theWickedWebDev/8-bit-computer/Modules/display-module/README.md

# Display Module

MORE DETAILS TO COME

Uses a JK flip flop, a 555 timer and EEPROM to multiplex four 7-segment displays to output the current value of the bus in decimal.

<br/>

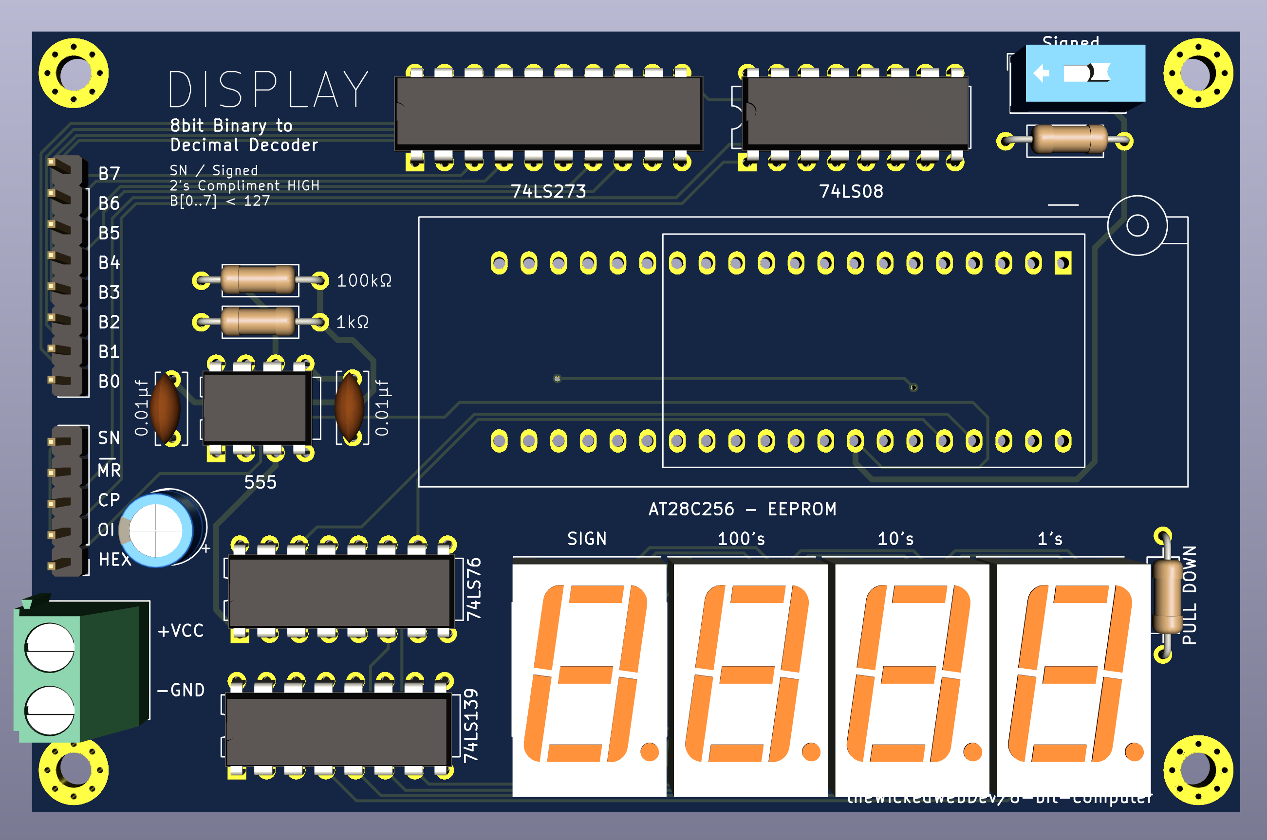
[picture p1: Modules/display-module/display-3d.png]
DISPLAY


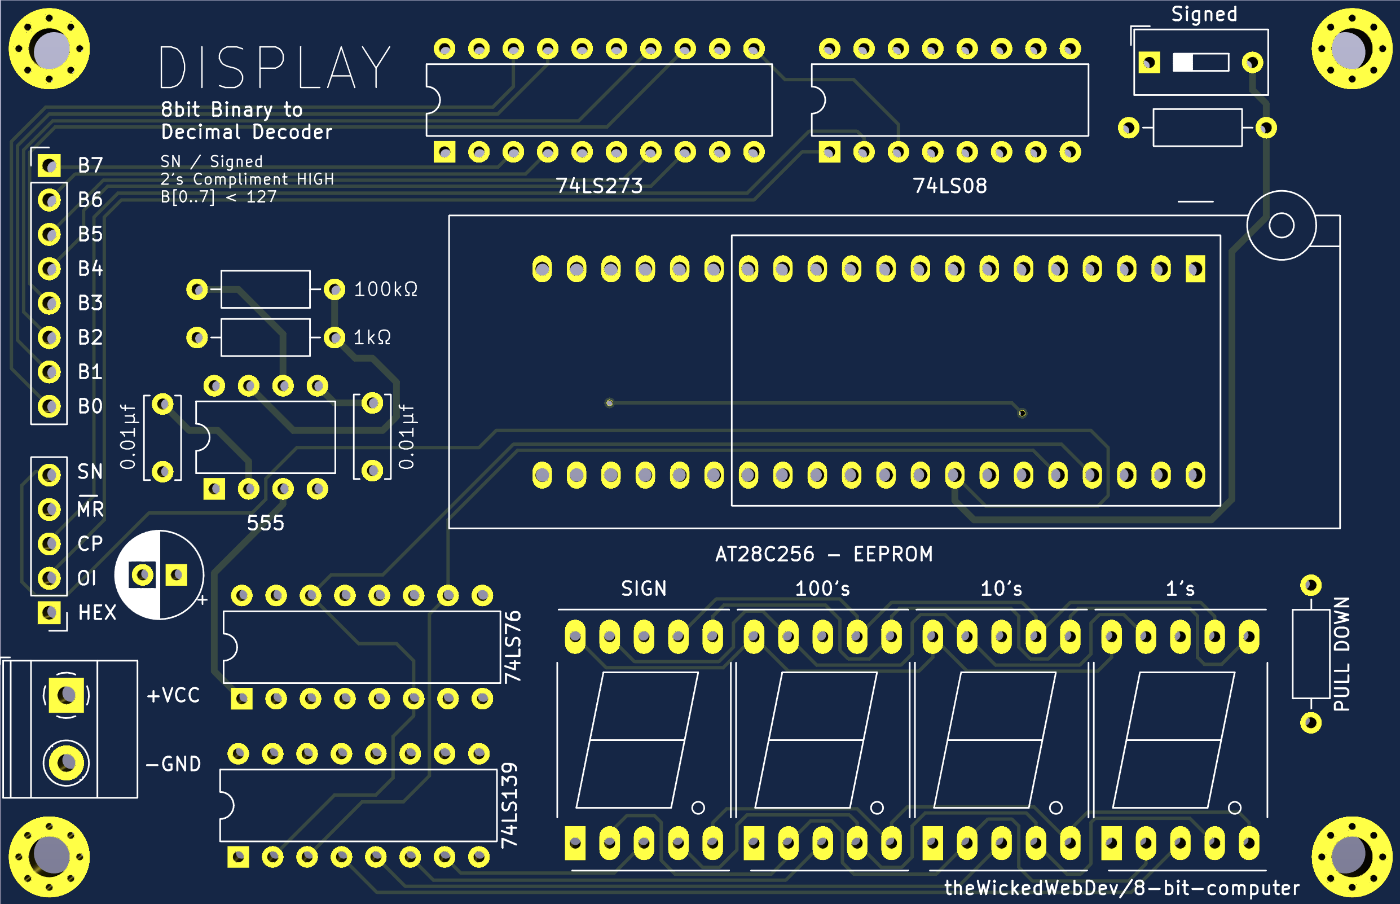
[picture p2: Modules/display-module/display-board.png]


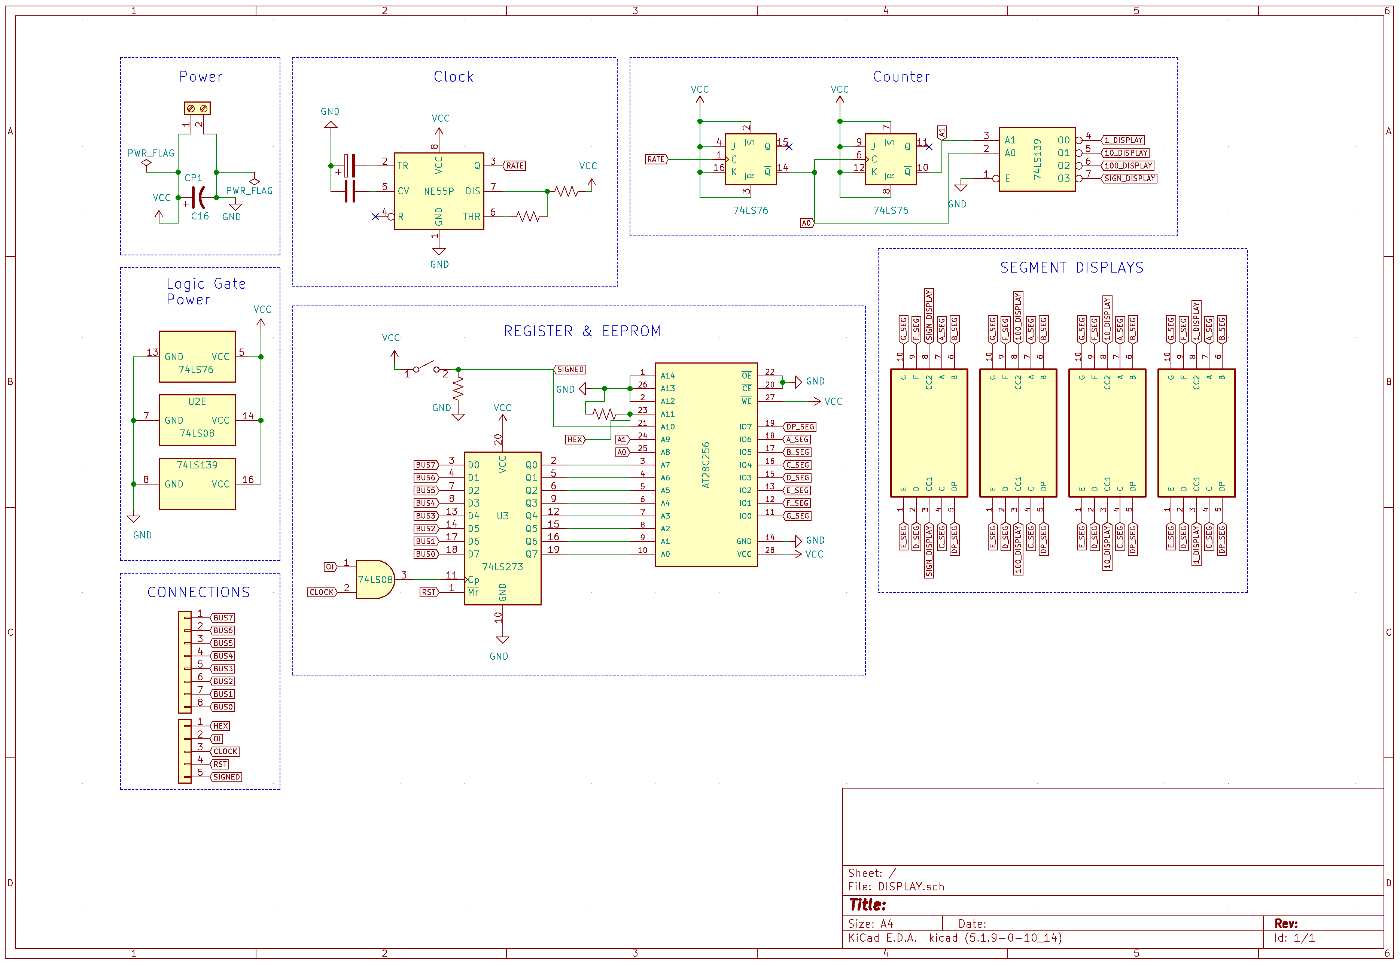
[picture p3: Modules/display-module/display-sch.png]


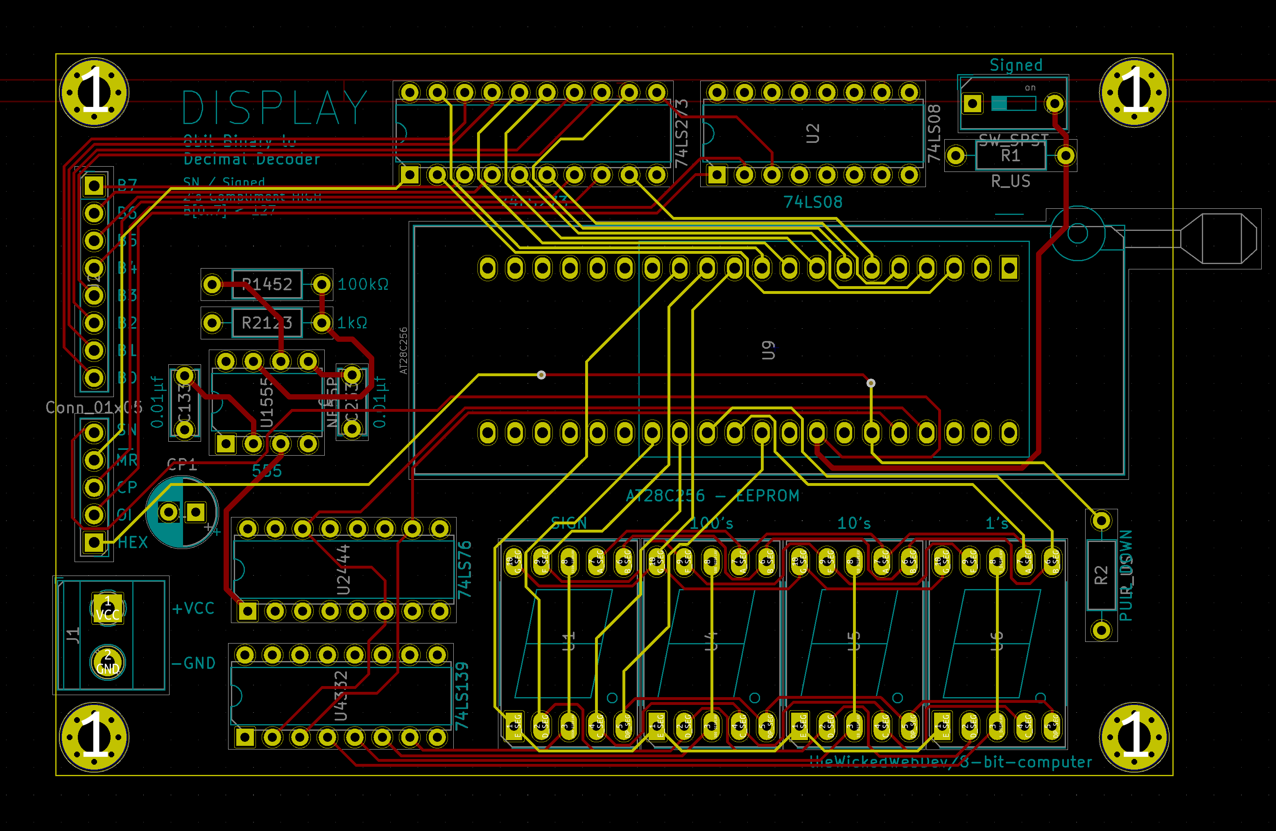
[picture p4: Modules/display-module/display-traces.png]


<br/><br/>
