theWickedWebDev/8-bit-computer/Modules/alu/README.md

# ALU with 74LS181

<br/>

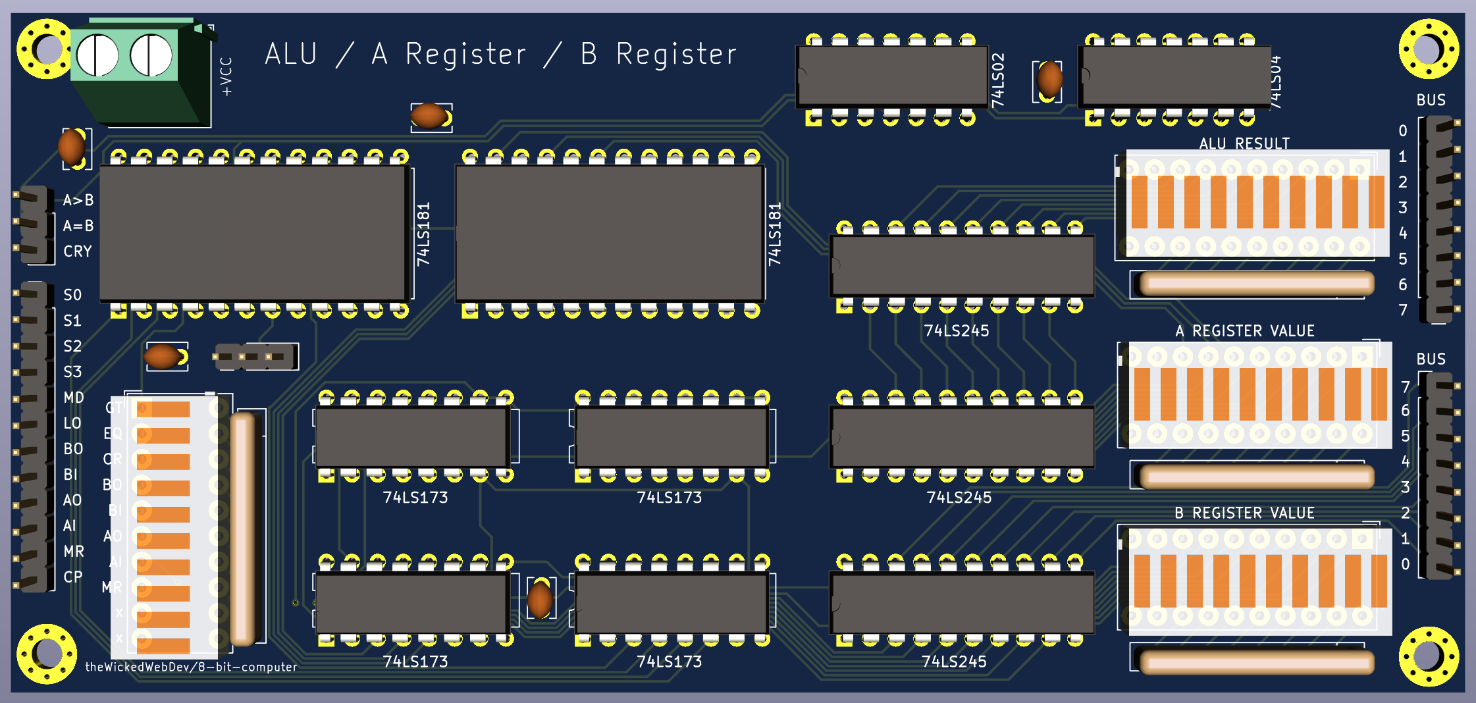
[picture p5: Modules/alu-module/ram-register-3d.png]


<br/>

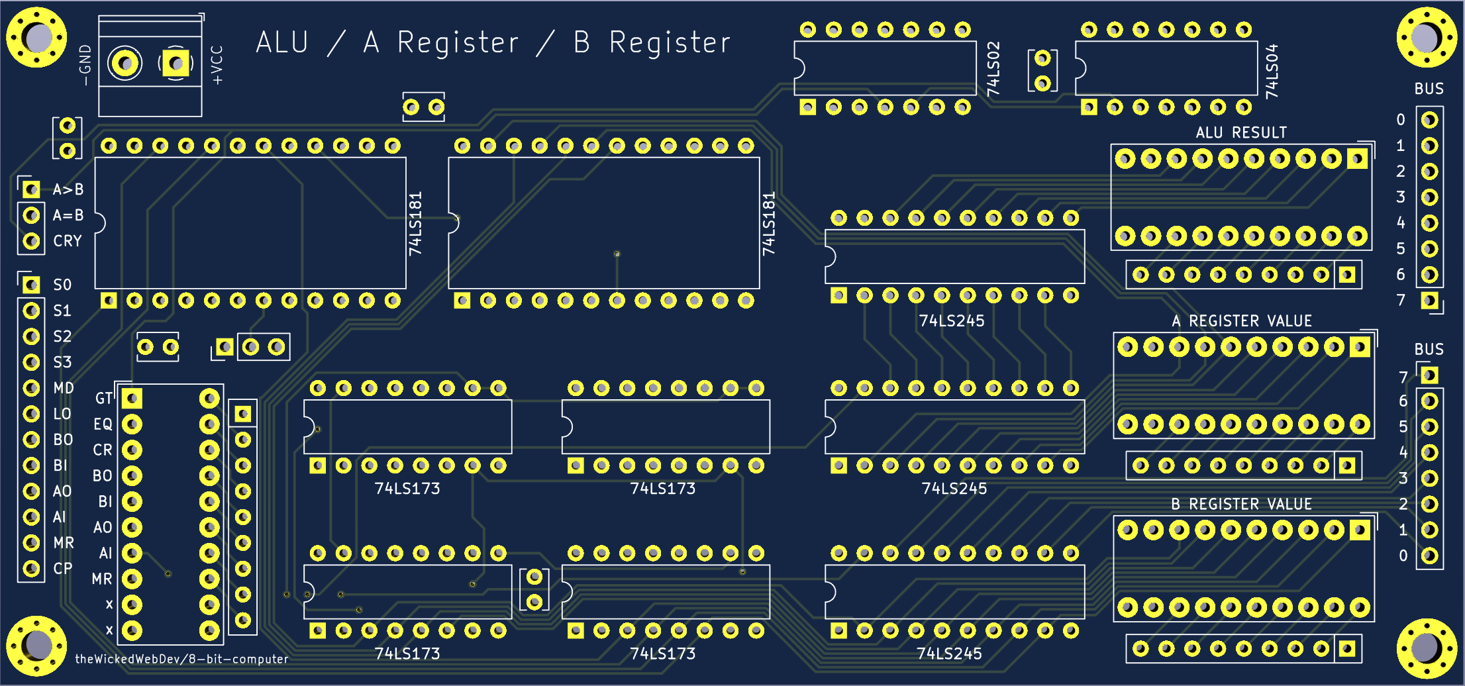
[picture p6: Modules/alu-module/ram-register-board.png]


<br/>

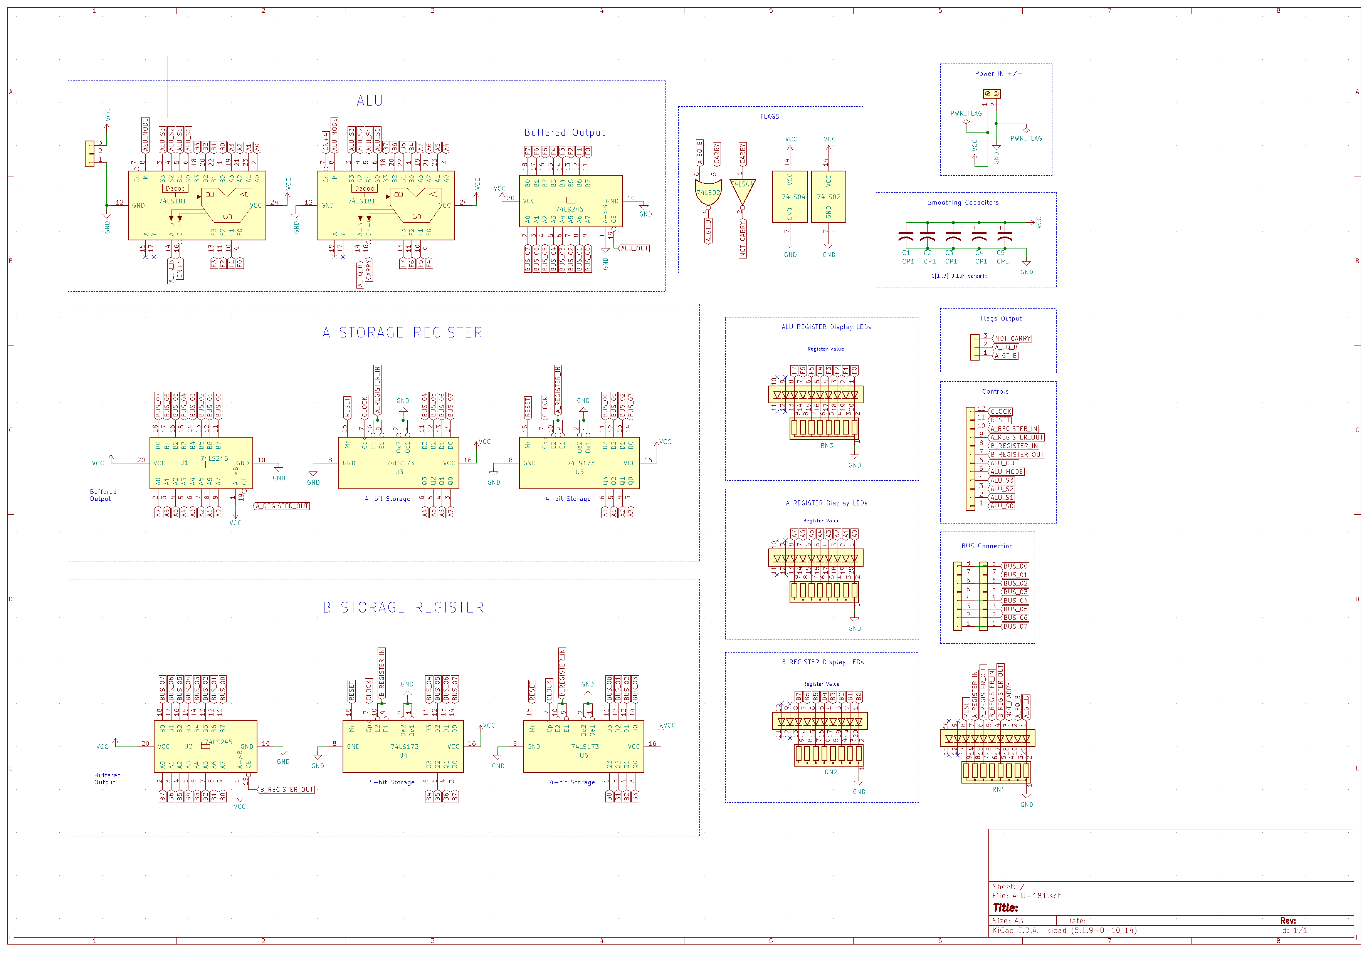
[picture p7: Modules/alu-module/ram-register-sch.png]


<br/>

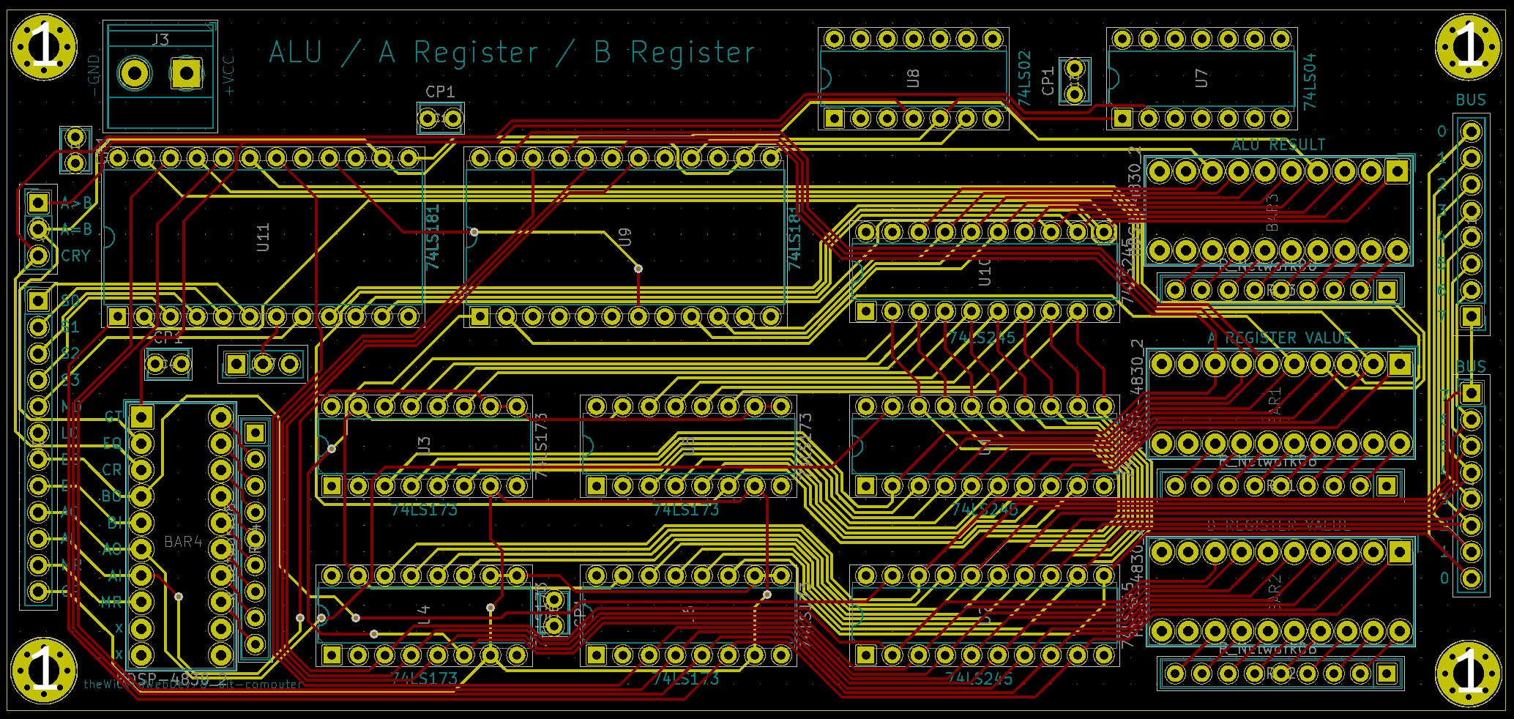
[picture p8: Modules/alu-module/ram-register-traces.png]


<br/>
