theWickedWebDev/8-bit-computer/Modules/ram-module/README.md

# RAM Modules

<br/>

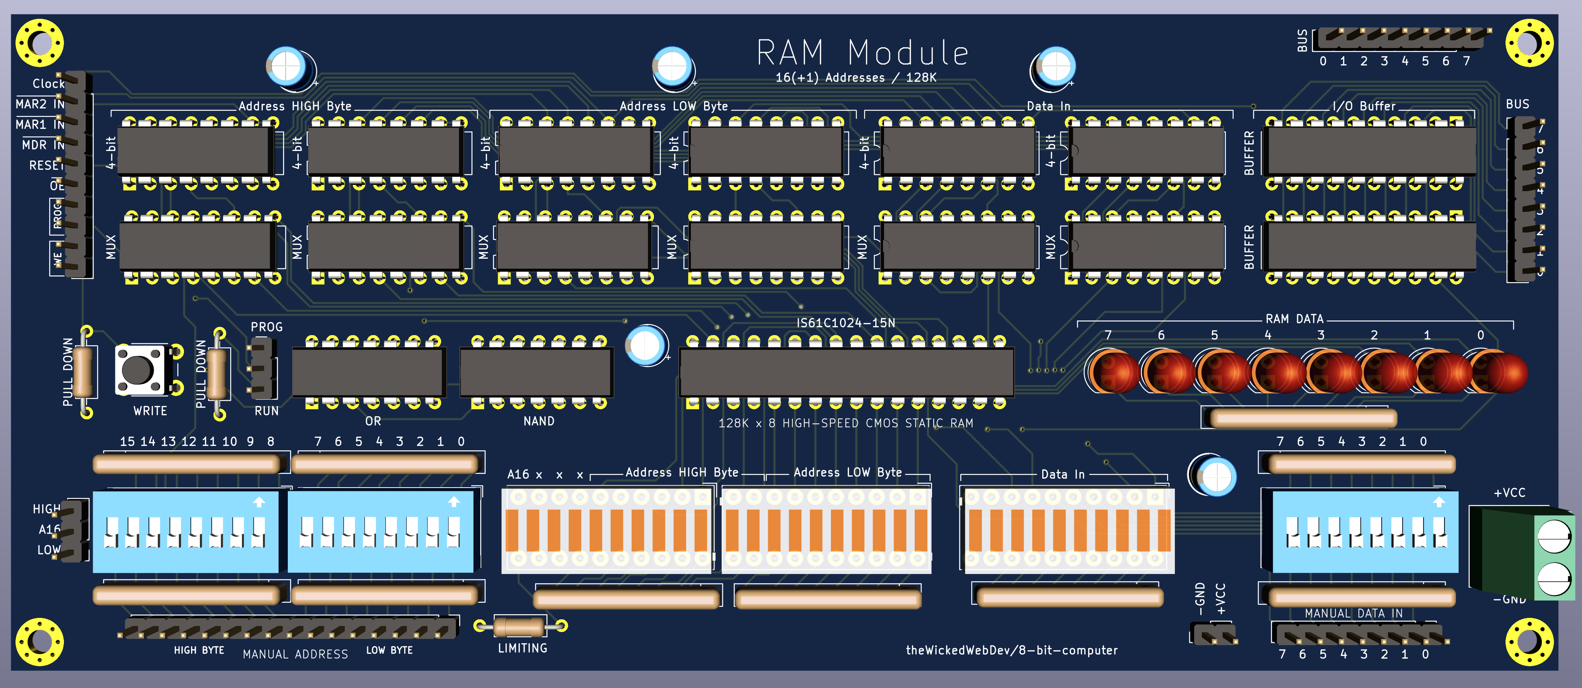
[picture p9: Modules/ram-module/ram-3d.png]


<br/>

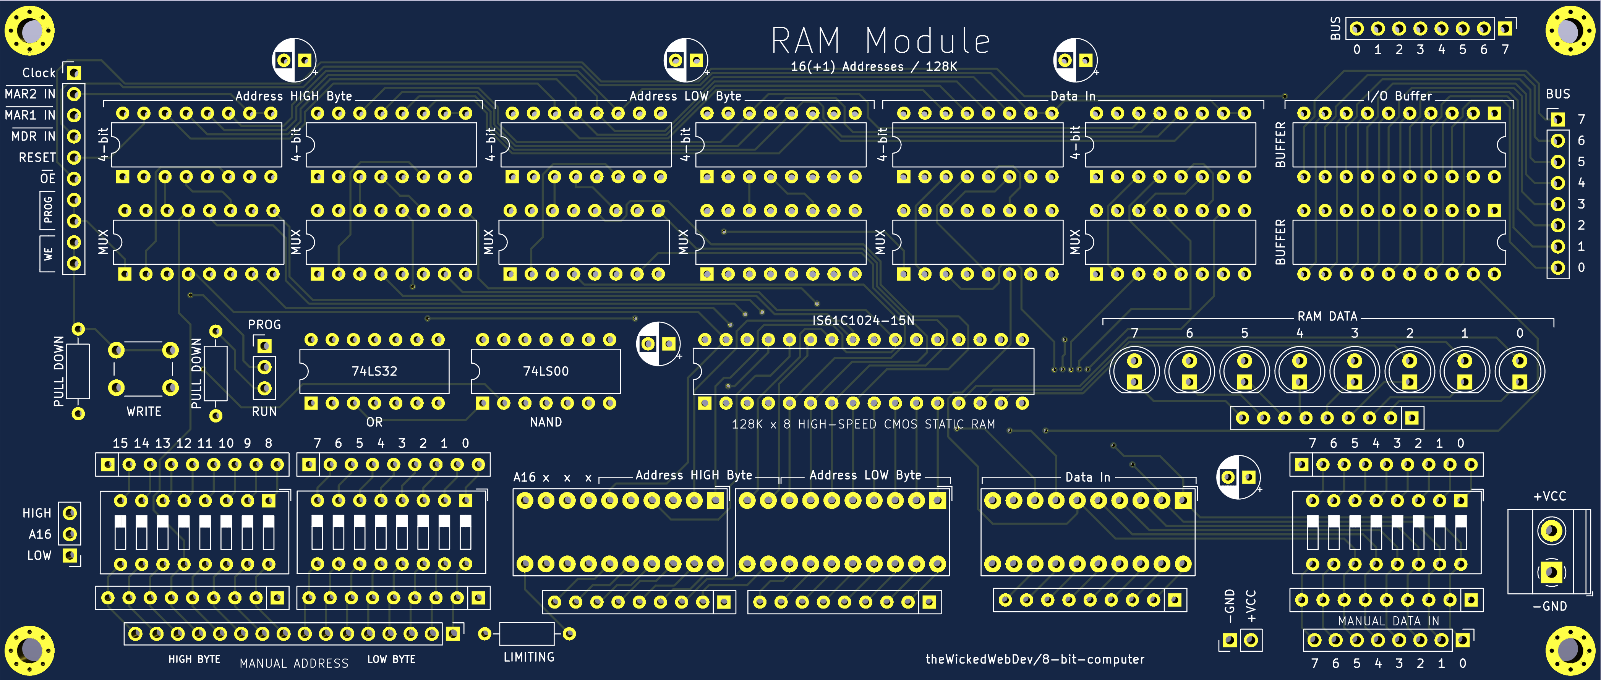
[picture p10: Modules/ram-module/ram-board.png]


<br/>

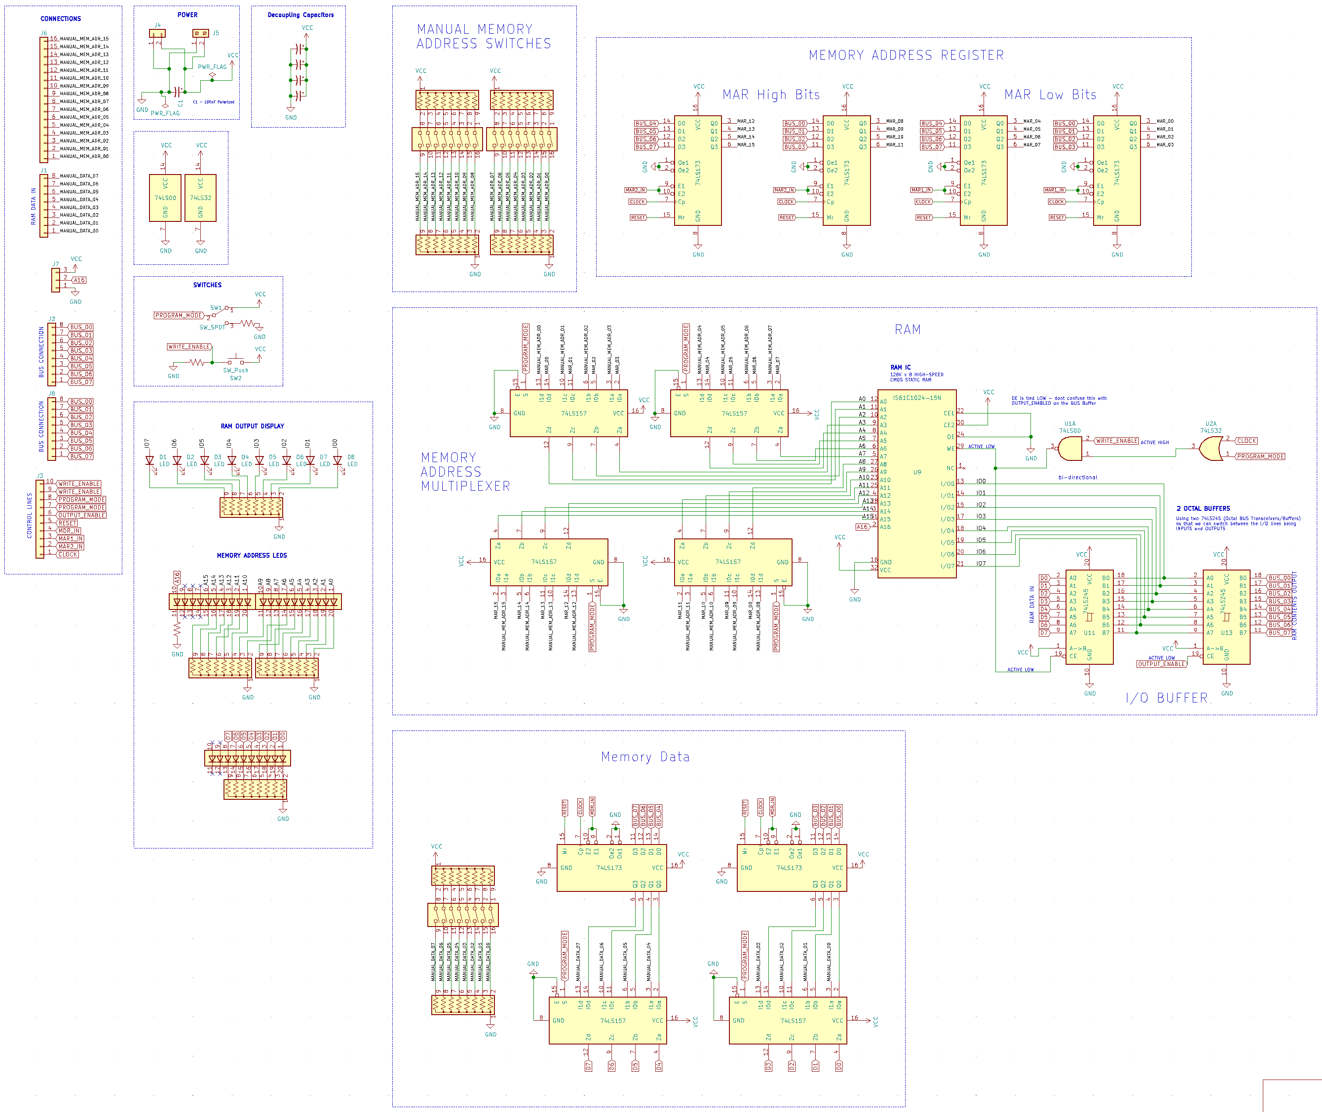
[picture p11: Modules/ram-module/ram-sch.png]


<br/>

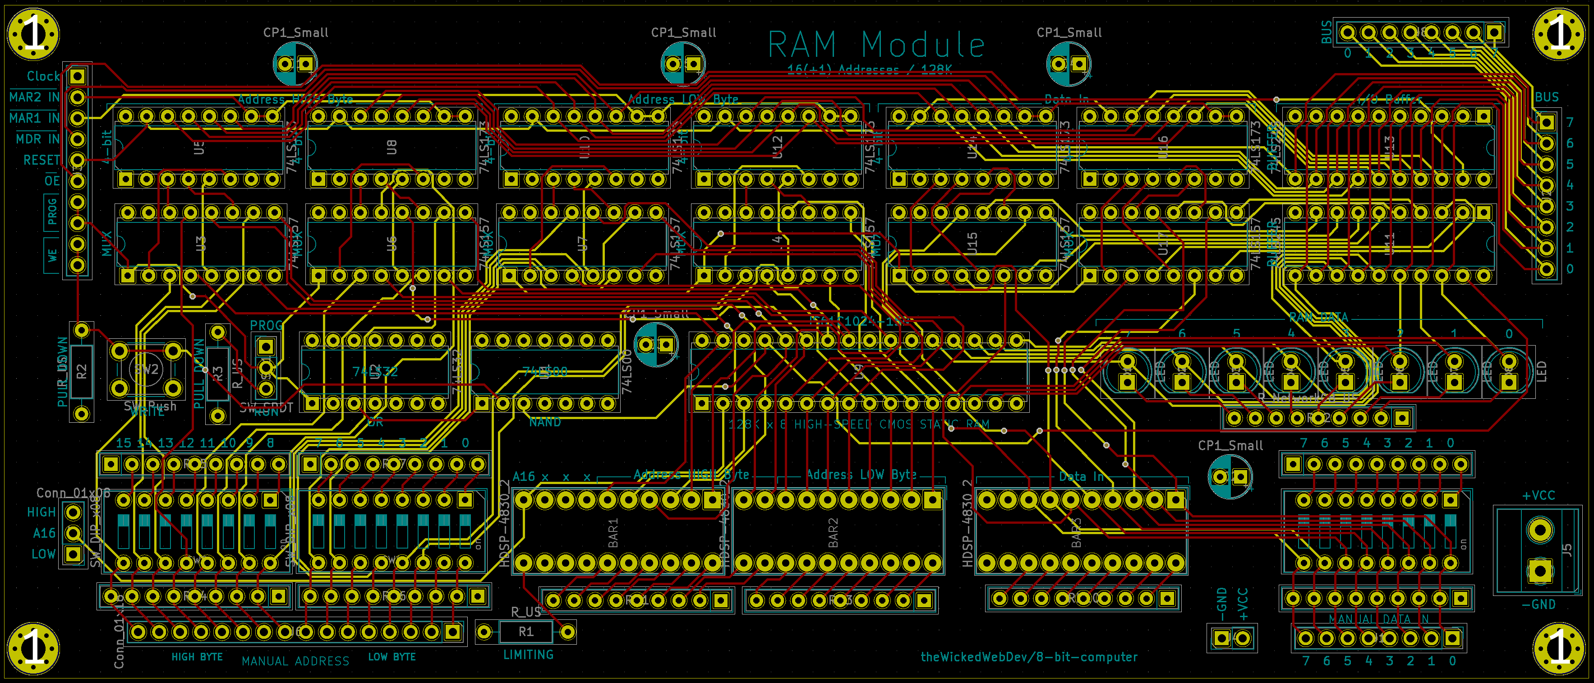
[picture p12: Modules/ram-module/ram-traces.png]


<br/>
