theWickedWebDev/8-bit-computer/Modules/storage-register/README.md

# 8-bit Register

    

DEMO

<br/>

This module stores one byte of data. It has a tri-state output which can be used to tie into a central bus system.
<br/>
<br/>

## Truth Table

| In  | Out | Rst | Cp  | Func
|---- |---- |---- |---- |----
| x	  | x | High | x | Resets Register
| High | High | Low | x | Noop/Keep stored
| Low | High | Low | /High | Latch data at BUS on rising edge
| High | Low | Low | x | Assert data to bus
| Low | Low | Low | /High | Invalid state

<br/>

## Schematic

Made with Kicad

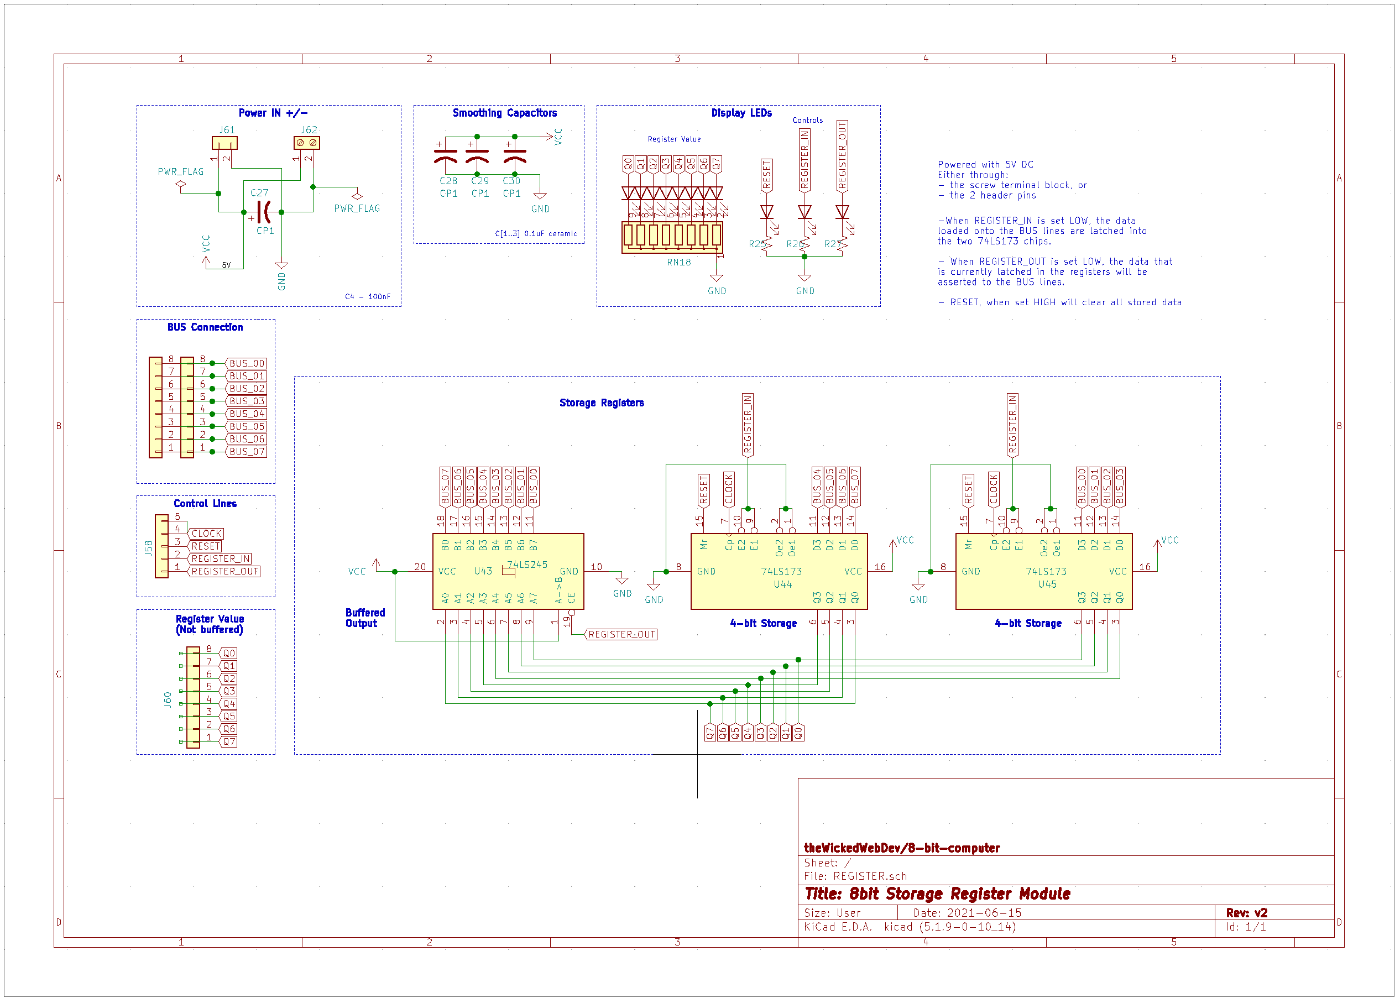
[picture p13: Modules/storage-register/registersch.png]
SCHEMATIC


<br/>

## PCB
Made with Kicad and fabricated with [JLCPCB](https://jlcpcb.com/)

Actual cost for me to fabricate this board.

| Fab 	 | S&H 	 | Total |
|----	 |----	 |---- |
|  $9.50	|  $12.80 	|  $22.30 |

<br/>

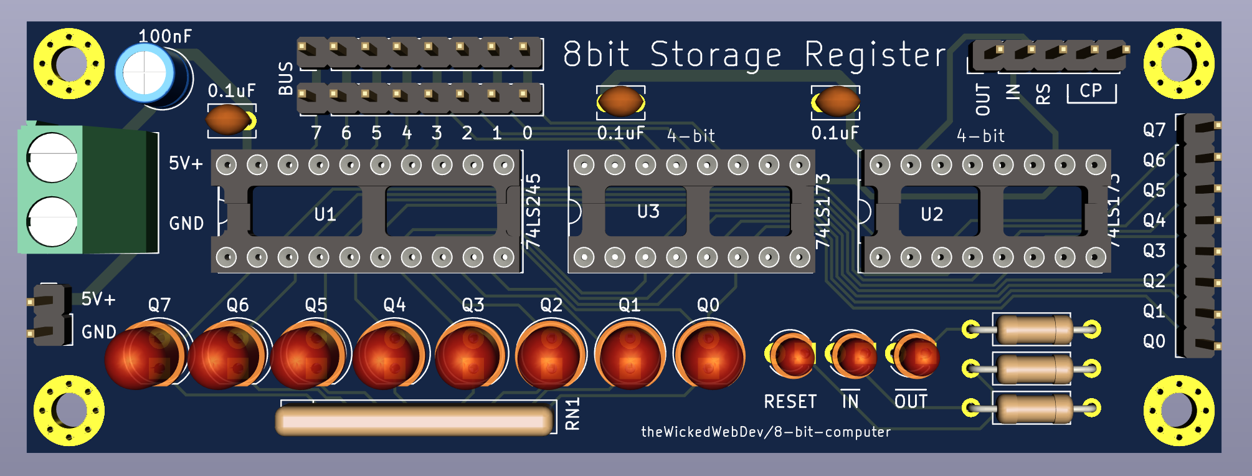
[picture p14: Modules/storage-register/register3d.png]
REGISTER


<br/>

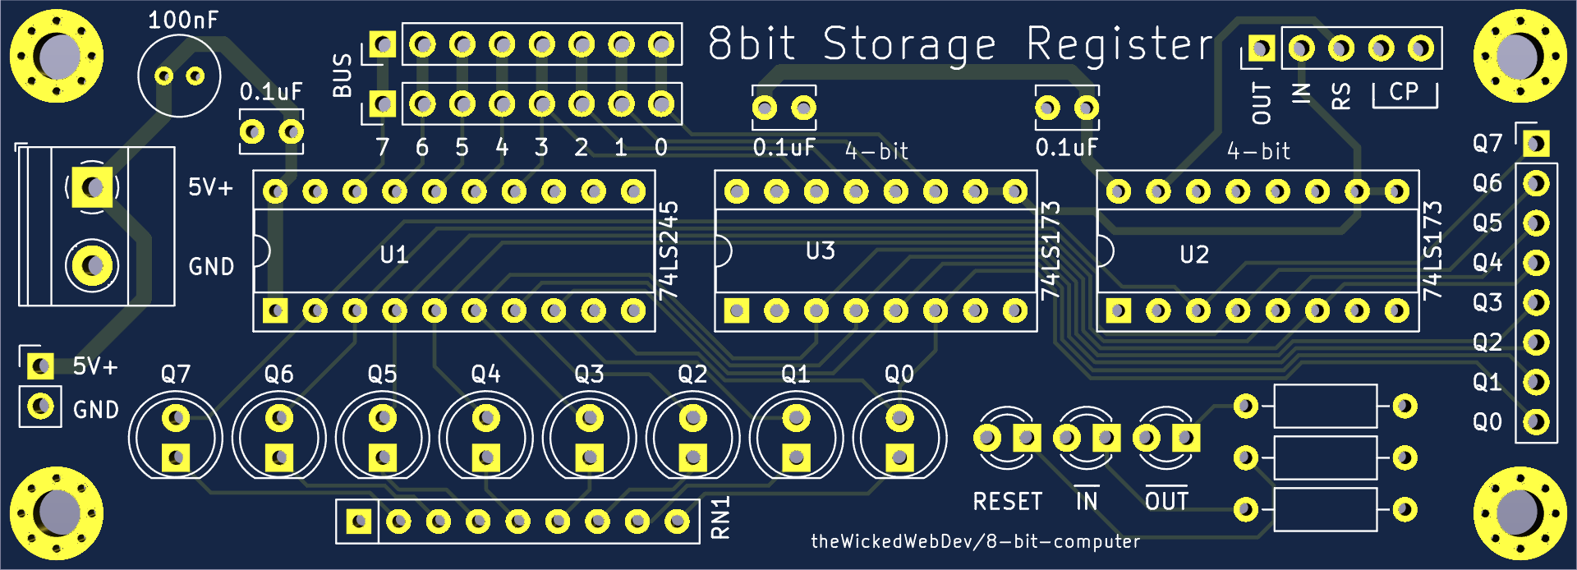
[picture p15: Modules/storage-register/registerboard.png]
REGISTER


<br/>

## Fritzing

For demo purposes only, this file/drawing hasnt been verified.

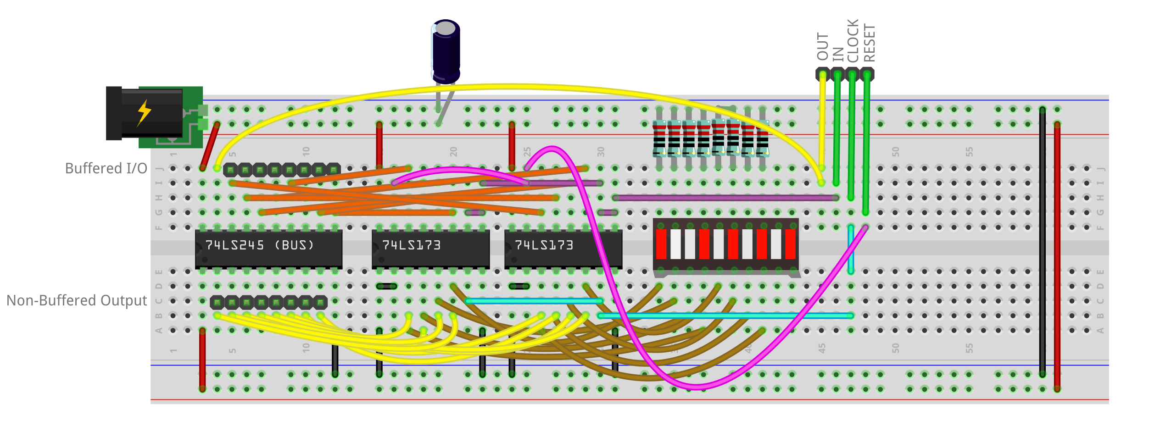
[picture p16: Modules/storage-register/register-breadboard.png]
REGISTER


<br/>

## Parts List

... more details to come TODO

### IC's

- `74L245` (1) - Tri-state Buffer [Datasheet/Product](https://www.jameco.com/z/74LS245-Major-Brands-IC-74LS245-Tri-State-Octal-Bus-Transceiver_47212.html)

- `74L173` (2) - 4bit Register [Datasheet](https://www.jameco.com/z/74LS173-Major-Brands-IC-74LS173-4-BIT-D-TYPE-REGISTER-3-STATE-OUTPUT_46922.html)
