theWickedWebDev/8-bit-computer/other-modules/MULTIPLEXER/README.md

# Multiplexer Module

TODO: Description coming soon...
    
### MUX w/ Tri-State Buffer




<br/>

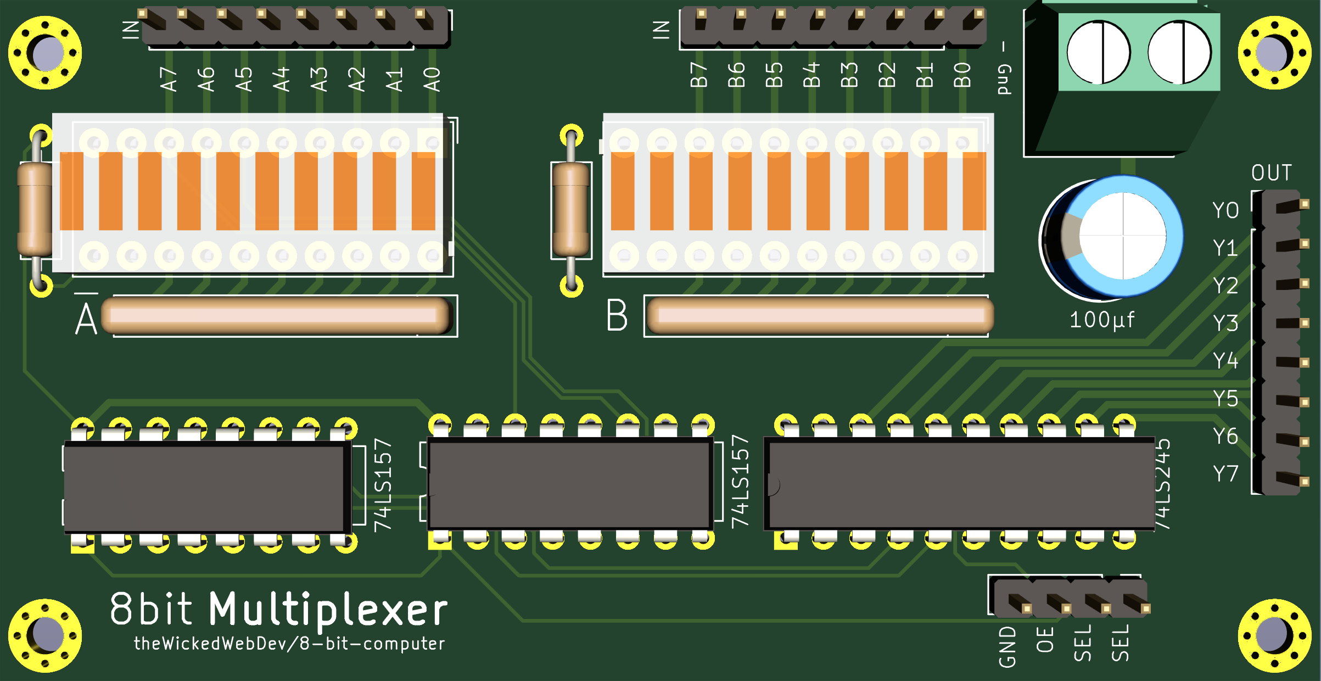
[picture p24: MULTIPLEXER/mux-3d.png]


<br/>

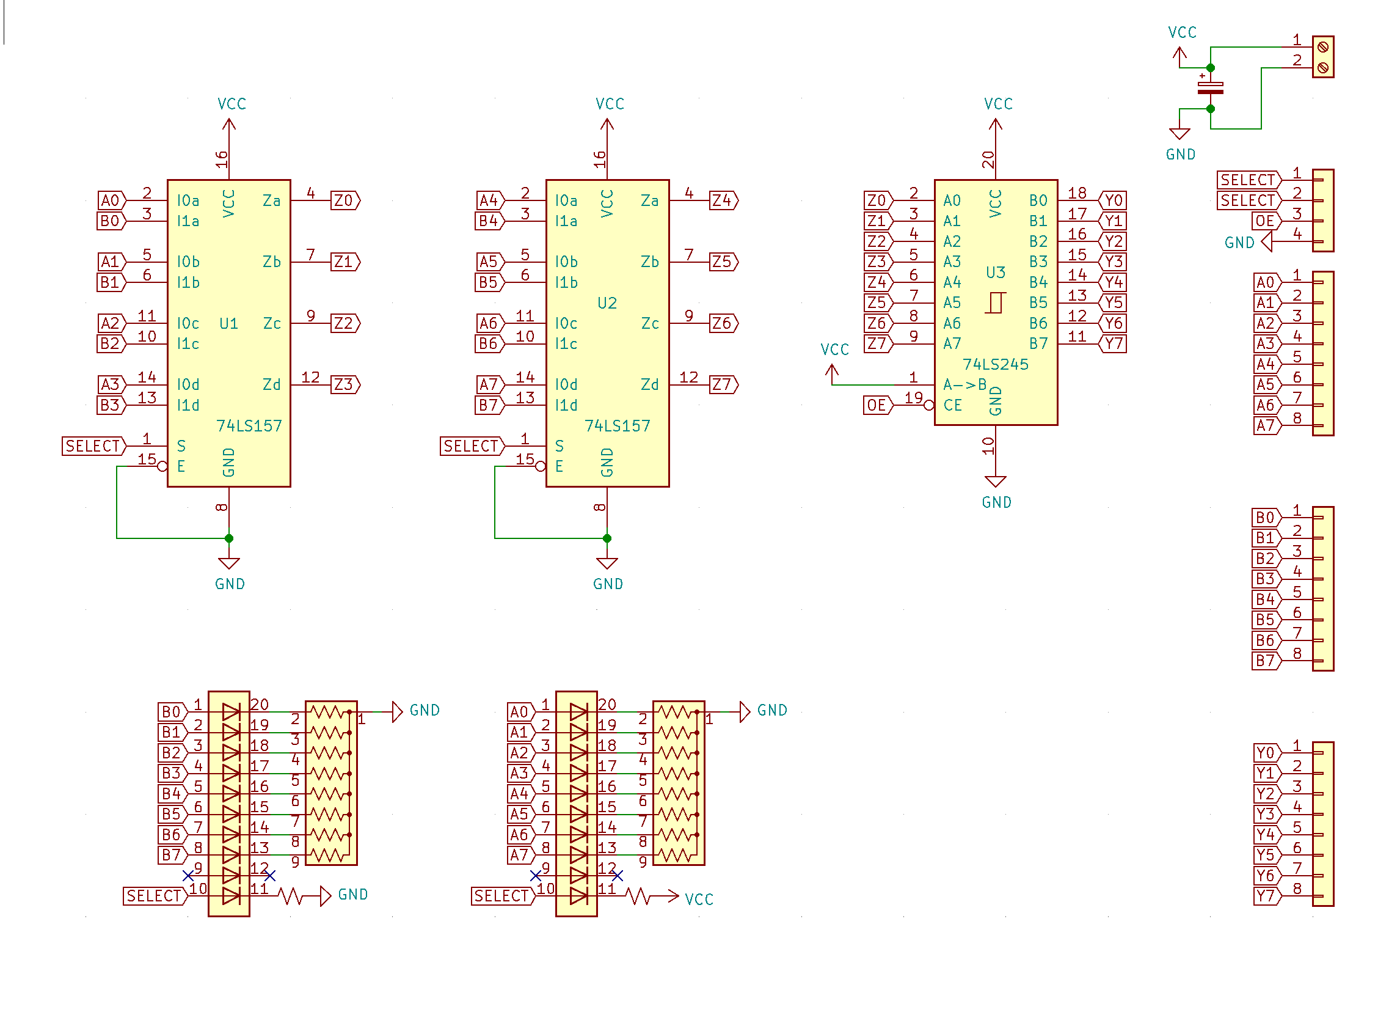
[picture p25: MULTIPLEXER/mux-sch.png]


<br/>

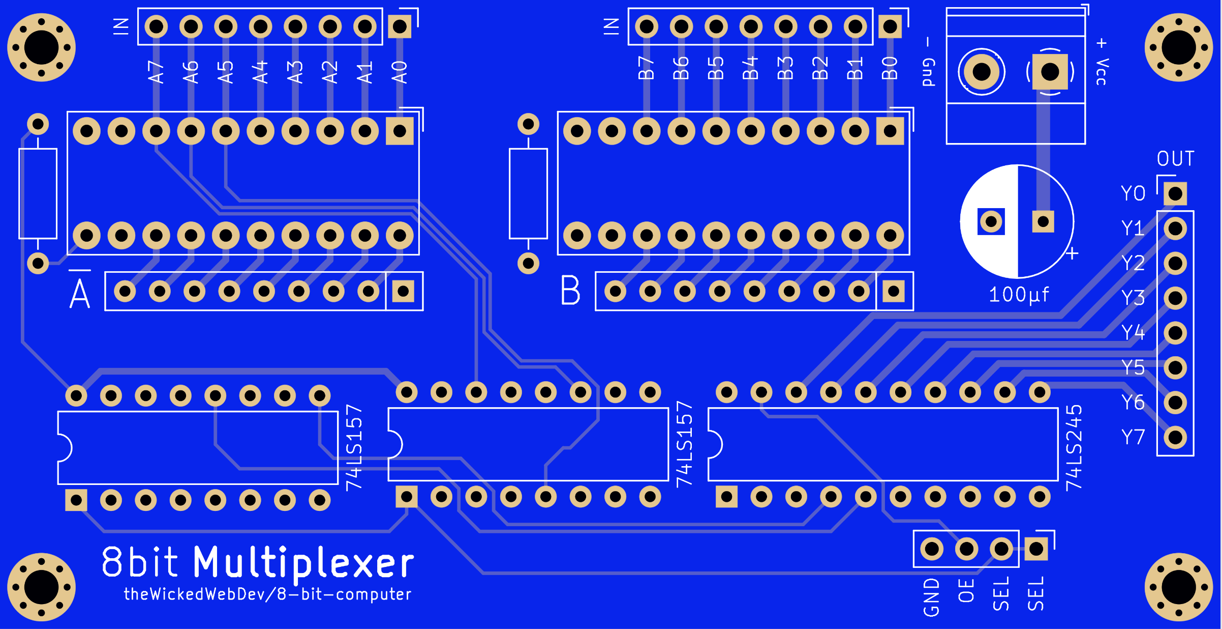
[picture p26: MULTIPLEXER/mux-board.png]
