theWickedWebDev/8-bit-computer/Modules/sound-module/README.md

# Sound / Audio Module

TODO: Description coming soon...

- FIXES
    - Adjust/rotate the pins for the audio-jack out - pin 1 is the large pin

### Sound 1 Module




<br/>

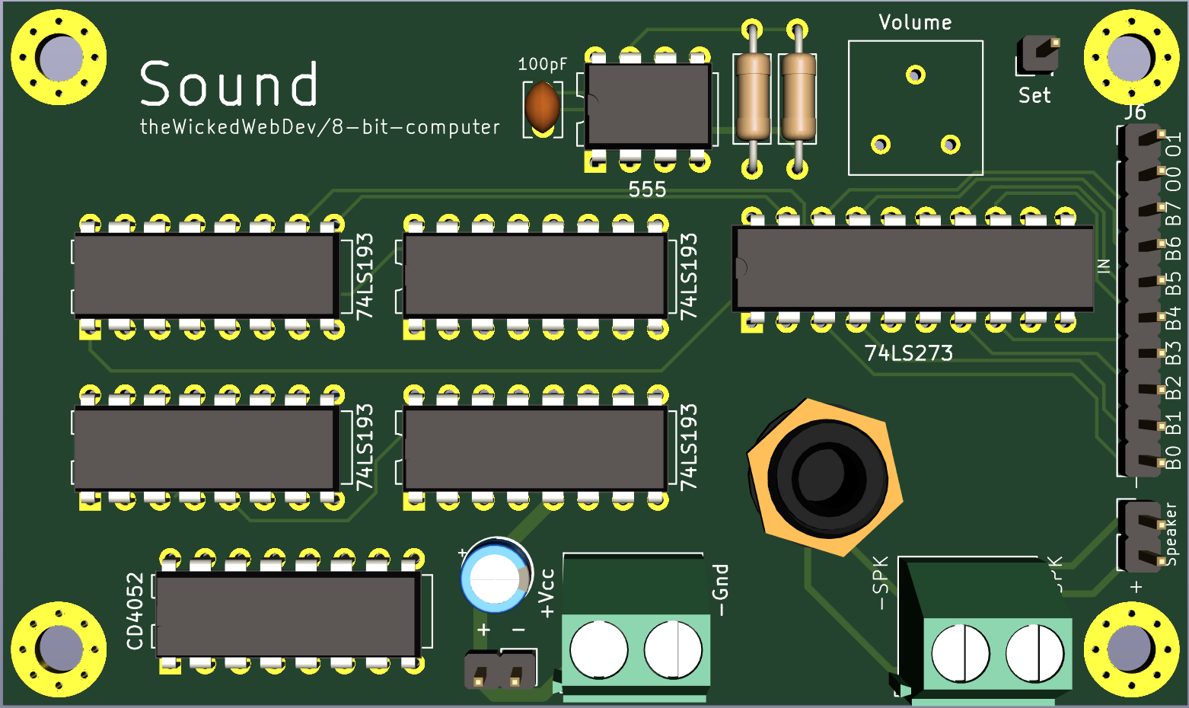
[picture p27: SOUND/sound-3d.png]


<br/>

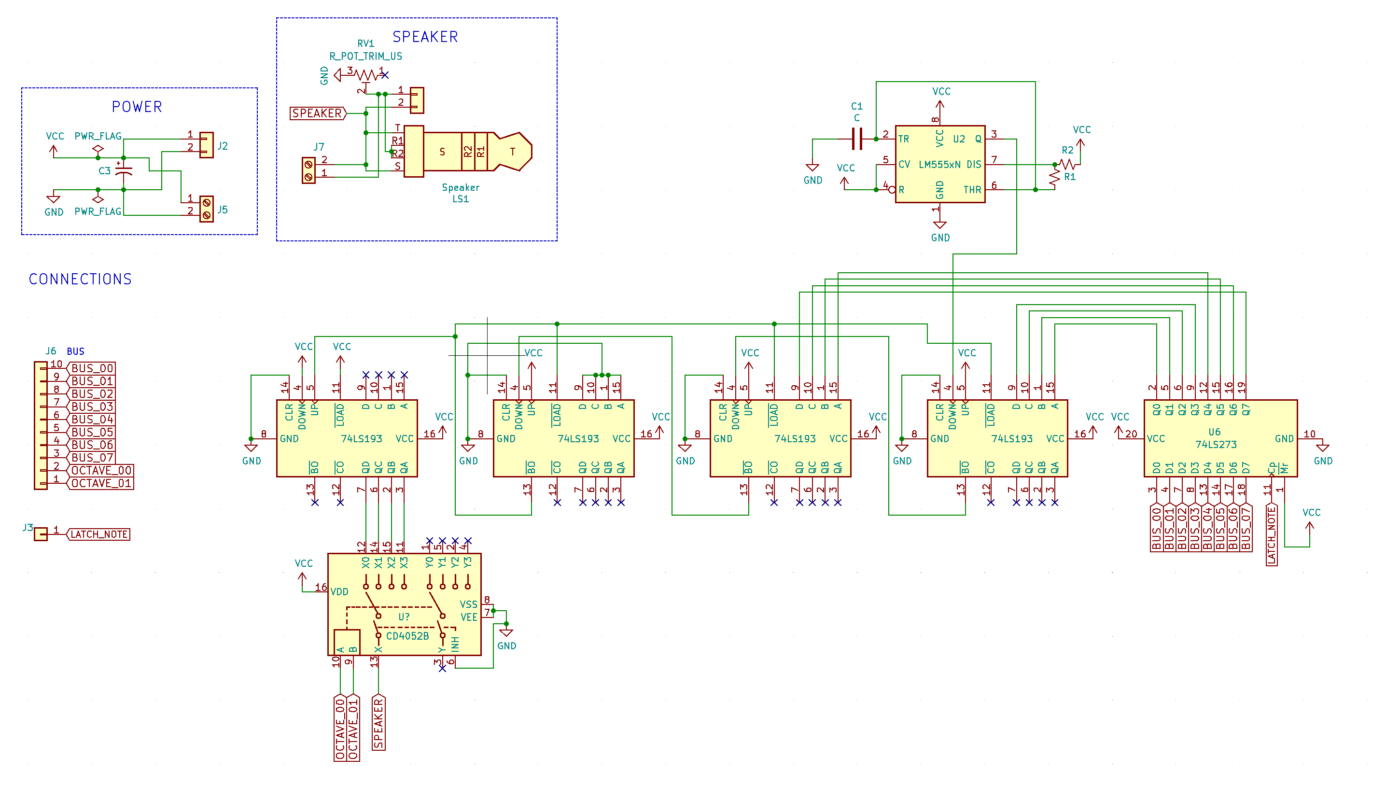
[picture p28: SOUND/sound-sch.png]


<br/>

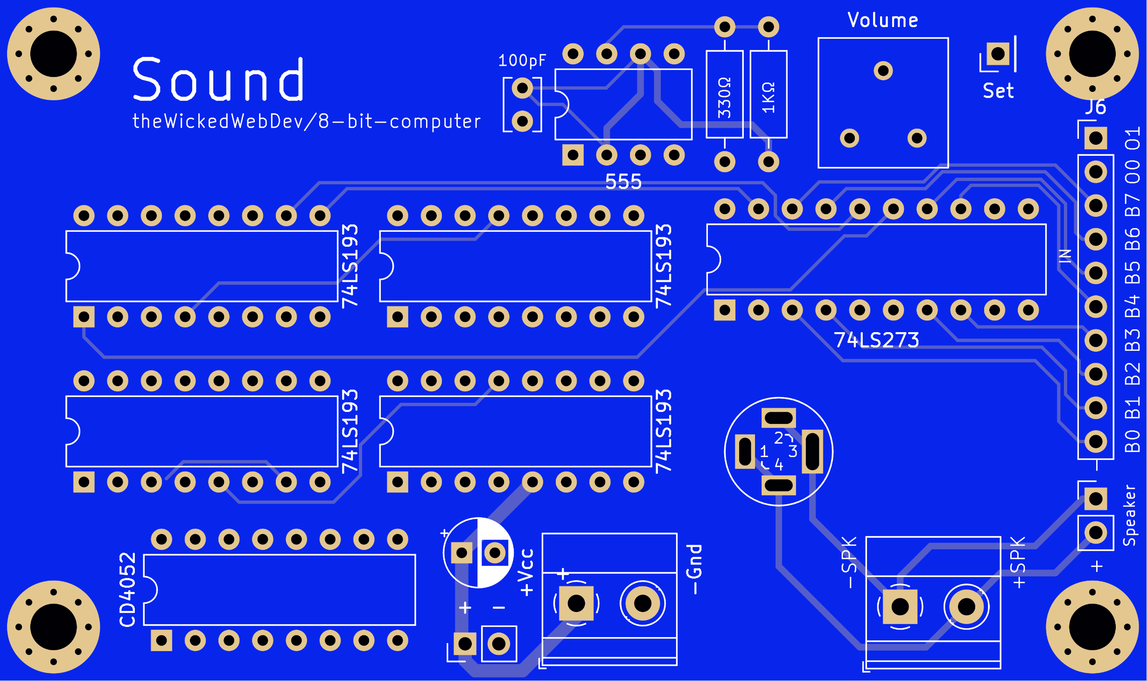
[picture p29: SOUND/sound-board.png]
