theWickedWebDev/8-bit-computer/other-modules/POWER/README.md

# 5V Voltage Regulator

Includes reverse polarity protection.

*More technical details to come*

| Vin 	| Vout 	|
|----	|----	|
|  8V 	|  not tested |
|  12V 	|  4.98V |
|  16V 	|  not tested |
|  24V 	|  not tested |

<br/>

## QA




✅ Tested this module and verified it works as expected

<br/>

### Changes if I re-fabricate this again

- [DONE] Label the Vin capacitor as 330µf
- Make a little more space for the heatseat (still fits as is)
- Make a little more space for the Vin 330µf cap (still fits as is)
- Perhaps add a "disable LED" switch in case you are looking to save on a little current usage

<br/>

## PCB

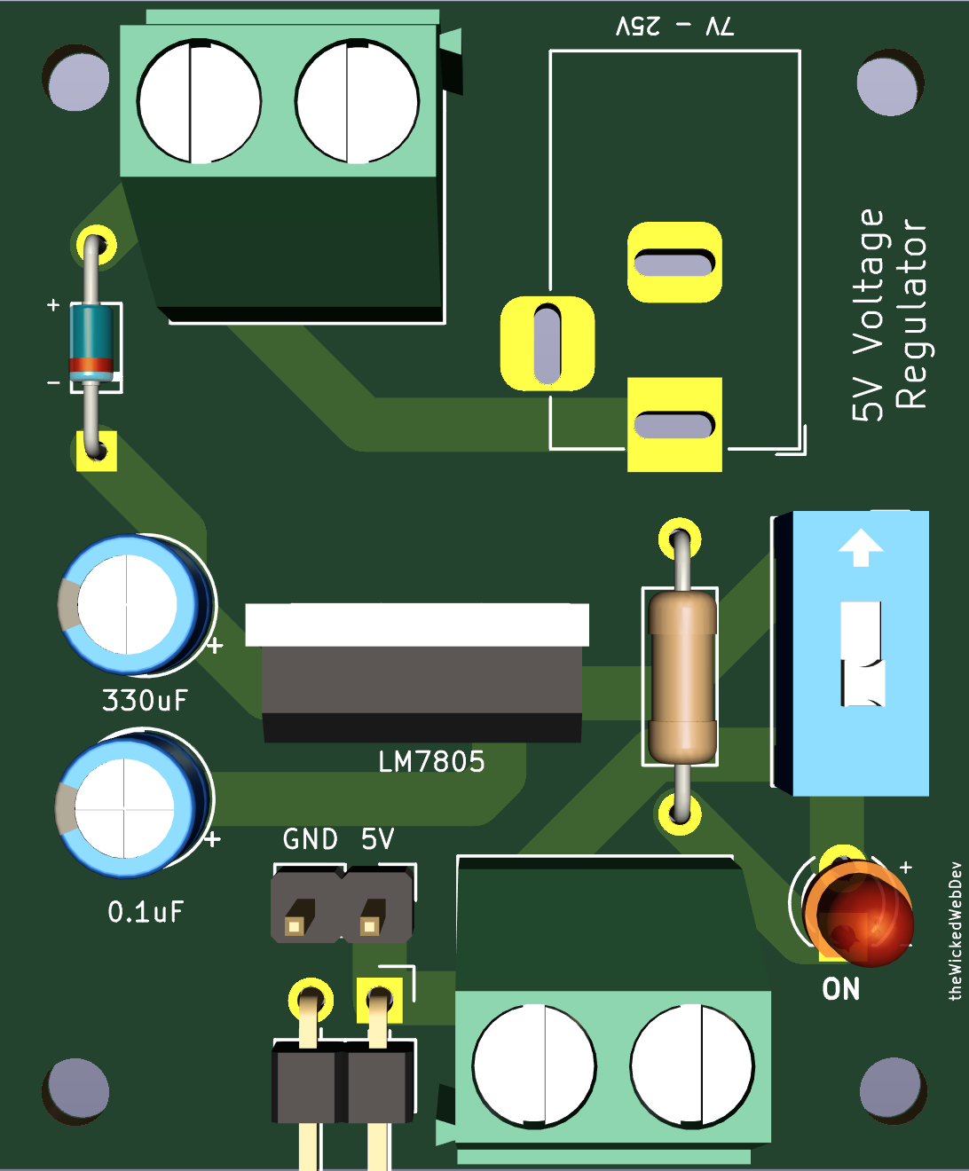
[picture p32: POWER/power-3d.png]
POWER


<br/>

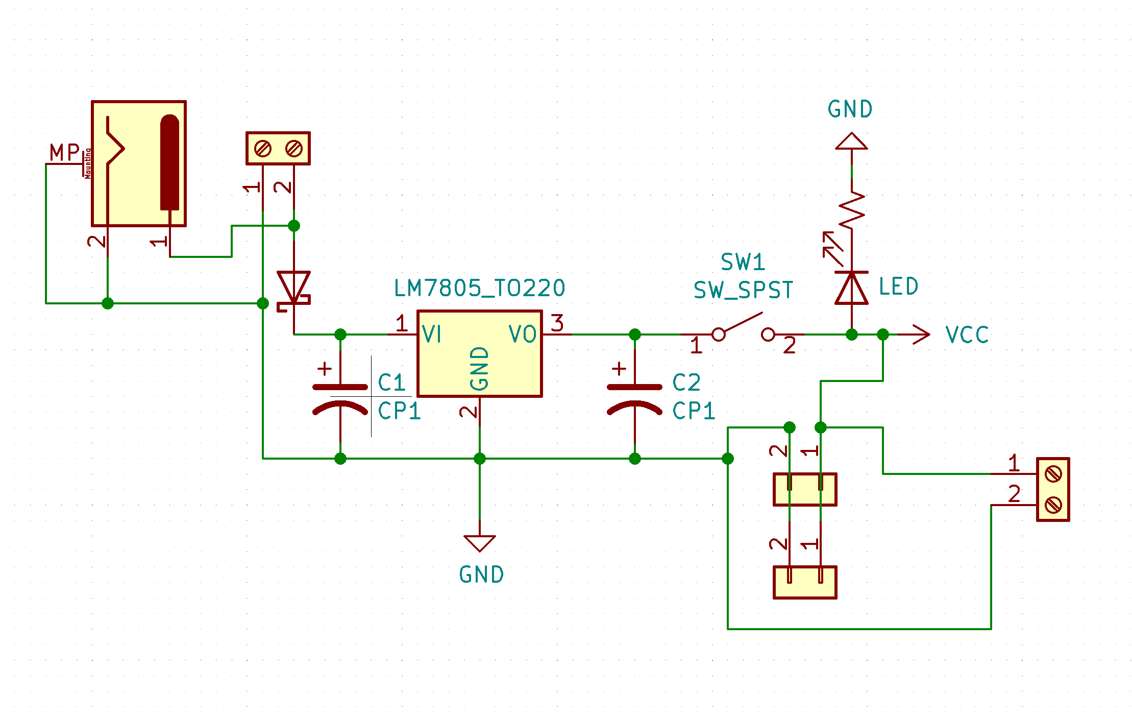
[picture p33: POWER/power-sch.png]
POWER


<br/>

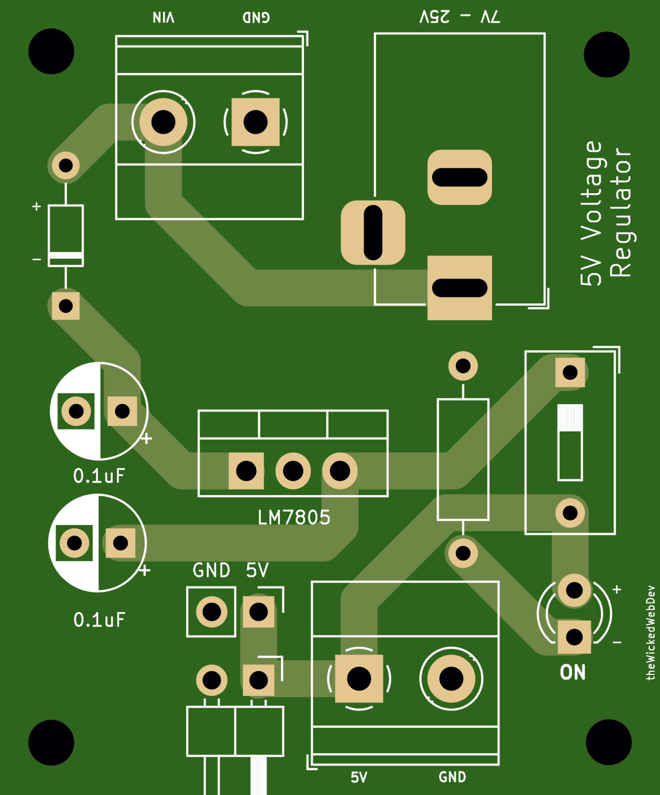
[picture p34: POWER/power-board.png]
POWER
