theWickedWebDev/8-bit-computer/Modules/ram-module/SPLIT/MEMORY-ADDRESS-REGISTER/README.md

# Memory Address Register

TODO: Description coming soon...

<br/>

## QA




<br/>

## PCB

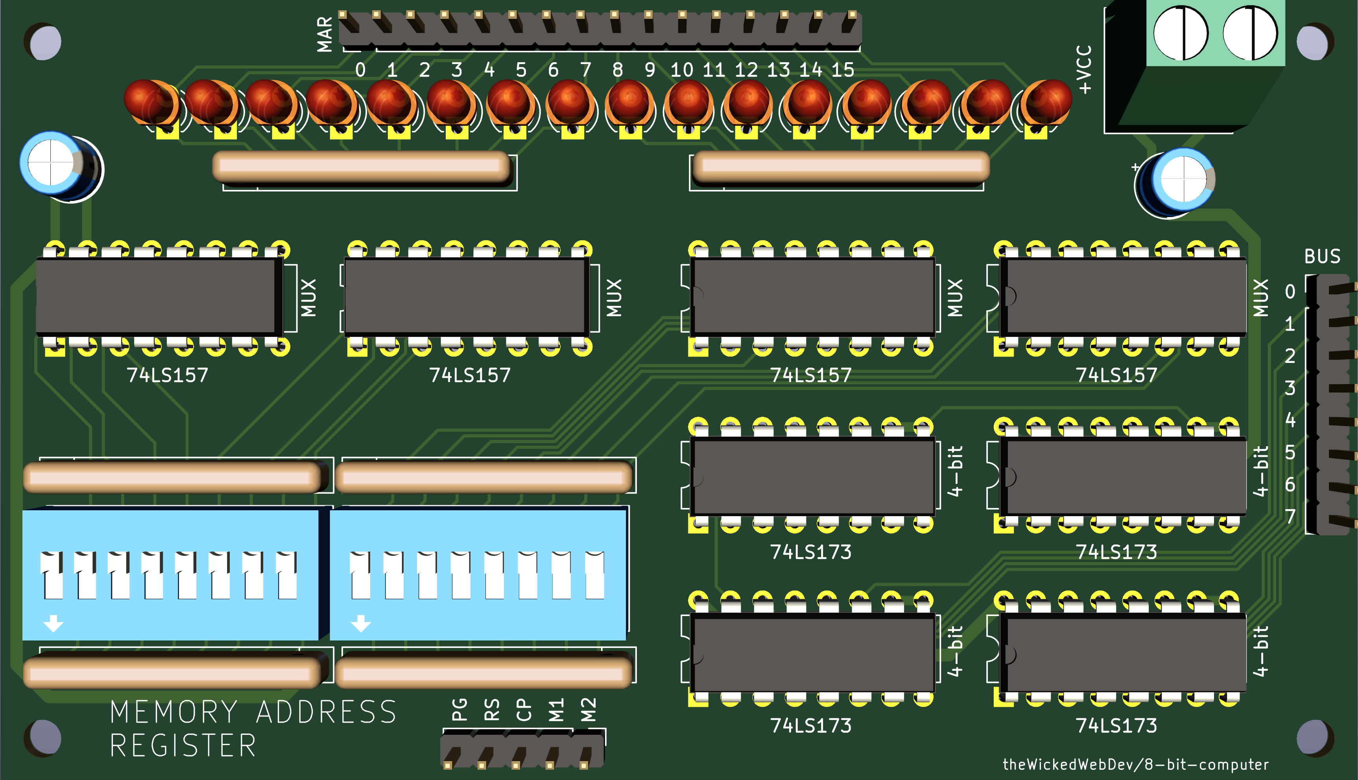
[picture p35: RAM/MEMORY-ADDRESS-REGISTER/mar-3d.png]


<br/>

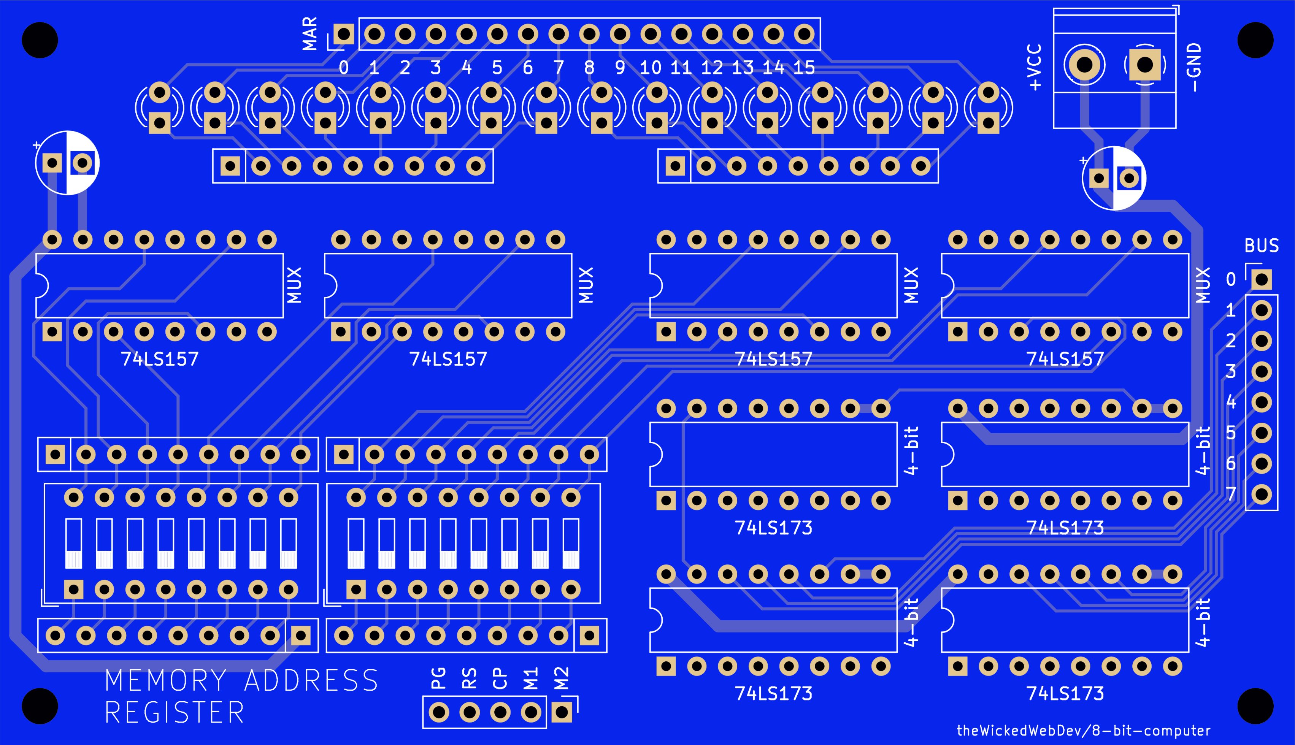
[picture p36: RAM/MEMORY-ADDRESS-REGISTER/mar-board.png]


<br/>

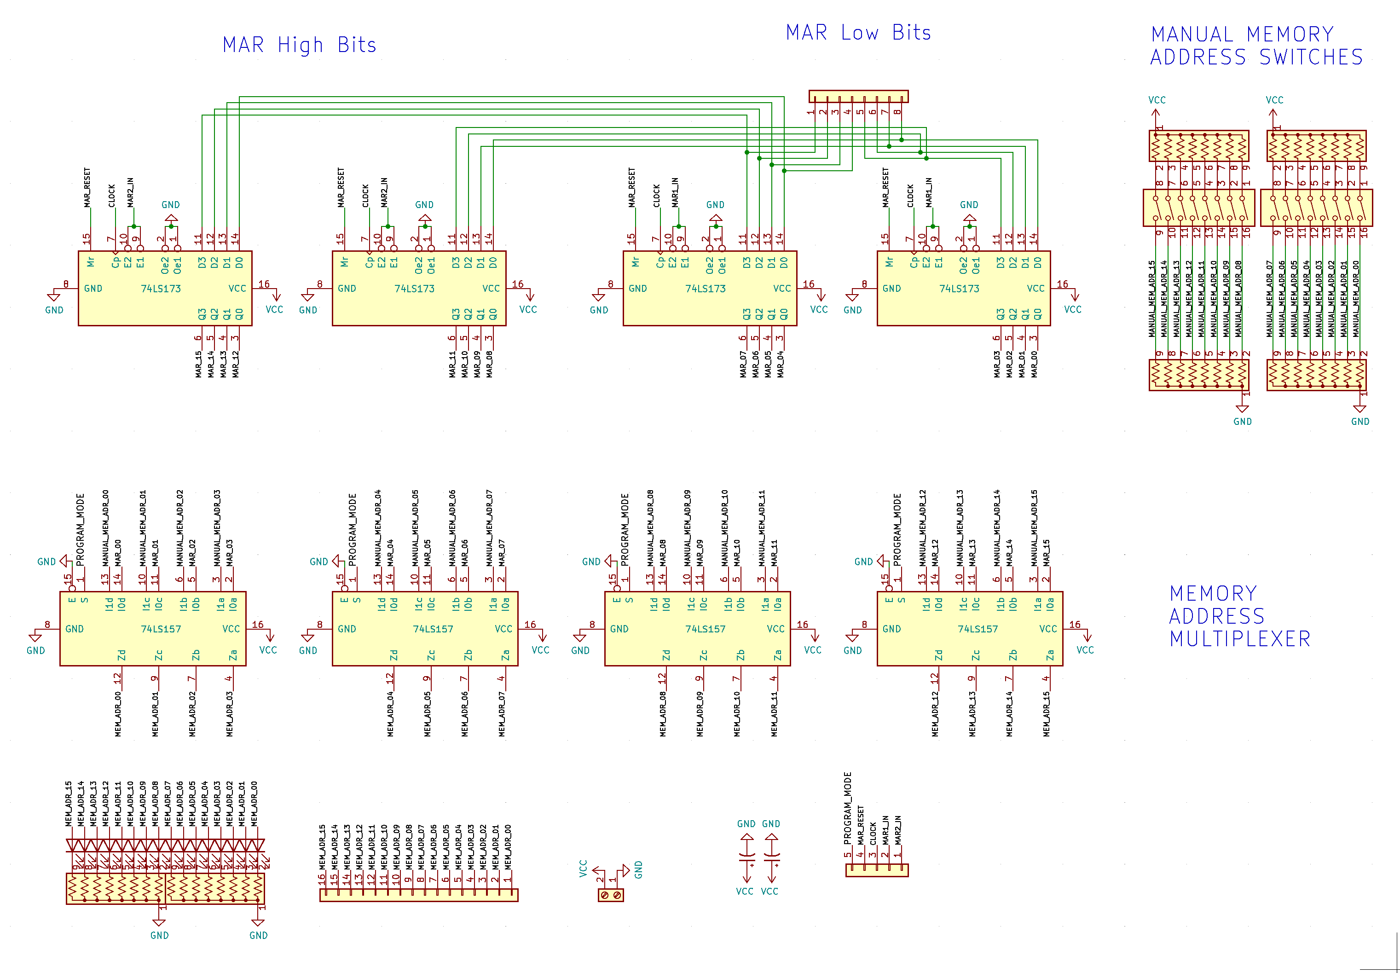
[picture p37: RAM/MEMORY-ADDRESS-REGISTER/mar-sch.png]
