theWickedWebDev/8-bit-computer/Modules/ram-module/SPLIT/RAM/README.md

# RAM Modules

TODO: Description coming soon...

<br/>

## QA




<br/>

## PCB

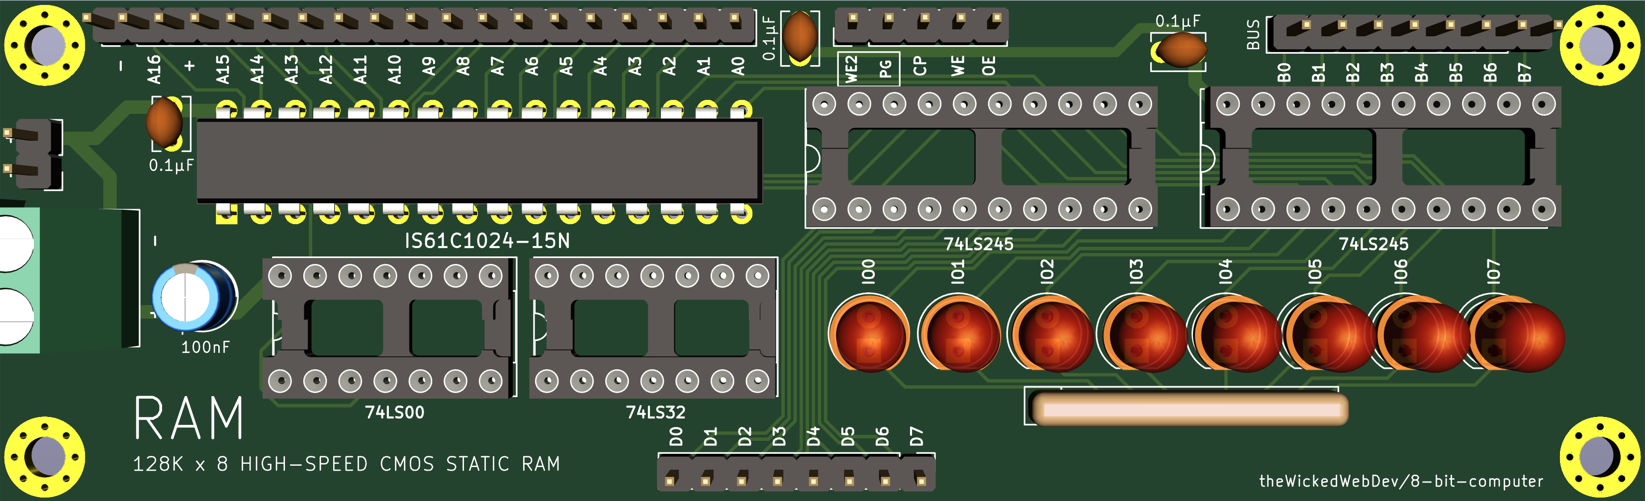
[picture p38: RAM/RAM/ram-3d.png]


<br/>

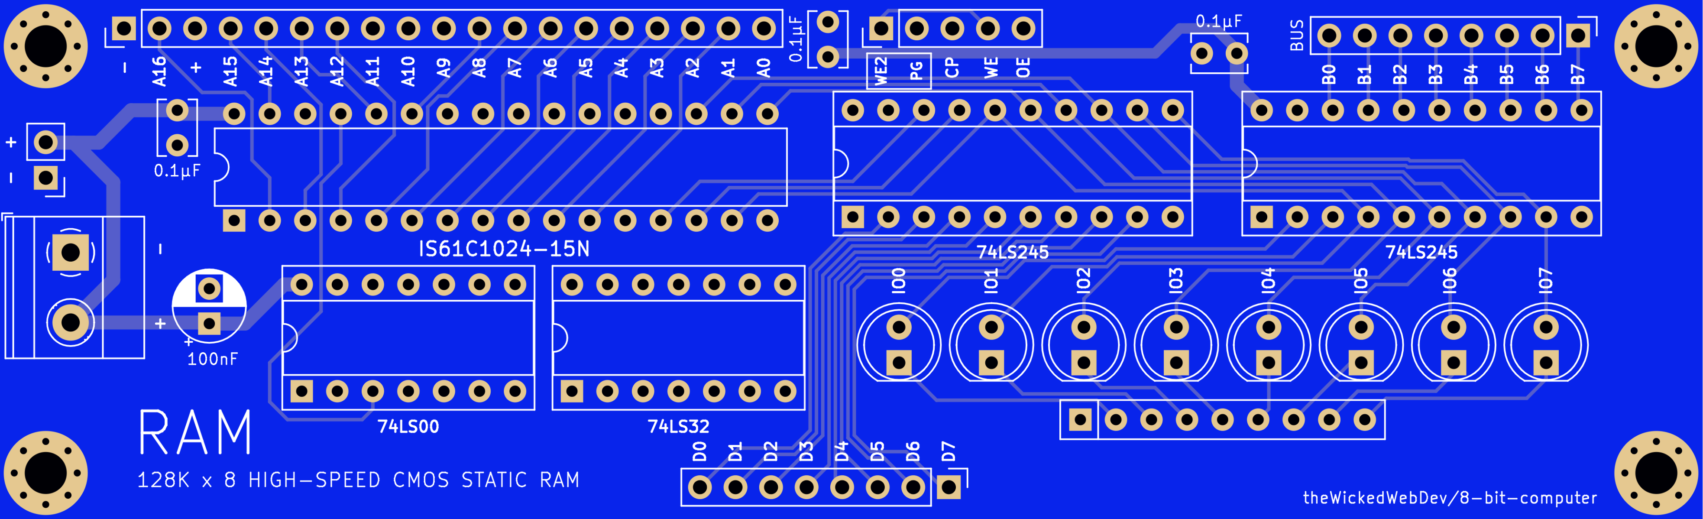
[picture p39: RAM/RAM/ram-board.png]


<br/>

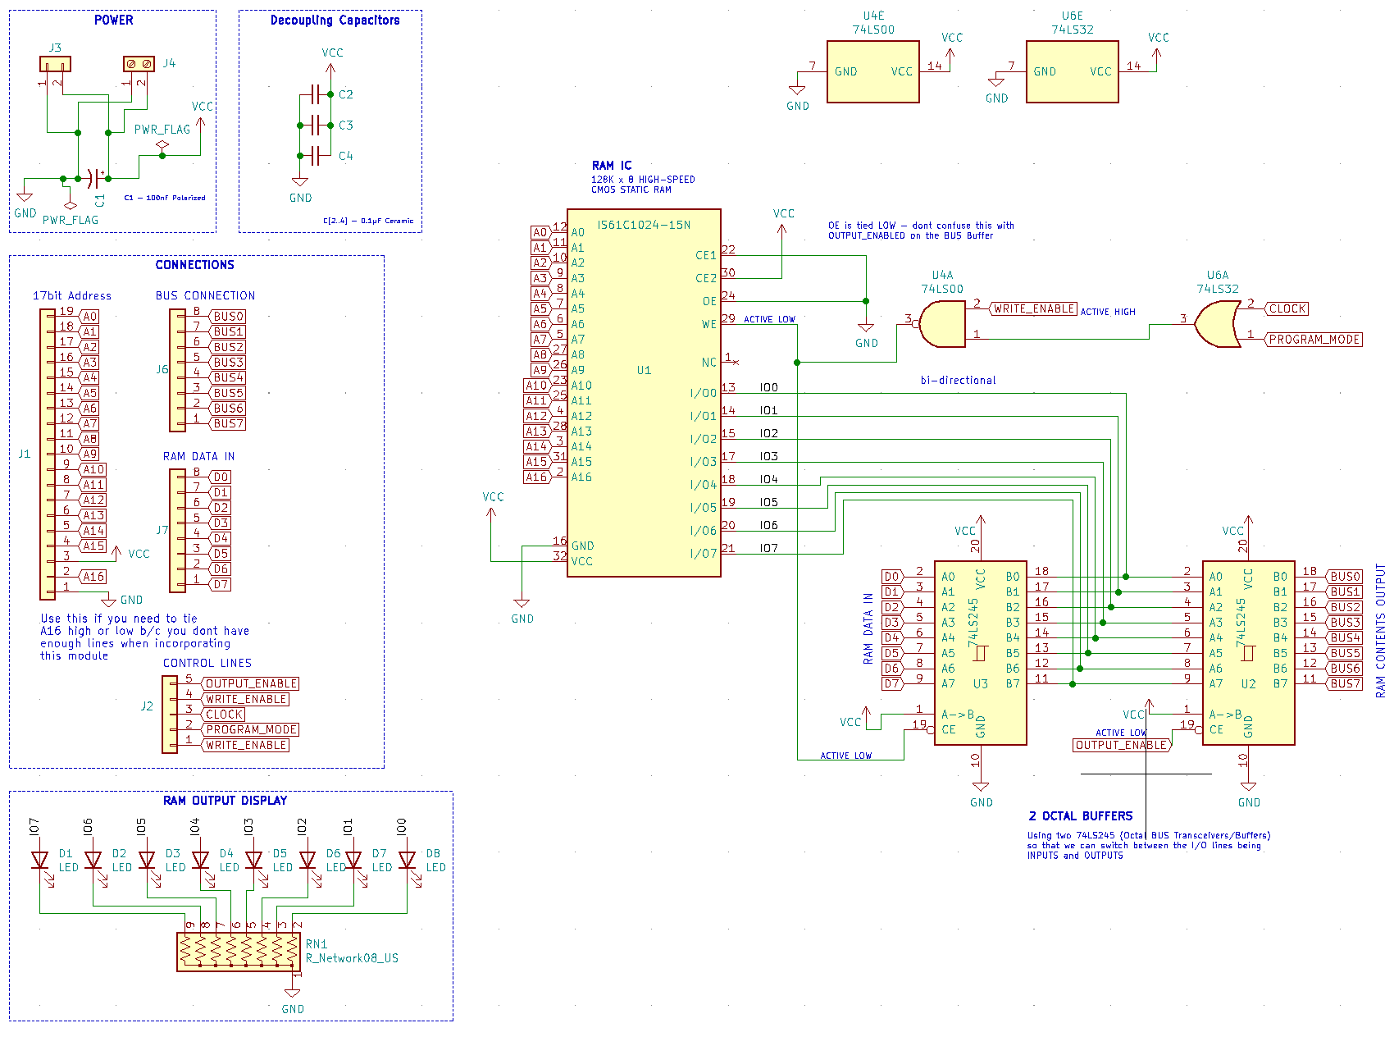
[picture p40: RAM/RAM/ram-sch.png]
