theWickedWebDev/8-bit-computer/Modules/control-module/README.md

# Display Module

todo fixes
- labelling is off for outputs
- invert labelling/logic is wrong

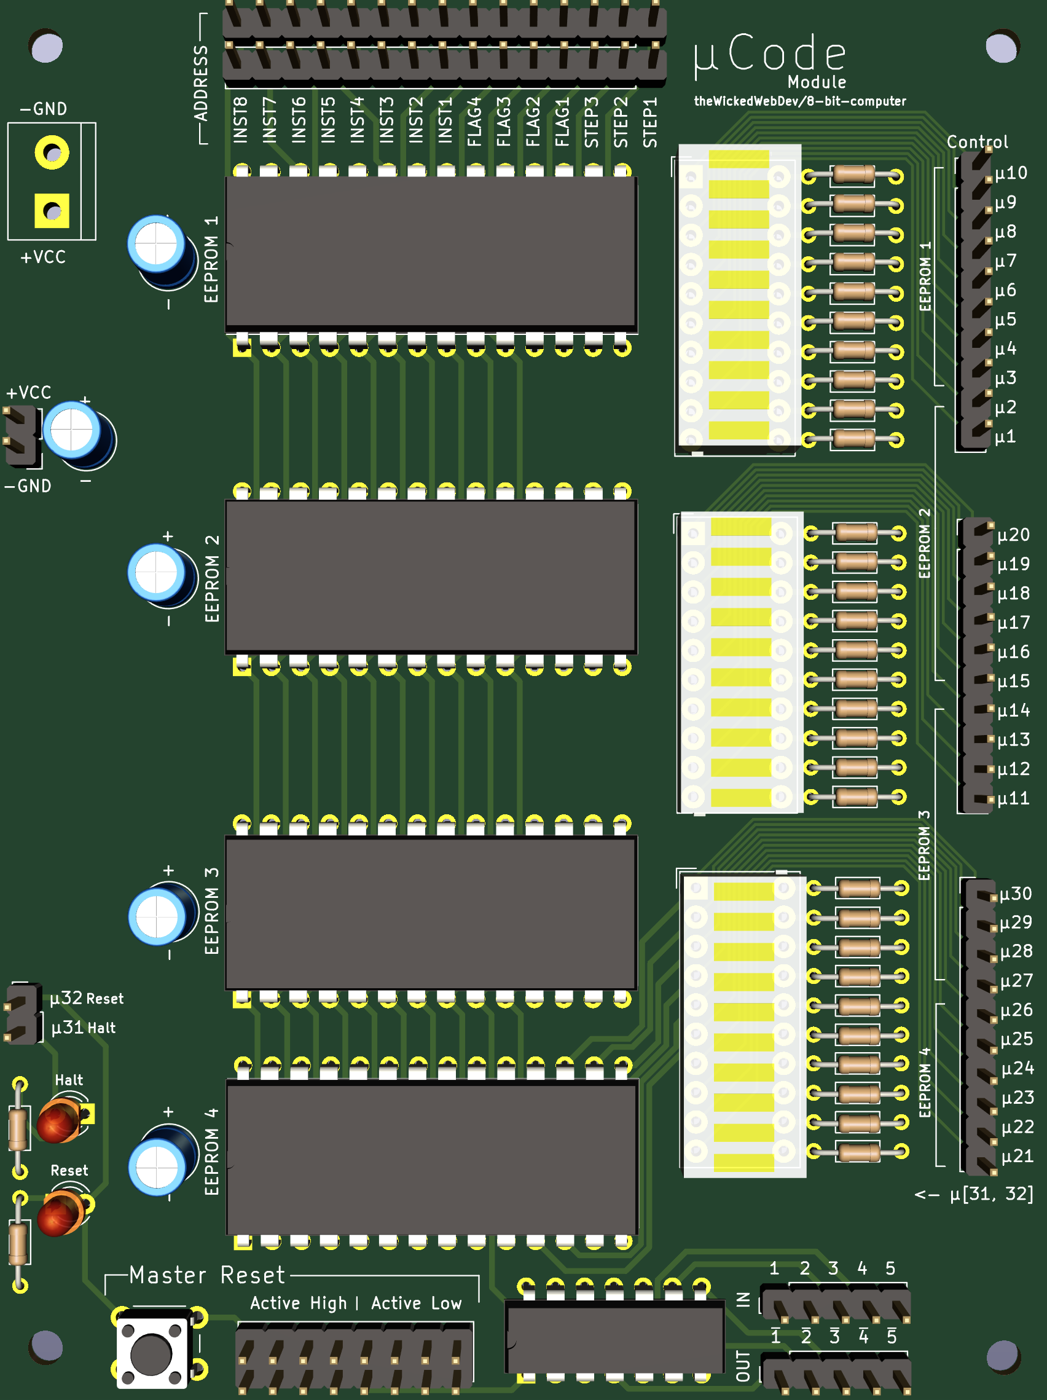
[picture p41: CONTROL_LOGIC/control-3d.png]
MICROCODE
