theWickedWebDev/8-bit-computer/other-modules/ALU-DISCRETE-LOGIC/README.md

# ALU w/ Discrete Logic Chips

More details to come

<br/>

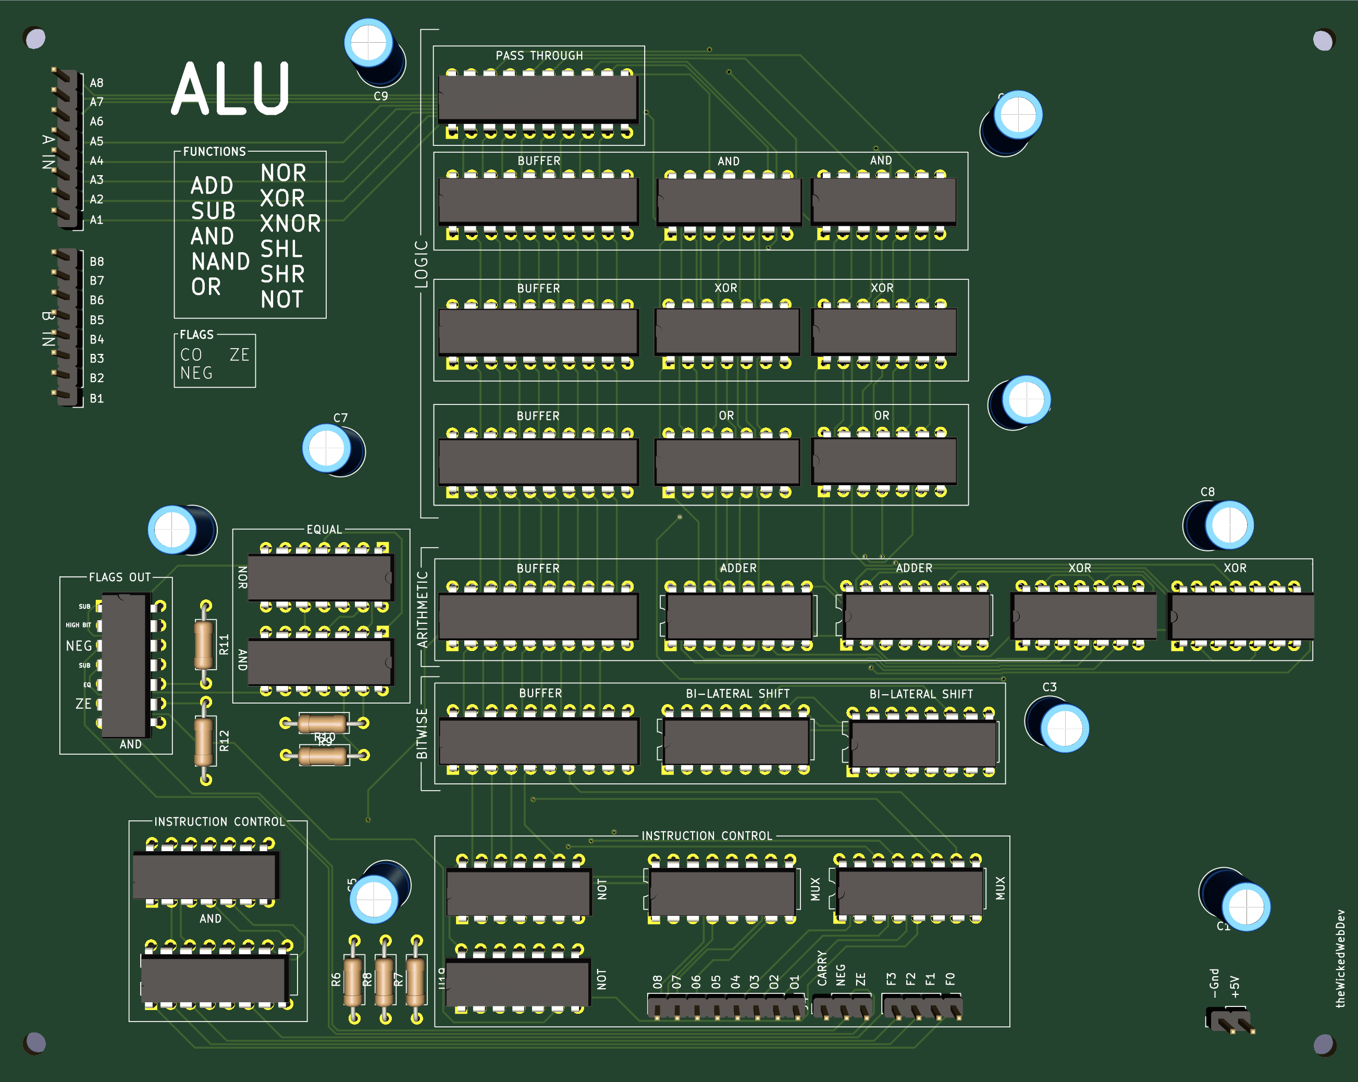
[picture p42: ALU-DISCRETE-LOGIC/alu.png]


<br/>

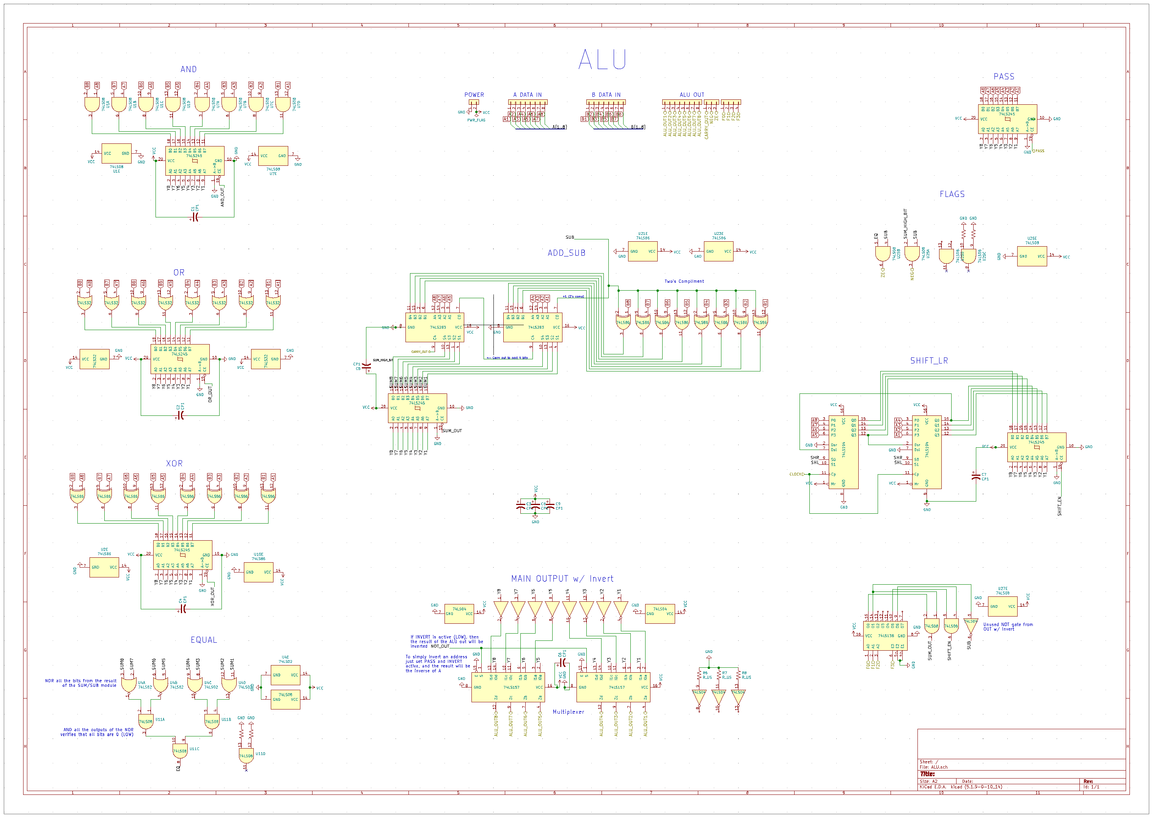
[picture p43: ALU-DISCRETE-LOGIC/alu-sch.png]
