theWickedWebDev/8-bit-computer/DOCUMENTATION/Block Diagrams/GeneralPurposeRegisters.drawio.pdf

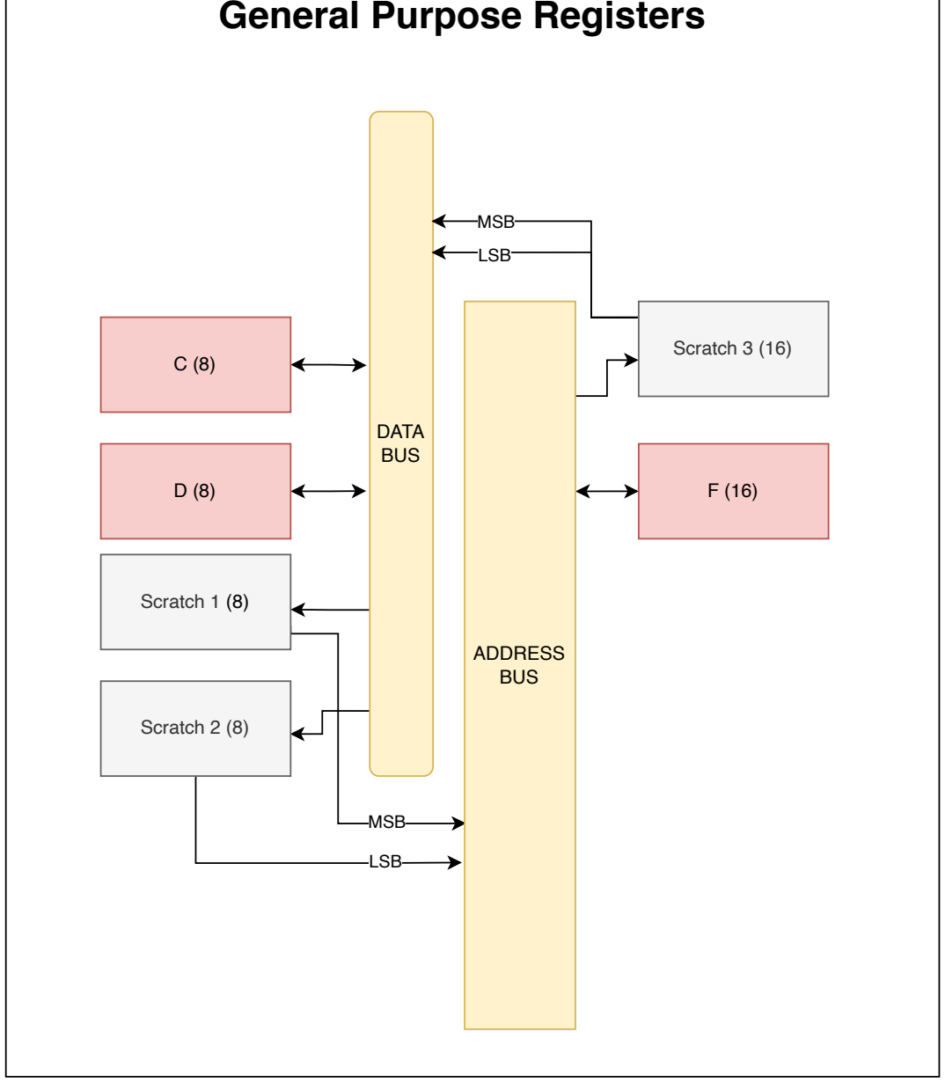
[picture p44: figure]
MSB; Scratch 1 (8); DATA BUS; ADDRESS BUS; LSB; Scratch 3 (16); Scratch 2 (8); General Purpose Registers
