theWickedWebDev/8-bit-computer/DOCUMENTATION/3d-Renderings/GPR.png

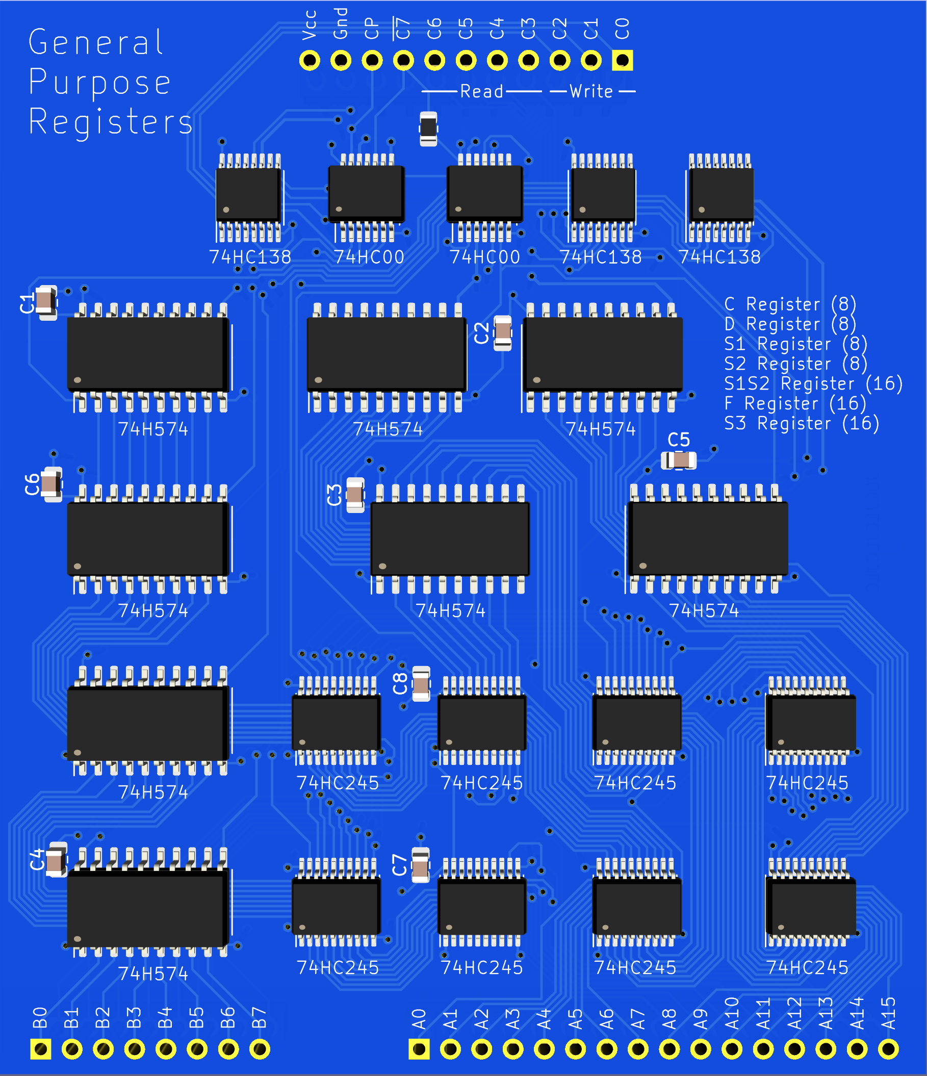
DOCUMENTATION/3d-Renderings/GPR.png
