theWickedWebDev/8-bit-computer/DOCUMENTATION/Block Diagrams/GeneralPurposeRegisters.jpg

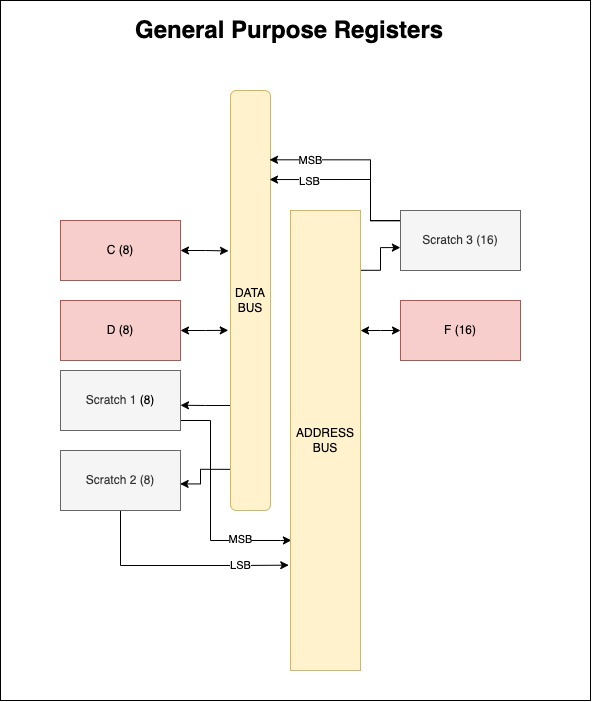
DOCUMENTATION/Block Diagrams/GeneralPurposeRegisters.jpg
