theWickedWebDev/8-bit-computer/Modules/control-module/control-board.png

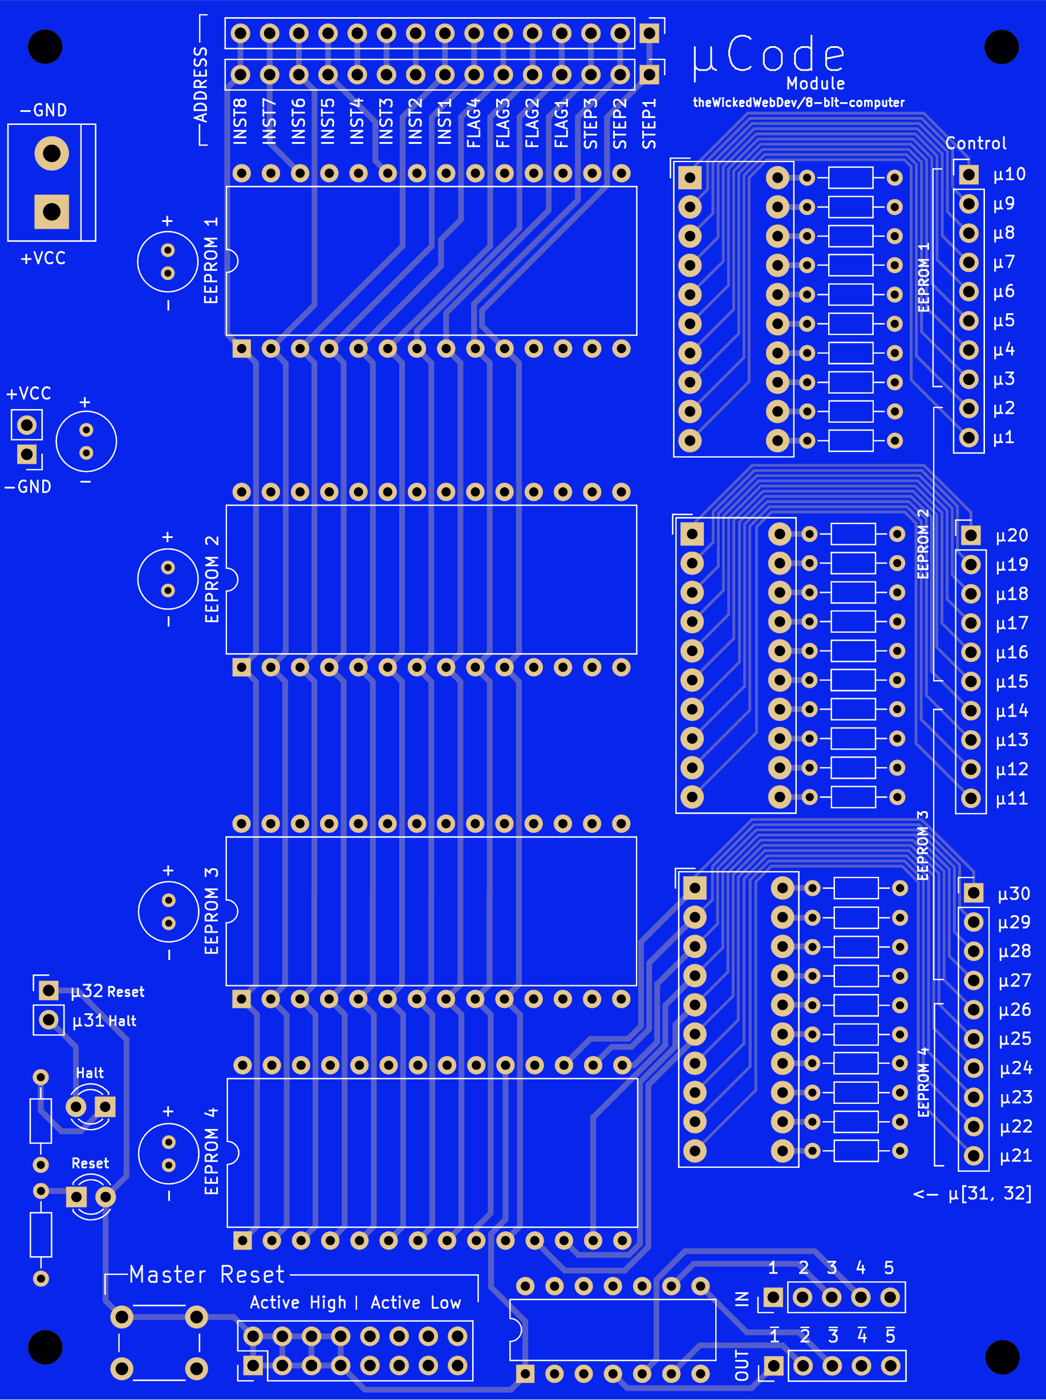
Modules/control-module/control-board.png
