theWickedWebDev/8-bit-computer/Modules/control-module/control-sch.png

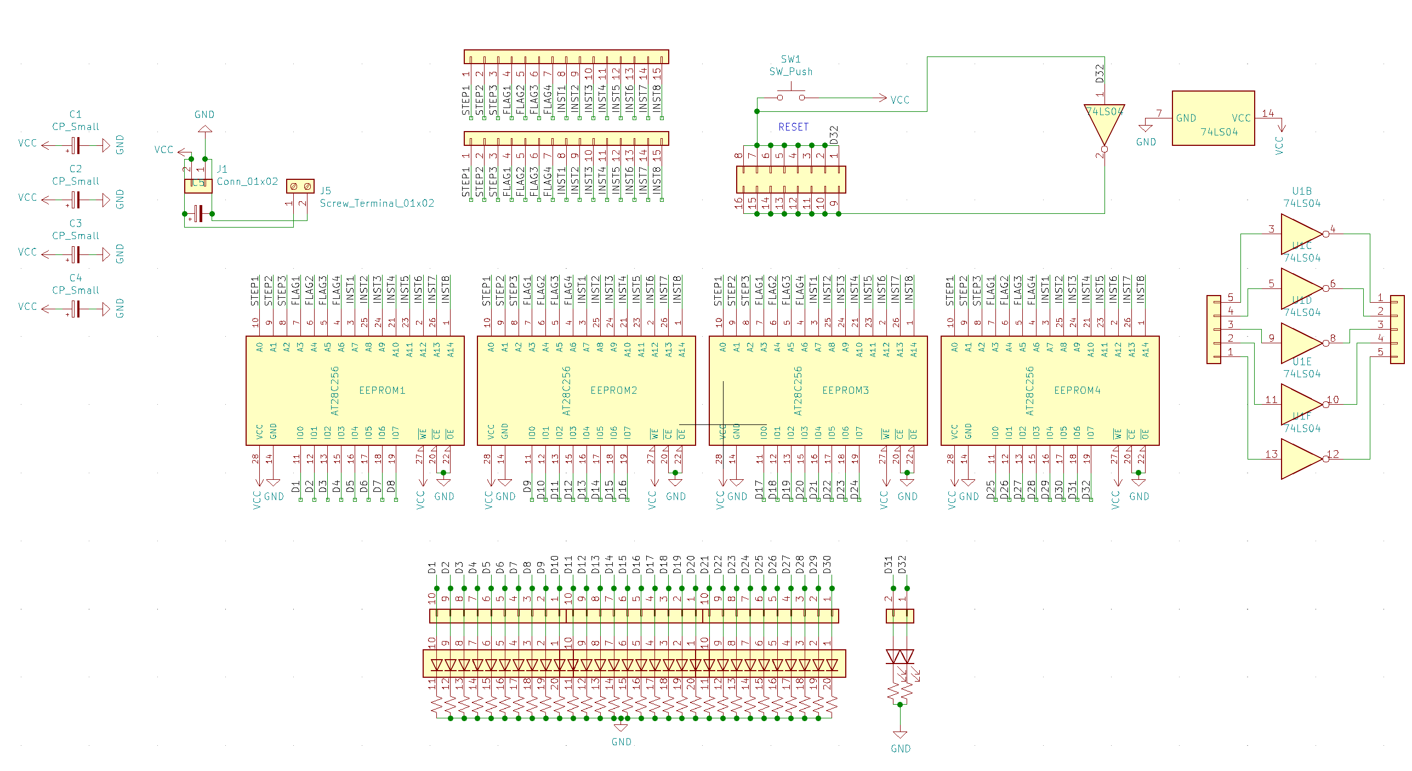
Modules/control-module/control-sch.png
