theWickedWebDev/8-bit-computer/other-modules/ALU-DISCRETE-LOGIC/ALU-ADD-SUB/alu-add-sub-3d.png

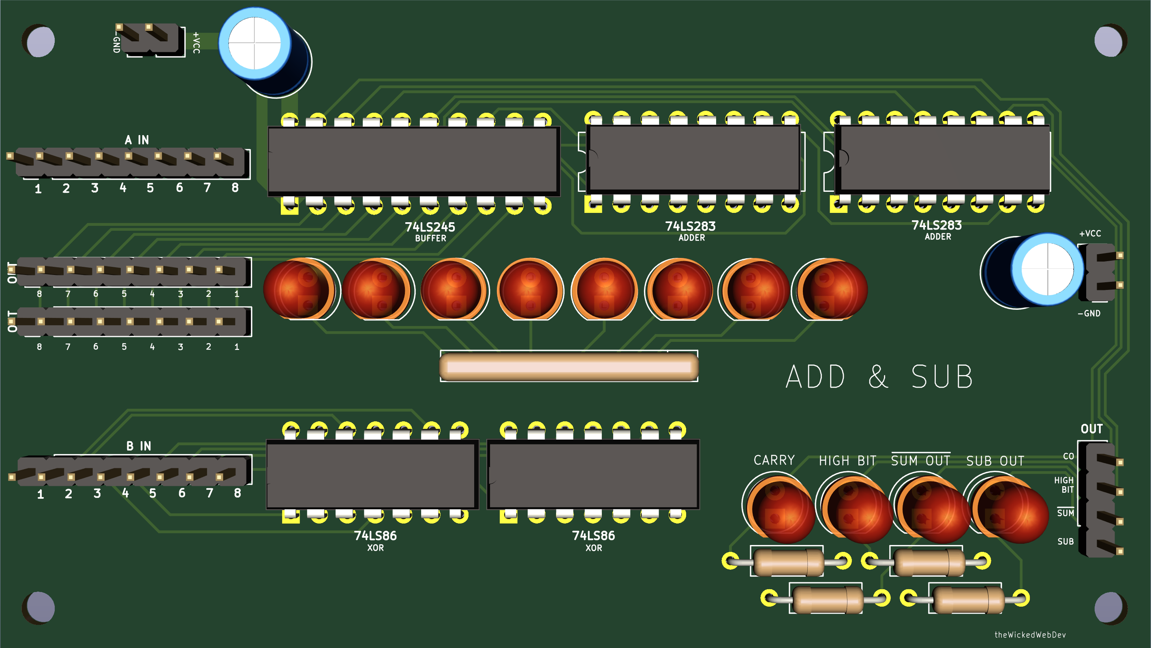
other-modules/ALU-DISCRETE-LOGIC/ALU-ADD-SUB/alu-add-sub-3d.png
