theWickedWebDev/8-bit-computer/other-modules/ALU-DISCRETE-LOGIC/ALU-ADD-SUB/alu-add-sub-sch.png

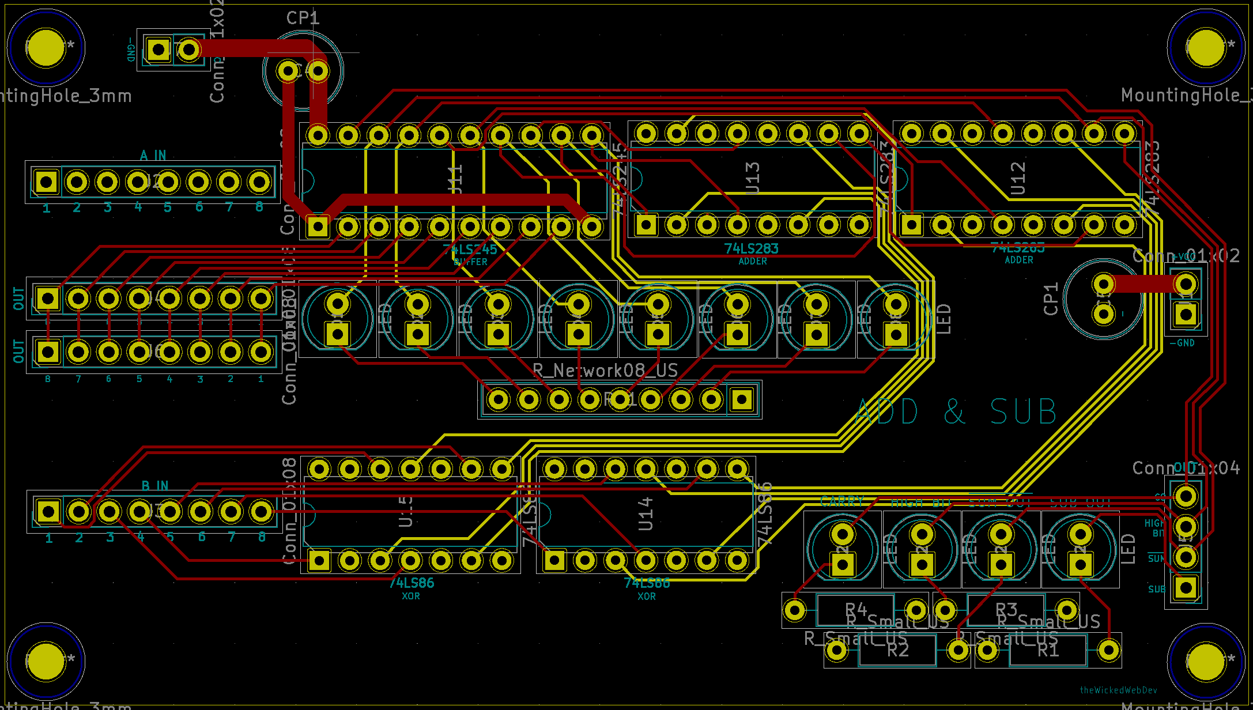
other-modules/ALU-DISCRETE-LOGIC/ALU-ADD-SUB/alu-add-sub-sch.png
