theWickedWebDev/8-bit-computer/other-modules/ALU-DISCRETE-LOGIC/ALU-SHIFT/shift-3d.png

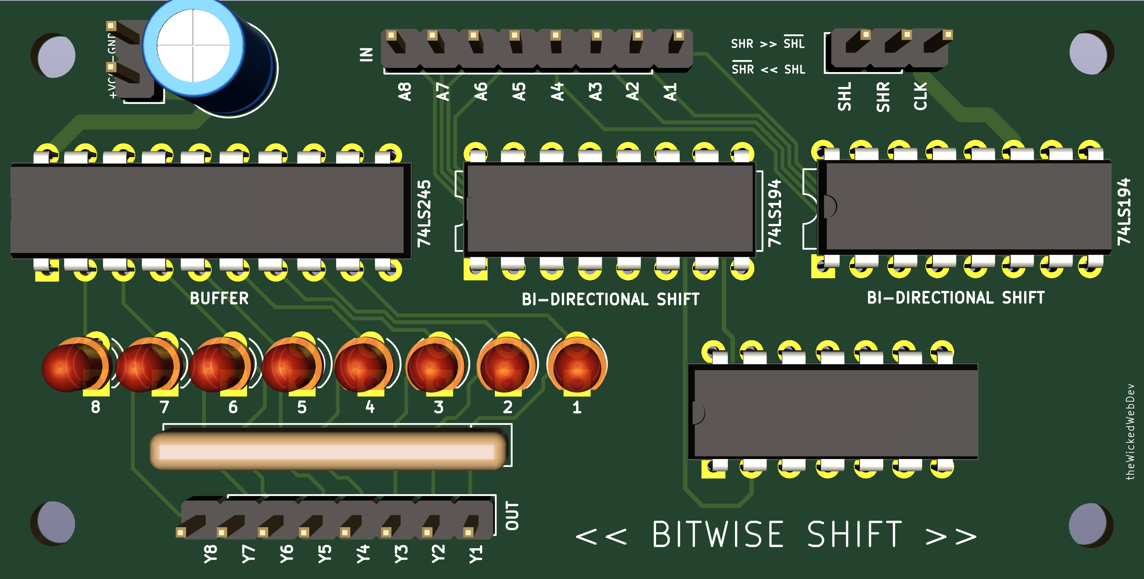
other-modules/ALU-DISCRETE-LOGIC/ALU-SHIFT/shift-3d.png
