theWickedWebDev/8-bit-computer/other-modules/ALU-DISCRETE-LOGIC/ALU-SHIFT/shift-sch.png

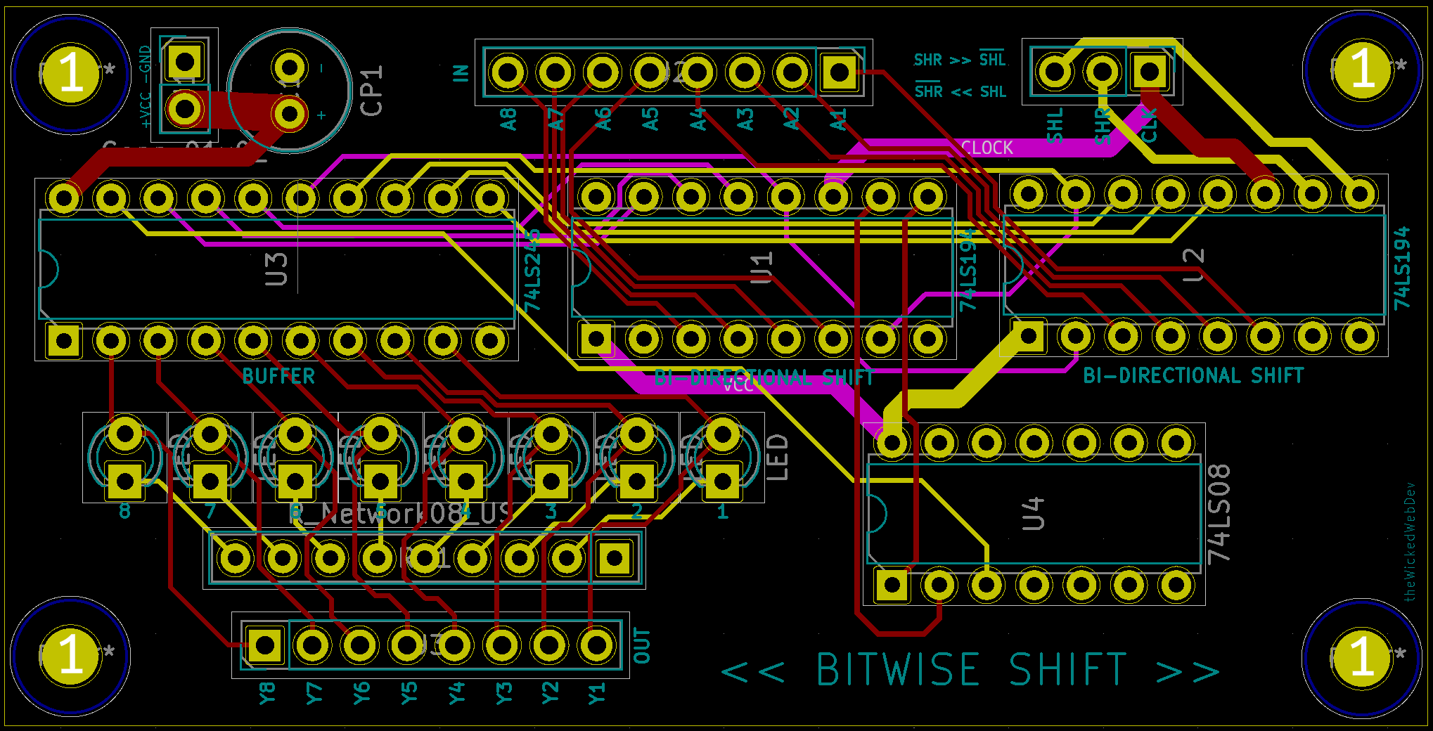
other-modules/ALU-DISCRETE-LOGIC/ALU-SHIFT/shift-sch.png
