theWickedWebDev/8-bit-computer/other-modules/ALU-DISCRETE-LOGIC/ALU_LOGIC/logic-3d.png

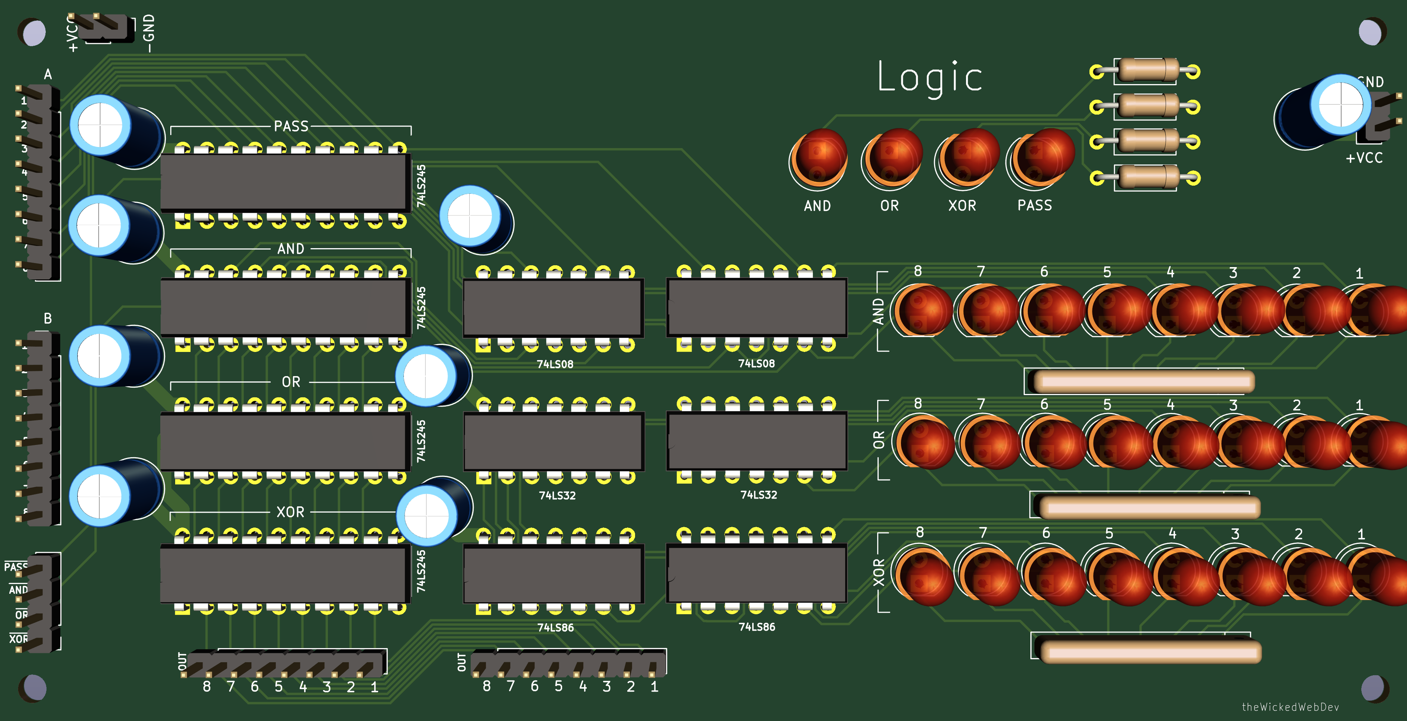
other-modules/ALU-DISCRETE-LOGIC/ALU_LOGIC/logic-3d.png
