theWickedWebDev/8-bit-computer/other-modules/ALU-DISCRETE-LOGIC/ALU_LOGIC/logic-board.png

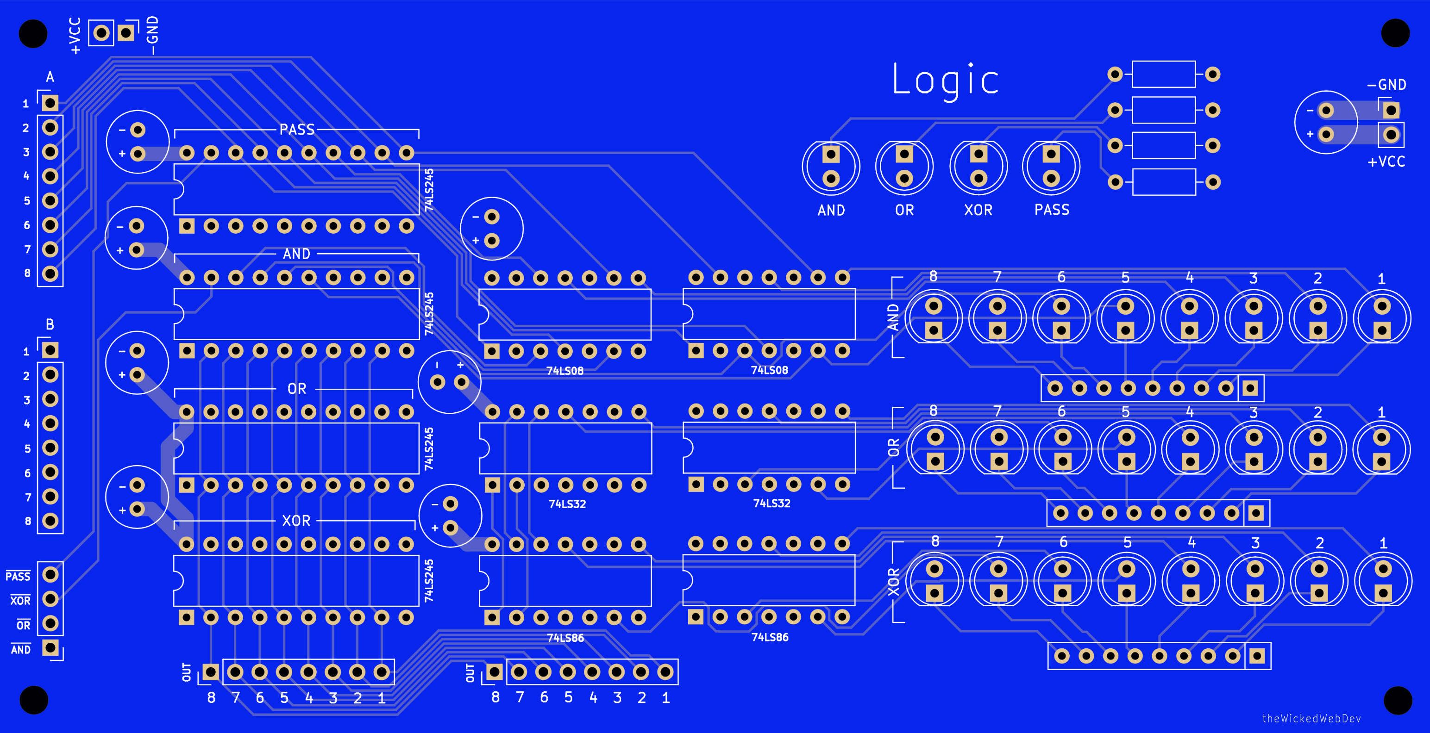
other-modules/ALU-DISCRETE-LOGIC/ALU_LOGIC/logic-board.png
