theWickedWebDev/8-bit-computer/other-modules/BUS_BOARD/bus-board-board.png

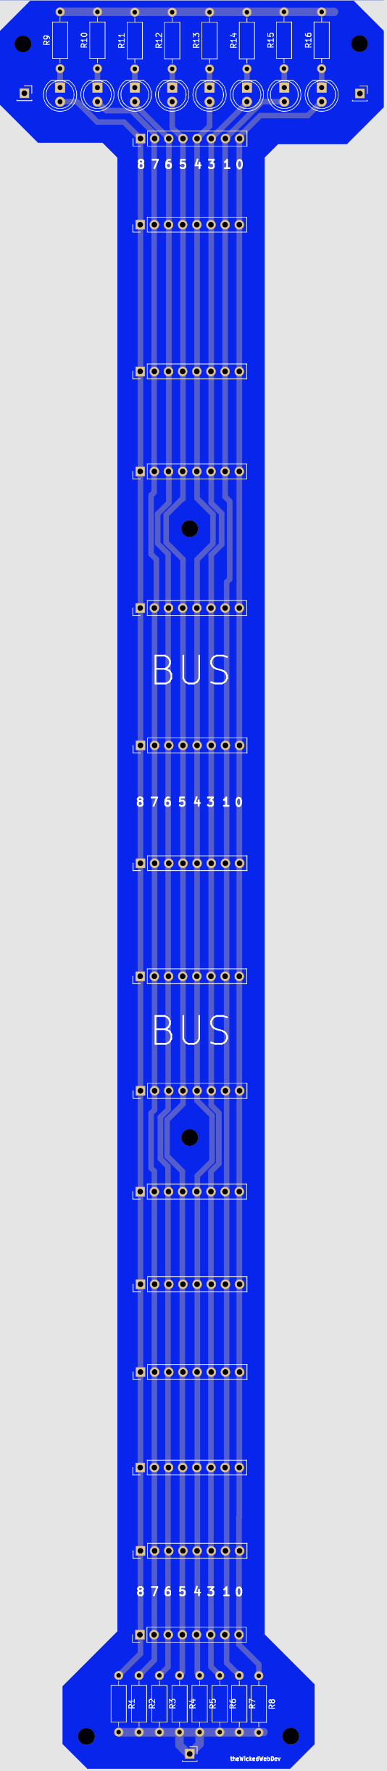
other-modules/BUS_BOARD/bus-board-board.png
