theWickedWebDev/8-bit-computer/PCB-Modules/99_IN PROGRESS/memory/RAM-MODULE.jpg

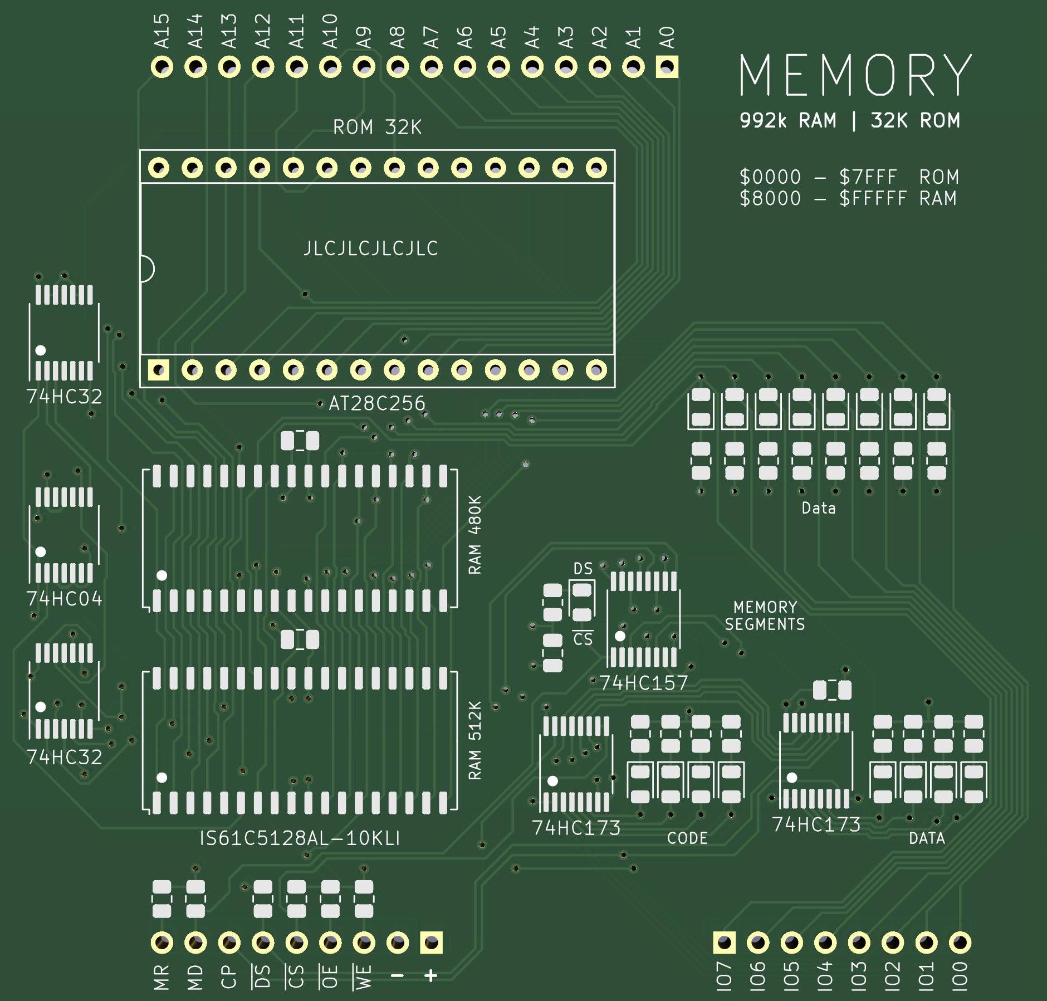
PCB-Modules/99_IN PROGRESS/memory/RAM-MODULE.jpg
