theWickedWebDev/8-bit-computer/PCBs/03_MODULES/CPU-ALU/ALU-Arithmetic/ALU-Arithmetic-schematic.jpg

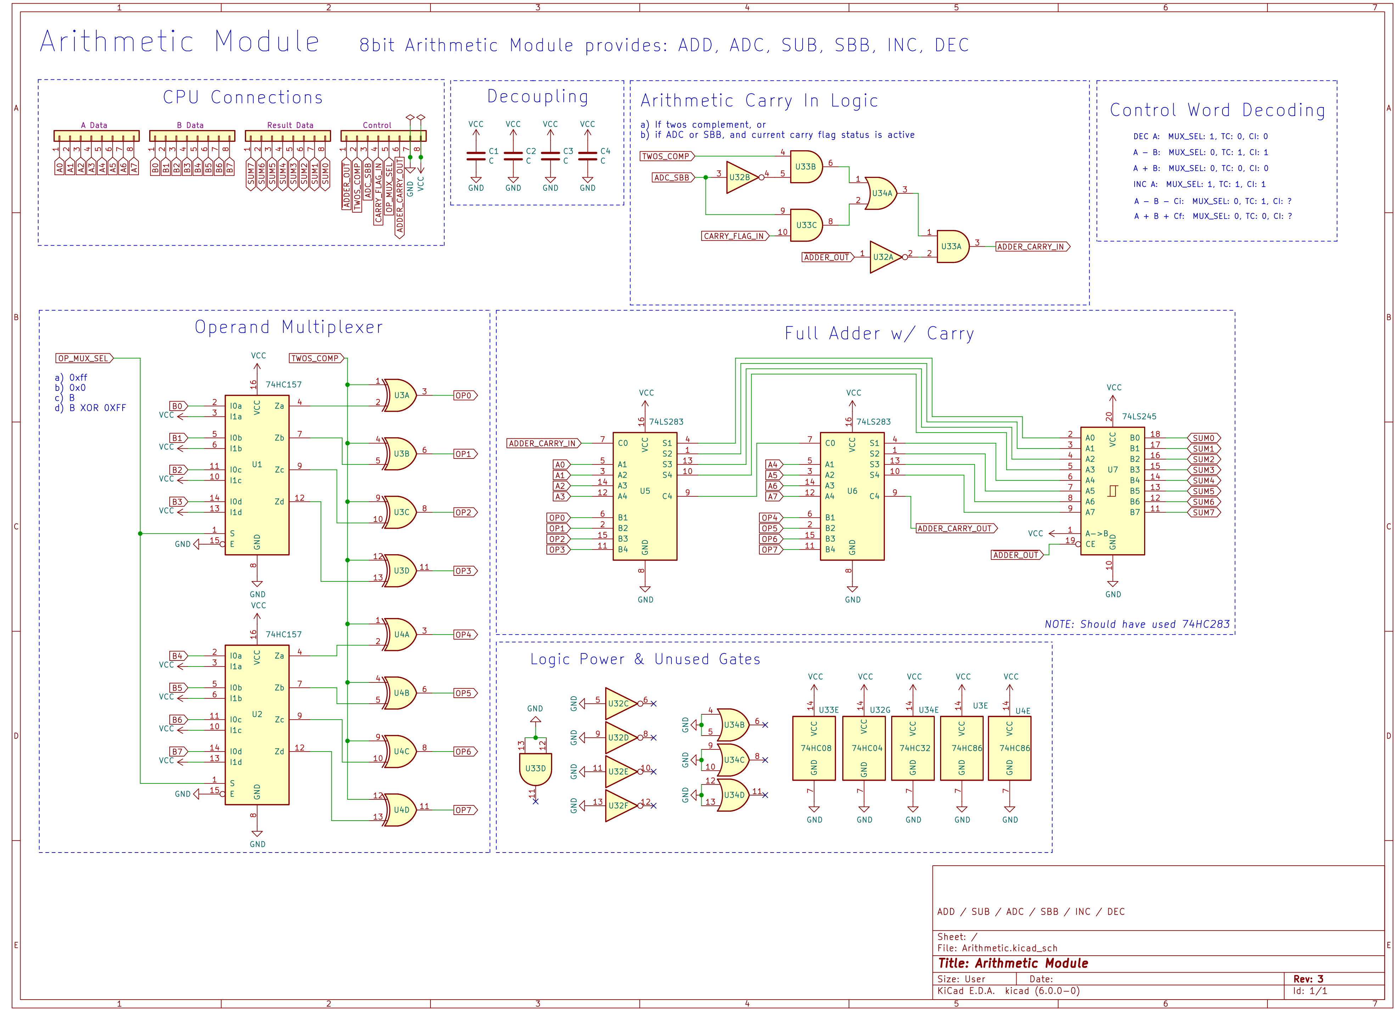
PCBs/03_MODULES/CPU-ALU/ALU-Arithmetic/ALU-Arithmetic-schematic.jpg
