theWickedWebDev/8-bit-computer/PCBs/03_MODULES/CPU-ALU/ALU-Board.jpeg

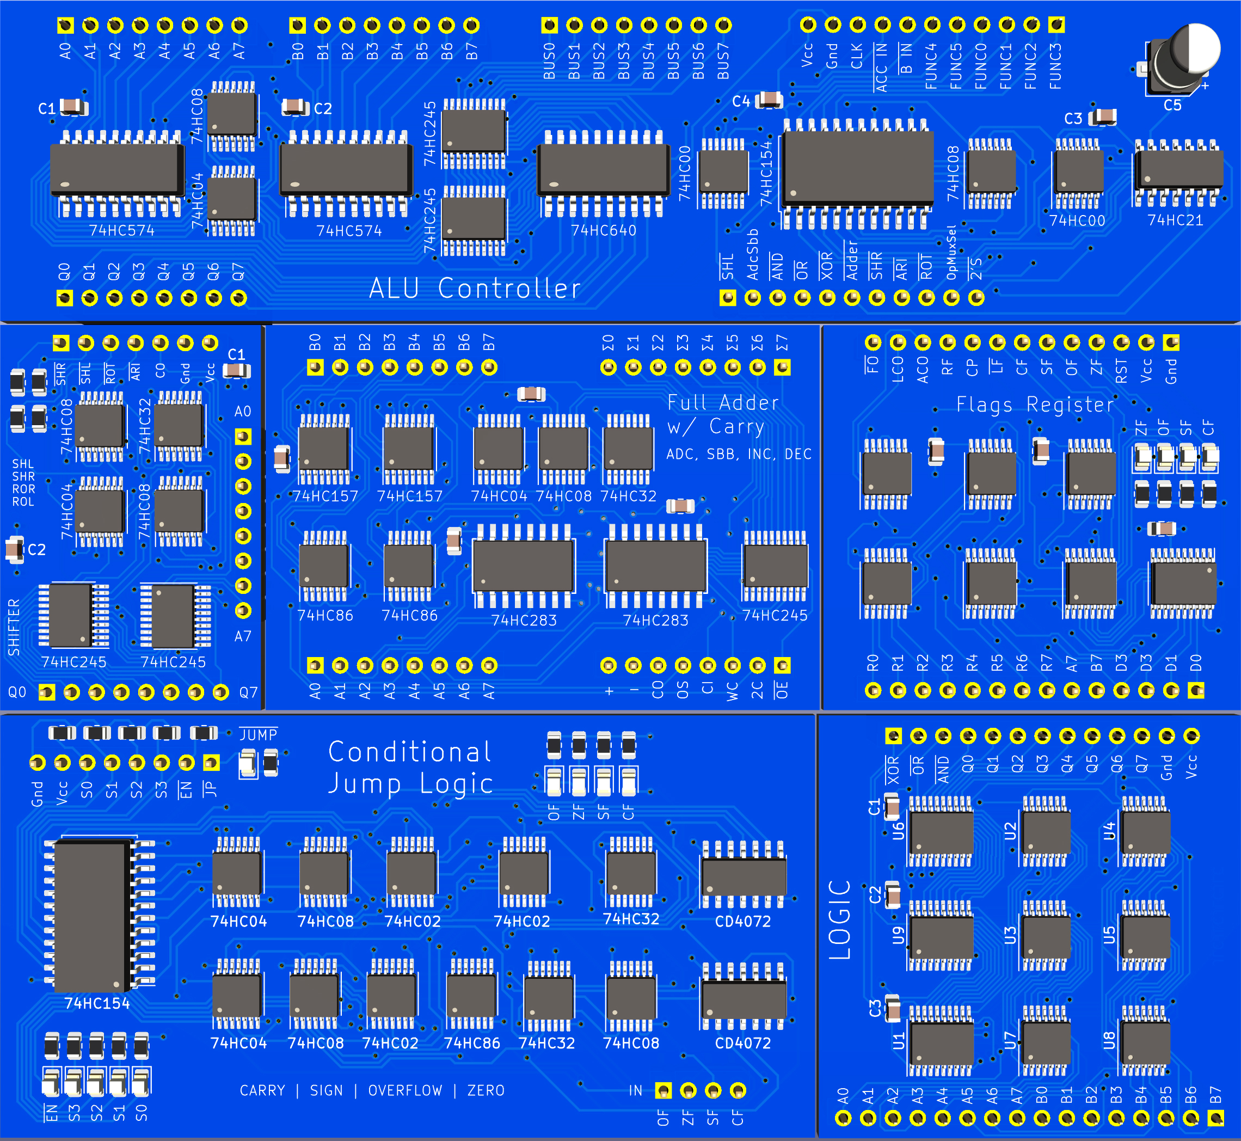
PCBs/03_MODULES/CPU-ALU/ALU-Board.jpeg
