theWickedWebDev/8-bit-computer/PCBs/99_IN PROGRESS/IO-Midi/breadboard1.jpg

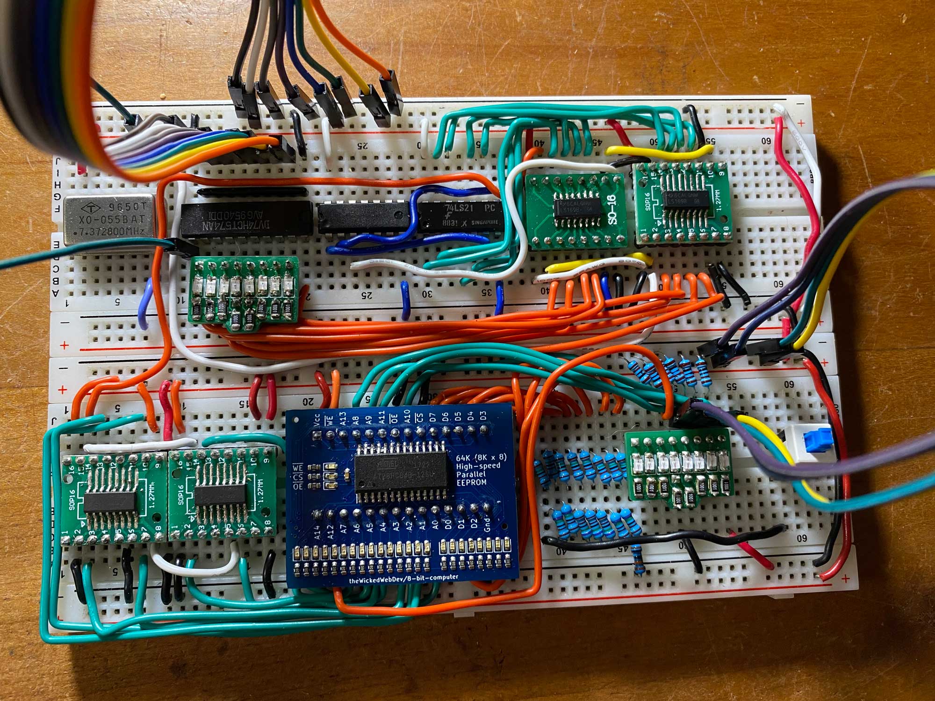
PCBs/99_IN PROGRESS/IO-Midi/breadboard1.jpg
