theWickedWebDev/8-bit-computer/PCBs/99_IN PROGRESS/IO-Midi/breadboard2.jpg

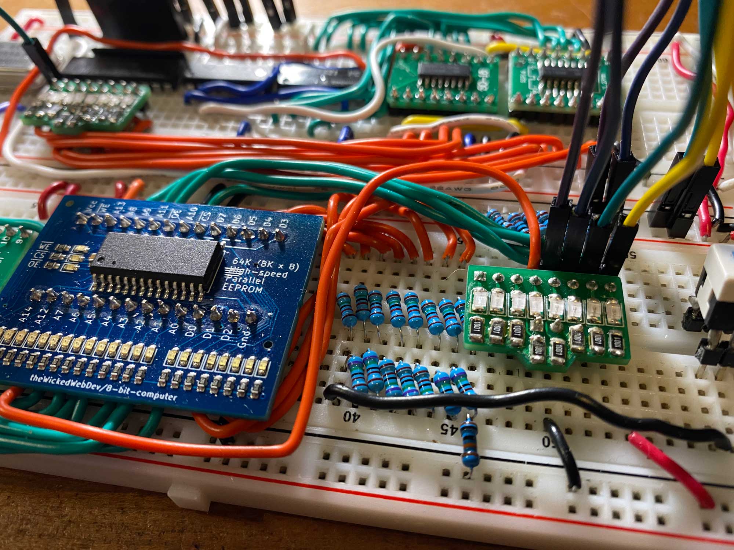
PCBs/99_IN PROGRESS/IO-Midi/breadboard2.jpg
