theWickedWebDev/8-bit-computer/PCBs/99_IN PROGRESS/IO-Midi/schematic.jpg

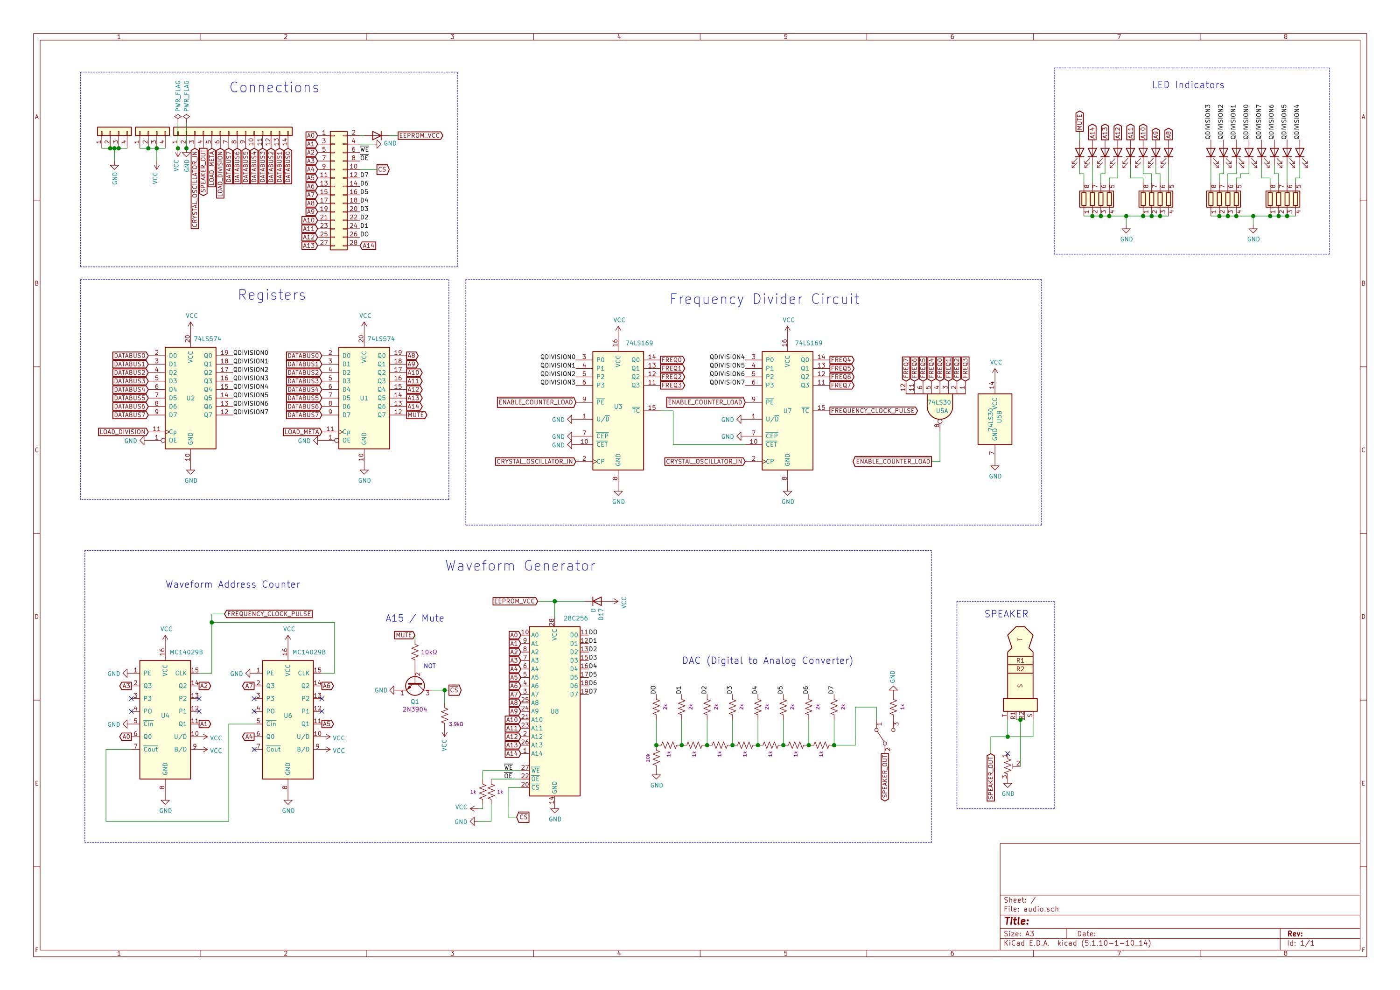
PCBs/99_IN PROGRESS/IO-Midi/schematic.jpg
