theWickedWebDev/8-bit-computer/PCBs/999-QUEUED-TO-PRINT/CLOCK/schematic/CLOCK.jpg

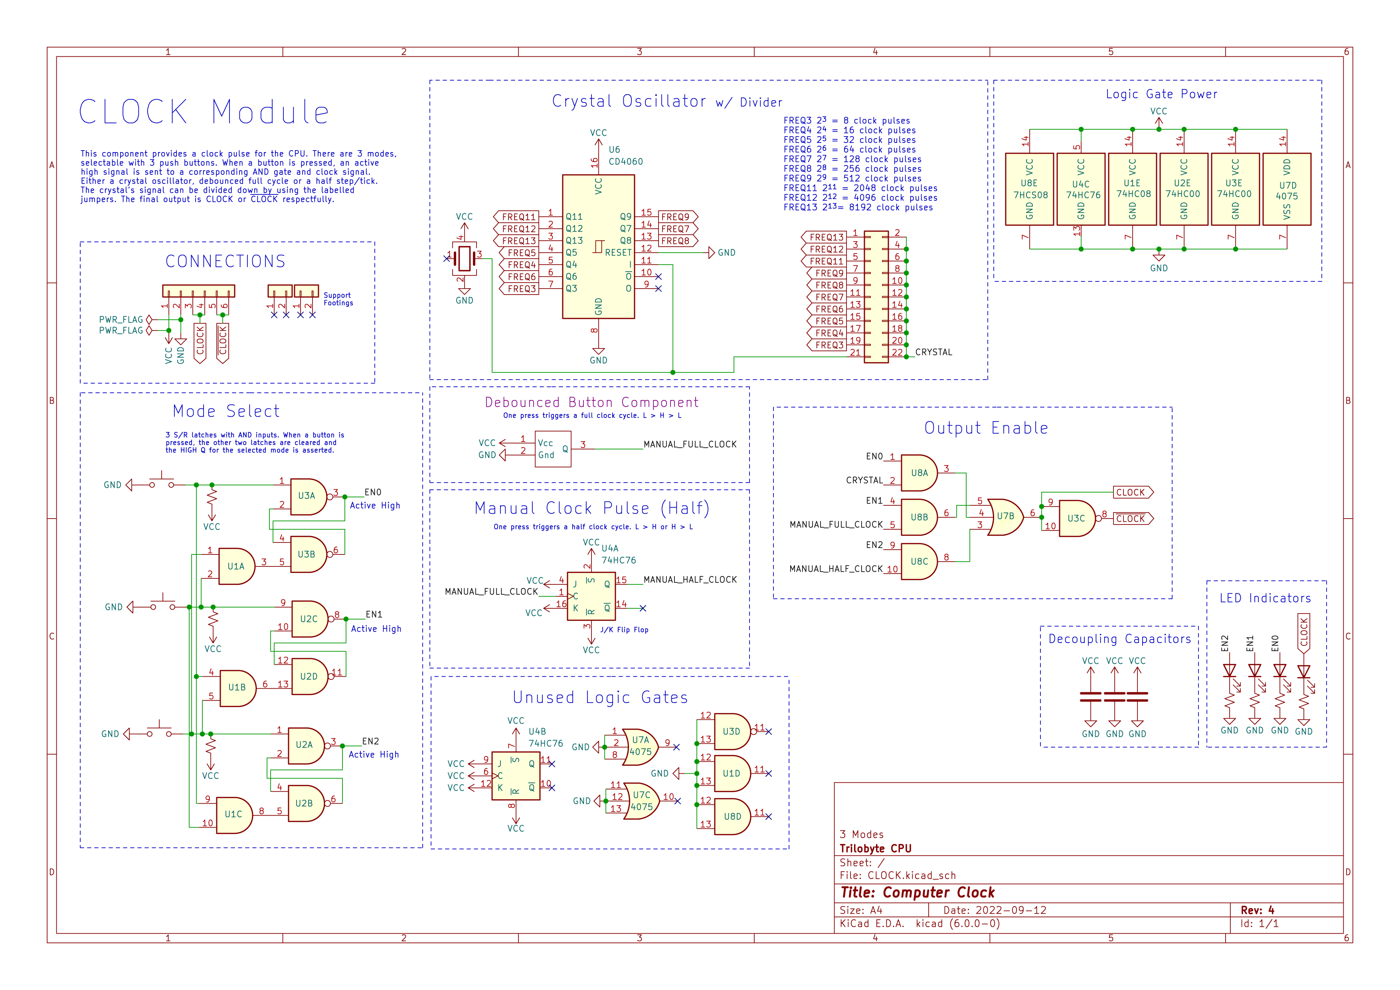
PCBs/999-QUEUED-TO-PRINT/CLOCK/schematic/CLOCK.jpg
