theWickedWebDev/8-bit-computer/PCBs/999-QUEUED-TO-PRINT/CLOCK/schematic/GERBER.jpg

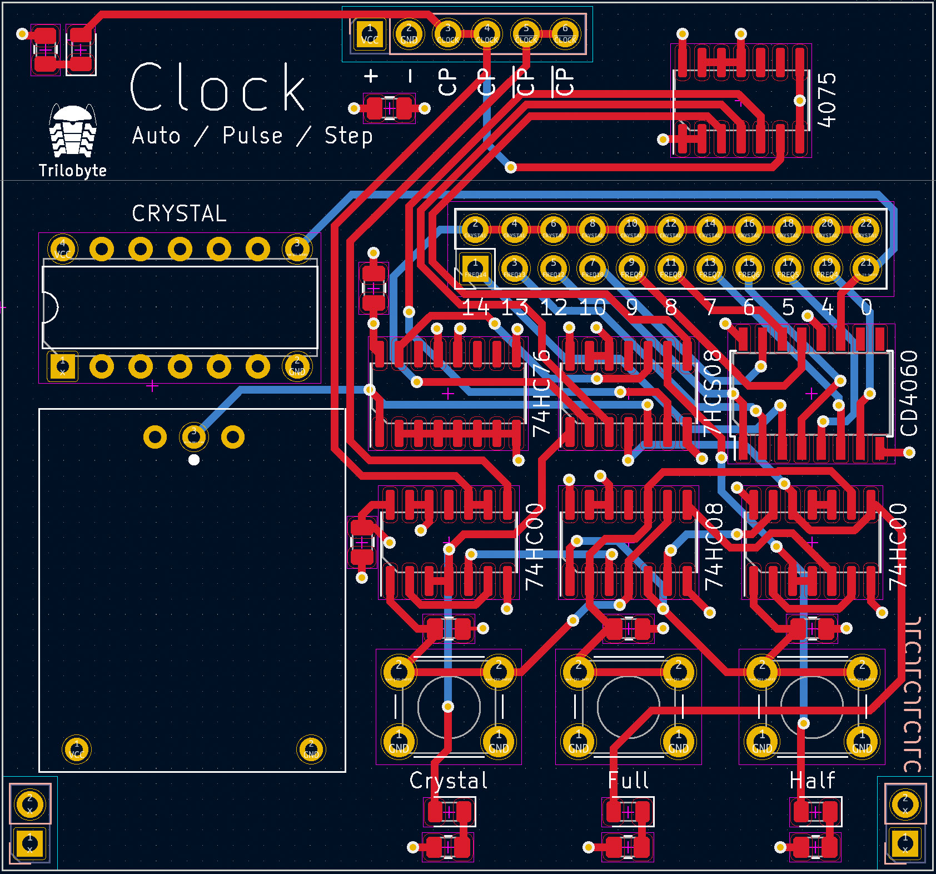
PCBs/999-QUEUED-TO-PRINT/CLOCK/schematic/GERBER.jpg
