theWickedWebDev/8-bit-computer/trilobyte-web/src/images/ALU-Arithmetic-Board.png

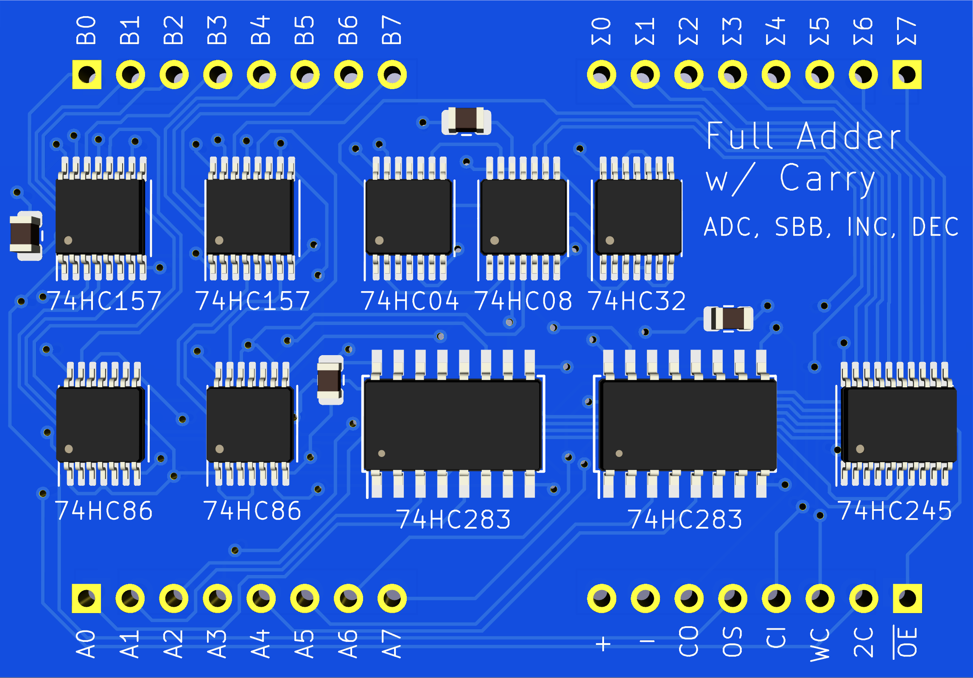
trilobyte-web/src/images/ALU-Arithmetic-Board.png
