theWickedWebDev/8-bit-computer/trilobyte-web/src/images/ALU-Arithmetic-Diagram.jpg

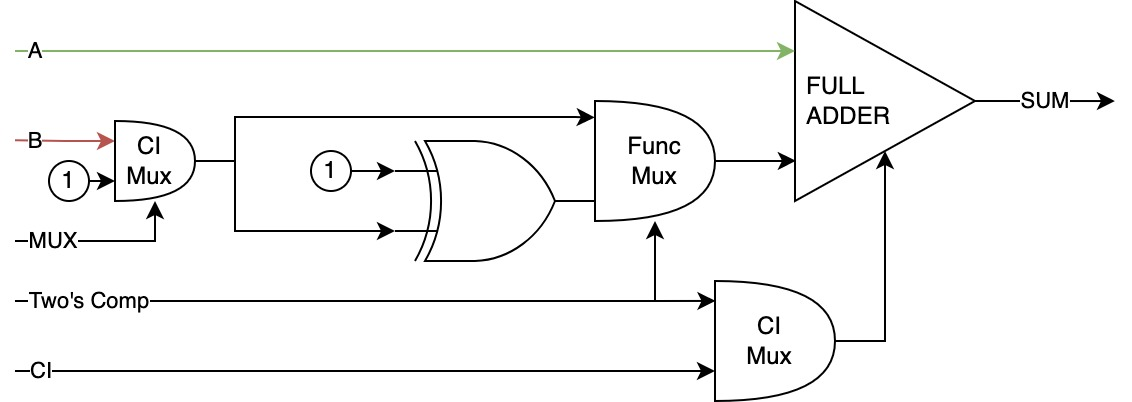
trilobyte-web/src/images/ALU-Arithmetic-Diagram.jpg
