theWickedWebDev/8-bit-computer/trilobyte-web/src/images/ALU-Arithmetic-Gerber.png

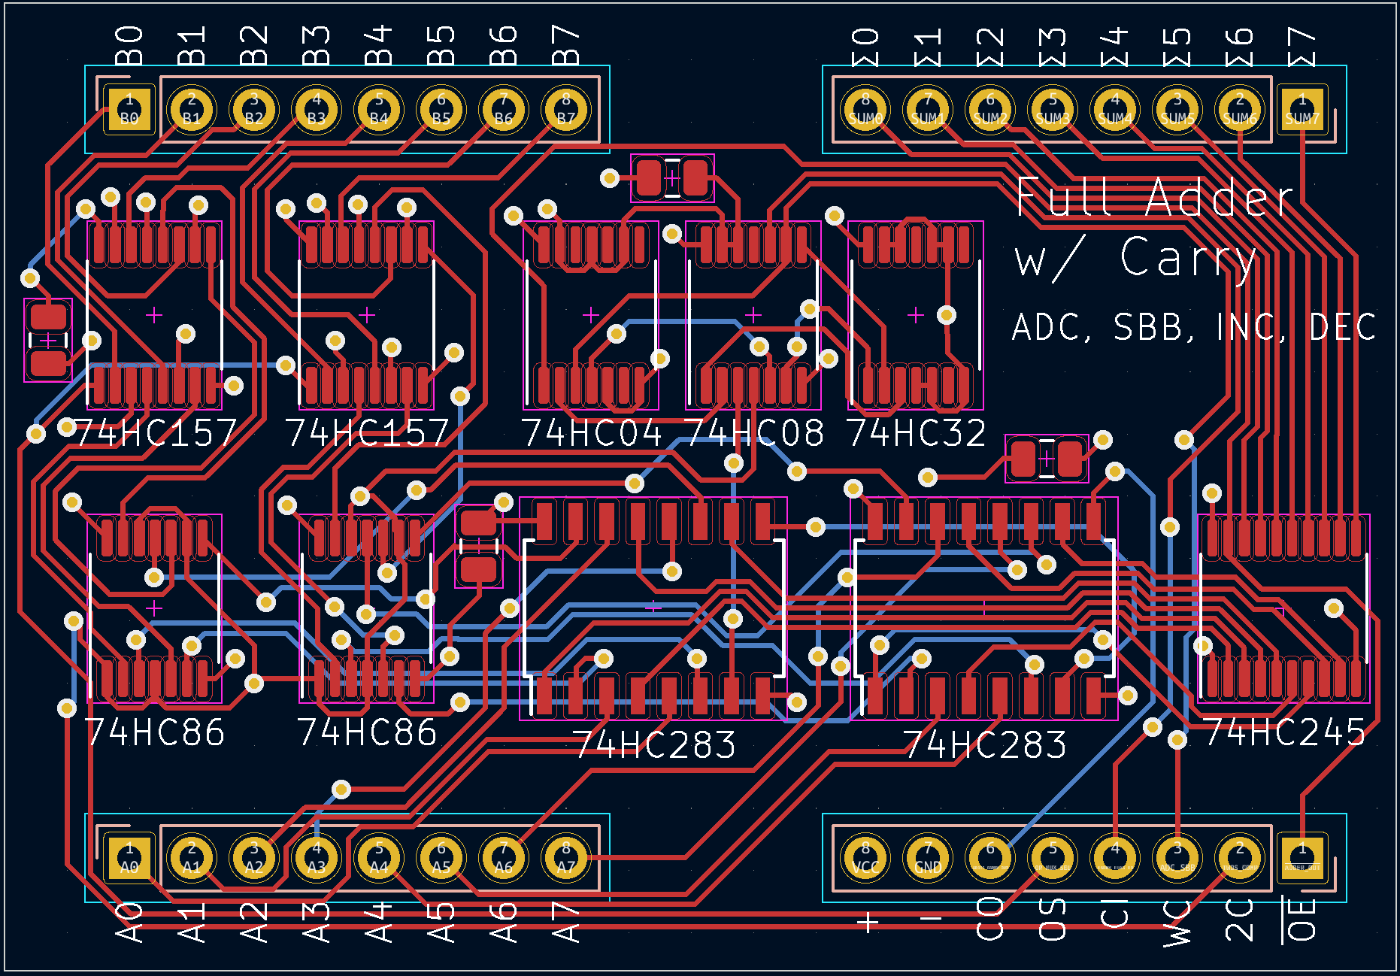
trilobyte-web/src/images/ALU-Arithmetic-Gerber.png
