theWickedWebDev/8-bit-computer/trilobyte-web/src/images/ALU-Arithmetic-Schematic.jpg

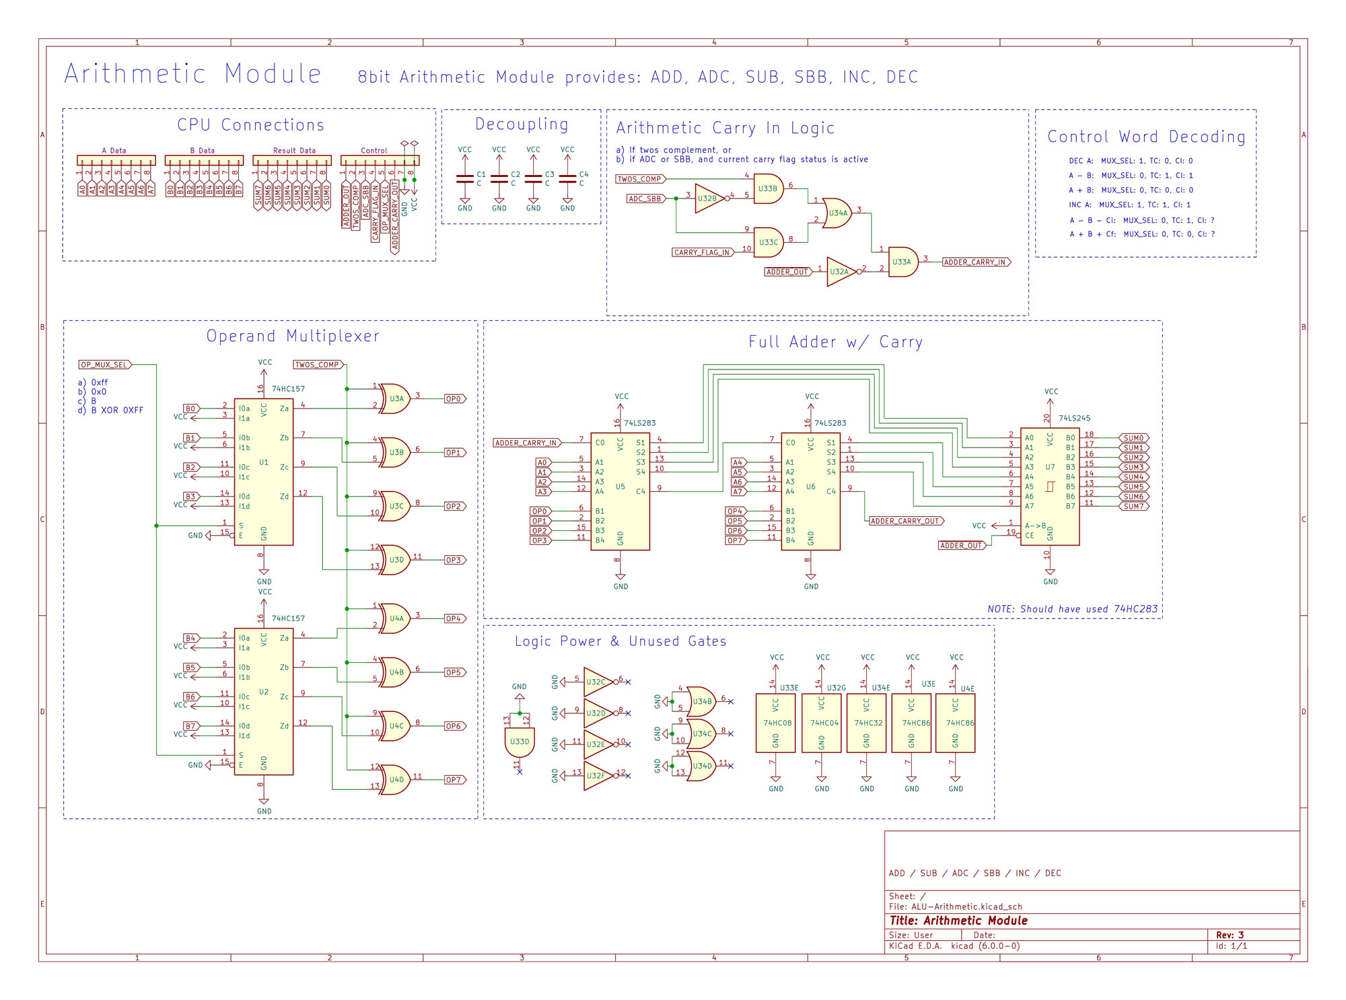
trilobyte-web/src/images/ALU-Arithmetic-Schematic.jpg
