theWickedWebDev/8-bit-computer/trilobyte-web/src/images/ALU-Block-Diagram.jpg

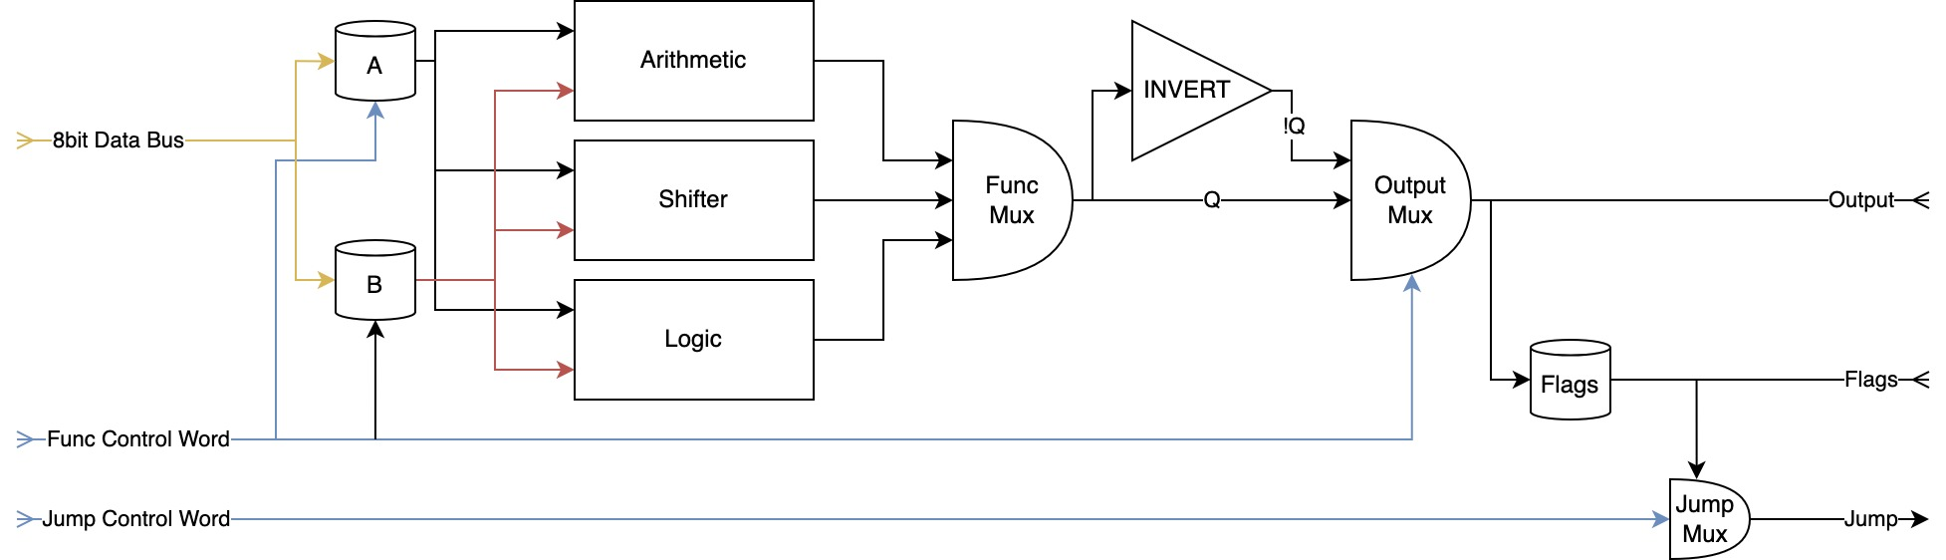
trilobyte-web/src/images/ALU-Block-Diagram.jpg
