theWickedWebDev/8-bit-computer/trilobyte-web/src/images/ALU-Logic-Diagram.jpg

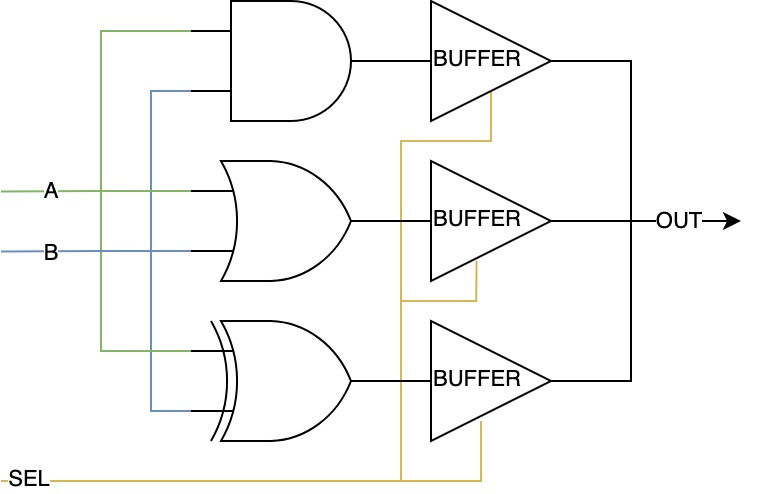
trilobyte-web/src/images/ALU-Logic-Diagram.jpg
