theWickedWebDev/8-bit-computer/trilobyte-web/src/images/alu-logic.png

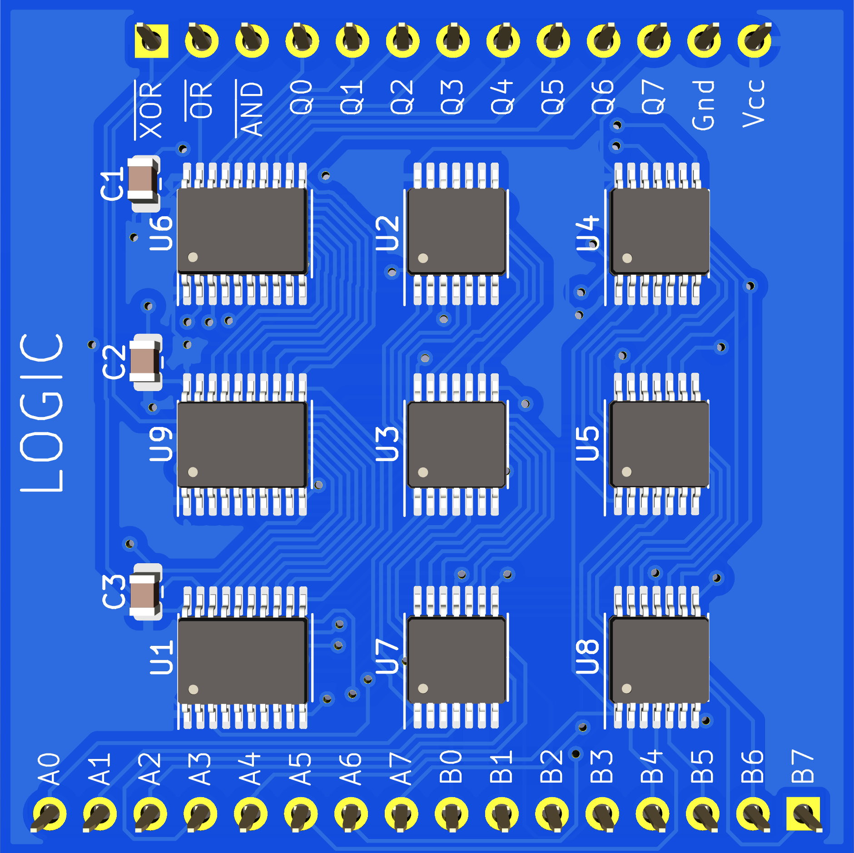
trilobyte-web/src/images/alu-logic.png
