theWickedWebDev/8-bit-computer/trilobyte-web/src/images/alu-shifter.png

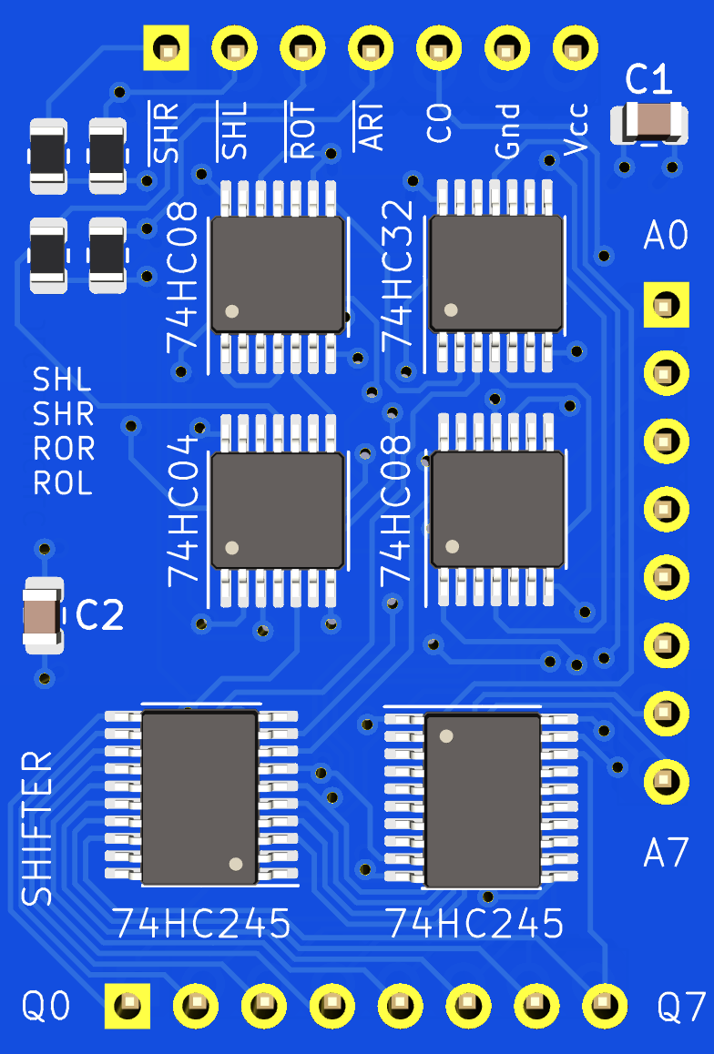
trilobyte-web/src/images/alu-shifter.png
