theWickedWebDev/8-bit-computer/KiCad_Libraries/3D-Modals/Crystal-FullCan-Dip14.step

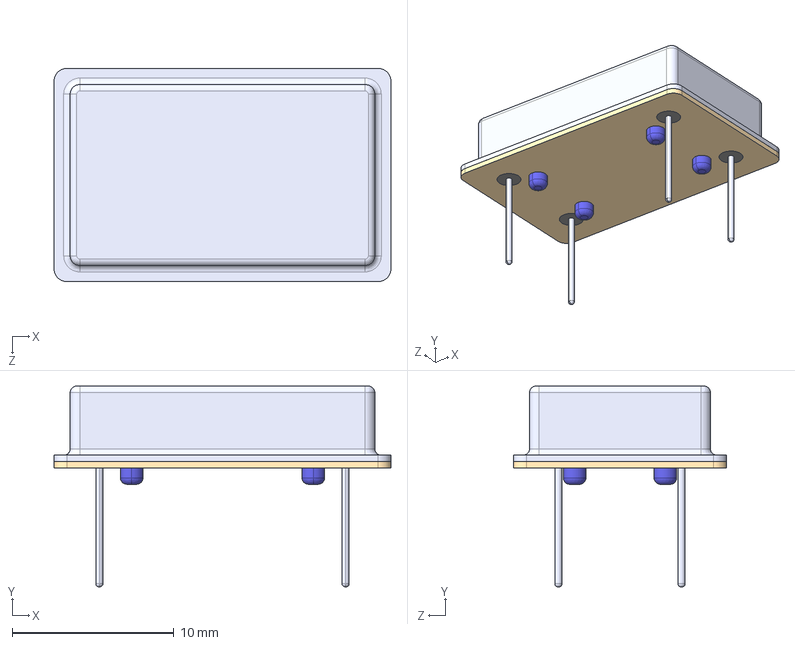
[picture p72: CAD file, 2022-11-09]
KiCad_Libraries/3D-Modals/Crystal-FullCan-Dip14.step
20.9 x 12.4 x 13.2 mm
