theWickedWebDev/8-bit-computer/KiCad_Libraries/3D-Modals/LED_0805_2012Metric.step

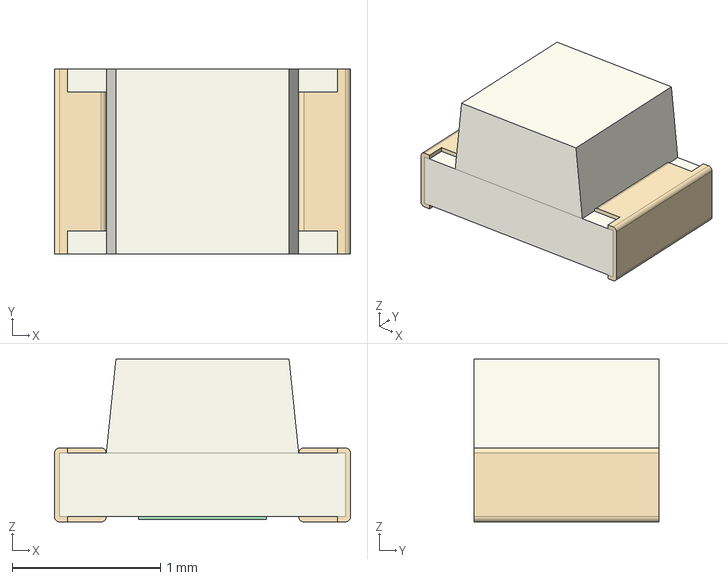
[picture p73: CAD file, 2022-11-09]
KiCad_Libraries/3D-Modals/LED_0805_2012Metric.step
2.00 x 1.25 x 1.10 mm
