theWickedWebDev/8-bit-computer/KiCad_Libraries/3D-Modals/trimpot-potentiometers-3d/Trimpot 3296W.step

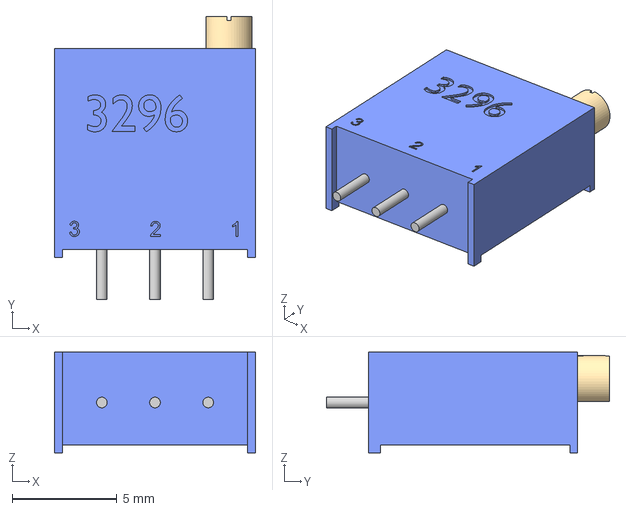
[picture p74: CAD file, 2022-04-04]
KiCad_Libraries/3D-Modals/trimpot-potentiometers-3d/Trimpot 3296W.step
9.60 x 13.5 x 4.82 mm
