theWickedWebDev/8-bit-computer/KiCad_Libraries/Footprints/PCIE-036-02-F-D-RA.stp

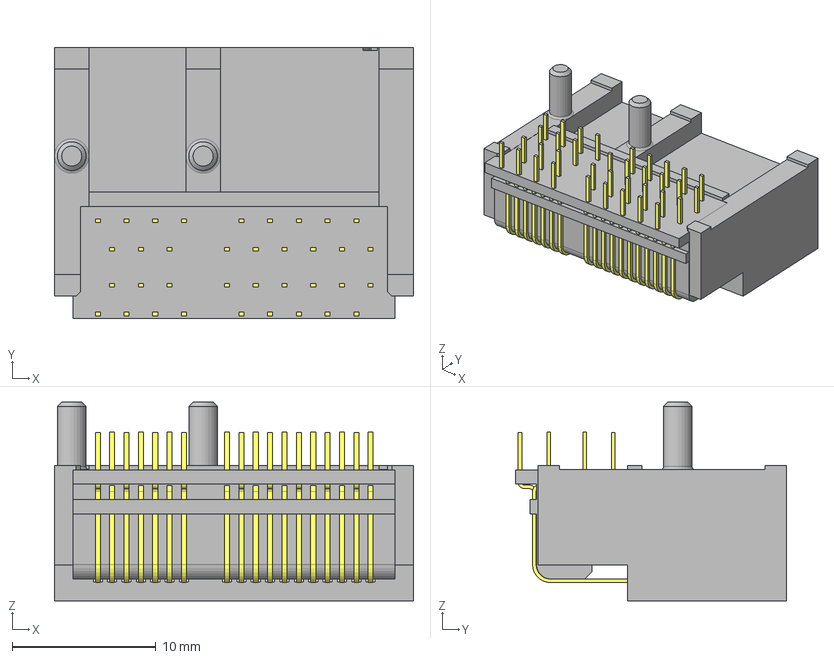
[picture p75: CAD file, 2022-06-18]
KiCad_Libraries/Footprints/PCIE-036-02-F-D-RA.stp
25.0 x 18.9 x 13.9 mm
_PCIE-036-02-F-D-RA_body
_PCIE-036-02-F-D-RA_pins1
_PCIE-036-02-F-D-RA_pins2
