theWickedWebDev/8-bit-computer/Modules/display-module/SMD/AT28C64B-15PU.step

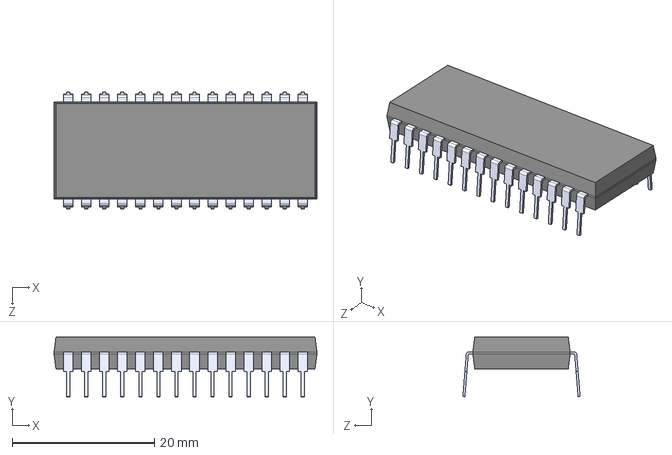
[picture p76: CAD file, 2021-04-21]
Modules/display-module/SMD/AT28C64B-15PU.step
37.0 x 8.38 x 16.5 mm
