theWickedWebDev/8-bit-computer/PCBs/999-QUEUED-TO-PRINT/Backplane-IO-Controller/cpu-input-output-control.step

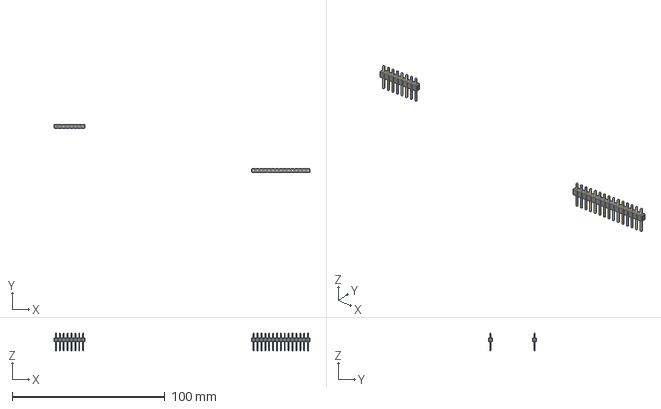
[picture p77: CAD file, 2022-04-04]
PCBs/999-QUEUED-TO-PRINT/Backplane-IO-Controller/cpu-input-output-control.step
167.4 x 31.5 x 11.5 mm
J5_PinHeader_1x15_P254mm_Vertical_3a906b7ae1da
J11_PinHeader_1x08_P254mm_Vertical_08b7b219e5ed
