theWickedWebDev/8-bit-computer/KiCad_Libraries/3D-Modals/Single_Pot.IGS

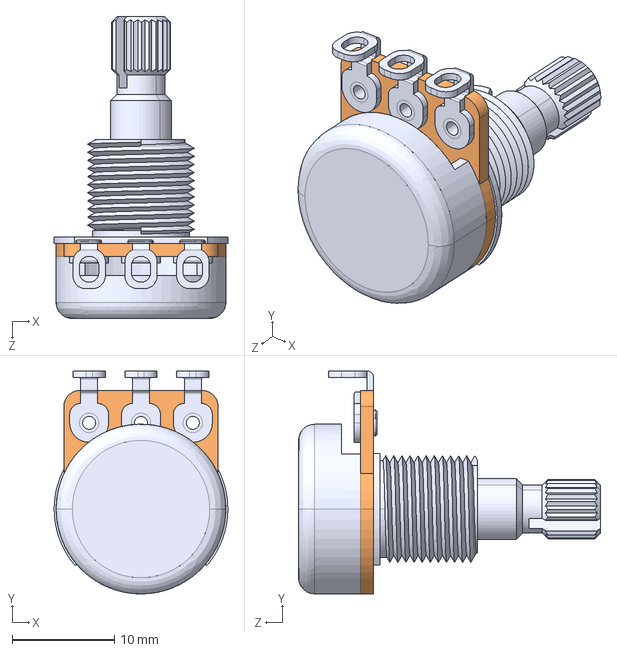
[picture p78: CAD file, 2022-11-09]
KiCad_Libraries/3D-Modals/Single_Pot.IGS
17.0 x 21.8 x 29.6 mm
