theWickedWebDev/8-bit-computer/KiCad_Libraries/3D-Modals/trimpot-potentiometers-3d/Trimpot Horiz 5mm.step

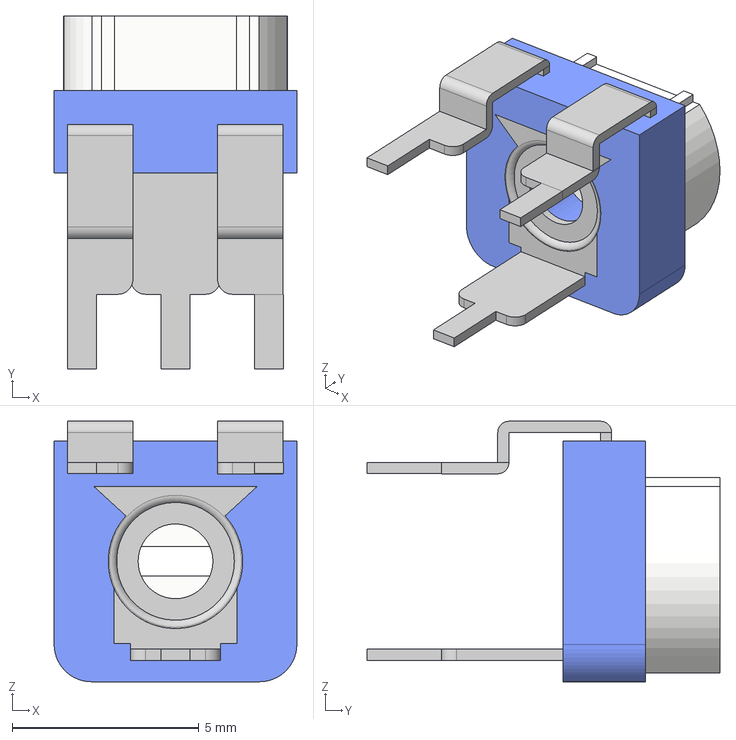
[picture p79: CAD file, 2022-04-04]
KiCad_Libraries/3D-Modals/trimpot-potentiometers-3d/Trimpot Horiz 5mm.step
6.50 x 9.45 x 6.97 mm
