theWickedWebDev/8-bit-computer/KiCad_Libraries/Footprints/PCIE-036-02-X-D-TH.step

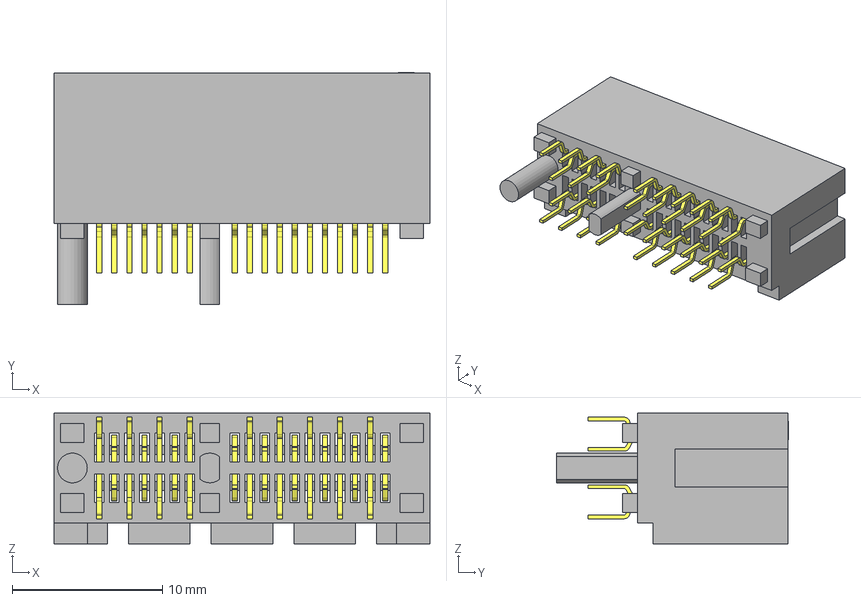
[picture p80: CAD file, 2022-06-18]
KiCad_Libraries/Footprints/PCIE-036-02-X-D-TH.step
25.0 x 15.4 x 8.70 mm
_PCIE-036-02-F-D-TH_body
_PCIE-036-02-F-D-TH_pins1
_PCIE-036-02-F-D-TH_pins2
