theWickedWebDev/8-bit-computer/Modules/display-module/SMD/LM555CM_NOPB.step

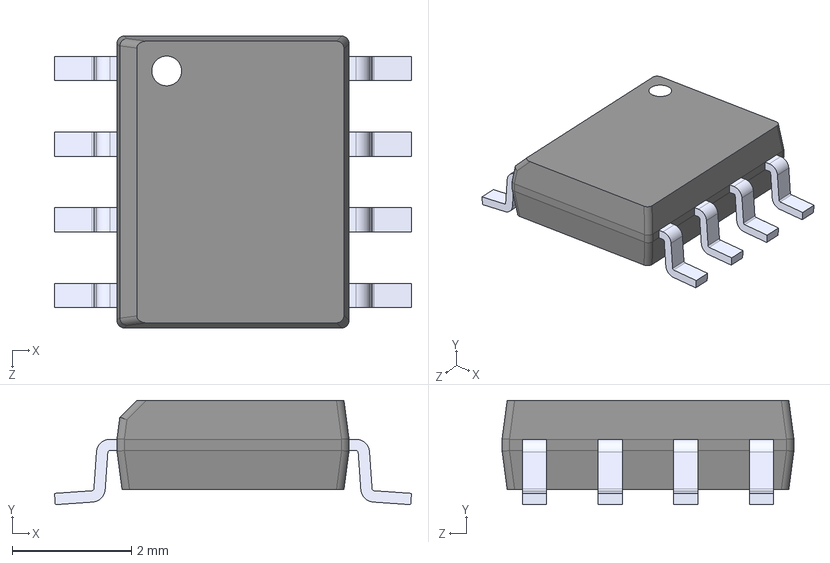
[picture p81: CAD file, 2021-04-21]
Modules/display-module/SMD/LM555CM_NOPB.step
5.99 x 1.75 x 4.90 mm
