theWickedWebDev/8-bit-computer/KiCad_Libraries/3D-Modals/trimpot-potentiometers-3d/Trimpot 3362P.step

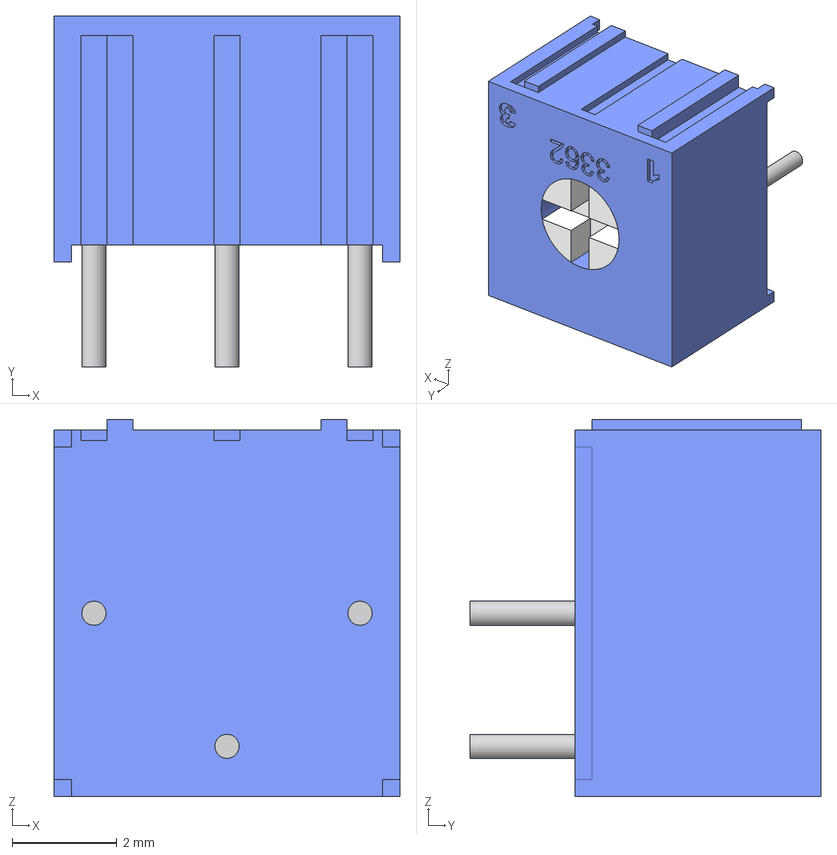
[picture p83: CAD file, 2022-04-04]
KiCad_Libraries/3D-Modals/trimpot-potentiometers-3d/Trimpot 3362P.step
6.60 x 6.70 x 7.20 mm
