theWickedWebDev/8-bit-computer/KiCad_Libraries/3D-Modals/breadboard-clock.STEP

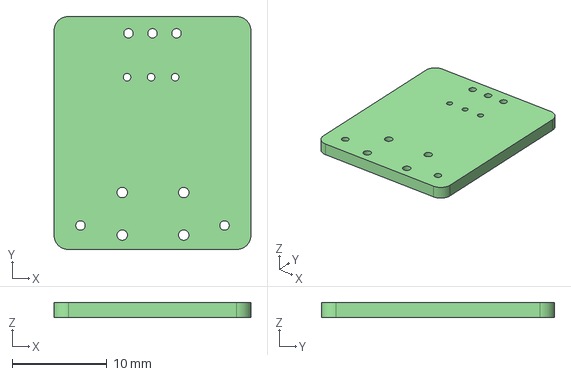
[picture p84: CAD file, 2022-11-09]
KiCad_Libraries/3D-Modals/breadboard-clock.STEP
20.8 x 24.6 x 1.60 mm
