theWickedWebDev/8-bit-computer/KiCad_Libraries/3D-Modals/trimpot-potentiometers-3d/Trimpot 3386H.step

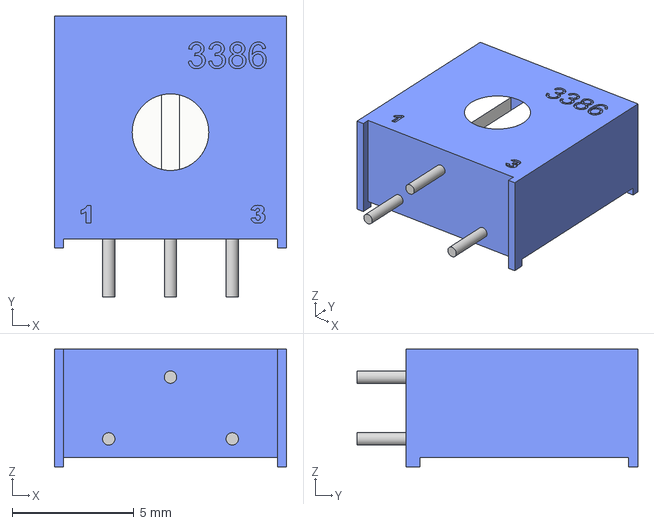
[picture p85: CAD file, 2022-04-04]
KiCad_Libraries/3D-Modals/trimpot-potentiometers-3d/Trimpot 3386H.step
9.54 x 11.5 x 4.84 mm
