theWickedWebDev/8-bit-computer/KiCad_Libraries/3D-Modals/trimpot-potentiometers-3d/Trimpot 3296X.step

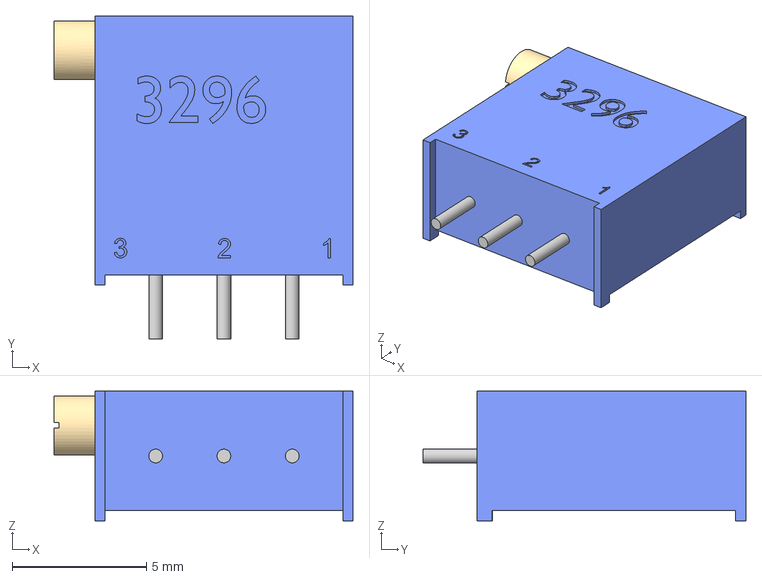
[picture p86: CAD file, 2022-04-04]
KiCad_Libraries/3D-Modals/trimpot-potentiometers-3d/Trimpot 3296X.step
11.1 x 12.0 x 4.82 mm
