theWickedWebDev/8-bit-computer/KiCad_Libraries/3D-Modals/trimpot-potentiometers-3d/Trimpot Vertical 5mm.step

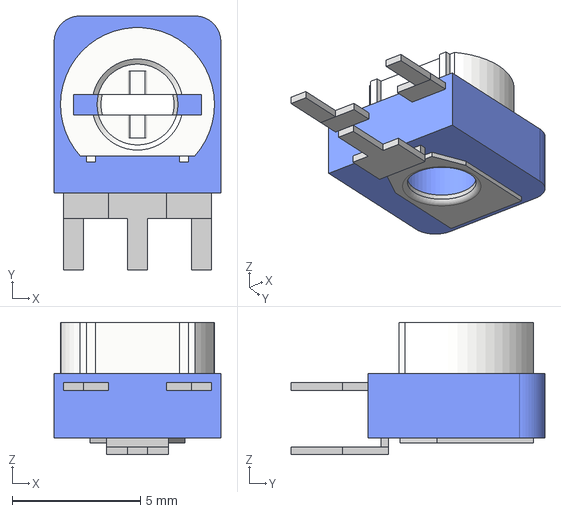
[picture p87: CAD file, 2022-04-04]
KiCad_Libraries/3D-Modals/trimpot-potentiometers-3d/Trimpot Vertical 5mm.step
6.50 x 9.90 x 5.15 mm
