theWickedWebDev/8-bit-computer/KiCad_Libraries/3D-Modals/push-button-spst-vertical-12mm.step

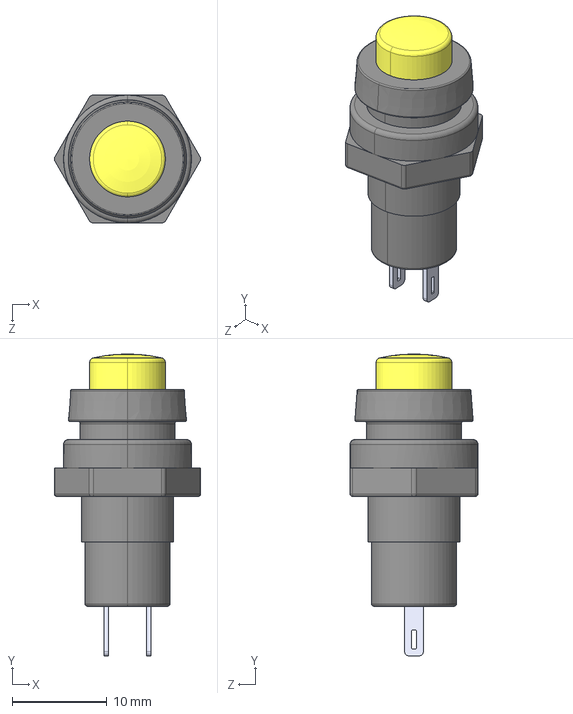
[picture p88: CAD file, 2022-11-09]
KiCad_Libraries/3D-Modals/push-button-spst-vertical-12mm.step
15.4 x 31.9 x 13.5 mm
