theWickedWebDev/8-bit-computer/KiCad_Libraries/3D-Modals/ACJM-MV35-2-audio-jack.step

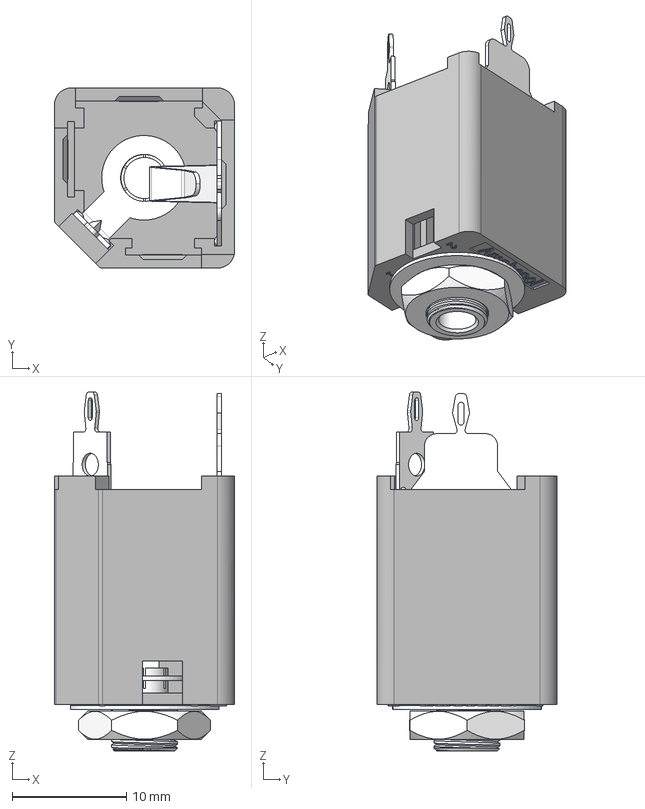
[picture p90: CAD file, 2022-11-09]
KiCad_Libraries/3D-Modals/ACJM-MV35-2-audio-jack.step
15.8 x 15.8 x 31.4 mm
