theWickedWebDev/8-bit-computer/KiCad_Libraries/3D-Modals/SOT23-IC-3-2222.step

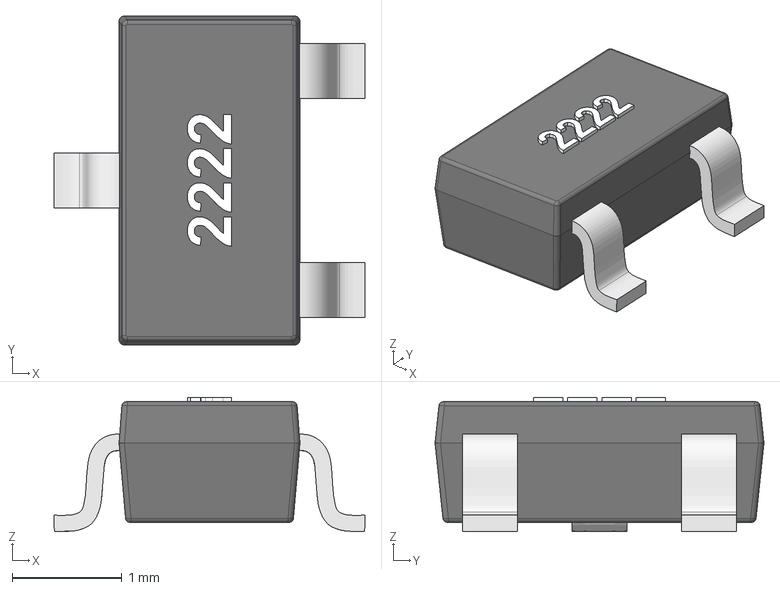
[picture p92: CAD file, 2022-11-09]
KiCad_Libraries/3D-Modals/SOT23-IC-3-2222.step
2.84 x 3.00 x 1.22 mm
