theWickedWebDev/8-bit-computer/KiCad_Libraries/3D-Modals/R_0805_2012Metric-4700.step

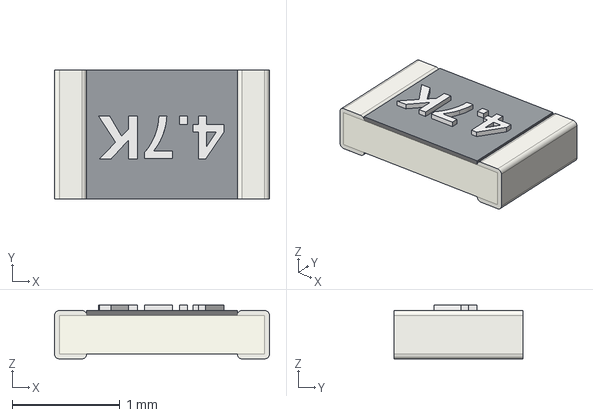
[picture p93: CAD file, 2022-11-09]
KiCad_Libraries/3D-Modals/R_0805_2012Metric-4700.step
2.00 x 1.20 x 0.5 mm
