theWickedWebDev/8-bit-computer/KiCad_Libraries/3D-Modals/200MSPxT2B1M2xE.step

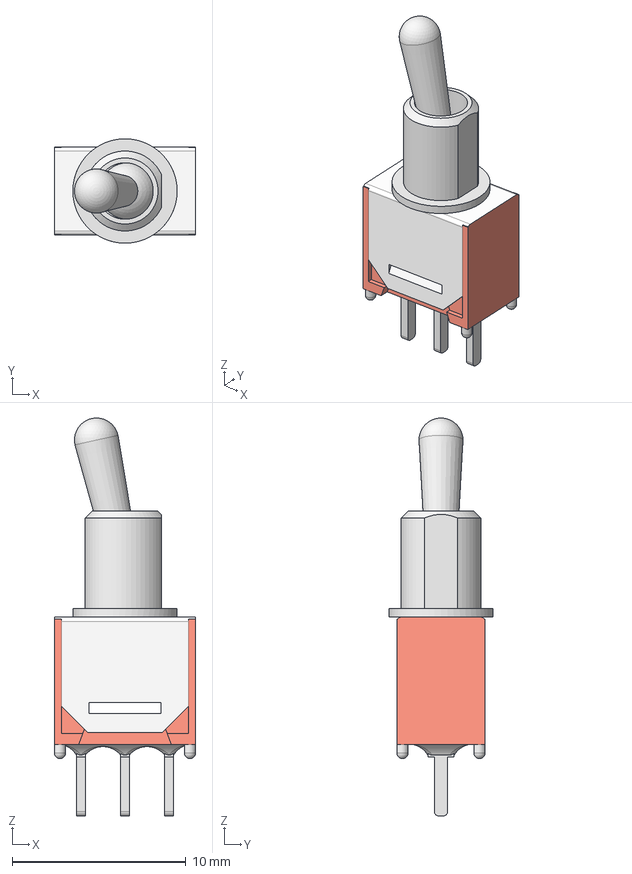
[picture p94: CAD file, 2022-11-09]
KiCad_Libraries/3D-Modals/200MSPxT2B1M2xE.step
8.13 x 6.00 x 22.9 mm
