theWickedWebDev/8-bit-computer/KiCad_Libraries/3D-Modals/80mm brushless fan (SUNON KD1208PTB1).step

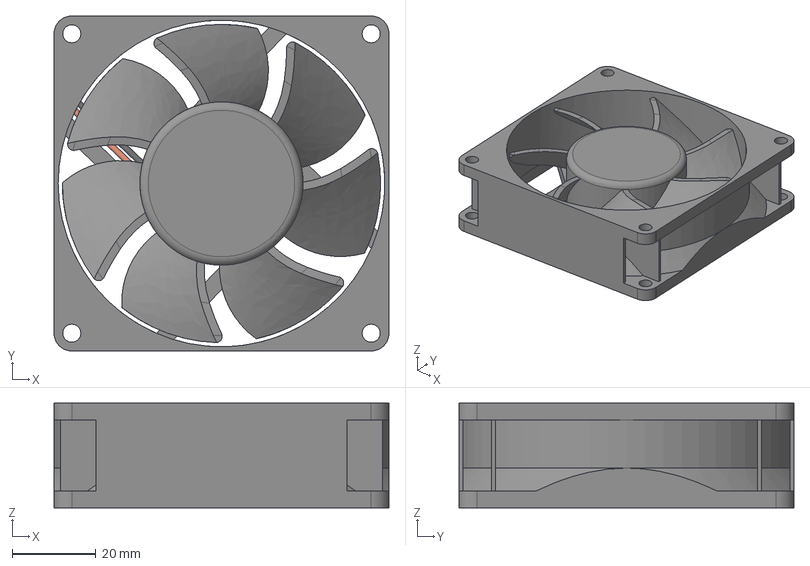
[picture p96: CAD file, 2022-11-09]
KiCad_Libraries/3D-Modals/80mm brushless fan (SUNON KD1208PTB1).step
80.0 x 80.0 x 25.0 mm
