theWickedWebDev/8-bit-computer/KiCad_Libraries/3D-Modals/40x40x10 DC Fan.STEP

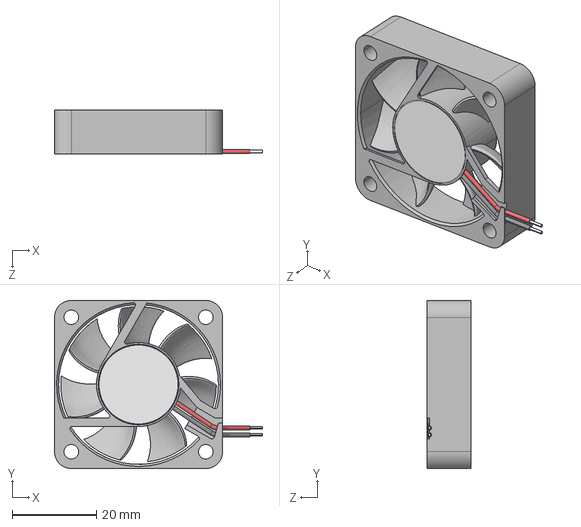
[picture p97: CAD file, 2022-11-09]
KiCad_Libraries/3D-Modals/40x40x10 DC Fan.STEP
49.5 x 40.0 x 10.5 mm
