theWickedWebDev/8-bit-computer/KiCad_Libraries/3D-Modals/DPDT.step

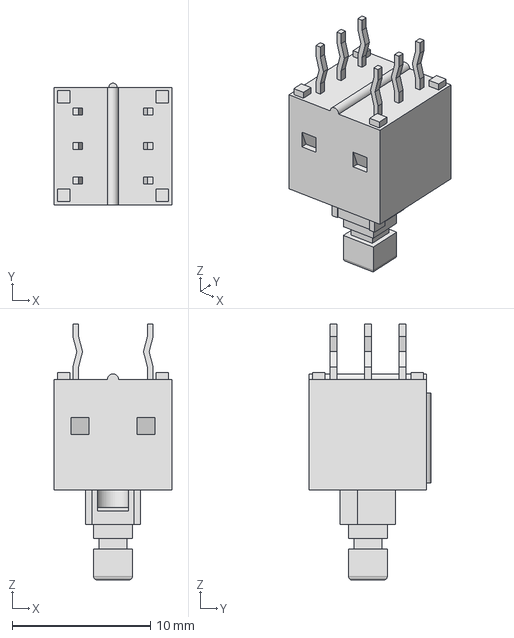
[picture p98: CAD file, 2022-08-27]
KiCad_Libraries/3D-Modals/DPDT.step
8.50 x 8.80 x 18.5 mm
