theWickedWebDev/8-bit-computer/KiCad_Libraries/3D-Modals/CAY16-102J4LF.step

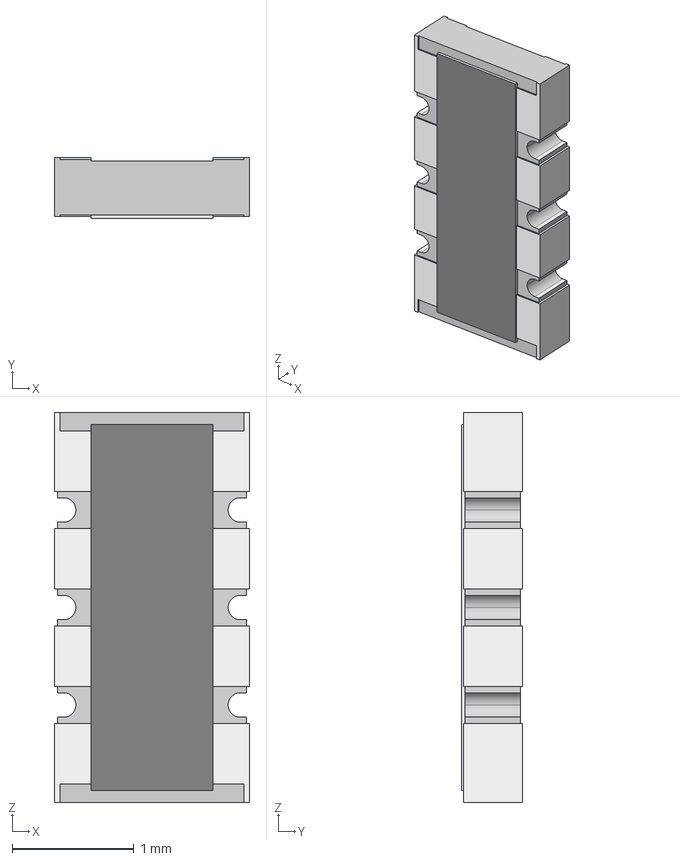
[picture p99: CAD file, 2022-08-27]
KiCad_Libraries/3D-Modals/CAY16-102J4LF.step
1.60 x 0.5 x 3.20 mm
