theWickedWebDev/8-bit-computer/KiCad_Libraries/3D-Modals/Potentiometer.step

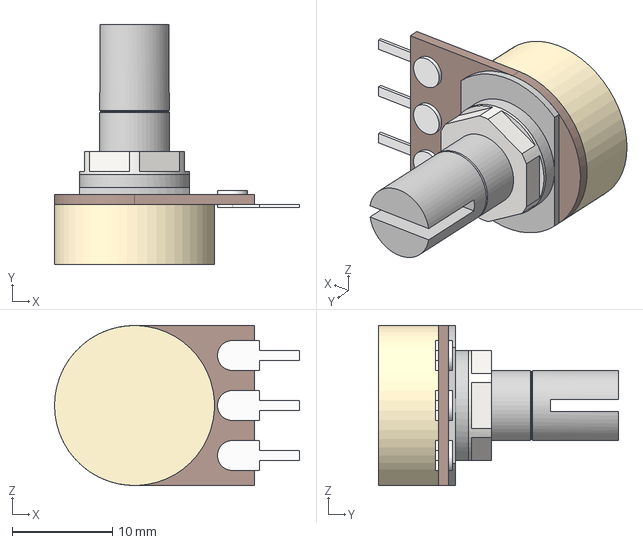
[picture p100: CAD file, 2022-08-27]
KiCad_Libraries/3D-Modals/Potentiometer.step
24.5 x 24.0 x 16.0 mm
Rotary top
Nut and washer
