theWickedWebDev/8-bit-computer/KiCad_Libraries/3D-Modals/Crystal-OSC_DIP-8.STEP

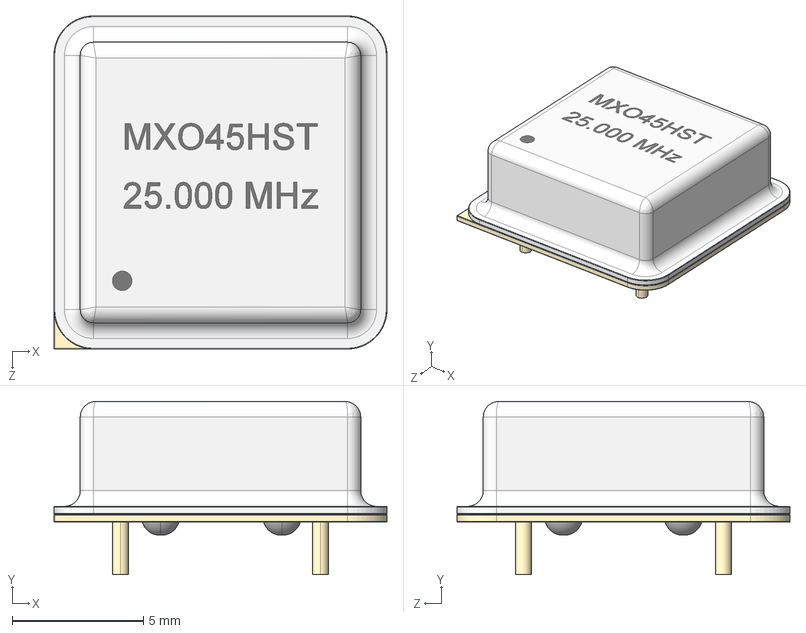
[picture p101: CAD file, 2022-08-27]
KiCad_Libraries/3D-Modals/Crystal-OSC_DIP-8.STEP
12.7 x 6.60 x 12.7 mm
