theWickedWebDev/8-bit-computer/KiCad_Libraries/3D-Modals/SOT23-IC-6.stp

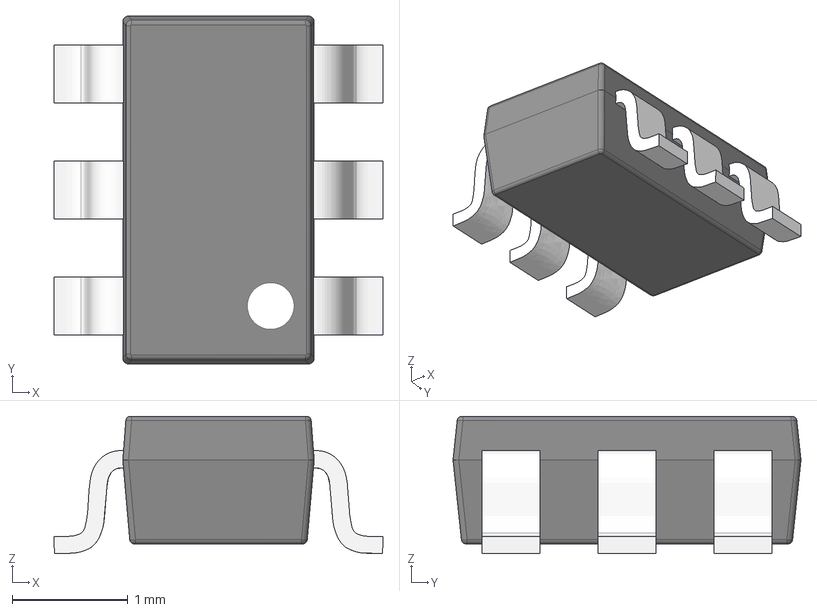
[picture p102: CAD file, 2022-04-04]
KiCad_Libraries/3D-Modals/SOT23-IC-6.stp
2.84 x 3.00 x 1.18 mm
