theWickedWebDev/8-bit-computer/KiCad_Libraries/3D-Modals/SOT23-IC-4.stp

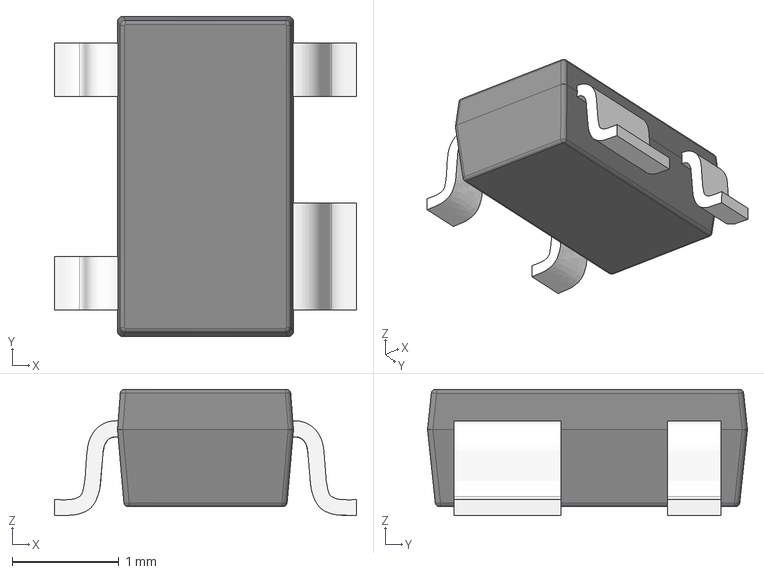
[picture p103: CAD file, 2022-04-04]
KiCad_Libraries/3D-Modals/SOT23-IC-4.stp
2.84 x 3.00 x 1.18 mm
