theWickedWebDev/8-bit-computer/KiCad_Libraries/3D-Modals/Micro_USB_connector.stp

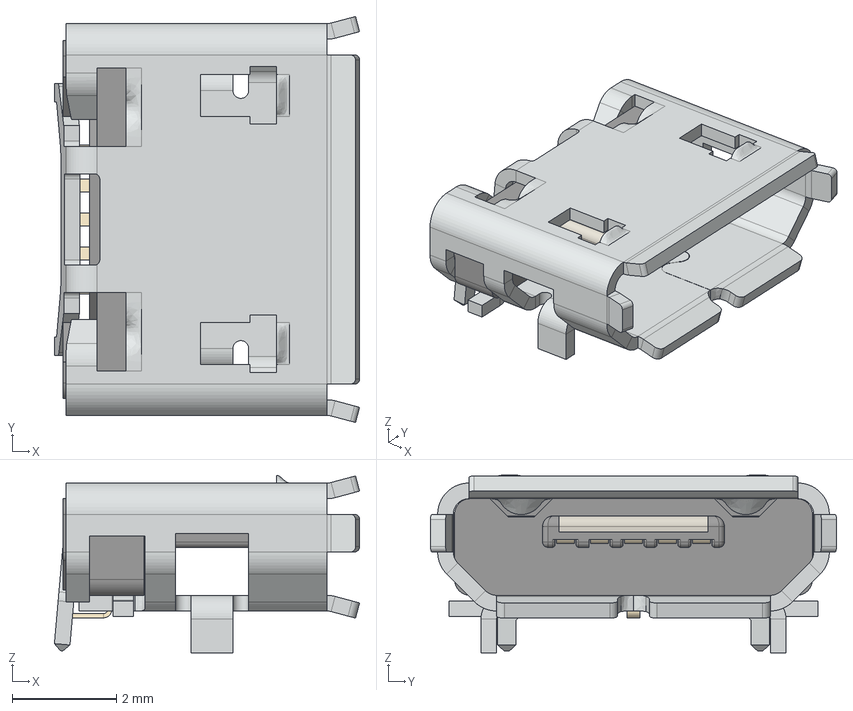
[picture p104: CAD file, 2022-04-04]
KiCad_Libraries/3D-Modals/Micro_USB_connector.stp
5.84 x 7.77 x 3.40 mm
shield
socket_housing
socket_plate
terminal x 5
