theWickedWebDev/8-bit-computer/KiCad_Libraries/3D-Modals/BananaConnector-2mm-blue.step

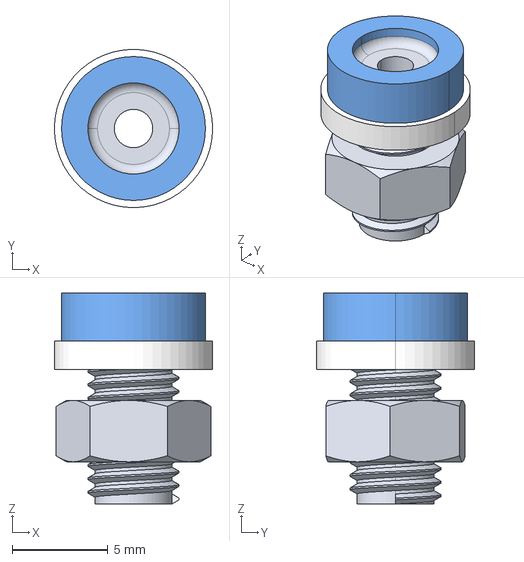
[picture p105: CAD file, 2022-04-04]
KiCad_Libraries/3D-Modals/BananaConnector-2mm-blue.step
8.25 x 8.25 x 11.0 mm
hex_nut_style_1_am_B18.2.4.1M_-_Hex_nut,_Style_1,__M4_x_0.7_--D-S
