theWickedWebDev/8-bit-computer/KiCad_Libraries/3D-Modals/SO10 IC Narrow 3.9mm.step

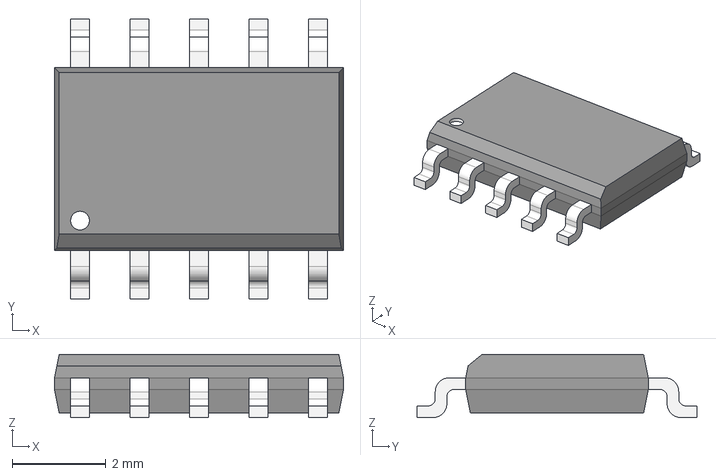
[picture p106: CAD file, 2022-02-28]
KiCad_Libraries/3D-Modals/SO10 IC Narrow 3.9mm.step
6.17 x 5.98 x 1.35 mm
