theWickedWebDev/8-bit-computer/KiCad_Libraries/3D-Modals/SO16 IC Narrow 3.9mm.step

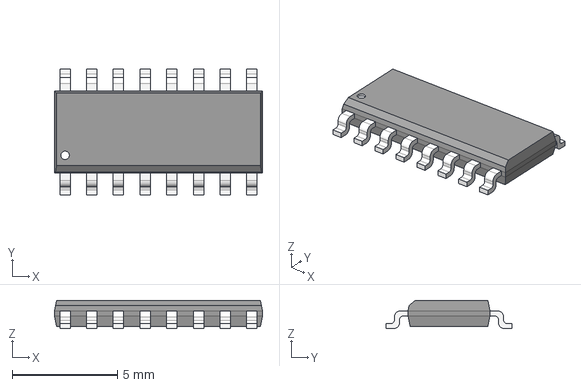
[picture p107: CAD file, 2022-02-28]
KiCad_Libraries/3D-Modals/SO16 IC Narrow 3.9mm.step
9.90 x 5.98 x 1.35 mm
