theWickedWebDev/8-bit-computer/KiCad_Libraries/3D-Modals/Audio-Jack-closed.step

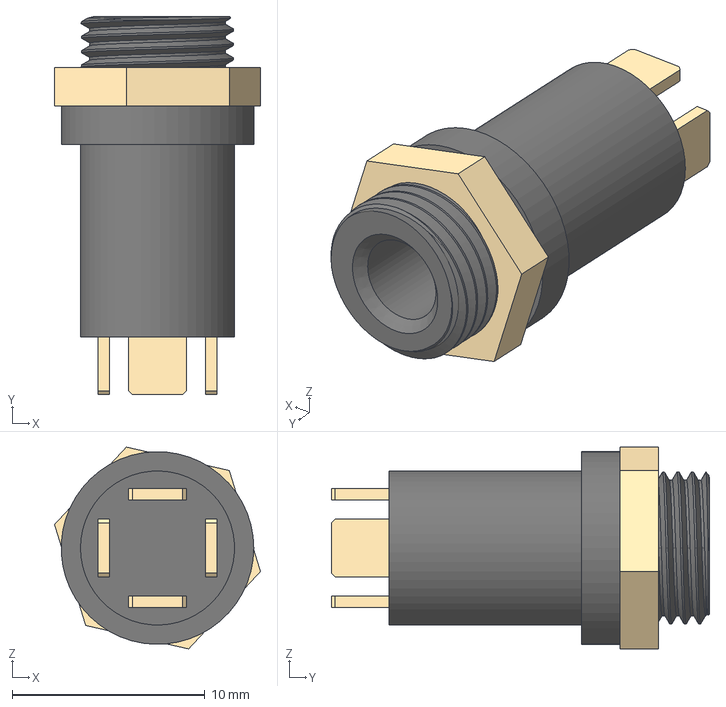
[picture p111: CAD file, 2022-02-28]
KiCad_Libraries/3D-Modals/Audio-Jack-closed.step
10.7 x 19.6 x 10.5 mm
