theWickedWebDev/8-bit-computer/KiCad_Libraries/3D-Modals/7-Segment-Display.step

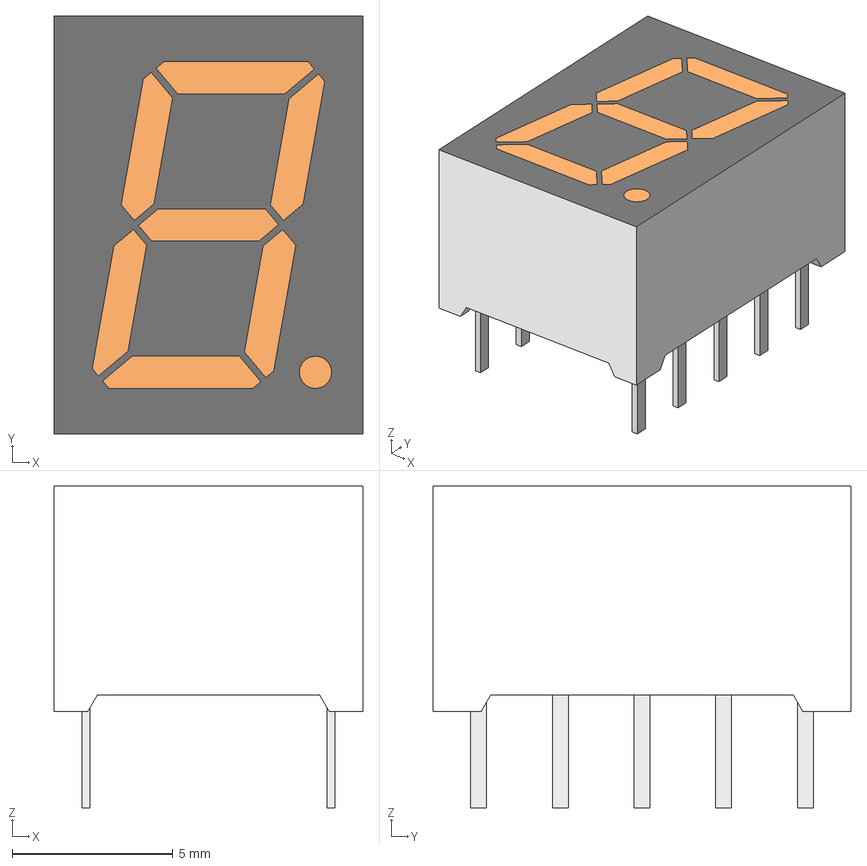
[picture p112: CAD file, 2022-02-28]
KiCad_Libraries/3D-Modals/7-Segment-Display.step
9.60 x 13.0 x 10.0 mm
