theWickedWebDev/8-bit-computer/KiCad_Libraries/3D-Modals/SPDT-SlideSwitch-THT.step

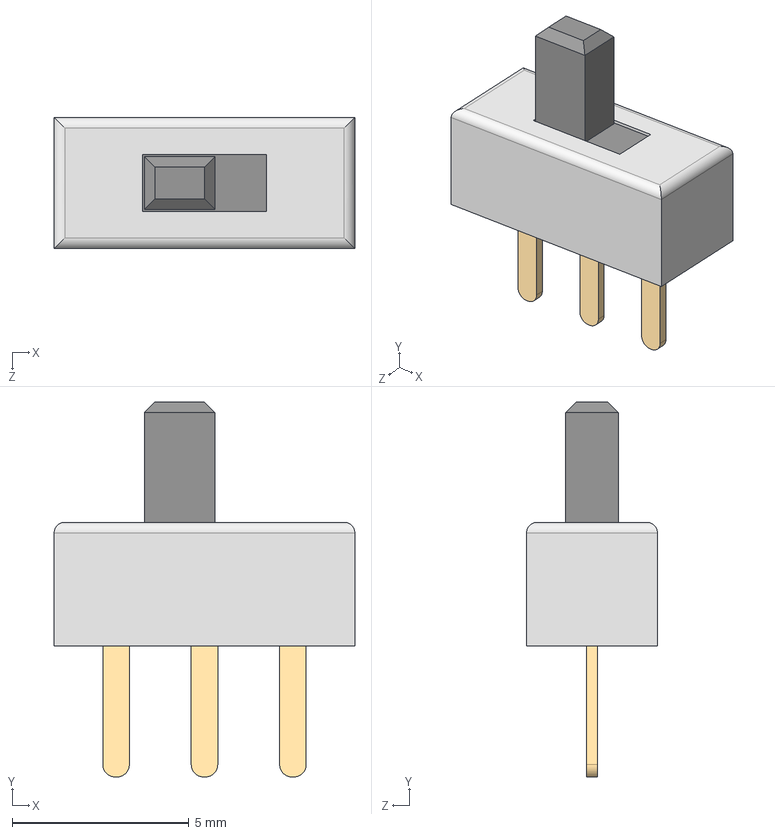
[picture p113: CAD file, 2022-02-28]
KiCad_Libraries/3D-Modals/SPDT-SlideSwitch-THT.step
8.50 x 10.6 x 3.70 mm
