theWickedWebDev/8-bit-computer/KiCad_Libraries/3D-Modals/Arduino-Nano.step

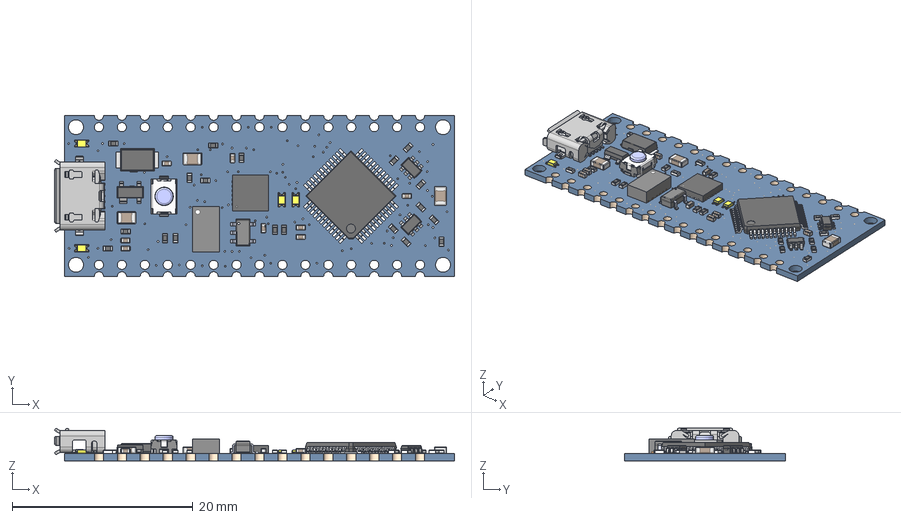
[picture p117: CAD file, 2022-02-28]
KiCad_Libraries/3D-Modals/Arduino-Nano.step
44.3 x 17.8 x 3.62 mm
Board
DNP x 19
22u x 3
PTS820
YELLOW x 4
MPM3610
AP2112K-3.3
ATSAMD11D14A
ATMEGA4809
ZX62-AB-5PA (1)
SOD128 Lead x 2
SOD128 Lower body x 2
SOD128 Upper body x 2
SOT143B lower body
SOT143B small Lead x 3
SOT143B Large lead
SOT143B Upper body
SOT353 Lower body x 2
SOT353 Lead x 12
SOT353 Upper body x 2
CAPC-0402-T0.55-BN v1 x 8
