theWickedWebDev/8-bit-computer/KiCad_Libraries/3D-Modals/PLCC32-SMD-IC.step

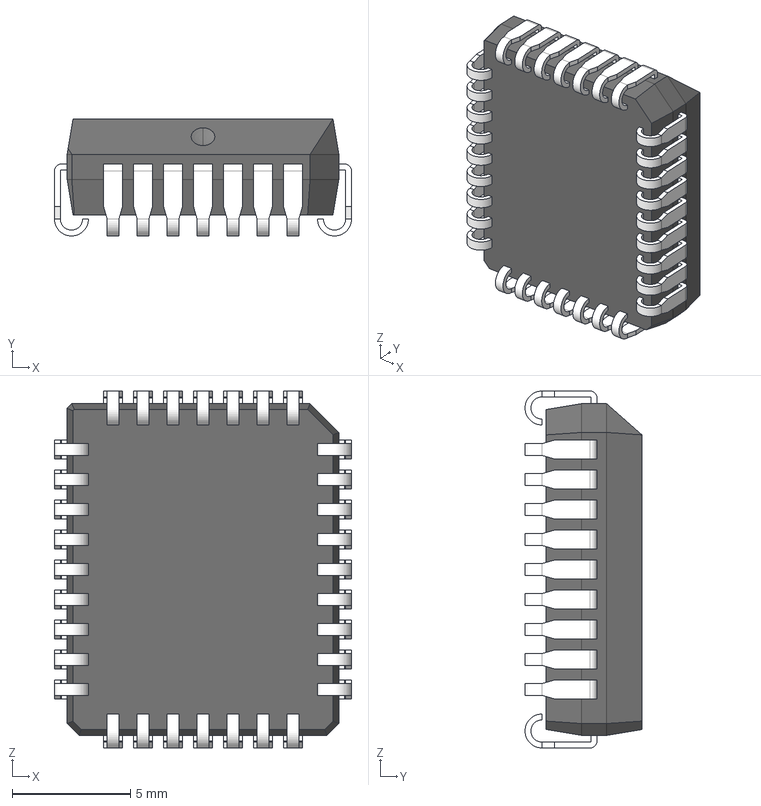
[picture p118: CAD file, 2022-02-28]
KiCad_Libraries/3D-Modals/PLCC32-SMD-IC.step
12.6 x 4.96 x 15.1 mm
