theWickedWebDev/8-bit-computer/KiCad_Libraries/3D-Modals/TrimPot_THT_Potentiometer_10kohm.step

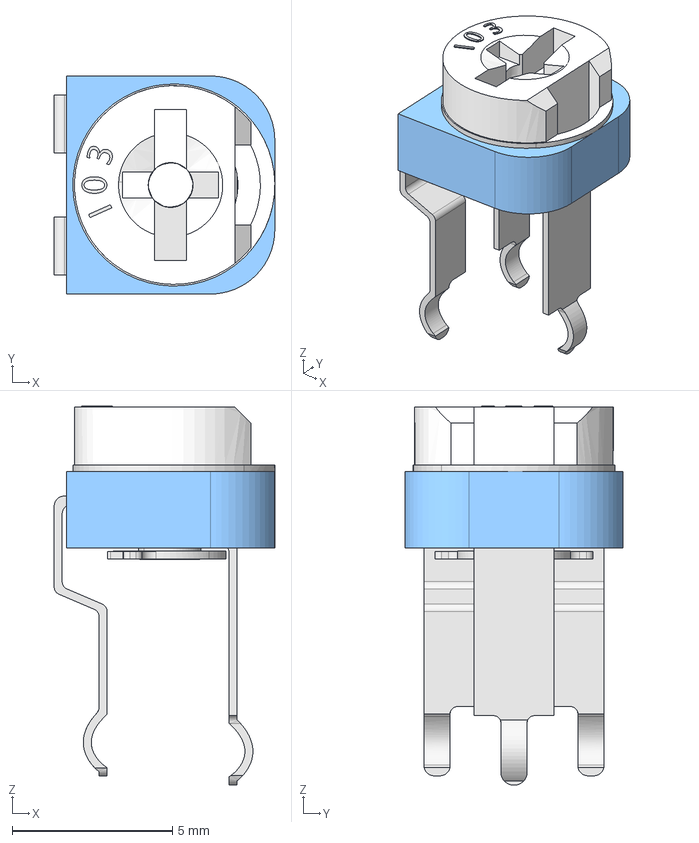
[picture p119: CAD file, 2022-02-28]
KiCad_Libraries/3D-Modals/TrimPot_THT_Potentiometer_10kohm.step
6.88 x 6.80 x 11.8 mm
