theWickedWebDev/8-bit-computer/KiCad_Libraries/3D-Modals/SO20 IC Wide 7.50mm.step

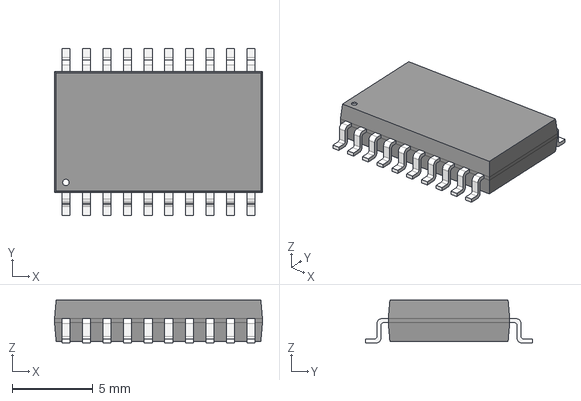
[picture p122: CAD file, 2022-02-28]
KiCad_Libraries/3D-Modals/SO20 IC Wide 7.50mm.step
12.8 x 10.3 x 2.65 mm
