theWickedWebDev/8-bit-computer/KiCad_Libraries/3D-Modals/PLCC32-SMD-Socket.step

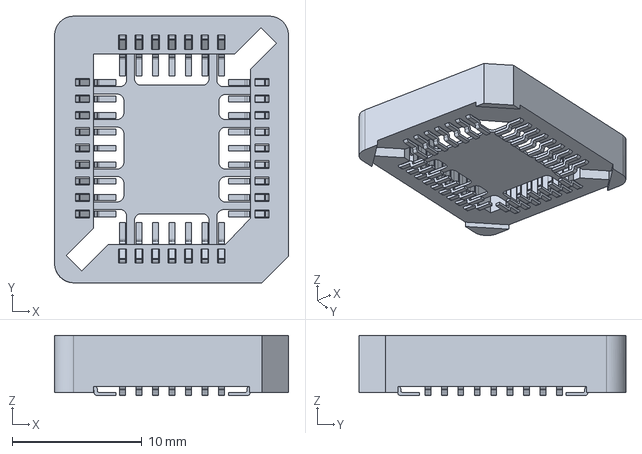
[picture p125: CAD file, 2022-02-28]
KiCad_Libraries/3D-Modals/PLCC32-SMD-Socket.step
18.0 x 20.5 x 4.65 mm
