theWickedWebDev/8-bit-computer/KiCad_Libraries/3D-Modals/Crystal_Resonator_SMD_3.2x2.5mm.step

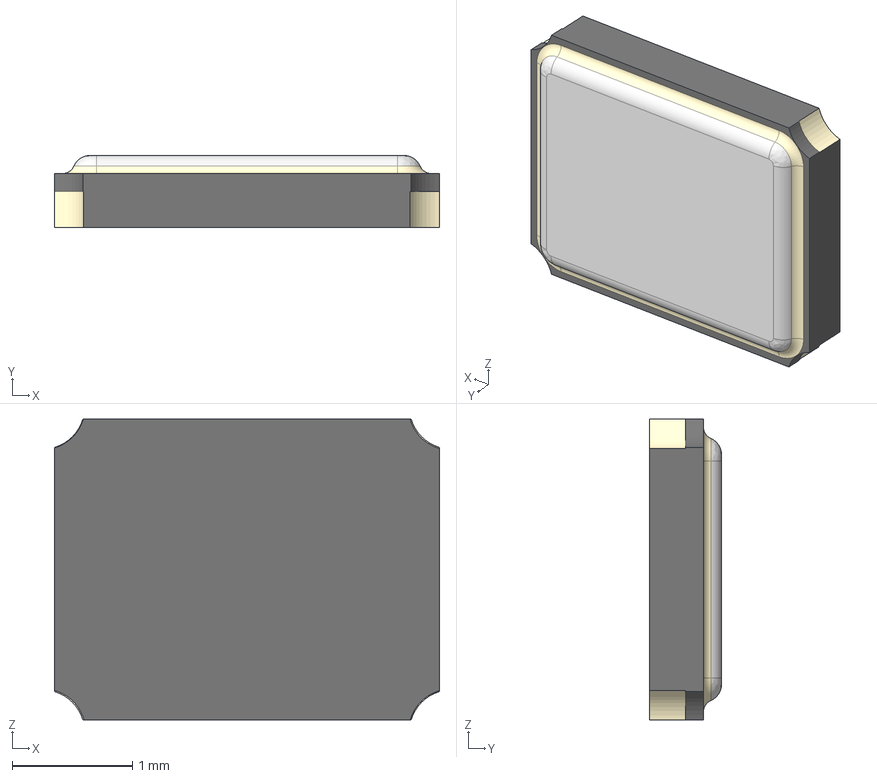
[picture p127: CAD file, 2022-02-28]
KiCad_Libraries/3D-Modals/Crystal_Resonator_SMD_3.2x2.5mm.step
3.20 x 0.6 x 2.50 mm
