theWickedWebDev/8-bit-computer/KiCad_Libraries/3D-Modals/DPDT-LatchingSwitch-THT.step

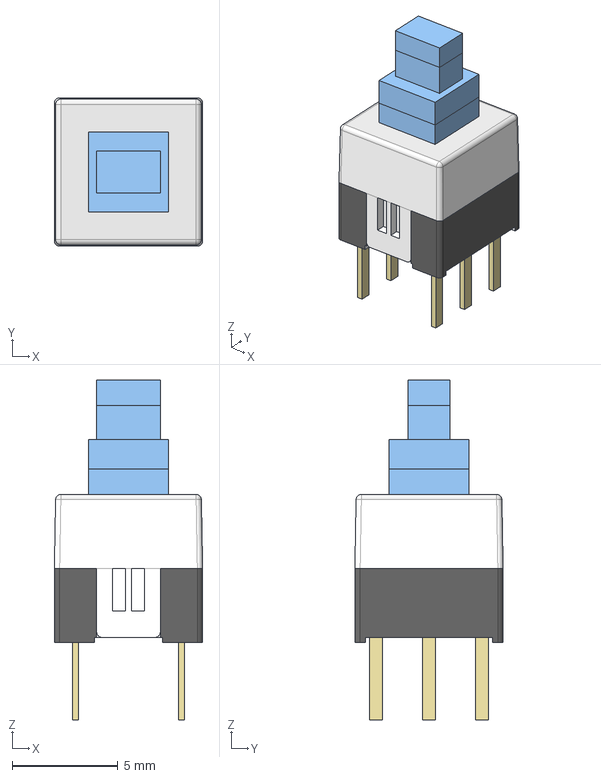
[picture p131: CAD file, 2022-02-28]
KiCad_Libraries/3D-Modals/DPDT-LatchingSwitch-THT.step
7.00 x 7.00 x 16.1 mm
