theWickedWebDev/8-bit-computer/KiCad_Libraries/3D-Modals/SO18 IC Medium 5.28mm.step

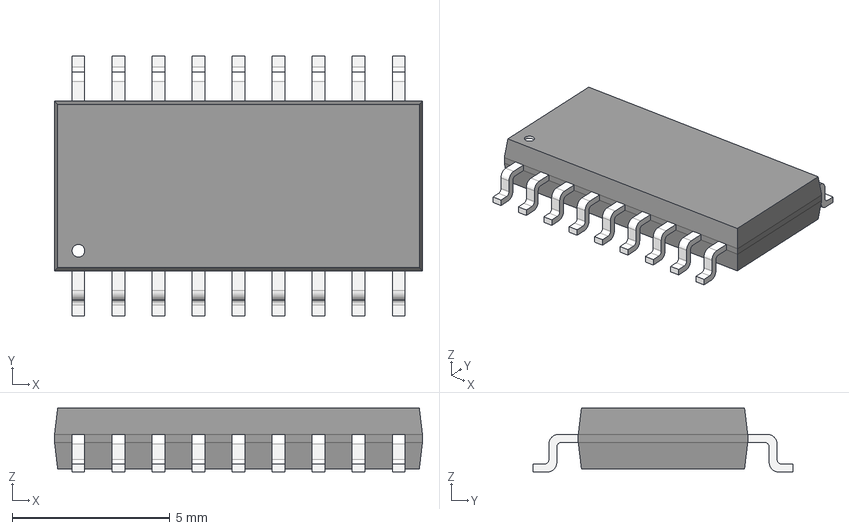
[picture p133: CAD file, 2022-02-28]
KiCad_Libraries/3D-Modals/SO18 IC Medium 5.28mm.step
11.7 x 8.26 x 2.03 mm
