theWickedWebDev/8-bit-computer/KiCad_Libraries/3D-Modals/SO14 IC Medium 5.28mm.step

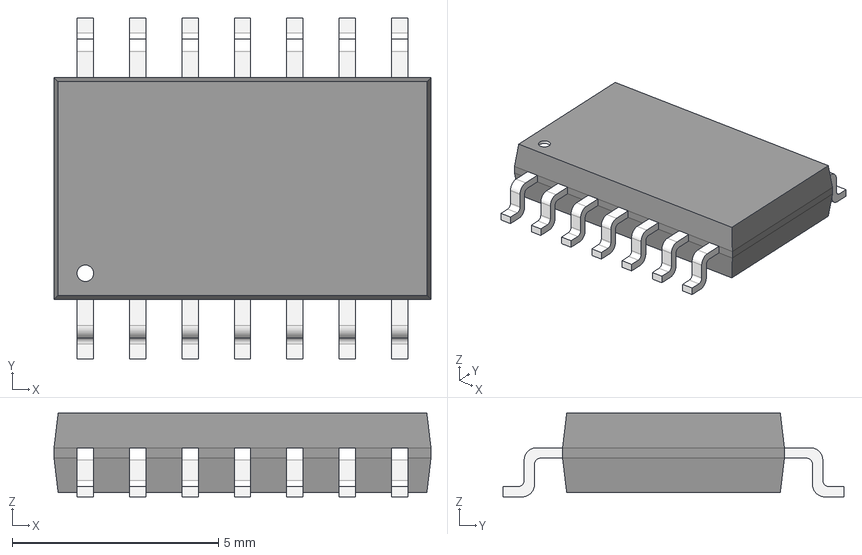
[picture p138: CAD file, 2022-02-28]
KiCad_Libraries/3D-Modals/SO14 IC Medium 5.28mm.step
9.14 x 8.26 x 2.03 mm
