theWickedWebDev/8-bit-computer/KiCad_Libraries/3D-Modals/SPDT-SideMount-Switch.step

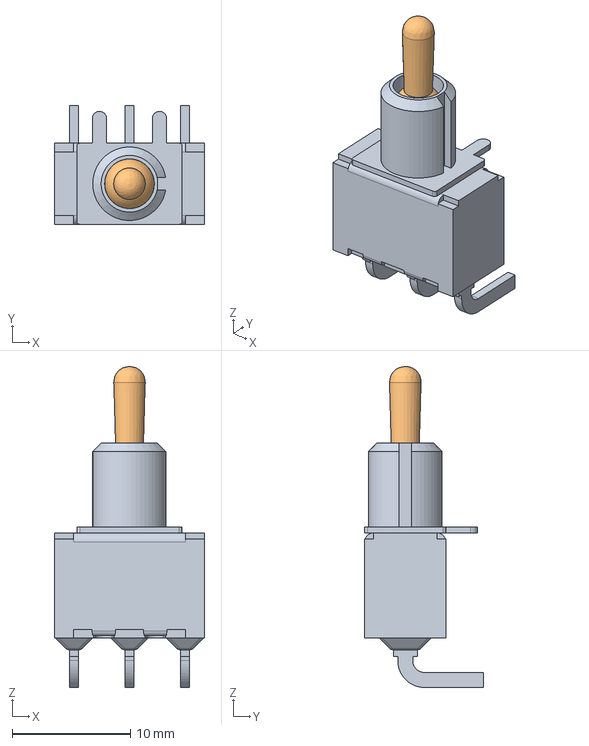
[picture p140: CAD file, 2022-02-28]
KiCad_Libraries/3D-Modals/SPDT-SideMount-Switch.step
12.7 x 10.0 x 27.2 mm
