theWickedWebDev/8-bit-computer/KiCad_Libraries/3D-Modals/SO14 IC Wide 7.50mm.step

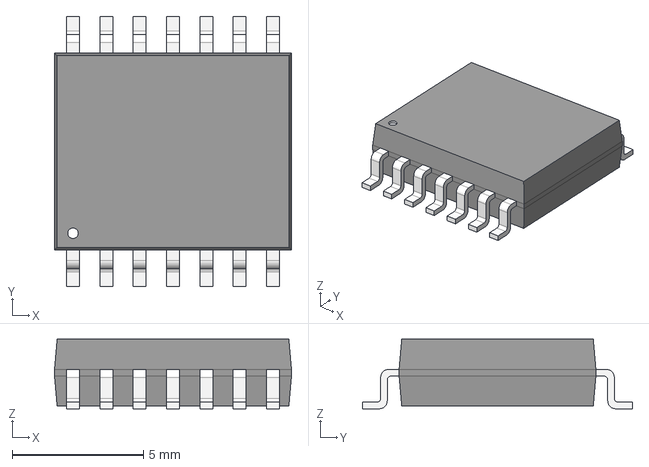
[picture p143: CAD file, 2022-02-28]
KiCad_Libraries/3D-Modals/SO14 IC Wide 7.50mm.step
9.03 x 10.3 x 2.65 mm
