theWickedWebDev/8-bit-computer/KiCad_Libraries/3D-Modals/SO14 IC Narrow  3.9mm.step

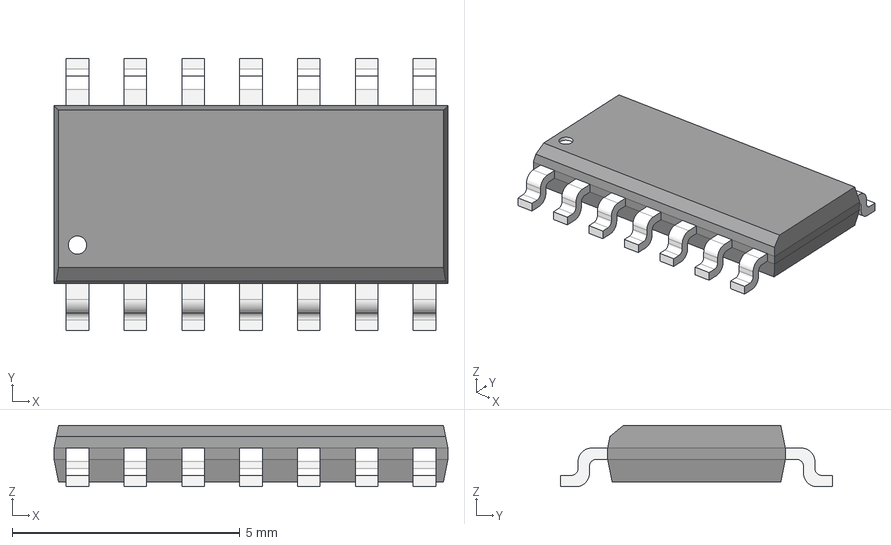
[picture p145: CAD file, 2022-02-28]
KiCad_Libraries/3D-Modals/SO14 IC Narrow 3.9mm.step
8.65 x 5.98 x 1.35 mm
