theWickedWebDev/8-bit-computer/(list of files, cad)

Other CAD files:
KiCad_Libraries/3D-Modals/LED_0805_2012Metric-Red.step
KiCad_Libraries/3D-Modals/R_0805_2012Metric-blue.step
KiCad_Libraries/3D-Modals/LED_0805_2012Metric-Blue.step
KiCad_Libraries/3D-Modals/PCIE-036-02-X-D-RA.step
KiCad_Libraries/3D-Modals/SOT23-IC-5.stp
KiCad_Libraries/3D-Modals/BananaConnector-2mm-black.step
KiCad_Libraries/3D-Modals/SOT23-IC-3.stp
KiCad_Libraries/3D-Modals/BananaConnector-2mm-yellow.step
KiCad_Libraries/3D-Modals/BananaConnector-2mm-green.step
KiCad_Libraries/3D-Modals/LED_0805-Blue.step
KiCad_Libraries/3D-Modals/LED_0805-Yellow.step
KiCad_Libraries/3D-Modals/LED_0805-Red.step
KiCad_Libraries/3D-Modals/PCIE-036-CardSocket.step
KiCad_Libraries/3D-Modals/ScrewTerminal-2.54-2x1.STEP
KiCad_Libraries/3D-Modals/ScrewTerminal-2.54-3x1.STEP
KiCad_Libraries/3D-Modals/ScrewTerminal-2.54-4x1.STEP
KiCad_Libraries/3D-Modals/ScrewTerminal-2.54-5x1.STEP
KiCad_Libraries/3D-Modals/ScrewTerminal-2.54-6x1.STEP
KiCad_Libraries/3D-Modals/ScrewTerminal-2.54-7x1.STEP
KiCad_Libraries/3D-Modals/ScrewTerminal-2.54-8x1.STEP
