theWickedWebDev/8-bit-computer/User Manual/CPU - Instruction Cycle & Decode.pdf

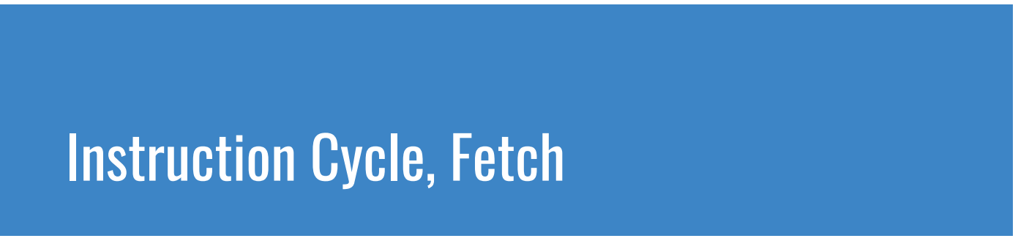
[picture p146: figure]
Instruction Cycle, Fetch

This module consists of a few parts: an 8-bit register, a 5-bit binary counter, and logic gates for multiplexing the input source. Together, their values combine to form the microcode address.

Inputs to this module include the 8-bit memory bus, the interrupt request flag, and a reset line.

A momentary push-button is built into the board as another source for a CPU reset. Connected to this button is also a resistor-capacitor circuit that will fire off a reset signal once on power up.

- Instruction Register
- Step Counter
- Opcode Multiplexer
- Hardwired Reset Vector
- Hardwired IRQ Addresses

Power: 5V Vc

## Block Diagram

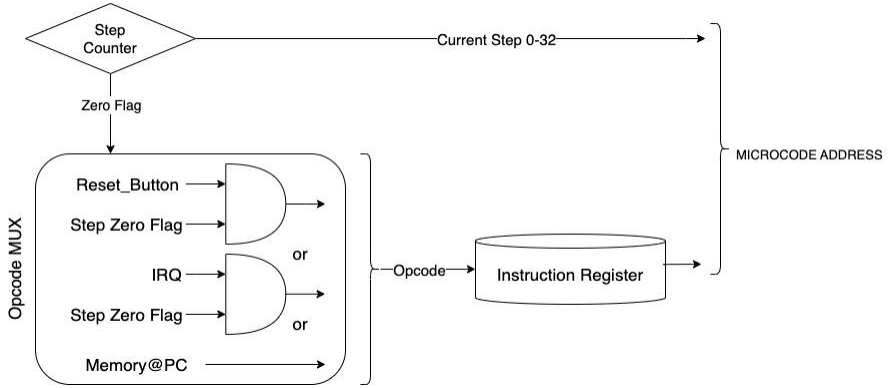
[picture p147: figure]

## Instruction Register

## Current Instruction Register

This is an 8-bit register that stores the current instruction from the data bus (typically from memory).

The input of the instruction register has three potential values: a hardwired reset vector, an interrupt request vector, or an instruction opcode.

The reset or interrupt request addresses will only be latched when there is an active interrupt or the reset line was pulled low, as well as the step zero flag (SZF) is active. Otherwise, the instruction register will load its value from the data bus (memory).

## Step Counter

The step counter makes up the lower 5-bits of the microcode address. This gives every instruction the ability to use up to 32 steps to complete its cycle. Most instructions though however have much fewer steps needed. To avoid wasted clocks or NOPs, each instruction’s microcode should include setting the reset step counter control line.

## Schematics

## Parts & Components List

Part # | Description | Qty | Datasheet | Link
74HC173 | 8-Bit, Edge-Triggered, flip-flops | 2 | DATA (https://www.ti.com/lit/ds/symlink/sn74hc574.pdf?ts=1601064653348) | Mouser (https://www.mouser.com/ProductDetail/Texas-Instruments/CD74HC173PWR?qs=JD1fk4stihbsXf8KpXAZKQ%3D%3D)
74HC245 | 8-bit, Tri-State Transceiver | 2 | DATA (https://www.mouser.com/datasheet/2/916/74HC_HCT245-2937284.pdf) | Mouser (https://www.mouser.com/ProductDetail/Nexperia/74HC245PW118?qs=P62ublwmbi81WTOw8gvz3Q%3D%3D)
74HC161 | 4-bit, Binary Counter | 2 | DATA (https://www.mouser.com/datasheet/2/916/74HC_HCT245-2937284.pdf) | Mouser (https://www.mouser.com/ProductDetail/onsemi/MC74HC161ADR2G?qs=qg33o%252B8vzFrcIrwTS4%252BcKg%3D%3D)
74HC08 | Quad, 2-input AND gates | 11 | DATA (https://www.mouser.com/datasheet/2/916/74HC_HCT08-1319727.pdf) | Mouser (https://www.mouser.com/ProductDetail/Nexperia/74HC08PW112?qs=P62ublwmbi%2FaHQgW0FNuHA%3D%3D)
74HC32 | Quad, 2-input OR gates | 7 | DATA (https://www.mouser.com/datasheet/2/308/1/MM74HC32_D-2316008.pdf) | Mouser (https://www.mouser.com/ProductDetail/onsemi-Fairchild/MM74HC32MTCX?qs=DgZPx0AY41loLcyz75OErQ%3D%3D)
74HC04 | 6, 1-input, NOT (invert) gates | 5 | DATA (http://www.ti.com/general/docs/suppproductinfo.tsp?distId=26) | Mouser (https://www.mouser.com/ProductDetail/Texas-Instruments/SN74HC04APWR?qs=BmtUOLWBNQoO8JpLxW%2FqrQ%3D%3D)
CD4072 | Dual, 4-input OR gates | 2 | DATA (https://www.ti.com/general/docs/suppproductinfo.tsp?distId=26&gotoUrl=https://www.ti.com/lit/gpn/cd4072b) | Mouser (https://www.mouser.com/ProductDetail/Texas-Instruments/CD4072BM96G4?qs=R%252BdApFK7ZT19TPADnM3Mjw%3D%3D)
- | Momentary Push Button | 1 | - | -
- | Pull Up Resistor | 1 | - | -
- | Capacitor (for switch) | 1 | - | -
- | Decoupling Capacitors | 4 | - | -
- | LEDs / Resistors | 13 | - | -
