theWickedWebDev/8-bit-computer/DOCUMENTATION/Block Diagrams/Instruction-Decoder-Microcode.drawio.pdf

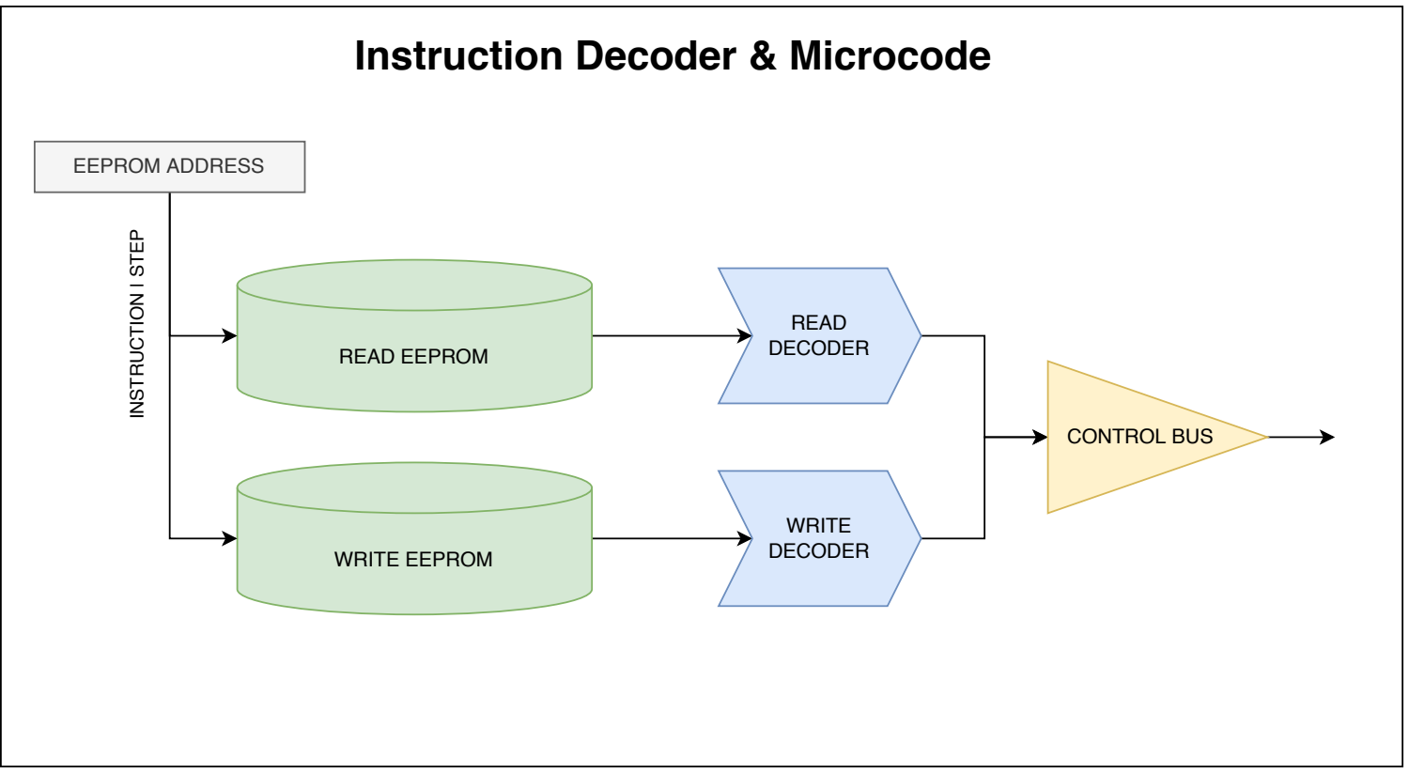
[picture p162: figure]
READ EEPROM; WRITE EEPROM; EEPROM ADDRESS INSTRUCTION | STEP; READ DECODER; WRITE DECODER; CONTROL BUS; Instruction Decoder & Microcode
