theWickedWebDev/8-bit-computer/User Manual/GPR - General Purpose Registers.pdf

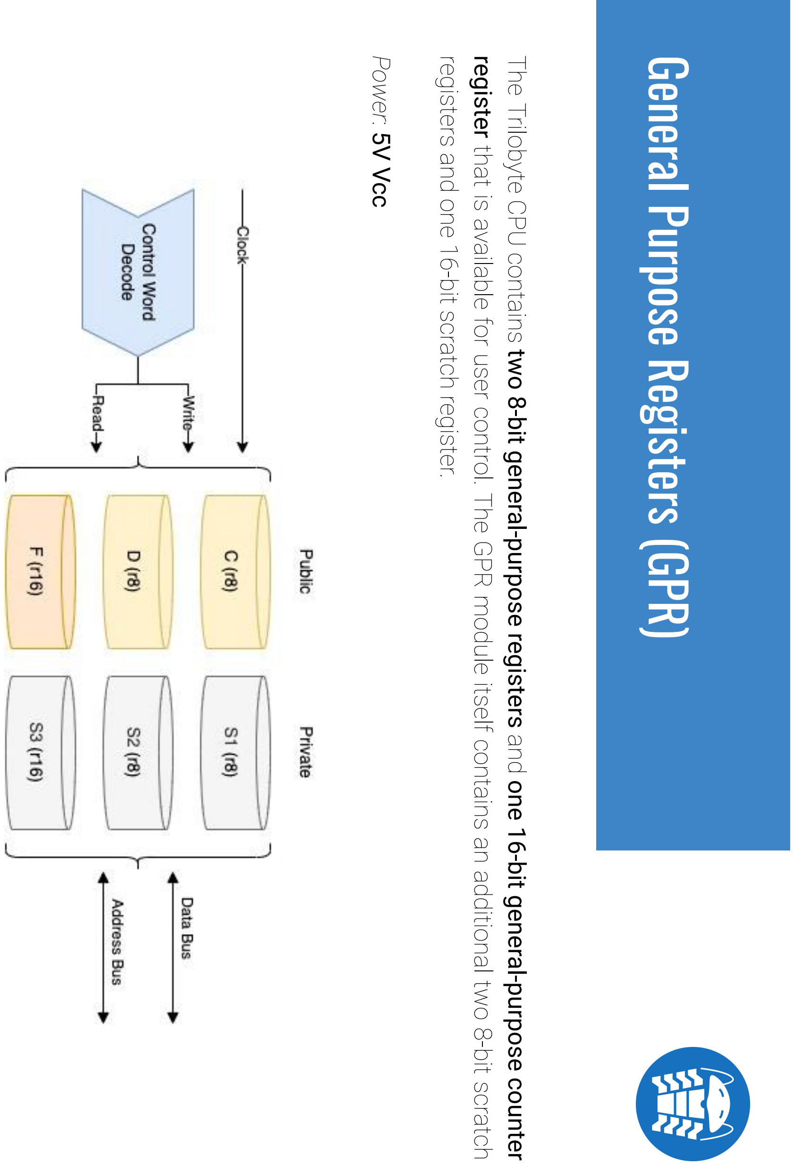
[picture p164: page 1]

# General Purpose Registers (GPR)

The Trilobyte CPU contains two 8-bit general-purpose registers and one 16-bit general-purpose counter

register that is available for user control. The GPR module itself contains an additional two 8-bit scratch

registers and one 16-bit scratch register.

# Power: 5V Vcc

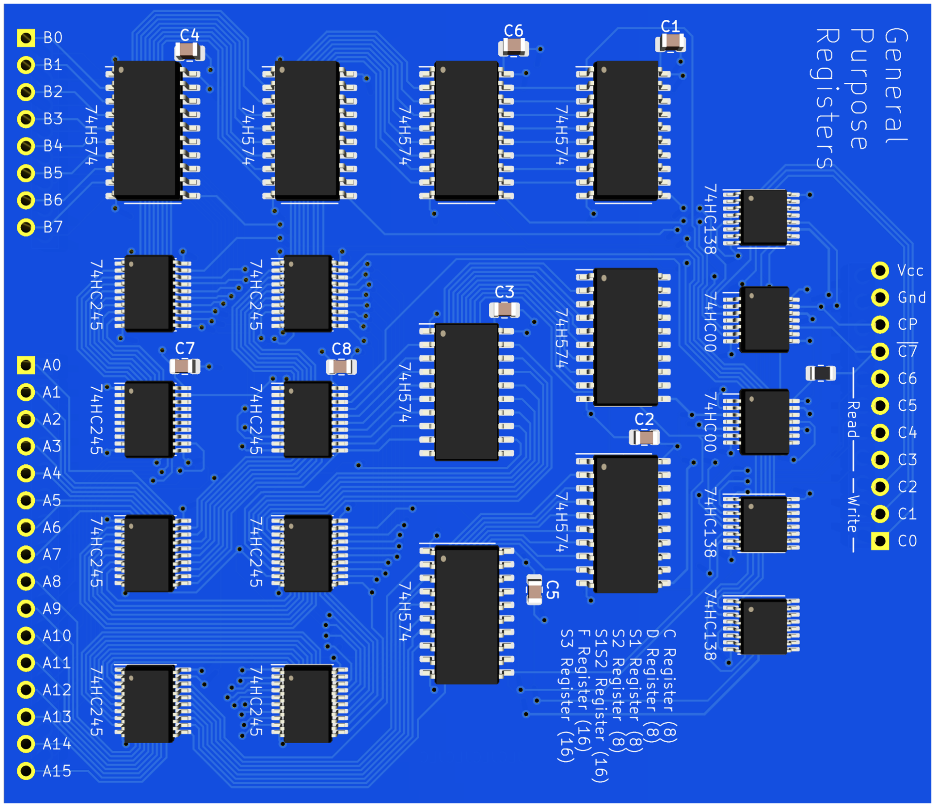
[picture p165: figure]

# Register

# Name Size Visibility Mnemonic

# C 8-bit PUBLIC r, r8

# D 8-bit PUBLIC r, r8 F 16-bit PUBLIC r, r16

# S1 8-bit PRIVATE r, r8

# S2 8-bit PRIVATE r, r8

# S3 16-bit PRIVATE r, r16

# Bus Connections

# - C, D: Loads and asserts data from/to the 8-bit data bus

# - F: Loads and asserts data from/to the 16-bit data bus

- S1: Loads and asserts data from/to the 8-bit data bus, as well as, asserts its data to the LSB of the 16-bit address bus.
- S2: Loads and asserts data from/to the 8-bit data bus, as well as, asserts its data to the MSB of the 16-bit address bus.
- S3: Loads and asserts data from/to the 16-bit data bus, as well as, asserts its MSB, or LSB to the 8-bit data bus.

# - S1S2: Asserts register-pair to the 16-bit data bus

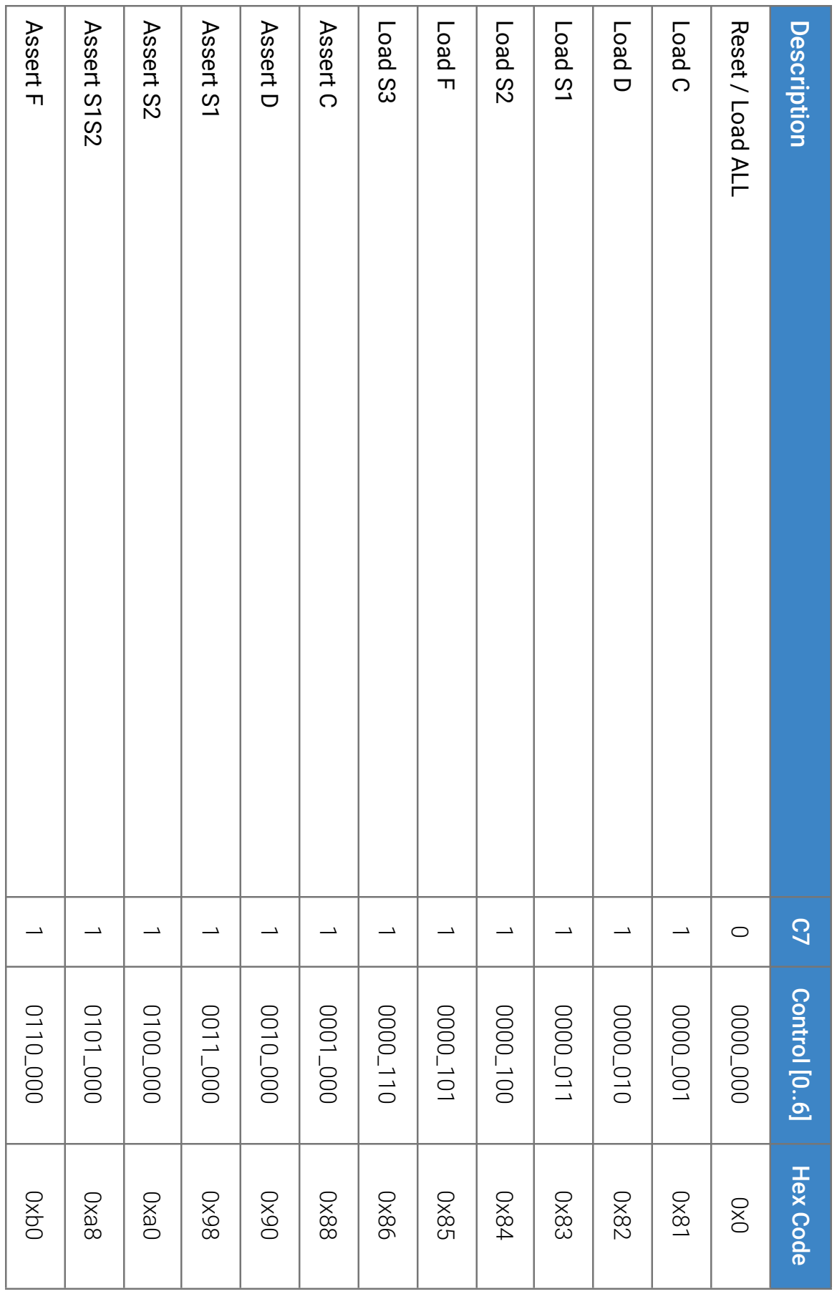
[picture p166: figure]
Description C7 Control [0..6] Hex Code; Reset / Load ALL 0 0000_000 0x0; Load C 1 0000_001 0x81; Load D 1 0000_010 0x82; Load S1 1 0000_011 0x83; Load S2 1 0000_100 0x84; Load F 1 0000_101 0x85; Load S3 1 0000_110 0x86; Assert C 1 0001_000 0x88; Assert D 1 0010_000 0x90; Assert S1 1 0011_000 0x98; Assert S2 1 0100_000 0xa0; Assert S1S2 1 0101_000 0xa8; Assert F 1 0110_000 0xb0

# Control & Instructions

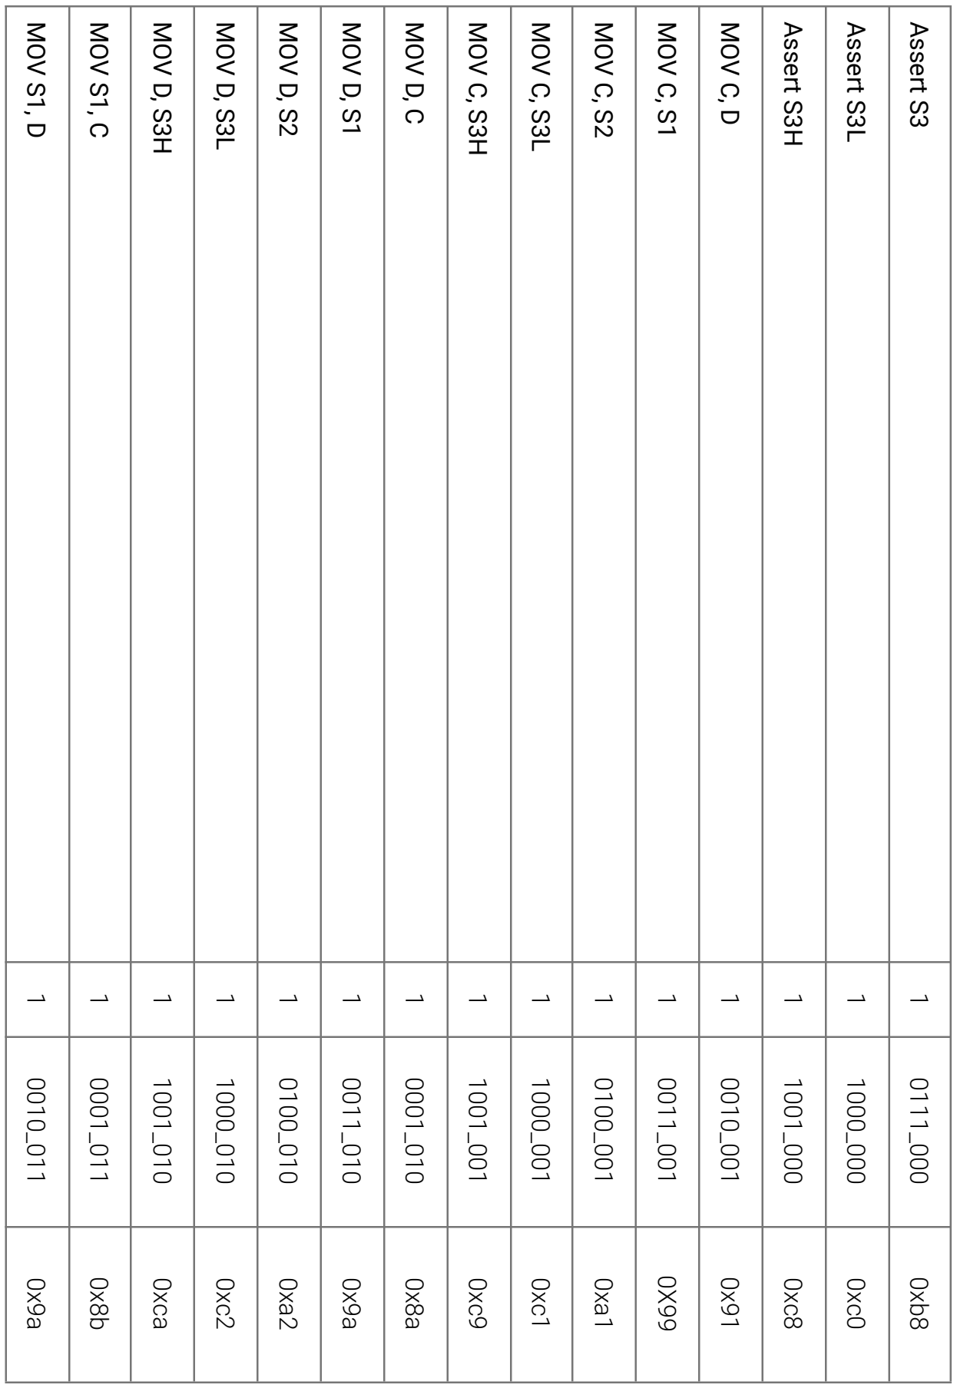
[picture p167: figure]
A s s ert S

# MOV S1, S2 1 0100_011 0x93

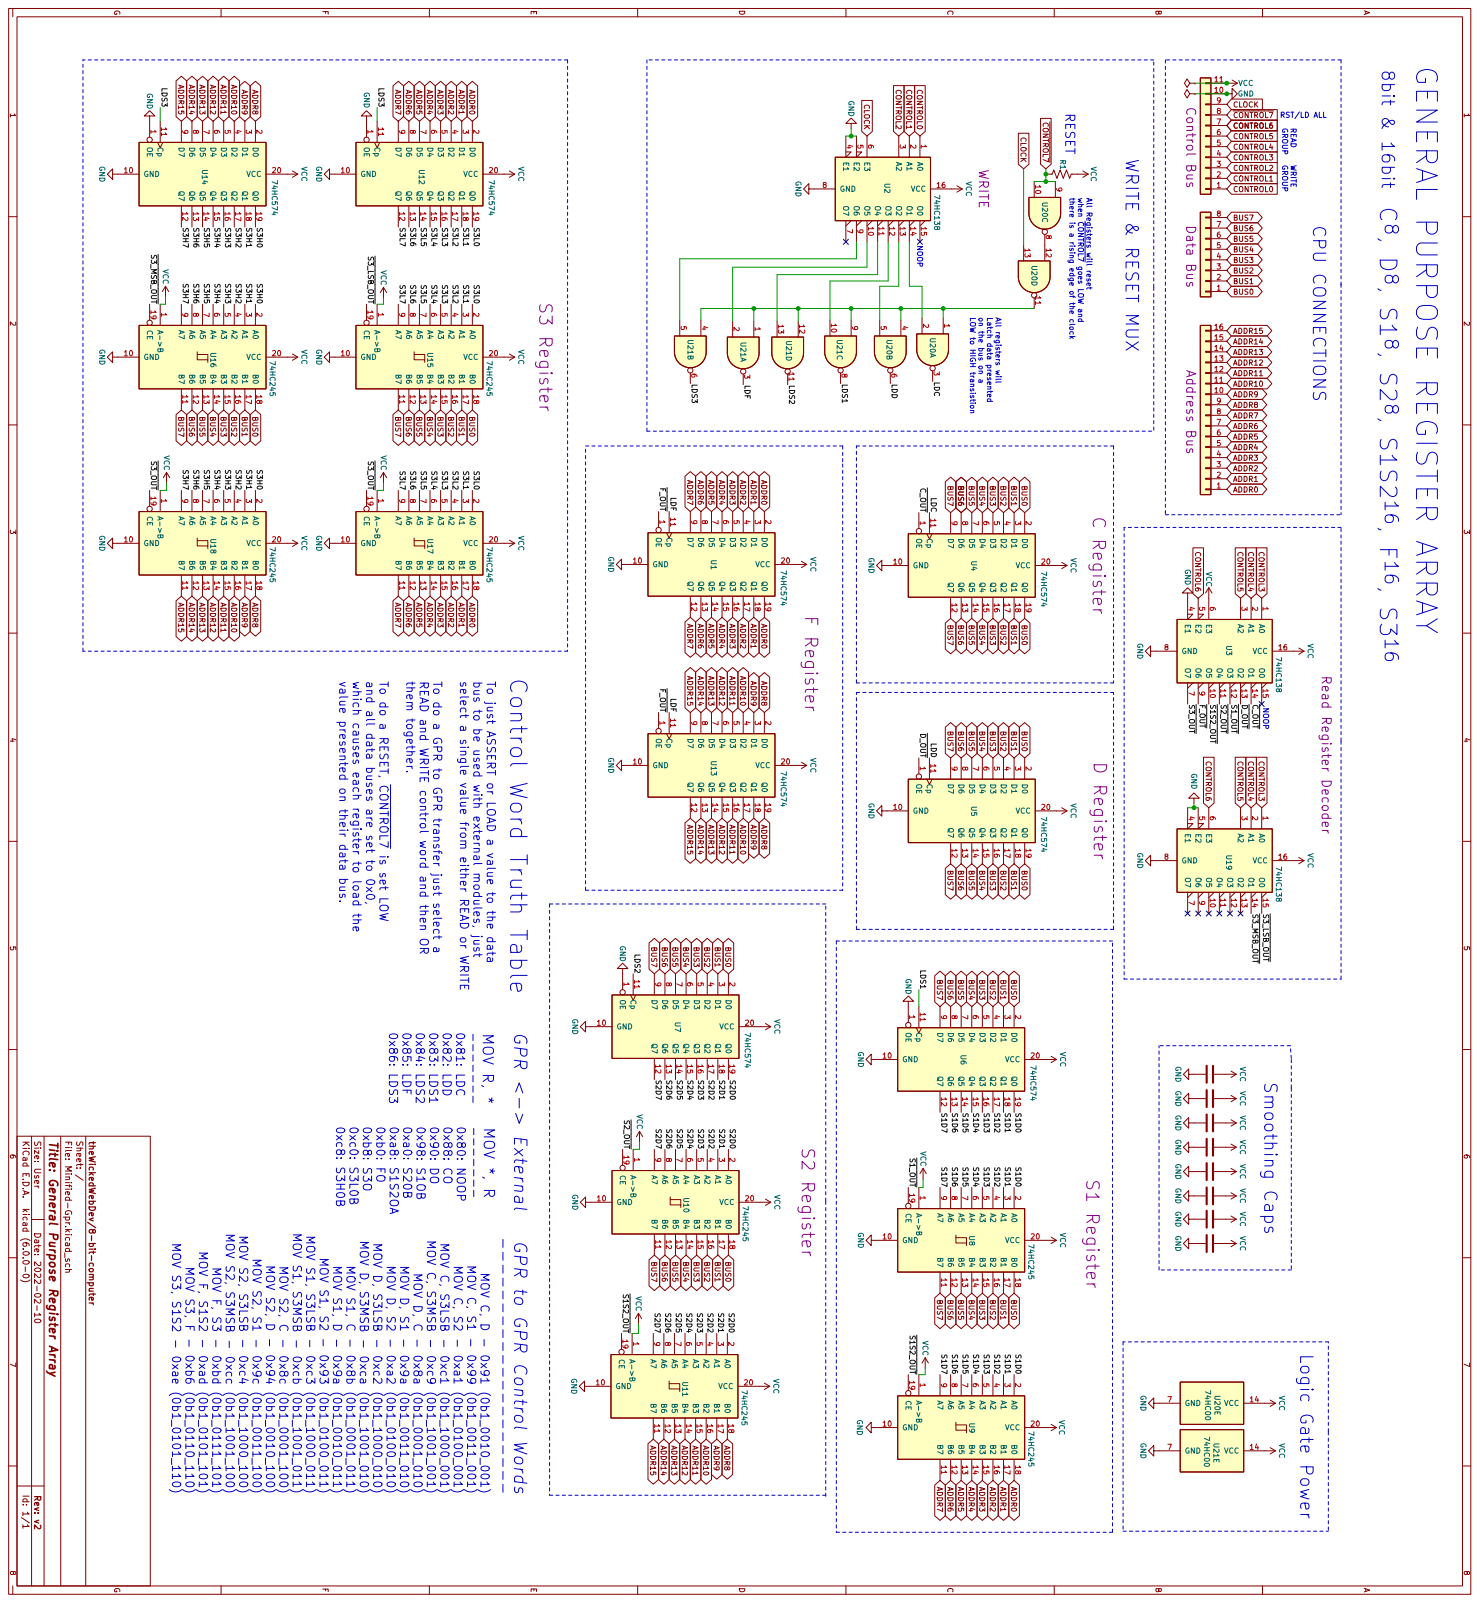
[picture p168: page 7]

GENERAL PURPOSE REGISTER ARRAY

RST/LD ALL GROUP WRITE

there is a rising edge of the clock

when ~{CONTROL7} goes LOW and

All Registers will reset

LOW to HIGH transistion

on the bus on a

Control Word Truth Table

value presented on their data bus.

which causes each register to load the

and all data buses are set to 0x0,

To do a RESET, ~{CONTROL7} is set LOW

READ and WRITE control word and then OR

To do a GPR to GPR transfer just select a

select a single value from either READ or WRITE

bus to be used with external modules, just

To just ASSERT or LOAD a value to the data

Title: General Purpose Register Array

GPR to GPR Control Words

# Parts & Components List

# Digital Logic, IC’s

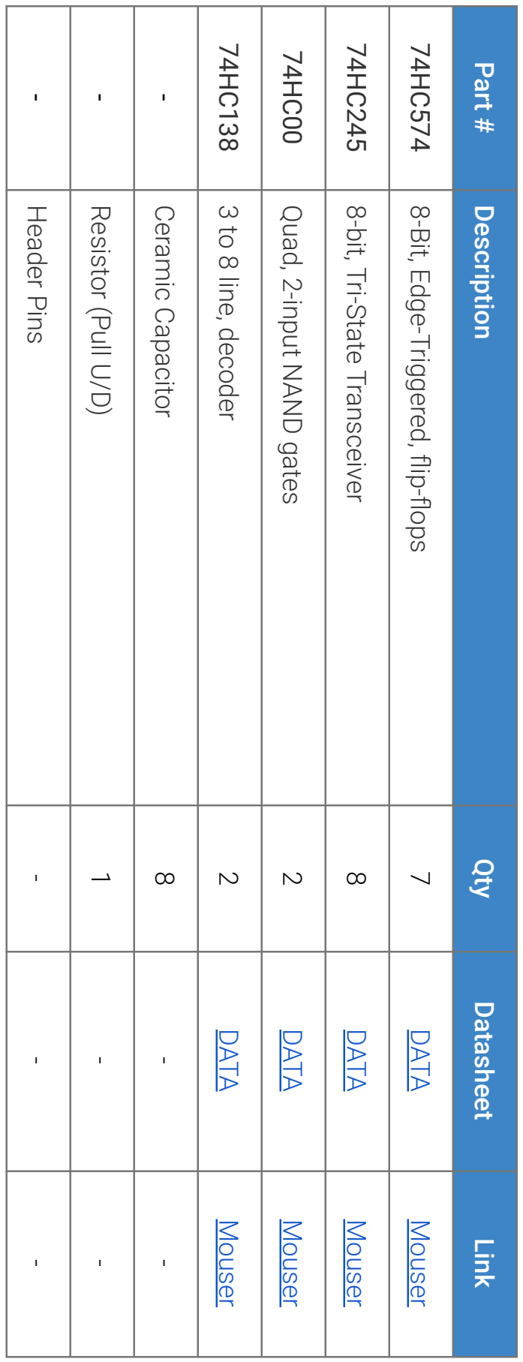
[picture p169: figure]
Part # Description Qty Datasheet Link; - Ceramic Capacitor 8 - -; - Resistor (Pull U/D) 1 - -; - Header Pins - - -

# 74HC574 8-Bit, Edge-Triggered, flip-flops 7 DATA Mouser

# 74HC245 8-bit, Tri-State Transceiver 8 DATA Mouser 74HC00 Quad, 2-input NAND gates 2 DATA Mouser

# 74HC138 3 to 8 line, decoder 2 DATA Mouser
