theWickedWebDev/8-bit-computer/PCBs/999-QUEUED-TO-PRINT/CLOCK/3d-Board.jpg

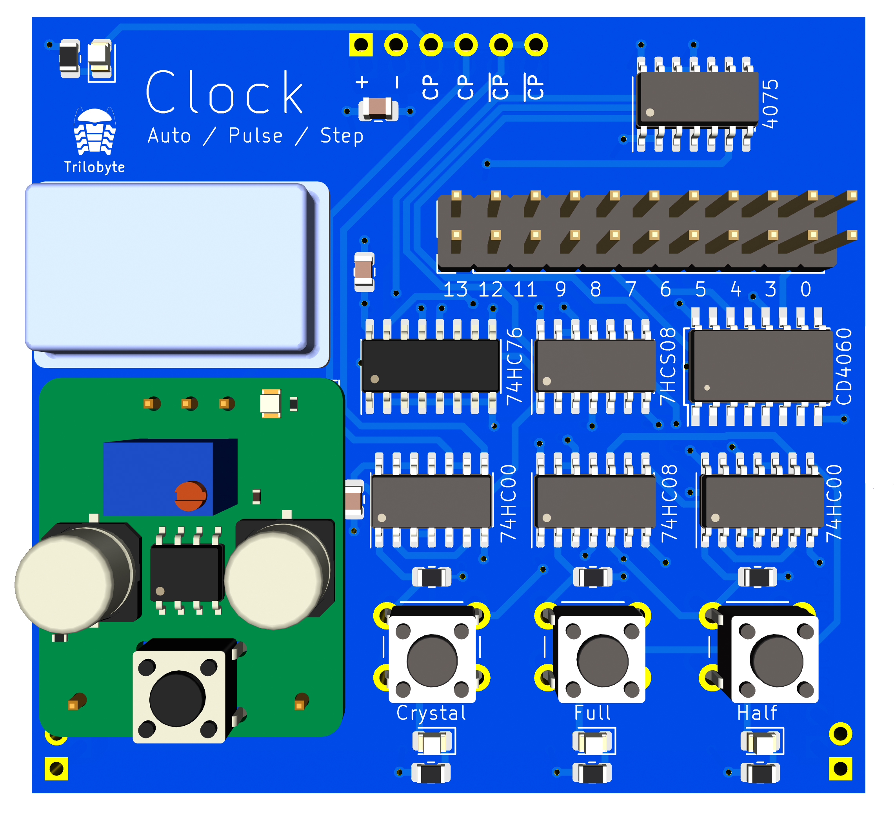
PCBs/999-QUEUED-TO-PRINT/CLOCK/3d-Board.jpg
