theWickedWebDev/8-bit-computer/PCBs/999-QUEUED-TO-PRINT/Interrupt-Handler/3D-Board.jpg

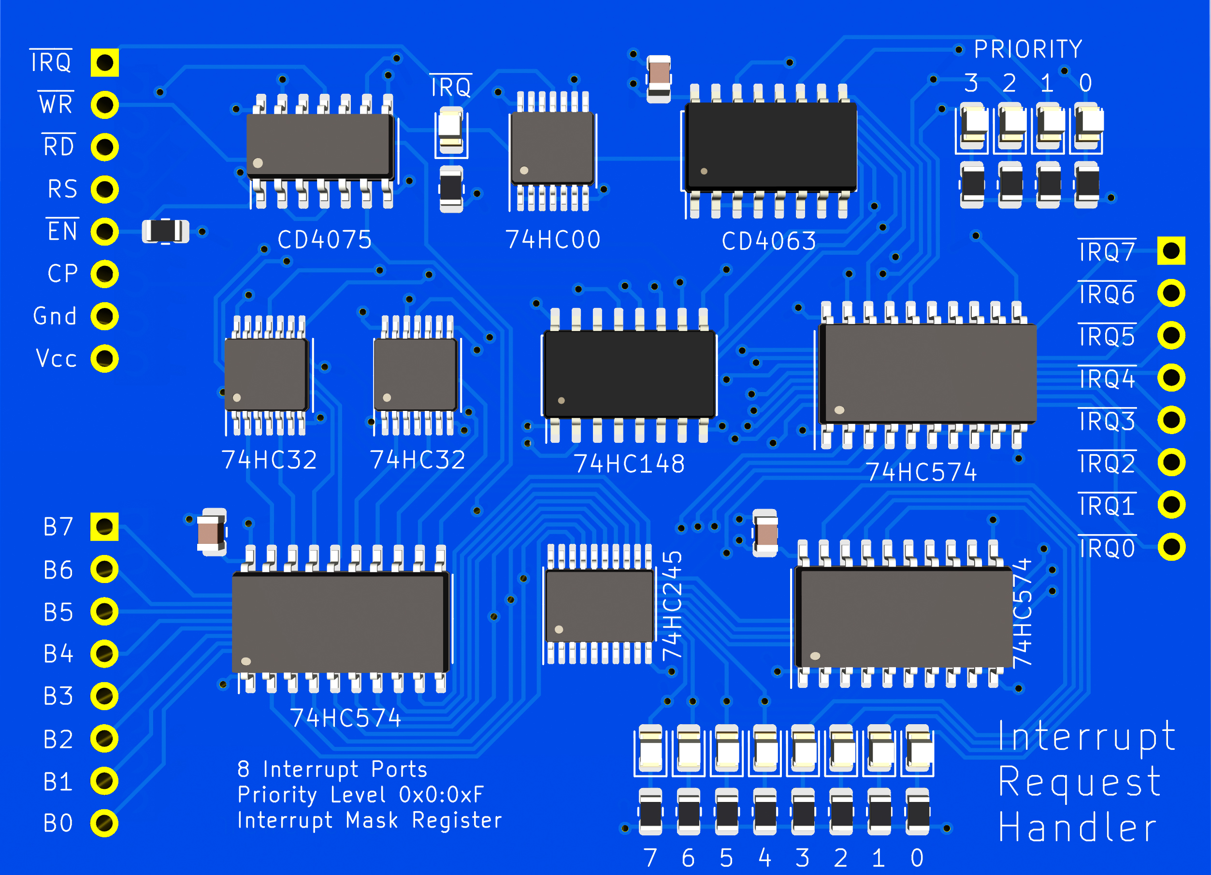
PCBs/999-QUEUED-TO-PRINT/Interrupt-Handler/3D-Board.jpg
