theWickedWebDev/8-bit-computer/PCBs/999-QUEUED-TO-PRINT/Interrupt-Handler/Gerber-Render.jpg

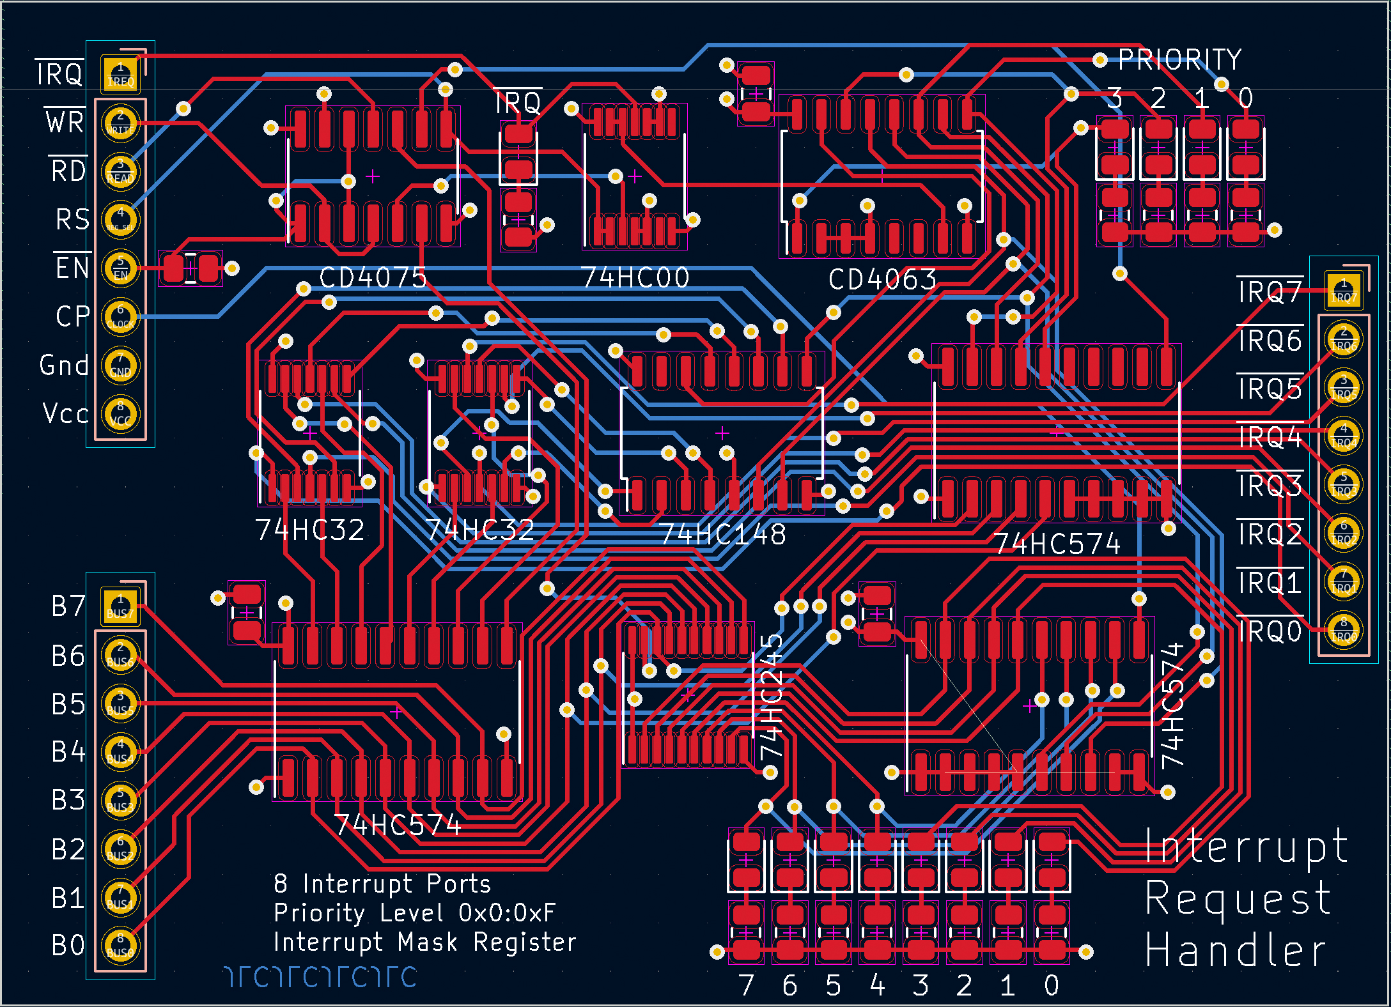
PCBs/999-QUEUED-TO-PRINT/Interrupt-Handler/Gerber-Render.jpg
