theWickedWebDev/8-bit-computer/trilobyte-web/src/images/cpu-instruction.png

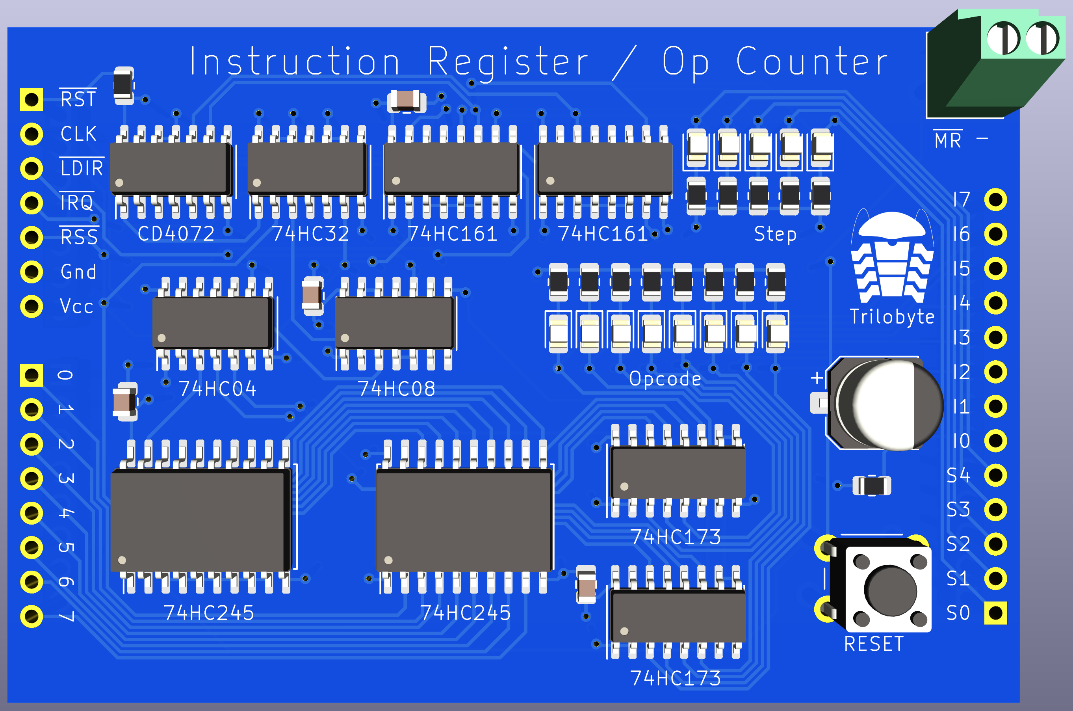
trilobyte-web/src/images/cpu-instruction.png
