theWickedWebDev/8-bit-computer/Modules/sound-module/8038-test.png

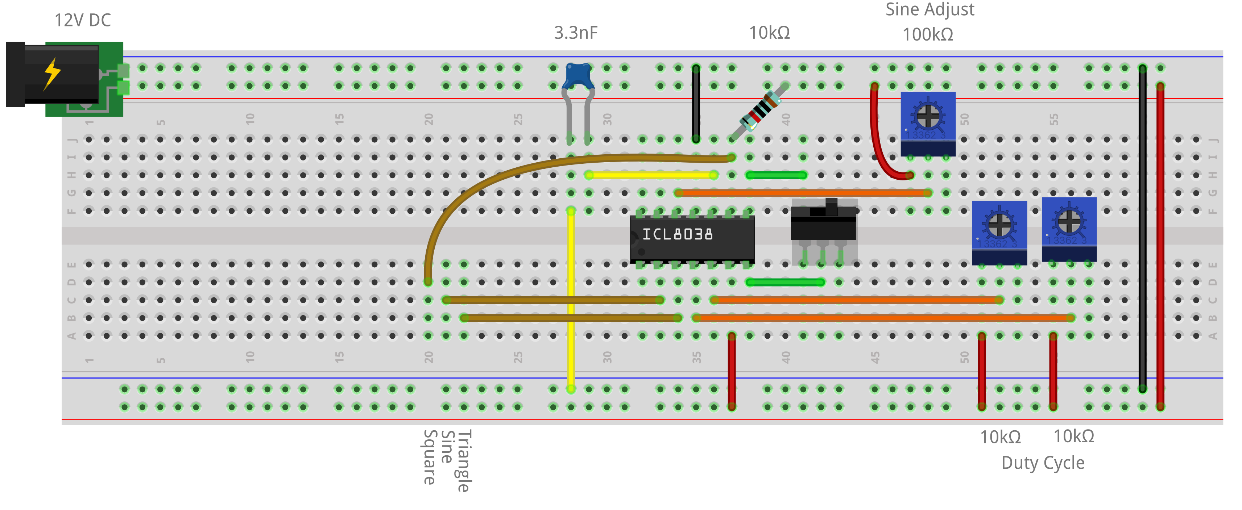
Modules/sound-module/8038-test.png
