theWickedWebDev/8-bit-computer/DOCUMENTATION/Block Diagrams/instruction-register.pdf

# Instruction Register & Step Counter

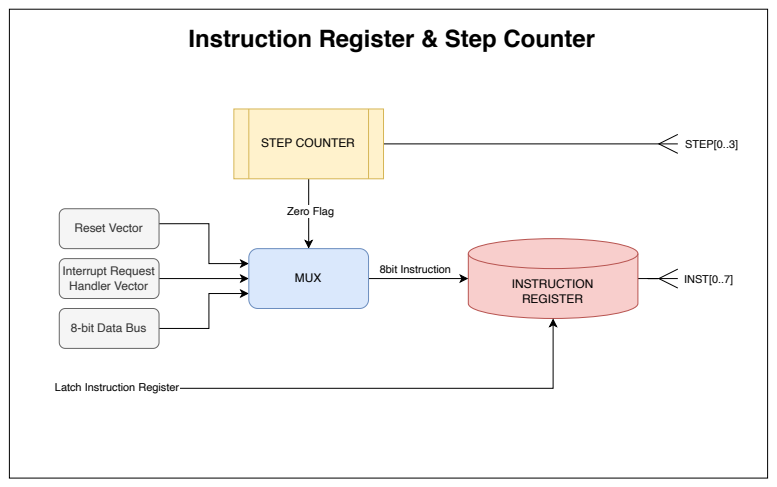
[picture p177: page 1]
STEP[0..3]; Zero Flag; STEP COUNTER; INST[0..7] INSTRUCTION; REGISTER; Interrupt Request Handler Vector; 8bit Instruction; MUX; Reset Vector

8-bit Data Bus

Latch Instruction Register
