theWickedWebDev/8-bit-computer/PCBs/999-QUEUED-TO-PRINT/Interrupt-Handler/new-interrupt-handler.pdf

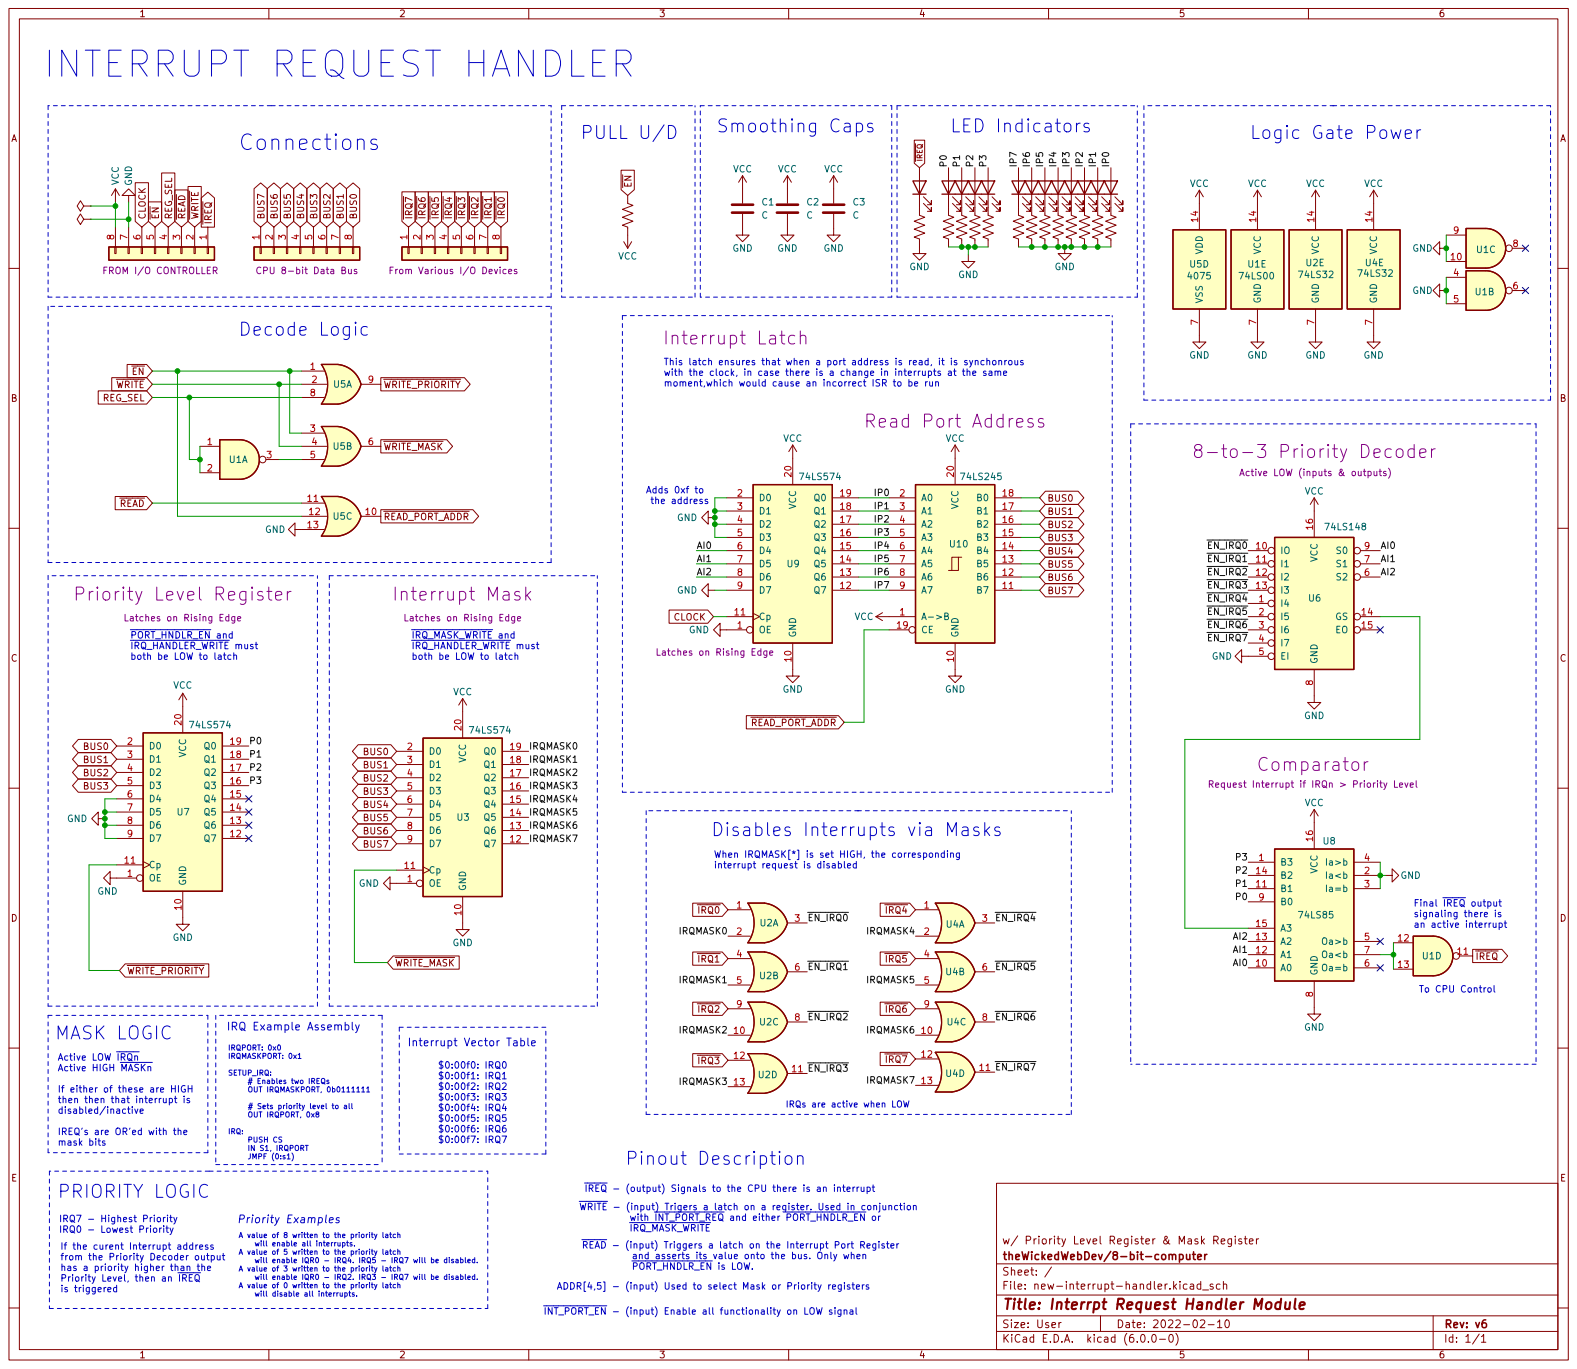
[picture p178: page 1]

with the clock, in case there is a change in interrupts at the same moment,which would cause an incorrect ISR to be run Smoothing Caps

8 CPU 8-bit Data Bus GND

This latch ensures that when a port address is read, it is synchonrous

the address PRIORITY LOGIC

Latches on Rising Edge

~{IRQ_MASK_WRITE} and
~{IRQ_HANDLER_WRITE} must both be LOW to latch

Disables Interrupts via Masks

When IRQMASK[*] is set HIGH, the corresponding
interrupt request is disabled

IREQ's are OR'ed with the mask bits MASK LOGIC

will disable all interrupts. Active LOW ~{IRQn}
Active HIGH ~{MASKn}

If either of these are HIGH
then then that interrupt is disabled/inactive

# Sets priority level to all OUT IRQPORT, 0x8

IRQs are active when LOW

~{IREQ} - (output) Signals to the CPU there is an interrupt
~{WRITE} - (input) Trigers a latch on a register. Used in conjunction
with ~{INT_PORT_REQ} and either ~{PORT_HNDLR_EN} or
~{IRQ_MASK_WRITE}
~{READ} - (input) Triggers a latch on the Interrupt Port Register
and asserts its value onto the bus. Only when
~{PORT_HNDLR_EN} is LOW.

A value of 8 written to the priority latch
will enable all interrupts. A value of 5 written to the priority latch

w/ Priority Level Register & Mask Register
File: new-interrupt-handler.kicad_sch Sheet: / theWickedWebDev/8-bit-computer

If the curent Interrupt address
from the Priority Decoder output
has a priority higher than the
Priority Level, then an ~{IREQ}
is triggered

will enable IQR0 - IRQ4. IRQ5 - IRQ7 will be disabled. A value of 3 written to the priority latch

will enable IQR0 - IRQ2. IRQ3 - IRQ7 will be disabled. A value of 0 written to the priority latch

ADDR[4,5] - (input) Used to select Mask or Priority registers

Id: 1/1 Title: Interrpt Request Handler Module

~{INT_PORT_EN} - (input) Enable all functionality on LOW signal
