theWickedWebDev/8-bit-computer/Modules/ram-module/schematic/ram-combined.pdf

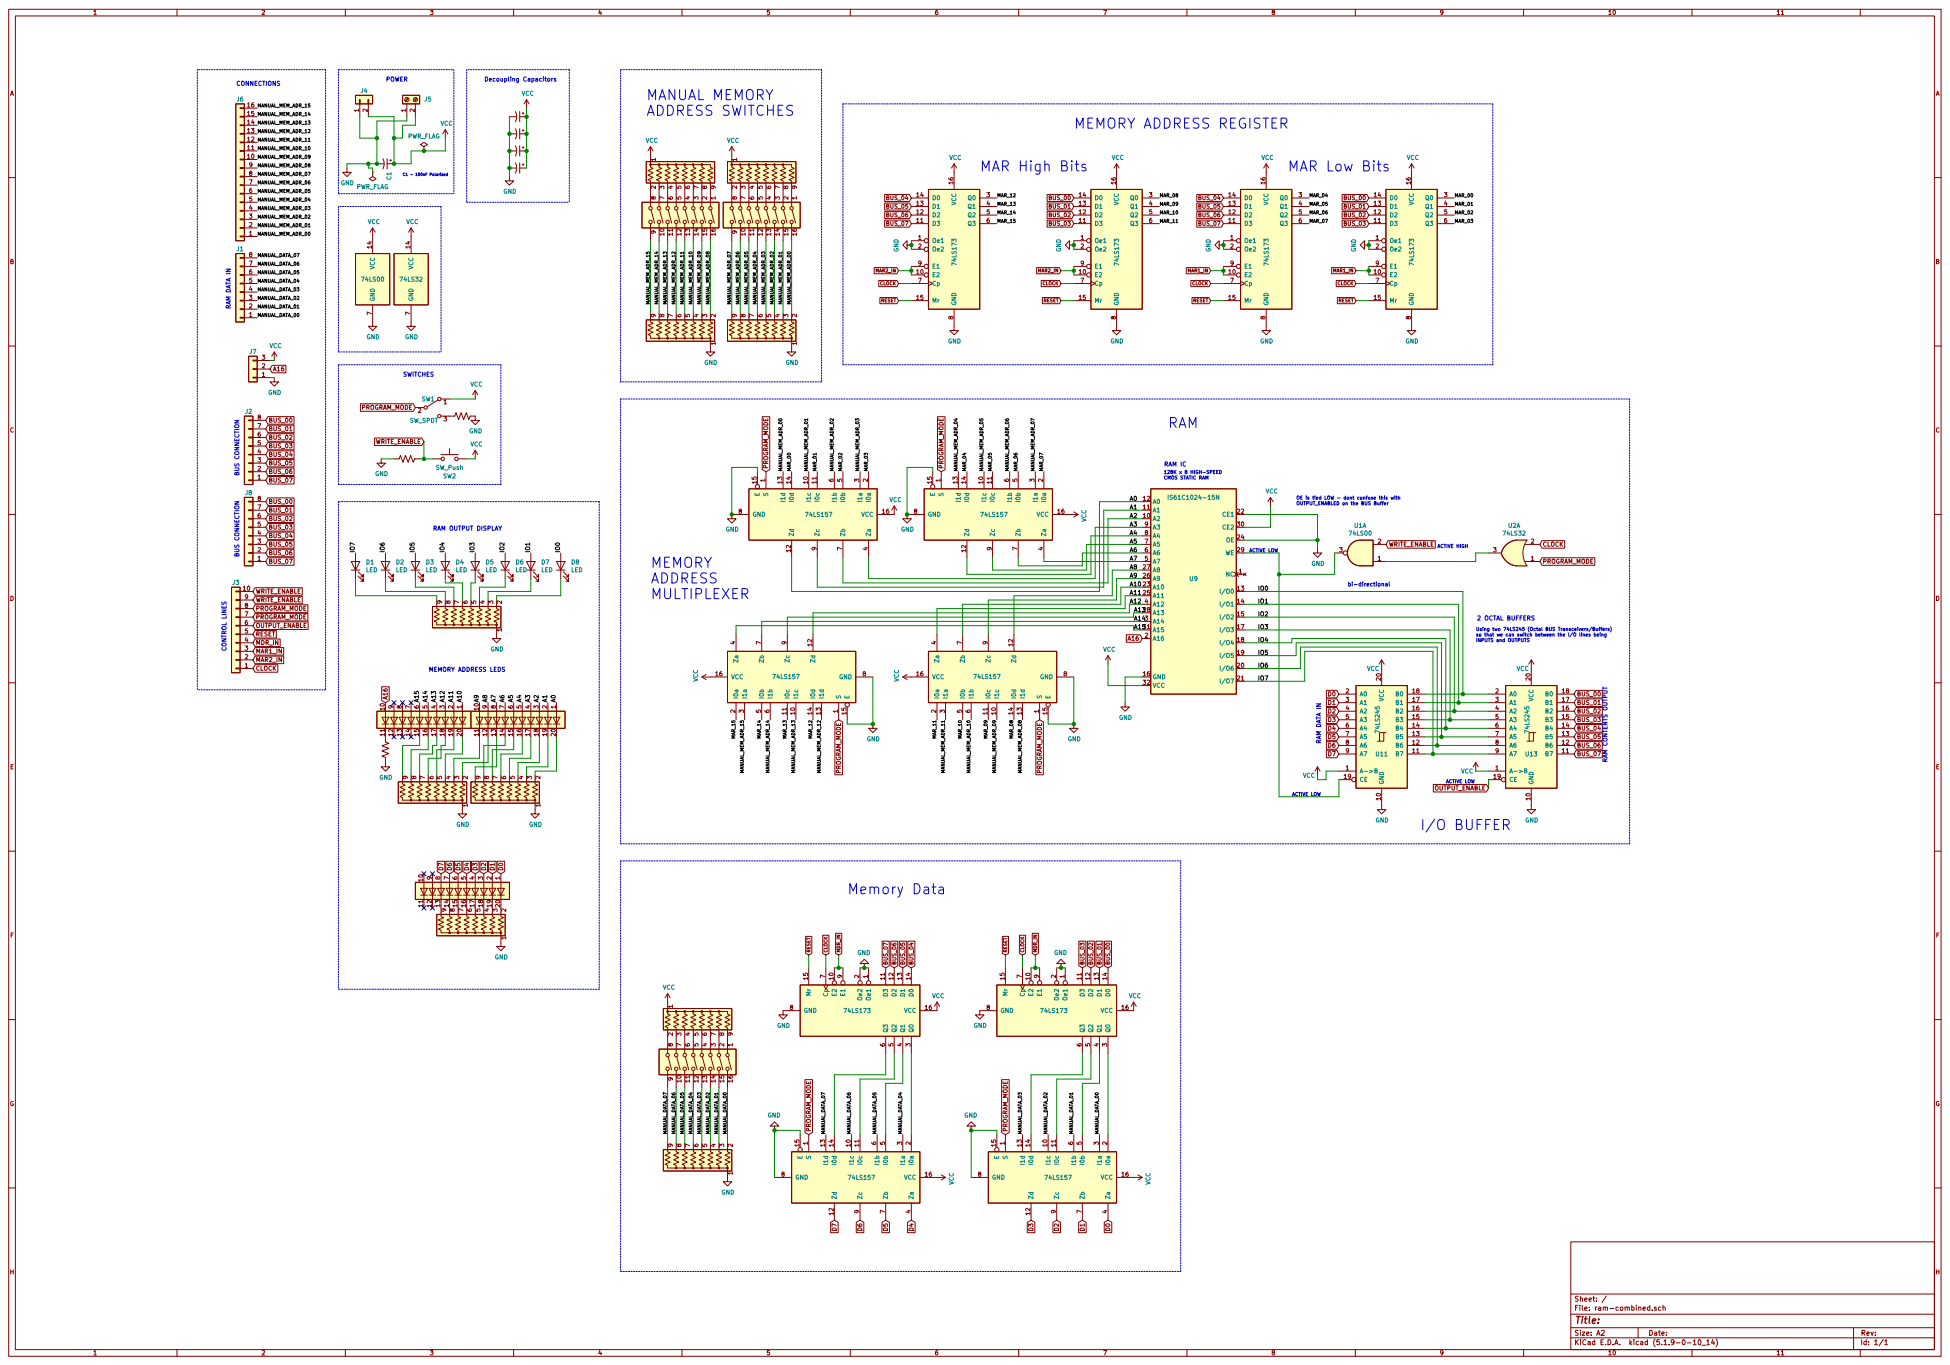
[picture p179: page 1]

CMOS STATIC RAM MANUAL MEMORY
ADDRESS SWITCHES

bi-directional MEMORY ADDRESS REGISTER

8 E1 9 74LS173 VCC GND Oe1 1 E2 10 D3 11 D2 12 D1 13 D0 14 Mr 15 VCC 16 Oe2 2 Q0 3 Q1 4 Q2 5 Q3 6 Cp 7 GND

INPUTS and OUTPUTS SWITCHES

ACTIVE LOW BUS CONNECTION

OE is tied LOW - dont confuse this with OUTPUT_ENABLED on the BUS Buffer MEMORY

RAM OUTPUT DISPLAY CONTROL LINES

Using two 74LS245 (Octal BUS Transceivers/Buffers) so that we can switch between the I/O lines being

9 GND GND GND Oe1 VCC

Id: 1/1 Title: File: ram-combined.sch Sheet: /
