theWickedWebDev/8-bit-computer/PCBs/03_MODULES/CPU-ALU/ALU-Arithmetic/ALU-Arithmetic-schematic.pdf

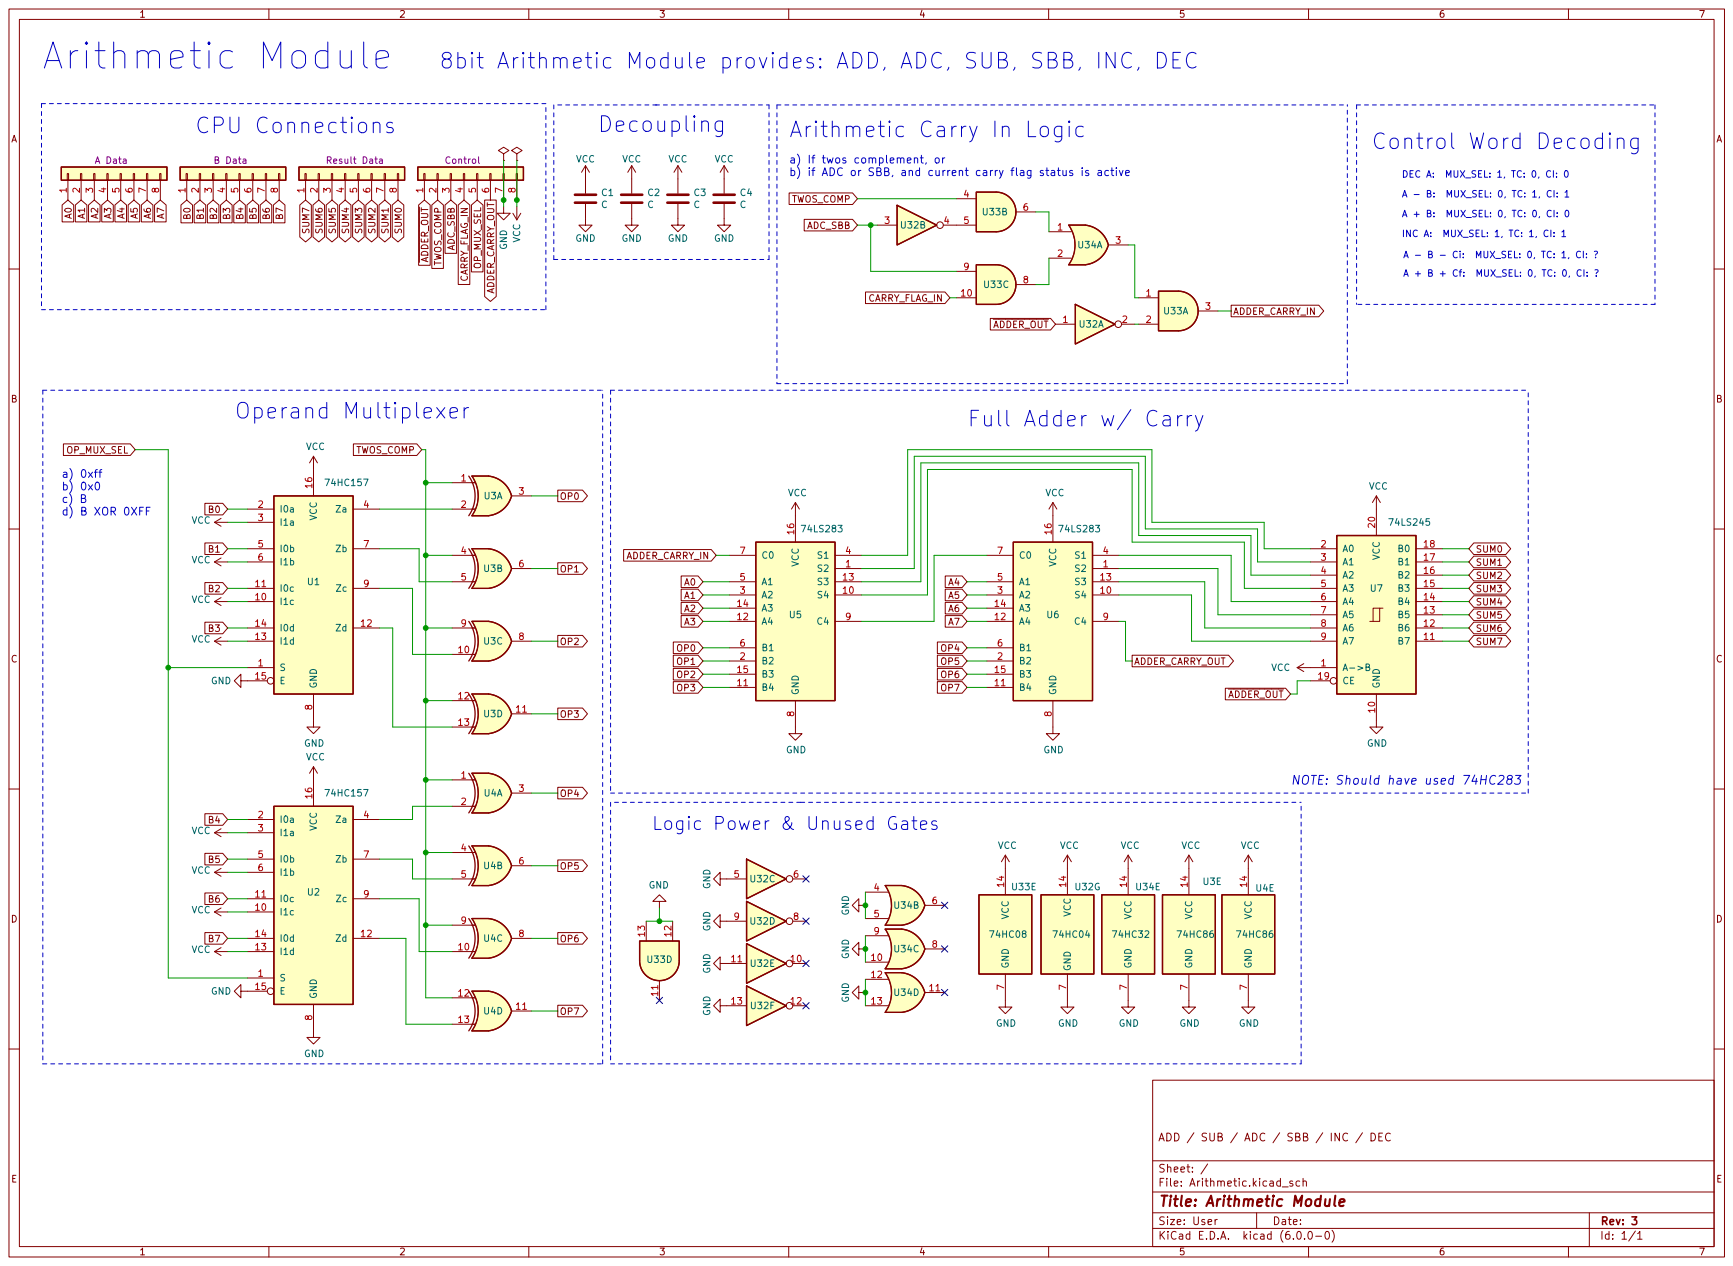
[picture p180: page 1]

8bit Arithmetic Module provides: ADD, ADC, SUB, SBB, INC, DEC

A + B + Cf: MUX_SEL: 0, TC: 0, CI: ? Arithmetic Carry In Logic

8 Result Data VCC VCC GND GND GND

a) If twos complement, or

INC A: MUX_SEL: 1, TC: 1, CI: 1 DEC A: MUX_SEL: 1, TC: 0, CI: 0 a) 0xff

A - B - Ci: MUX_SEL: 0, TC: 1, CI: ? Logic Power & Unused Gates

NOTE: Should have used 74HC283

File: Arithmetic.kicad_sch Sheet: / ADD / SUB / ADC / SBB / INC / DEC

Id: 1/1 Title: Arithmetic Module
