theWickedWebDev/8-bit-computer/PCBs/03_MODULES/CPU-ALU/ALU-Conditional-Jumps/ALU-Conditional-Jumps-Schematic.pdf

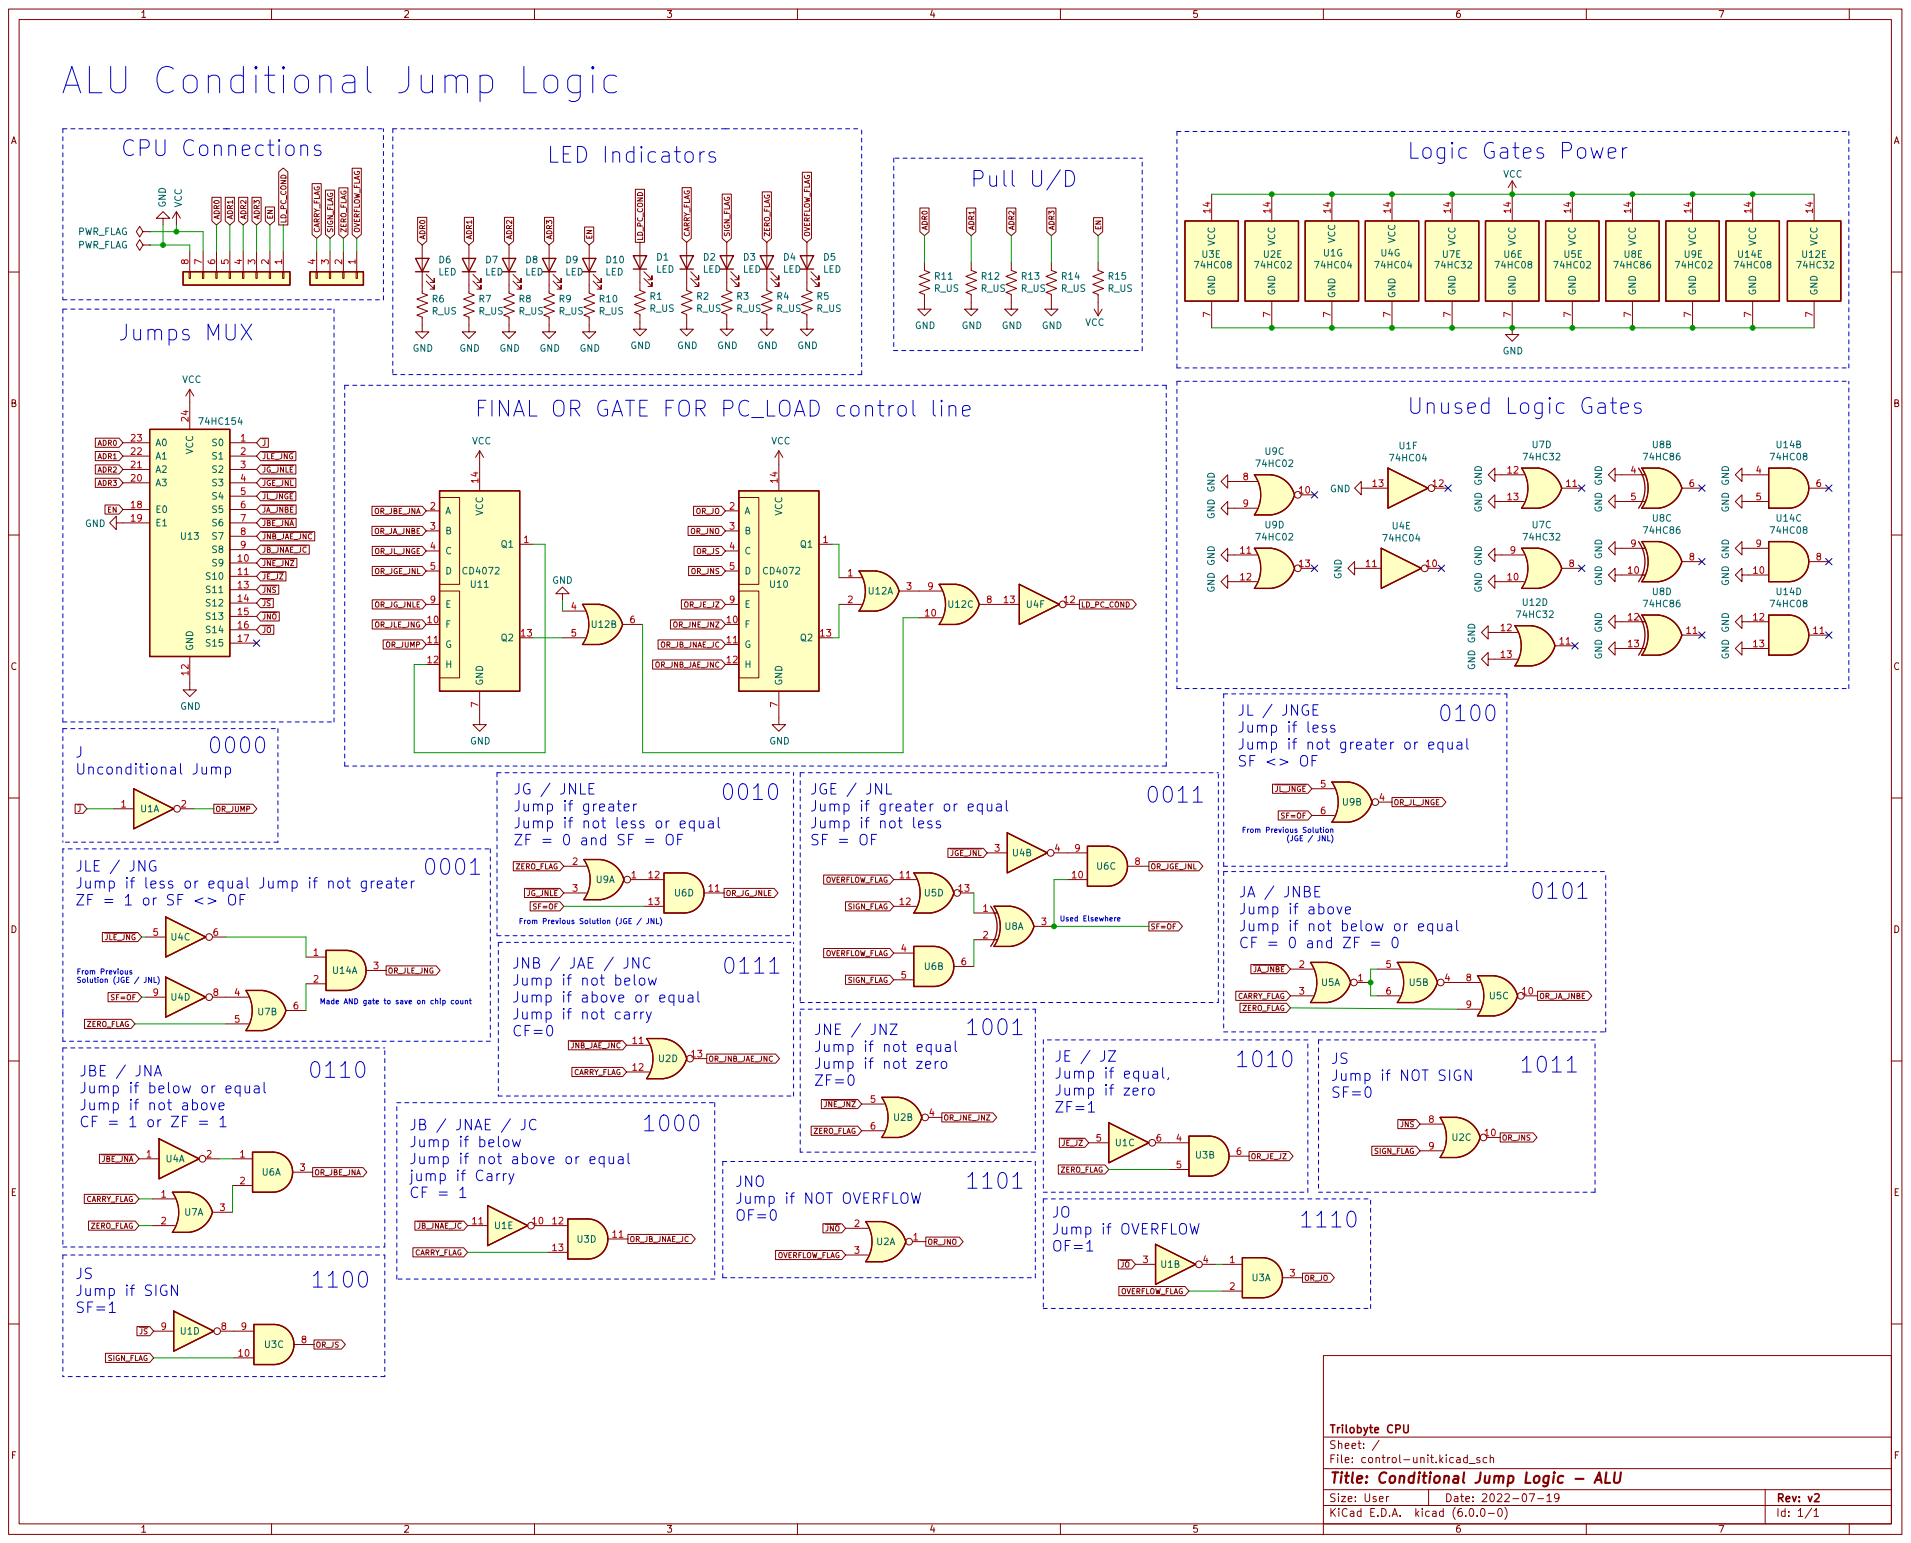
[picture p181: page 1]

1 GND VCC GND GND

FINAL OR GATE FOR PC_LOAD control line

74HC32 GND GND GND GND

Jump if less
Jump if not greater or equal

JG / JNLE
Jump if greater
Jump if not less or equal
ZF = 0 and SF = OF

JGE / JNL
Jump if greater or equal
Jump if not less

JLE / JNG
Jump if less or equal Jump if not greater

Made AND gate to save on chip count 0001

Jump if above
Jump if not below or equal
CF = 0 and ZF = 0

Jump if not below Jump if not carry CF=0 CARRY_FLAG | 11 13 U2D

Jump if above or equal

JNE / JNZ
Jump if not equal
Jump if not zero

JBE / JNA | | 12

Jump if NOT SIGN

Jump if below or equal
Jump if not above

Jump if below
Jump if not above or equal
jump if Carry

~{JNO} JNO
Jump if NOT OVERFLOW

Id: 1/1 Title: Conditional Jump Logic - ALU
