theWickedWebDev/8-bit-computer/PCB-Modules/99_IN PROGRESS/READY-TO-PRINT/CONTROL-UNIT/control-unit.pdf

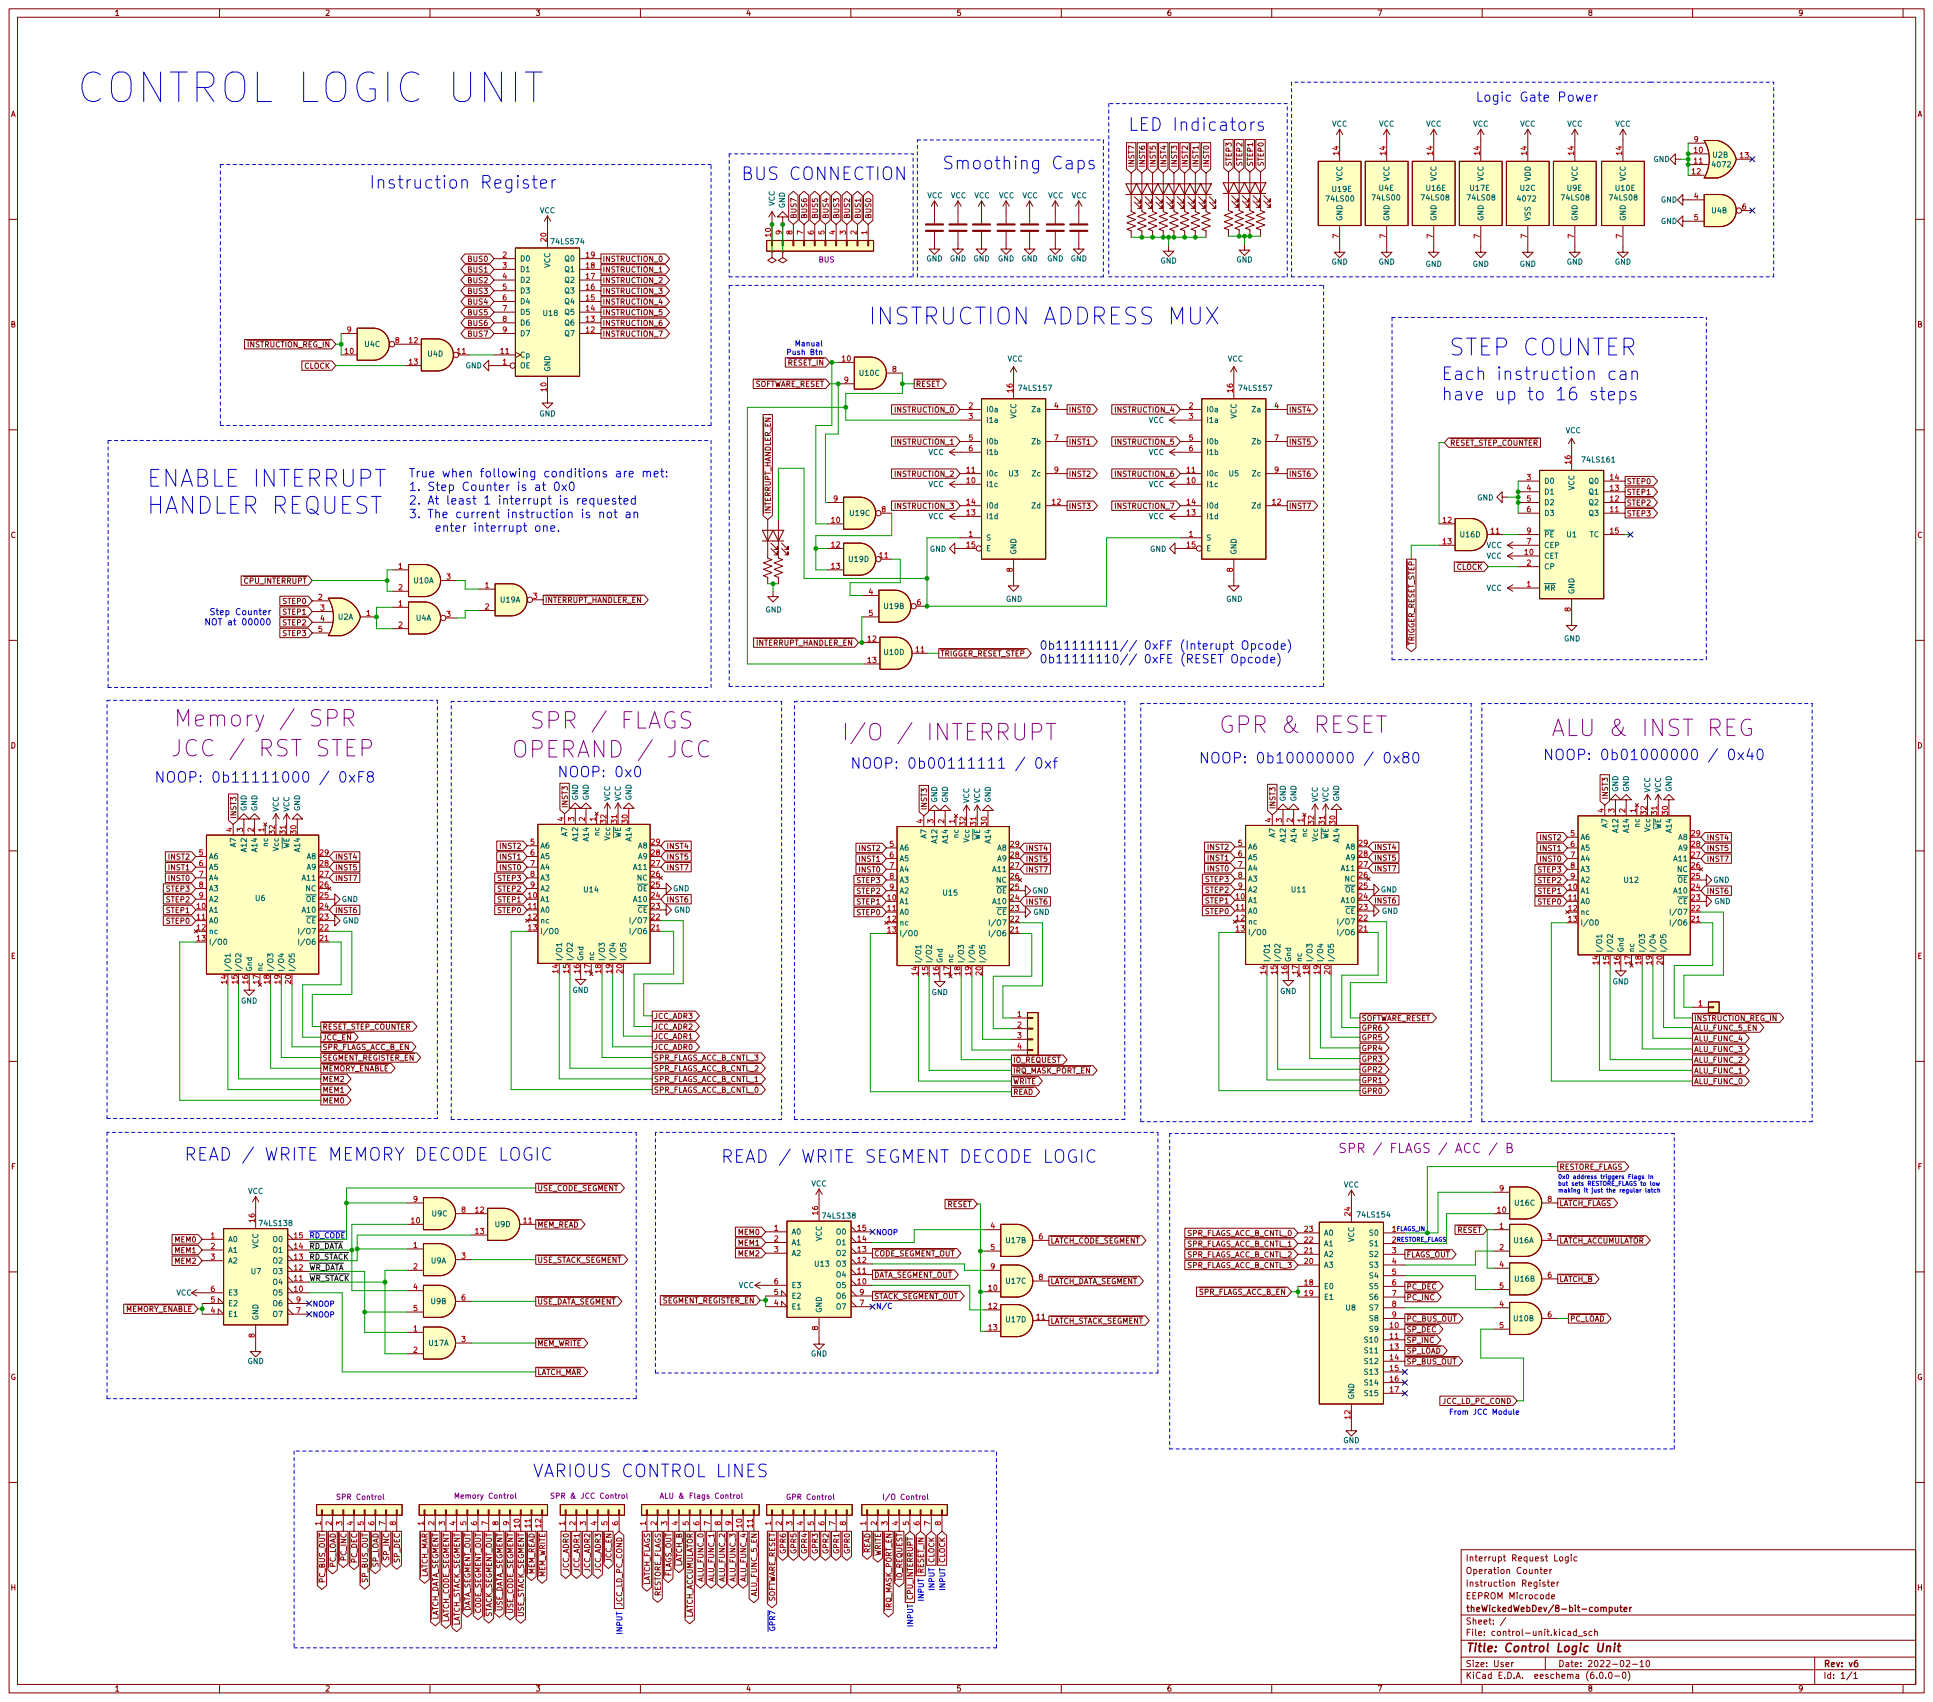
[picture p182: page 1]

VCC VCC VCC GND GND GND GND GND

4 A6 5 A5 6 A4 7 A3 8 A2 9 U15 I/O / INTERRUPT GND GND VCC GND
INSTRUCTION ADDRESS MUX

STEP COUNTER
Each instruction can
have up to 16 steps

True when following conditions are met:
1. Step Counter is at 0x0
2. At least 1 interrupt is requested
3. The current instruction is not an
enter interrupt one.

Step Counter NOT at 00000 NOOP: 0b11111000 / 0xF8

Memory / SPR VCC GND

READ / WRITE MEMORY DECODE LOGIC

READ / WRITE SEGMENT DECODE LOGIC
74LS138 GND

Interrupt Request Logic
Operation Counter
Instruction Register
File: control-unit.kicad_sch Sheet: / theWickedWebDev/8-bit-computer EEPROM Microcode

Id: 1/1 Title: Control Logic Unit
