theWickedWebDev/8-bit-computer/PCB-Modules/99_IN PROGRESS/READY-TO-PRINT/memory/RAM-MODULE.pdf

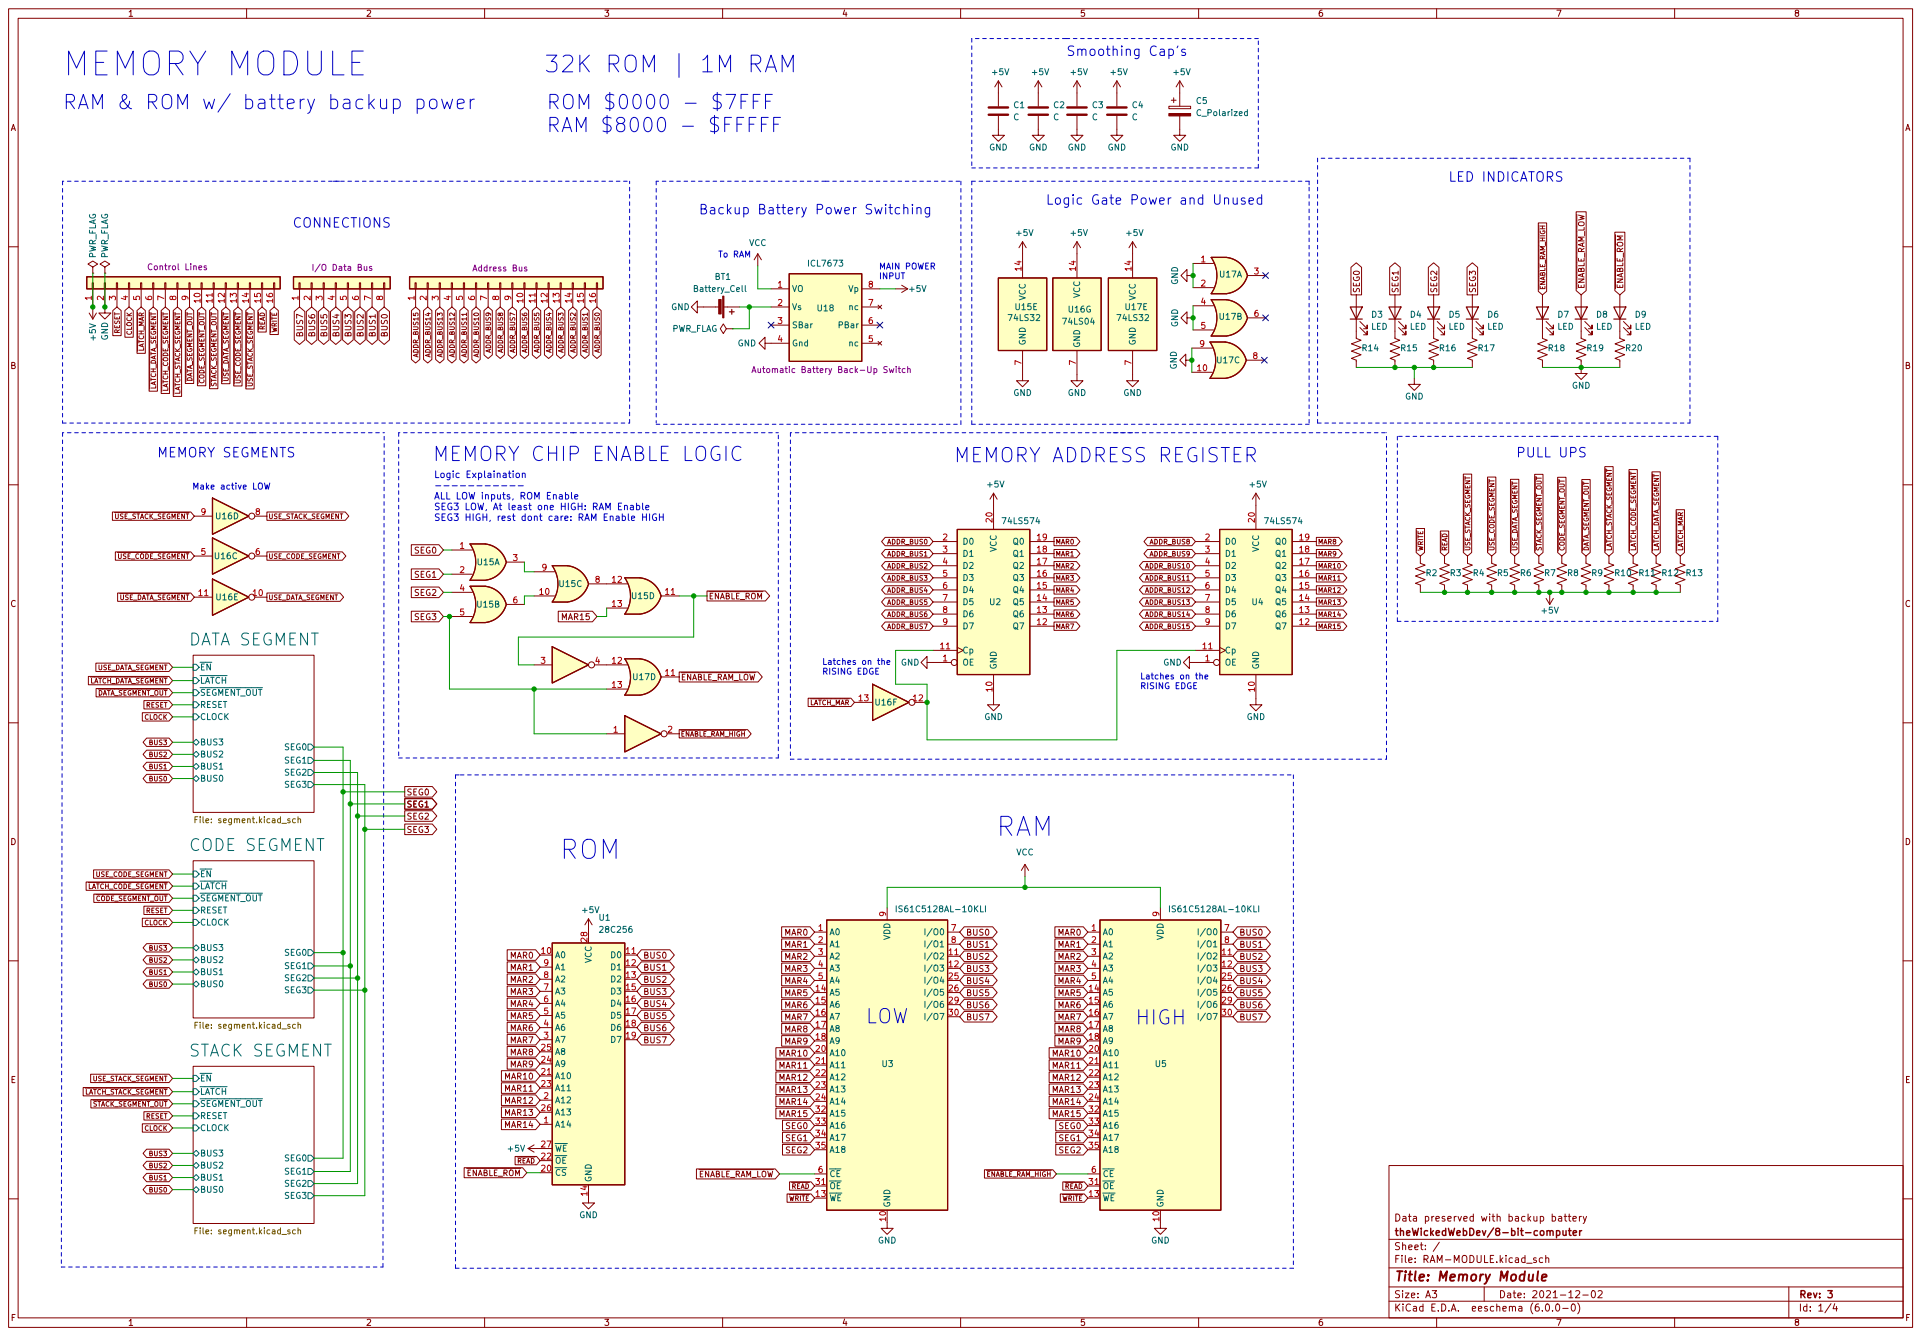
[picture p183: page 1]

Latches on the RISING EDGE Make active LOW MEMORY MODULE

Smoothing Cap's
IS61C5128AL-10KLI GND GND VCC 14 GND

RAM & ROM w/ battery backup power

Logic Gate Power and Unused

Backup Battery Power Switching

Logic Explaination
----------- ALL LOW inputs, ROM Enable

SEG3 LOW, At least one HIGH: RAM Enable
SEG3 HIGH, rest dont care: RAM Enable HIGH

Latches on the RISING EDGE

Data preserved with backup battery
File: RAM-MODULE.kicad_sch Sheet: / theWickedWebDev/8-bit-computer

Id: 1/4 Title: Memory Module
