theWickedWebDev/8-bit-computer/PCBs/03_MODULES/CPU-ALU/ALU-Control_and_Output/alu-control-unit-schematic.pdf

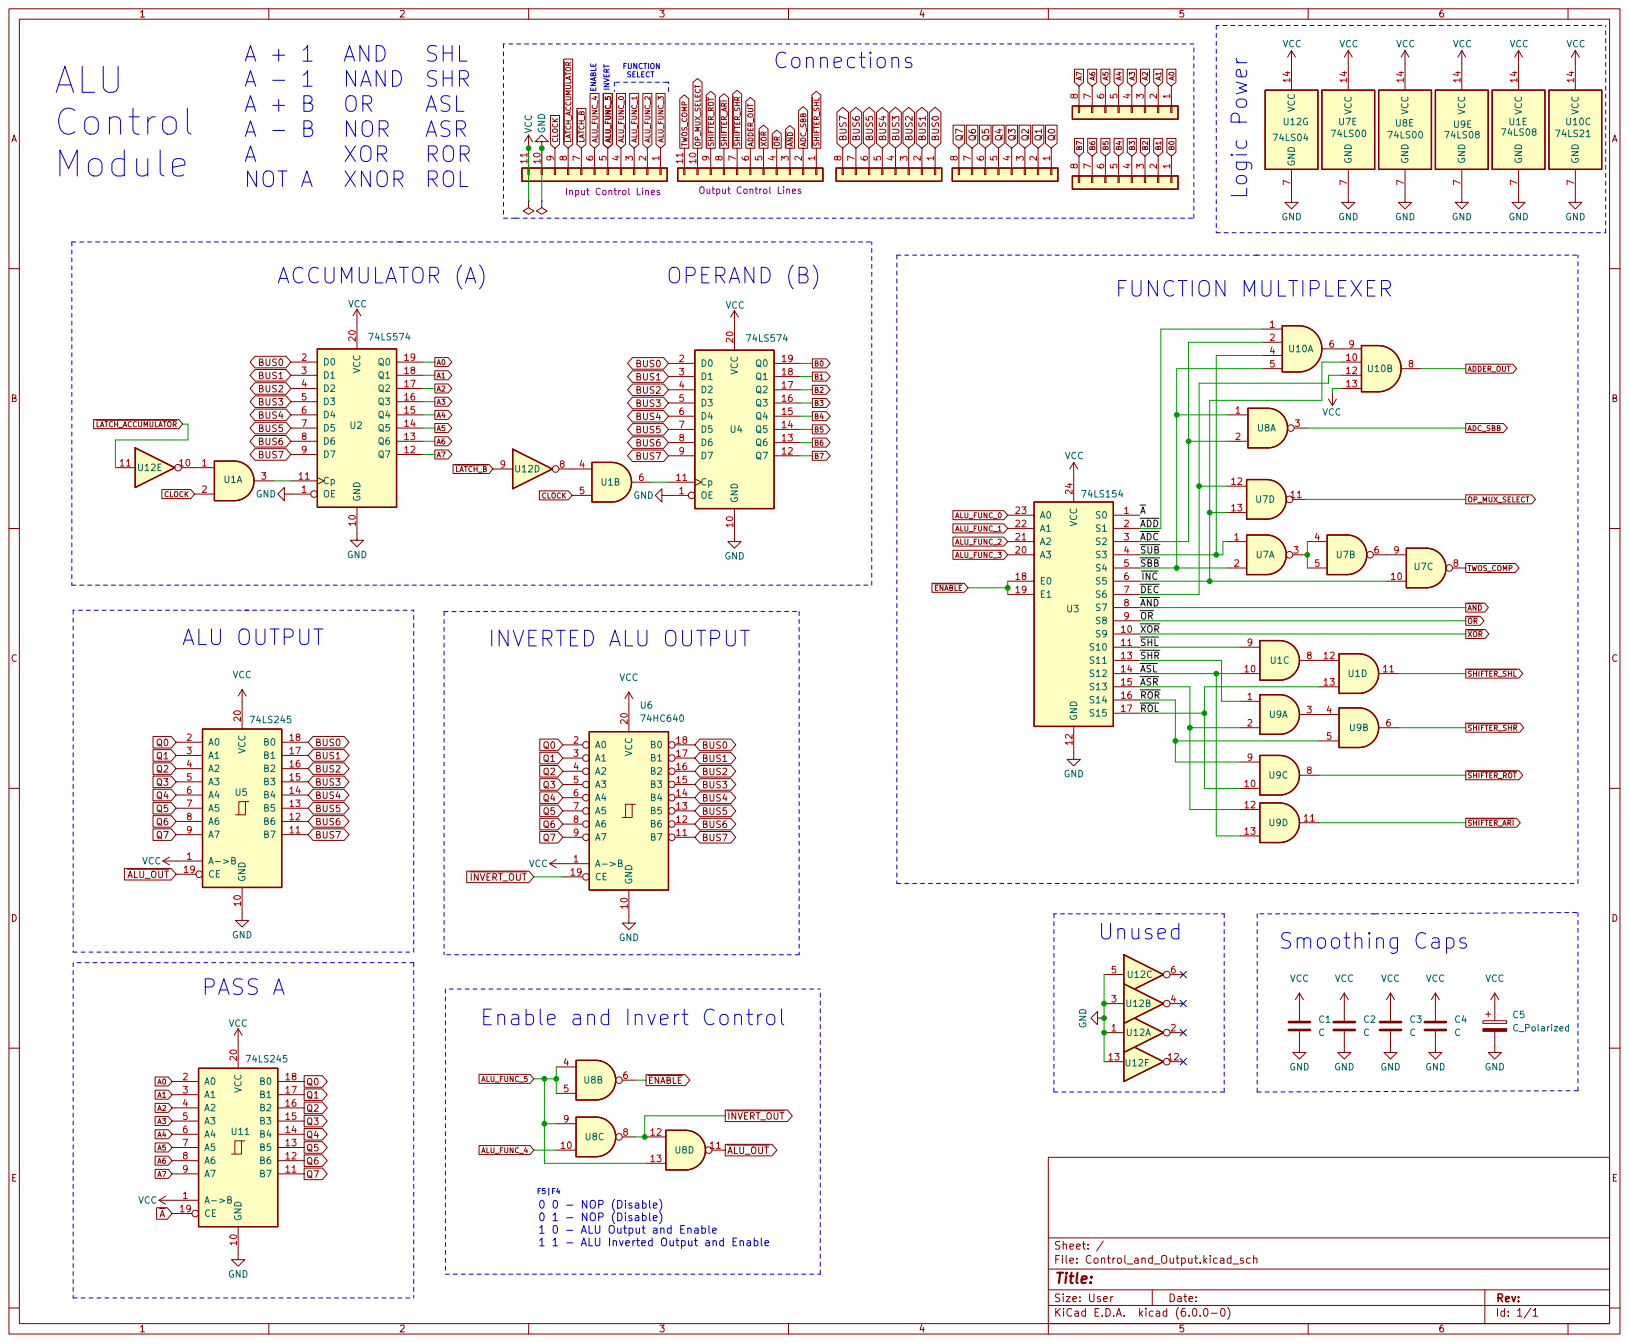
[picture p184: page 1]

Connections
Input Control Lines VCC GND

FUNCTION MULTIPLEXER Logic Power

Enable and Invert Control

F5|F4 0 0 - NOP (Disable)
0 1 - NOP (Disable)
1 0 - ALU Output and Enable
1 1 - ALU Inverted Output and Enable
