theWickedWebDev/8-bit-computer/PCBs/03_MODULES/CPU-ALU/ALU-Flags-Register/alu-flags-register-schematic.pdf

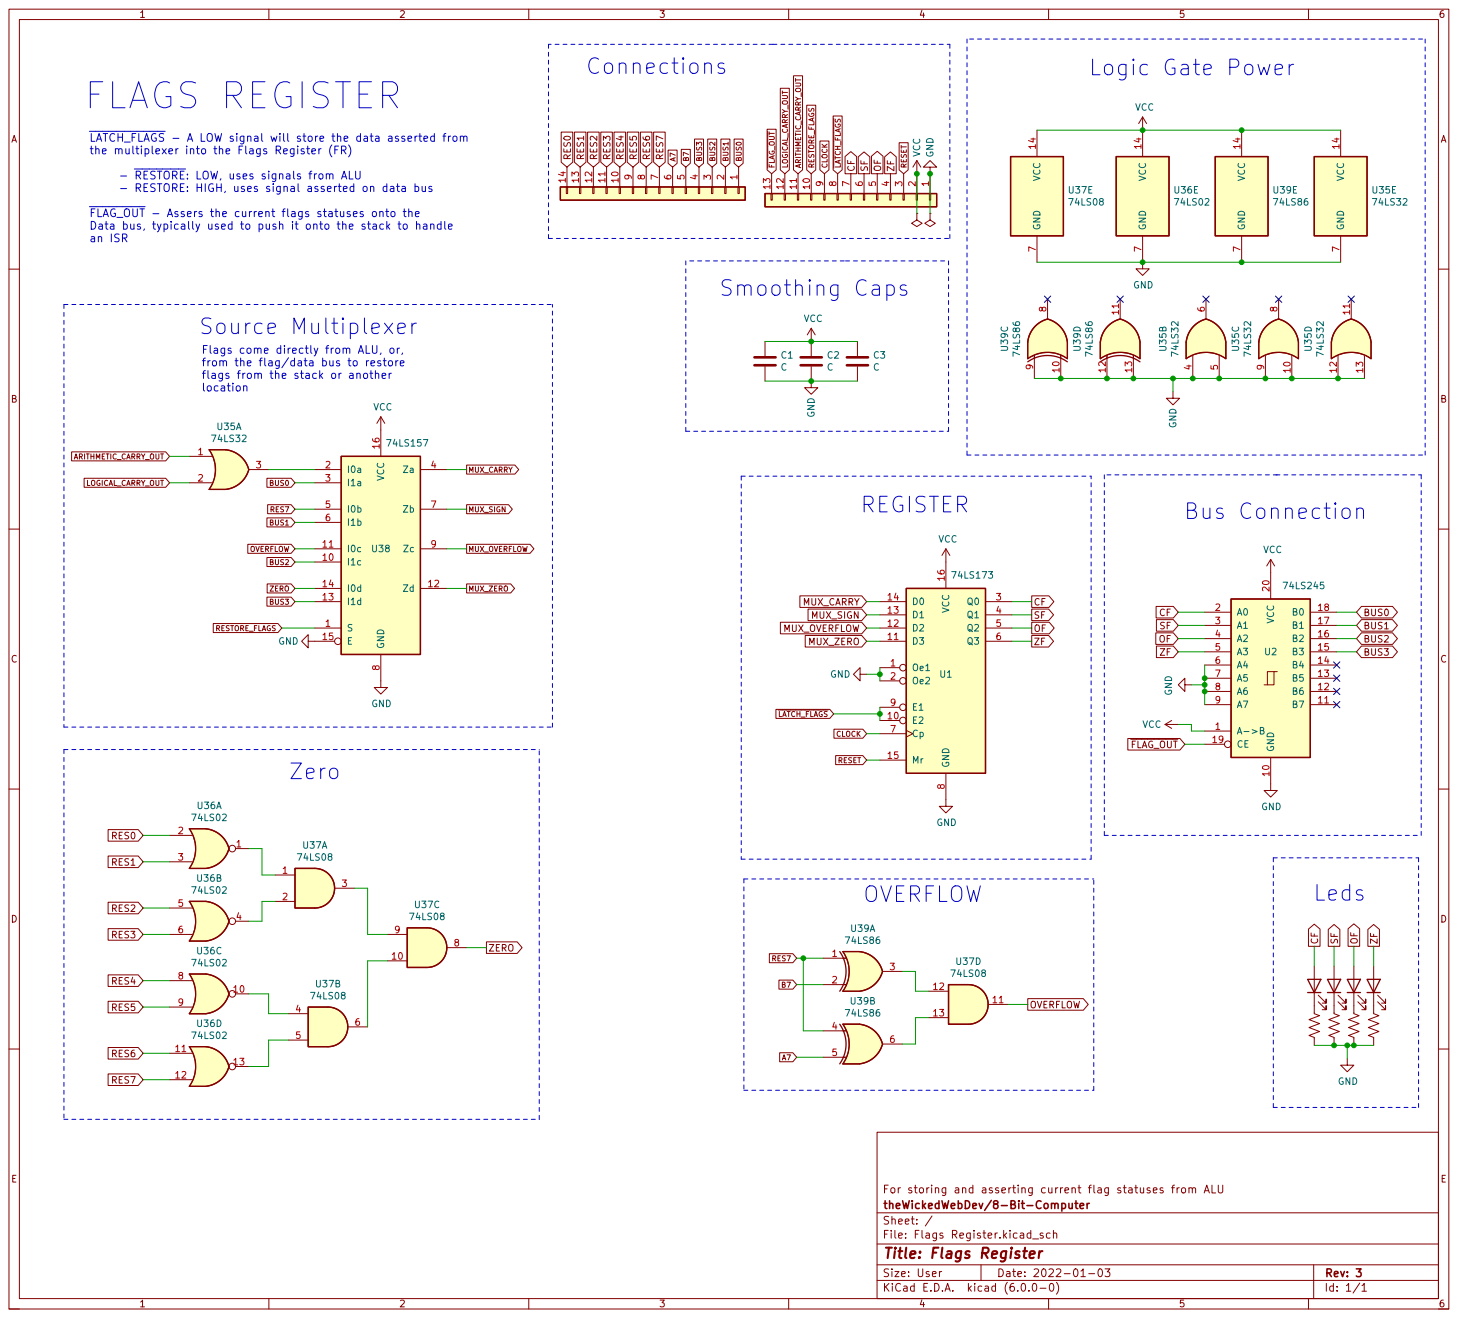
[picture p185: page 1]
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

- ~{RESTORE}: LOW, uses signals from ALU
- RESTORE: HIGH, uses signal asserted on data bus

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

For storing and asserting current flag statuses from ALU
File: Flags Register.kicad_sch Sheet: / theWickedWebDev/8-Bit-Computer

Id: 1/1 Title: Flags Register
