theWickedWebDev/8-bit-computer/PCBs/03_MODULES/CPU-ALU/ALU-Logic/alu-logic-gates-schematic.pdf

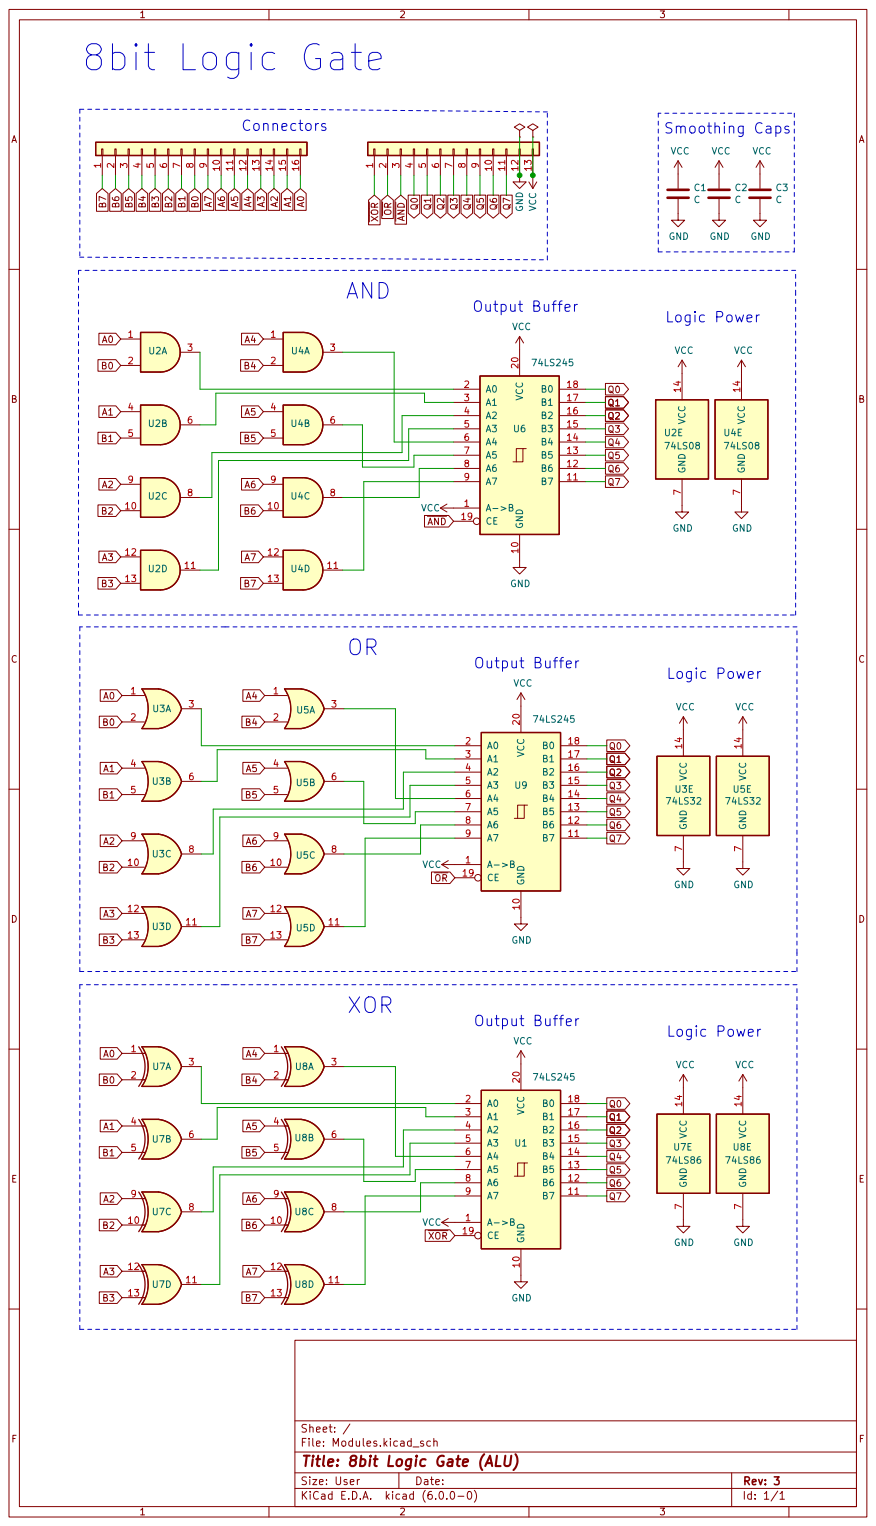
[picture p186: page 1]

File: Modules.kicad_sch Sheet: /
Id: 1/1 Title: 8bit Logic Gate (ALU)
