theWickedWebDev/8-bit-computer/PCBs/03_MODULES/CPU-ALU/ALU-Shifter/alu-shifter-schematic.pdf

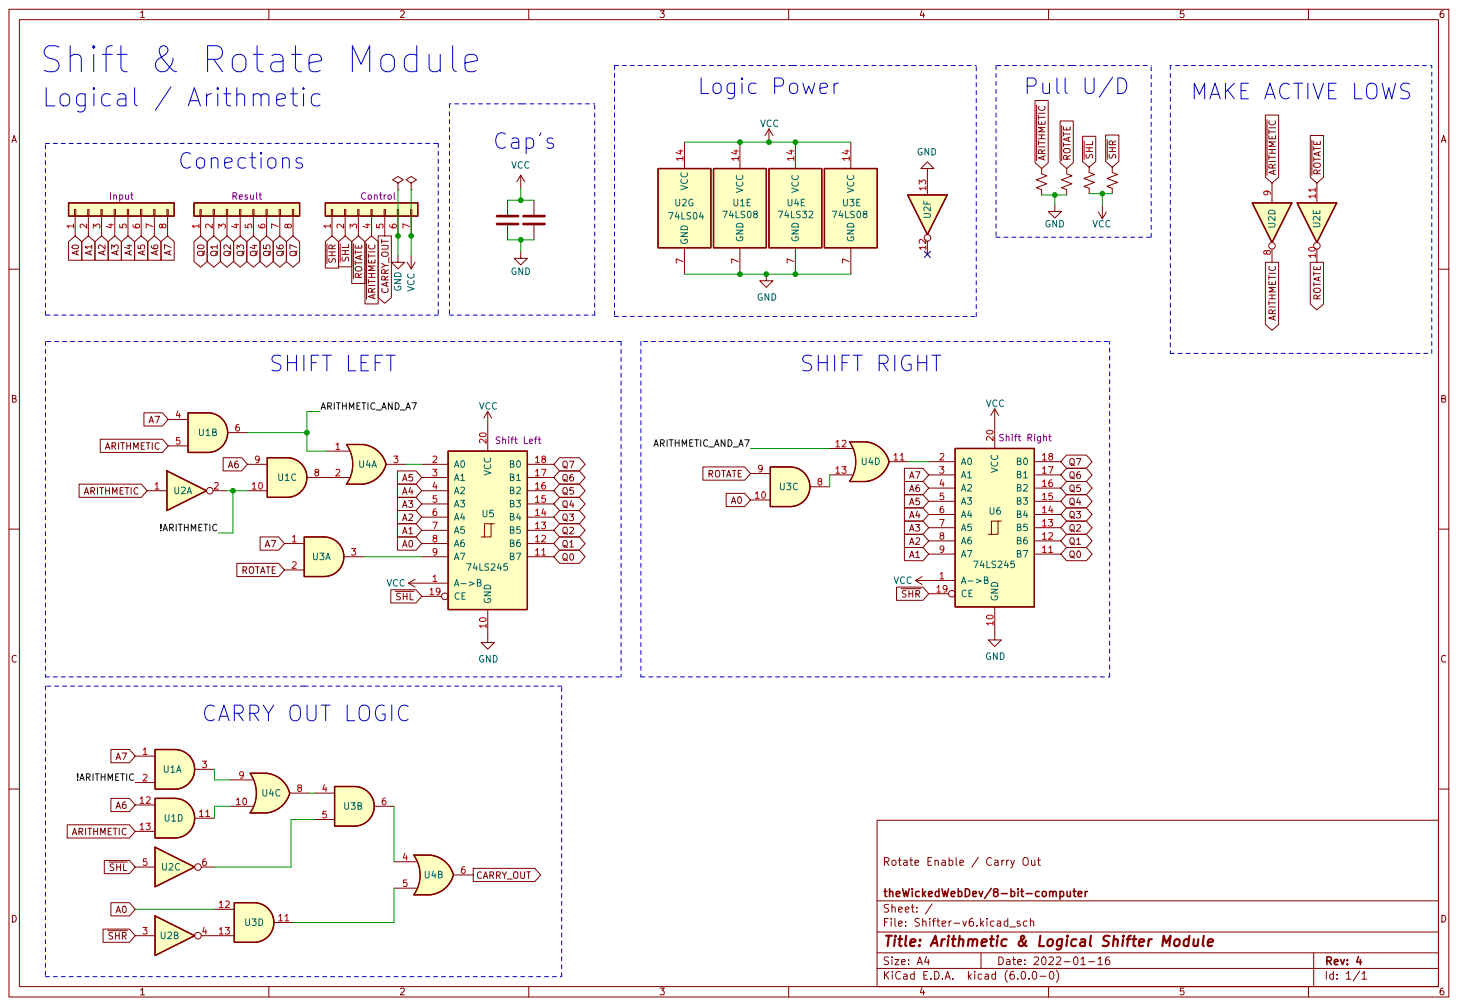
[picture p187: page 1]

8 Result 8 9 U2D 10 11 GND VCC U2E GND12 13 U2F VCC 14 GND
Conections

Rotate Enable / Carry Out

File: Shifter-v6.kicad_sch Sheet: / theWickedWebDev/8-bit-computer

Id: 1/1 Title: Arithmetic & Logical Shifter Module
