theWickedWebDev/8-bit-computer/DOCUMENTATION/00-MAIN-DOCUMENTATION.pdf

# theWickedWebDev/8-bit-computer

# Archimedes8 CPU

# USER MANUAL

V0.1

# ©2022 Archimedes8 Computer // Stephen Young stephenyoung7267@gmail.com

# General Purpose Registers & Transfer Register

# GPR Backplane

# 8bit General Purpose Registers

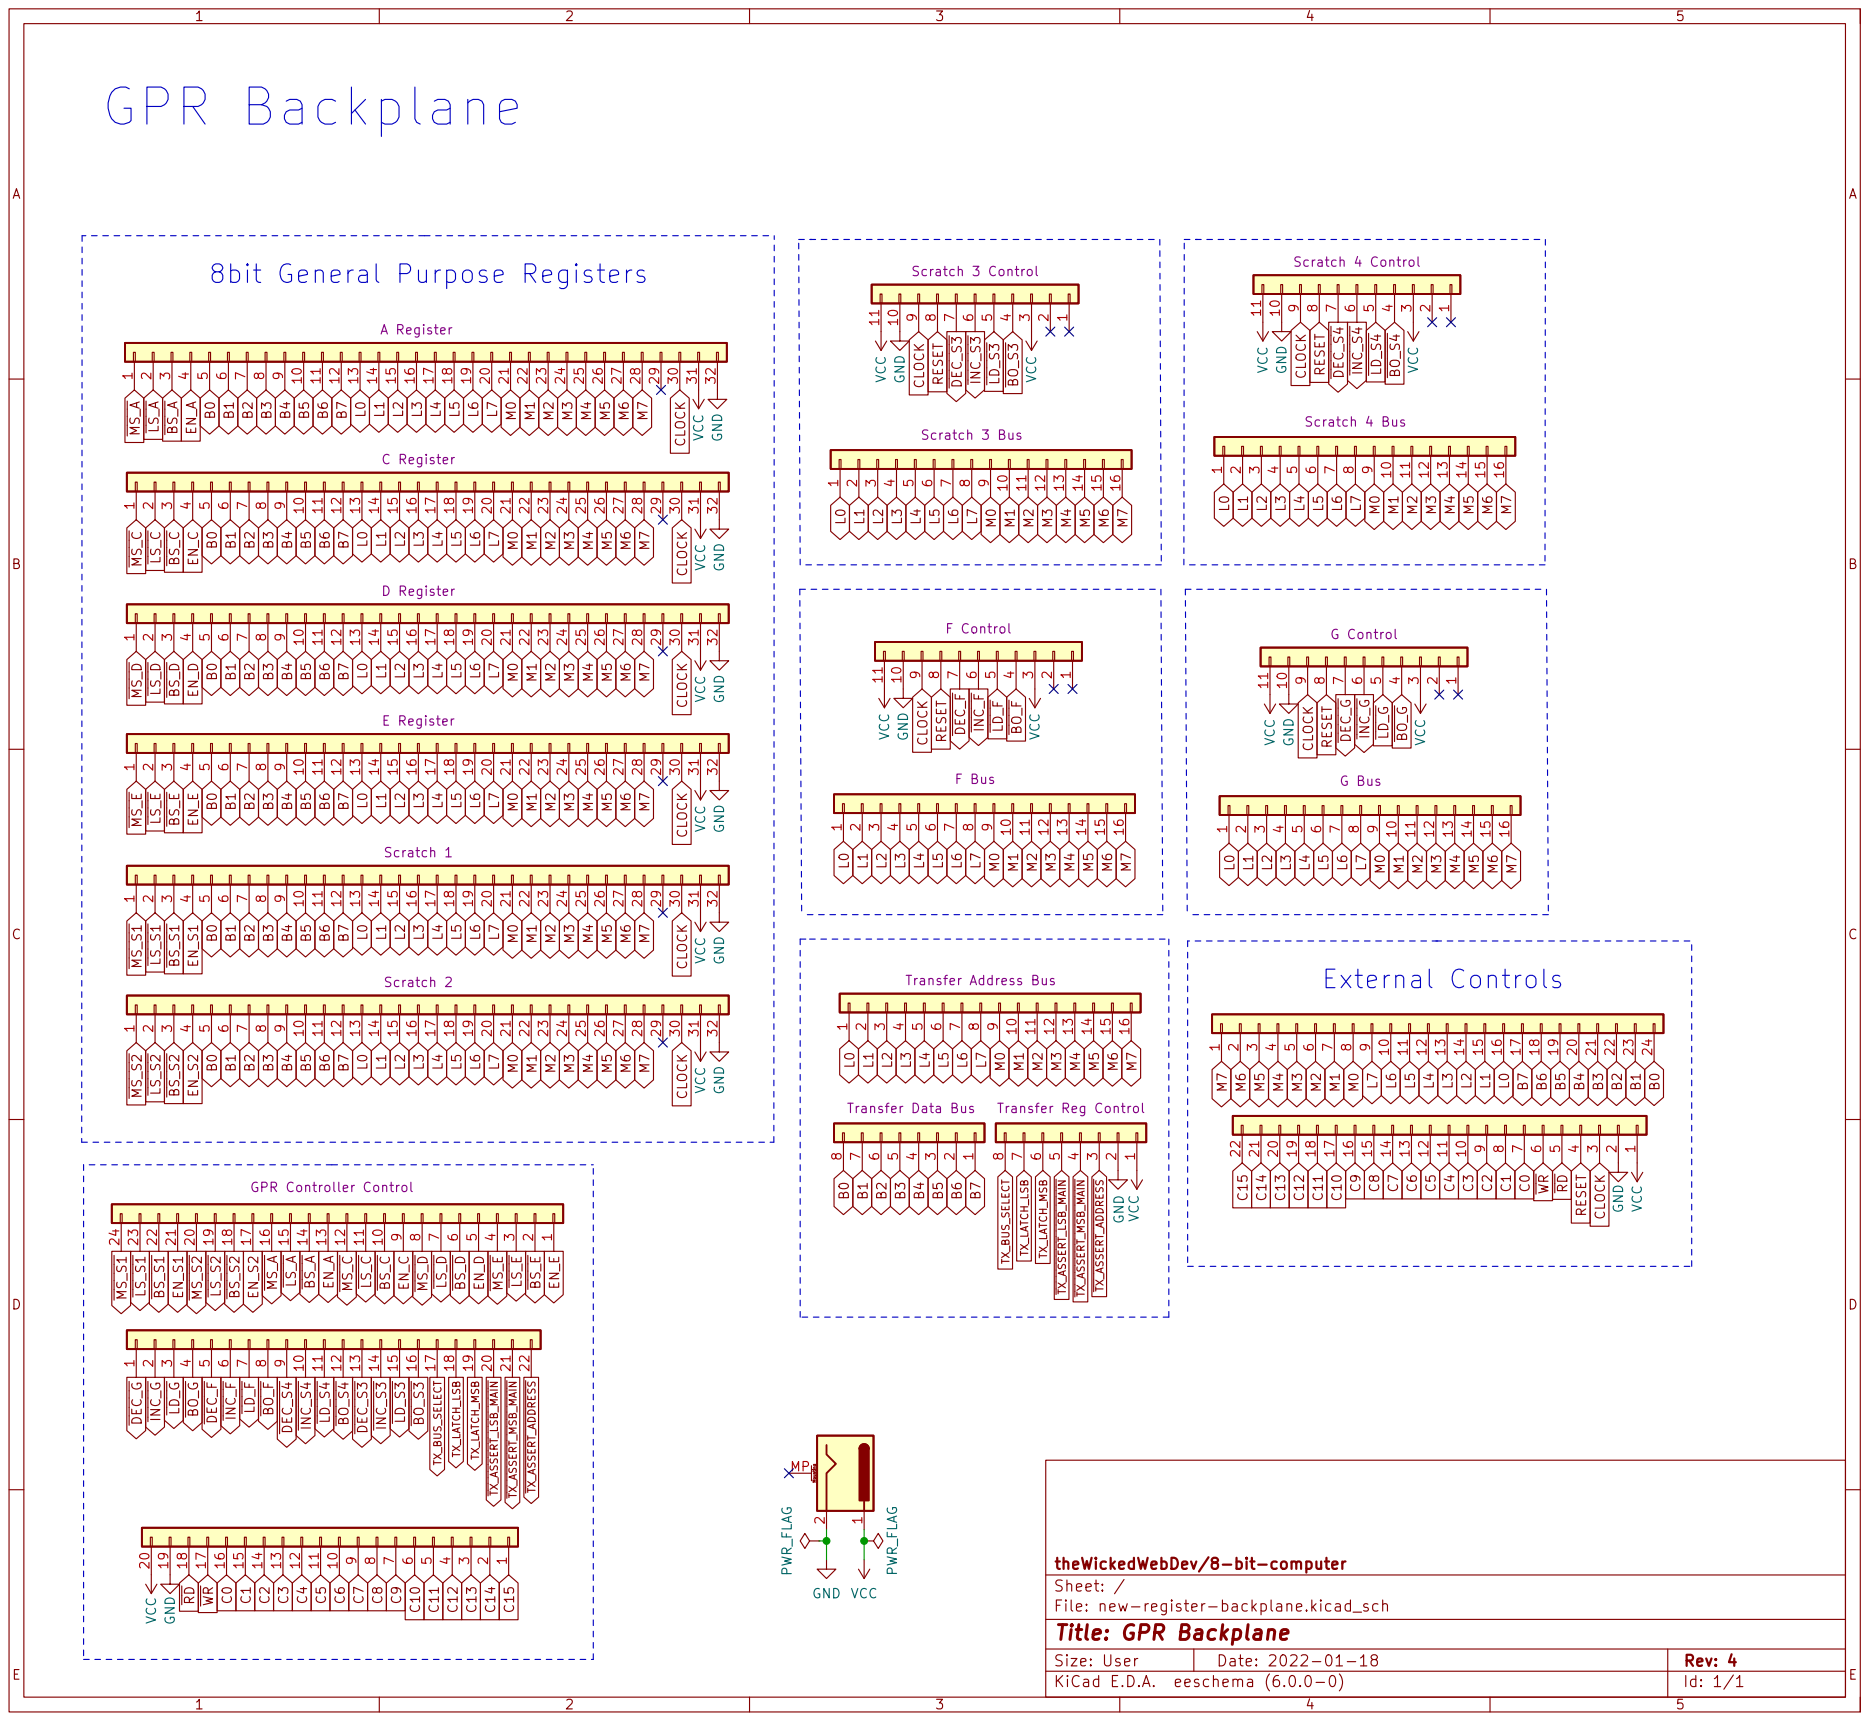
[picture p188: page 3]

theWickedWebDev/8-bit-computer
Sheet: /
File: new-register-backplane.kicad_sch
Title: GPR Backplane

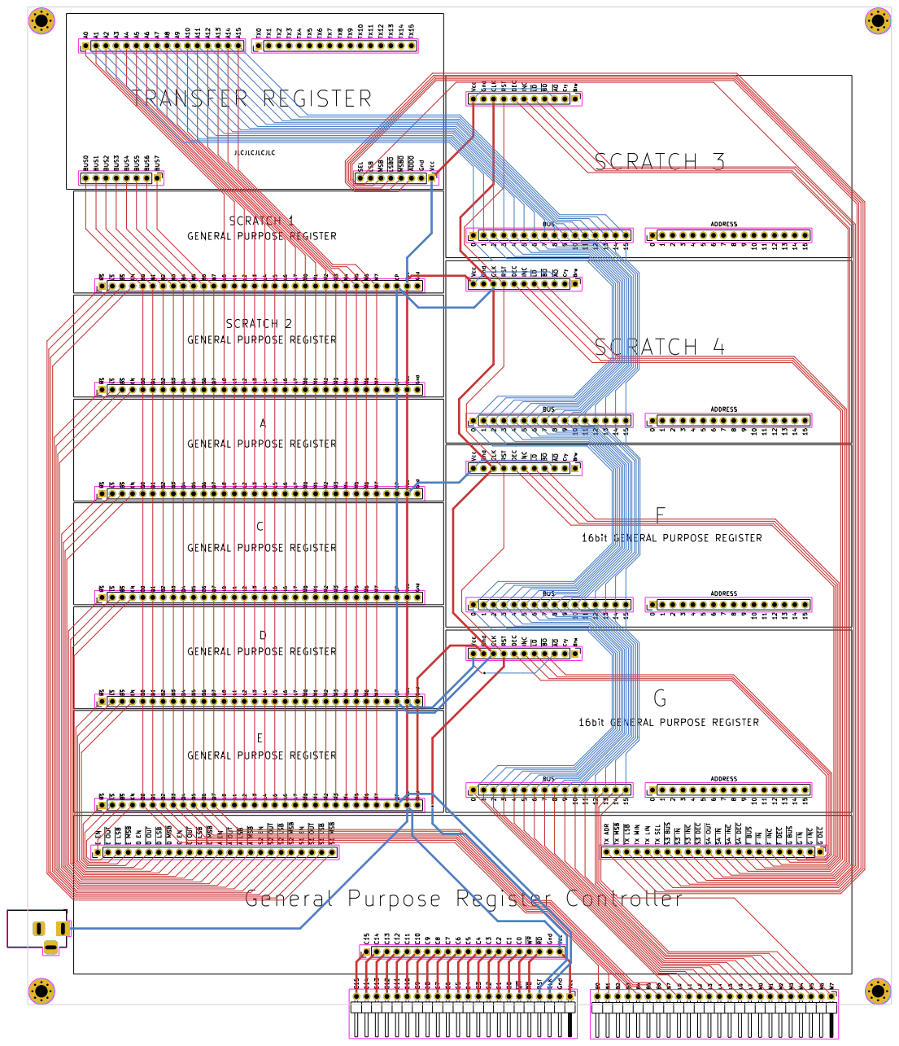
[picture p189: page 4]

# CONTROL4 ~{BO_G}

# ~{A_OUT_BUS} ~{S¹_OUT_MSB}

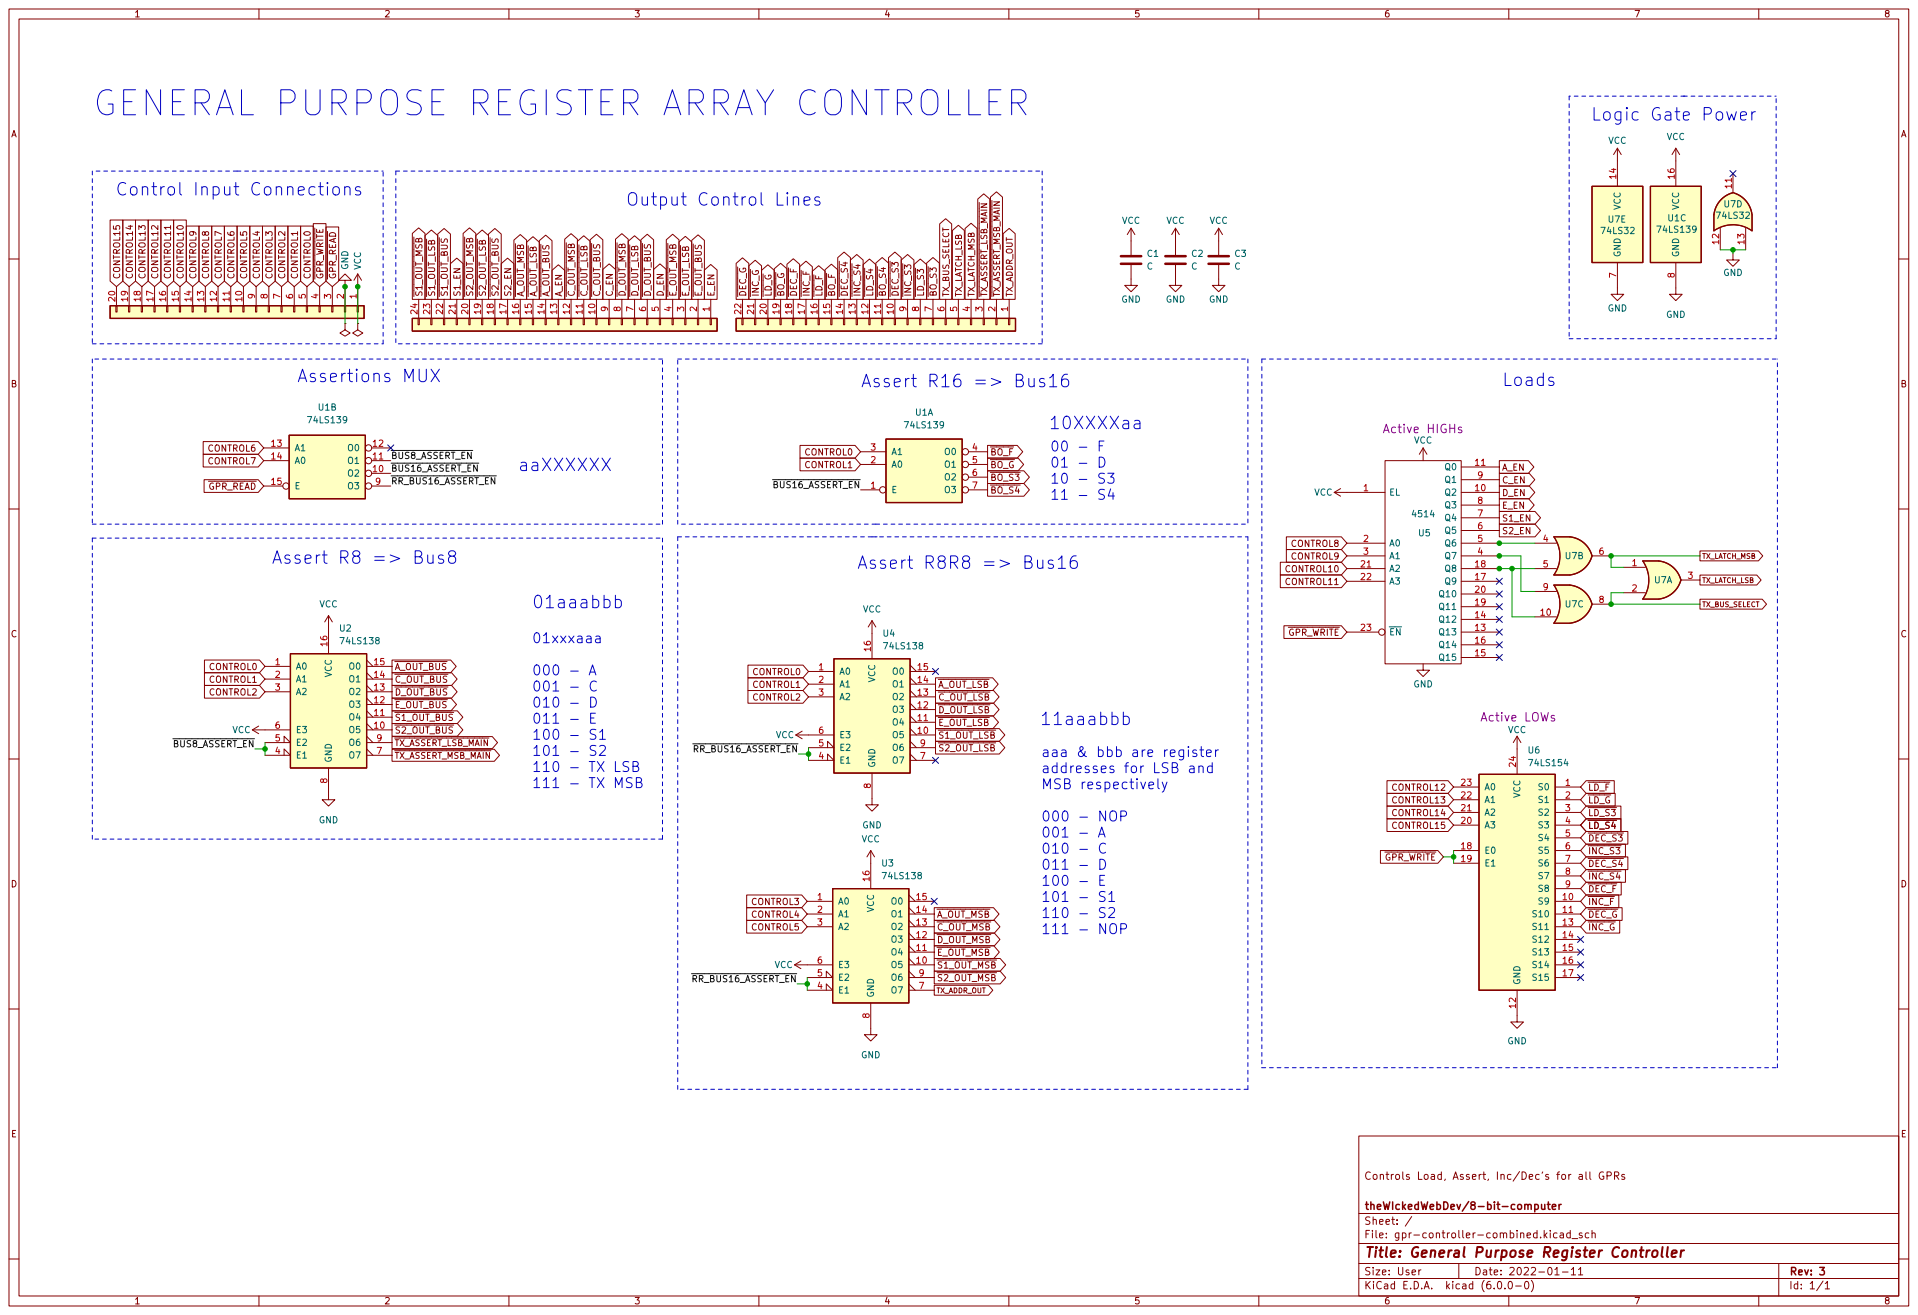
[picture p190: page 5]

GENERAL PURPOSE REGISTER ARRAY CONTROLLER

aaa & bbb are register
addresses for LSB and
MSB respectively

Controls Load, Assert, Inc/Dec's for all GPRs

theWIckedWebDev/8-bit-computer
Sheet: /
File: gpr-controller-combined.kicad_sch
Title: General Purpose Register Controller

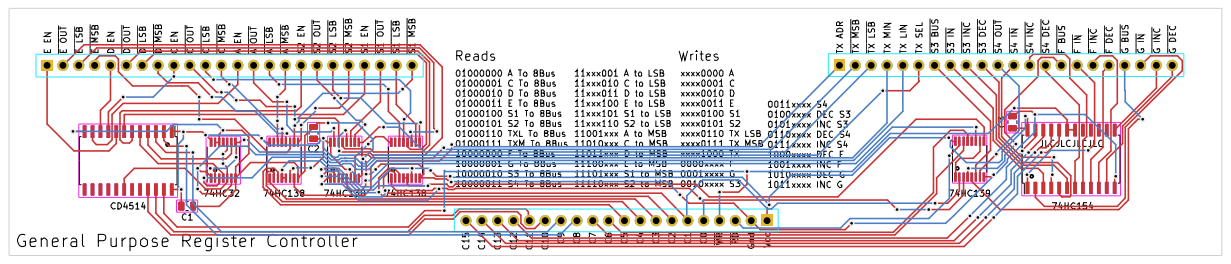
[picture p191: page 6]

B7 | 11 B6 | 12 B5 | 13 B4 | 14 B3 | 15 B2 | 16 B1 | 17 B0 | 18

# Back Plane Connection

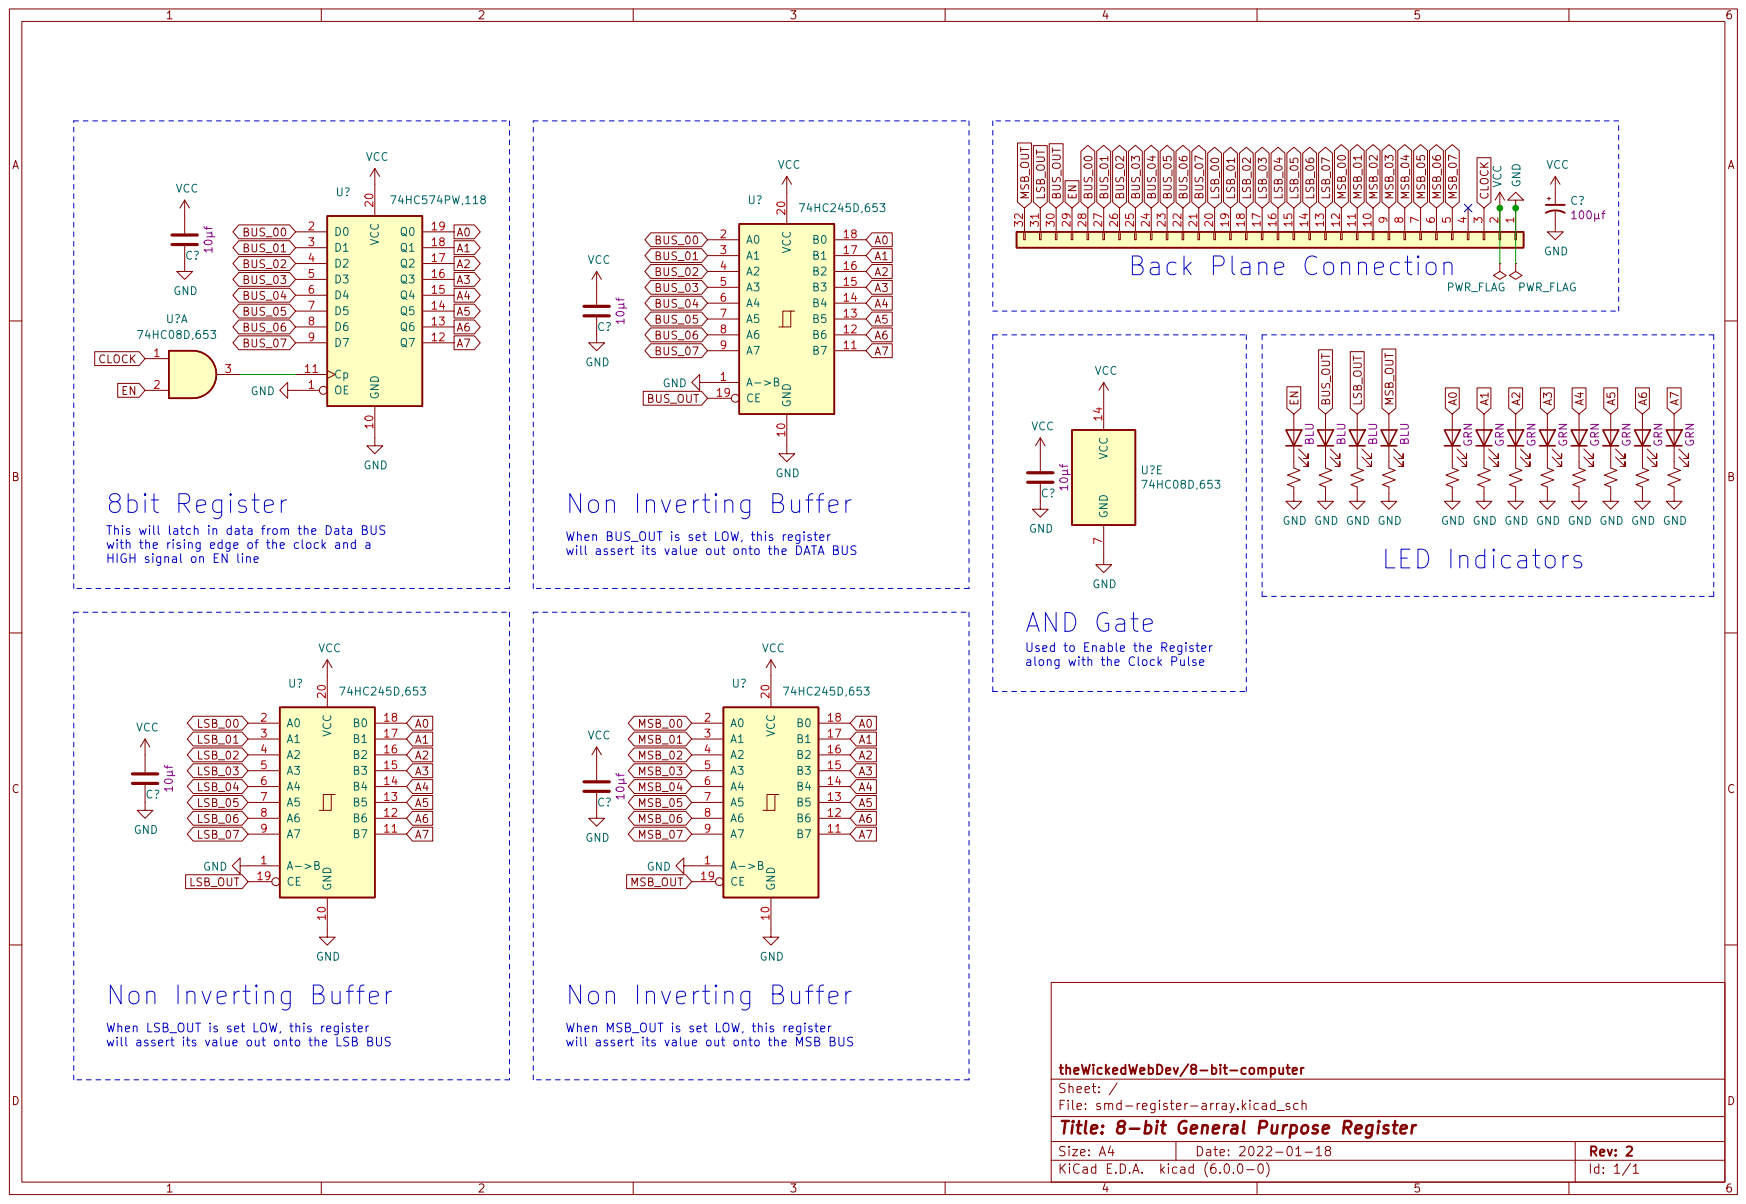
[picture p192: page 7]

This will latch in data from the Data BUS
with the rising edge of the clock and a
HIGH signal on EN line

When BUS_OUT is set LOW, this register
will assert its value out onto the DATA BUS

Used to Enable the Register
along with the Clock Pulse

When LSB_OUT is set LOW, this register
will assert its value out onto the LSB BUS

When MSB_OUT is set LOW, this register
will assert its value out onto the MSB BUS

theWickedWebDev/8-bit-computer
Sheet: /
File: smd-register-array.kicad_sch
Title: 8-bit General Purpose Register

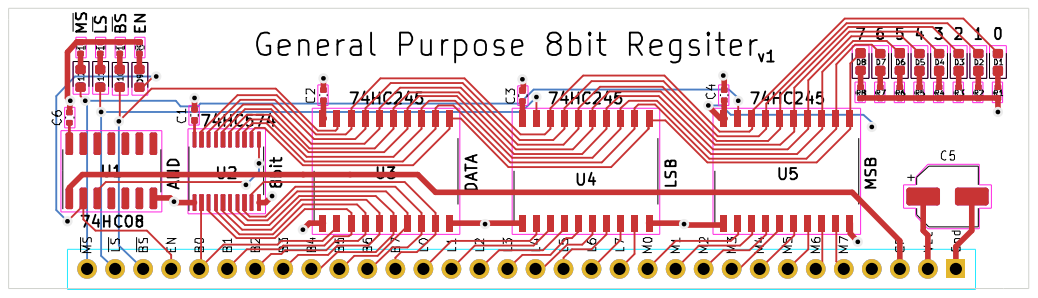
[picture p193: page 8]

# Output Buffers

## Address Bus

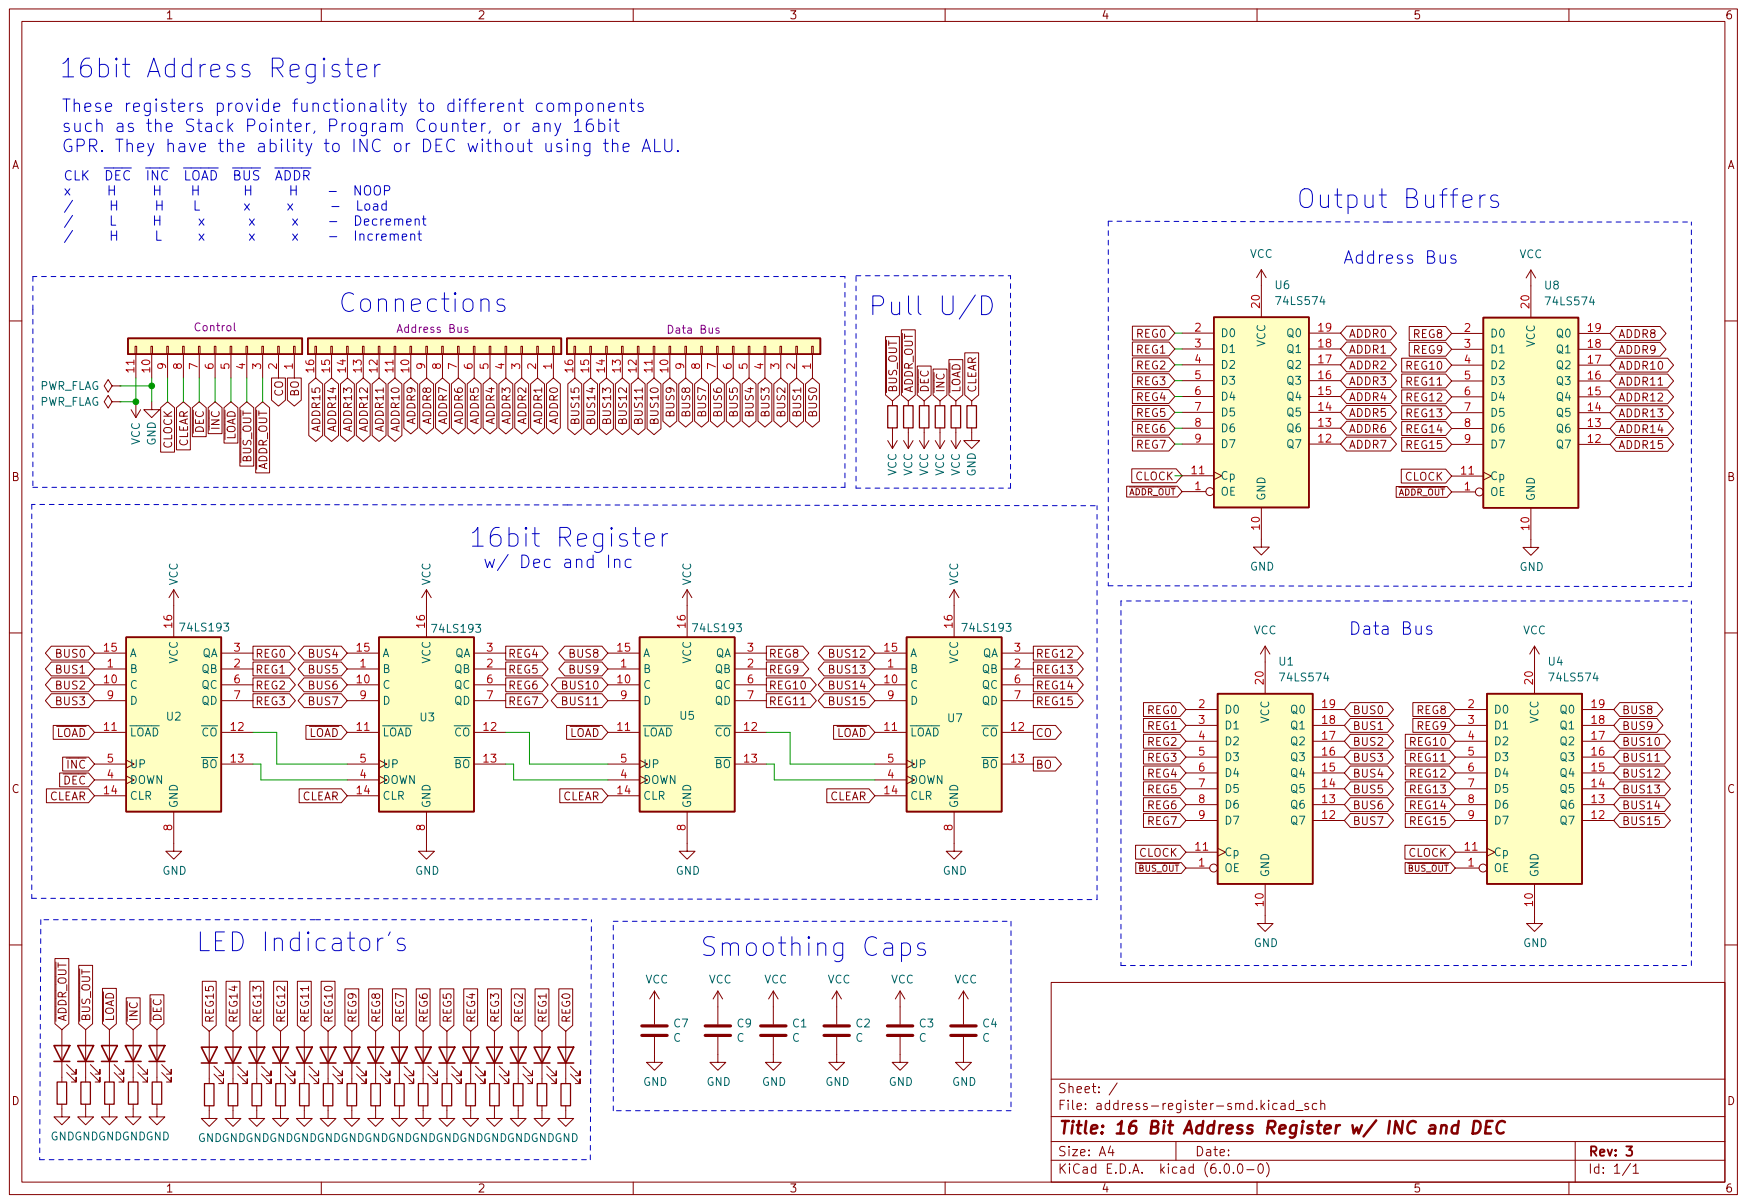
[picture p194: page 9]

These registers provide functionality to different components
such as the Stack Pointer, Program Counter, or any 16bit
GPR. They have the ability to INC or DEC without using the ALU.

Sheet: /
File: address-register-smd.kicad_sch
Title: 16 Bit Address Register w/ INC and DEC

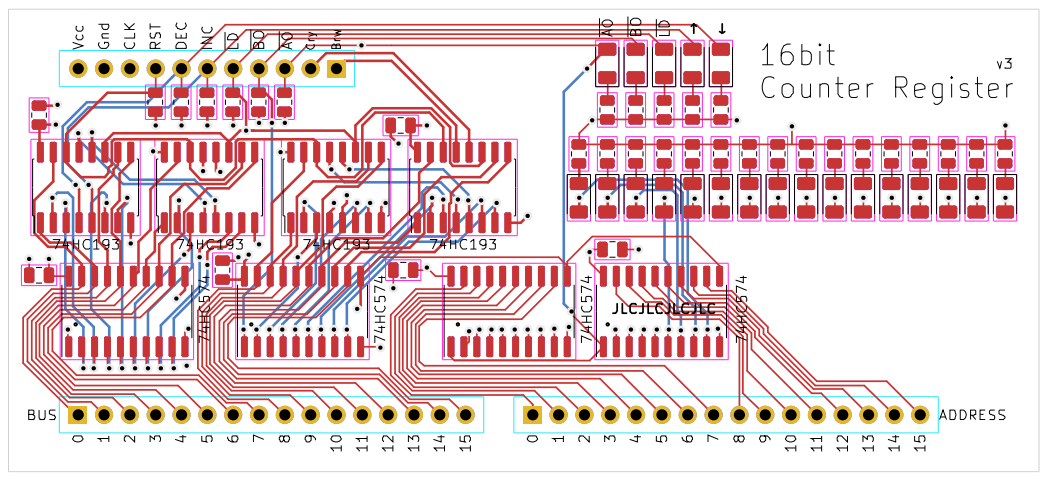
[picture p195: page 10]

# Arithmetic Logic Unit (ALU)

# & Flags Register

# Control Bus

Accumulator (A) | Operand (B)

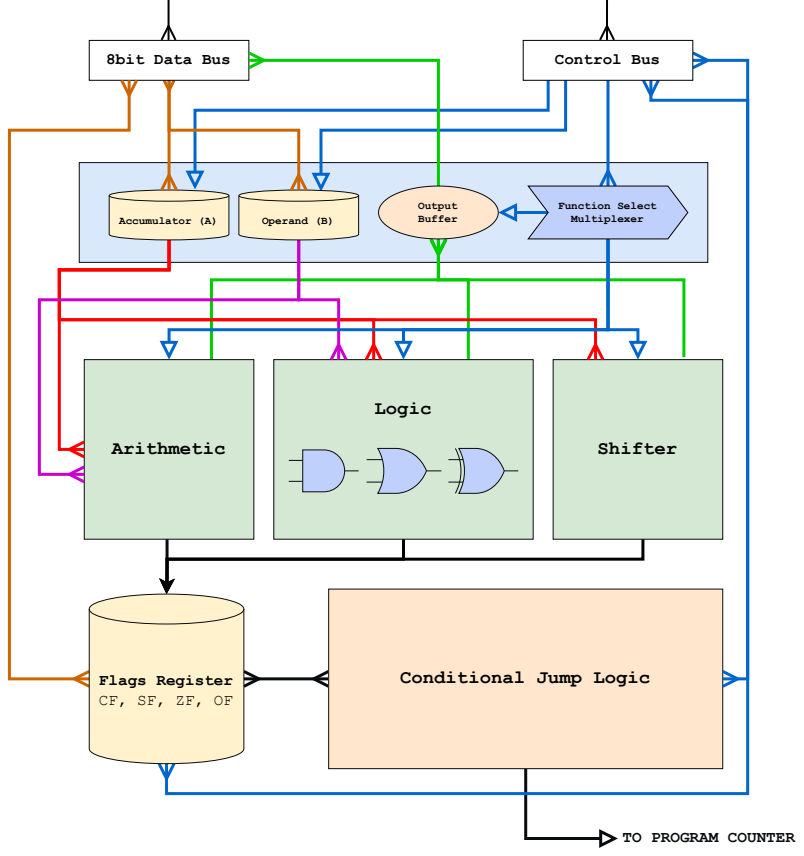
[picture p196: page 12]
Arithmetic; Shifter; Logic; Function Select Multiplexer; 8bit Data Bus; Output Buffer

Conditional Jump Logic

Flags Register

TO PROGRAM COUNTER

# Arithmetic Logic Unit and Conditional Jump

# TRUTH TABLE

A* | ADD | ADC | SUB | SBB | INC | DEC | AND | OR | XOR | SHL | SHR | ASL | ASR | ROR | ROL | CMP | TEST | NAND | NOR | XNOR | NOT A
AI | L | _/ | _/ | _/ | _/ | _/ | _/ | _/ | _/ | _/ | _/ | _/ | _/ | _/ | _/ | _/ | _/ | _/ | _/ | _/ | _/ | _/ | _/
BI | L | _/ | _/ | _/ | _/ | _/ | _/ | _/ | _/ | _/ | _/ | _/ | _/ | _/ | _/ | _/ | _/ | _/ | _/ | _/ | _/ | _/ | _/
FLAG_IN | L | 0 | 0 | 0 | 0 | 0 | 0 | 0 | 0 | 0 | 0 | 0 | 0 | 0 | 0 | 0 | 0 | 1 | 1 | 0 | 0 | 0 | 0
ALU F0 | | 0 | 1 | 0 | 1 | 0 | 1 | 0 | 1 | 0 | 1 | 0 | 1 | 0 | 1 | 0 | 1 | 1 | 1 | 1 | 0 | 1 | 0
ALU F1 | | 0 | 0 | 1 | 1 | 0 | 0 | 1 | 1 | 0 | 0 | 1 | 1 | 0 | 0 | 1 | 1 | 1 | 1 | 1 | 0 | 0 | 0
ALU F2 | | 0 | 0 | 0 | 0 | 1 | 1 | 1 | 1 | 0 | 0 | 0 | 0 | 1 | 1 | 1 | 1 | 0 | 1 | 1 | 0 | 0 | 0
ALU F3 | | 0 | 0 | 0 | 0 | 0 | 0 | 0 | 0 | 1 | 1 | 1 | 1 | 1 | 1 | 1 | 1 | 0 | 0 | 0 | 1 | 1 | 0
(Invert Output) F4 | | 0 | 0 | 0 | 0 | 0 | 0 | 0 | 0 | 0 | 0 | 0 | 0 | 0 | 0 | 0 | 0 | 0 | 0 | 1 | 1 | 1 | 0
(Enable ALU) F5 | | 1 | 1 | 1 | 1 | 1 | 1 | 1 | 1 | 1 | 1 | 1 | 1 | 1 | 1 | 1 | 1 | 1 | 1 | 1 | 1 | 1 | 1
NOP | JP | JLE | JG | JGE | JL | JA | JBE | JNB | JB | JNE | JE | JNS | JS | JNO | JO
| | JNG | JNLE | JNL | JNGE | JNBE | JNA | JAE | JNAE | JNZ | JZ
| | | | | | | | JNC | JC
JCC_EN | L | 1 | 0 | 0 | 0 | 0 | 0 | 0 | 0 | 0 | 0 | 0 | 0 | 0 | 0 | 0 | 0
JCC_ADD3 | | x | 0 | 1 | 0 | 1 | 0 | 1 | 0 | 1 | 0 | 1 | 0 | 1 | 0 | 1 | 0
JCC_ADD2 | | x | 0 | 0 | 1 | 1 | 0 | 0 | 1 | 1 | 0 | 0 | 1 | 1 | 0 | 0 | 1
JCC_ADD1 | | x | 0 | 0 | 0 | 0 | 1 | 1 | 1 | 1 | 0 | 0 | 0 | 0 | 1 | 1 | 1
JCC_ADD0 | | x | 0 | 0 | 0 | 0 | 0 | 0 | 0 | 0 | 1 | 1 | 1 | 1 | 1 | 1 | 1
PUSH FLG* | PUSH FLG*
FLAG_OUT | L | L | L
RESTORE_FLAGS | H | L | H

# ALU Backplane

# External Connections

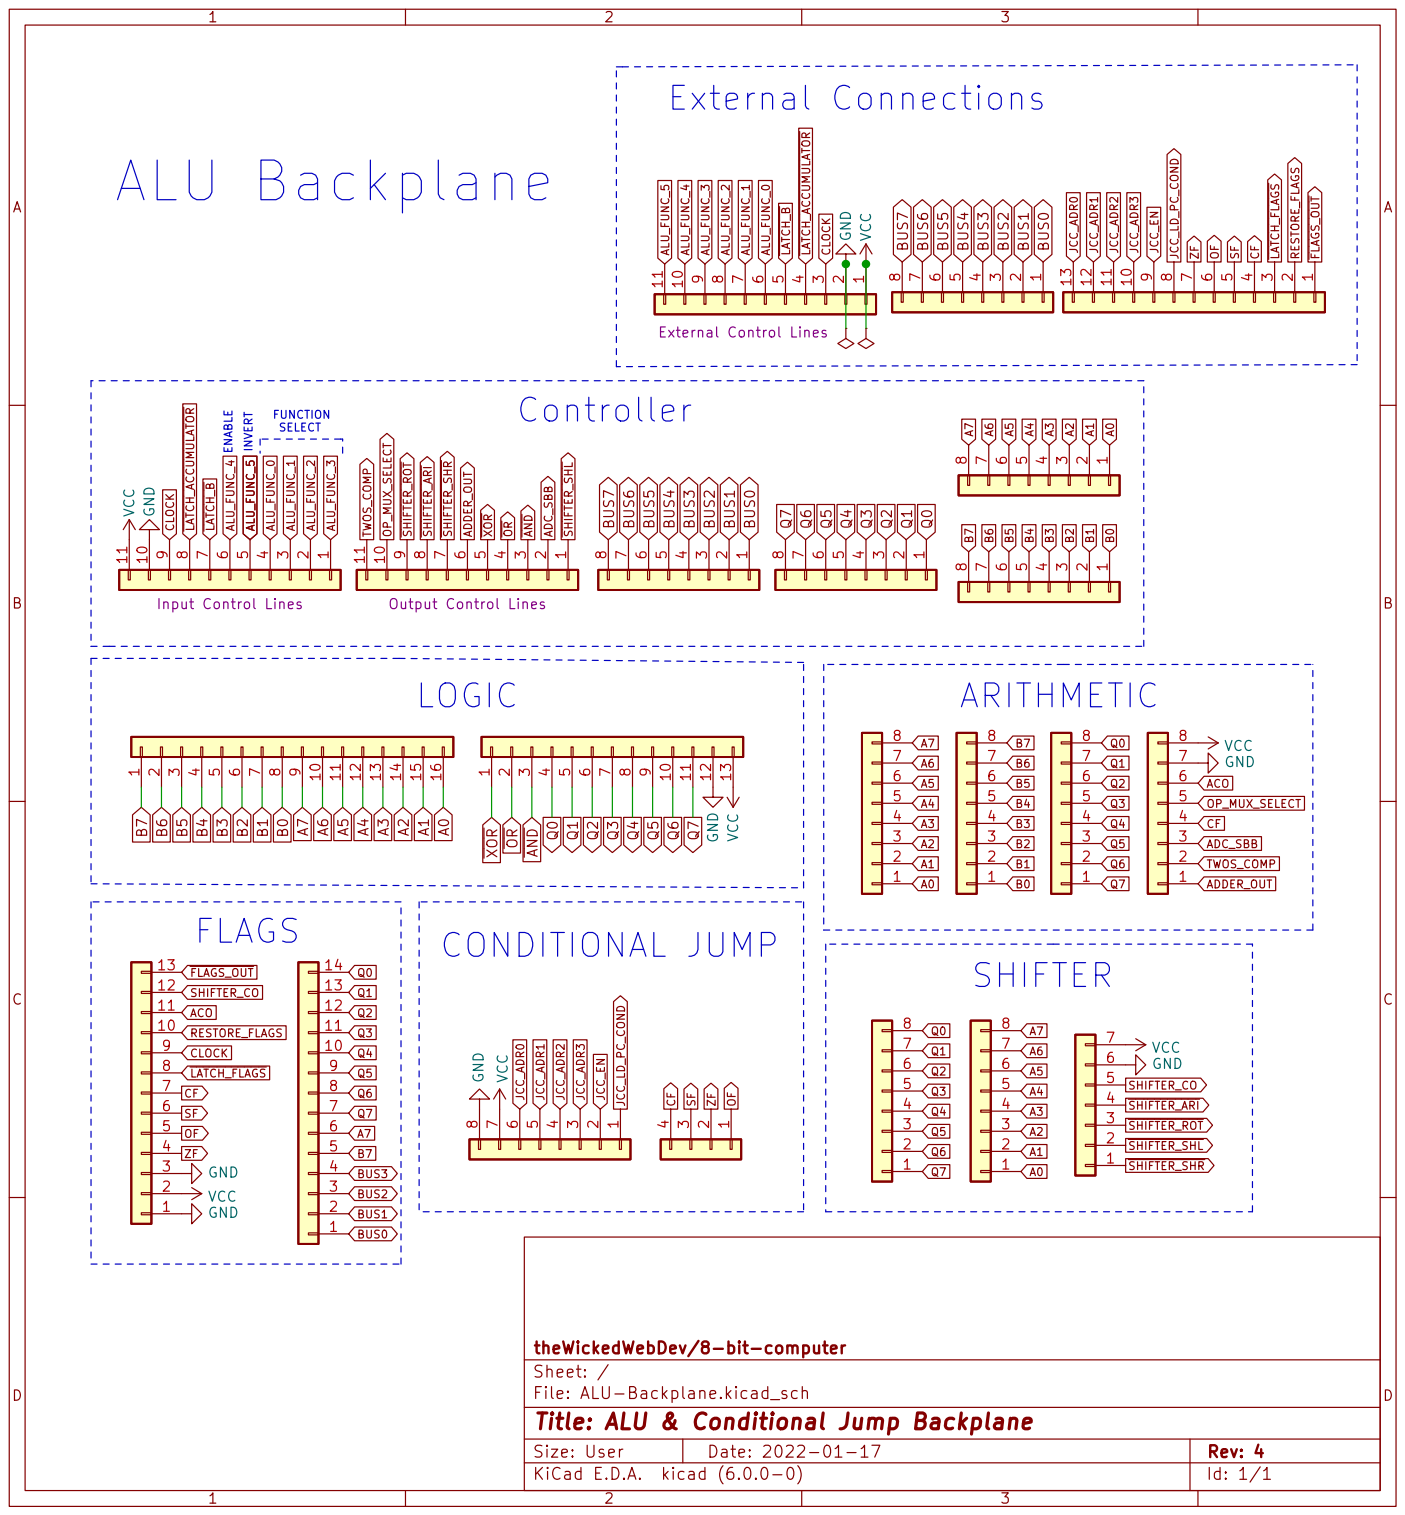
[picture p197: page 14]

theWickedWebDev/8-bit-computer
Sheet: /
File: ALU-Backplane.kicad_sch
Title: ALU & Conditional Jump Backplane

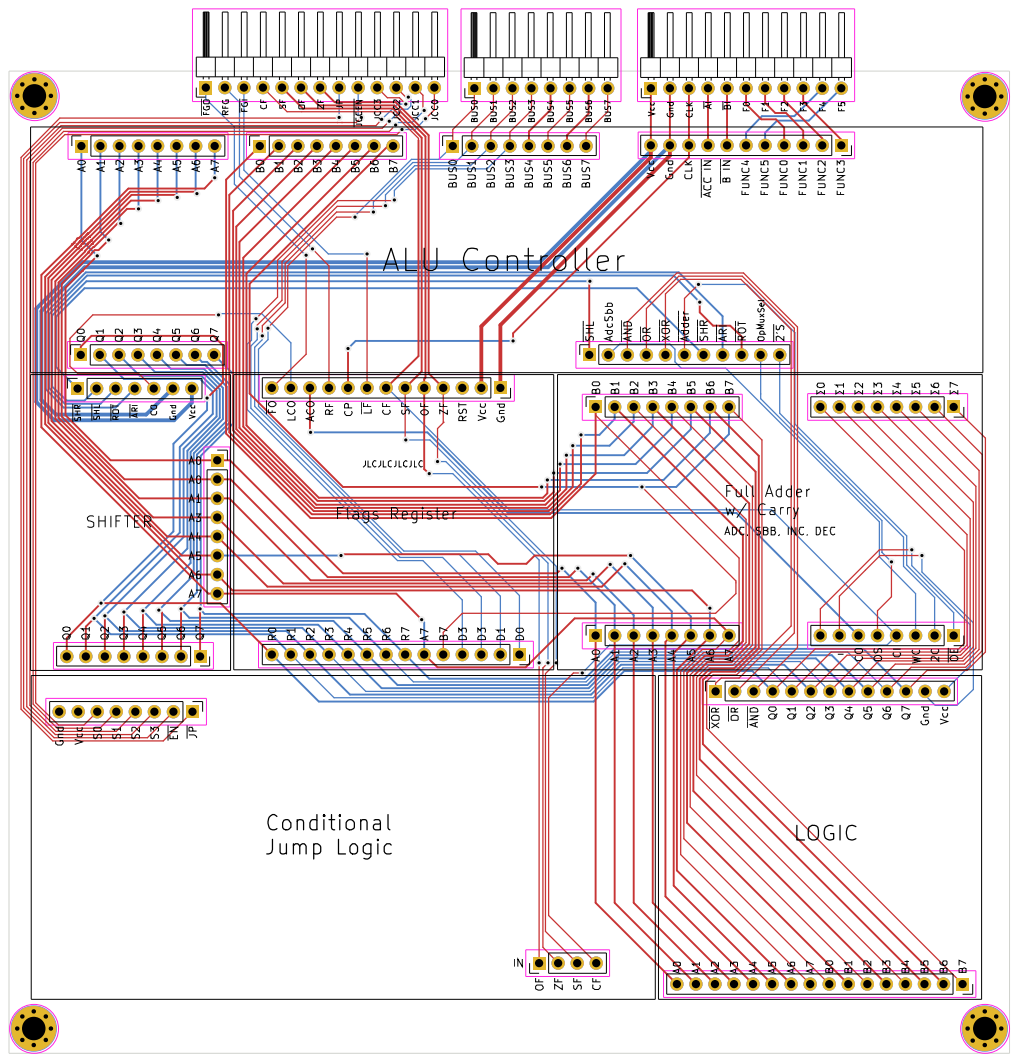
[picture p198: page 15]

# Connections

# OPERAND (B)

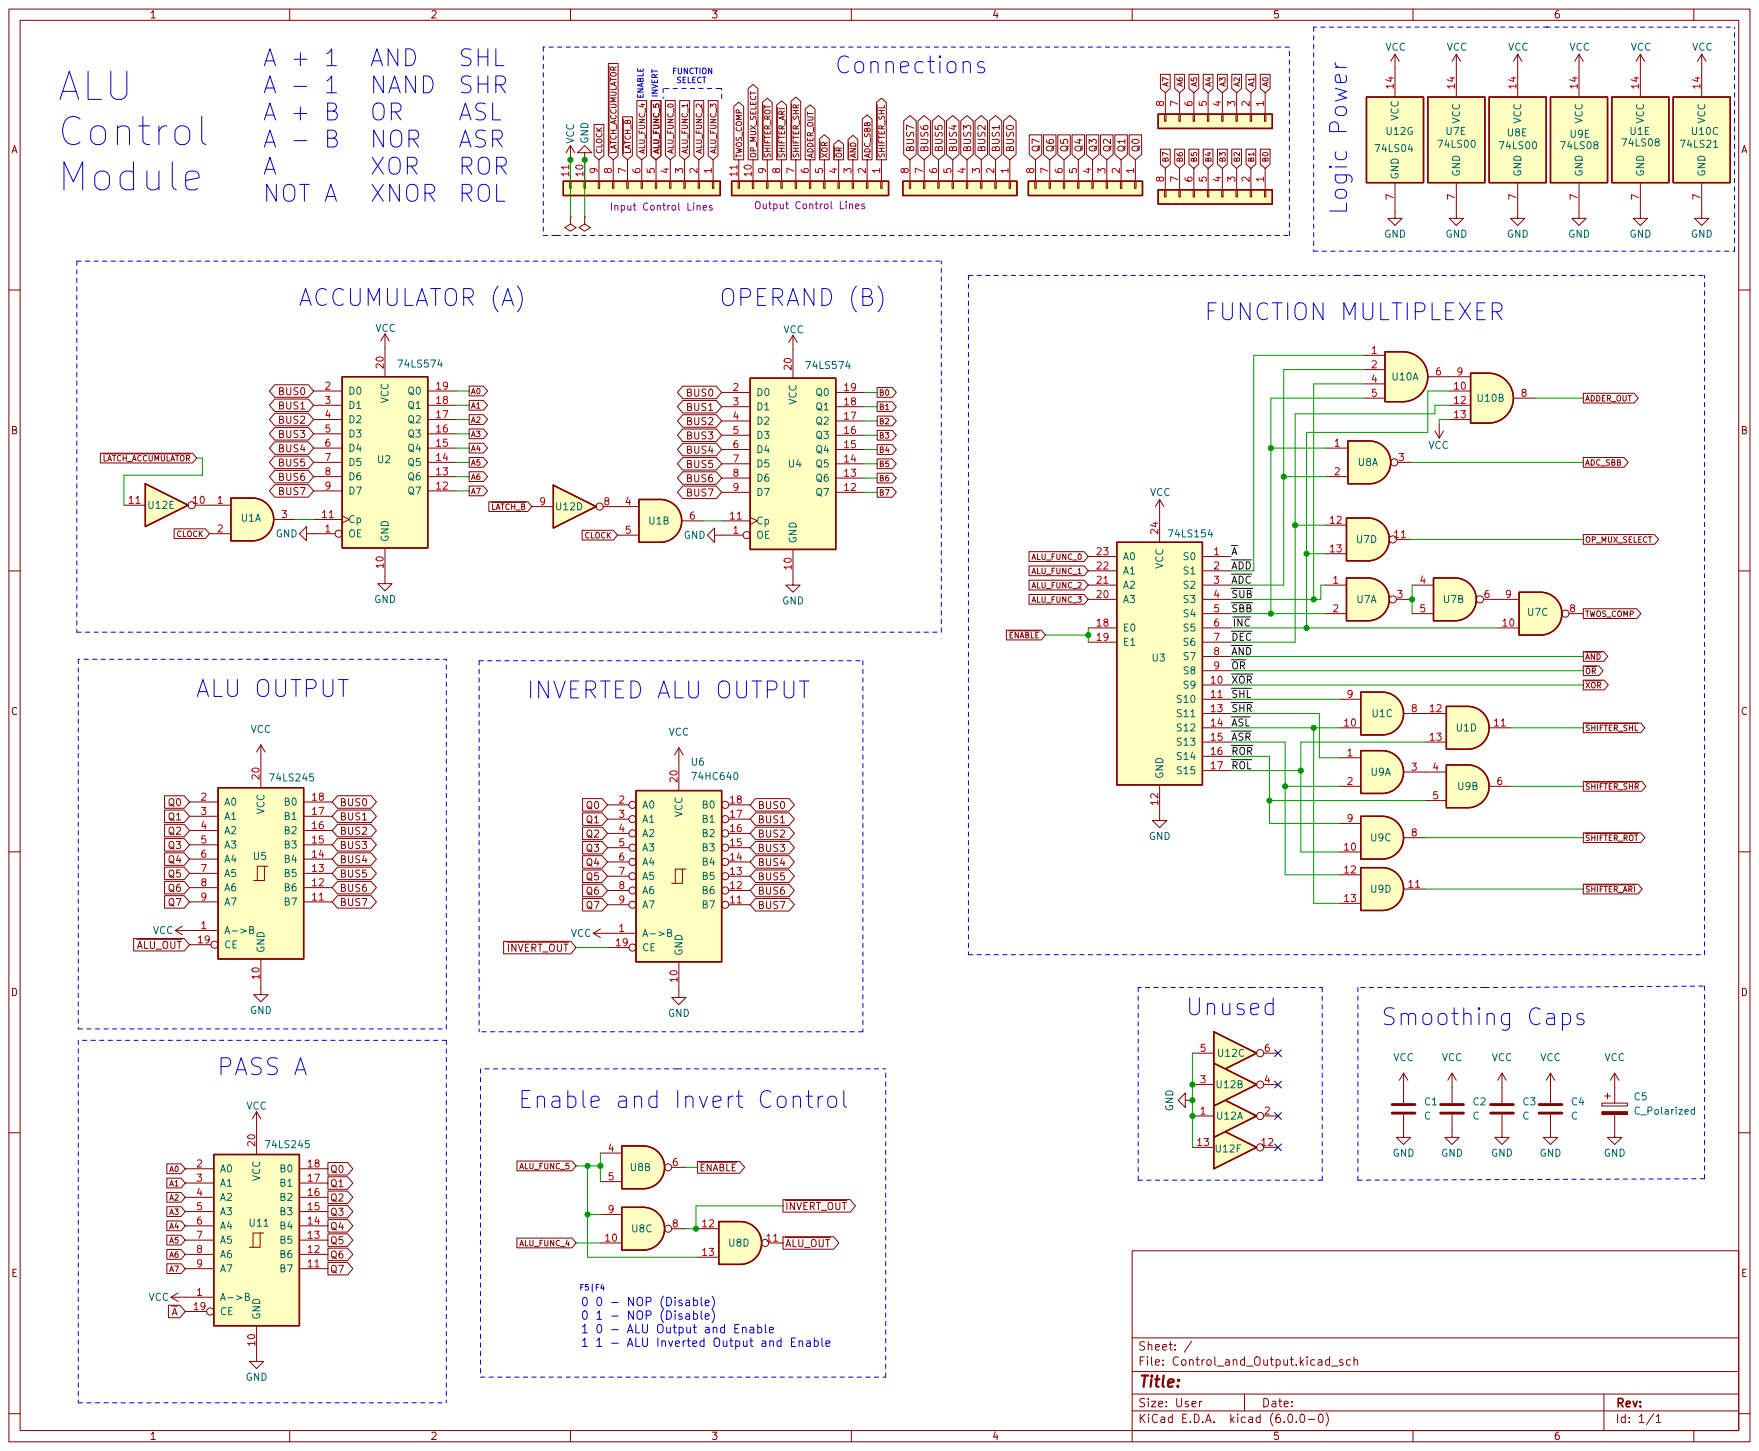
[picture p199: page 16]

Enable and Invert Control

0 0 - NOP (Disable)
0 1 - NOP (Disable)
1 0 - ALU Output and Enable
1 1 - ALU Inverted Output and Enable

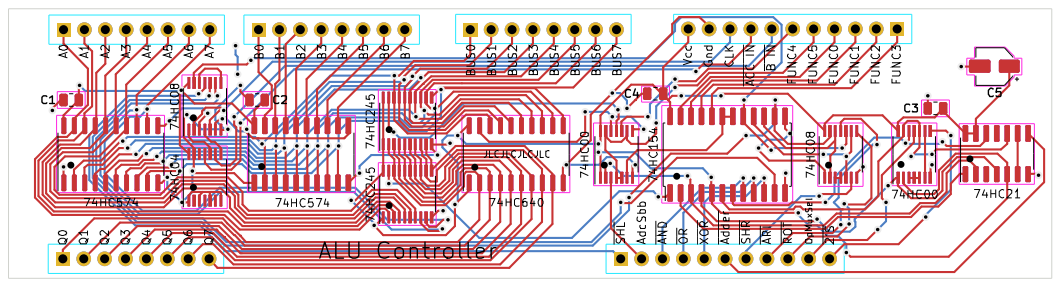
[picture p200: page 17]

## Smoothing Caps

Connectors | Arithmetic Carry In Logic

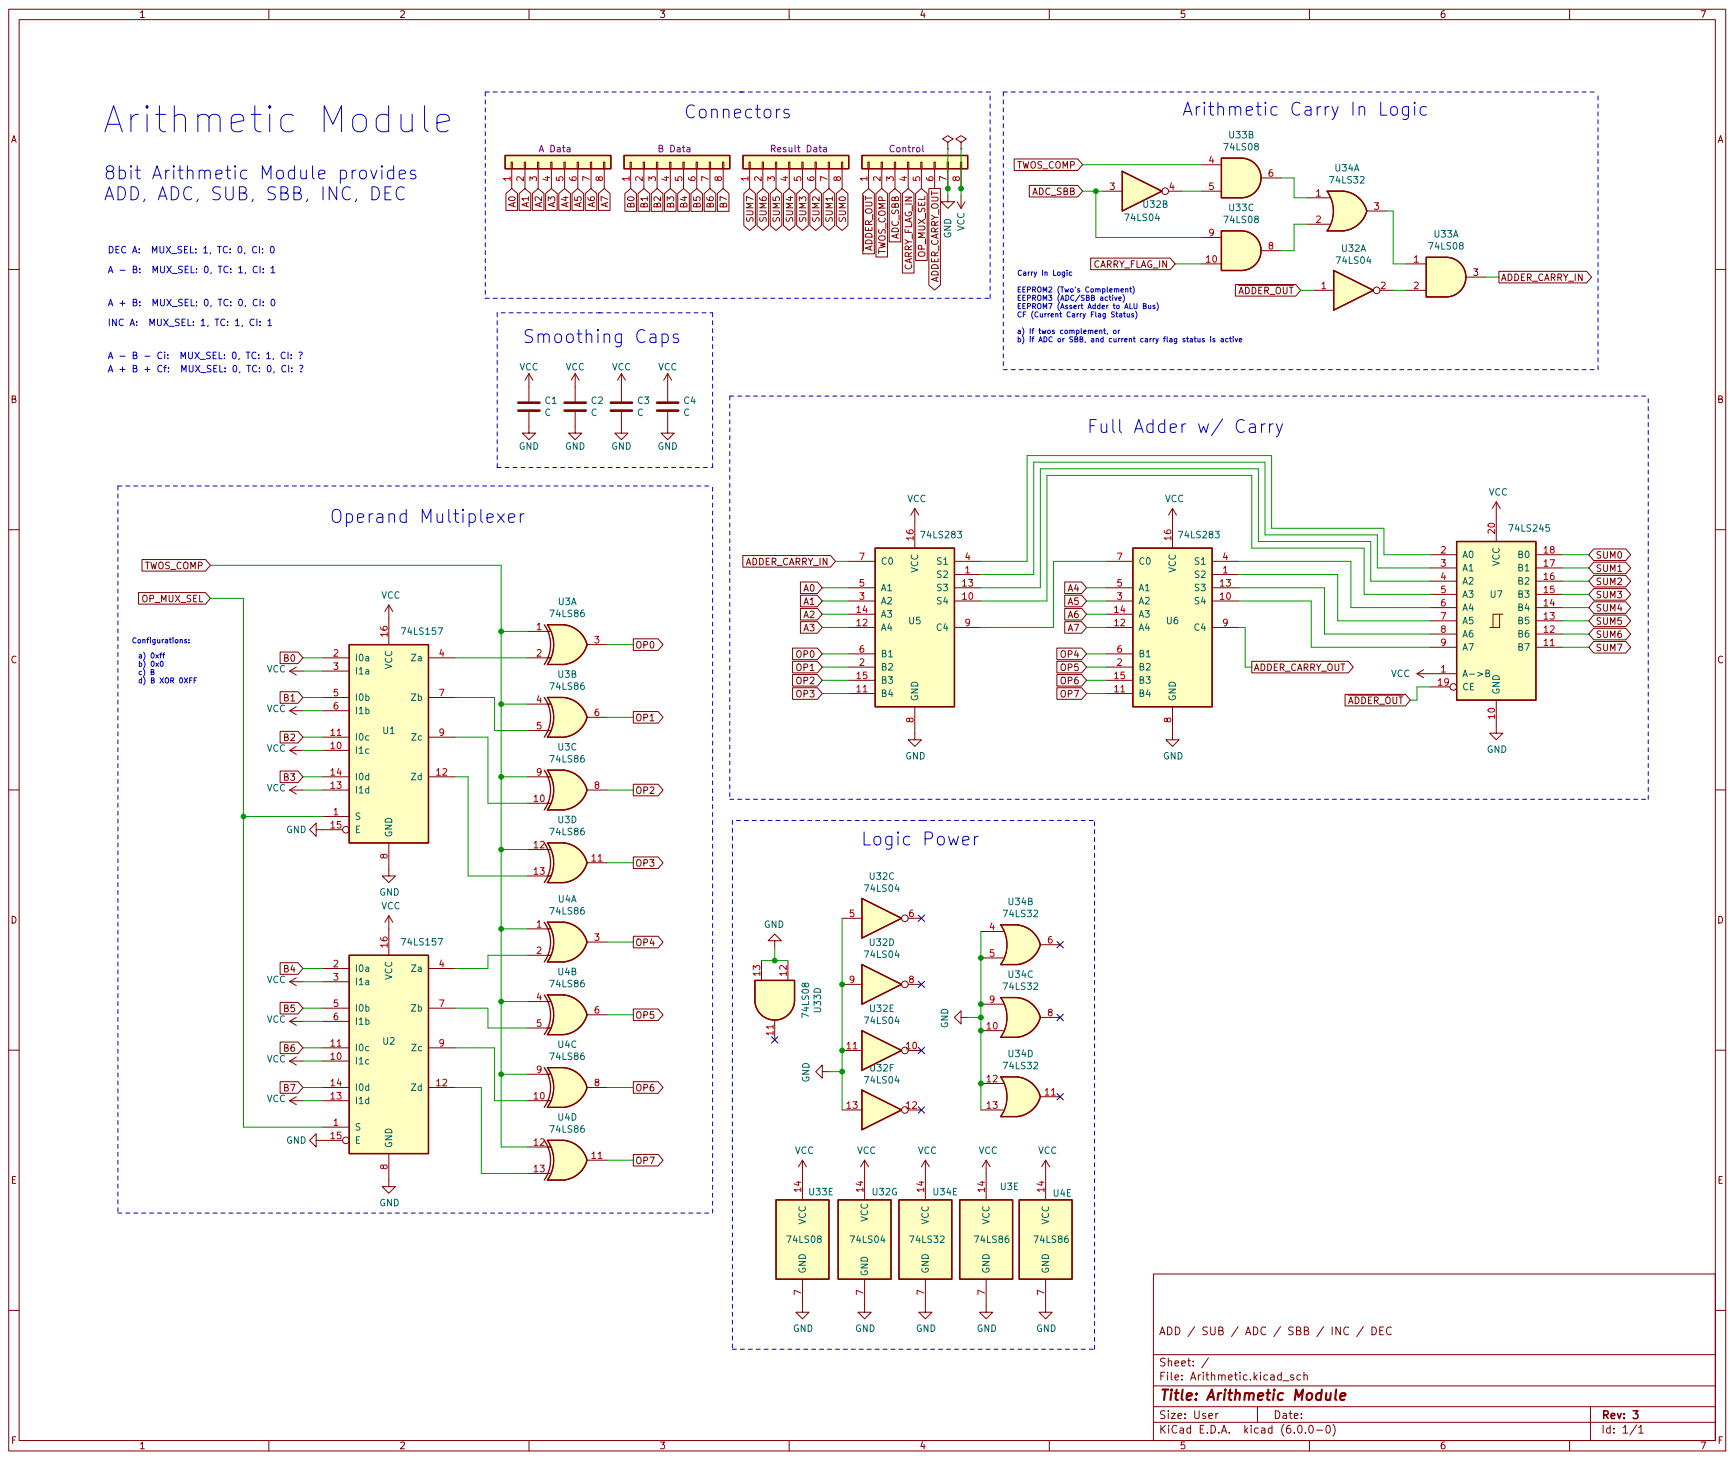
[picture p201: page 18]

8bit Arithmetic Module provides
ADD, ADC, SUB, SBB, INC, DEC

EEPROM3 (ADC/SBB active)
EEPROM7 (Assert Adder to ALU Bus)
CF (Current Carry Flag Status)

a) If twos complement, or
b) if ADC or SBB, and current carry flag status is active

ADD / SUB / ADC / SBB / INC / DEC

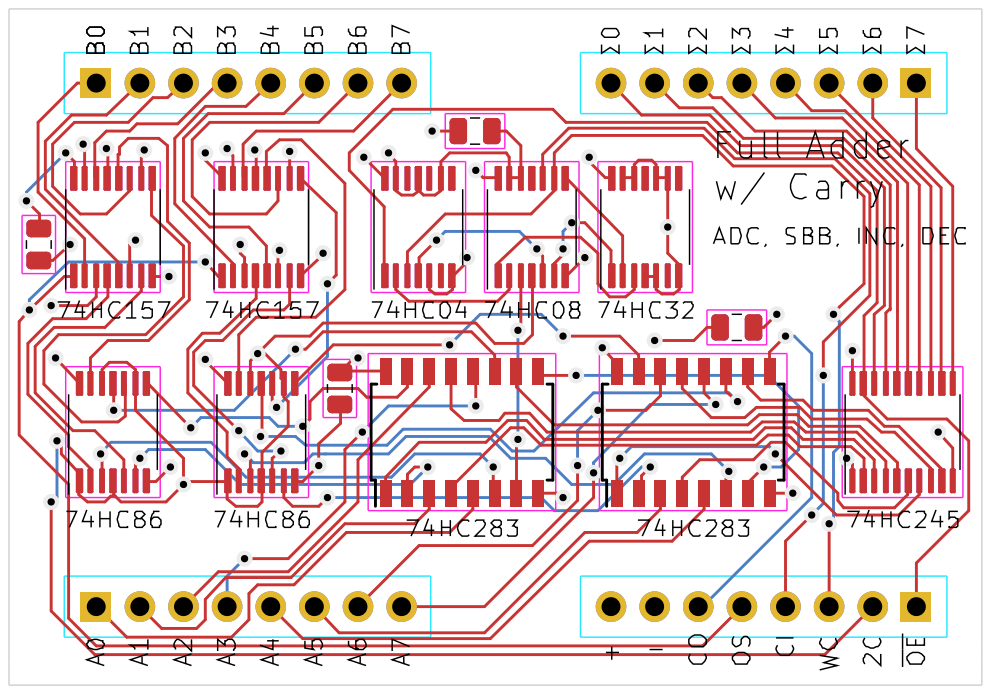
[picture p202: page 19]

Logic Power | MAKE ACTIVE LOWS

# Cap's

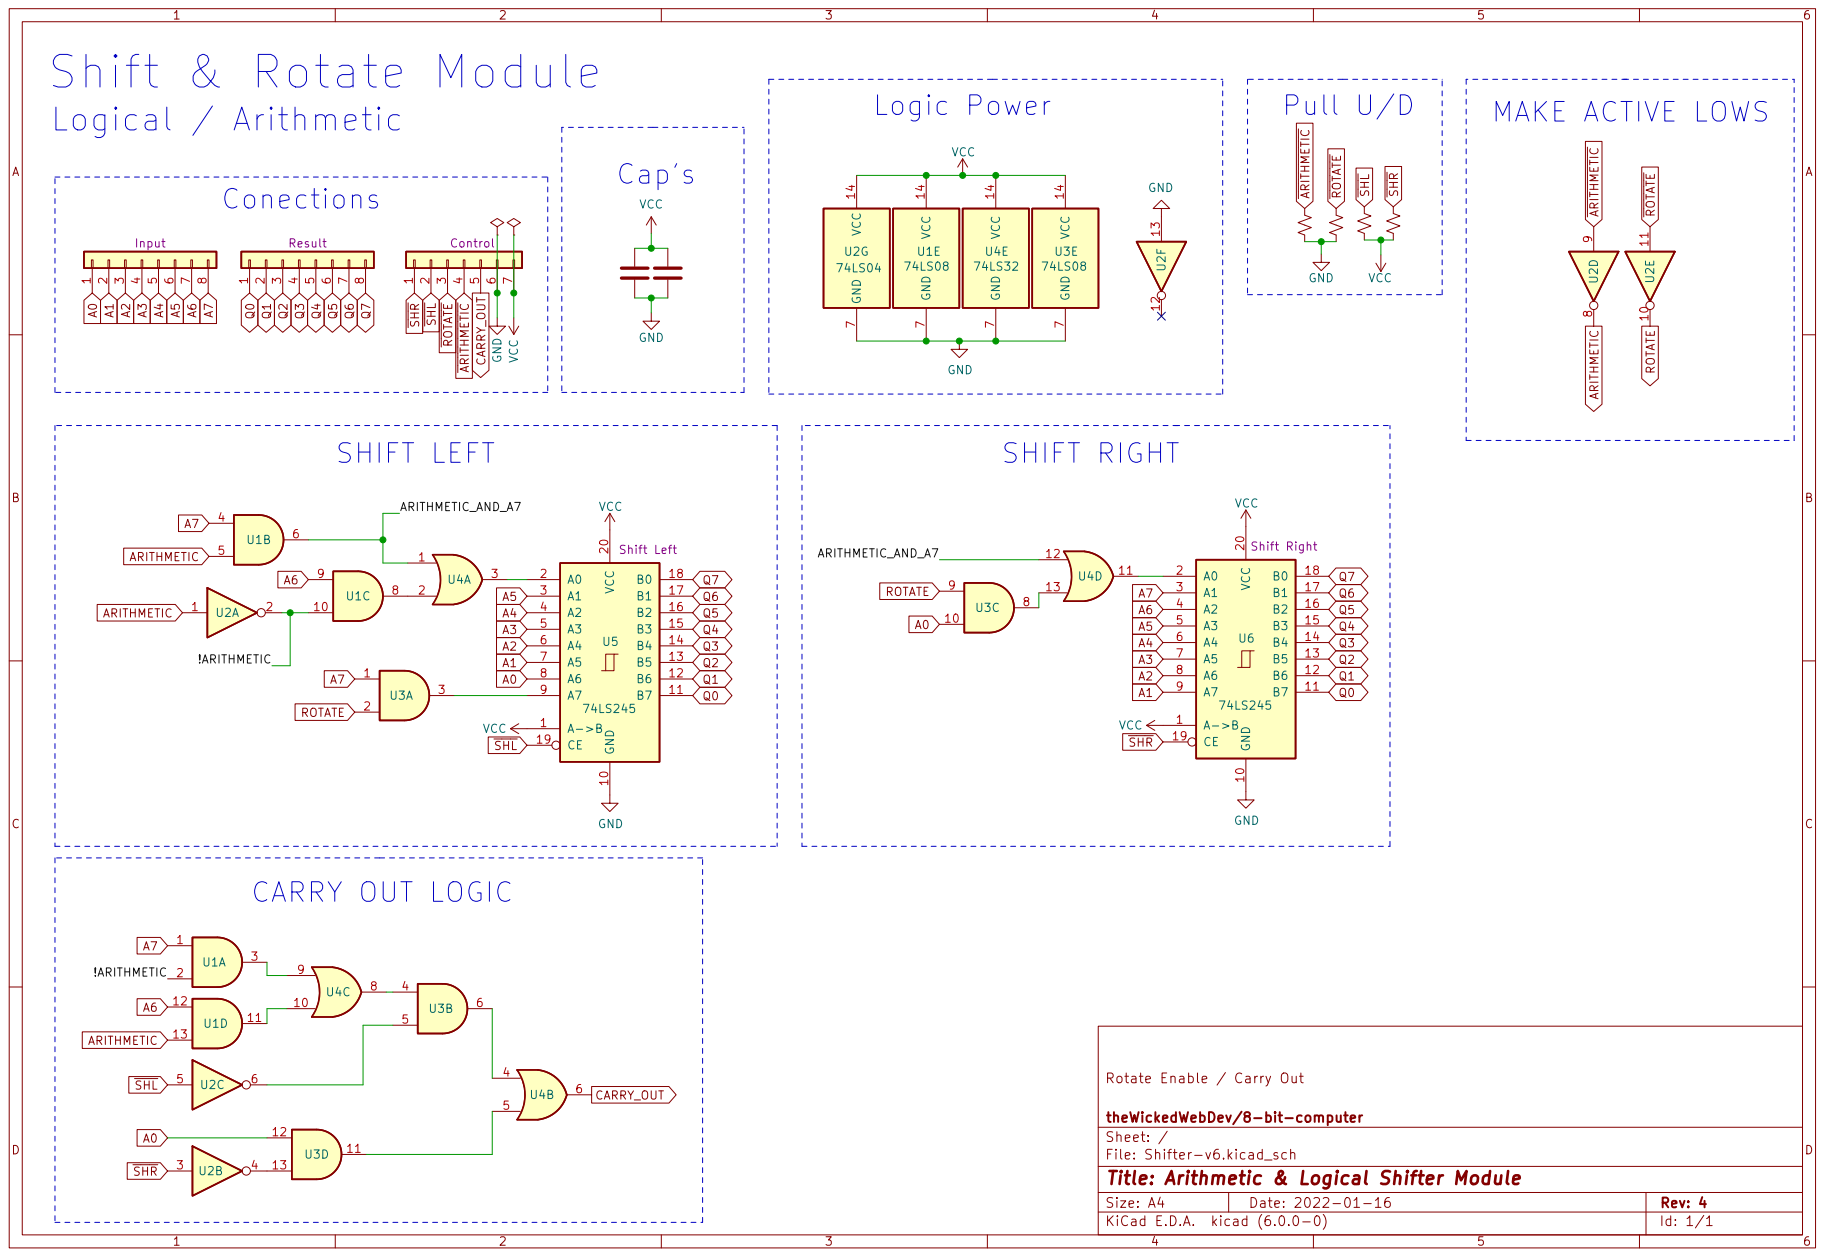
[picture p203: page 20]

Rotate Enable / Carry Out

theWickedWebDev/8-bit-computer
Sheet: /
File: Shifter-v6.kicad_sch
Title: Arithmetic & Logical Shifter Module

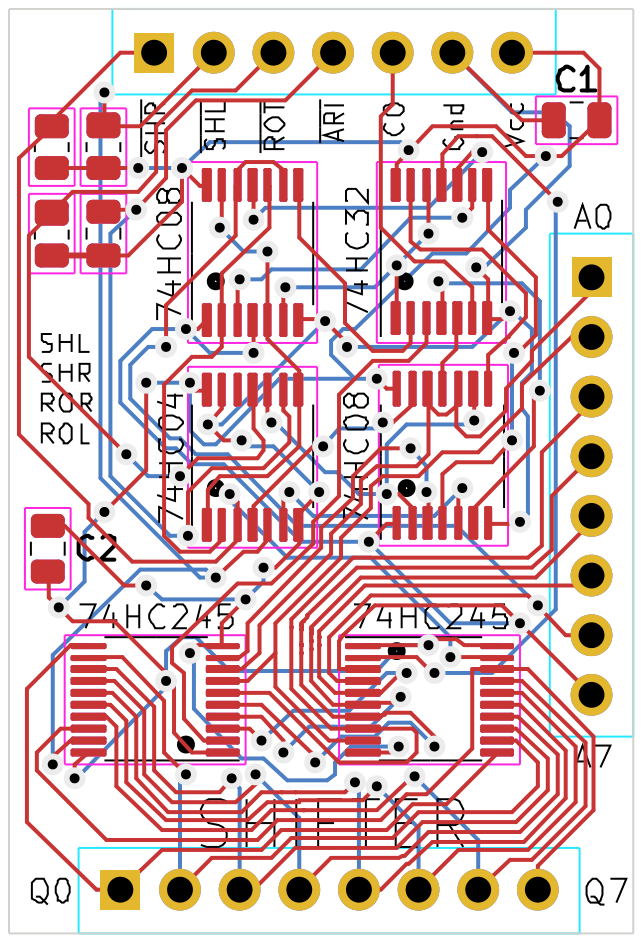
[picture p204: page 21]

# B0B⁷B⁶

## Logic Power

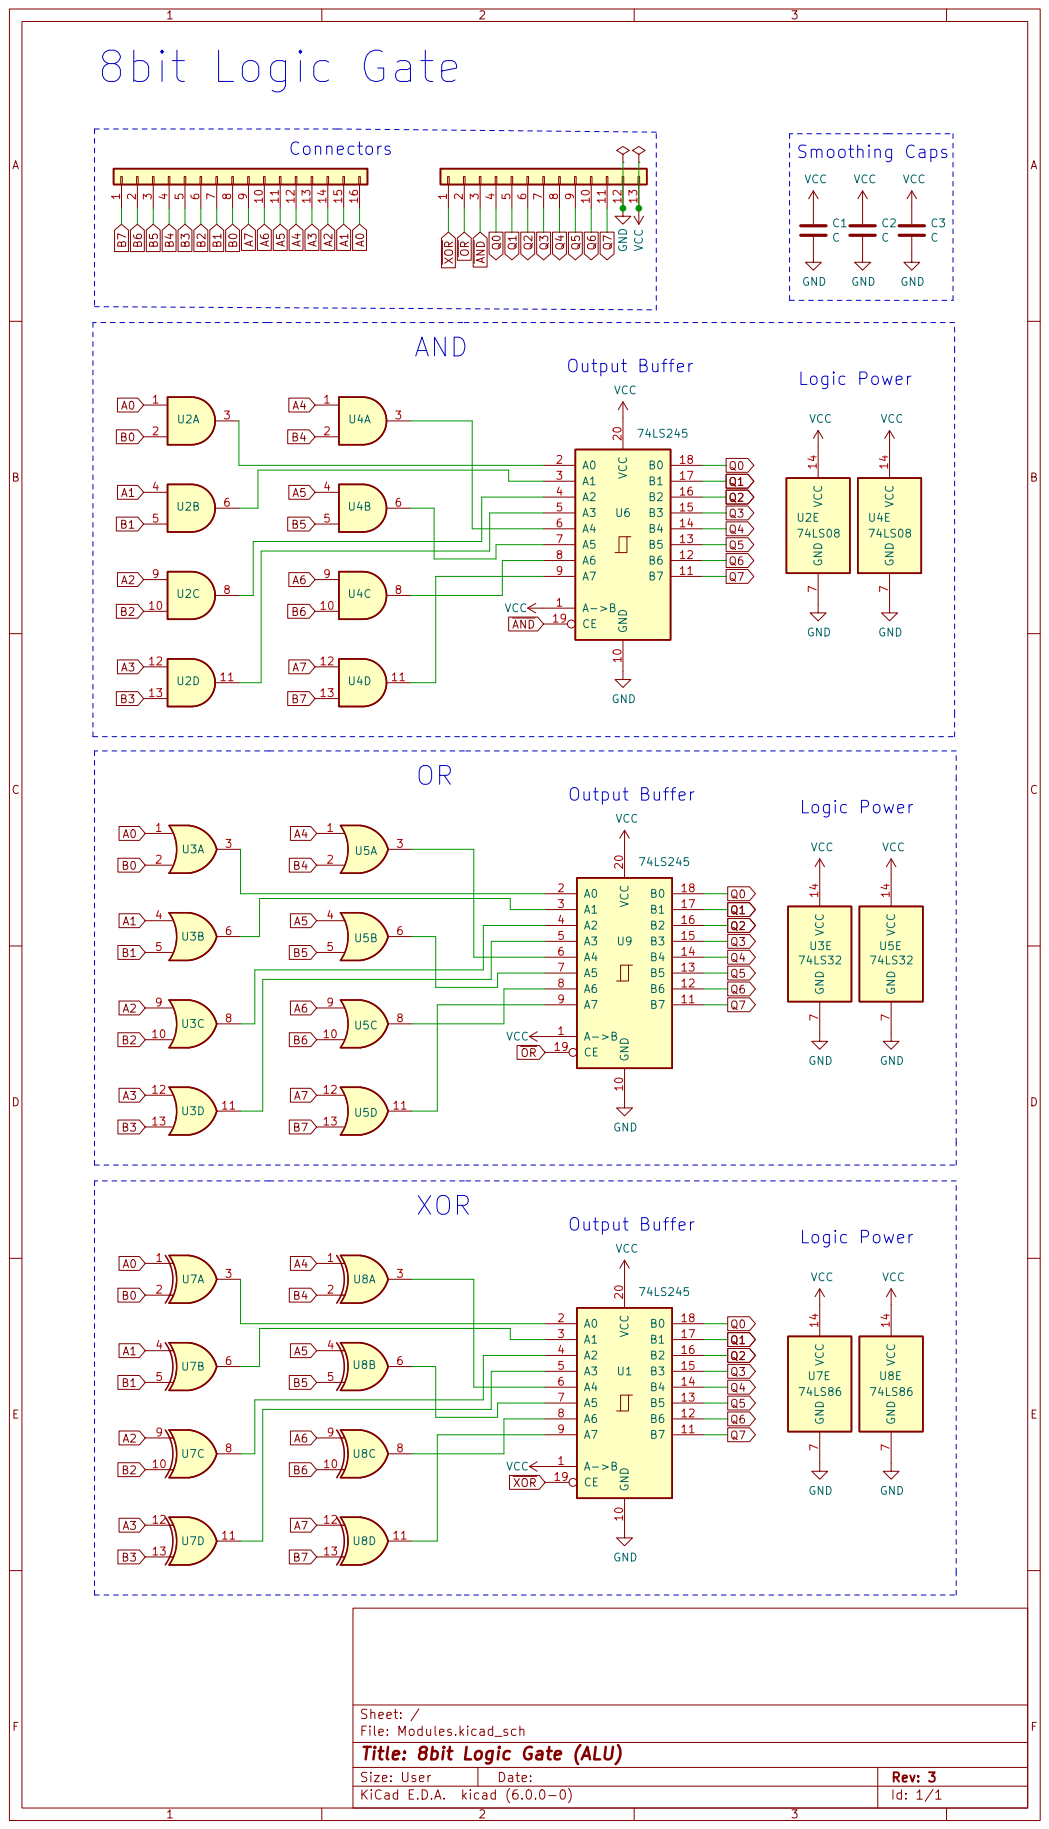
[picture p205: page 22]

Sheet: /
File: Modules.kicad_sch
Title: 8bit Logic Gate (ALU)
KiCad E.D.A. kicad (6.0.0-0)

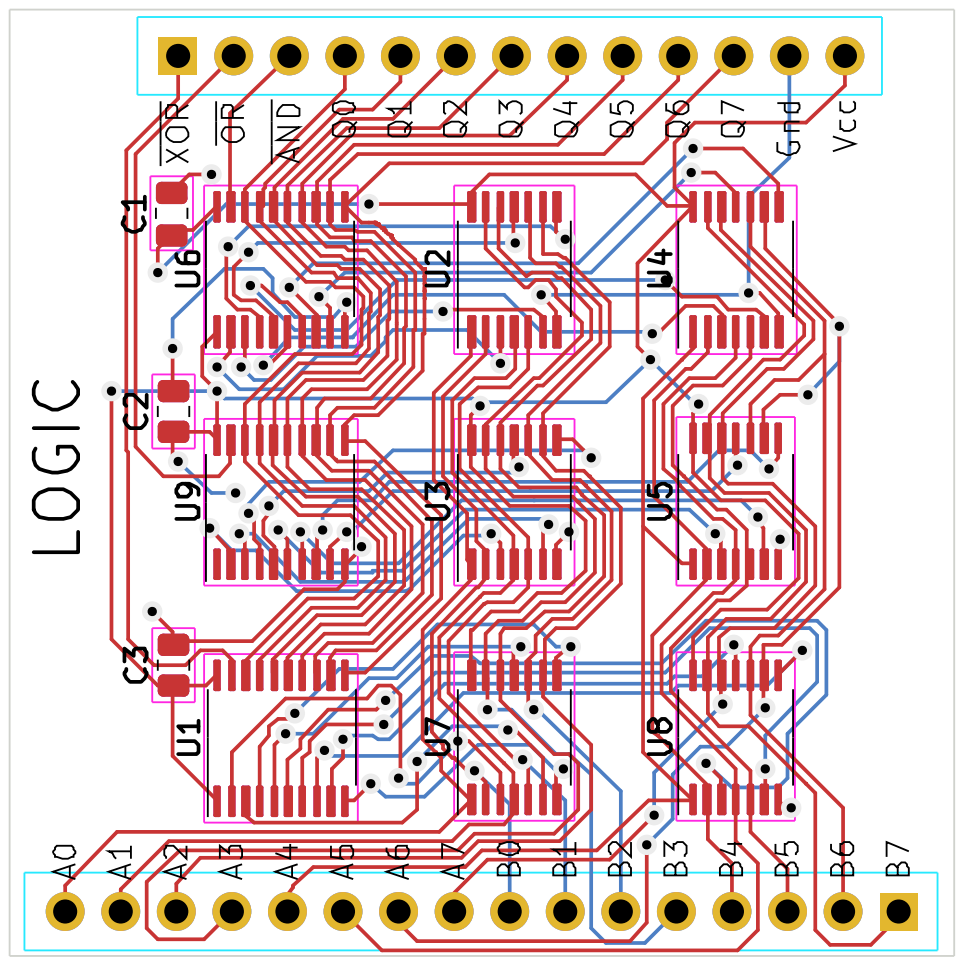
[picture p206: page 23]

# Connections

# Smoothing Caps

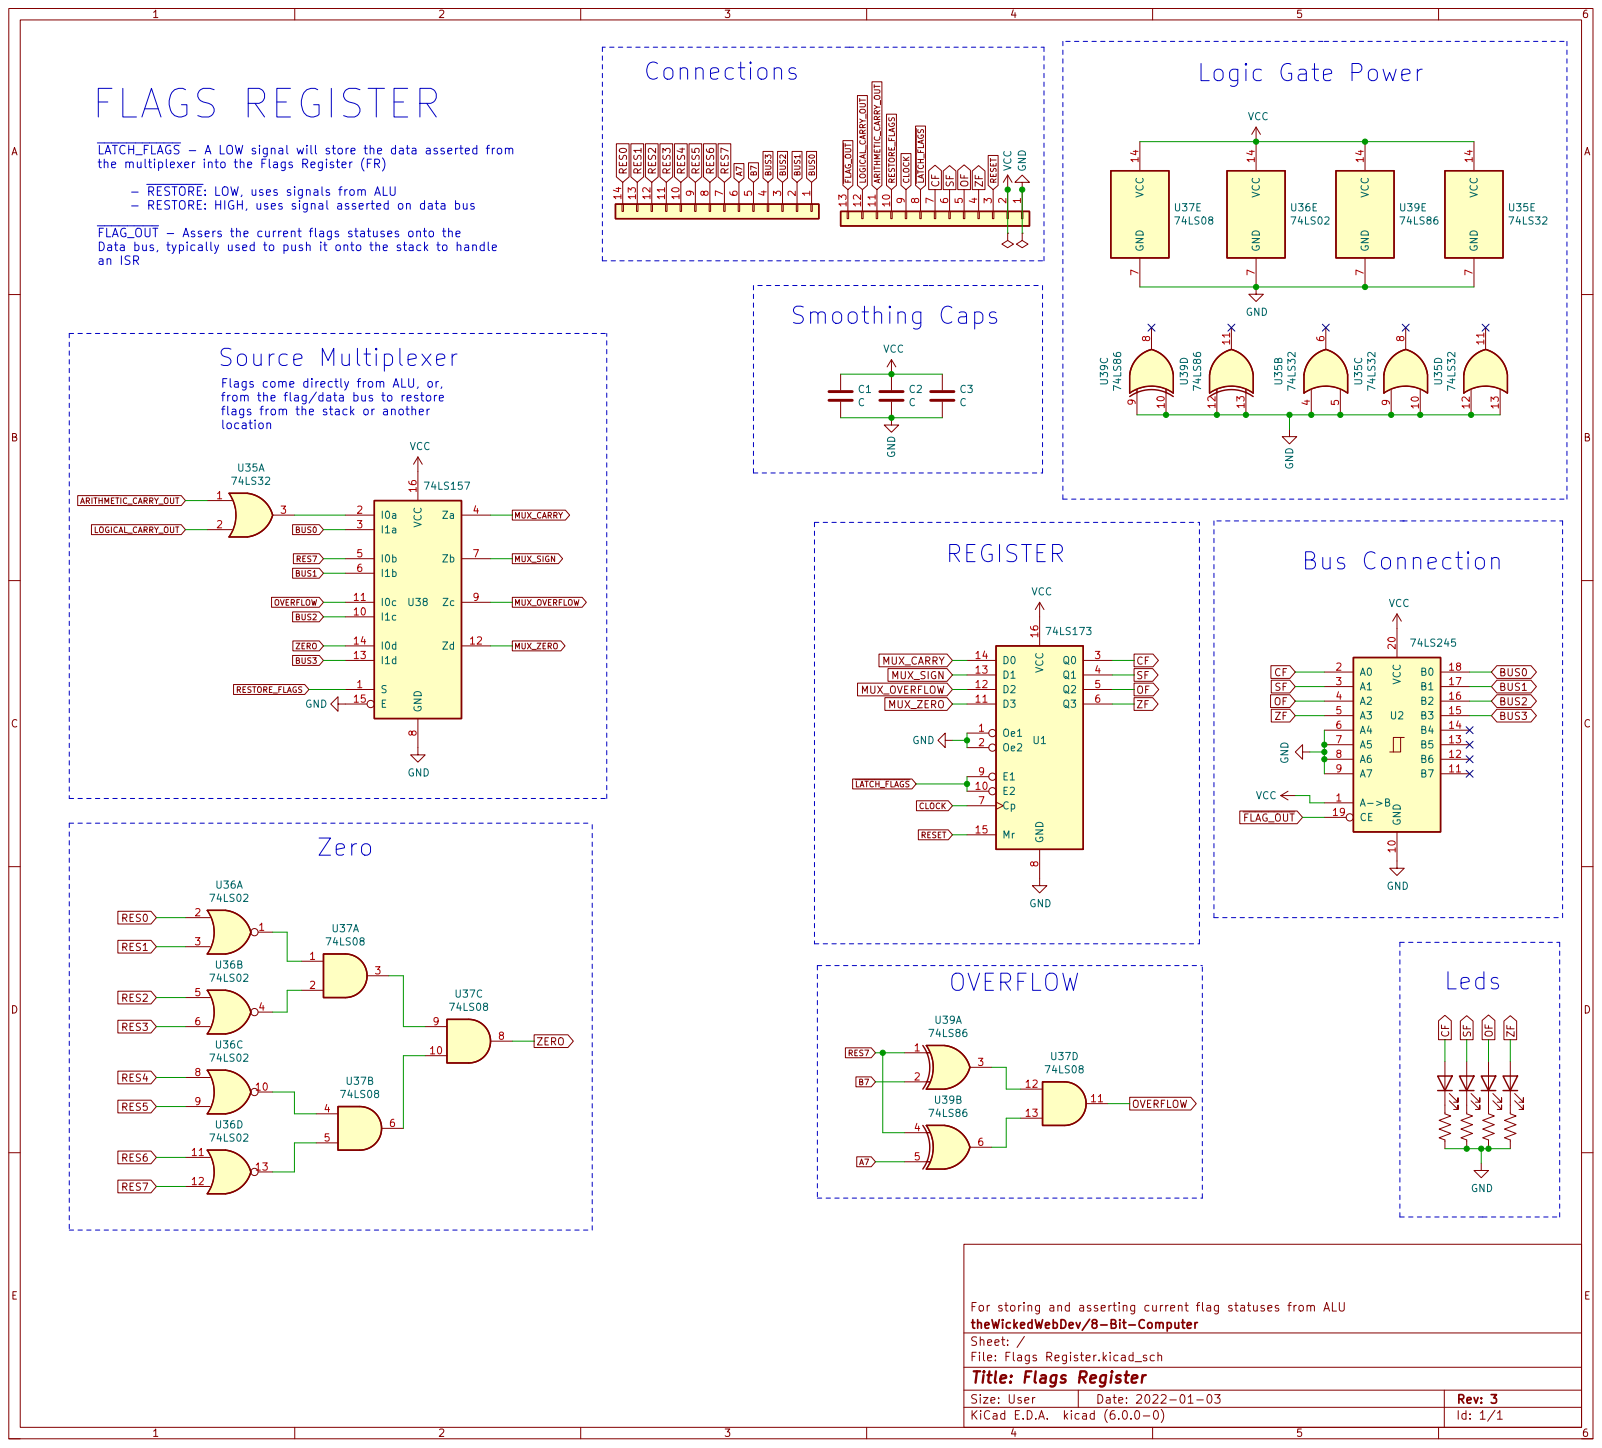
[picture p207: page 24]

~{LATCH_FLAGS} - A LOW signal will store the data asserted from
the multiplexer into the Flags Register (FR)

- ~{RESTORE}: LOW, uses signals from ALU
- RESTORE: HIGH, uses signal asserted on data bus

~{FLAG_OUT} - Assers the current flags statuses onto the
Data bus, typically used to push it onto the stack to handle
an ISR

Flags come directly from ALU, or,
from the flag/data bus to restore
flags from the stack or another
location

For storing and asserting current flag statuses from ALU
theWickedWebDev/8-Bit-Computer
Sheet: /
File: Flags Register.kicad_sch
Title: Flags Register

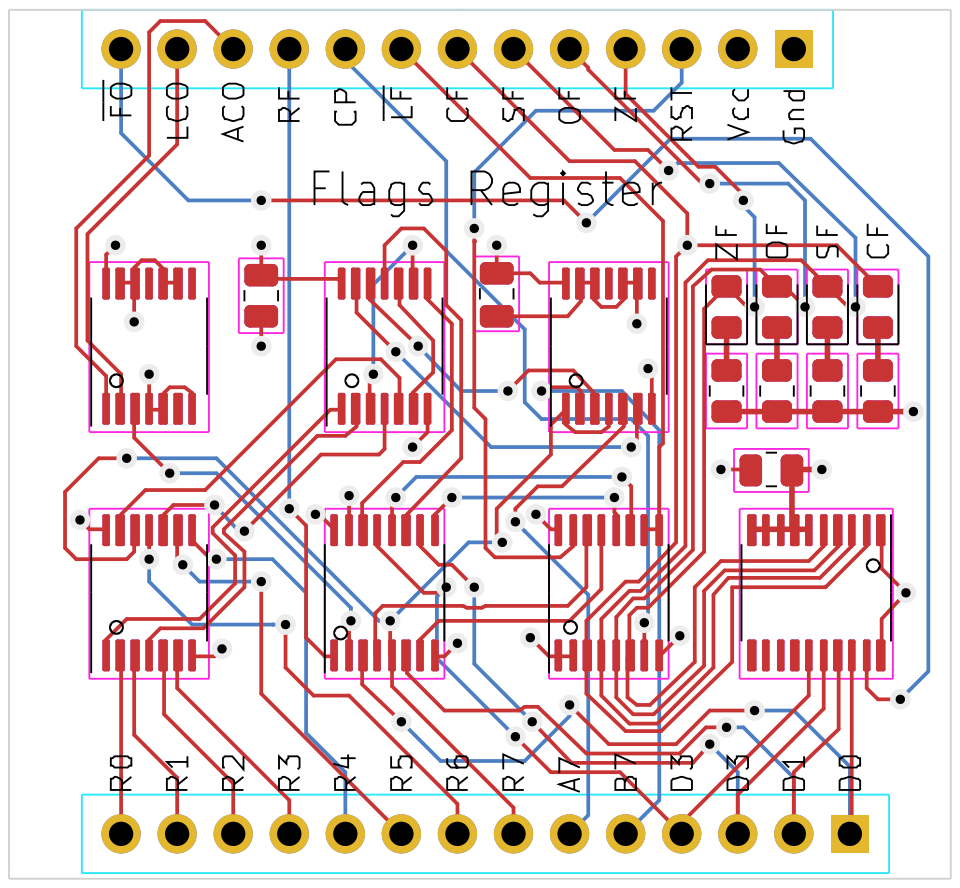
[picture p208: page 25]

# Memory

# ROM & RAM

# Input & Output (I/O)

# CPU Control
