theWickedWebDev/8-bit-computer/PCBs/99_IN PROGRESS/IO-UART/UART.pdf

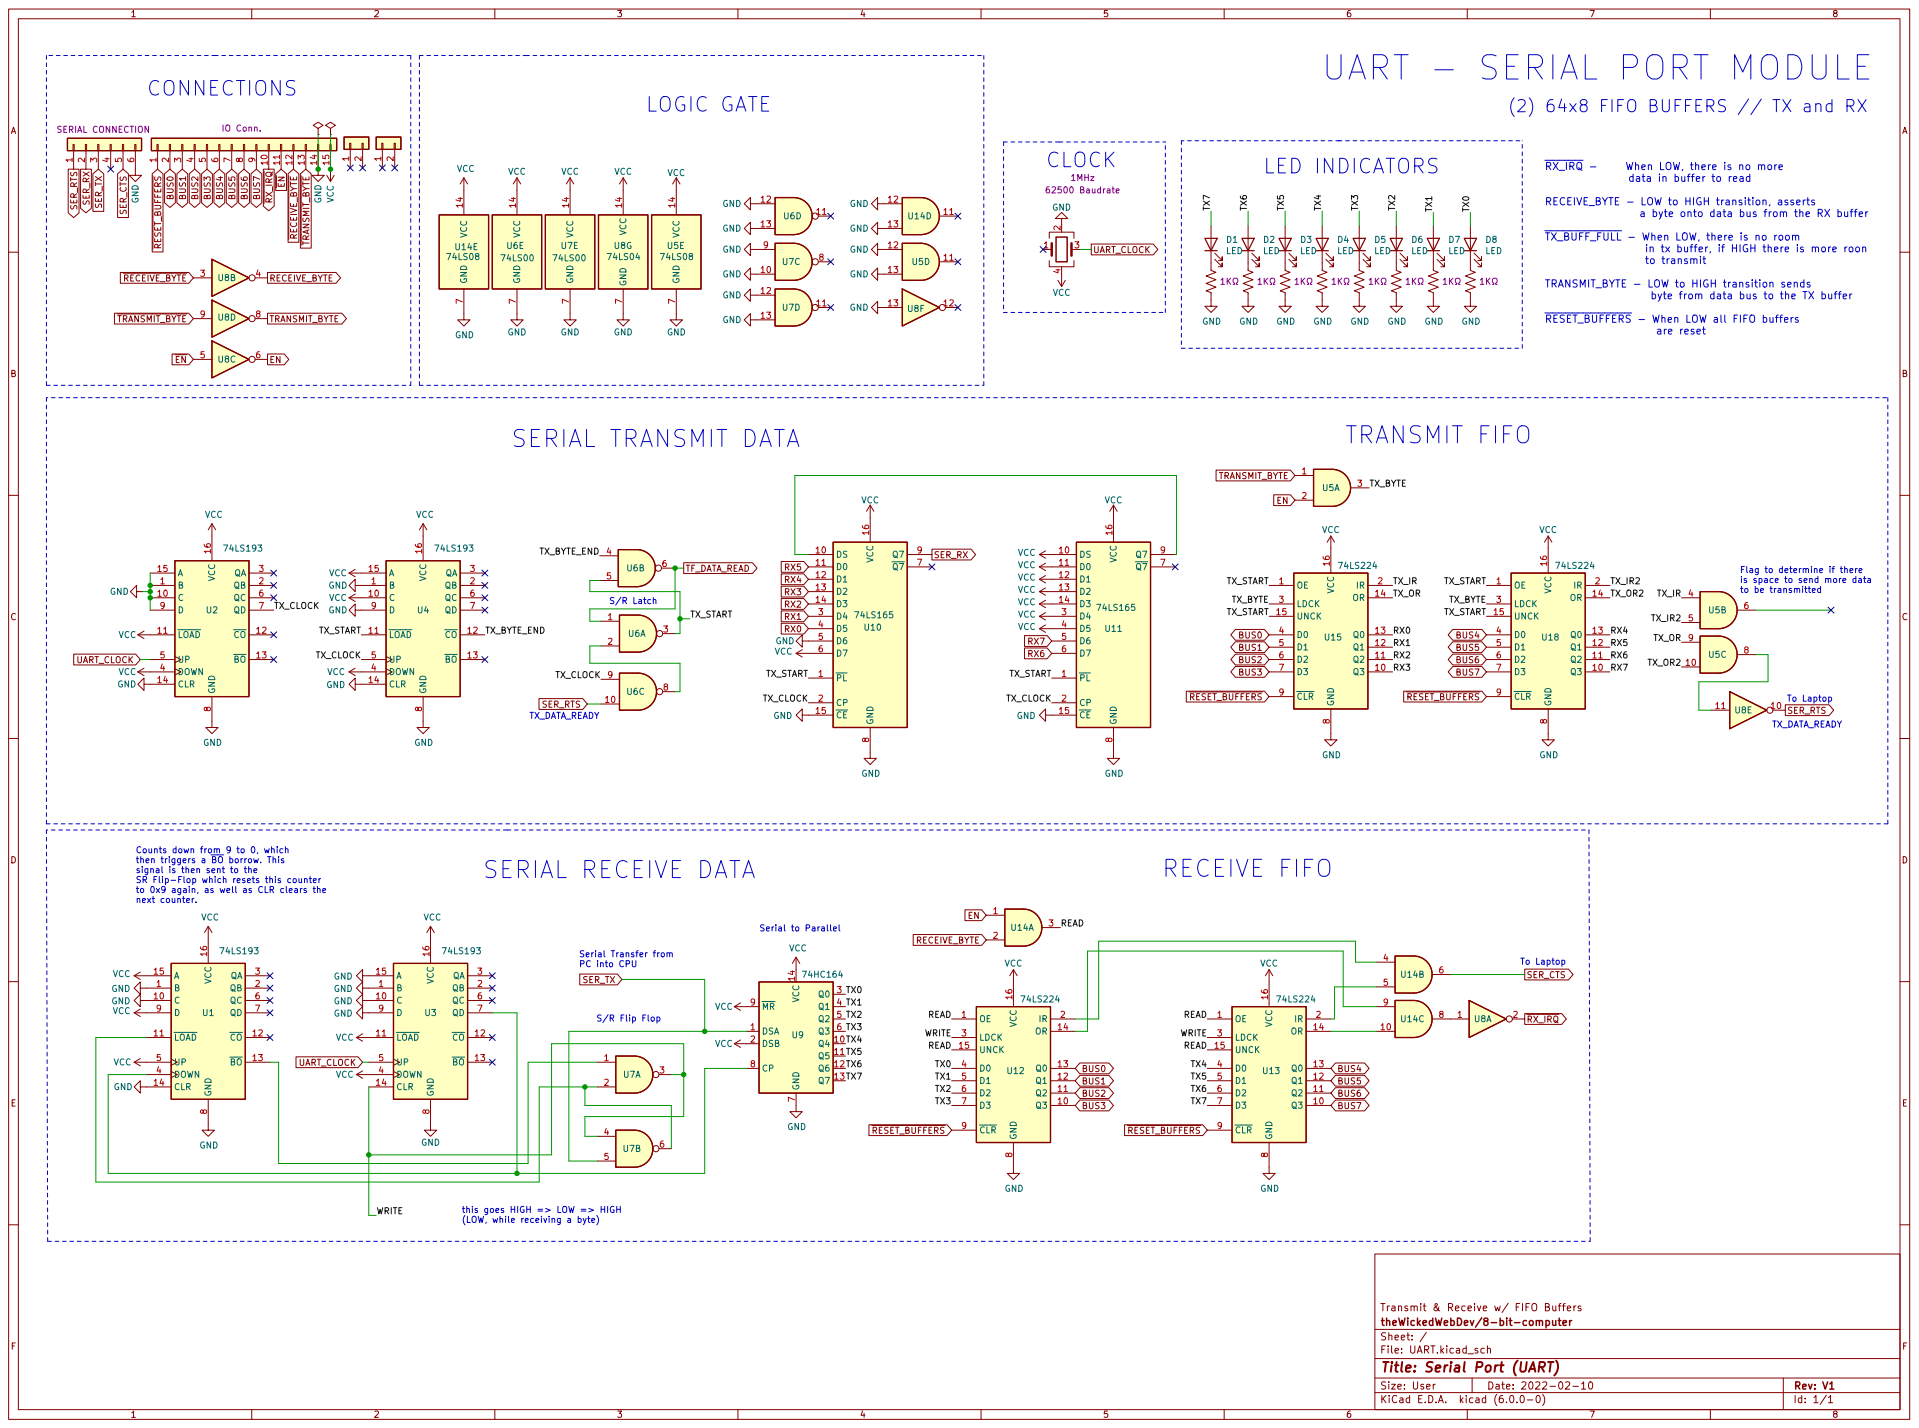
[picture p209: page 1]

UART - SERIAL PORT MODULE

(2) 64x8 FIFO BUFFERS // TX and RX

are reset LED INDICATORS

~{RX_IRQ} - When LOW, there is no more
data in buffer to read RECEIVE_BYTE - LOW to HIGH transition, asserts

a byte onto data bus from the RX buffer

VCC GND GND GND

~{TX_BUFF_FULL} - When LOW, there is no room

to transmit TRANSMIT_BYTE - LOW to HIGH transition sends

in tx buffer, if HIGH there is more roon

byte from data bus to the TX buffer

~{RESET_BUFFERS} - When LOW all FIFO buffers

Serial to Parallel SERIAL TRANSMIT DATA

TX_BYTE_END
to be transmitted SERIAL RECEIVE DATA

is space to send more data

(LOW, while receiving a byte) Counts down from 9 to 0, which
then triggers a ~{BO} borrow. This
signal is then sent to the
SR Flip-Flop which resets this counter
to 0x9 again, as well as CLR clears the
74LS193 GND

To Laptop Serial Transfer from

File: UART.kicad_sch Sheet: / theWickedWebDev/8-bit-computer Transmit & Receive w/ FIFO Buffers GND

this goes HIGH => LOW => HIGH

Id: 1/1 Title: Serial Port (UART)
