theWickedWebDev/8-bit-computer/PCB-Modules/01_BACKPLANES/gpr-new-register-backplane/new-register-backplane.pdf

9 VCC GND VCC L3L4L6L7 CLOCK ~{DEC_F} RESET ~{INC_F} L2L5 ~{LD_F} CLOCKM5 ~{BO_F} L0L1L2 M6 ~{LS_D} ~{BS_D} ~{INC_S4} ~{BO_S4} ~{DEC_S4} C6 C12 C13 C8 C9 C10 C11 C5 C7 TX_BUS_SELECT ~{TX_ASSERT_LSB_MAIN} TX_LATCH_LSB TX_LATCH_MSB ~{TX_ASSERT_MSB_MAIN} ~{BS_E} ~{TX_ASSERT_ADDRESS} C15 ~{BO_S3} ~{DEC_S3} ~{LD_S4} ~{LD_S3} ~{INC_S3} ~{WR} C0 C1 C2 ~{RD} EN_D ~{DEC_G} ~{INC_F} ~{LD_F} ~{BO_G} ~{BO_F} ~{DEC_F} M7 ~{INC_G} ~{LD_G} ~{LS_E} C3 C4 C14 M2 M3 M5 B2B3B4B5B6 ~{TX_ASSERT_ADDRESS} ~{TX_ASSERT_LSB_MAIN} ~{TX_ASSERT_MSB_MAIN} M0 M1 B0B1 L6 B7 M4 M7 L4L5 M6M3 M7 L3L6L7 L1L4L5L6L7 M0 M1 M6 M5 M7 M3 M7 CLOCKM4 CLOCKL3L5L7 M4 M5 L0L1L2L3L4 M3 M4 M5 M6 M7 L4 ~{BS_S2} ~{LD_S4} B2B4 ~{MS_E} ~{MS_A} B3 ~{LS_S2} ~{INC_S4} RESET ~{DEC_S4} ~{BO_S4} CLOCK ~{LS_A} ~{LS_S1} L5 M2 EN_S1 M2 M3 M4 M6 CLOCK ~{INC_S3} ~{DEC_S3} RESET ~{LD_S3} ~{MS_S1} ~{MS_S2} L0L2L3 M7 ~{BS_S1} EN_S1 ~{BS_C} M5 ~{BS_S1} EN_C B0 ~{MS_S1} B0B1 ~{BO_S3} CLOCK L0L1 EN_A ~{BS_A} ~{LS_E} L6L7 M0 M1 ~{LS_C} EN_E L2 L2 EN_S2 M4 M6 ~{MS_C} ~{MS_D} M5 RESET ~{DEC_G} ~{INC_G} ~{LD_G} ~{BO_G} EN_E M1 M2 M3 M7 L0 ~{MS_E} L5 L2L3L4 M4 L5L7 M0 M7 M6 M5 M4 M2 M1L7L5L4L3L2L1L0B7 C8 C7 C6 C5 C4 B7L1 L6 C15 C14 C13 C12 C11 C3 C2 C1 C0 ~{WR} B6B5B4B3B2B1B0 L4 C9 C10 M3 M0L6 RESET ~{RD} CLOCK B6 TX_LATCH_MSB B2B3B4 ~{BS_E} B1B5 M0 TX_BUS_SELECT TX_LATCH_LSB M3 M2L0L1 M0 M7 EN_D ~{MS_D} ~{BS_D} B0 ~{LS_D} B1 ~{BS_C} B3 EN_CB0B1 ~{MS_C} ~{LS_C} M1 CLOCK CLOCK L7 CLOCK M2 M4 B2B3B4B6B7L0 L5 M0 M4 M0 L7 M2 M3 M5 M6 M7 L2L3L4L5L6L7 M1 M2 M3 M4 M5 M6 M7 L3L6 M1 L6 L2L4 L6 M0 M1 M2 M3 B6L2L3M1 M6 L3 M6 M5 EN_S2 ~{LS_S2} B1B2B3B4B5B7L0L1 ~{LS_S1} ~{BS_S2} B0 ~{MS_S2} B2B4B7L0L1 M5 ~{MS_A} EN_AB0 ~{LS_A} ~{BS_A} B2B4B5B6B7L0L1 B1B3B5B6 B5B6B7L0L1 L5L7 M0 M1 L4L5L6L7 M0 M1 M2 B5L1L2L3L4 M2 M3 M4 M6

2 G Control VCC GND VCC VCC

9 Scratch 3 Bus GND VCC

9 Scratch 4 Bus VCC GND

9 Scratch 2 VCC GND VCC GND

1 Transfer Data Bus VCC GND VCC

9 Transfer Address Bus VCC GND

File: new-register-backplane.kicad_sch Sheet: / theWickedWebDev/8-bit-computer VCC GND

1 Transfer Reg Control GND VCC

Id: 1/1 Title: GPR Backplane
