theWickedWebDev/8-bit-computer/PCBs/99_IN PROGRESS/Latest-Full-Backplane/Latest-Full-Backplane.pdf

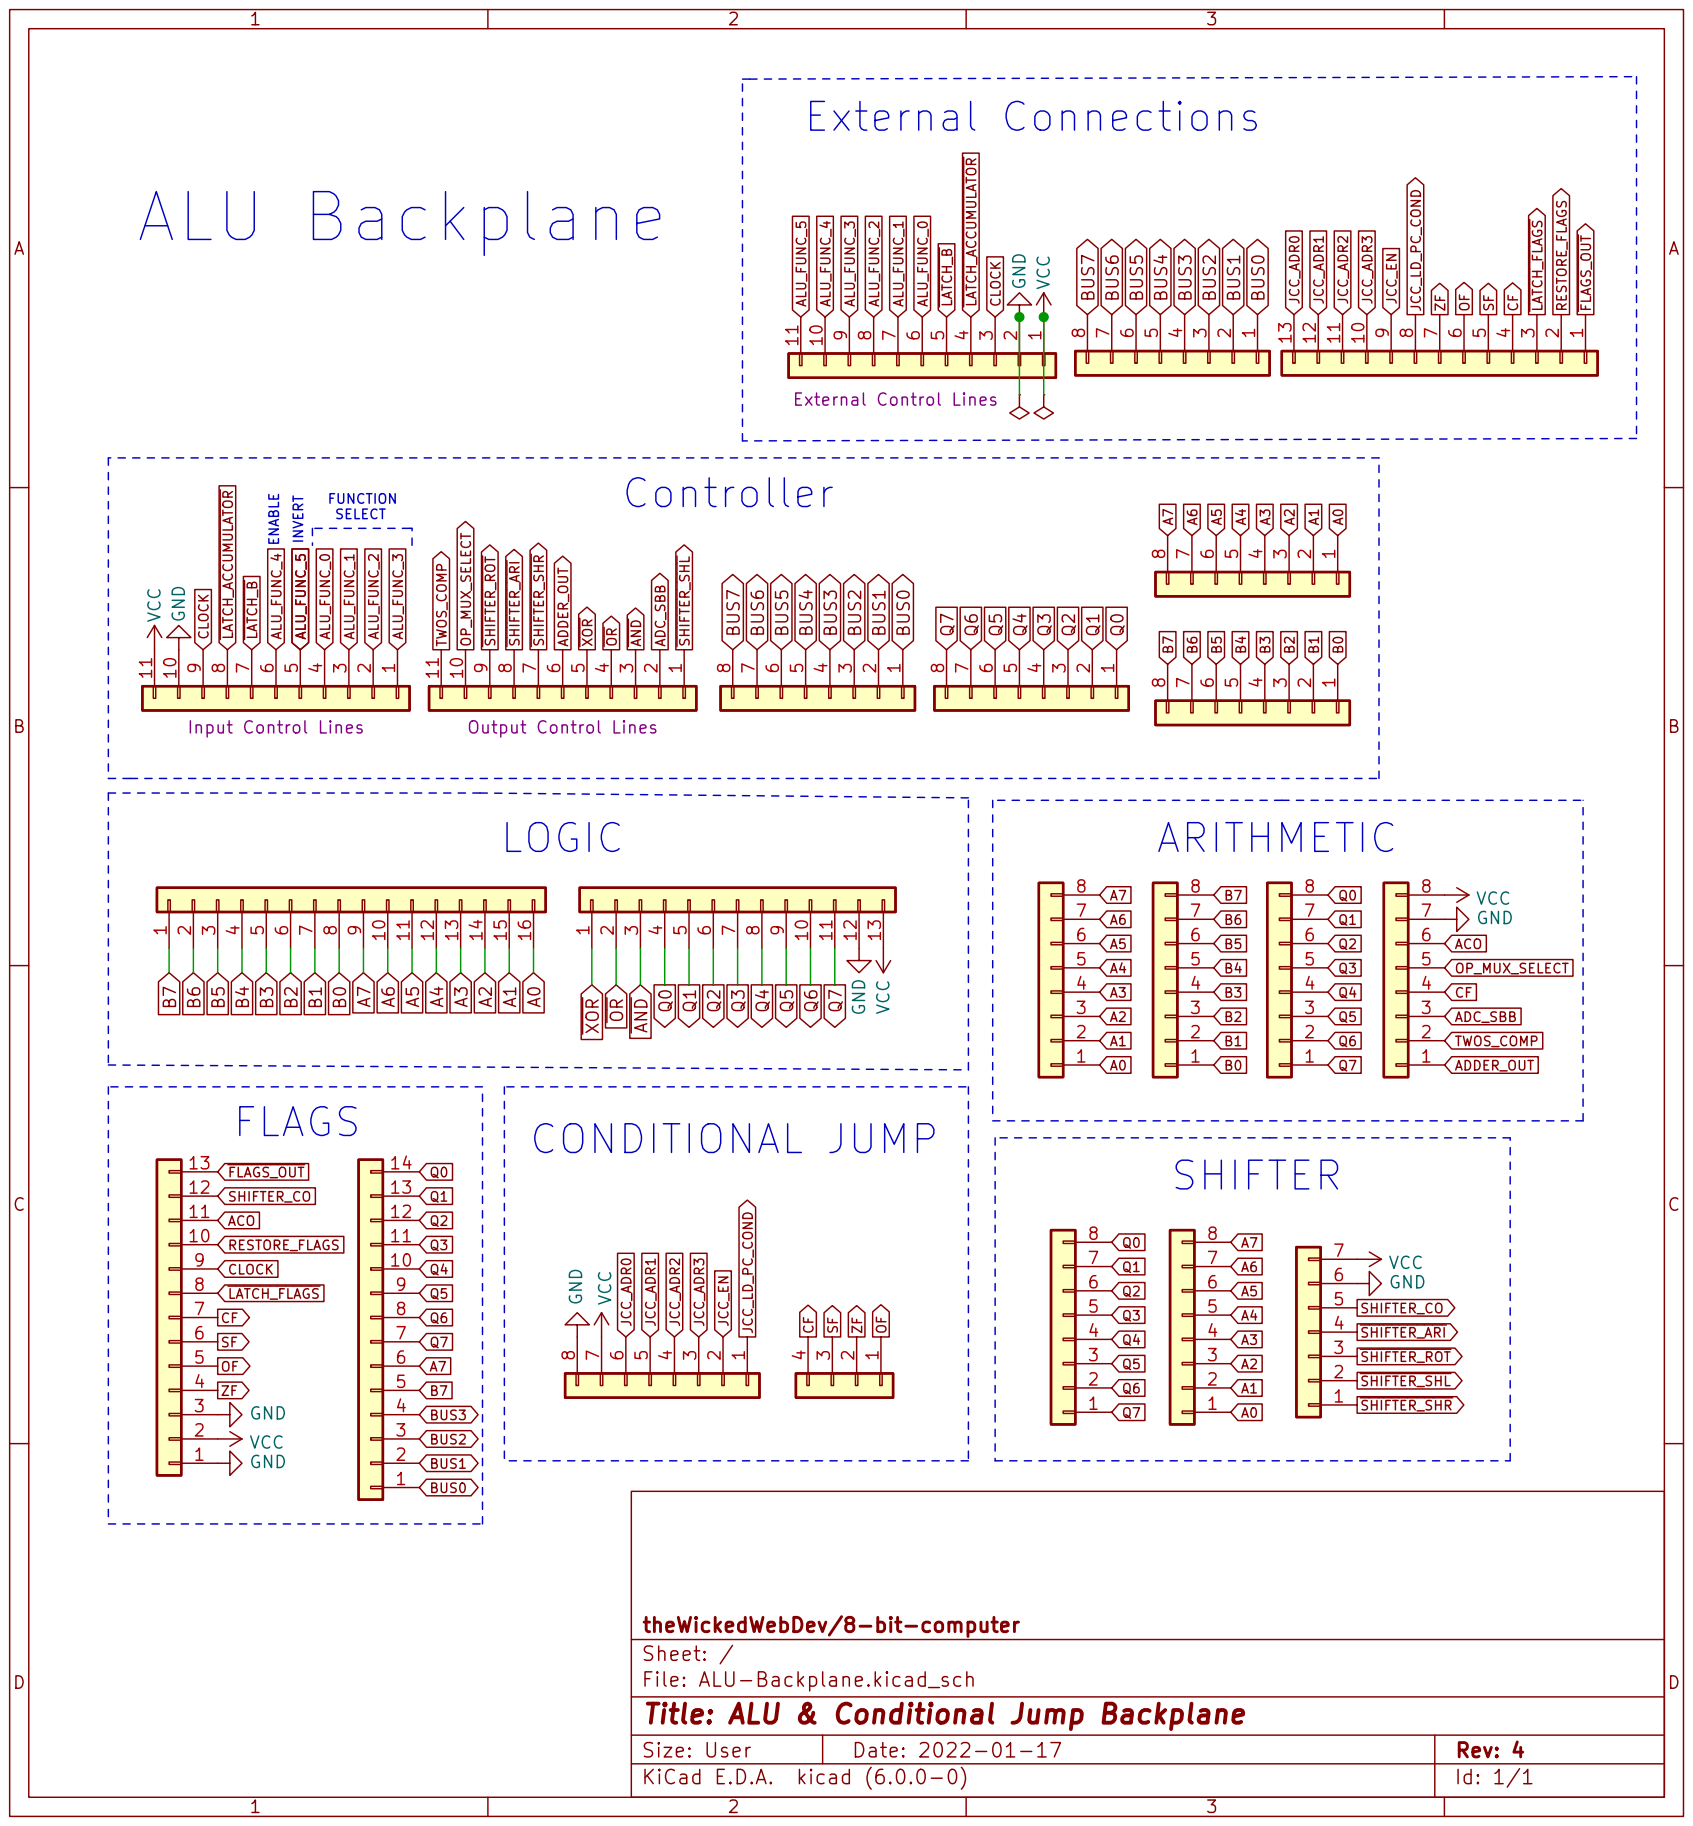
[picture p210: page 1]

Input Control Lines VCC GND

Id: 1/1 Title: ALU & Conditional Jump Backplane
