theWickedWebDev/8-bit-computer/PCBs/99_IN PROGRESS/IO-Timer-2022/interrupts.pdf

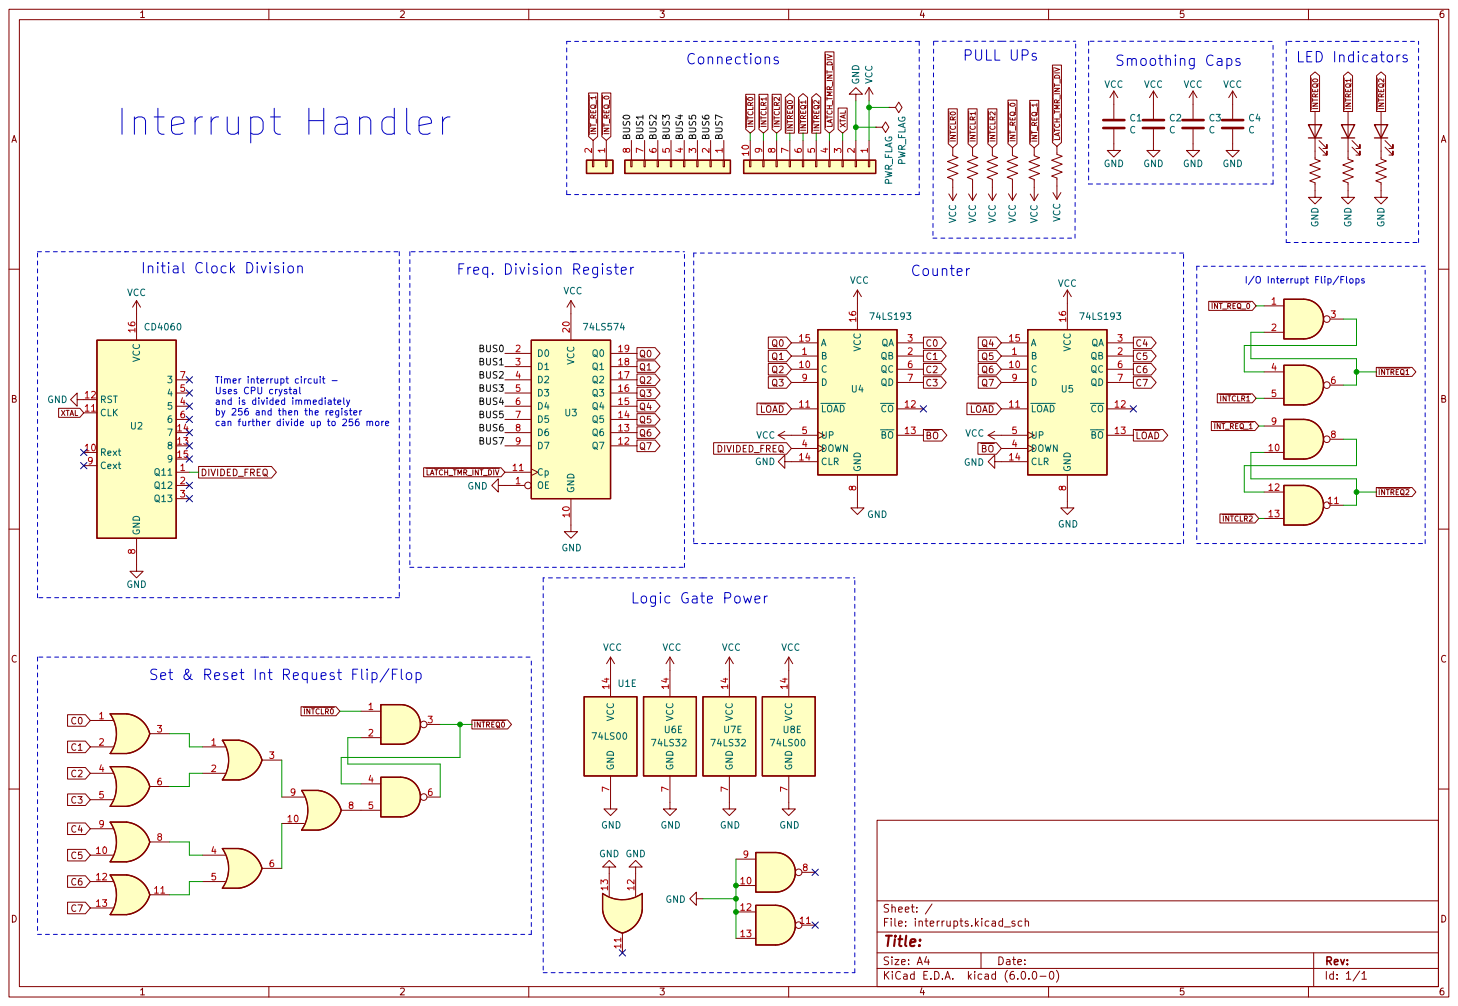
[picture p211: page 1]

Timer interrupt circuit -
Uses CPU crystal
and is divided immediately

Set & Reset Int Request Flip/Flop
