theWickedWebDev/8-bit-computer/PCBs/99_IN PROGRESS/IO-Midi/audio.pdf

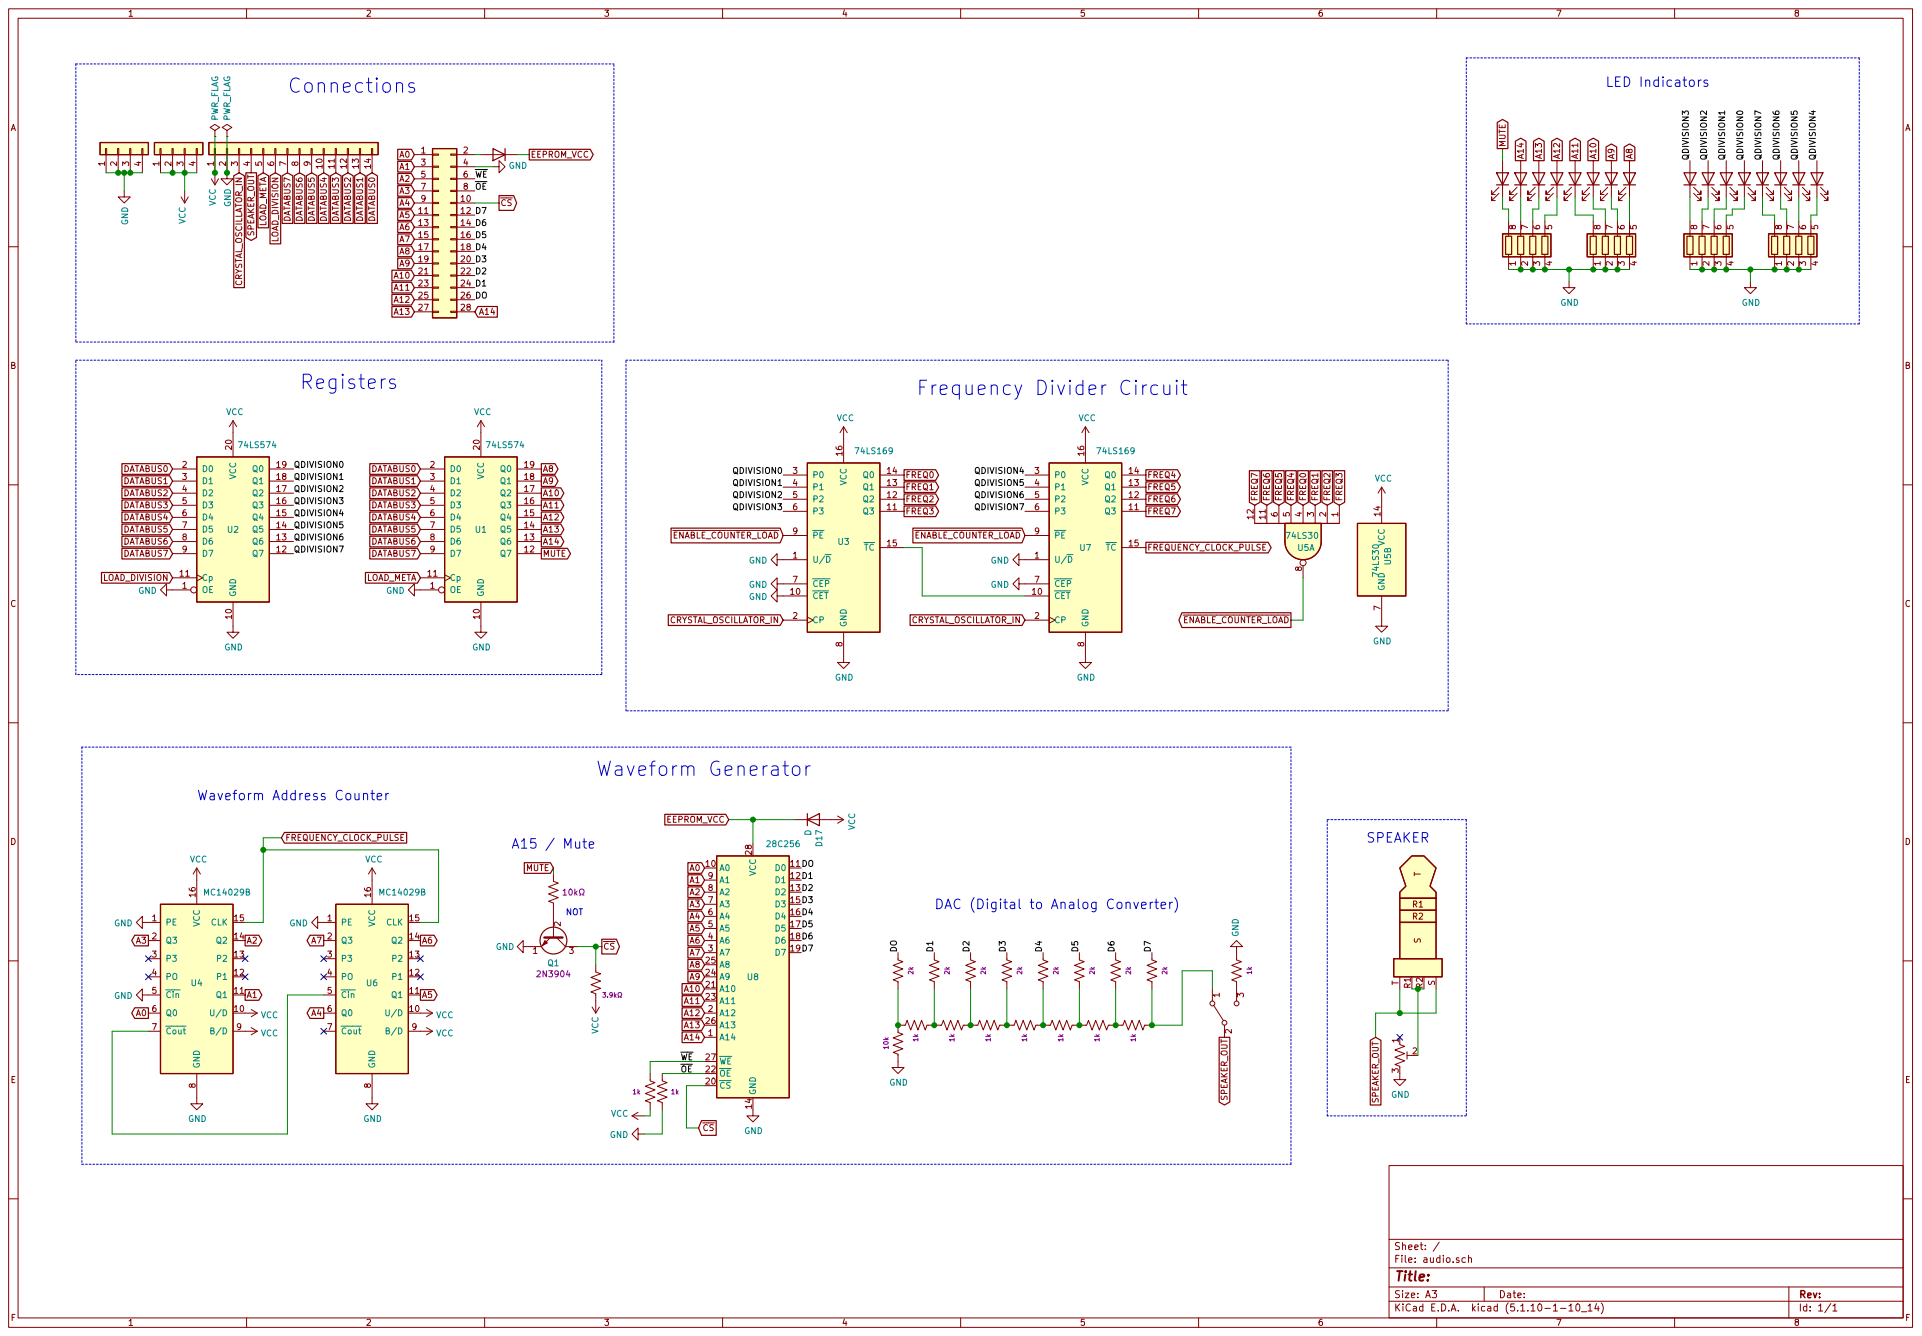
[picture p212: page 1]

5 GND GND GND GND GND GND

DAC (Digital to Analog Converter)

Id: 1/1 Title: File: audio.sch Sheet: /
