theWickedWebDev/8-bit-computer/PCBs/03_MODULES/CPU-ALU/ALU-Arithmetic/ALU-Arithmetic.pdf

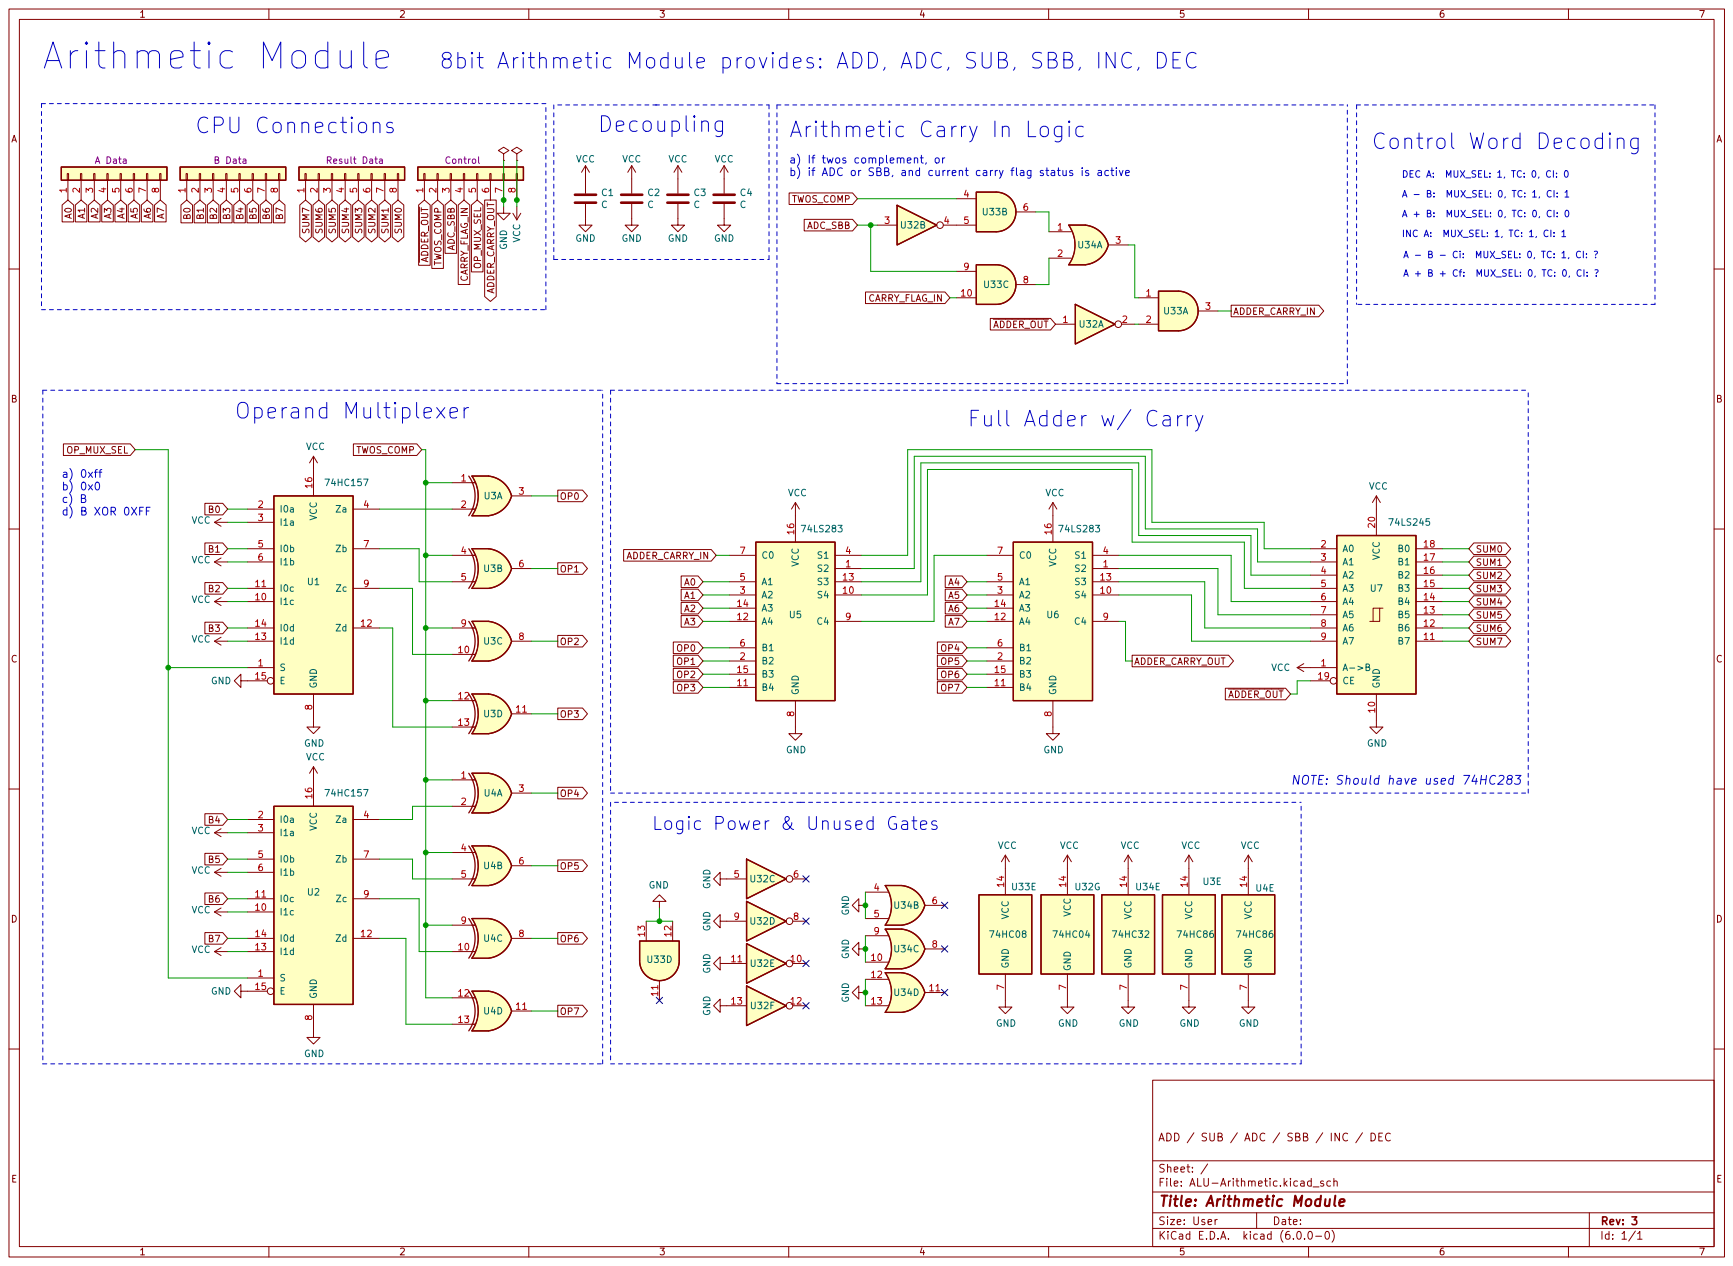
[picture p213: page 1]

A - B - Ci: MUX_SEL: 0, TC: 1, CI: ? A + B + Cf: MUX_SEL: 0, TC: 0, CI: ? DEC A: MUX_SEL: 1, TC: 0, CI: 0 A - B: MUX_SEL: 0, TC: 1, CI: 1 Control Word Decoding

8 Result Data VCC 14 GND

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

INC A: MUX_SEL: 1, TC: 1, CI: 1 A + B: MUX_SEL: 0, TC: 0, CI: 0

A5A6 Logic Power & Unused Gates

NOTE: Should have used 74HC283

File: ALU-Arithmetic.kicad_sch Sheet: / ADD / SUB / ADC / SBB / INC / DEC

Id: 1/1 Title: Arithmetic Module
