theWickedWebDev/8-bit-computer/PCBs/03_MODULES/CPU-ALU/ALU-Shifter/Shifter-v6.pdf

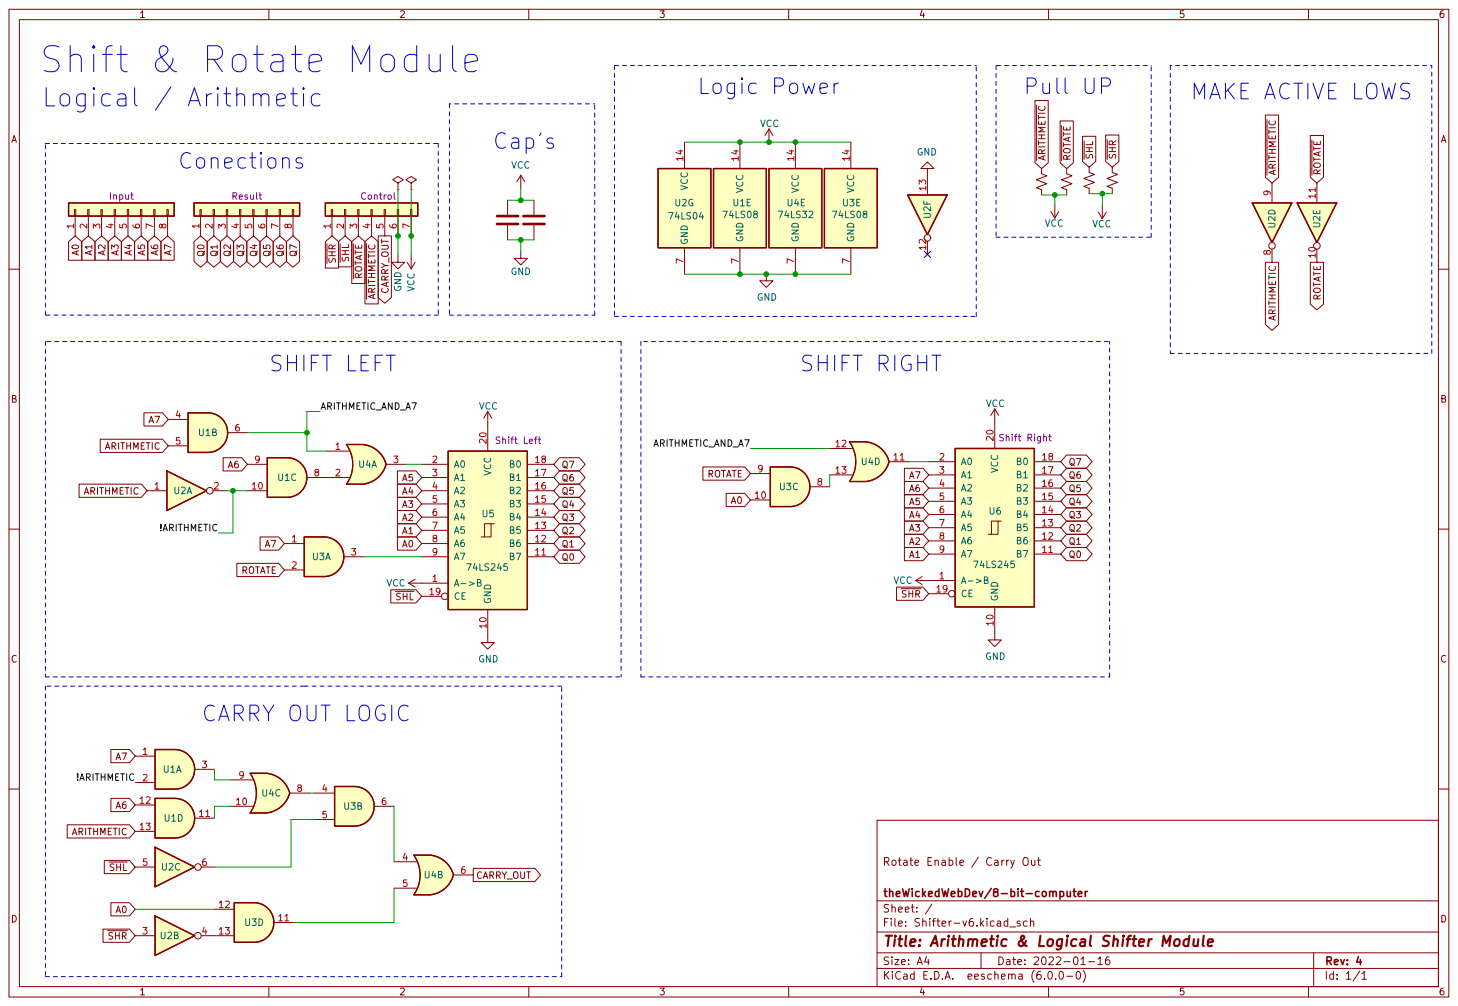
[picture p214: page 1]

7 Control 12 13 U2F GND VCC 14 GND

Rotate Enable / Carry Out

File: Shifter-v6.kicad_sch Sheet: / theWickedWebDev/8-bit-computer

Id: 1/1 Title: Arithmetic & Logical Shifter Module
