theWickedWebDev/8-bit-computer/User Manual/CPU - Instruction Cycle & Decode-Schematic.pdf

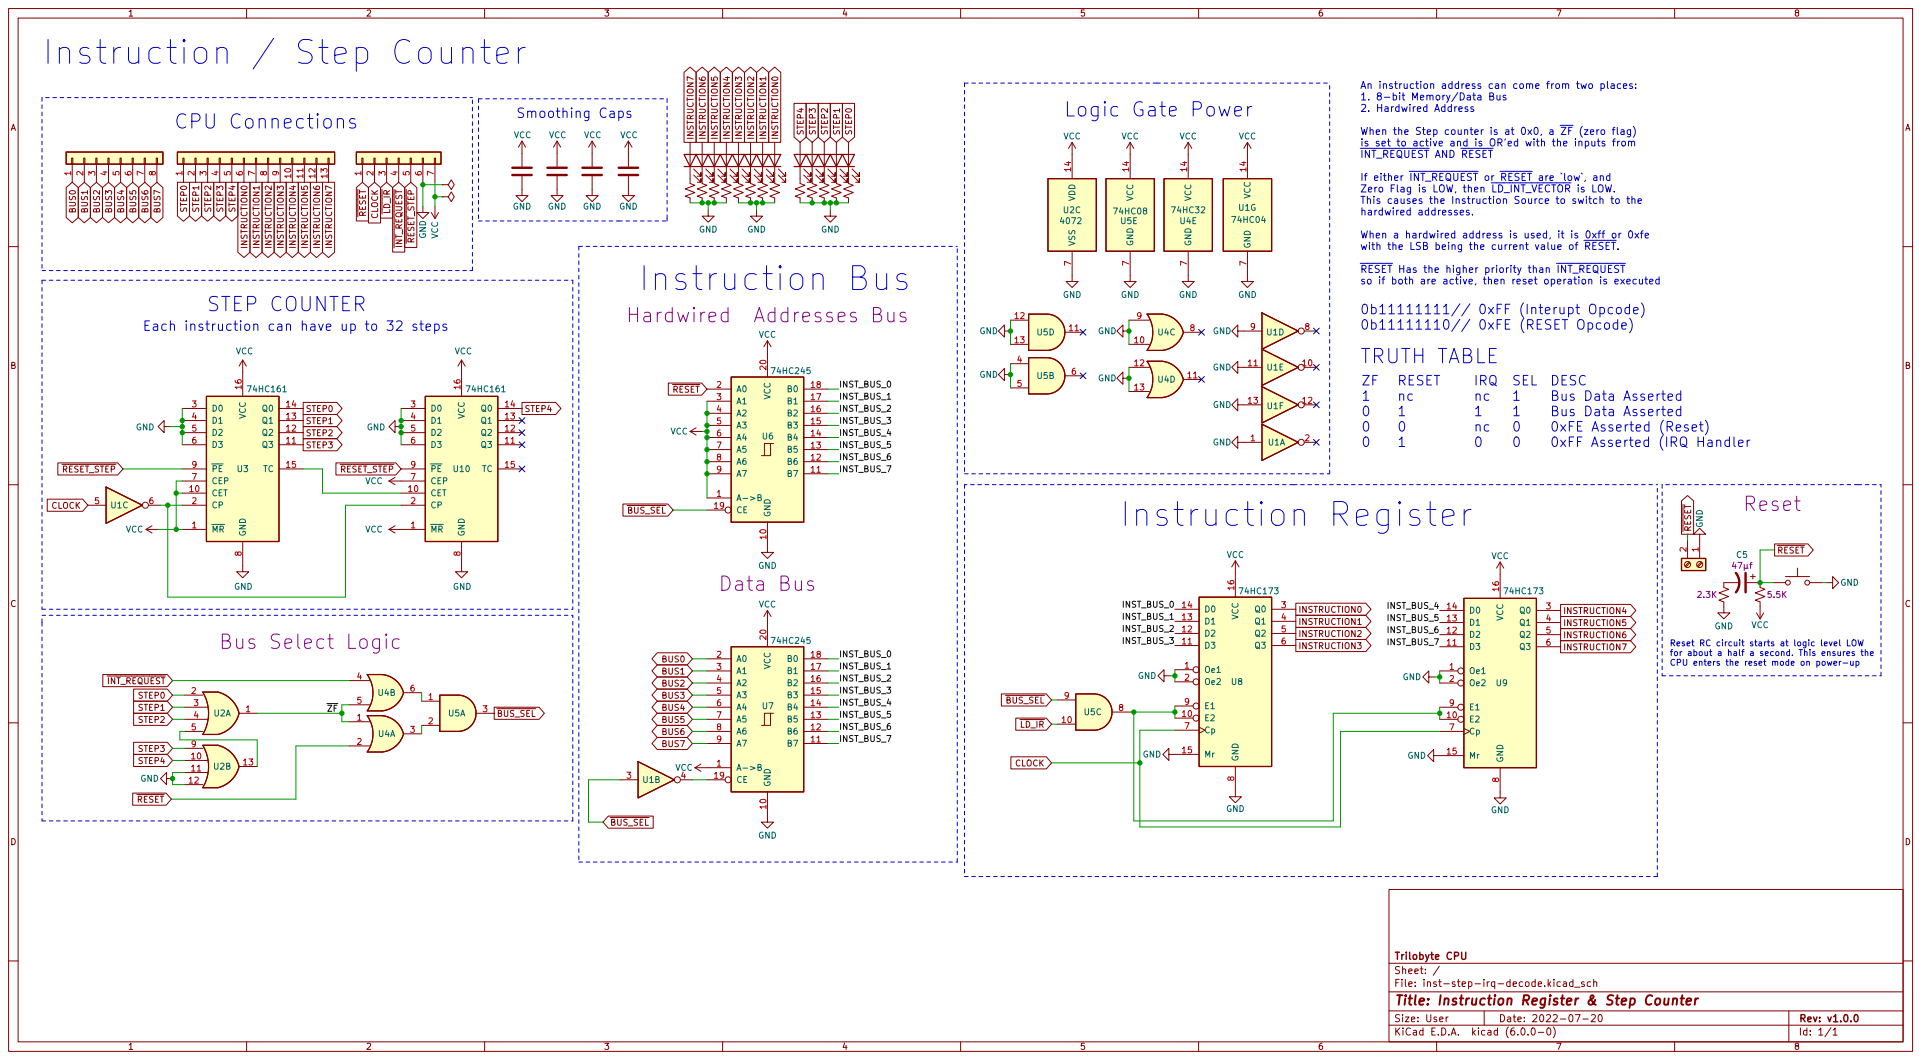
[picture p215: page 1]

An instruction address can come from two places:
1. 8-bit Memory/Data Bus 2. Hardwired Address When the Step counter is at 0x0, a ~{ZF} (zero flag)

is set to active and is OR'ed with the inputs from
~{INT_REQUEST} AND ~{RESET}

If either ~{INT_REQUEST} or ~{RESET} are `low`, and
Zero Flag is LOW, then ~{LD_INT_VECTOR} is LOW. This causes the Instruction Source to switch to the

hardwired addresses. When a hardwired address is used, it is 0xff or 0xfe

with the LSB being the current value of ~{RESET}.

~{RESET} Has the higher priority than ~{INT_REQUEST}
so if both are active, then reset operation is executed
0b11111111// 0xFF (Interupt Opcode)
0b11111110// 0xFE (RESET Opcode)
TRUTH TABLE
ZF RESET IRQ SEL DESC
1 nc nc 1 Bus Data Asserted
0 1 1 1 Bus Data Asserted
0 0 nc 0 0xFE Asserted (Reset)
0 1 0 0 0xFF Asserted (IRQ Handler

Each instruction can have up to 32 steps

~{INT_REQUEST} | 4 | 3 U4A Bus Select Logic 6 U4B

for about a half a second. This ensures the CPU enters the reset mode on power-up

File: inst-step-irq-decode.kicad_sch Sheet: / Trilobyte CPU

Id: 1/1 Title: Instruction Register & Step Counter
