theWickedWebDev/8-bit-computer/User Manual/MEM-Memory-Schematic.pdf

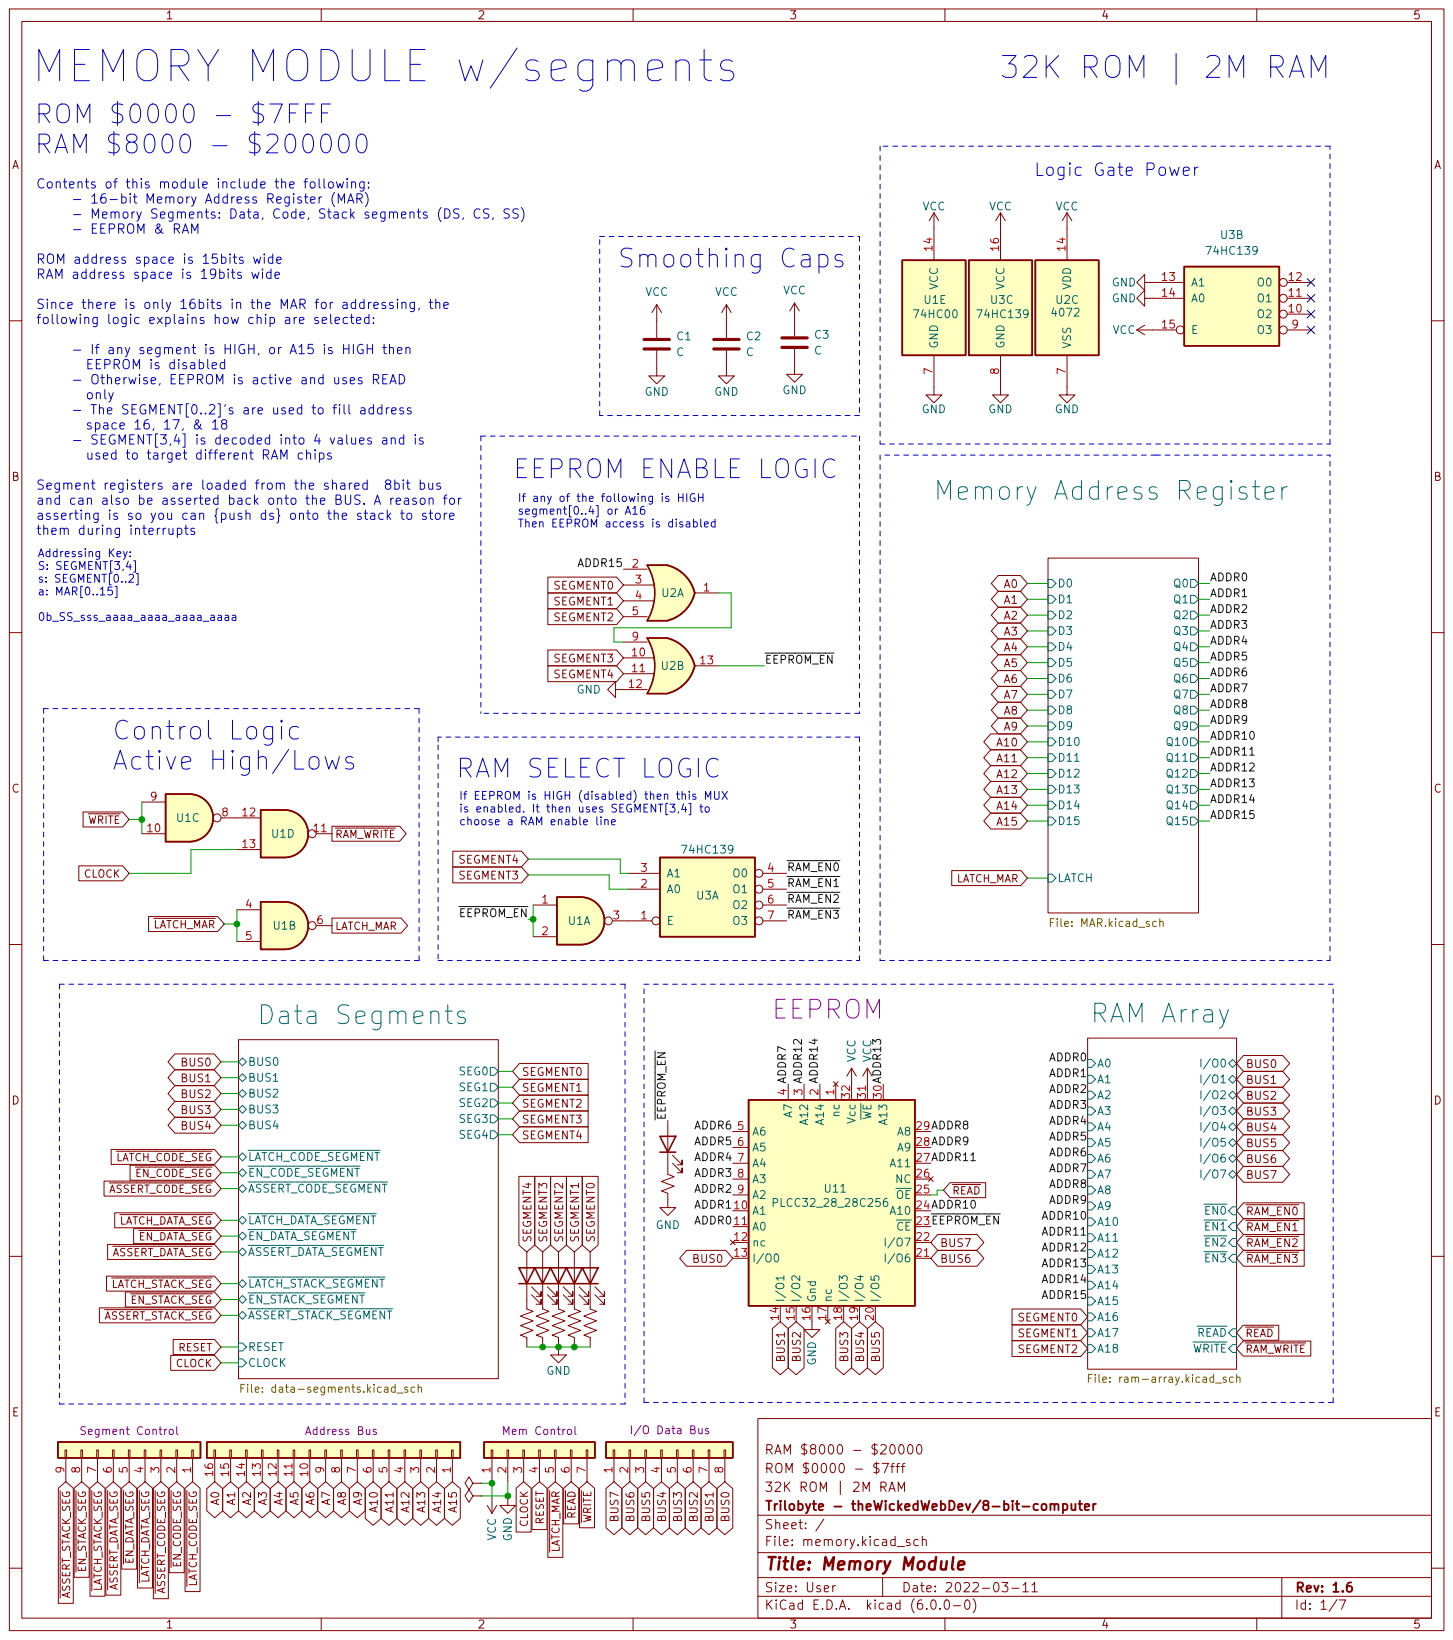
[picture p216: page 1]

Contents of this module include the following:
- 16-bit Memory Address Register (MAR)
- Memory Segments: Data, Code, Stack segments (DS, CS, SS)
- EEPROM & RAM

ROM address space is 15bits wide
RAM address space is 19bits wide

Since there is only 16bits in the MAR for addressing, the
following logic explains how chip are selected:

- If any segment is HIGH, or A15 is HIGH then
EEPROM is disabled
- Otherwise, EEPROM is active and uses READ
only
- The SEGMENT[0..2]'s are used to fill address
space 16, 17, & 18
- SEGMENT[3,4] is decoded into 4 values and is
used to target different RAM chips

and can also be asserted back onto the BUS. A reason for
asserting is so you can {push ds} onto the stack to store
them during interrupts

If any of the following is HIGH
segment[0..4] or A16
Then EEPROM access is disabled

If EEPROM is HIGH (disabled) then this MUX
is enabled. It then uses SEGMENT[3,4] to
choose a RAM enable line
EEPROM GND

Trilobyte - theWickedWebDev/8-bit-computer
Sheet: /
File: memory.kicad_sch
Title: Memory Module

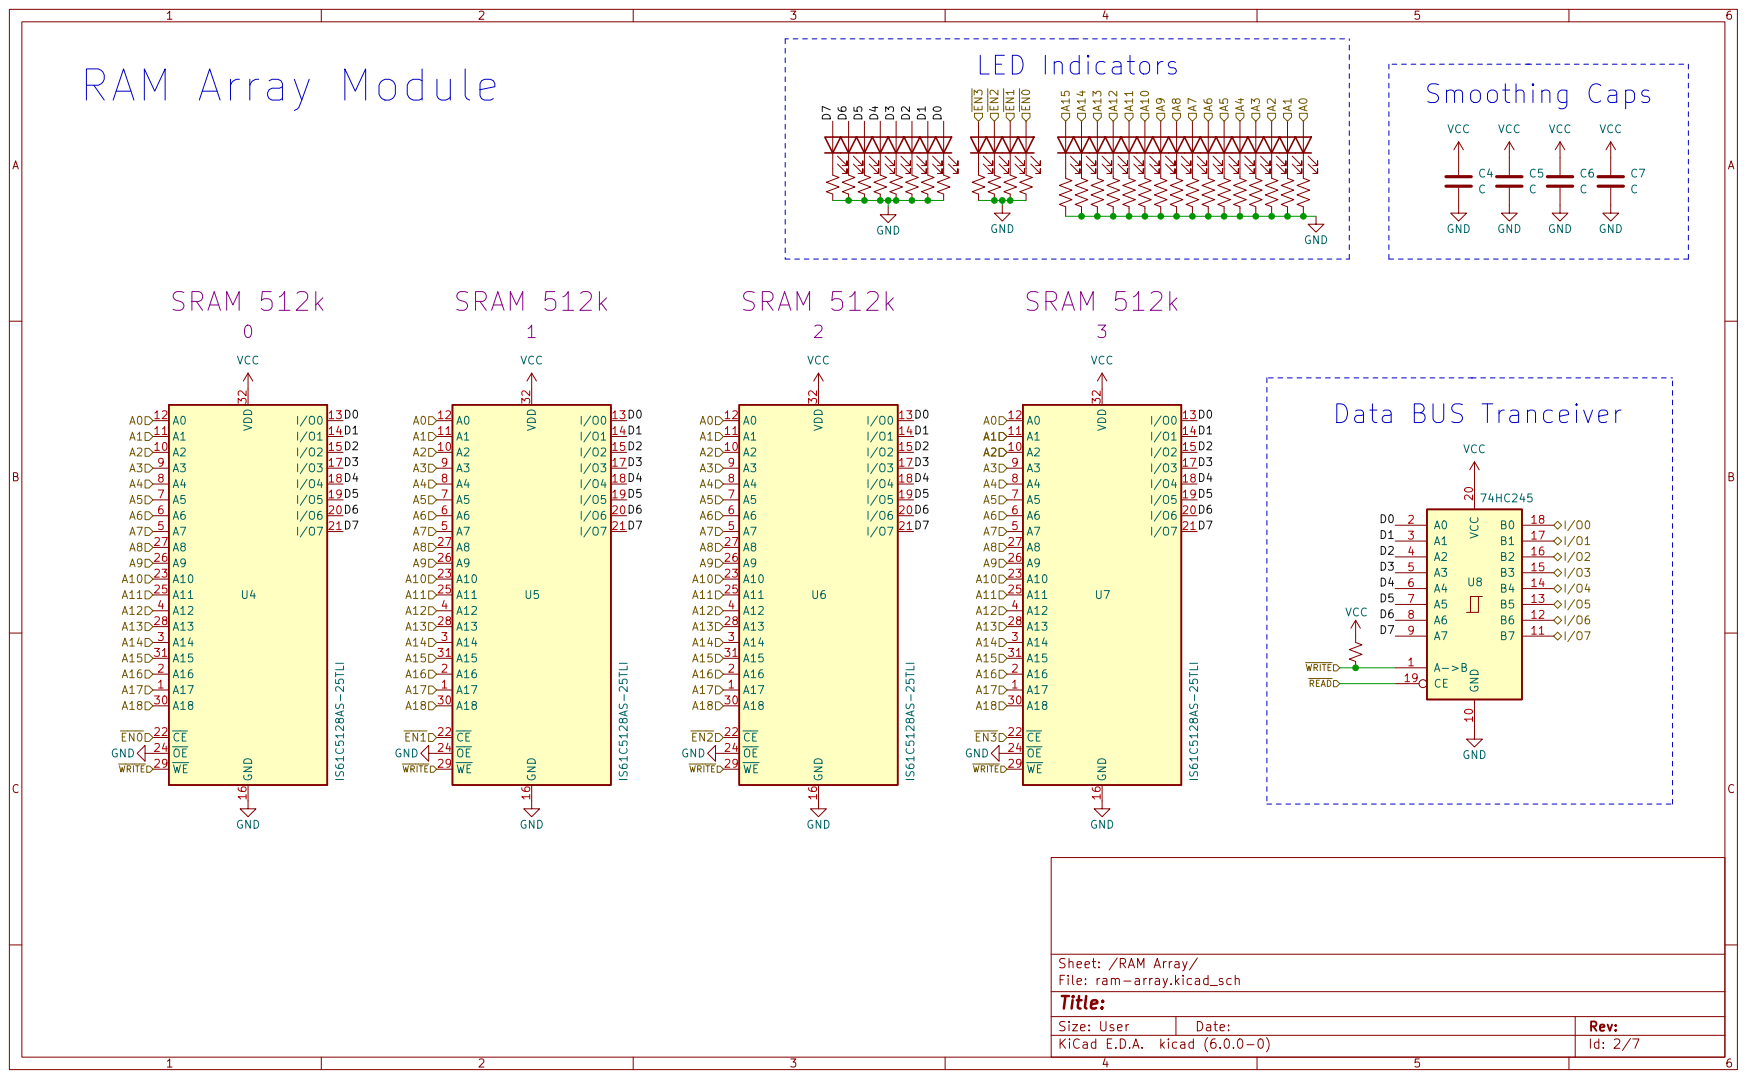
[picture p217: page 2]

LED Indicators RAM Array Module

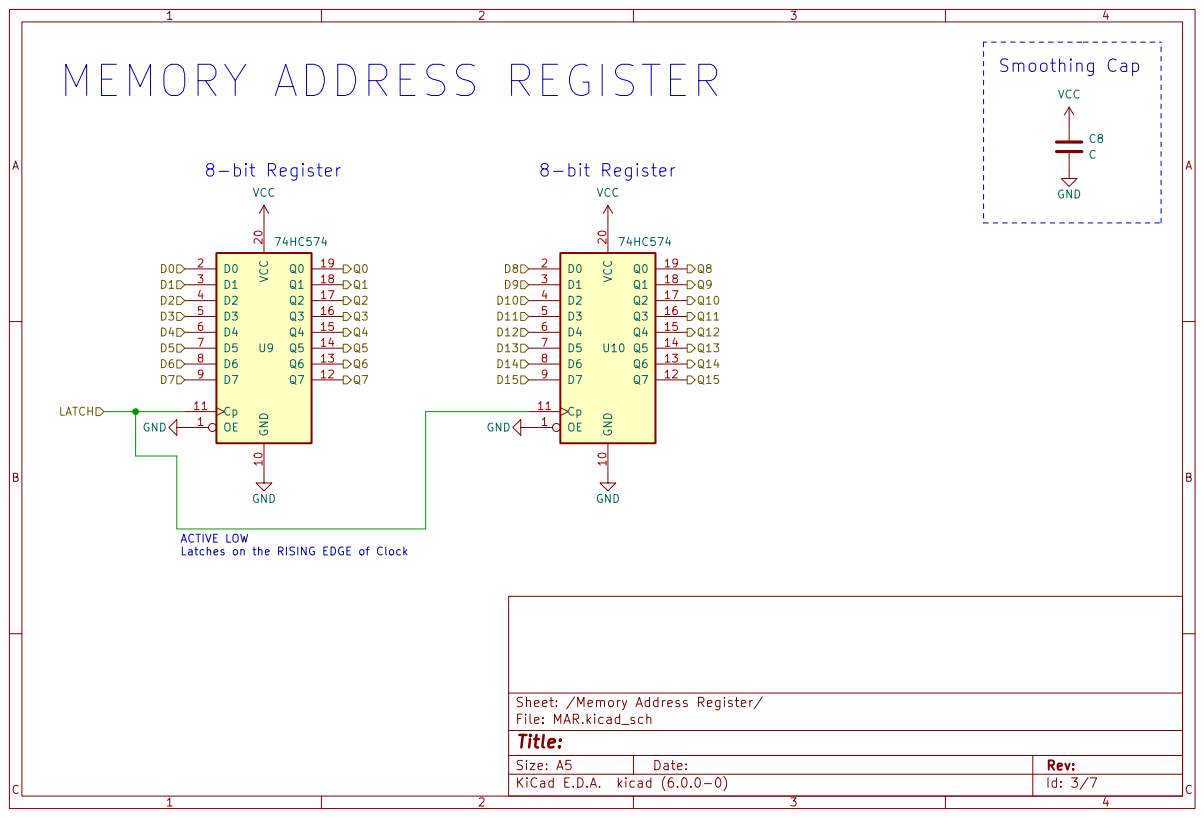
[picture p218: page 3]

ACTIVE LOW
Latches on the RISING EDGE of Clock

Sheet: /Memory Address Register/
File: MAR.kicad_sch
Title:

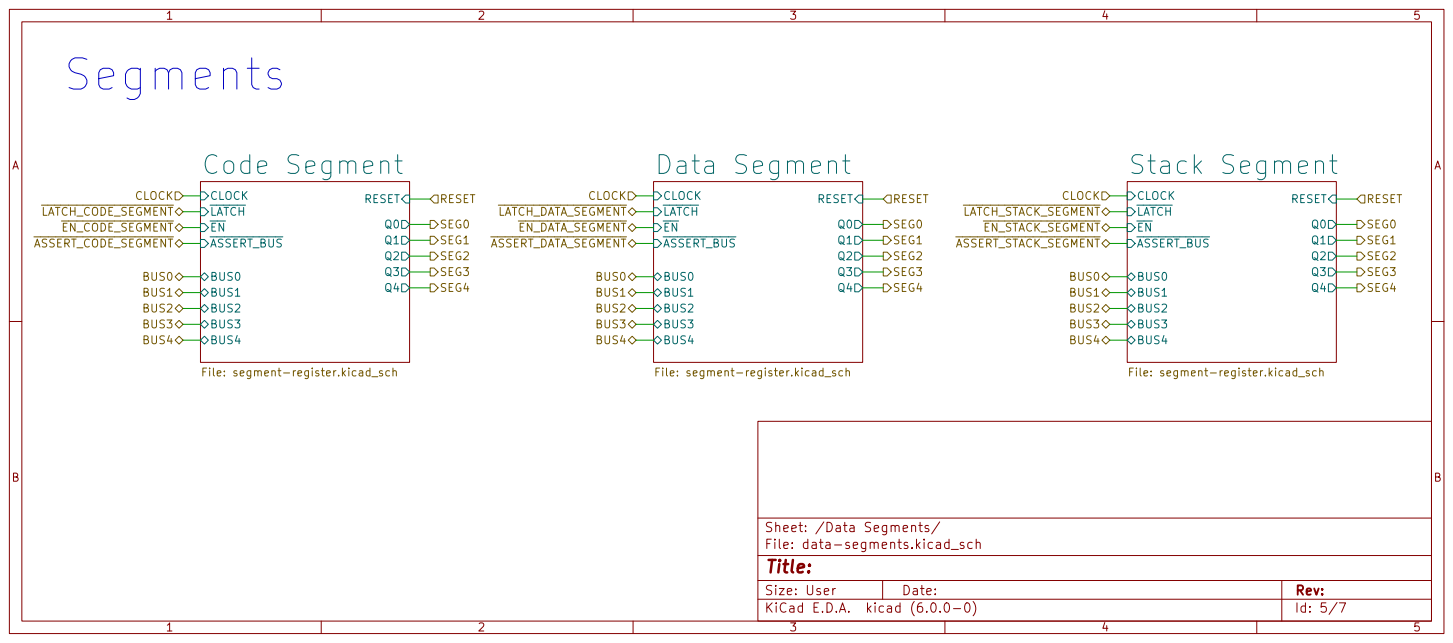
[picture p219: page 4]

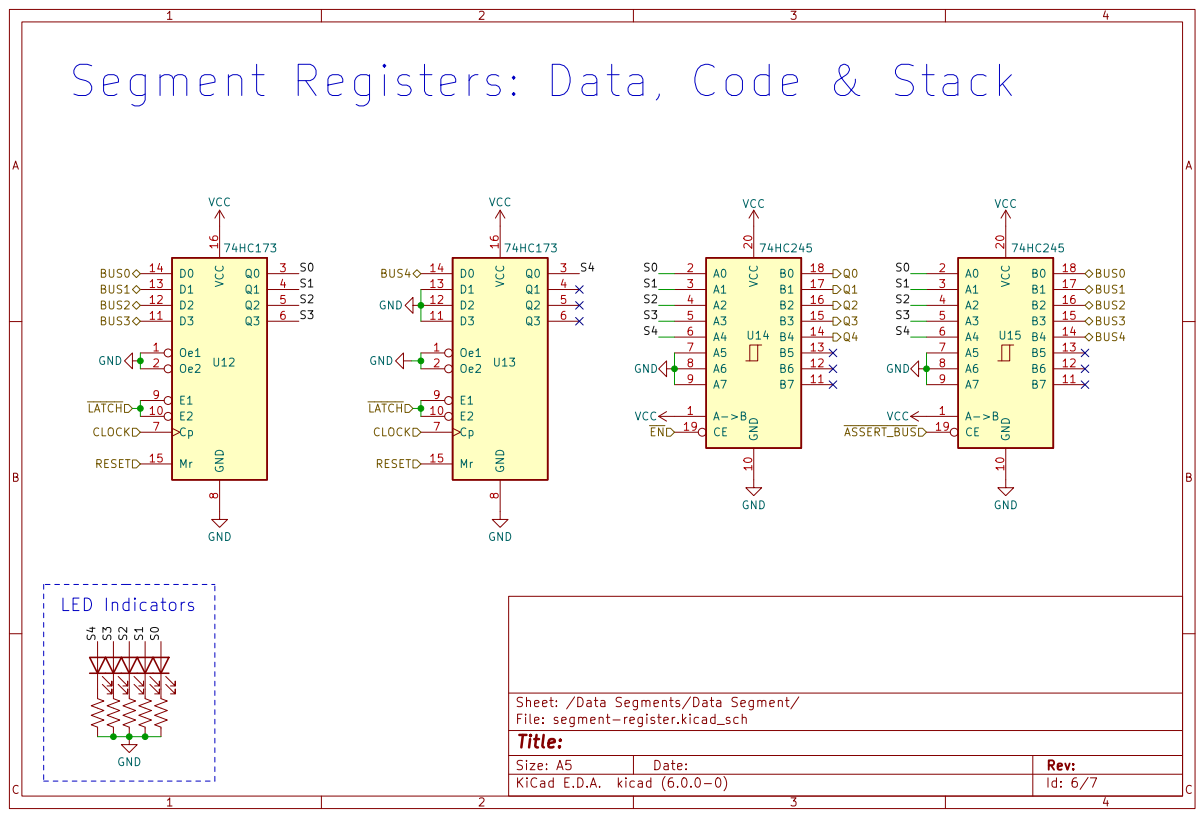
[picture p220: page 5]

Segment Registers: Data, Code & Stack

Sheet: /Data Segments/Data Segment/
File: segment-register.kicad_sch
Title:
