theWickedWebDev/8-bit-computer/DOCUMENTATION/PDFs/GPR-Schematic.pdf

GENERAL PURPOSE REGISTER ARRAY
on the bus on a LOW to HIGH transistion CONNECTIONS

MOV S3, S1S2 - 0xae (0b1_0101_110) RST/LD ALL

1 Control Bus VCC GND

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

Control Word Truth Table

GPR to GPR Control Words
-------------------- MOV C, D - 0x91 (0b1_0010_001)

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

File: Minified-Gpr.kicad_sch Sheet: / theWickedWebDev/8-bit-computer

Id: 1/1 Title: General Purpose Register Array
