theWickedWebDev/8-bit-computer/PCB-Modules/99_IN PROGRESS/READY-TO-PRINT/memory/RAM-MODULE-DATA SEGMENT.pdf

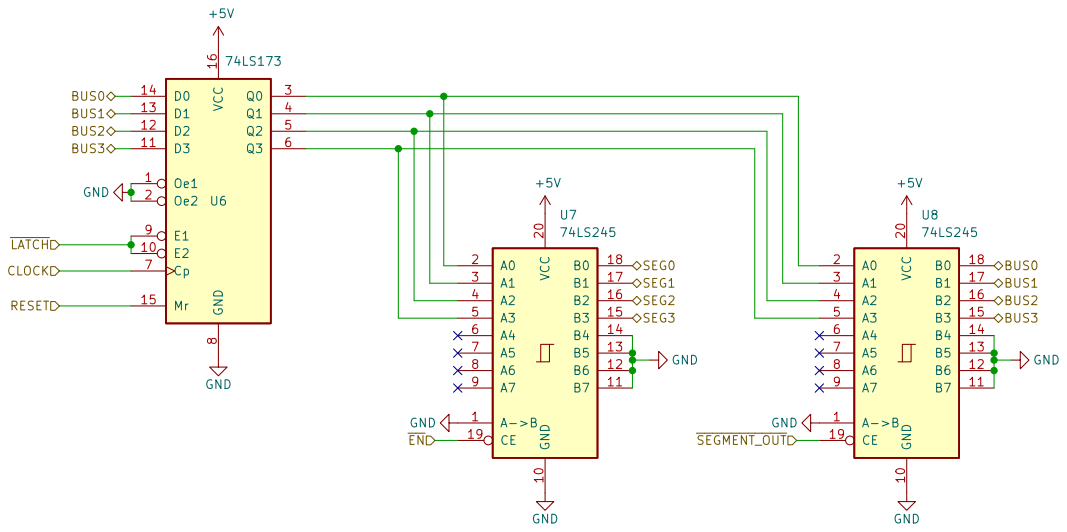
[picture p221: page 1]
