theWickedWebDev/8-bit-computer/PCBs/99_IN PROGRESS/IO-VGA-counter/VGA.pdf

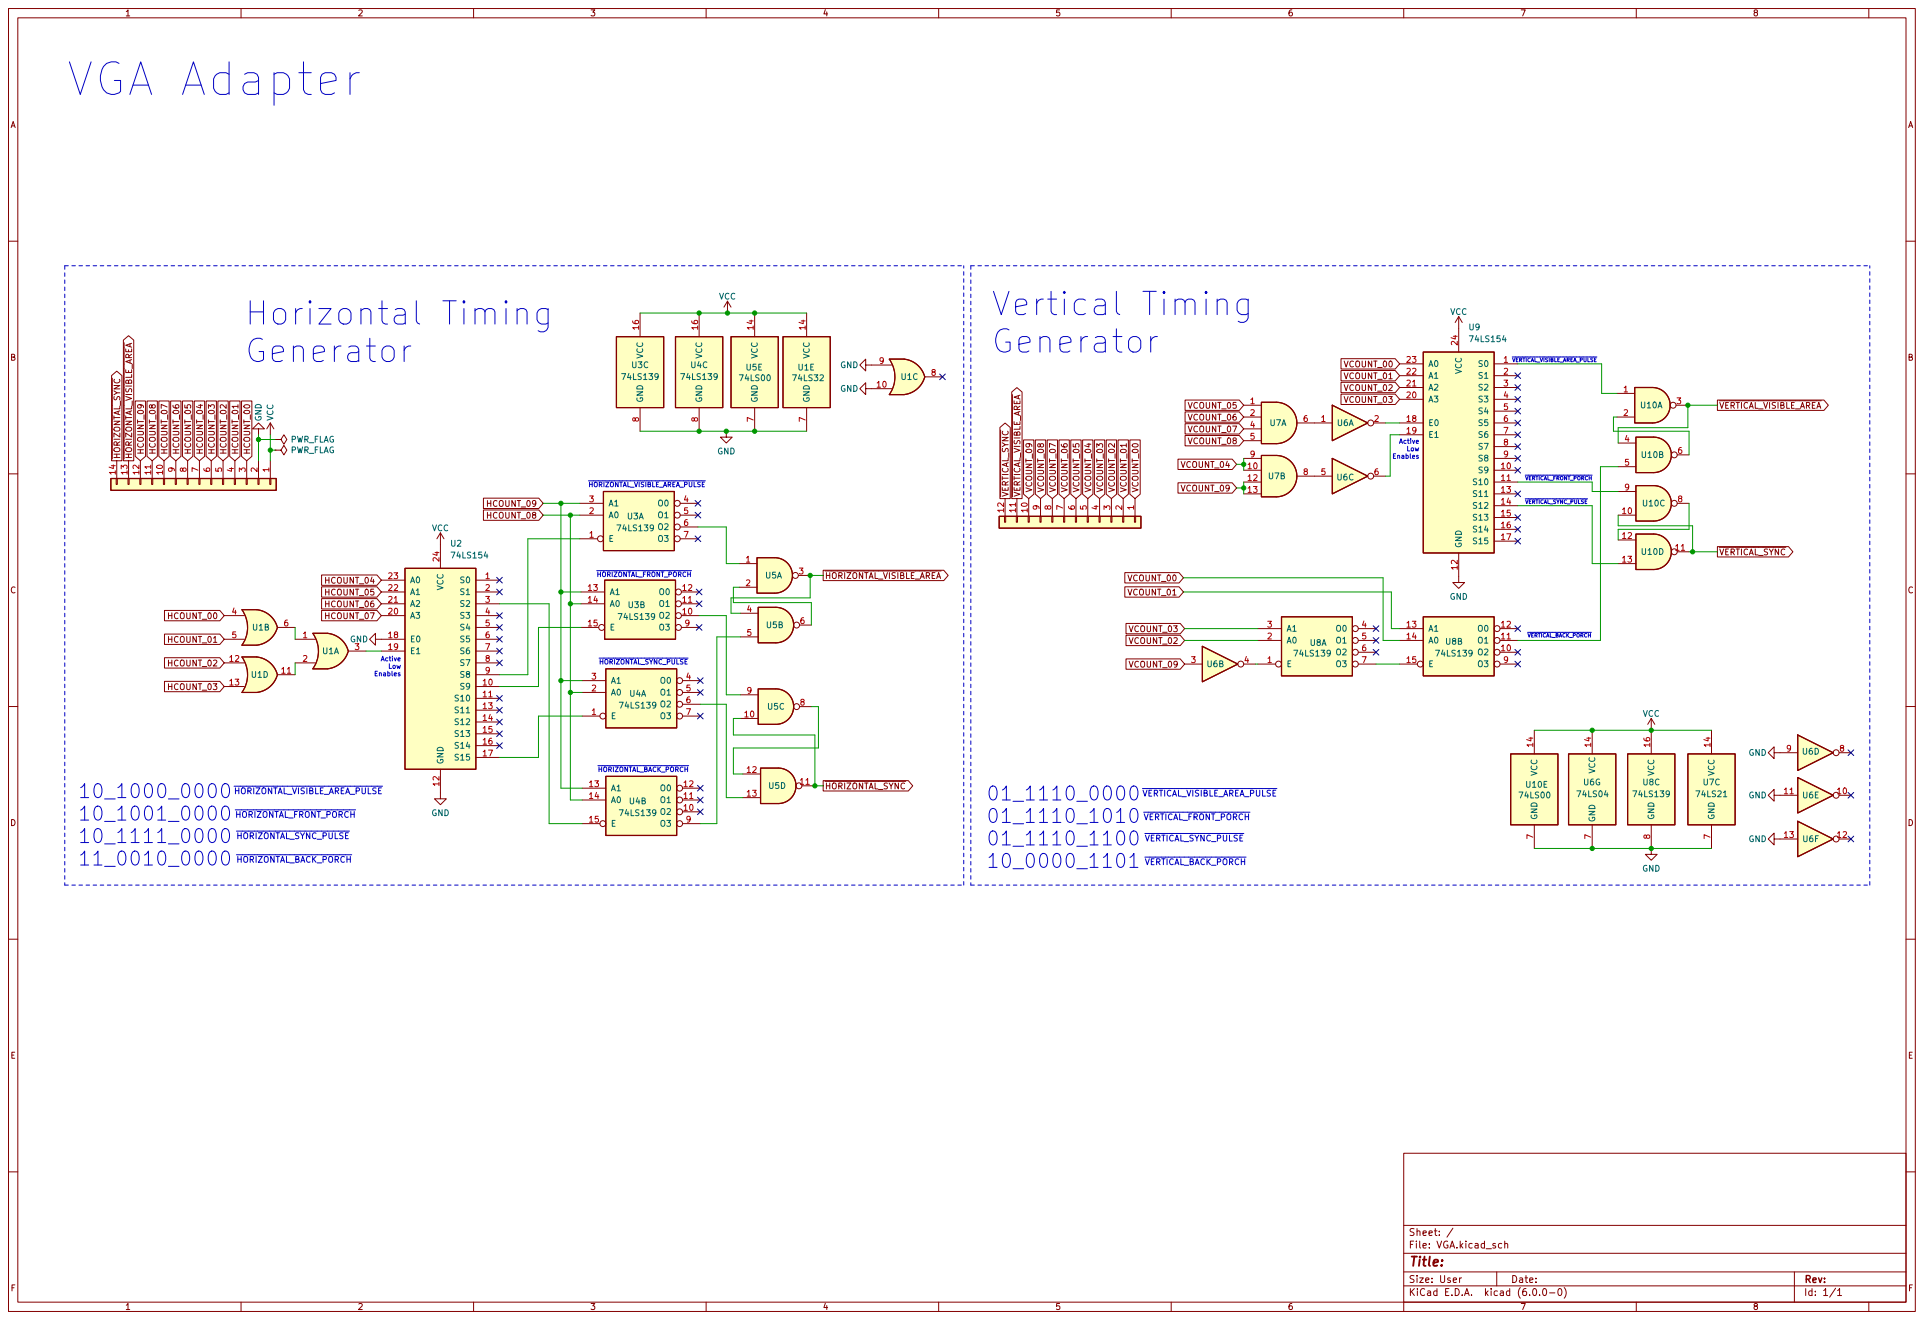
[picture p222: page 1]
