theWickedWebDev/8-bit-computer/PCBs/99_IN PROGRESS/Latest-Full-Backplane/Latest-Full-Backplane-board.pdf

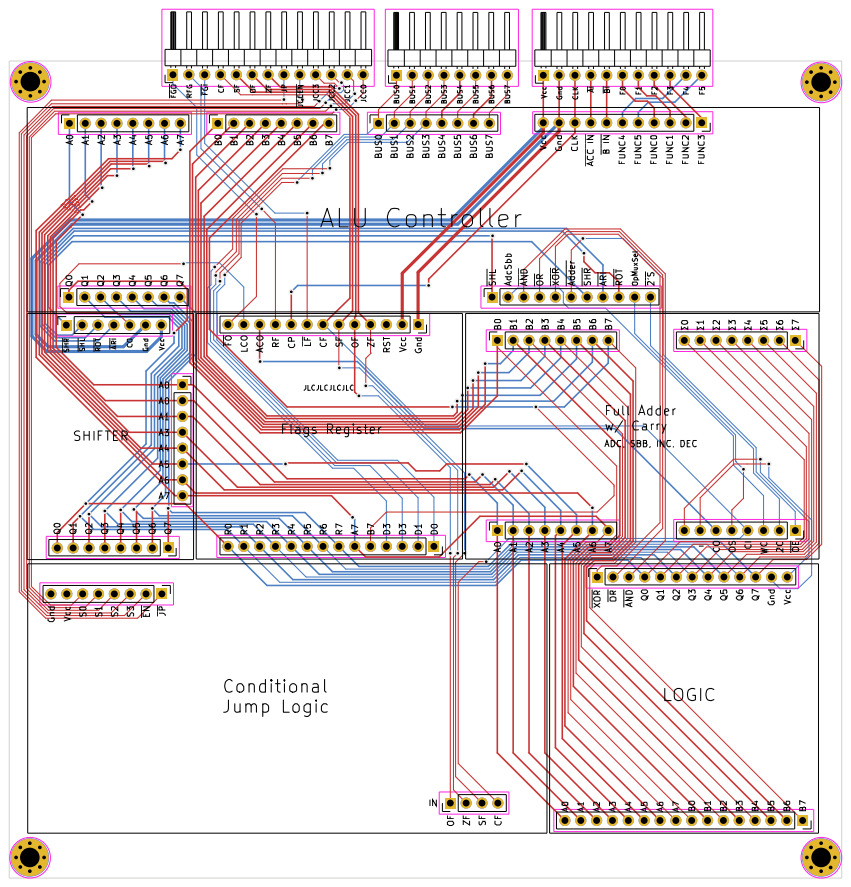
[picture p223: page 1]
