theWickedWebDev/8-bit-computer/PCBs/03_MODULES/CPU-ALU/ALU-Control_and_Output/alu-control-unit-board.pdf

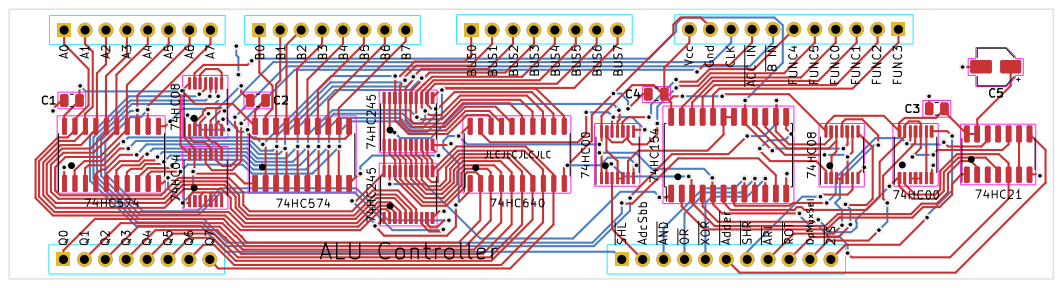
[picture p224: page 1]
