theWickedWebDev/8-bit-computer/PCBs/03_MODULES/CPU-ALU/ALU-Flags-Register/alu-flags-register-board.pdf

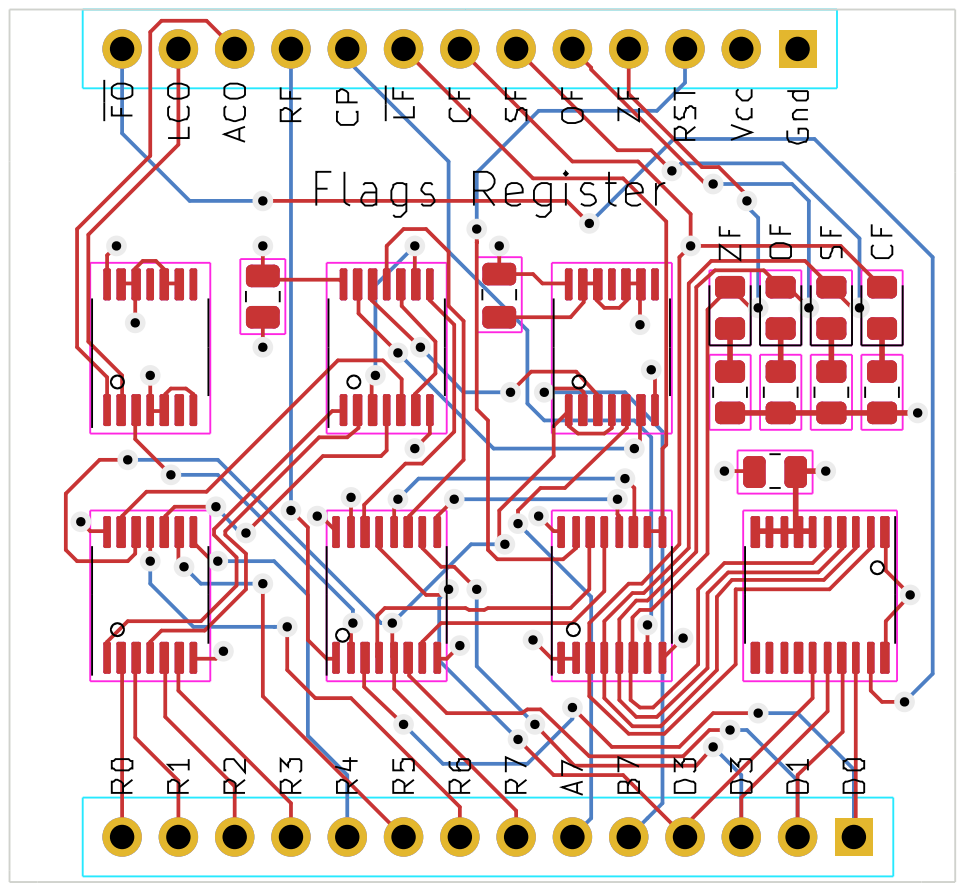
[picture p225: page 1]
