theWickedWebDev/8-bit-computer/PCBs/03_MODULES/CPU-ALU/ALU-Logic/alu-logic-gates-board.pdf

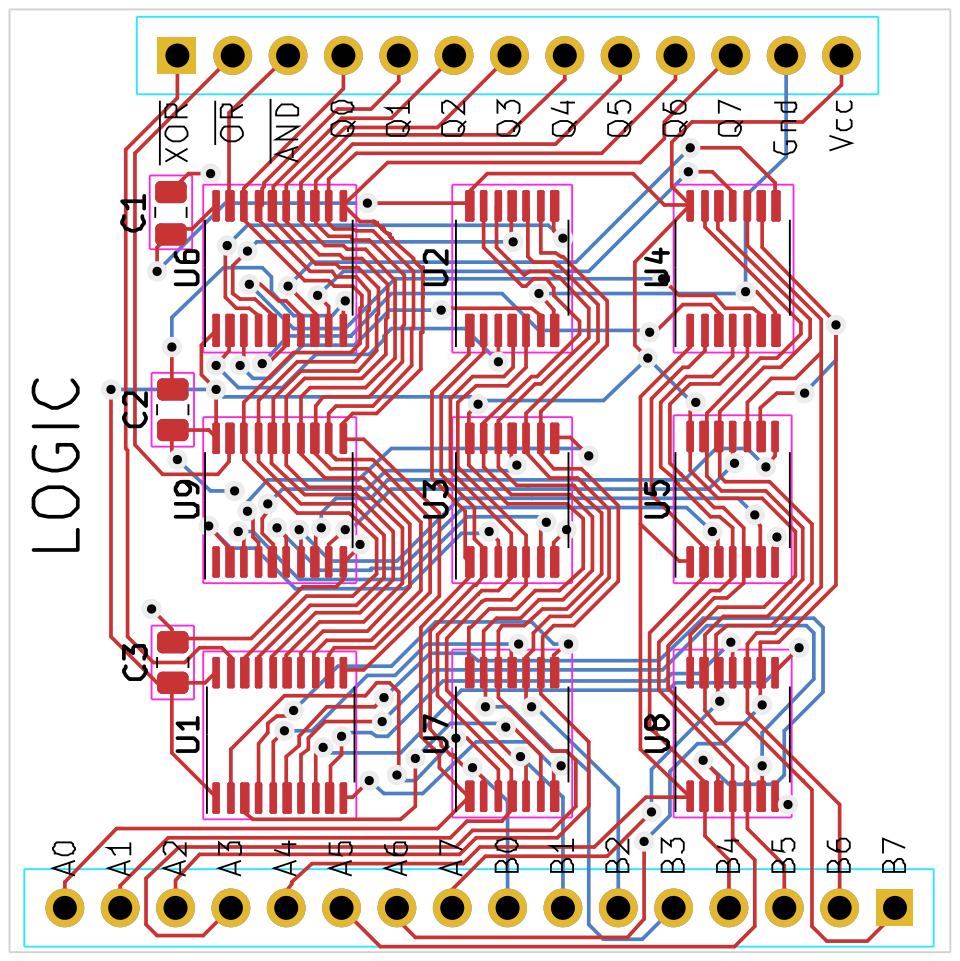
[picture p226: page 1]
