theWickedWebDev/8-bit-computer/PCBs/03_MODULES/CPU-ALU/ALU-Shifter/alu-shifter-board.pdf

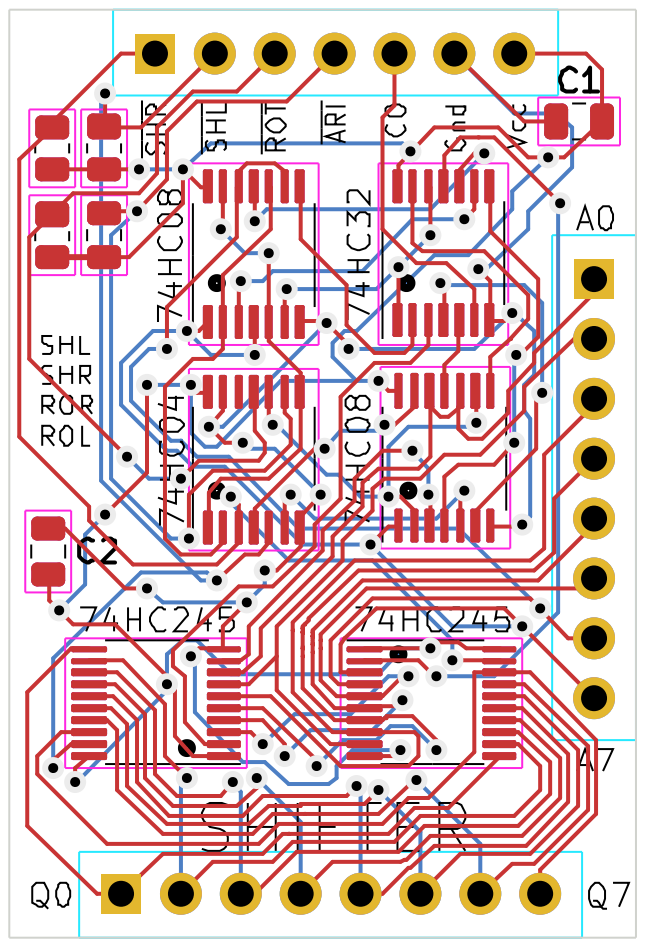
[picture p227: page 1]
