theWickedWebDev/8-bit-computer/(list of files, drawings)

Other design files:
Fritzing/VGA.fzz
Logism/8-BIT-COMPUTER/8-bit-computer.circ
Logism/ADSR.circ
Logism/eeprom_to_ram.circ
Logism/FIFO.circ
Logism/Intercom.circ
Logism/Midi.circ
Logism/TTL_Ram_Circuit.circ
Logism/UART.circ
Logism/Up_Down_Counter.circ
Logism/VGA2.circ
Logism/VGA.circ
Logism/VGA_counter_dips.circ
Logism/Work/ALU.circ
Modules/clock-module/Fritzing/CLOCK-breadboard.fzz
Modules/sound-module/fritzing/RAISED-BED-IRRIGATION.fzz
Modules/sound-module/fritzing/sound-controller 2.fzz
Modules/sound-module/fritzing/sound-controller 3.fzz
Modules/sound-module/fritzing/sound-controller.fzz
Modules/sound-module/fritzing/Waveform Function Generator.fzz
Modules/storage-register/Fritzing/register.fzz
