theWickedWebDev/8-bit-computer/PCBs/03_MODULES/CPU-ALU/ALU-Control_and_Output/Control_and_Output.kicad_pcb

## KiCad design PCBs/03_MODULES/CPU-ALU/ALU-Control_and_Output/Control_and_Output.kicad_pcb (2022-02-28)

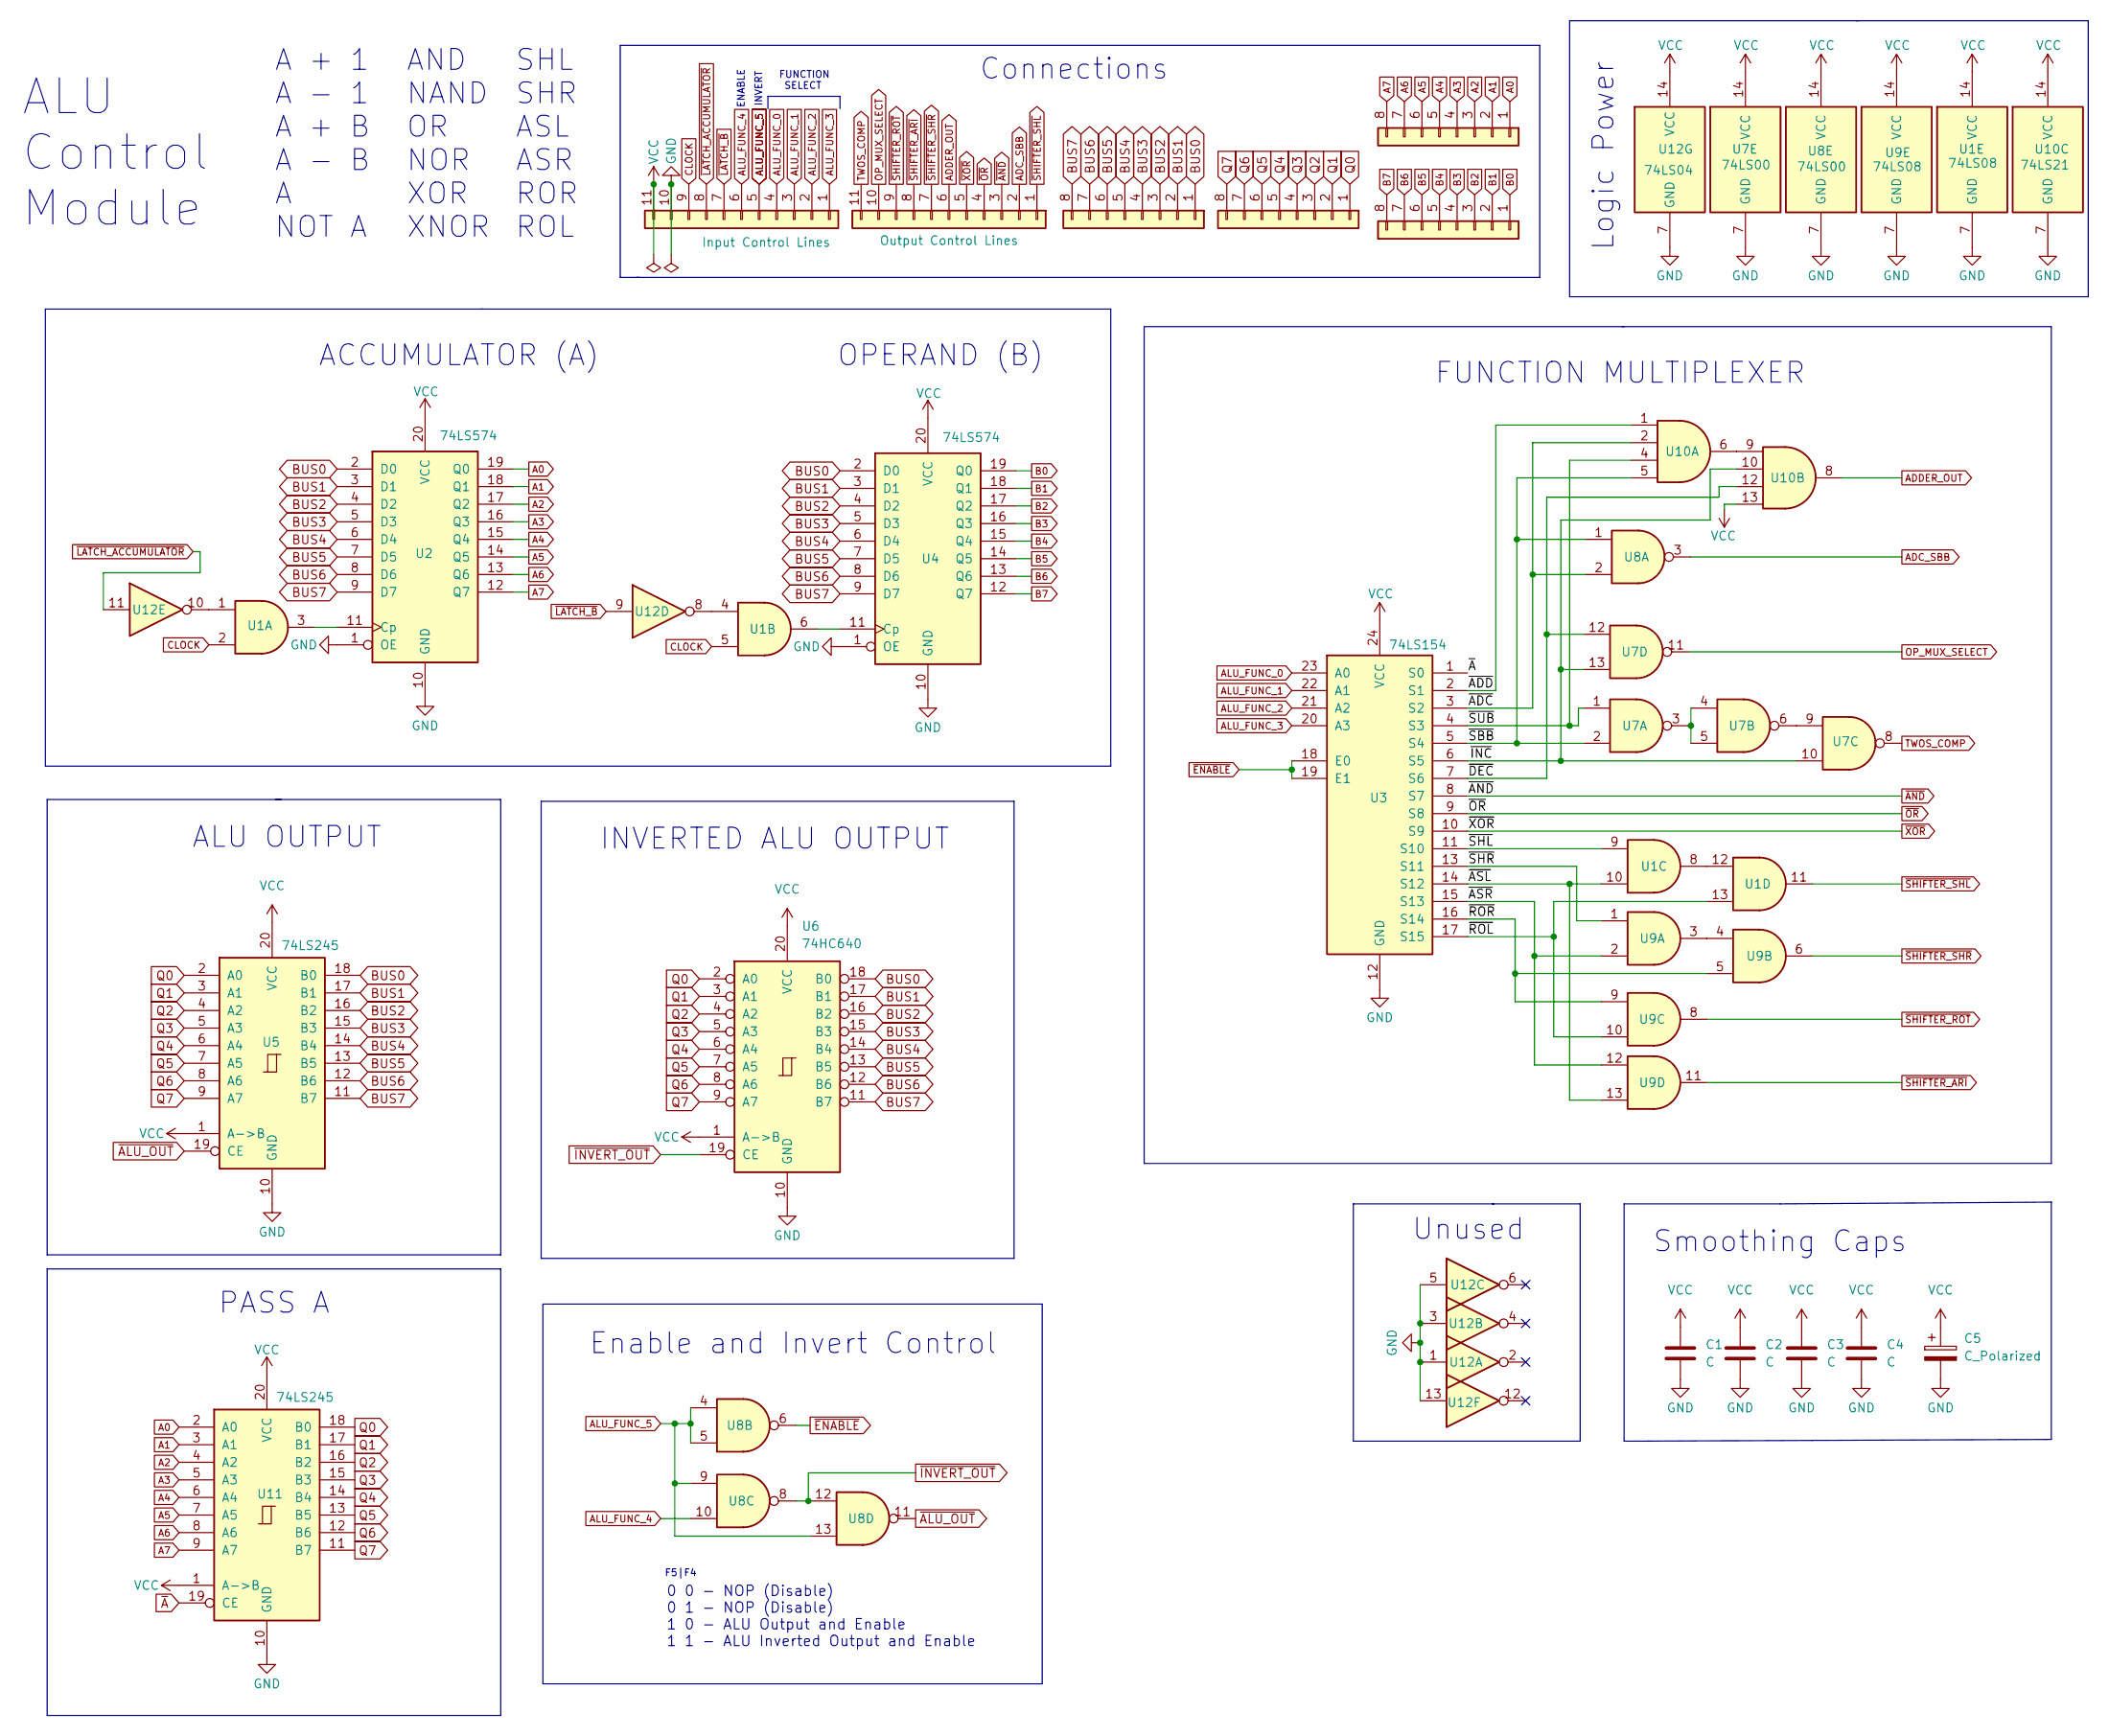
[picture p228: schematic Control_and_Output.kicad_sch]

Parts:
C1, C2, C3, C4: C; C_0805_2012Metric
C5: C_Polarized; CP_Elec_5x5.9
J1, J2, J4, J6: Conn_01x08; PinSocket_1x08_P2.54mm_Vertical
J3: Conn_01x11; PinHeader_1x11_P2.54mm_Vertical
J5: Conn_01x12; PinSocket_1x11_P2.54mm_Vertical
U1: 74LS08
U2, U4: 74LS574; SO-20_5.3x12.6mm_P1.27mm
U3: 74LS154; SOIC-24W_7.5x15.4mm_P1.27mm
U5, U11: 74LS245; TSSOP-20_4.4x6.5mm_P0.65mm
U6: 74HC640; SO-20_5.3x12.6mm_P1.27mm
U7: 74LS00; TSSOP-14_4.4x5mm_P0.65mm
U8: 74LS00
U9: 74LS08; TSSOP-14_4.4x5mm_P0.65mm
U10: 74LS21; SOIC-14_3.9x8.7mm_P1.27mm
U12: 74LS04

Connections:
/~ADC: U3.3 (S2), U8.2, U10.2
/~ADD: U3.2 (S1), U10.1
/~ASL: U1.10, U3.14 (S12), U9.13
/~ASR: U3.15 (S13), U9.2, U9.12
/~DEC: U3.7 (S6), U7.12, U10.12
/~INC: U3.6 (S5), U7.10, U7.13, U10.10
/~ROL: U1.13, U3.17 (S15), U9.10
/~ROR: U3.16 (S14), U9.5, U9.9
/~SBB: U3.5 (S4), U7.2, U8.1, U10.5
/~SHL: U1.9, U3.11 (S10)
/~SHR: U3.13 (S11), U9.1
/~SUB: U3.4 (S3), U7.1, U10.4
A0: J1.1, U2.19 (Q0), U11.2 (A0)
A1: J1.2, U2.18 (Q1), U11.3 (A1)
A2: J1.3, U2.17 (Q2), U11.4 (A2)
A3: J1.4, U2.16 (Q3), U11.5 (A3)
A4: J1.5, U2.15 (Q4), U11.6 (A4)
A5: J1.6, U2.14 (Q5), U11.7 (A5)
A6: J1.7, U2.13 (Q6), U11.8 (A6)
A7: J1.8, U2.12 (Q7), U11.9 (A7)
ADC_SBB: J3.2, U8.3
ADDER_OUT: J3.6, U10.8
ALU_FUNC_0: J5.4, U3.23 (A0)
ALU_FUNC_1: J5.3, U3.22 (A1)
ALU_FUNC_2: J5.2, U3.21 (A2)
ALU_FUNC_3: J5.1, U3.20 (A3)
ALU_FUNC_4: J5.6, U8.10
ALU_FUNC_5: J5.5, U8.4, U8.5, U8.9, U8.13
B0: J2.1, U4.19 (Q0)
B1: J2.2, U4.18 (Q1)
B2: J2.3, U4.17 (Q2)
B3: J2.4, U4.16 (Q3)
B4: J2.5, U4.15 (Q4)
B5: J2.6, U4.14 (Q5)
B6: J2.7, U4.13 (Q6)
B7: J2.8, U4.12 (Q7)
BUS0: J4.1, U2.2 (D0), U4.2 (D0), U5.18 (B0), U6.18 (B0)
BUS1: J4.2, U2.3 (D1), U4.3 (D1), U5.17 (B1), U6.17 (B1)
BUS2: J4.3, U2.4 (D2), U4.4 (D2), U5.16 (B2), U6.16 (B2)
BUS3: J4.4, U2.5 (D3), U4.5 (D3), U5.15 (B3), U6.15 (B3)
BUS4: J4.5, U2.6 (D4), U4.6 (D4), U5.14 (B4), U6.14 (B4)
BUS5: J4.6, U2.7 (D5), U4.7 (D5), U5.13 (B5), U6.13 (B5)
BUS6: J4.7, U2.8 (D6), U4.8 (D6), U5.12 (B6), U6.12 (B6)
BUS7: J4.8, U2.9 (D7), U4.9 (D7), U5.11 (B7), U6.11 (B7)
CLOCK: J5.9, U1.2, U1.5
GND: C1.2, C2.2, C3.2, C4.2, C5.2, J5.10, U1.7 (GND), U2.1 (OE), U2.10 (GND), U3.12 (GND), U4.1 (OE), U4.10 (GND), U5.10 (GND), U6.10 (GND), U7.7 (GND), U8.7 (GND), U9.7 (GND), U10.7 (GND), U11.10 (GND), U12.1, U12.3, U12.5, U12.7 (GND), U12.13
unnamed: U1.1, U12.10
unnamed: U1.3, U2.11 (Cp)
unnamed: U1.4, U12.8
unnamed: U1.6, U4.11 (Cp)
unnamed: U1.8, U1.12
unnamed: U7.3, U7.4, U7.5
unnamed: U7.6, U7.9
unnamed: U9.3, U9.4
unnamed: U10.6, U10.9
OP_MUX_SELECT: J3.10, U7.11
Q0: J6.1, U5.2 (A0), U6.2 (A0), U11.18 (B0)
Q1: J6.2, U5.3 (A1), U6.3 (A1), U11.17 (B1)
Q2: J6.3, U5.4 (A2), U6.4 (A2), U11.16 (B2)
Q3: J6.4, U5.5 (A3), U6.5 (A3), U11.15 (B3)
Q4: J6.5, U5.6 (A4), U6.6 (A4), U11.14 (B4)
Q5: J6.6, U5.7 (A5), U6.7 (A5), U11.13 (B5)
Q6: J6.7, U5.8 (A6), U6.8 (A6), U11.12 (B6)
Q7: J6.8, U5.9 (A7), U6.9 (A7), U11.11 (B7)
TWOS_COMP: J3.11, U7.8
VCC: C1.1, C2.1, C3.1, C4.1, C5.1, J5.11, U1.14 (VCC), U2.20 (VCC), U3.24 (VCC), U4.20 (VCC), U5.1 (A->B), U5.20 (VCC), U6.1 (A->B), U6.20 (VCC), U7.14 (VCC), U8.14 (VCC), U9.14 (VCC), U10.13, U10.14 (VCC), U11.1 (A->B), U11.20 (VCC), U12.14 (VCC)
~ALU_OUT: U5.19 (CE), U8.11
~AND: J3.3, U3.8 (S7)
~A: U3.1 (S0), U11.19 (CE)
~ENABLE: U3.18 (E0), U3.19 (E1), U8.6
~INVERT_OUT: U6.19 (CE), U8.8, U8.12
~LATCH_ACCUMULATOR: J5.8, U12.11
~LATCH_B: J5.7, U12.9
~OR: J3.4, U3.9 (S8)
~SHIFTER_ARI: J3.8, U9.11
~SHIFTER_ROT: J3.9, U9.8
~SHIFTER_SHL: J3.1, U1.11
~SHIFTER_SHR: J3.7, U9.6
~XOR: J3.5, U3.10 (S9)

Notes on the sheet:
Connections
INVERTED ALU OUTPUT
AND NAND OR NOR XOR XNOR
ALU Control Module
Unused
ALU OUTPUT
OPERAND (B)
PASS A
Logic Power
0 0 - NOP (Disable) 0 1 - NOP (Disable) 1 0 - ALU Output and Enable 1 1 - ALU Inverted Output and Enable
ENABLE
Enable and Invert Control
FUNCTION SELECT
F5|F4
INVERT
SHL SHR ASL ASR ROR ROL
FUNCTION MULTIPLEXER
A + 1 A - 1 A + B A - B A NOT A
ACCUMULATOR (A)
Smoothing Caps

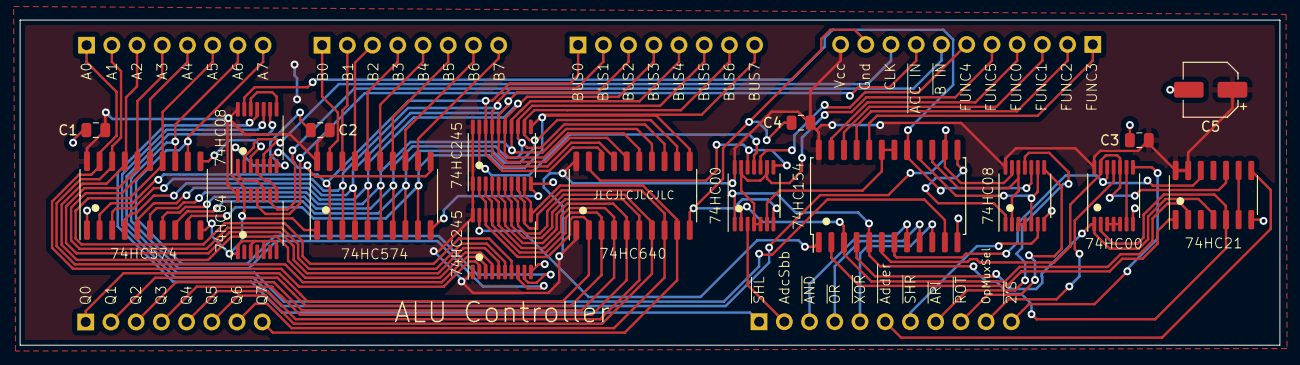
[picture p229: board Control_and_Output.kicad_pcb from above]

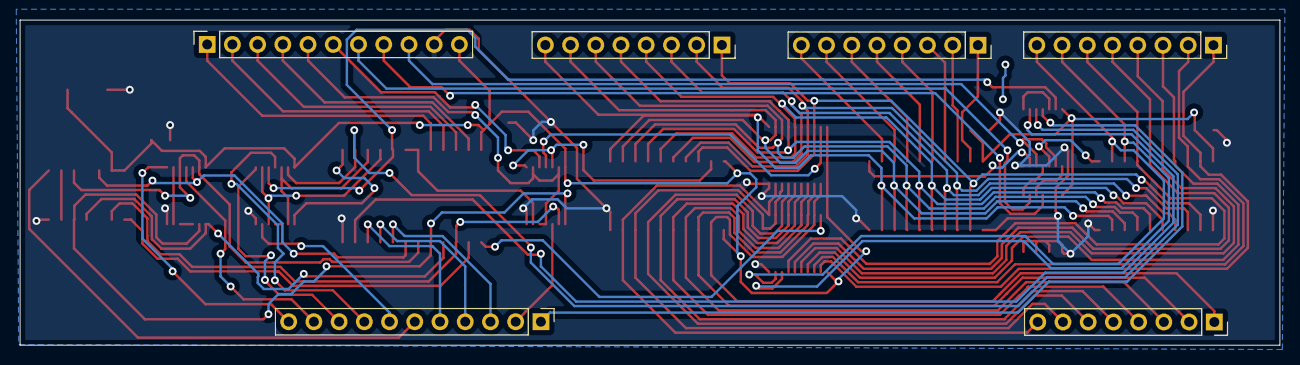
[picture p230: board Control_and_Output.kicad_pcb from below]

Board: 2 copper layers, 126.9 x 32.7 mm, 23 parts (6 on the bottom side), 79 nets.
