theWickedWebDev/8-bit-computer/PCBs/999-QUEUED-TO-PRINT/Interrupt-Handler/new-interrupt-handler.kicad_pcb

## KiCad design PCBs/999-QUEUED-TO-PRINT/Interrupt-Handler/new-interrupt-handler.kicad_pcb (2022-11-09)

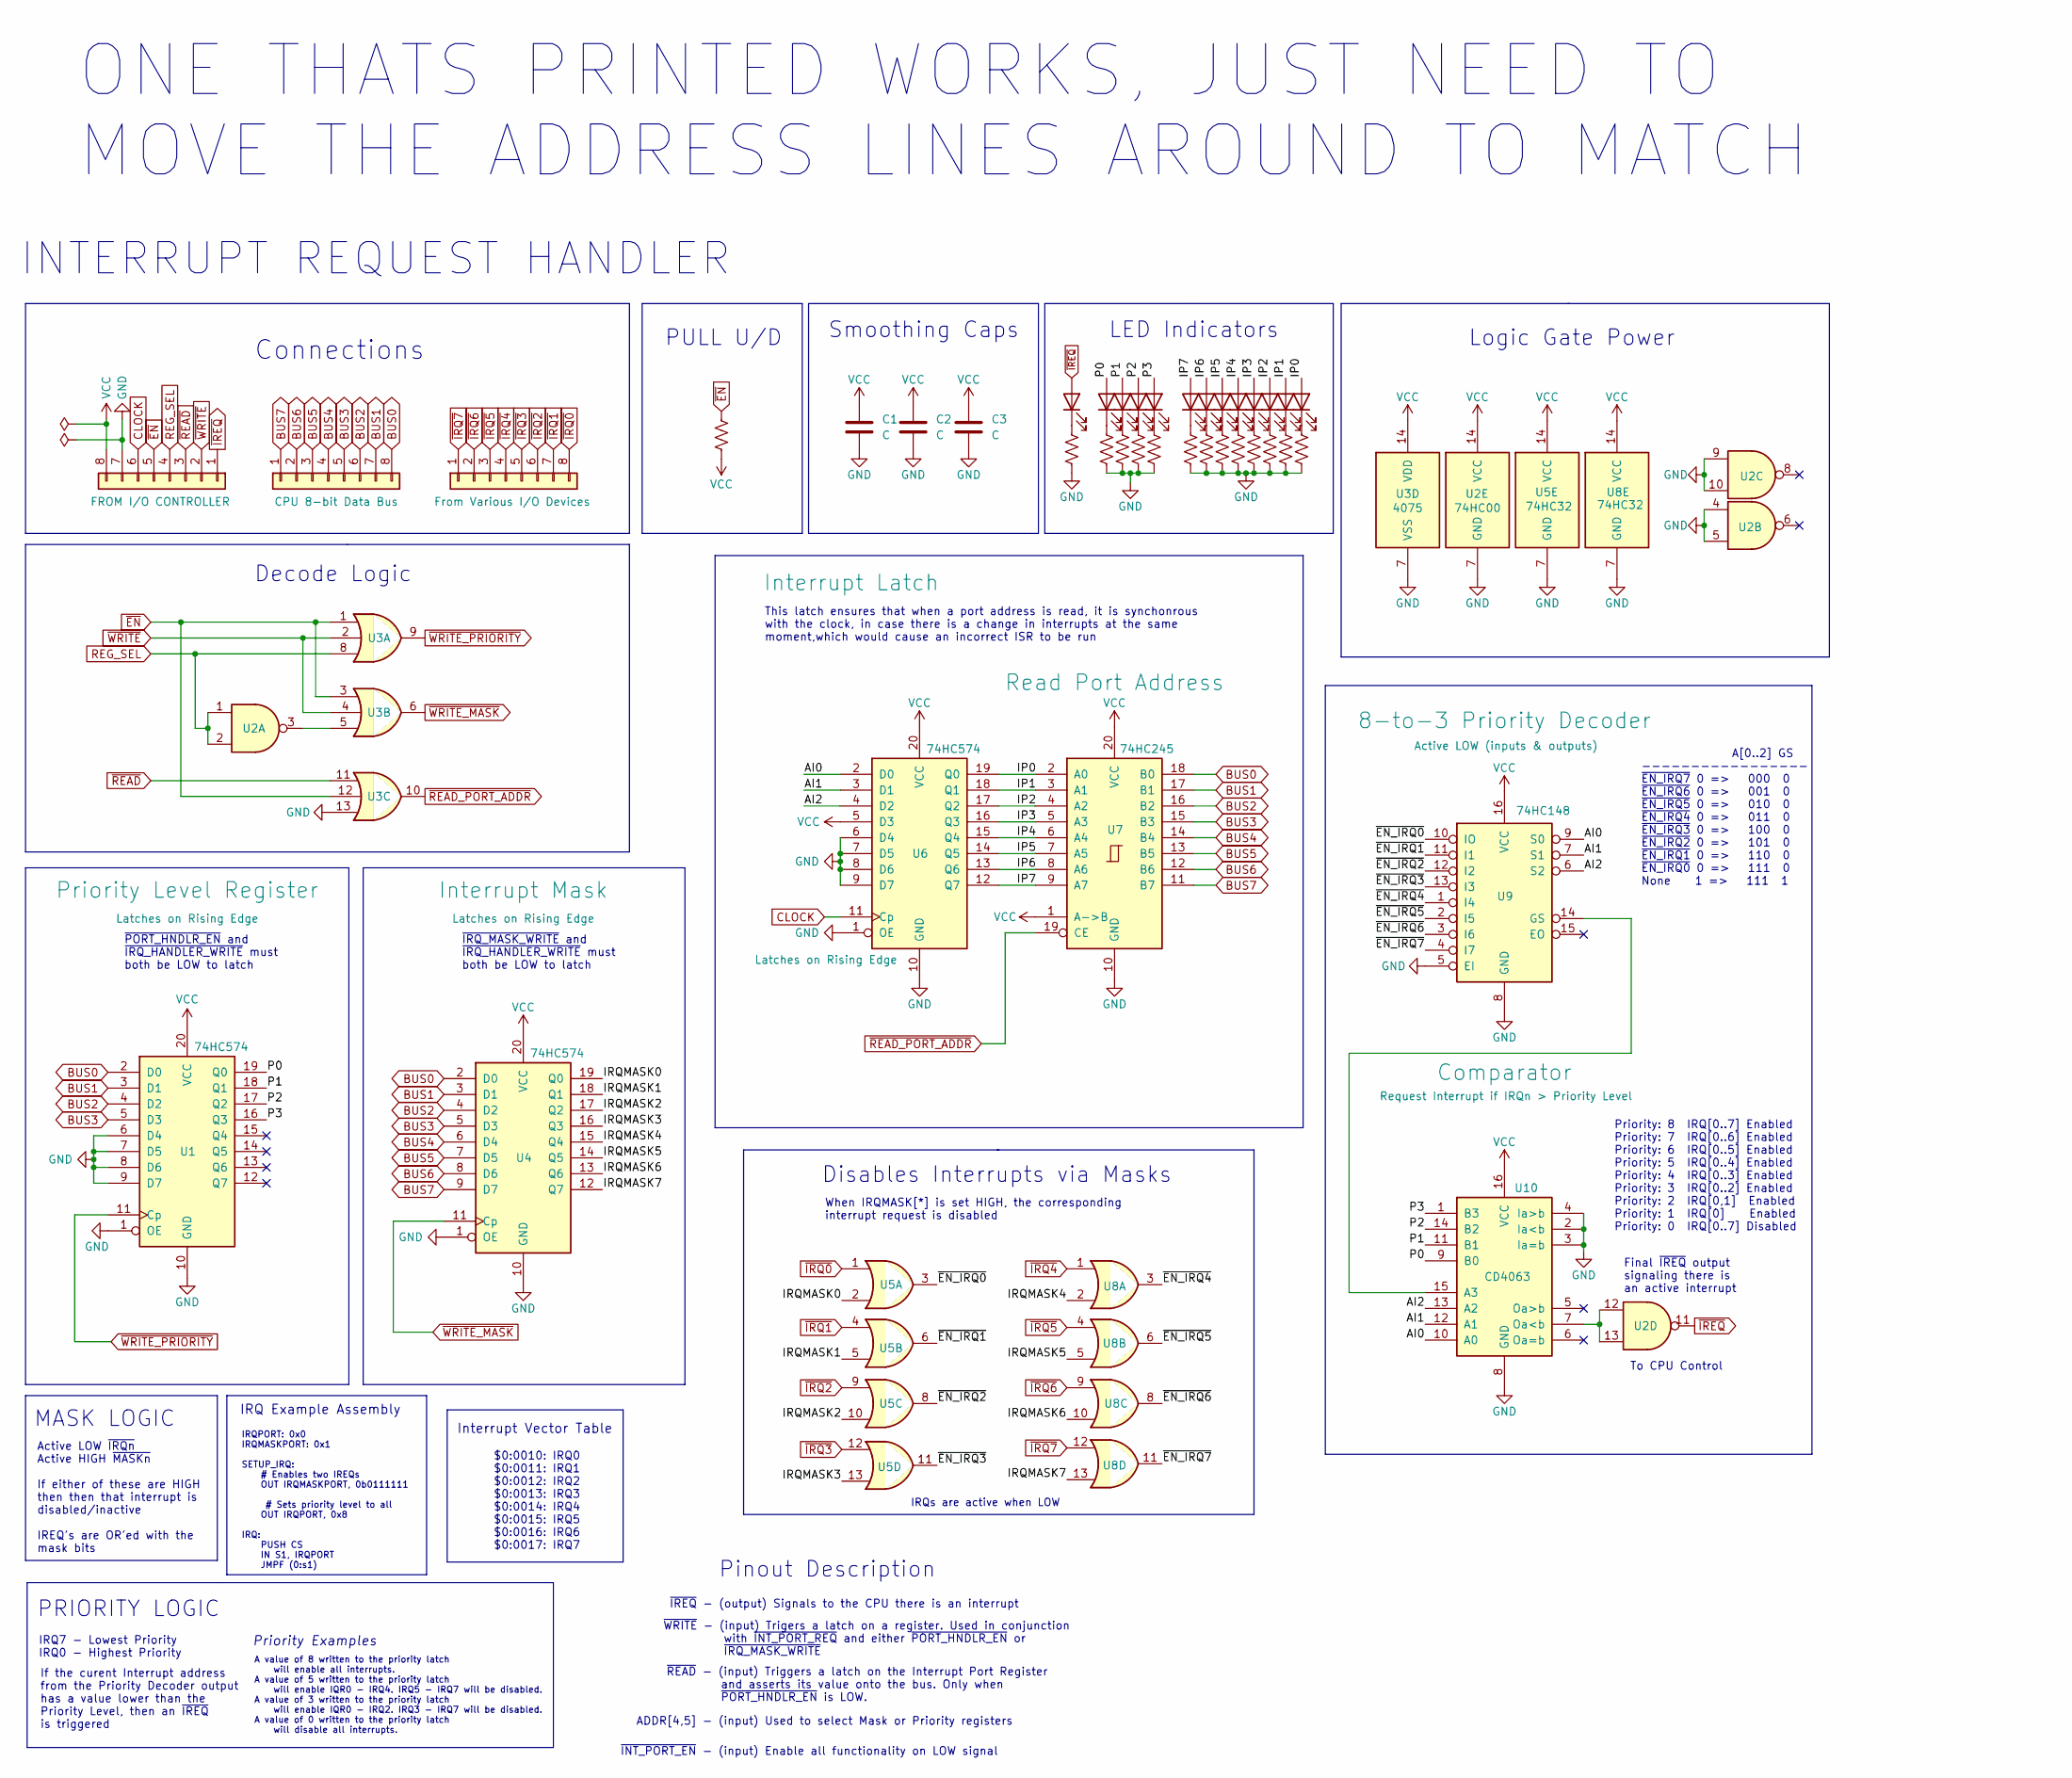
[picture p231: schematic new-interrupt-handler.kicad_sch, Interrpt Request Handler Module]

Parts:
C1, C2, C3: C; C_0805_2012Metric
D1, D2, D3, D4, D5, D6, D7, D8, D9, D10, D11, D12, D13: LED; LED_0805_2012Metric
J1, J2, J3: Conn_01x08; PinHeader_1x08_P2.54mm_Vertical
R1, R2, R3, R4, R5, R6, R7, R8, R9, R10, R11, R12, R13, R14: R_US; R_0805_2012Metric
U1, U4, U6: 74HC574; SO-20_5.3x12.6mm_P1.27mm
U2: 74HC00; TSSOP-14_4.4x5mm_P0.65mm
U3: 4075
U5, U8: 74HC32; TSSOP-14_4.4x5mm_P0.65mm
U7: 74HC245; TSSOP-20_4.4x6.5mm_P0.65mm
U9: 74HC148; SOIC-16_4.55x10.3mm_P1.27mm
U10: CD4063; SO-16_5.3x10.2mm_P1.27mm

Connections:
/AI0: U6.2 (D0), U9.9 (S0), U10.10 (A0)
/AI1: U6.3 (D1), U9.7 (S1), U10.12 (A1)
/AI2: U6.4 (D2), U9.6 (S2), U10.13 (A2)
/IP0: D13.2 (A), U6.19 (Q0), U7.2 (A0)
/IP1: D12.2 (A), U6.18 (Q1), U7.3 (A1)
/IP2: D11.2 (A), U6.17 (Q2), U7.4 (A2)
/IP3: D10.2 (A), U6.16 (Q3), U7.5 (A3)
/IP4: D9.2 (A), U6.15 (Q4), U7.6 (A4)
/IP5: D8.2 (A), U6.14 (Q5), U7.7 (A5)
/IP6: D7.2 (A), U6.13 (Q6), U7.8 (A6)
/IP7: D6.2 (A), U6.12 (Q7), U7.9 (A7)
/IRQMASK0: U4.19 (Q0), U5.2
/IRQMASK1: U4.18 (Q1), U5.5
/IRQMASK2: U4.17 (Q2), U5.10
/IRQMASK3: U4.16 (Q3), U5.13
/IRQMASK4: U4.15 (Q4), U8.2
/IRQMASK5: U4.14 (Q5), U8.5
/IRQMASK6: U4.13 (Q6), U8.10
/IRQMASK7: U4.12 (Q7), U8.13
/P0: D2.2 (A), U1.19 (Q0), U10.9 (B0)
/P1: D3.2 (A), U1.18 (Q1), U10.11 (B1)
/P2: D4.2 (A), U1.17 (Q2), U10.14 (B2)
/P3: D5.2 (A), U1.16 (Q3), U10.1 (B3)
/~EN_IRQ0: U5.3, U9.10 (IO)
/~EN_IRQ1: U5.6, U9.11 (I1)
/~EN_IRQ2: U5.8, U9.12 (I2)
/~EN_IRQ3: U5.11, U9.13 (I3)
/~EN_IRQ4: U8.3, U9.1 (I4)
/~EN_IRQ5: U8.6, U9.2 (I5)
/~EN_IRQ6: U8.8, U9.3 (I6)
/~EN_IRQ7: U8.11, U9.4 (I7)
BUS0: J2.8, U1.2 (D0), U4.2 (D0), U7.18 (B0)
BUS1: J2.7, U1.3 (D1), U4.3 (D1), U7.17 (B1)
BUS2: J2.6, U1.4 (D2), U4.4 (D2), U7.16 (B2)
BUS3: J2.5, U1.5 (D3), U4.5 (D3), U7.15 (B3)
BUS4: J2.4, U4.6 (D4), U7.14 (B4)
BUS5: J2.3, U4.7 (D5), U7.13 (B5)
BUS6: J2.2, U4.8 (D6), U7.12 (B6)
BUS7: J2.1, U4.9 (D7), U7.11 (B7)
CLOCK: J1.6, U6.11 (Cp)
GND: C1.2, C2.2, C3.2, J1.7, R2.2, R3.2, R4.2, R5.2, R6.2, R7.2, R8.2, R9.2, R10.2, R11.2, R12.2, R13.2, R14.2, U1.1 (OE), U1.6 (D4), U1.7 (D5), U1.8 (D6), U1.9 (D7), U1.10 (GND), U2.4, U2.5, U2.7 (GND), U2.9, U2.10, U3.7 (VSS), U3.13, U4.1 (OE), U4.10 (GND), U5.7 (GND), U6.1 (OE), U6.6 (D4), U6.7 (D5), U6.8 (D6), U6.9 (D7), U6.10 (GND), U7.10 (GND), U8.7 (GND), U9.5 (EI), U9.8 (GND), U10.2 (Ia<b), U10.3 (Ia=b), U10.4 (Ia>b), U10.8 (GND)
unnamed: D1.1 (K), R2.1
unnamed: D2.1 (K), R3.1
unnamed: D3.1 (K), R4.1
unnamed: D4.1 (K), R5.1
unnamed: D5.1 (K), R6.1
unnamed: D6.1 (K), R7.1
unnamed: D7.1 (K), R8.1
unnamed: D8.1 (K), R9.1
unnamed: D9.1 (K), R10.1
unnamed: D10.1 (K), R11.1
unnamed: D11.1 (K), R12.1
unnamed: D12.1 (K), R13.1
unnamed: D13.1 (K), R14.1
unnamed: U2.3, U3.5
unnamed: U2.12, U2.13, U10.7 (Oa<b)
unnamed: U9.14 (GS), U10.15 (A3)
REG_SEL: J1.4, U2.1, U2.2, U3.8
VCC: C1.1, C2.1, C3.1, J1.8, R1.2, U1.20 (VCC), U2.14 (VCC), U3.14 (VDD), U4.20 (VCC), U5.14 (VCC), U6.5 (D3), U6.20 (VCC), U7.1 (A->B), U7.20 (VCC), U8.14 (VCC), U9.16 (VCC), U10.16 (VCC)
~EN: J1.5, R1.1, U3.1, U3.3, U3.12
~IREQ: D1.2 (A), J1.1, U2.11
~IRQ0: J3.8, U5.1
~IRQ1: J3.7, U5.4
~IRQ2: J3.6, U5.9
~IRQ3: J3.5, U5.12
~IRQ4: J3.4, U8.1
~IRQ5: J3.3, U8.4
~IRQ6: J3.2, U8.9
~IRQ7: J3.1, U8.12
~READ_PORT_ADDR: U3.10, U7.19 (CE)
~READ: J1.3, U3.11
~WRITE_MASK: U3.6, U4.11 (Cp)
~WRITE_PRIORITY: U1.11 (Cp), U3.9
~WRITE: J1.2, U3.2, U3.4

Notes on the sheet:
When IRQMASK[*] is set HIGH, the corresponding interrupt request is disabled
Disables Interrupts via Masks
IRQPORT: 0x0 IRQMASKPORT: 0x1 SETUP_IRQ: # Enables two IREQs OUT IRQMASKPORT, 0b0111111 # Sets priority level to all OUT IRQPORT, 0x8 IRQ: PUSH CS IN S1, IRQPORT JMPF (0:s1)
ONE THATS PRINTED WORKS, JUST NEED TO MOVE THE ADDRESS LINES AROUND TO MATCH
~{IRQ_MASK_WRITE} and ~{IRQ_HANDLER_WRITE} must both be LOW to latch
A[0..2] GS ----------------- ~{EN_IRQ7} 0 => 000 0 ~{EN_IRQ6} 0 => 001 0 ~{EN_IRQ5} 0 => 010 0 ~{EN_IRQ4} 0 => 011 0 ~{EN_IRQ3} 0 => 100 0 ~{EN_IRQ2} 0 => 101 0 ~{EN_IRQ1} 0 => 110 0 ~{EN_IRQ0} 0 => 111 0 None 1 => 111 1
Priority: 8 IRQ[0..7] Enabled Priority: 7 IRQ[0..6] Enabled Priority: 6 IRQ[0..5] Enabled Priority: 5 IRQ[0..4] Enabled Priority: 4 IRQ[0..3] Enabled Priority: 3 IRQ[0..2] Enabled Priority: 2 IRQ[0,1] Enabled Priority: 1 IRQ[0] Enabled Priority: 0 IRQ[0..7] Disabled
INTERRUPT REQUEST HANDLER
~{INT_PORT_EN} - (input) Enable all functionality on LOW signal
Pinout Description
LED Indicators
To CPU Control
IRQs are active when LOW
PULL U/D
$0:0010: IRQ0 $0:0011: IRQ1 $0:0012: IRQ2 $0:0013: IRQ3 $0:0014: IRQ4 $0:0015: IRQ5 $0:0016: IRQ6 $0:0017: IRQ7
~{WRITE} - (input) Trigers a latch on a register. Used in conjunction with ~{INT_PORT_REQ} and either ~{PORT_HNDLR_EN} or ~{IRQ_MASK_WRITE}
Logic Gate Power
~{IREQ} - (output) Signals to the CPU there is an interrupt
IRQ7 - Lowest Priority IRQ0 - Highest Priority
If the curent Interrupt address from the Priority Decoder output has a value lower than the Priority Level, then an ~{IREQ} is triggered
A value of 8 written to the priority latch will enable all interrupts. A value of 5 written to the priority latch will enable IQR0 - IRQ4. IRQ5 - IRQ7 will be disabled. A value of 3 written to the priority latch will enable IQR0 - IRQ2. IRQ3 - IRQ7 will be disabled. A value of 0 written to the prio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
Active LOW ~{IRQn} Active HIGH ~{MASKn} If either of these are HIGH then then that interrupt is disabled/inactive IREQ's are OR'ed with the mask bits
ADDR[4,5] - (input) Used to select Mask or Priority registers
MASK LOGIC
This latch ensures that when a port address is read, it is synchonrous with the clock, in case there is a change in interrupts at the same moment,which would cause an incorrect ISR to be run
Smoothing Caps
IRQ Example Assembly
Final ~{IREQ} output signaling there is an active interrupt
Priority Examples
~{PORT_HNDLR_EN} and ~{IRQ_HANDLER_WRITE} must both be LOW to latch
PRIORITY LOGIC
Decode Logic
~{READ} - (input) Triggers a latch on the Interrupt Port Register and asserts its value onto the bus. Only when ~{PORT_HNDLR_EN} is LOW.
Connections
Interrupt Vector Table

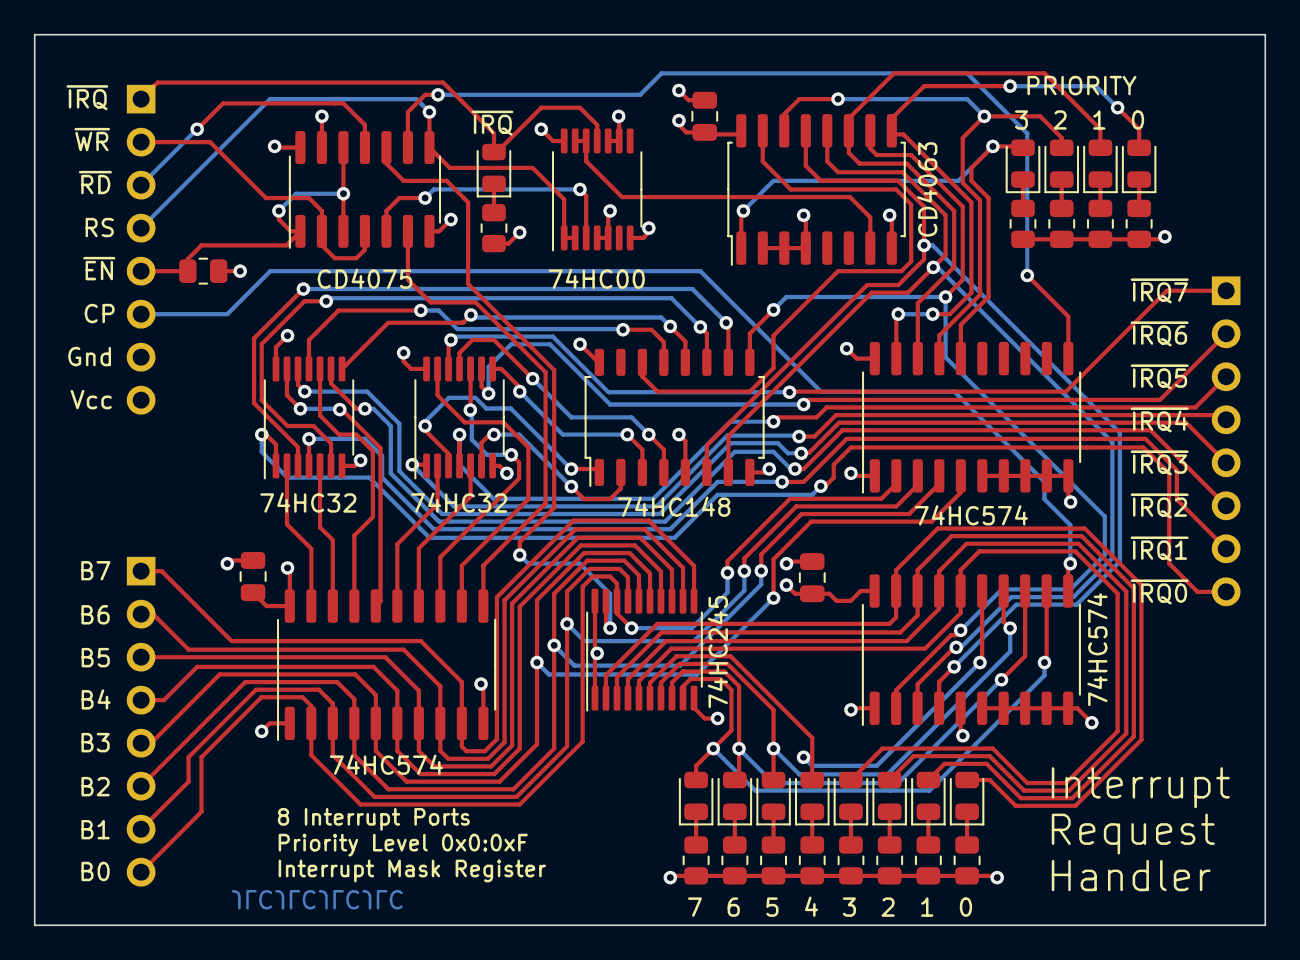
[picture p232: board new-interrupt-handler.kicad_pcb from above]

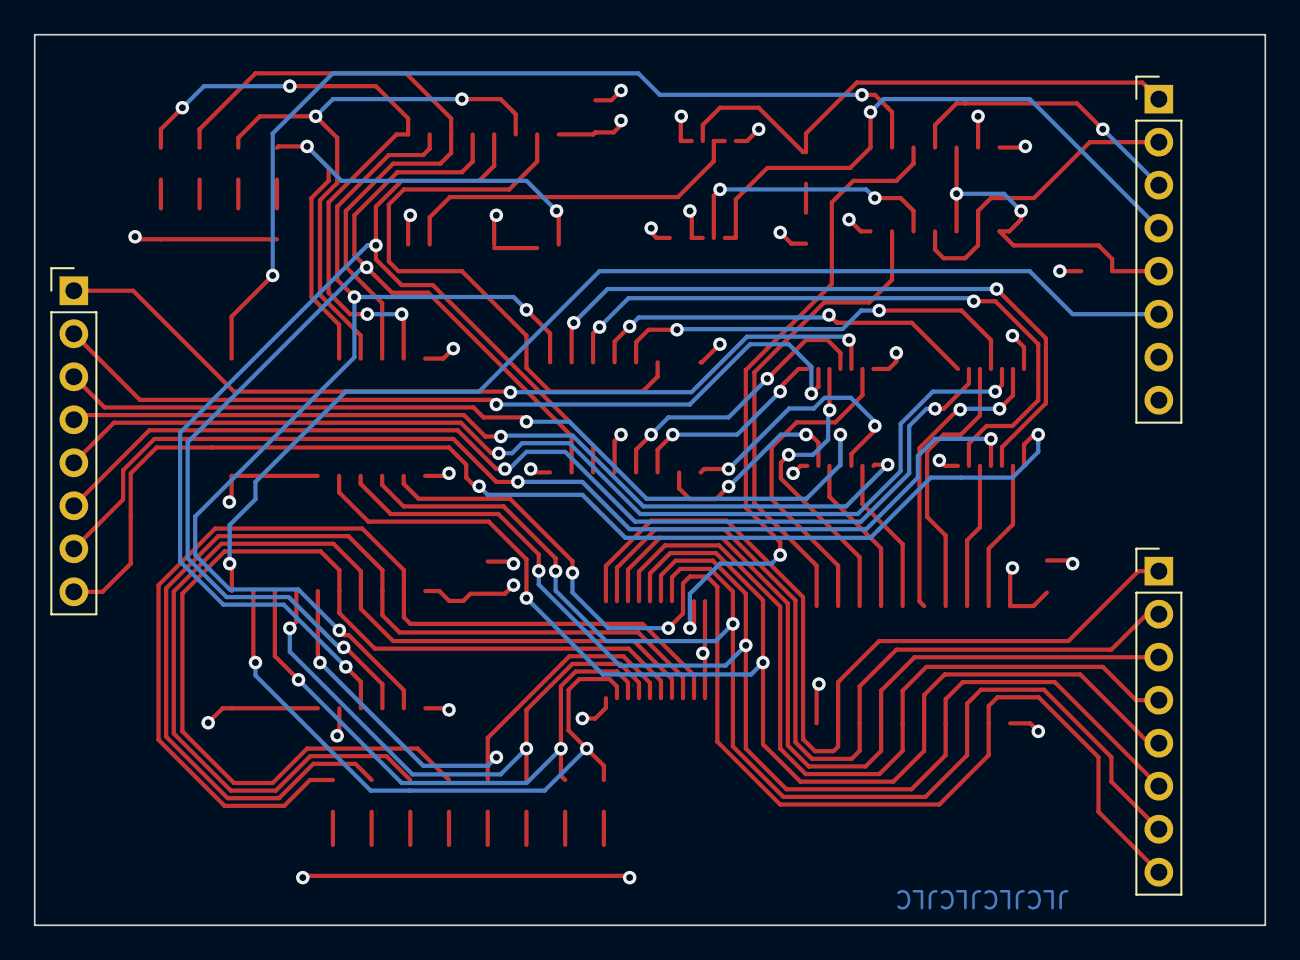
[picture p233: board new-interrupt-handler.kicad_pcb from below]

Board: 4 copper layers, 72.7 x 52.6 mm, 43 parts (3 on the bottom side), 74 nets.
