theWickedWebDev/8-bit-computer/PCBs/99_IN PROGRESS/IO-UART/UART.kicad_pcb

## KiCad design PCBs/99_IN PROGRESS/IO-UART/UART.kicad_pcb (2022-04-04)

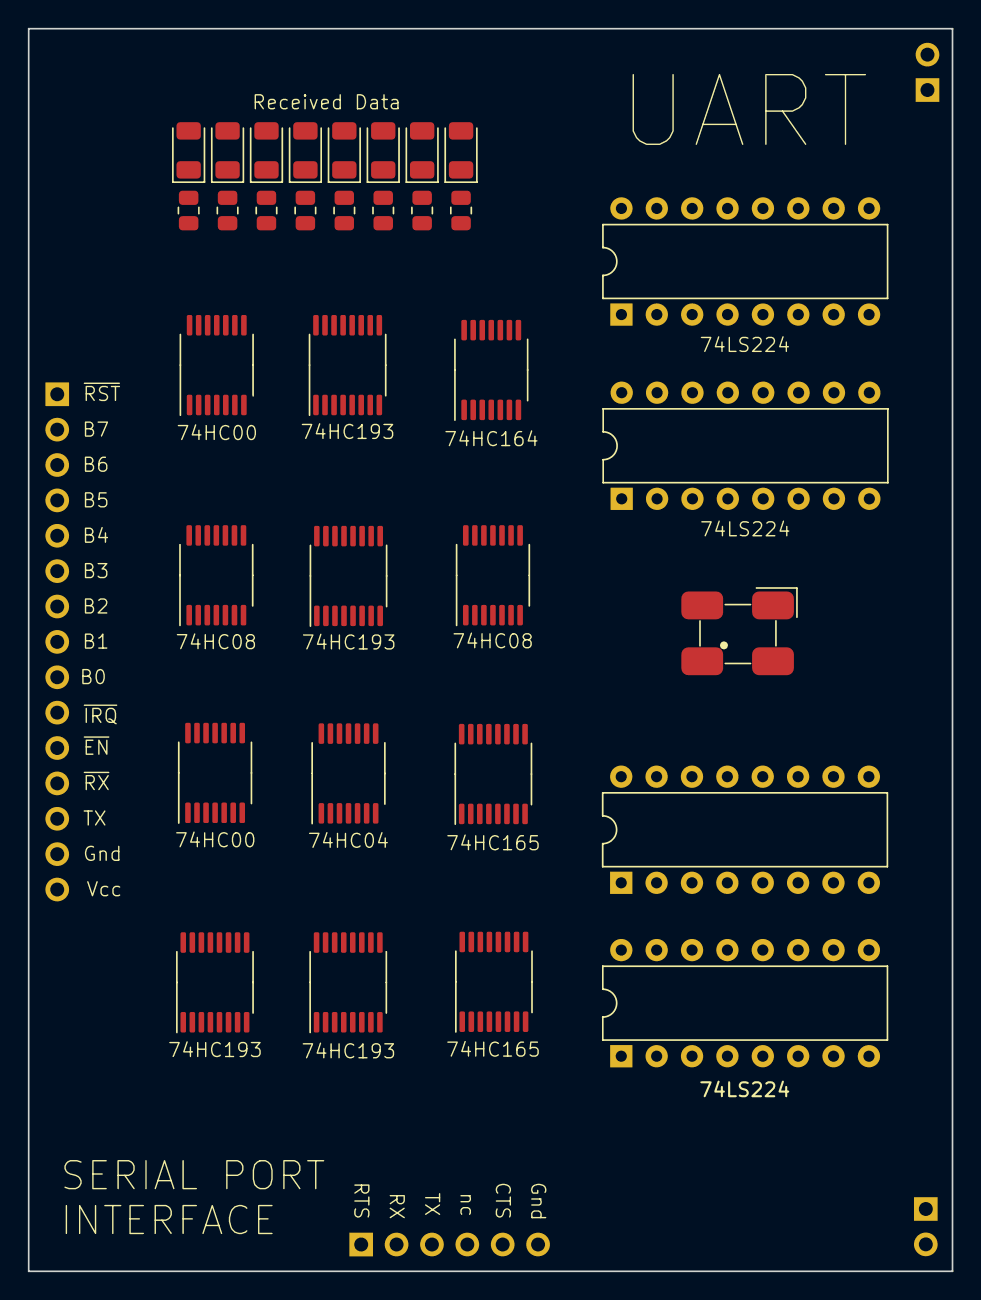
[picture p234: board UART.kicad_pcb from above]

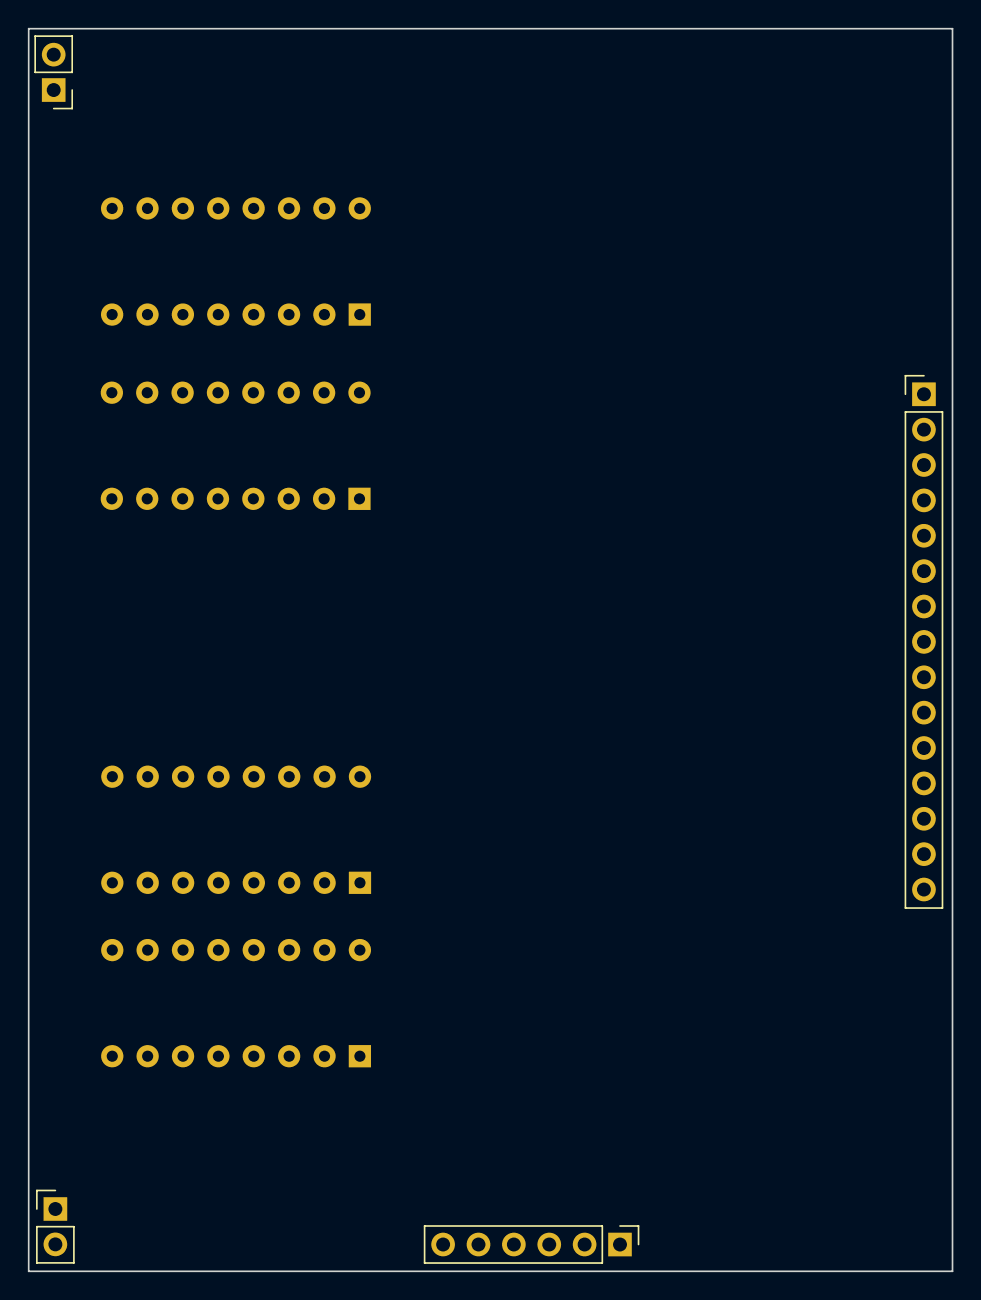
[picture p235: board UART.kicad_pcb from below]

Board: 4 copper layers, 66.3 x 89.2 mm, 37 parts (4 on the bottom side), 66 nets, no tracks yet.

Parts:
D1, D2, D3, D4, D5, D6, D7, D8: LED; LED_1206_3216Metric
J1: Conn_01x06; PinHeader_1x06_P2.54mm_Vertical
J2: Conn_01x15; PinHeader_1x15_P2.54mm_Vertical
J3, J4: Conn_01x02; PinHeader_1x02_P2.54mm_Vertical
R1, R2, R3, R4, R5, R6, R7, R8: 1kohm; R_0805_2012Metric
U1, U2, U3, U4: 74LS193; TSSOP-16_4.4x5mm_P0.65mm
U5, U14: 74LS08; TSSOP-14_4.4x5mm_P0.65mm
U6, U7: 74LS00; TSSOP-14_4.4x5mm_P0.65mm
U8: 74LS04; TSSOP-14_4.4x5mm_P0.65mm
U9: 74HC164; TSSOP-14_4.4x5mm_P0.65mm
U10, U11: 74LS165; TSSOP-16_4.4x5mm_P0.65mm
U12, U13, U15, U18: 74LS224; DIP-16_W7.62mm
Y1: Crystal_GND24; CFPS-72 SMD Clock

Connections:
/READ: U12.1 (OE), U12.15 (UNCK), U13.1 (OE), U13.15 (UNCK), U14.3
/TX0: D8.2 (A), U9.3 (Q0), U12.4 (D0)
/TX1: D7.2 (A), U9.4 (Q1), U12.5 (D1)
/TX2: D6.2 (A), U9.5 (Q2), U12.6 (D2)
/TX3: D5.2 (A), U9.6 (Q3), U12.7 (D3)
/TX4: D4.2 (A), U9.10 (Q4), U13.4 (D0)
/TX5: D3.2 (A), U9.11 (Q5), U13.5 (D1)
/TX6: D2.2 (A), U9.12 (Q6), U13.6 (D2)
/TX7: D1.2 (A), U9.13 (Q7), U13.7 (D3)
/TX_CLOCK: U2.7 (QD), U4.5 (UP), U6.10, U10.2 (CP), U11.2 (CP)
/TX_START: U4.11 (~LOAD), U6.3, U6.5, U10.1 (~PL), U11.1 (~PL), U15.1 (OE), U15.15 (UNCK), U18.1 (OE), U18.15 (UNCK)
/WRITE: U3.14 (CLR), U7.3, U7.4, U12.3 (LDCK), U13.3 (LDCK)
BUS0: J2.2, U12.13 (Q0), U15.4 (D0)
BUS1: J2.3, U12.12 (Q1), U15.5 (D1)
BUS2: J2.4, U12.11 (Q2), U15.6 (D2)
BUS3: J2.5, U12.10 (Q3), U15.7 (D3)
BUS4: J2.6, U13.13 (Q0), U18.4 (D0)
BUS5: J2.7, U13.12 (Q1), U18.5 (D1)
BUS6: J2.8, U13.11 (Q2), U18.6 (D2)
BUS7: J2.9, U13.10 (Q3), U18.7 (D3)
EN: U5.2, U8.6, U14.1
GND: J1.6, J2.14, R1.2, R2.2, R3.2, R4.2, R5.2, R6.2, R7.2, R8.2, U1.1 (B), U1.8 (GND), U1.10 (C), U1.14 (CLR), U2.1 (B), U2.8 (GND), U2.9 (D), U2.10 (C), U2.14 (CLR), U2.15 (A), U3.1 (B), U3.8 (GND), U3.9 (D), U3.10 (C), U3.15 (A), U4.1 (B), U4.8 (GND), U4.9 (D), U4.14 (CLR), U5.7 (GND), U5.12, U5.13, U6.7 (GND), U6.12, U6.13, U7.7 (GND), U7.9, U7.10, U7.12, U7.13, U8.7 (GND), U8.13, U9.7 (GND), U10.5 (D6), U10.8 (GND), U10.15 (~CE), U11.8 (GND), U11.15 (~CE), U12.8 (GND), U13.8 (GND), U14.7 (GND), U14.12, U14.13, U15.8 (GND), U18.8 (GND), Y1.2
unnamed: D1.1 (K), R1.1
unnamed: D2.1 (K), R2.1
unnamed: D3.1 (K), R3.1
unnamed: D4.1 (K), R4.1
unnamed: D5.1 (K), R5.1
unnamed: D6.1 (K), R6.1
unnamed: D7.1 (K), R7.1
unnamed: D8.1 (K), R8.1
unnamed: U1.4 (DOWN), U3.7 (QD), U9.8 (CP)
unnamed: U1.11 (~LOAD), U7.2, U7.6
unnamed: U1.13 (~BO), U7.1
unnamed: U4.12 (~CO), U6.4
unnamed: U5.5, U18.2 (IR)
unnamed: U5.8, U8.11
unnamed: U6.2, U6.8
unnamed: U8.1, U14.8
unnamed: U10.10 (DS), U11.9 (Q7)
unnamed: U12.2 (IR), U14.4
unnamed: U12.14 (OR), U14.9
unnamed: U13.2 (IR), U14.5
unnamed: U13.14 (OR), U14.10
unnamed: U5.4, U15.2 (IR)
unnamed: U5.9, U15.14 (OR)
unnamed: U5.10, U18.14 (OR)
RECEIVE_BYTE: J2.12, U8.4, U14.2
RX0: U10.4 (D5), U15.13 (Q0)
RX1: U10.3 (D4), U15.12 (Q1)
RX2: U10.14 (D3), U15.11 (Q2)
RX3: U10.13 (D2), U15.10 (Q3)
RX4: U10.12 (D1), U18.13 (Q0)
RX5: U10.11 (D0), U18.12 (Q1)
RX6: U11.6 (D7), U18.11 (Q2)
RX7: U11.5 (D6), U18.10 (Q3)
SER_CTS: J1.5, U14.6
SER_RTS: J1.1, U6.9, U8.10
SER_RX: J1.2, U10.9 (Q7)
SER_TX: J1.3, U7.5, U9.1 (DSA)
TF_DATA_READ: U6.1, U6.6
TRANSMIT_BYTE: J2.13, U5.1, U5.3, U8.8, U15.3 (LDCK), U18.3 (LDCK)
UART_CLOCK: U2.5 (UP), U3.5 (UP), Y1.3
VCC: J2.15, U1.5 (UP), U1.9 (D), U1.15 (A), U1.16 (VCC), U2.4 (DOWN), U2.11 (~LOAD), U2.16 (VCC), U3.4 (DOWN), U3.11 (~LOAD), U3.16 (VCC), U4.4 (DOWN), U4.10 (C), U4.15 (A), U4.16 (VCC), U5.14 (VCC), U6.14 (VCC), U7.14 (VCC), U8.14 (VCC), U9.2 (DSB), U9.9 (~MR), U9.14 (VCC), U10.6 (D7), U10.16 (VCC), U11.3 (D4), U11.4 (D5), U11.10 (DS), U11.11 (D0), U11.12 (D1), U11.13 (D2), U11.14 (D3), U11.16 (VCC), U12.16 (VCC), U13.16 (VCC), U14.14 (VCC), U15.16 (VCC), U18.16 (VCC), Y1.4
~EN: J2.11, U8.5
~RESET_BUFFERS: J2.1, U12.9 (~CLR), U13.9 (~CLR), U15.9 (~CLR), U18.9 (~CLR)
~RX_IRQ: J2.10, U8.2
