theWickedWebDev/8-bit-computer/PCBs/999-QUEUED-TO-PRINT/Backplane-IO-Controller/cpu-input-output-control.kicad_pcb

## KiCad design PCBs/999-QUEUED-TO-PRINT/Backplane-IO-Controller/cpu-input-output-control.kicad_pcb (2022-11-09)

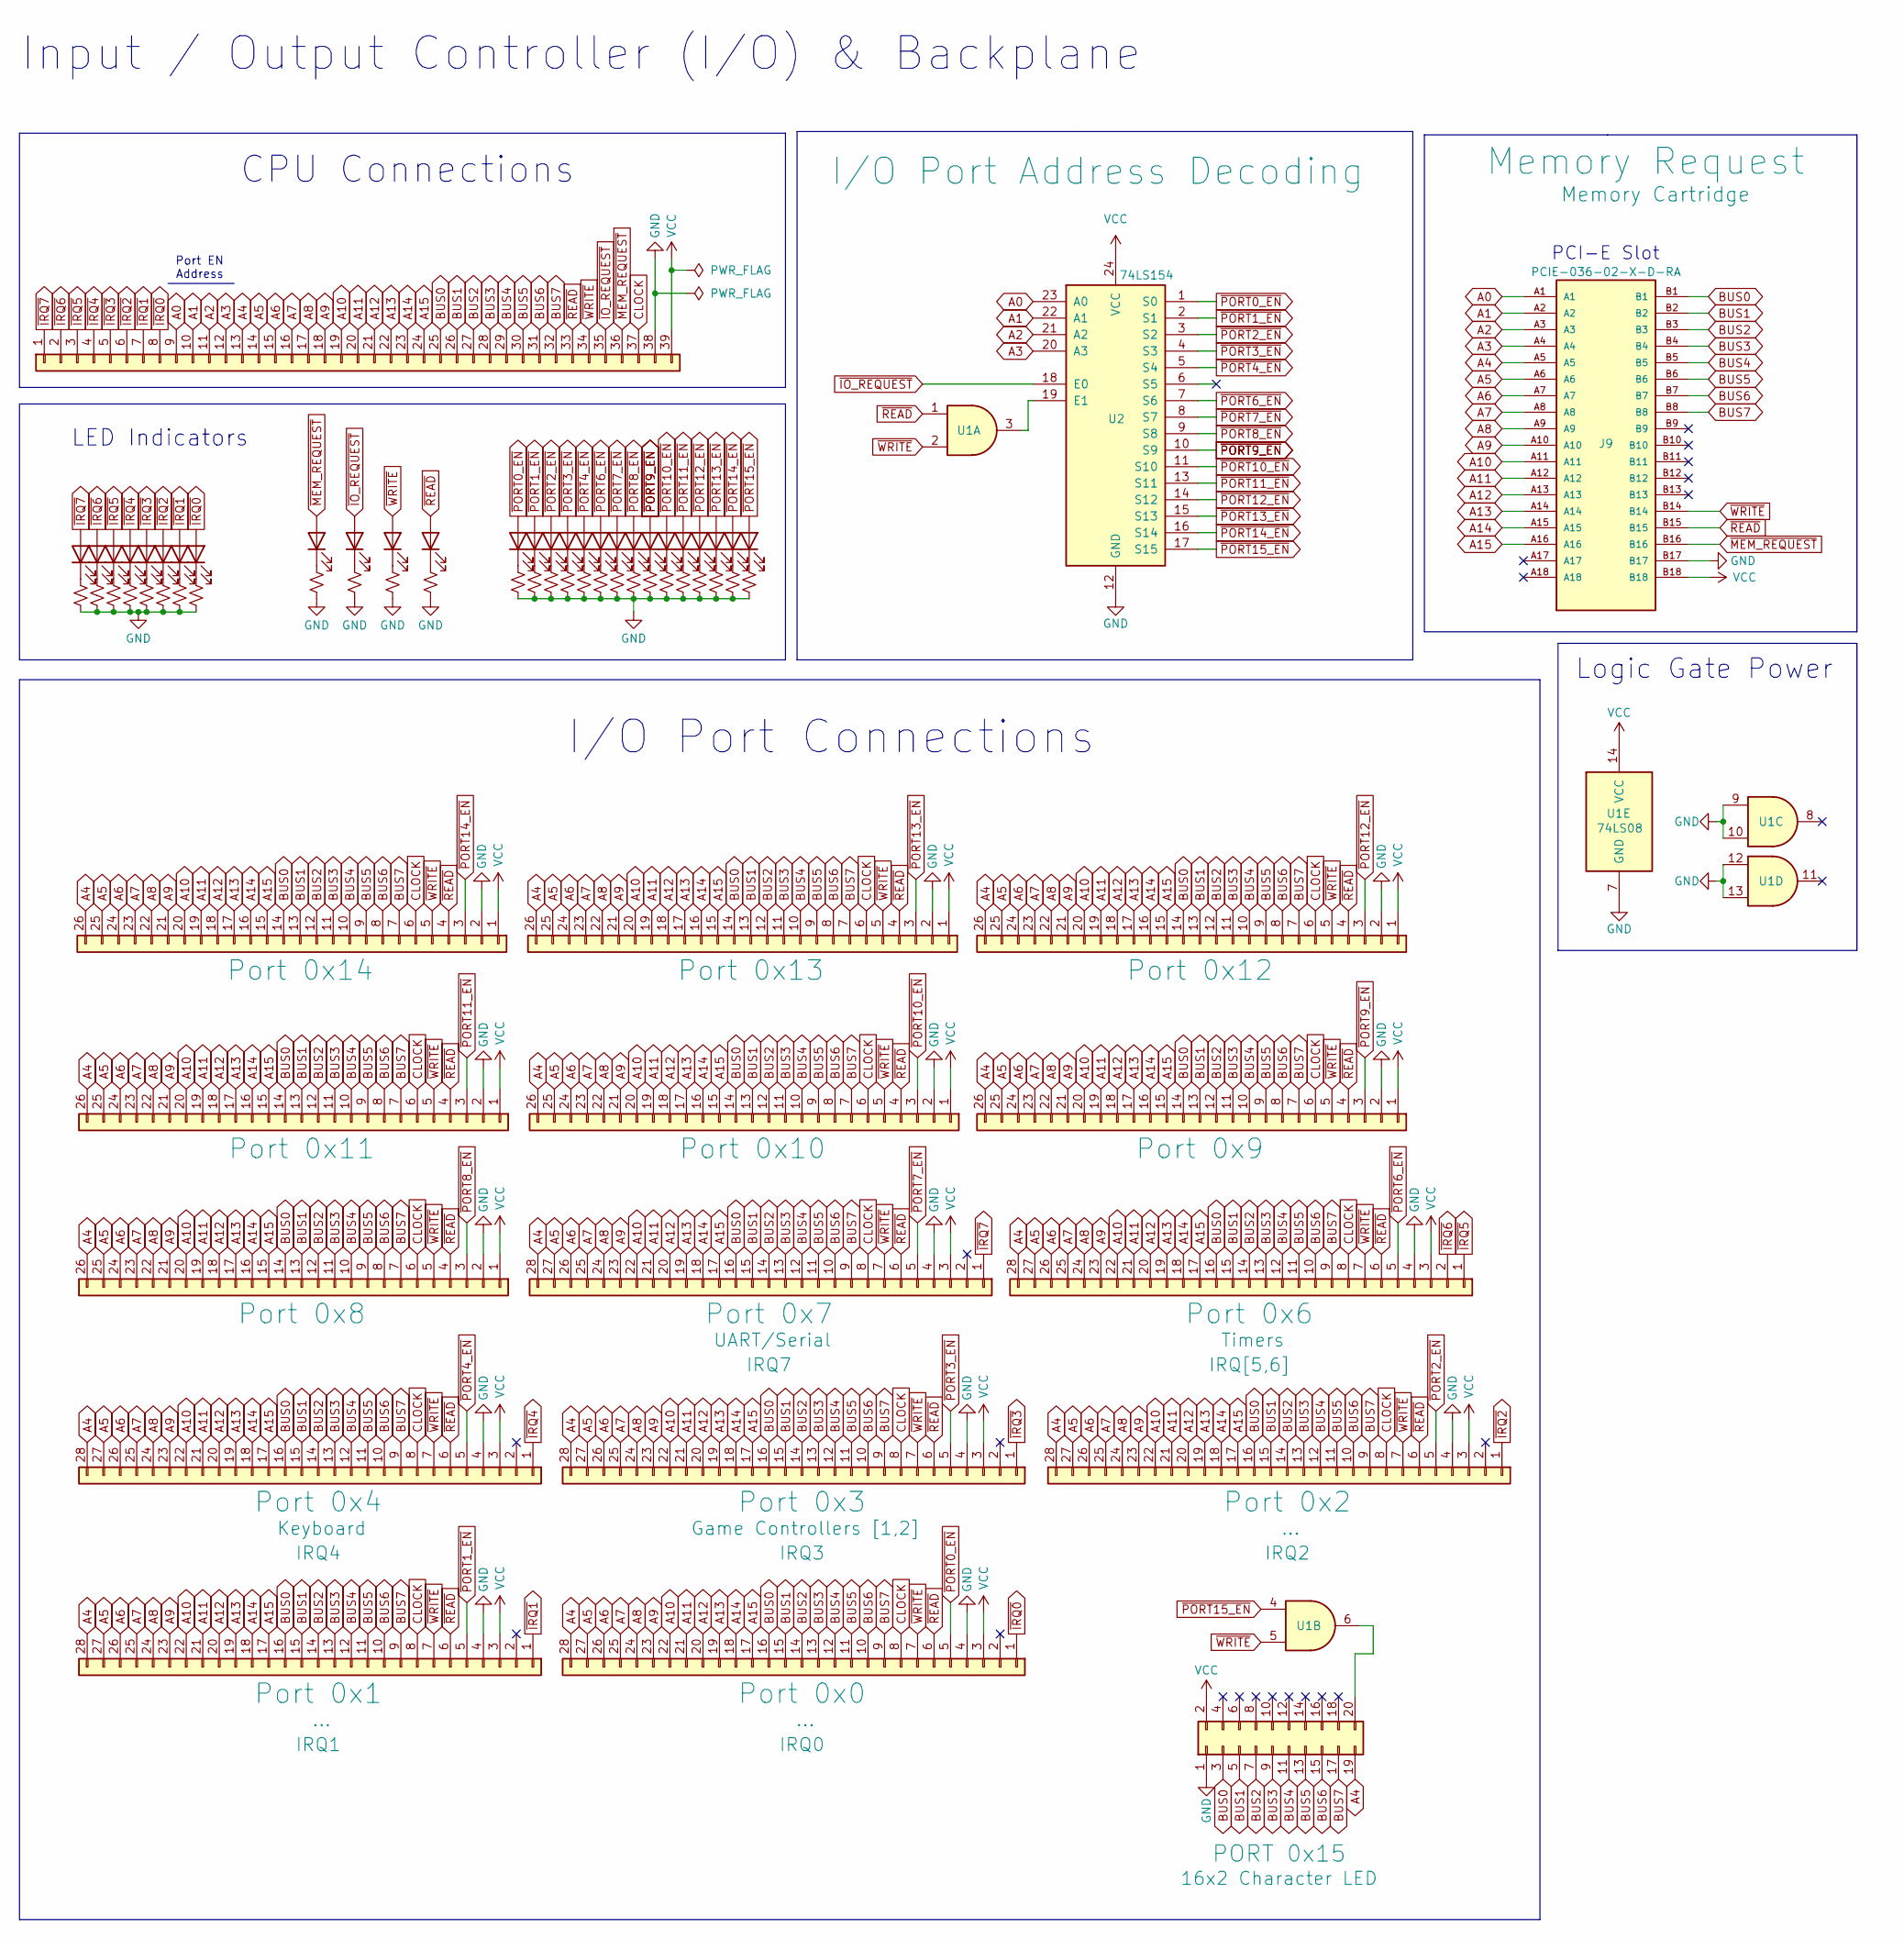
[picture p236: schematic cpu-input-output-control.kicad_sch, Input Output Controller (I/O)]

Parts:
D1, D2, D3, D4, D5, D6, D7, D8, D9, D10, D11, D12, D13, D14, D15, D16, D17, D18, D19, D20, D21, D22, D23, D24, D25, D26, D27: LED; LED_0805_2012Metric
J1, J4, J6, J8, J12, J14, J16: Conn_01x26; PinSocket_1x26_P2.54mm_Vertical
J2, J5, J7, J10, J13, J15, J17: Conn_01x28; PinSocket_1x28_P2.54mm_Vertical
J3: Conn_01x39; PinSocket_1x39_P2.54mm_Horizontal
J9: PCIE-036-02-X-D-RA; SAMTEC_PCIE-036-02-X-D-RA; PARTREV D
J11: Conn_02x20_Odd_Even; IDC-Header_2x10_P2.54mm_Vertical
R1, R2, R3, R4, R5, R6, R7, R8, R9, R10, R11, R12, R13, R14, R15, R16, R17, R18, R19, R20, R21, R22, R23, R24, R25, R26, R27: R_Small_US; R_0805_2012Metric
U1: 74LS08; SOIC-14_3.9x8.7mm_P1.27mm
U2: 74LS154; SO-24_5.3x15mm_P1.27mm

Connections:
A0: J3.9, J9.A1, U2.23 (A0)
A1: J3.10, J9.A2, U2.22 (A1)
A2: J3.11, J9.A3, U2.21 (A2)
A3: J3.12, J9.A4, U2.20 (A3)
A4: J1.26, J2.28, J3.13, J4.26, J5.28, J6.26, J7.28, J8.26, J9.A5, J10.28, J11.19, J12.26, J13.28, J14.26, J15.28, J16.26, J17.28
A5: J1.25, J2.27, J3.14, J4.25, J5.27, J6.25, J7.27, J8.25, J9.A6, J10.27, J12.25, J13.27, J14.25, J15.27, J16.25, J17.27
A6: J1.24, J2.26, J3.15, J4.24, J5.26, J6.24, J7.26, J8.24, J9.A7, J10.26, J12.24, J13.26, J14.24, J15.26, J16.24, J17.26
A7: J1.23, J2.25, J3.16, J4.23, J5.25, J6.23, J7.25, J8.23, J9.A8, J10.25, J12.23, J13.25, J14.23, J15.25, J16.23, J17.25
A8: J1.22, J2.24, J3.17, J4.22, J5.24, J6.22, J7.24, J8.22, J9.A9, J10.24, J12.22, J13.24, J14.22, J15.24, J16.22, J17.24
A9: J1.21, J2.23, J3.18, J4.21, J5.23, J6.21, J7.23, J8.21, J9.A10, J10.23, J12.21, J13.23, J14.21, J15.23, J16.21, J17.23
A10: J1.20, J2.22, J3.19, J4.20, J5.22, J6.20, J7.22, J8.20, J9.A11, J10.22, J12.20, J13.22, J14.20, J15.22, J16.20, J17.22
A11: J1.19, J2.21, J3.20, J4.19, J5.21, J6.19, J7.21, J8.19, J9.A12, J10.21, J12.19, J13.21, J14.19, J15.21, J16.19, J17.21
A12: J1.18, J2.20, J3.21, J4.18, J5.20, J6.18, J7.20, J8.18, J9.A13, J10.20, J12.18, J13.20, J14.18, J15.20, J16.18, J17.20
A13: J1.17, J2.19, J3.22, J4.17, J5.19, J6.17, J7.19, J8.17, J9.A14, J10.19, J12.17, J13.19, J14.17, J15.19, J16.17, J17.19
A14: J1.16, J2.18, J3.23, J4.16, J5.18, J6.16, J7.18, J8.16, J9.A15, J10.18, J12.16, J13.18, J14.16, J15.18, J16.16, J17.18
A15: J1.15, J2.17, J3.24, J4.15, J5.17, J6.15, J7.17, J8.15, J9.A16, J10.17, J12.15, J13.17, J14.15, J15.17, J16.15, J17.17
BUS0: J1.14, J2.16, J3.25, J4.14, J5.16, J6.14, J7.16, J8.14, J9.B1, J10.16, J11.3, J12.14, J13.16, J14.14, J15.16, J16.14, J17.16
BUS1: J1.13, J2.15, J3.26, J4.13, J5.15, J6.13, J7.15, J8.13, J9.B2, J10.15, J11.5, J12.13, J13.15, J14.13, J15.15, J16.13, J17.15
BUS2: J1.12, J2.14, J3.27, J4.12, J5.14, J6.12, J7.14, J8.12, J9.B3, J10.14, J11.7, J12.12, J13.14, J14.12, J15.14, J16.12, J17.14
BUS3: J1.11, J2.13, J3.28, J4.11, J5.13, J6.11, J7.13, J8.11, J9.B4, J10.13, J11.9, J12.11, J13.13, J14.11, J15.13, J16.11, J17.13
BUS4: J1.10, J2.12, J3.29, J4.10, J5.12, J6.10, J7.12, J8.10, J9.B5, J10.12, J11.11, J12.10, J13.12, J14.10, J15.12, J16.10, J17.12
BUS5: J1.9, J2.11, J3.30, J4.9, J5.11, J6.9, J7.11, J8.9, J9.B6, J10.11, J11.13, J12.9, J13.11, J14.9, J15.11, J16.9, J17.11
BUS6: J1.8, J2.10, J3.31, J4.8, J5.10, J6.8, J7.10, J8.8, J9.B7, J10.10, J11.15, J12.8, J13.10, J14.8, J15.10, J16.8, J17.10
BUS7: J1.7, J2.9, J3.32, J4.7, J5.9, J6.7, J7.9, J8.7, J9.B8, J10.9, J11.17, J12.7, J13.9, J14.7, J15.9, J16.7, J17.9
CLOCK: J1.6, J2.8, J3.37, J4.6, J5.8, J6.6, J7.8, J8.6, J10.8, J12.6, J13.8, J14.6, J15.8, J16.6, J17.8
GND: J1.2, J2.4, J3.38, J4.2, J5.4, J6.2, J7.4, J8.2, J9.B17, J10.4, J11.1, J12.2, J13.4, J14.2, J15.4, J16.2, J17.4, R1.2, R2.2, R3.2, R4.2, R5.2, R6.2, R7.2, R8.2, R9.2, R10.2, R11.2, R12.2, R13.2, R14.2, R15.2, R16.2, R17.2, R18.2, R19.2, R20.2, R21.2, R22.2, R23.2, R24.2, R25.2, R26.2, R27.2, U1.7 (GND), U1.9, U1.10, U1.12, U1.13, U2.12 (GND)
unnamed: D1.1 (K), R1.1
unnamed: D2.1 (K), R2.1
unnamed: D3.1 (K), R3.1
unnamed: D4.1 (K), R4.1
unnamed: D5.1 (K), R5.1
unnamed: D6.1 (K), R6.1
unnamed: D7.1 (K), R7.1
unnamed: D8.1 (K), R8.1
unnamed: D9.1 (K), R9.1
unnamed: D10.1 (K), R10.1
unnamed: D11.1 (K), R11.1
unnamed: D12.1 (K), R12.1
unnamed: D13.1 (K), R13.1
unnamed: D14.1 (K), R14.1
unnamed: D15.1 (K), R15.1
unnamed: D16.1 (K), R16.1
unnamed: D17.1 (K), R17.1
unnamed: D18.1 (K), R18.1
unnamed: D19.1 (K), R19.1
unnamed: D20.1 (K), R20.1
unnamed: D21.1 (K), R21.1
unnamed: D22.1 (K), R22.1
unnamed: D23.1 (K), R23.1
unnamed: D24.1 (K), R24.1
unnamed: D25.1 (K), R25.1
unnamed: D26.1 (K), R26.1
unnamed: D27.1 (K), R27.1
unnamed: J11.20, U1.6
unnamed: U1.3, U2.19 (E1)
VCC: J1.1, J2.3, J3.39, J4.1, J5.3, J6.1, J7.3, J8.1, J9.B18, J10.3, J11.2, J12.1, J13.3, J14.1, J15.3, J16.1, J17.3, U1.14 (VCC), U2.24 (VCC)
~IO_REQUEST: D10.2 (A), J3.35, U2.18 (E0)
~IRQ0: D8.2 (A), J3.8, J17.1
~IRQ1: D7.2 (A), J3.7, J15.1
~IRQ2: D6.2 (A), J3.6, J13.1
~IRQ3: D5.2 (A), J3.5, J10.1
~IRQ4: D4.2 (A), J3.4, J7.1
~IRQ5: D3.2 (A), J3.3, J5.1
~IRQ6: D2.2 (A), J3.2, J5.2
~IRQ7: D1.2 (A), J2.1, J3.1
~MEM_REQUEST: D9.2 (A), J3.36, J9.B16
~PORT0_EN: D13.2 (A), J17.5, U2.1 (S0)
~PORT1_EN: D14.2 (A), J15.5, U2.2 (S1)
~PORT2_EN: D15.2 (A), J13.5, U2.3 (S2)
~PORT3_EN: D16.2 (A), J10.5, U2.4 (S3)
~PORT4_EN: D17.2 (A), J7.5, U2.5 (S4)
~PORT6_EN: D18.2 (A), J5.5, U2.7 (S6)
~PORT7_EN: D19.2 (A), J2.5, U2.8 (S7)
~PORT8_EN: D20.2 (A), J16.3, U2.9 (S8)
~PORT9_EN: D21.2 (A), J14.3, U2.10 (S9)
~PORT10_EN: D22.2 (A), J12.3, U2.11 (S10)
~PORT11_EN: D23.2 (A), J8.3, U2.13 (S11)
~PORT12_EN: D24.2 (A), J6.3, U2.14 (S12)
~PORT13_EN: D25.2 (A), J4.3, U2.15 (S13)
~PORT14_EN: D26.2 (A), J1.3, U2.16 (S14)
~PORT15_EN: D27.2 (A), U1.4, U2.17 (S15)
~READ: D12.2 (A), J1.4, J2.6, J3.33, J4.4, J5.6, J6.4, J7.6, J8.4, J9.B15, J10.6, J12.4, J13.6, J14.4, J15.6, J16.4, J17.6, U1.1
~WRITE: D11.2 (A), J1.5, J2.7, J3.34, J4.5, J5.7, J6.5, J7.7, J8.5, J9.B14, J10.7, J12.5, J13.7, J14.5, J15.7, J16.5, J17.7, U1.2, U1.5

Notes on the sheet:
CPU Connections
Logic Gate Power
Input / Output Controller (I/O) & Backplane
PCI-E Slot
Port EN Address
LED Indicators
I/O Port Connections

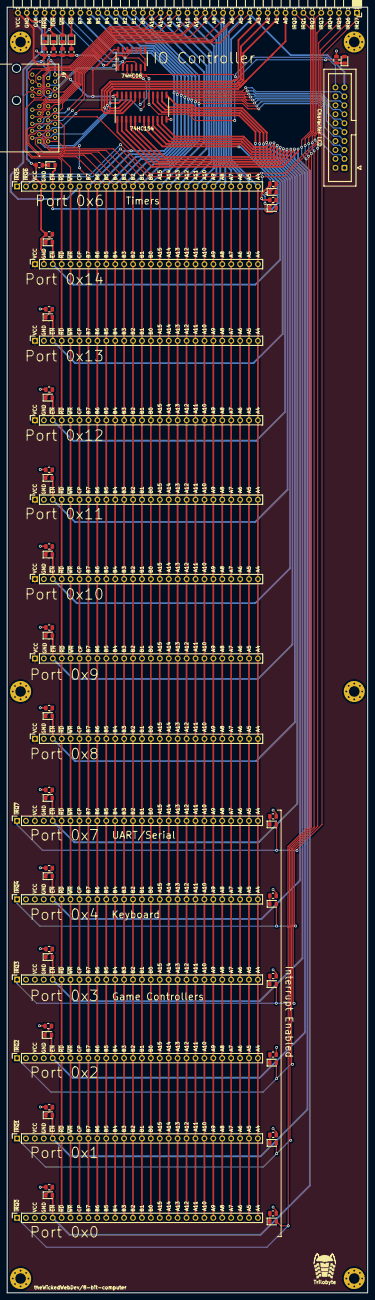
[picture p237: board cpu-input-output-control.kicad_pcb from above]

Board: 2 copper layers, 102.6 x 366.0 mm, 73 parts (0 on the bottom side), 83 nets.
