theWickedWebDev/8-bit-computer/PCBs/99_IN PROGRESS/Displacement/SPR-Displacement-ScalingFactor/ScalingFactor.kicad_pcb

## KiCad design PCBs/99_IN PROGRESS/Displacement/SPR-Displacement-ScalingFactor/ScalingFactor.kicad_pcb (2022-06-18)

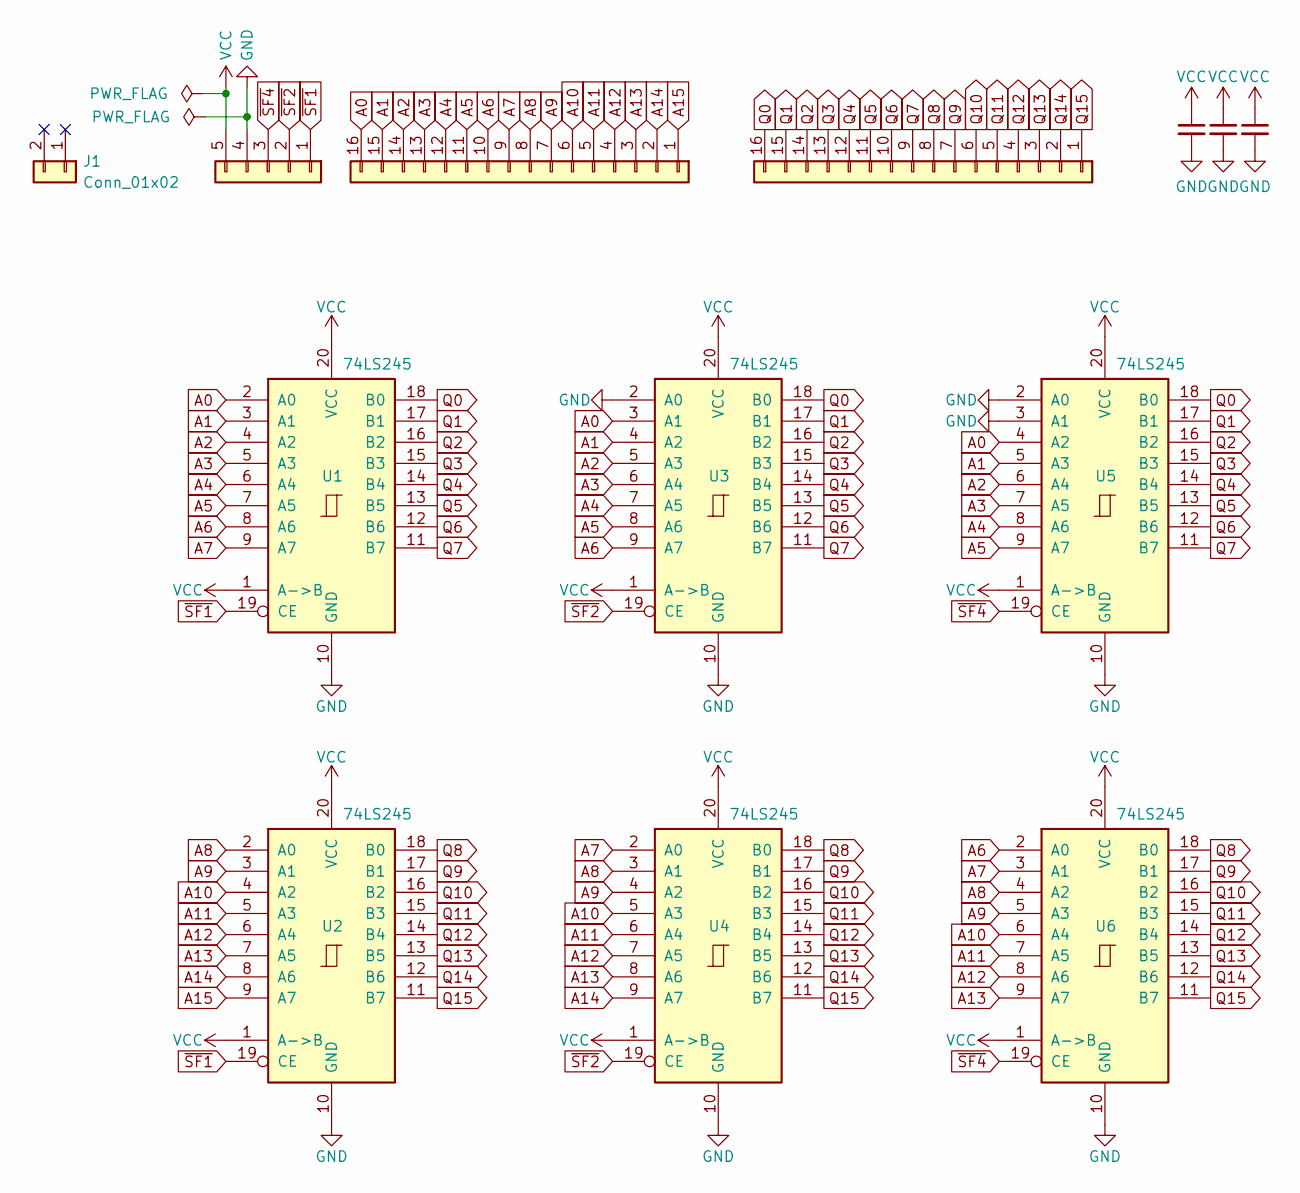
[picture p238: schematic ScalingFactor.kicad_sch]

Parts:
C1, C2, C3: C_Small; C_0805_2012Metric
J1: Conn_01x02; PinHeader_1x02_P2.54mm_Vertical
J2: Conn_01x05; PinHeader_1x05_P2.54mm_Vertical
J3, J4: Conn_01x16; PinHeader_1x16_P2.54mm_Vertical
U1, U2, U3, U4, U5, U6: 74LS245; SO-20_5.3x12.6mm_P1.27mm

Connections:
A0: J3.16, U1.2 (A0), U3.3 (A1), U5.4 (A2)
A1: J3.15, U1.3 (A1), U3.4 (A2), U5.5 (A3)
A2: J3.14, U1.4 (A2), U3.5 (A3), U5.6 (A4)
A3: J3.13, U1.5 (A3), U3.6 (A4), U5.7 (A5)
A4: J3.12, U1.6 (A4), U3.7 (A5), U5.8 (A6)
A5: J3.11, U1.7 (A5), U3.8 (A6), U5.9 (A7)
A6: J3.10, U1.8 (A6), U3.9 (A7), U6.2 (A0)
A7: J3.9, U1.9 (A7), U4.2 (A0), U6.3 (A1)
A8: J3.8, U2.2 (A0), U4.3 (A1), U6.4 (A2)
A9: J3.7, U2.3 (A1), U4.4 (A2), U6.5 (A3)
A10: J3.6, U2.4 (A2), U4.5 (A3), U6.6 (A4)
A11: J3.5, U2.5 (A3), U4.6 (A4), U6.7 (A5)
A12: J3.4, U2.6 (A4), U4.7 (A5), U6.8 (A6)
A13: J3.3, U2.7 (A5), U4.8 (A6), U6.9 (A7)
A14: J3.2, U2.8 (A6), U4.9 (A7)
A15: J3.1, U2.9 (A7)
GND: C1.2, C2.2, C3.2, J2.4, U1.10 (GND), U2.10 (GND), U3.2 (A0), U3.10 (GND), U4.10 (GND), U5.2 (A0), U5.3 (A1), U5.10 (GND), U6.10 (GND)
Q0: J4.16, U1.18 (B0), U3.18 (B0), U5.18 (B0)
Q1: J4.15, U1.17 (B1), U3.17 (B1), U5.17 (B1)
Q2: J4.14, U1.16 (B2), U3.16 (B2), U5.16 (B2)
Q3: J4.13, U1.15 (B3), U3.15 (B3), U5.15 (B3)
Q4: J4.12, U1.14 (B4), U3.14 (B4), U5.14 (B4)
Q5: J4.11, U1.13 (B5), U3.13 (B5), U5.13 (B5)
Q6: J4.10, U1.12 (B6), U3.12 (B6), U5.12 (B6)
Q7: J4.9, U1.11 (B7), U3.11 (B7), U5.11 (B7)
Q8: J4.8, U2.18 (B0), U4.18 (B0), U6.18 (B0)
Q9: J4.7, U2.17 (B1), U4.17 (B1), U6.17 (B1)
Q10: J4.6, U2.16 (B2), U4.16 (B2), U6.16 (B2)
Q11: J4.5, U2.15 (B3), U4.15 (B3), U6.15 (B3)
Q12: J4.4, U2.14 (B4), U4.14 (B4), U6.14 (B4)
Q13: J4.3, U2.13 (B5), U4.13 (B5), U6.13 (B5)
Q14: J4.2, U2.12 (B6), U4.12 (B6), U6.12 (B6)
Q15: J4.1, U2.11 (B7), U4.11 (B7), U6.11 (B7)
VCC: C1.1, C2.1, C3.1, J2.5, U1.1 (A->B), U1.20 (VCC), U2.1 (A->B), U2.20 (VCC), U3.1 (A->B), U3.20 (VCC), U4.1 (A->B), U4.20 (VCC), U5.1 (A->B), U5.20 (VCC), U6.1 (A->B), U6.20 (VCC)
~SF1: J2.1, U1.19 (CE), U2.19 (CE)
~SF2: J2.2, U3.19 (CE), U4.19 (CE)
~SF4: J2.3, U5.19 (CE), U6.19 (CE)

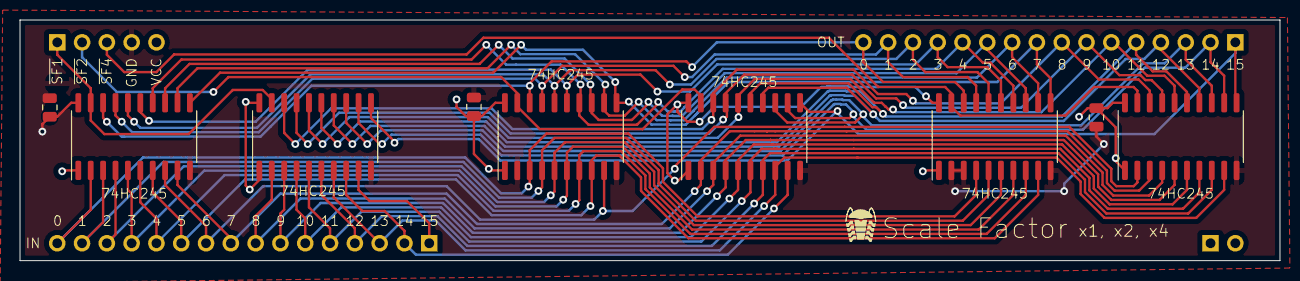
[picture p239: board ScalingFactor.kicad_pcb from above]

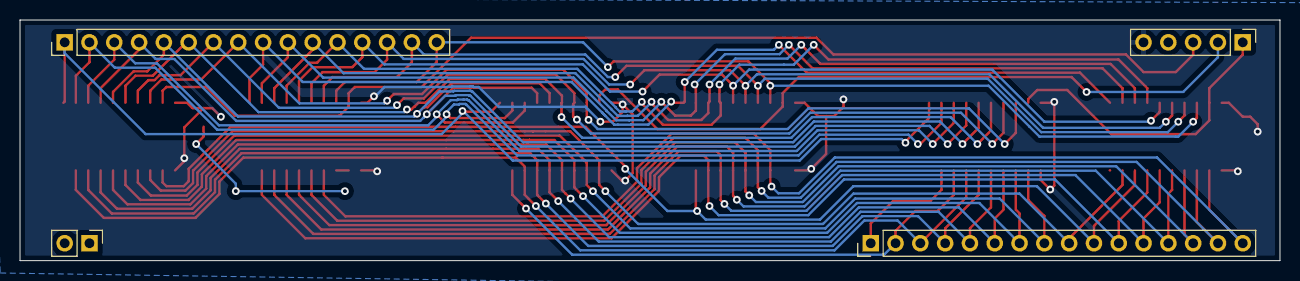
[picture p240: board ScalingFactor.kicad_pcb from below]

Board: 2 copper layers, 129.0 x 24.6 mm, 13 parts (4 on the bottom side), 37 nets.
