theWickedWebDev/8-bit-computer/PCBs/03_MODULES/CPU-ALU/ALU-Logic/Modules.kicad_pcb

## KiCad design PCBs/03_MODULES/CPU-ALU/ALU-Logic/Modules.kicad_pcb (2022-02-28)

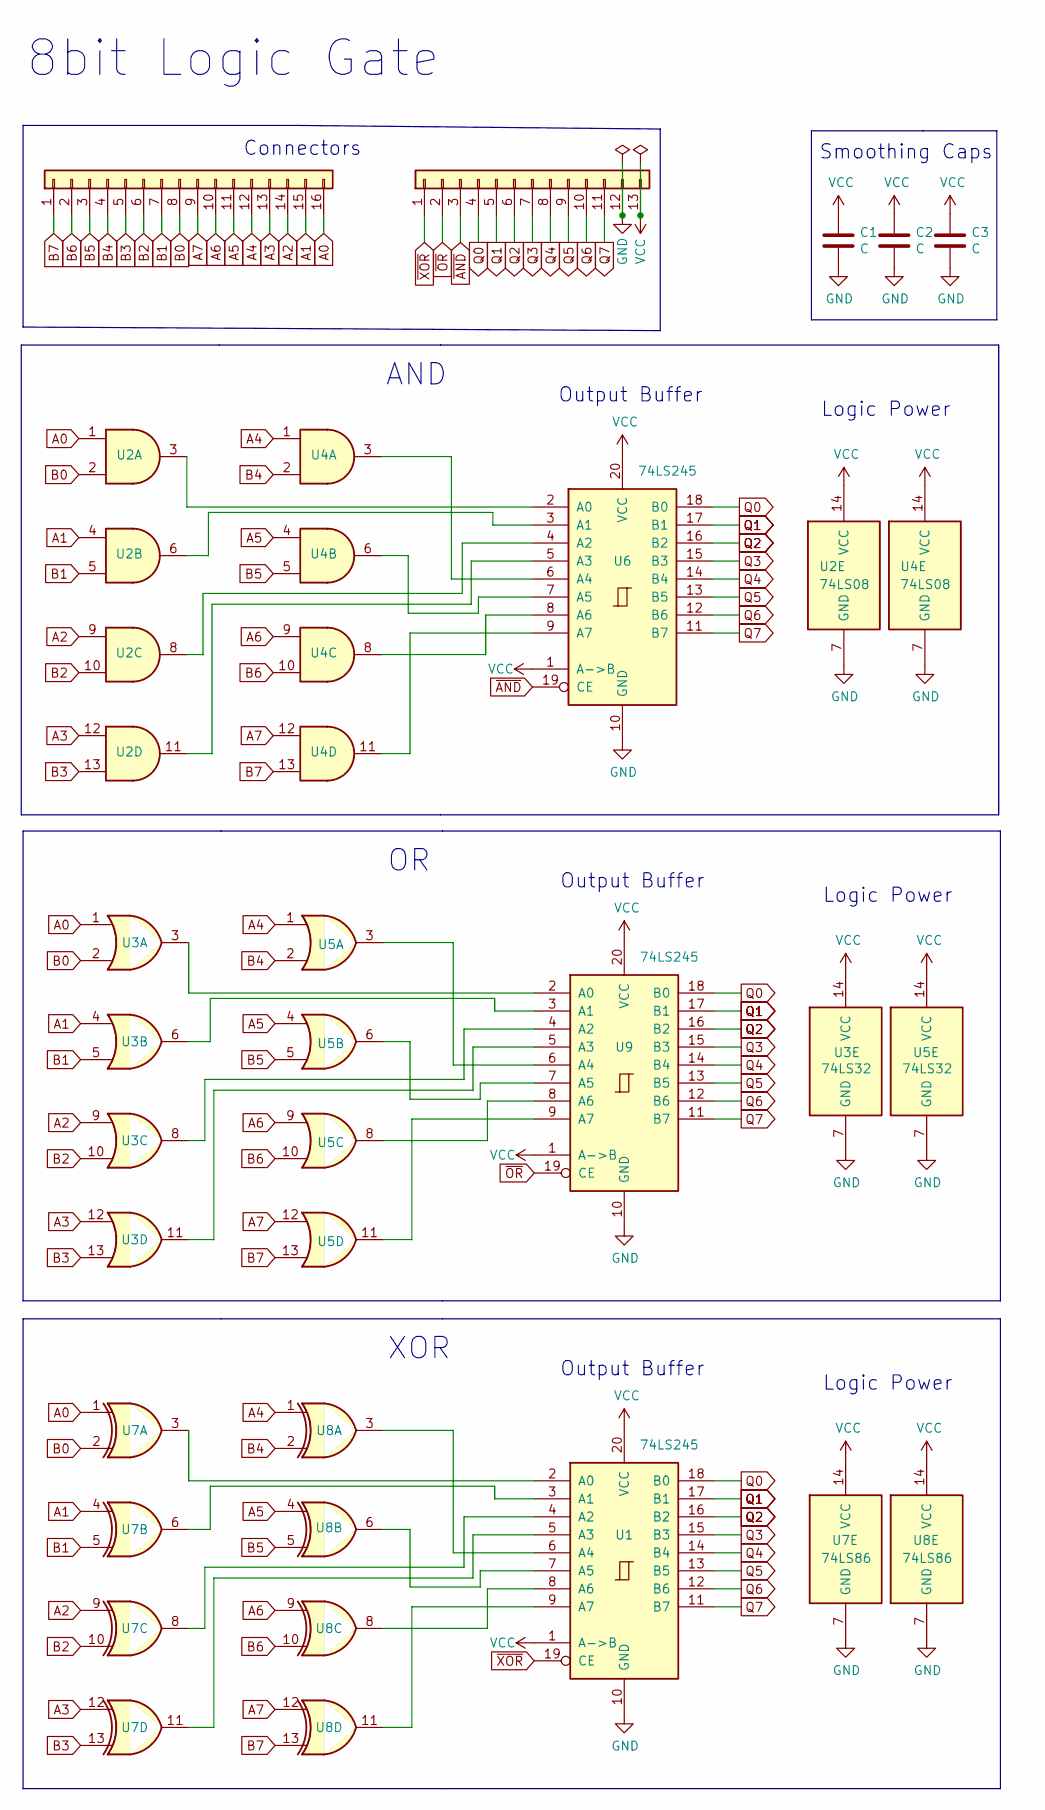
[picture p241: schematic Modules.kicad_sch, 8bit Logic Gate (ALU)]

Parts:
C1, C2, C3: C; C_0805_2012Metric
J1: Conn_01x16; PinSocket_1x16_P2.54mm_Vertical
J3: Conn_01x13; PinSocket_1x13_P2.54mm_Vertical
U1, U6, U9: 74LS245; TSSOP-20_4.4x6.5mm_P0.65mm
U2, U4: 74LS08; TSSOP-14_4.4x5mm_P0.65mm
U3, U5: 74LS32; TSSOP-14_4.4x5mm_P0.65mm
U7, U8: 74LS86; TSSOP-14_4.4x5mm_P0.65mm

Connections:
A0: J1.16, U2.1, U3.1, U7.1
A1: J1.15, U2.4, U3.4, U7.4
A2: J1.14, U2.9, U3.9, U7.9
A3: J1.13, U2.12, U3.12, U7.12
A4: J1.12, U4.1, U5.1, U8.1
A5: J1.11, U4.4, U5.4, U8.4
A6: J1.10, U4.9, U5.9, U8.9
A7: J1.9, U4.12, U5.12, U8.12
B0: J1.8, U2.2, U3.2, U7.2
B1: J1.7, U2.5, U3.5, U7.5
B2: J1.6, U2.10, U3.10, U7.10
B3: J1.5, U2.13, U3.13, U7.13
B4: J1.4, U4.2, U5.2, U8.2
B5: J1.3, U4.5, U5.5, U8.5
B6: J1.2, U4.10, U5.10, U8.10
B7: J1.1, U4.13, U5.13, U8.13
GND: C1.2, C2.2, C3.2, J3.12, U1.10 (GND), U2.7 (GND), U3.7 (GND), U4.7 (GND), U5.7 (GND), U6.10 (GND), U7.7 (GND), U8.7 (GND), U9.10 (GND); also elsewhere on the board
unnamed: U1.2 (A0), U7.3
unnamed: U3.3, U9.2 (A0)
unnamed: U3.6, U9.3 (A1)
unnamed: U3.8, U9.4 (A2)
unnamed: U3.11, U9.5 (A3)
unnamed: U5.3, U9.6 (A4)
unnamed: U5.6, U9.7 (A5)
unnamed: U5.8, U9.8 (A6)
unnamed: U5.11, U9.9 (A7)
unnamed: U2.3, U6.2 (A0)
unnamed: U2.6, U6.3 (A1)
unnamed: U2.8, U6.4 (A2)
unnamed: U2.11, U6.5 (A3)
unnamed: U4.3, U6.6 (A4)
unnamed: U4.6, U6.7 (A5)
unnamed: U4.8, U6.8 (A6)
unnamed: U4.11, U6.9 (A7)
unnamed: U1.3 (A1), U7.6
unnamed: U1.4 (A2), U7.8
unnamed: U1.5 (A3), U7.11
unnamed: U1.6 (A4), U8.3
unnamed: U1.7 (A5), U8.6
unnamed: U1.8 (A6), U8.8
unnamed: U1.9 (A7), U8.11
Q0: J3.4, U1.18 (B0), U6.18 (B0), U9.18 (B0); also elsewhere on the board
Q1: J3.5, U1.17 (B1), U6.17 (B1), U9.17 (B1); also elsewhere on the board
Q2: J3.6, U1.16 (B2), U6.16 (B2), U9.16 (B2); also elsewhere on the board
Q3: J3.7, U1.15 (B3), U6.15 (B3), U9.15 (B3); also elsewhere on the board
Q4: J3.8, U1.14 (B4), U6.14 (B4), U9.14 (B4); also elsewhere on the board
Q5: J3.9, U1.13 (B5), U6.13 (B5), U9.13 (B5); also elsewhere on the board
Q6: J3.10, U1.12 (B6), U6.12 (B6), U9.12 (B6); also elsewhere on the board
Q7: J3.11, U1.11 (B7), U6.11 (B7), U9.11 (B7); also elsewhere on the board
VCC: C1.1, C2.1, C3.1, J3.13, U1.1 (A->B), U1.20 (VCC), U2.14 (VCC), U3.14 (VCC), U4.14 (VCC), U5.14 (VCC), U6.1 (A->B), U6.20 (VCC), U7.14 (VCC), U8.14 (VCC), U9.1 (A->B), U9.20 (VCC); also elsewhere on the board
~AND: J3.3, U6.19 (CE); also elsewhere on the board
~OR: J3.2, U9.19 (CE); also elsewhere on the board
~XOR: J3.1, U1.19 (CE); also elsewhere on the board

Notes on the sheet:
8bit Logic Gate
Logic Power
Smoothing Caps
Output Buffer
Connectors
XOR
AND

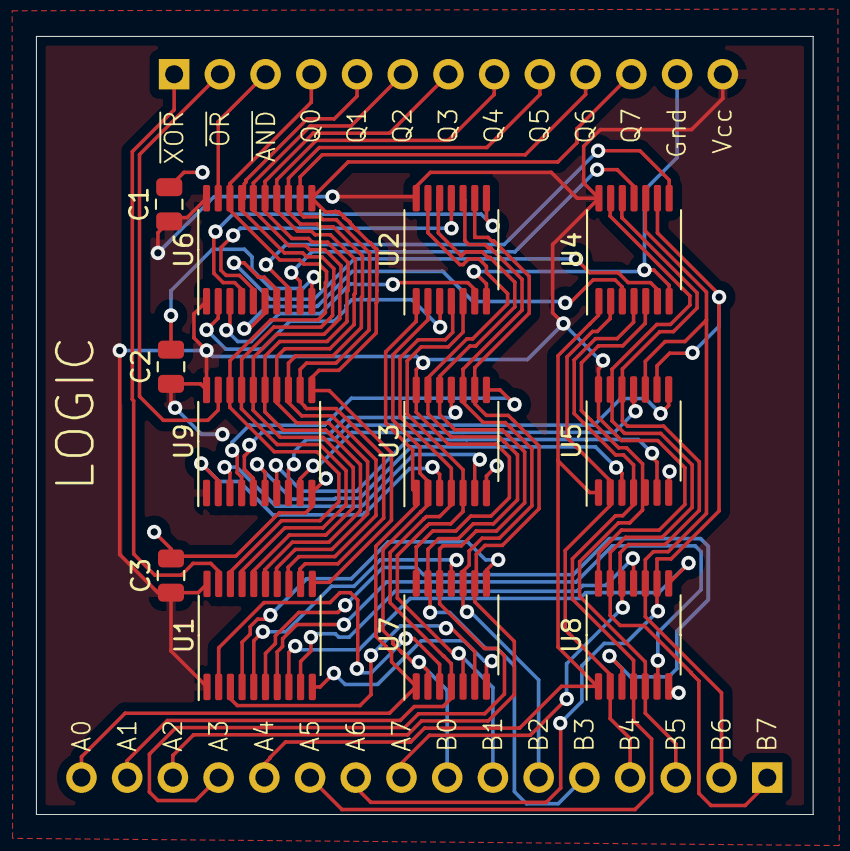
[picture p242: board PCBs/03_MODULES/CPU-ALU/ALU-Logic/Modules.kicad_pcb from above]

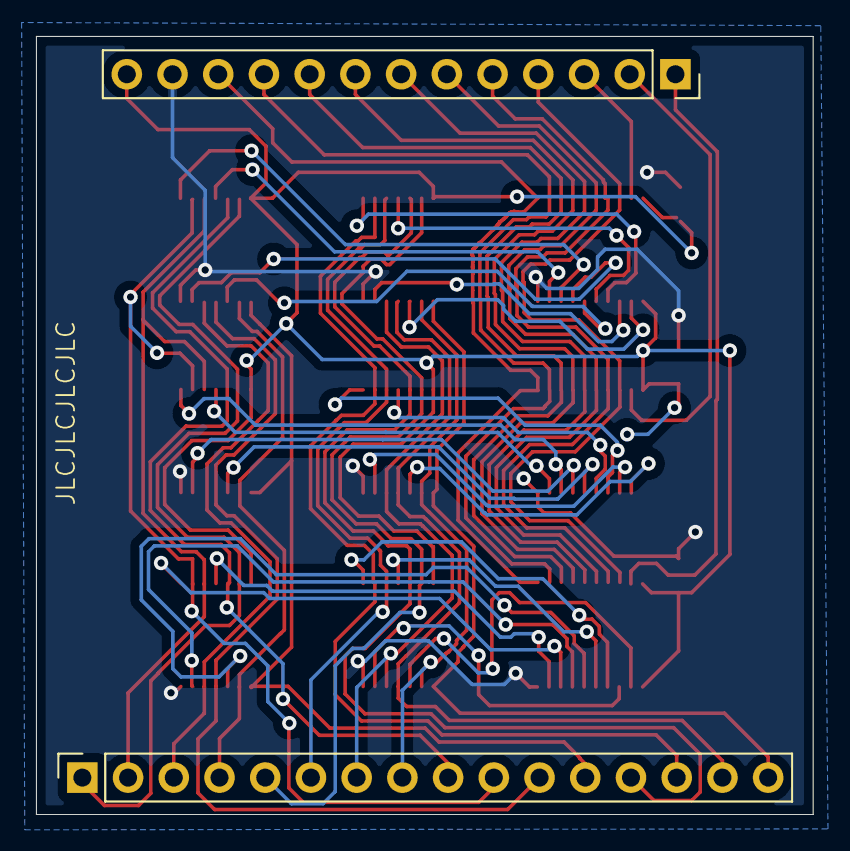
[picture p243: board PCBs/03_MODULES/CPU-ALU/ALU-Logic/Modules.kicad_pcb from below]

Board: 2 copper layers, 43.1 x 43.2 mm, 14 parts (2 on the bottom side), 53 nets.

Other parts of the board:
JC: Conn_01x13; PinSocket_1x13_P2.54mm_Vertical

Their connections:
GND: JC.12; also elsewhere on the board
Q0: JC.4; also elsewhere on the board
Q1: JC.5; also elsewhere on the board
Q2: JC.6; also elsewhere on the board
Q3: JC.7; also elsewhere on the board
Q4: JC.8; also elsewhere on the board
Q5: JC.9; also elsewhere on the board
Q6: JC.10; also elsewhere on the board
Q7: JC.11; also elsewhere on the board
VCC: JC.13; also elsewhere on the board
~AND: JC.3; also elsewhere on the board
~OR: JC.2; also elsewhere on the board
~XOR: JC.1; also elsewhere on the board
