theWickedWebDev/8-bit-computer/PCBs/99_IN PROGRESS/RAM-Breakout/RAM-Breakout.kicad_pcb

## KiCad design PCBs/99_IN PROGRESS/RAM-Breakout/RAM-Breakout.kicad_pcb (2022-08-27)

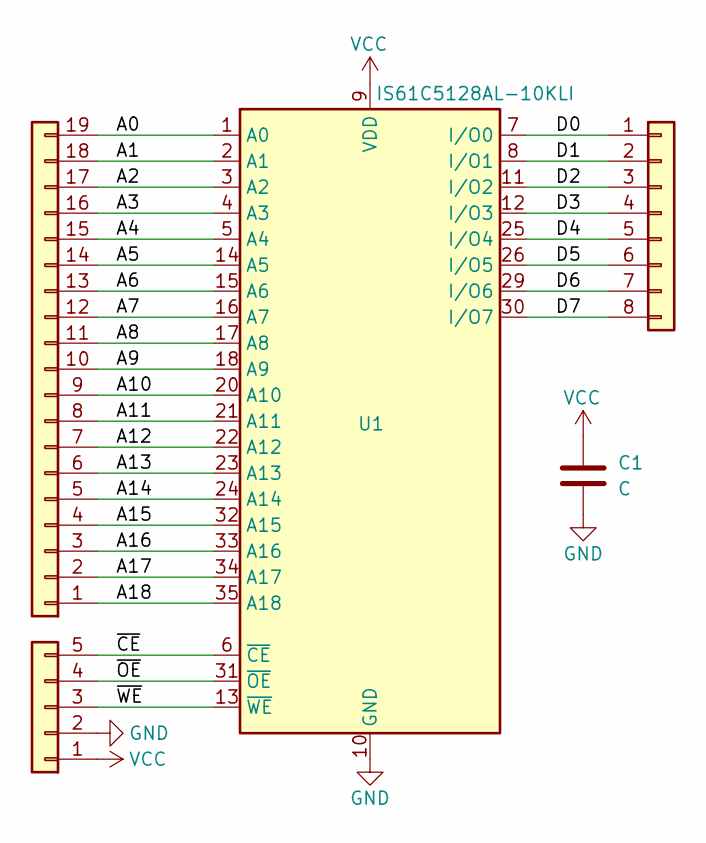
[picture p244: schematic RAM-Breakout.kicad_sch]

Parts:
C1: C; C_0805_2012Metric
J1: Conn_01x19; PinHeader_1x19_P2.54mm_Vertical
J2: Conn_01x05; PinHeader_1x05_P2.54mm_Vertical
J3: Conn_01x08; PinHeader_1x08_P2.54mm_Vertical
U1: IS61C5128AL-10KLI; SOJ-36_10.16x23.49mm_P1.27mm

Connections:
/A0: J1.19, U1.1 (A0)
/A1: J1.18, U1.2 (A1)
/A2: J1.17, U1.3 (A2)
/A3: J1.16, U1.4 (A3)
/A4: J1.15, U1.5 (A4)
/A5: J1.14, U1.14 (A5)
/A6: J1.13, U1.15 (A6)
/A7: J1.12, U1.16 (A7)
/A8: J1.11, U1.17 (A8)
/A9: J1.10, U1.18 (A9)
/A10: J1.9, U1.20 (A10)
/A11: J1.8, U1.21 (A11)
/A12: J1.7, U1.22 (A12)
/A13: J1.6, U1.23 (A13)
/A14: J1.5, U1.24 (A14)
/A15: J1.4, U1.32 (A15)
/A16: J1.3, U1.33 (A16)
/A17: J1.2, U1.34 (A17)
/A18: J1.1, U1.35 (A18)
/D0: J3.1, U1.7 (I/O0)
/D1: J3.2, U1.8 (I/O1)
/D2: J3.3, U1.11 (I/O2)
/D3: J3.4, U1.12 (I/O3)
/D4: J3.5, U1.25 (I/O4)
/D5: J3.6, U1.26 (I/O5)
/D6: J3.7, U1.29 (I/O6)
/D7: J3.8, U1.30 (I/O7)
/~CE: J2.5, U1.6 (~CE)
/~OE: J2.4, U1.31 (~OE)
/~WE: J2.3, U1.13 (~WE)
GND: C1.2, J2.2, U1.10 (GND), U1.28 (GND)
VCC: C1.1, J2.1, U1.9 (VDD), U1.27 (VDD)

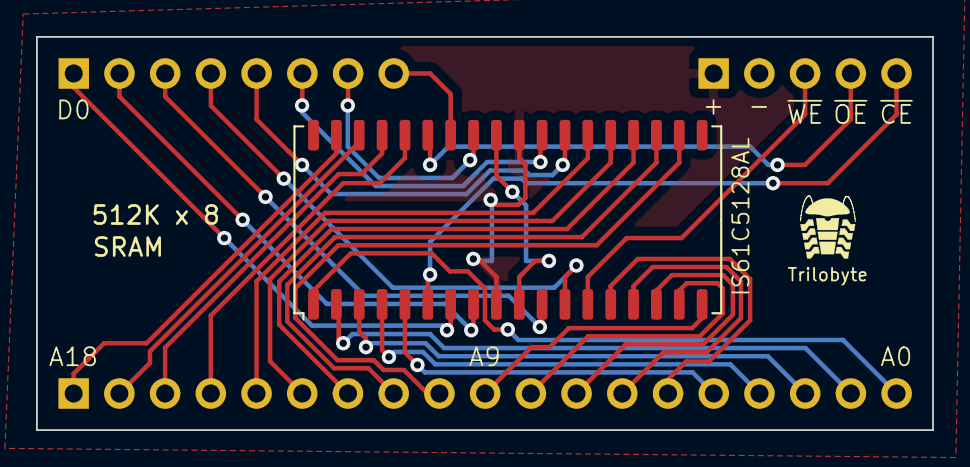
[picture p245: board RAM-Breakout.kicad_pcb from above]

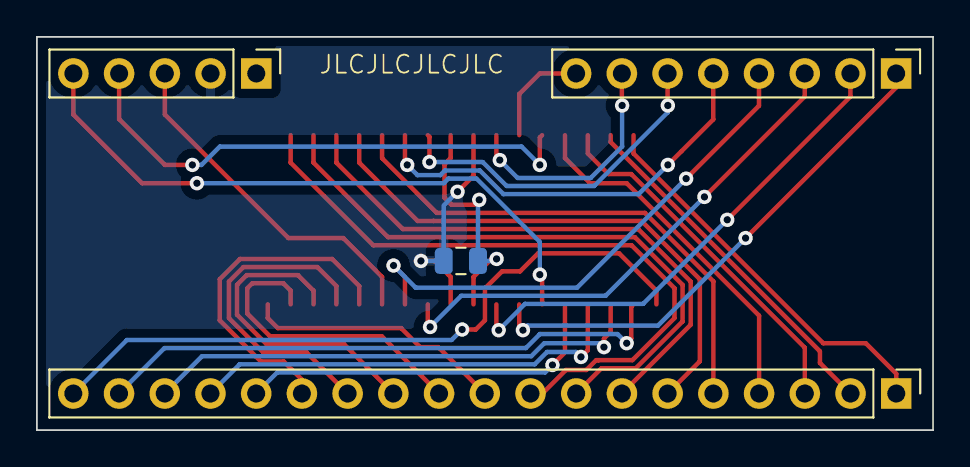
[picture p246: board RAM-Breakout.kicad_pcb from below]

Board: 2 copper layers, 49.8 x 21.8 mm, 5 parts (4 on the bottom side), 32 nets.
