theWickedWebDev/8-bit-computer/PCBs/999-QUEUED-TO-PRINT/CLOCK/CLOCK.kicad_pcb

## KiCad design PCBs/999-QUEUED-TO-PRINT/CLOCK/CLOCK.kicad_pcb (2022-11-09)

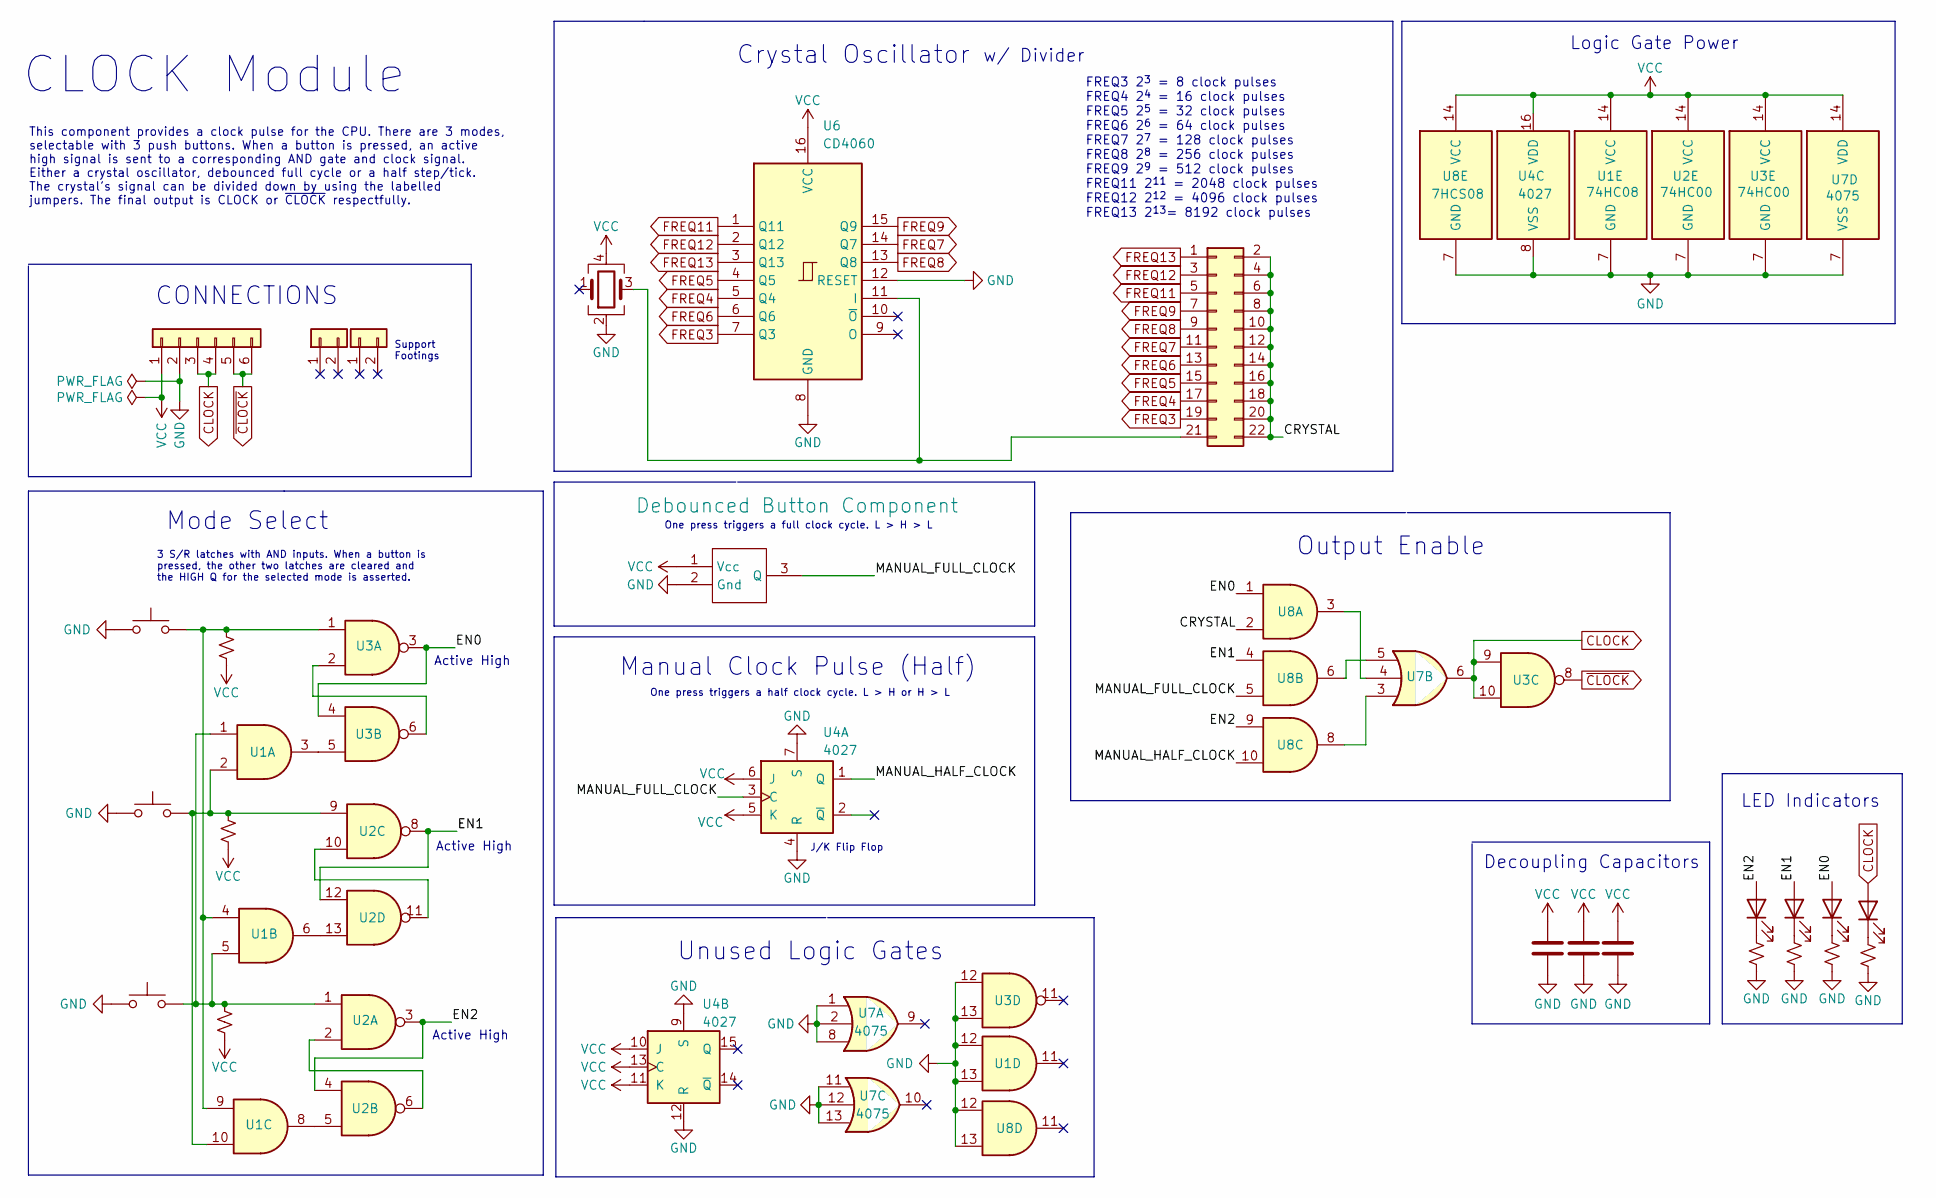
[picture p247: schematic CLOCK.kicad_sch, Computer Clock]

Parts:
C1, C2, C3: C; C_0805_2012Metric
D1, D2, D3, D4: LED; LED_0805_2012Metric
J1: Conn_01x06; PinHeader_1x06_P2.54mm_Vertical
J2, J3: Conn_01x02; PinHeader_1x02_P2.54mm_Vertical
J4: Conn_02x11_Odd_Even; PinHeader_2x11_P2.54mm_Vertical
R1, R2, R3, R4, R5, R6, R7: R_Small_US; R_0805_2012Metric
SW1, SW2, SW3: SW_Push; SW_PUSH_6mm
U1: 74HC08; SOIC-14_3.9x8.7mm_P1.27mm
U2, U3: 74HC00; SOIC-14_3.9x8.7mm_P1.27mm
U4: 4027
U5: DebouncedButton; breakout-debounce-btn
U6: CD4060; SOIC-16W_5.3x10.2mm_P1.27mm
U7: 4075; SOIC-14_3.9x8.7mm_P1.27mm
U8: 7HCS08; SOIC-14_3.9x8.7mm_P1.27mm
Y1: Crystal_GND24; Crystal_DIP_4_14

Connections:
/CRYSTAL: J4.2, J4.4, J4.6, J4.8, J4.10, J4.12, J4.14, J4.16, J4.18, J4.20, J4.22, U8.2
/EN0: D3.2 (A), U3.3, U3.4, U8.1
/EN1: D2.2 (A), U2.8, U2.12, U8.4
/EN2: D1.2 (A), U2.3, U2.4, U8.9
/MANUAL_FULL_CLOCK: U4.3 (C), U5.3 (Q), U8.5; also elsewhere on the board
/MANUAL_HALF_CLOCK: U4.1 (Q), U8.10
CLOCK: D4.2 (A), J1.3, J1.4, U3.9, U3.10, U7.6
FREQ3: J4.19, U6.7 (Q3)
FREQ4: J4.17, U6.5 (Q4)
FREQ5: J4.15, U6.4 (Q5)
FREQ6: J4.13, U6.6 (Q6)
FREQ7: J4.11, U6.14 (Q7)
FREQ8: J4.9, U6.13 (Q8)
FREQ9: J4.7, U6.15 (Q9)
FREQ11: J4.5, U6.1 (Q11)
FREQ12: J4.3, U6.2 (Q12)
FREQ13: J4.1, U6.3 (Q13)
GND: C1.2, C2.2, C3.2, J1.2, R4.1, R5.1, R6.1, R7.1, SW1.1, SW2.1, SW3.1, U1.7 (GND), U1.12, U1.13, U2.7 (GND), U3.7 (GND), U3.12, U3.13, U4.4 (R), U4.7 (S), U4.8 (VSS), U4.9 (S), U4.12 (R), U5.2 (Gnd), U6.8 (GND), U6.12 (RESET), U7.1, U7.2, U7.7 (VSS), U7.8, U7.11, U7.12, U7.13, U8.7 (GND), U8.12, U8.13, Y1.2; also elsewhere on the board
unnamed: D1.1 (K), R4.2
unnamed: D2.1 (K), R5.2
unnamed: D3.1 (K), R6.2
unnamed: D4.1 (K), R7.2
unnamed: J4.21, U6.11 (I), Y1.3
unnamed: R1.2, SW1.2, U1.1, U1.5, U2.1
unnamed: R2.2, SW2.2, U1.4, U1.9, U3.1
unnamed: R3.2, SW3.2, U1.2, U1.10, U2.9
unnamed: U1.3, U3.5
unnamed: U1.6, U2.13
unnamed: U1.8, U2.5
unnamed: U2.2, U2.6
unnamed: U2.10, U2.11
unnamed: U3.2, U3.6
unnamed: U7.3, U8.8
unnamed: U7.4, U8.3
unnamed: U7.5, U8.6
VCC: C1.1, C2.1, C3.1, J1.1, R1.1, R2.1, R3.1, U1.14 (VCC), U2.14 (VCC), U3.14 (VCC), U4.5 (K), U4.6 (J), U4.10 (J), U4.11 (K), U4.13 (C), U4.16 (VDD), U5.1 (Vcc), U6.16 (VCC), U7.14 (VDD), U8.14 (VCC), Y1.4; also elsewhere on the board
~CLOCK: J1.5, J1.6, U3.8

Notes on the sheet:
3 S/R latches with AND inputs. When a button is pressed, the other two latches are cleared and the HIGH Q for the selected mode is asserted.
Output Enable
Active High
Decoupling Capacitors
One press triggers a full clock cycle. L > H > L
J/K Flip Flop
LED Indicators
CONNECTIONS
This component provides a clock pulse for the CPU. There are 3 modes, selectable with 3 push buttons. When a button is pressed, an active high signal is sent to a corresponding AND gate and clock signal. Either a crystal oscillator, debounced full cycle or a half step/tick. The crystal's signal can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
Crystal Oscillator
Manual Clock Pulse (Half)
Mode Select
Logic Gate Power
w/ Divider
Support Footings
One press triggers a half clock cycle. L > H or H > L
Unused Logic Gates
CLOCK Module
FREQ3 2^{3} = 8 clock pulses FREQ4 2^{4} = 16 clock pulses FREQ5 2^{5} = 32 clock pulses FREQ6 2^{6} = 64 clock pulses FREQ7 2^{7} = 128 clock pulses FREQ8 2^{8} = 256 clock pulses FREQ9 2^{9} = 512 clock pulses FREQ11 2^{11} = 2048 clock pulses FREQ12 2^{12} = 4096 clock pulses FREQ13 2^{13}= 8192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

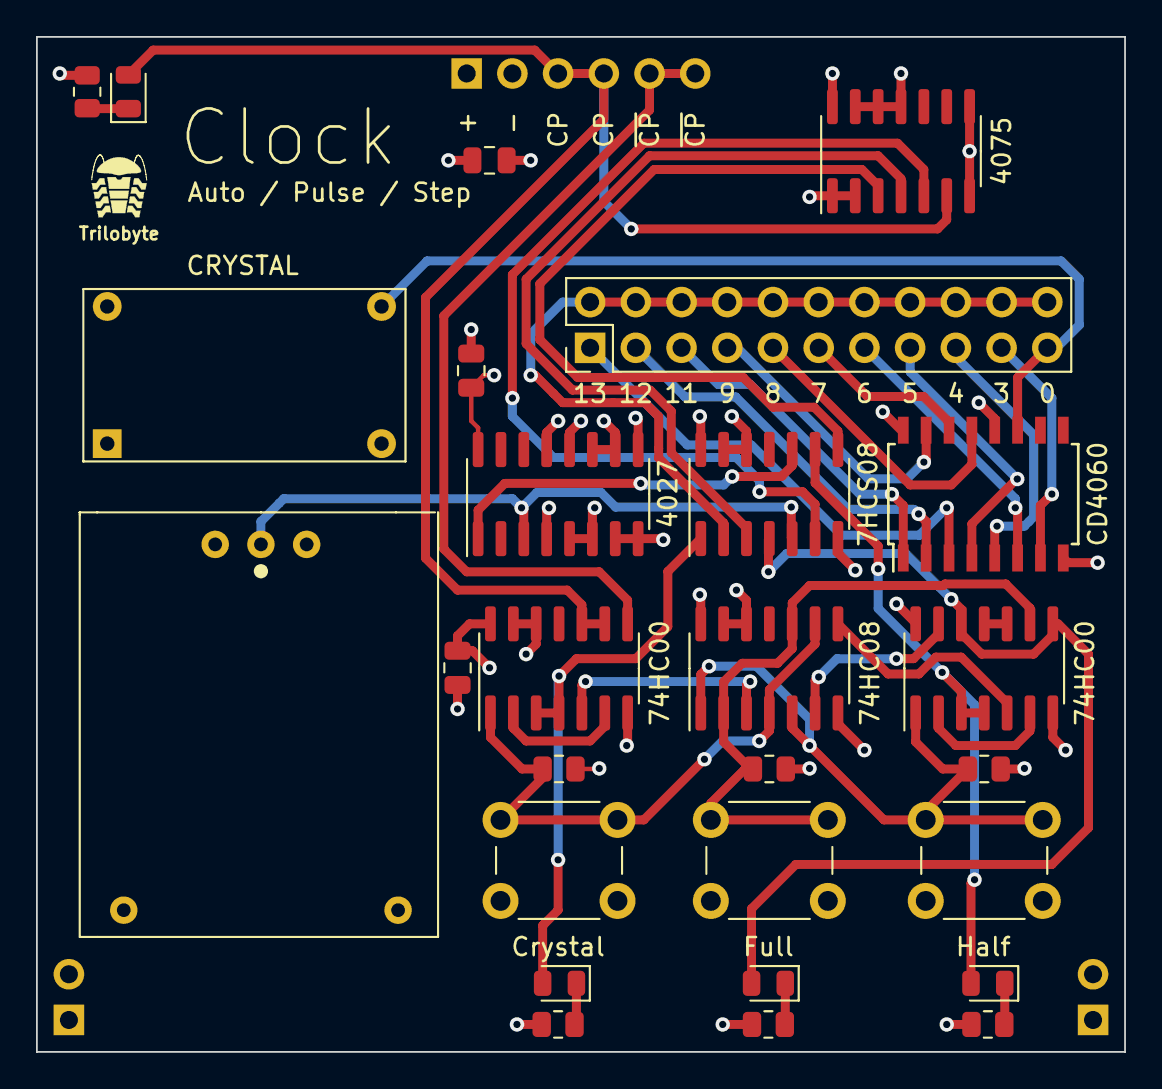
[picture p248: board CLOCK.kicad_pcb from above]

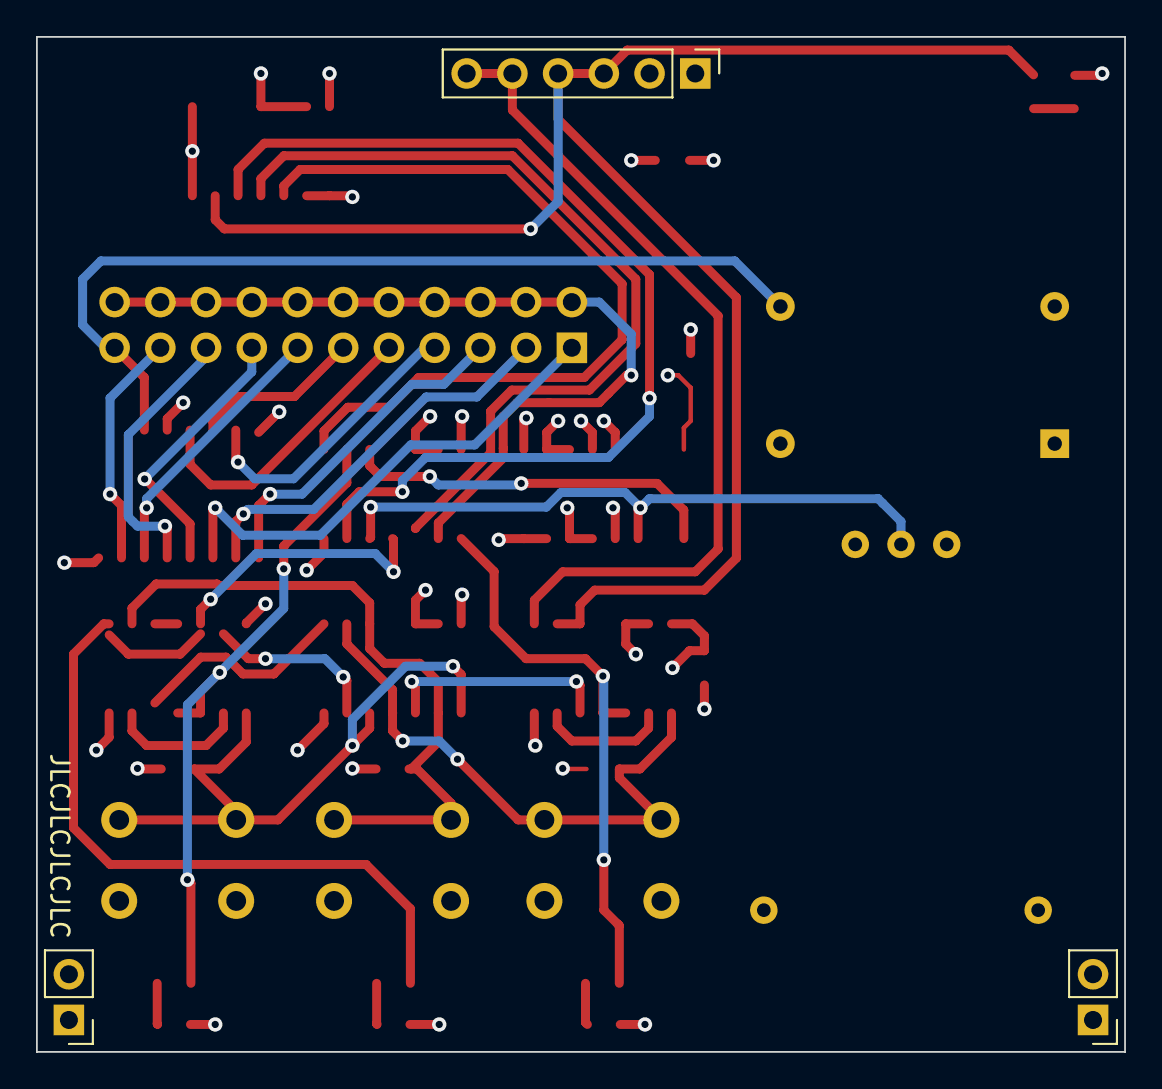
[picture p249: board CLOCK.kicad_pcb from below]

Board: 4 copper layers, 60.5 x 56.4 mm, 30 parts (3 on the bottom side), 37 nets.

Other parts of the board:
U4#2: DebouncedButton; COMP-DebounceButton-Component

Their connections:
/MANUAL_FULL_CLOCK: U4#2.3 (Q); also elsewhere on the board
GND: U4#2.2 (Gnd); also elsewhere on the board
VCC: U4#2.1 (Vcc); also elsewhere on the board
