theWickedWebDev/8-bit-computer/PCBs/03_MODULES/CPU-ALU/ALU-Arithmetic/ALU-Arithmetic.kicad_pcb

## KiCad design PCBs/03_MODULES/CPU-ALU/ALU-Arithmetic/ALU-Arithmetic.kicad_pcb (2022-08-27)

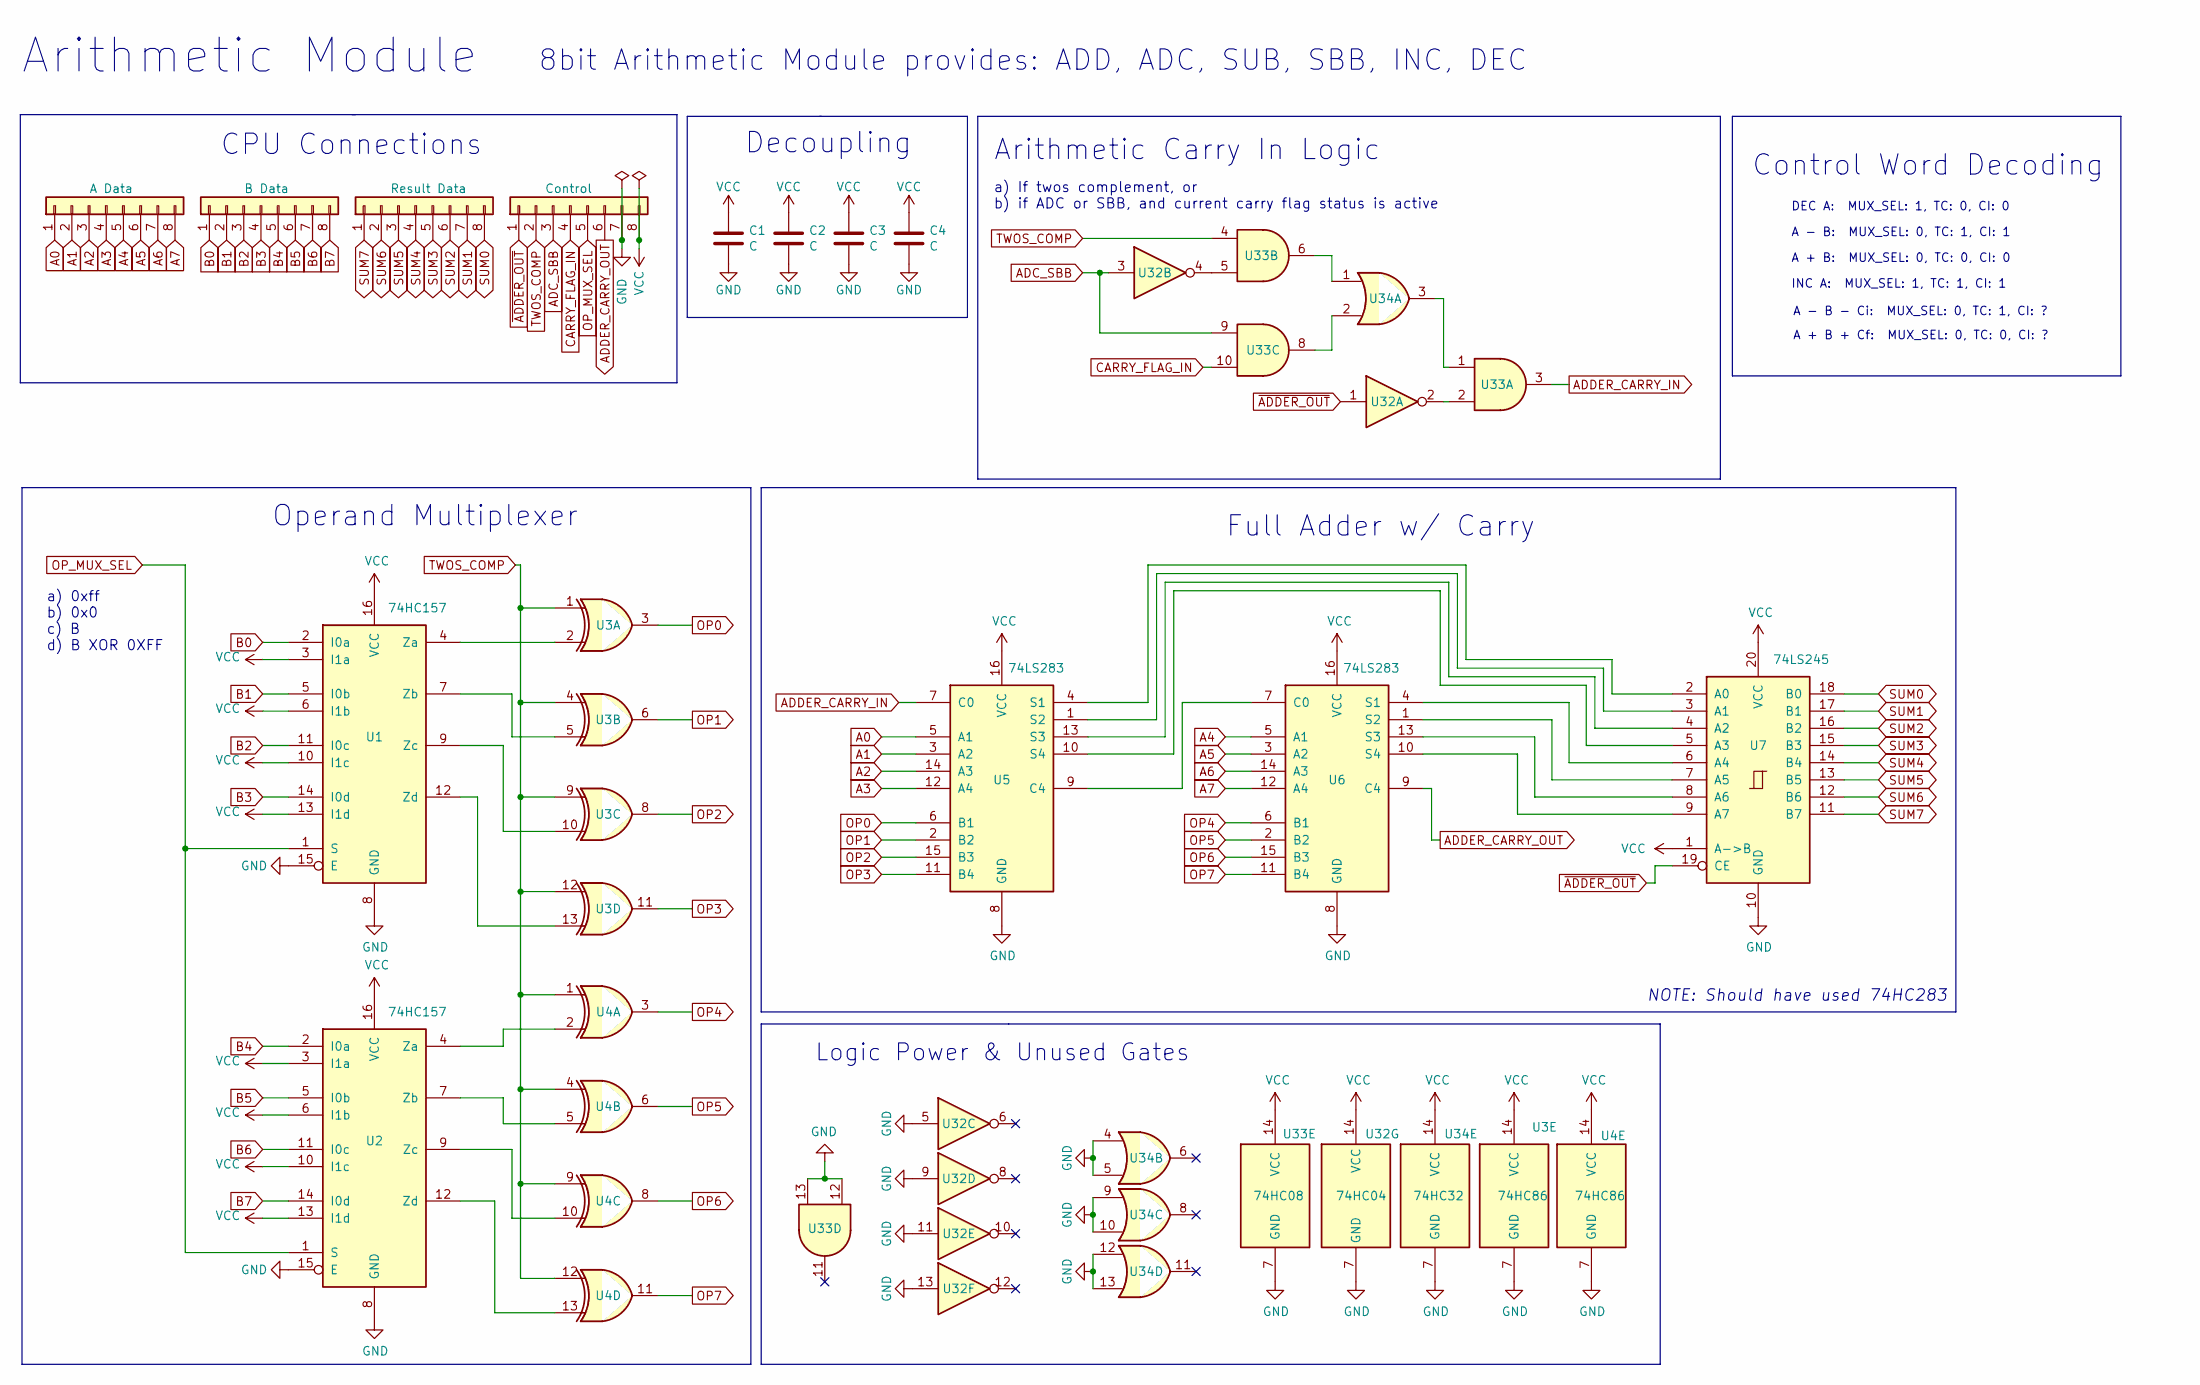
[picture p250: schematic ALU-Arithmetic.kicad_sch, Arithmetic Module]

Parts:
C1, C2, C3, C4: C; C_0805_2012Metric
J1, J2, J3, J4: Conn_01x08; PinHeader_1x08_P2.54mm_Vertical
U1, U2: 74HC157; TSSOP-16_4.4x5mm_P0.65mm
U3, U4: 74HC86; TSSOP-14_4.4x5mm_P0.65mm
U5, U6: 74LS283; SOIC-16W_5.3x10.2mm_P1.27mm
U7: 74LS245; TSSOP-20_4.4x6.5mm_P0.65mm
U32: 74HC04; TSSOP-14_4.4x5mm_P0.65mm
U33: 74HC08; TSSOP-14_4.4x5mm_P0.65mm
U34: 74HC32; TSSOP-14_4.4x5mm_P0.65mm

Connections:
A0: J1.1, U5.5 (A1)
A1: J1.2, U5.3 (A2)
A2: J1.3, U5.14 (A3)
A3: J1.4, U5.12 (A4)
A4: J1.5, U6.5 (A1)
A5: J1.6, U6.3 (A2)
A6: J1.7, U6.14 (A3)
A7: J1.8, U6.12 (A4)
ADC_SBB: J4.3, U32.3, U33.9
ADDER_CARRY_IN: U5.7 (C0), U33.3
ADDER_CARRY_OUT: J4.6, U6.9 (C4)
B0: J2.1, U1.2 (I0a)
B1: J2.2, U1.5 (I0b)
B2: J2.3, U1.11 (I0c)
B3: J2.4, U1.14 (I0d)
B4: J2.5, U2.2 (I0a)
B5: J2.6, U2.5 (I0b)
B6: J2.7, U2.11 (I0c)
B7: J2.8, U2.14 (I0d)
CARRY_FLAG_IN: J4.4, U33.10
unnamed: U1.4 (Za), U3.2
unnamed: U1.7 (Zb), U3.5
unnamed: U1.9 (Zc), U3.10
unnamed: U1.12 (Zd), U3.13
unnamed: U2.4 (Za), U4.2
unnamed: U2.7 (Zb), U4.5
unnamed: U2.9 (Zc), U4.10
unnamed: U2.12 (Zd), U4.13
unnamed: U5.1 (S2), U7.3 (A1)
unnamed: U5.4 (S1), U7.2 (A0)
unnamed: U5.9 (C4), U6.7 (C0)
unnamed: U5.10 (S4), U7.5 (A3)
unnamed: U5.13 (S3), U7.4 (A2)
unnamed: U6.1 (S2), U7.7 (A5)
unnamed: U6.4 (S1), U7.6 (A4)
unnamed: U6.10 (S4), U7.9 (A7)
unnamed: U6.13 (S3), U7.8 (A6)
unnamed: U32.2, U33.2
unnamed: U32.4, U33.5
unnamed: U33.1, U34.3
unnamed: U33.6, U34.1
unnamed: U33.8, U34.2
OP0: U3.3, U5.6 (B1)
OP1: U3.6, U5.2 (B2)
OP2: U3.8, U5.15 (B3)
OP3: U3.11, U5.11 (B4)
OP4: U4.3, U6.6 (B1)
OP5: U4.6, U6.2 (B2)
OP6: U4.8, U6.15 (B3)
OP7: U4.11, U6.11 (B4)
OP_MUX_SEL: J4.5, U1.1 (S), U2.1 (S)
SUM0: J3.8, U7.18 (B0)
SUM1: J3.7, U7.17 (B1)
SUM2: J3.6, U7.16 (B2)
SUM3: J3.5, U7.15 (B3)
SUM4: J3.4, U7.14 (B4)
SUM5: J3.3, U7.13 (B5)
SUM6: J3.2, U7.12 (B6)
SUM7: J3.1, U7.11 (B7)
TWOS_COMP: J4.2, U3.1, U3.4, U3.9, U3.12, U4.1, U4.4, U4.9, U4.12, U33.4
VCC: C1.1, C2.1, C3.1, C4.1, J4.8, U1.3 (I1a), U1.6 (I1b), U1.10 (I1c), U1.13 (I1d), U1.16 (VCC), U2.3 (I1a), U2.6 (I1b), U2.10 (I1c), U2.13 (I1d), U2.16 (VCC), U3.14 (VCC), U4.14 (VCC), U5.16 (VCC), U6.16 (VCC), U7.1 (A->B), U7.20 (VCC), U32.14 (VCC), U33.14 (VCC), U34.14 (VCC)
~ADDER_OUT: J4.1, U7.19 (CE), U32.1

Notes on the sheet:
a) 0xff b) 0x0 c) B d) B XOR 0XFF
CPU Connections
NOTE: Should have used 74HC283
8bit Arithmetic Module provides: ADD, ADC, SUB, SBB, INC, DEC
A - B - Ci: MUX_SEL: 0, TC: 1, CI: ?
Logic Power & Unused Gates
A + B + Cf: MUX_SEL: 0, TC: 0, CI: ?
Full Adder w/ Carry
Operand Multiplexer
Arithmetic Module
DEC A: MUX_SEL: 1, TC: 0, CI: 0
a) If twos complement, or b) if ADC or SBB, and current carry flag status is active
Arithmetic Carry In Logic
Decoupling
A - B: MUX_SEL: 0, TC: 1, CI: 1
Control Word Decoding
INC A: MUX_SEL: 1, TC: 1, CI: 1
A + B: MUX_SEL: 0, TC: 0, CI: 0

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
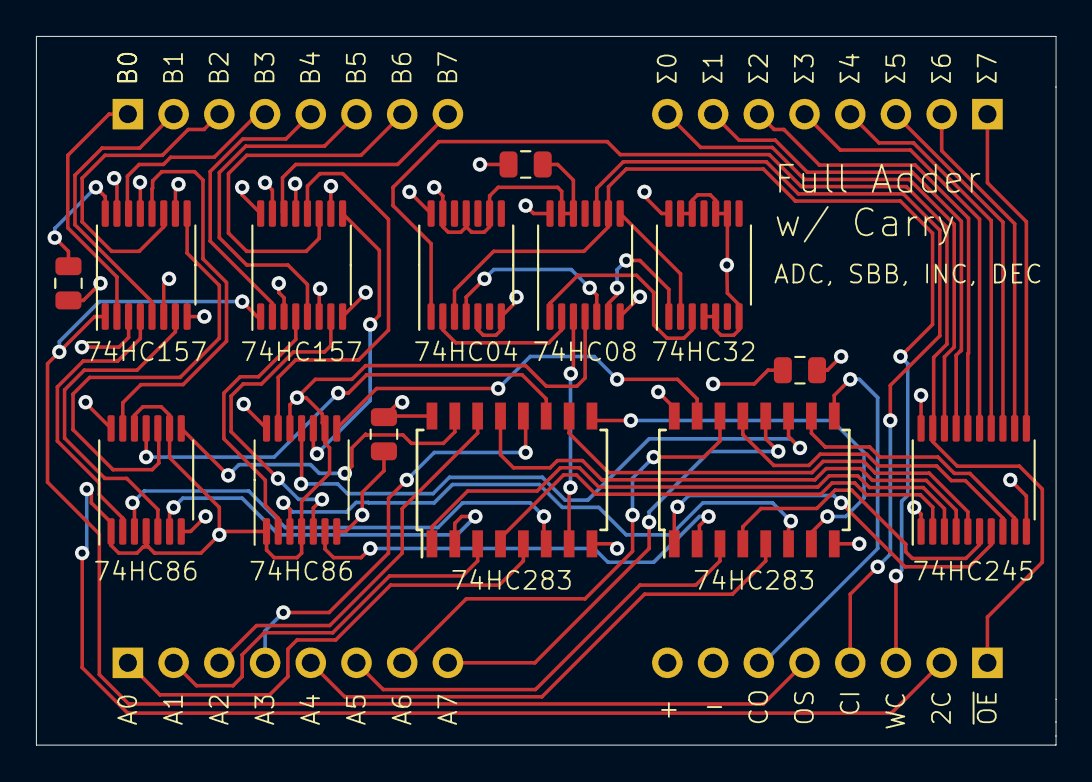
[picture p251: board ALU-Arithmetic.kicad_pcb from above]

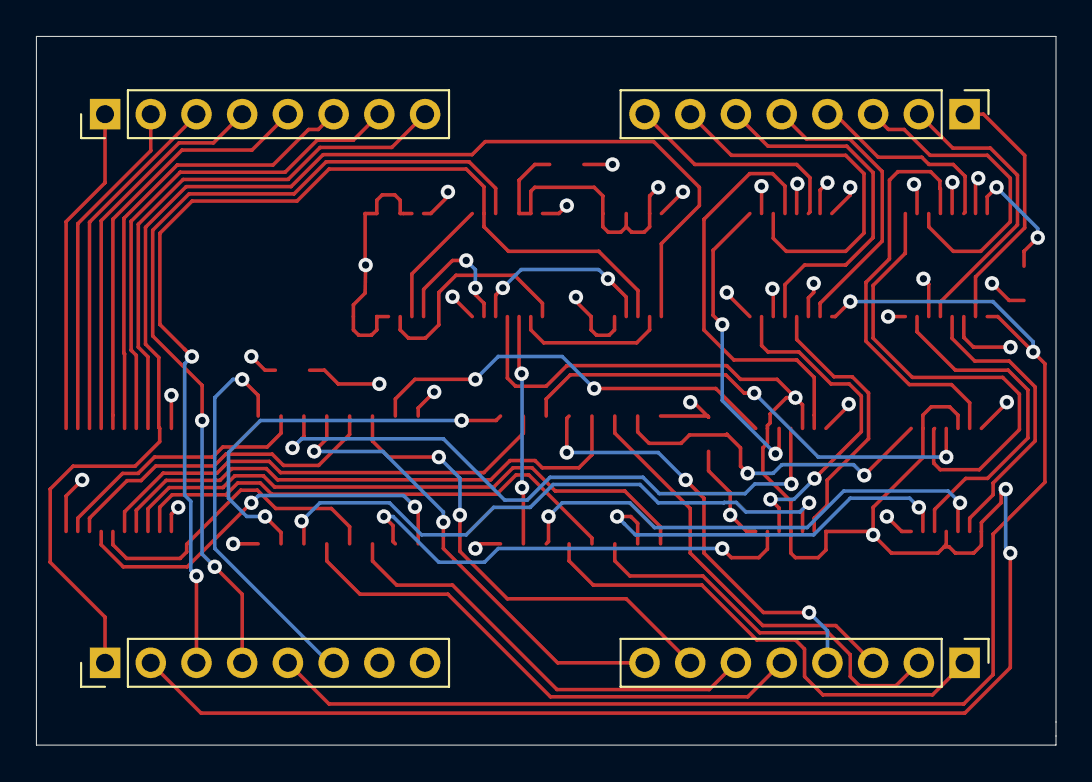
[picture p252: board ALU-Arithmetic.kicad_pcb from below]

Board: 4 copper layers, 56.6 x 39.4 mm, 18 parts (4 on the bottom side), 63 nets.
