theWickedWebDev/8-bit-computer/PCBs/03_MODULES/CPU-ALU/ALU-Shifter/Shifter-v6.kicad_pcb

## KiCad design PCBs/03_MODULES/CPU-ALU/ALU-Shifter/Shifter-v6.kicad_pcb (2022-02-28)

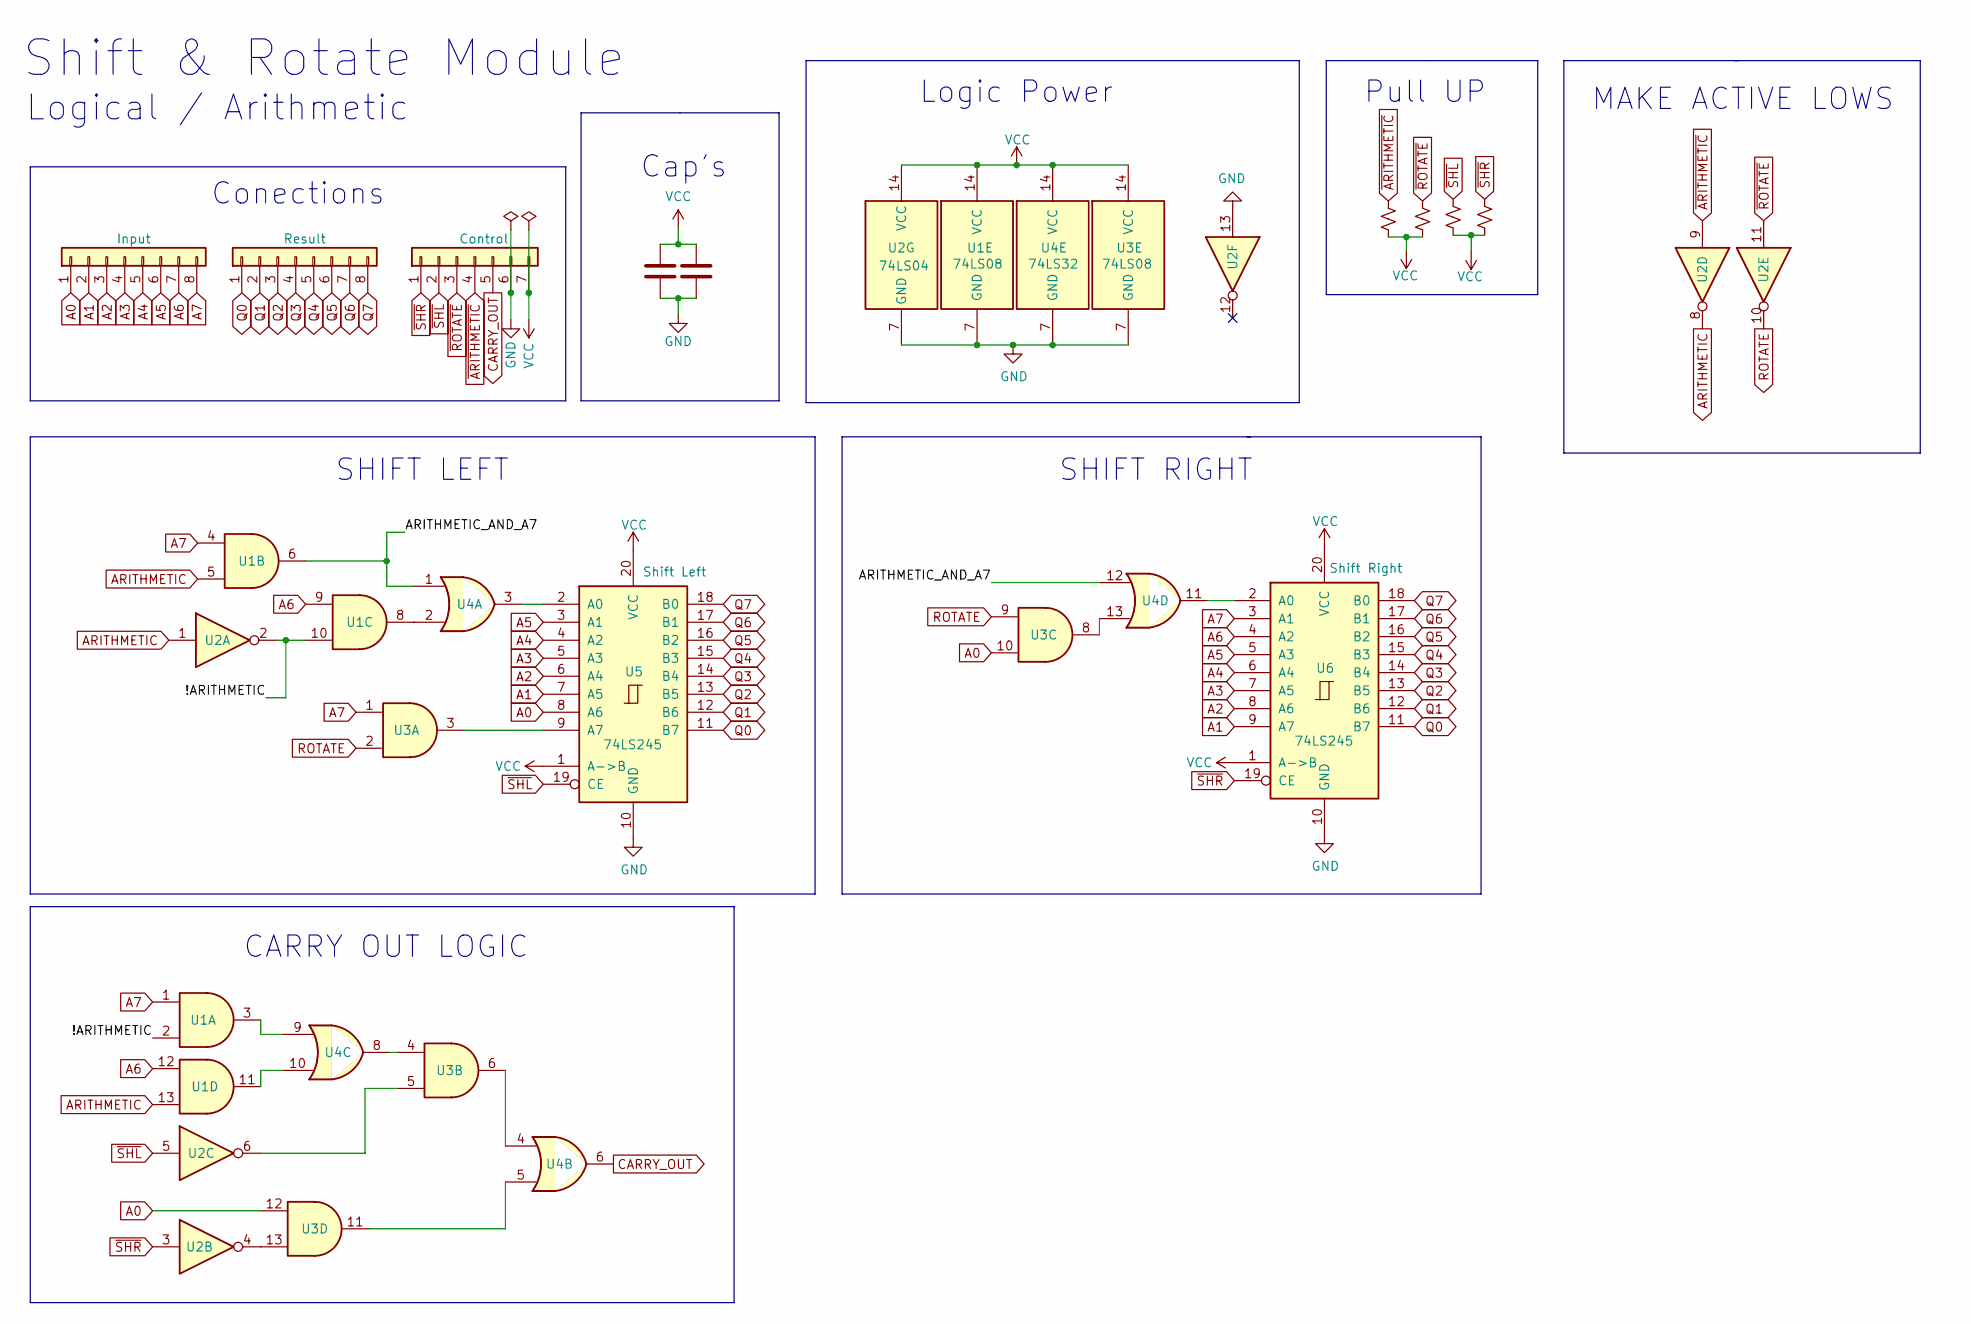
[picture p253: schematic Shifter-v6.kicad_sch, Arithmetic & Logical Shifter Module]

Parts:
C1, C2: C; C_0805_2012Metric
J1, J2: Conn_01x08; PinHeader_1x08_P2.54mm_Vertical
J3: Conn_01x07; PinHeader_1x07_P2.54mm_Vertical
R10, R11, R12, R13: R_Small_US; R_0805_2012Metric
U1, U3: 74LS08; TSSOP-14_4.4x5mm_P0.65mm
U2: 74LS04; TSSOP-14_4.4x5mm_P0.65mm
U4: 74LS32; TSSOP-14_4.4x5mm_P0.65mm
U5, U6: 74LS245; TSSOP-20_4.4x6.5mm_P0.65mm

Connections:
/!ARITHMETIC: U1.2, U1.10, U2.2
/ARITHMETIC_AND_A7: U1.6, U4.1, U4.12
A0: J1.1, U3.10, U3.12, U5.8 (A6)
A1: J1.2, U5.7 (A5), U6.9 (A7)
A2: J1.3, U5.6 (A4), U6.8 (A6)
A3: J1.4, U5.5 (A3), U6.7 (A5)
A4: J1.5, U5.4 (A2), U6.6 (A4)
A5: J1.6, U5.3 (A1), U6.5 (A3)
A6: J1.7, U1.9, U1.12, U6.4 (A2)
A7: J1.8, U1.1, U1.4, U3.1, U6.3 (A1)
ARITHMETIC: U1.5, U1.13, U2.1, U2.8
CARRY_OUT: J3.5, U4.6
GND: C1.1, C2.1, J3.6, U1.7 (GND), U2.7 (GND), U2.13, U3.7 (GND), U4.7 (GND), U5.10 (GND), U6.10 (GND)
unnamed: U1.3, U4.9
unnamed: U1.8, U4.2
unnamed: U1.11, U4.10
unnamed: U2.4, U3.13
unnamed: U2.6, U3.5
unnamed: U3.3, U5.9 (A7)
unnamed: U3.4, U4.8
unnamed: U3.6, U4.4
unnamed: U3.8, U4.13
unnamed: U3.11, U4.5
unnamed: U4.3, U5.2 (A0)
unnamed: U4.11, U6.2 (A0)
Q0: J2.1, U5.11 (B7), U6.11 (B7)
Q1: J2.2, U5.12 (B6), U6.12 (B6)
Q2: J2.3, U5.13 (B5), U6.13 (B5)
Q3: J2.4, U5.14 (B4), U6.14 (B4)
Q4: J2.5, U5.15 (B3), U6.15 (B3)
Q5: J2.6, U5.16 (B2), U6.16 (B2)
Q6: J2.7, U5.17 (B1), U6.17 (B1)
Q7: J2.8, U5.18 (B0), U6.18 (B0)
ROTATE: U2.10, U3.2, U3.9
~ARITHMETIC: J3.4, R13.1, U2.9
~ROTATE: J3.3, R10.1, U2.11
~SHL: J3.2, R11.1, U2.5, U5.19 (CE)
~SHR: J3.1, R12.1, U2.3, U6.19 (CE)

Notes on the sheet:
Cap's
Shift & Rotate Module
SHIFT RIGHT
SHIFT LEFT
Conections
Logic Power
MAKE ACTIVE LOWS
Pull UP
Logical / Arithmetic
CARRY OUT LOGIC

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
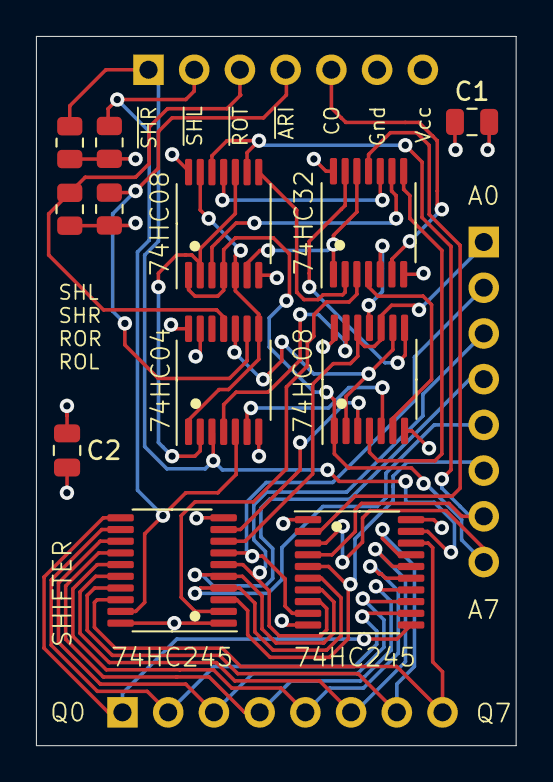
[picture p254: board Shifter-v6.kicad_pcb from above]

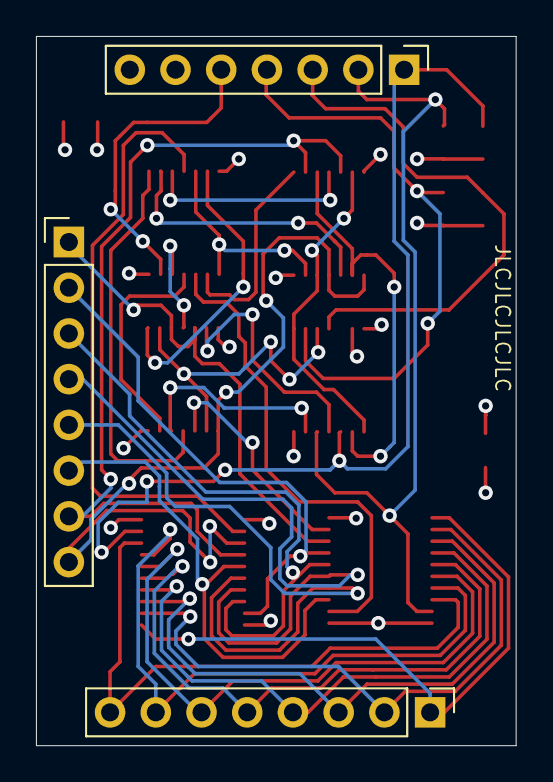
[picture p255: board Shifter-v6.kicad_pcb from below]

Board: 4 copper layers, 26.7 x 39.4 mm, 15 parts (3 on the bottom side), 39 nets.
