theWickedWebDev/8-bit-computer/PCBs/99_IN PROGRESS/ADC-Decoder-Controller/ADC-Decoder-Controller.kicad_pcb

## KiCad design PCBs/99_IN PROGRESS/ADC-Decoder-Controller/ADC-Decoder-Controller.kicad_pcb (2022-04-04)

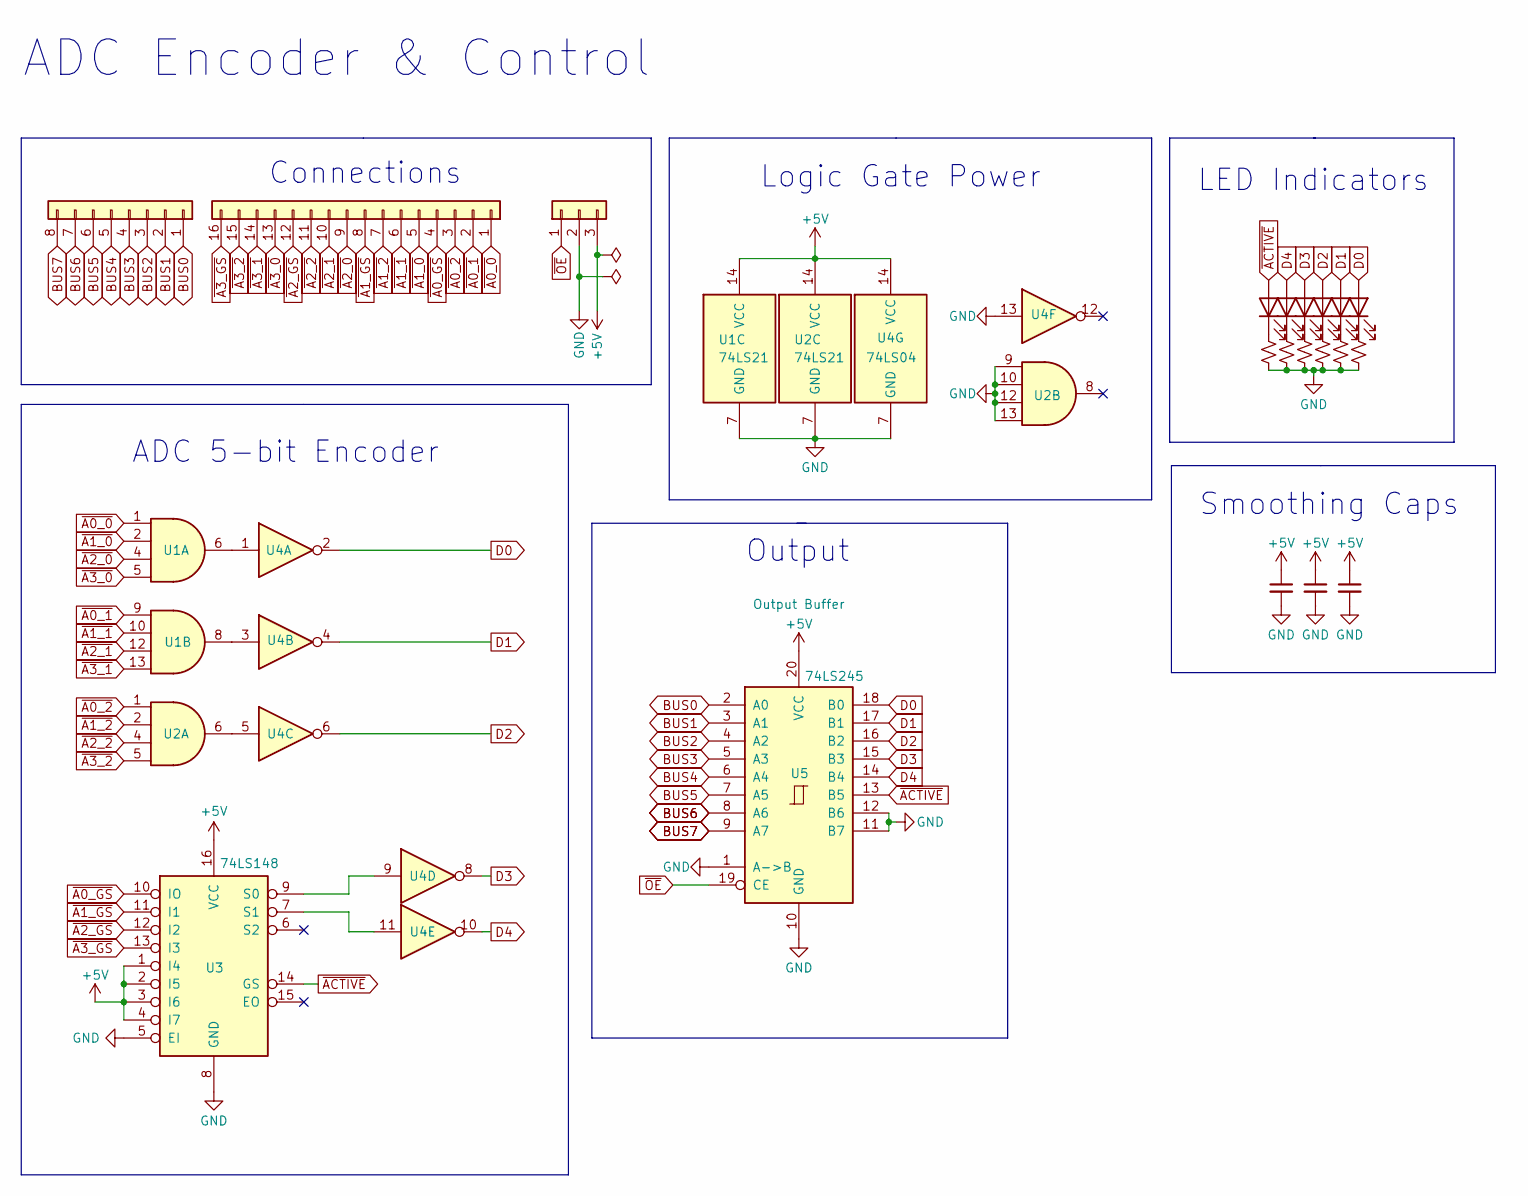
[picture p256: schematic ADC-Decoder-Controller.kicad_sch]

Parts:
C1, C2, C3: C_Small; C_0805_2012Metric
D1, D2, D3, D4, D5, D6: LED; LED_0805_2012Metric
J1: Conn_01x08; PinHeader_1x08_P2.54mm_Vertical
J2: Conn_01x16; PinHeader_1x16_P2.54mm_Vertical
J3: Conn_01x03; PinHeader_1x03_P2.54mm_Vertical
R3, R4, R5, R6, R7, R8: R_Small_US; R_0805_2012Metric
U1, U2: 74LS21; SOIC-14_3.9x8.7mm_P1.27mm
U3: 74LS148; SOIC-16_3.9x9.9mm_P1.27mm
U4: 74LS04; SOIC-14_3.9x8.7mm_P1.27mm
U5: 74LS245; SOIC-20W_7.5x12.8mm_P1.27mm

Connections:
+5V: C1.1, C2.1, C3.1, J3.3, U1.14 (VCC), U2.14 (VCC), U3.1 (I4), U3.2 (I5), U3.3 (I6), U3.4 (I7), U3.5 (EI), U3.16 (VCC), U4.14 (VCC), U5.20 (VCC)
BUS0: J1.1, U5.2 (A0)
BUS1: J1.2, U5.3 (A1)
BUS2: J1.3, U5.4 (A2)
BUS3: J1.4, U5.5 (A3)
BUS4: J1.5, U5.6 (A4)
BUS5: J1.6, U5.7 (A5)
BUS6: J1.7, U5.8 (A6)
BUS7: J1.8, U5.9 (A7)
D0: D6.2 (A), U4.2, U5.18 (B0)
D1: D5.2 (A), U4.4, U5.17 (B1)
D2: D4.2 (A), U4.6, U5.16 (B2)
D3: D3.2 (A), U4.8, U5.15 (B3)
D4: D2.2 (A), U4.10, U5.14 (B4)
GND: C1.2, C2.2, C3.2, J3.2, R3.2, R4.2, R5.2, R6.2, R7.2, R8.2, U1.7 (GND), U2.7 (GND), U2.9, U2.10, U2.12, U2.13, U3.8 (GND), U4.7 (GND), U4.13, U5.1 (A->B), U5.10 (GND), U5.11 (B7), U5.12 (B6)
unnamed: D1.1 (K), R3.1
unnamed: D2.1 (K), R4.1
unnamed: D3.1 (K), R5.1
unnamed: D4.1 (K), R6.1
unnamed: D5.1 (K), R7.1
unnamed: D6.1 (K), R8.1
unnamed: U1.6, U4.1
unnamed: U1.8, U4.3
unnamed: U2.6, U4.5
unnamed: U3.7 (S1), U4.11
unnamed: U3.9 (S0), U4.9
~A0_0: J2.1, U1.1
~A0_1: J2.2, U1.9
~A0_2: J2.3, U2.1
~A0_GS: J2.4, U3.10 (IO)
~A1_0: J2.5, U1.2
~A1_1: J2.6, U1.10
~A1_2: J2.7, U2.2
~A1_GS: J2.8, U3.11 (I1)
~A2_0: J2.9, U1.4
~A2_1: J2.10, U1.12
~A2_2: J2.11, U2.4
~A2_GS: J2.12, U3.12 (I2)
~A3_0: J2.13, U1.5
~A3_1: J2.14, U1.13
~A3_2: J2.15, U2.5
~A3_GS: J2.16, U3.13 (I3)
~ACTIVE: D1.2 (A), U3.14 (GS), U5.13 (B5)
~OE: J3.1, U5.19 (CE)

Notes on the sheet:
ADC 5-bit Encoder
ADC Encoder & Control
Smoothing Caps
Connections
Output
LED Indicators
Logic Gate Power

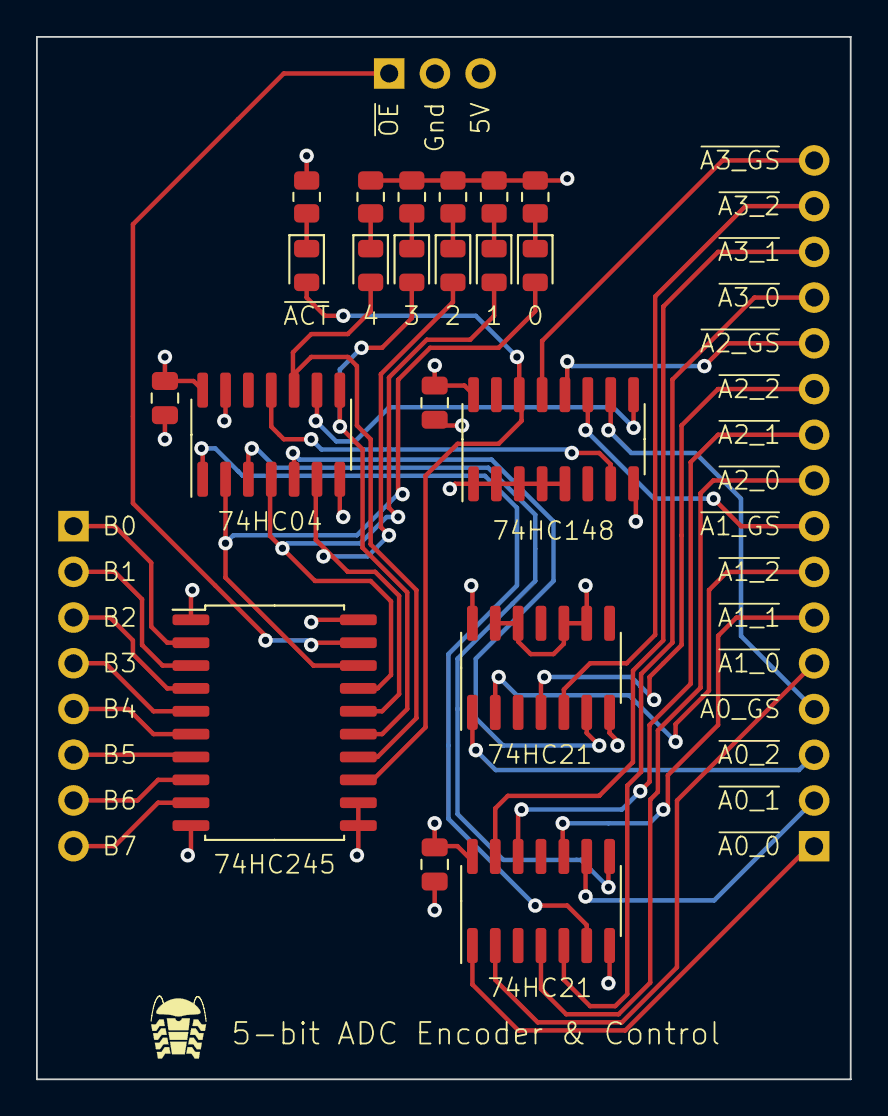
[picture p257: board ADC-Decoder-Controller.kicad_pcb from above]

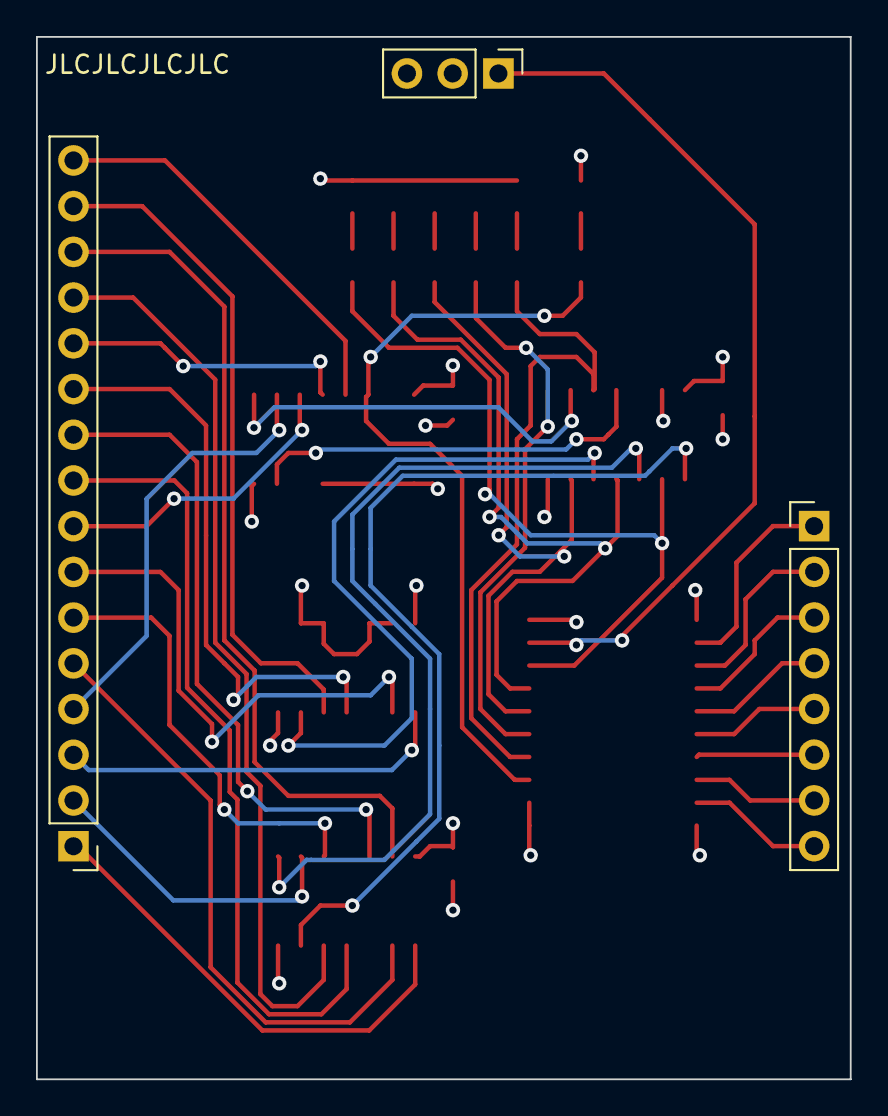
[picture p258: board ADC-Decoder-Controller.kicad_pcb from below]

Board: 4 copper layers, 45.2 x 57.9 mm, 23 parts (3 on the bottom side), 44 nets.
