theWickedWebDev/8-bit-computer/PCBs/99_IN PROGRESS/Displacement/SPR-Displacement-Register/powerful-register-2022.kicad_pcb

## KiCad design PCBs/99_IN PROGRESS/Displacement/SPR-Displacement-Register/powerful-register-2022.kicad_pcb (2022-06-18)

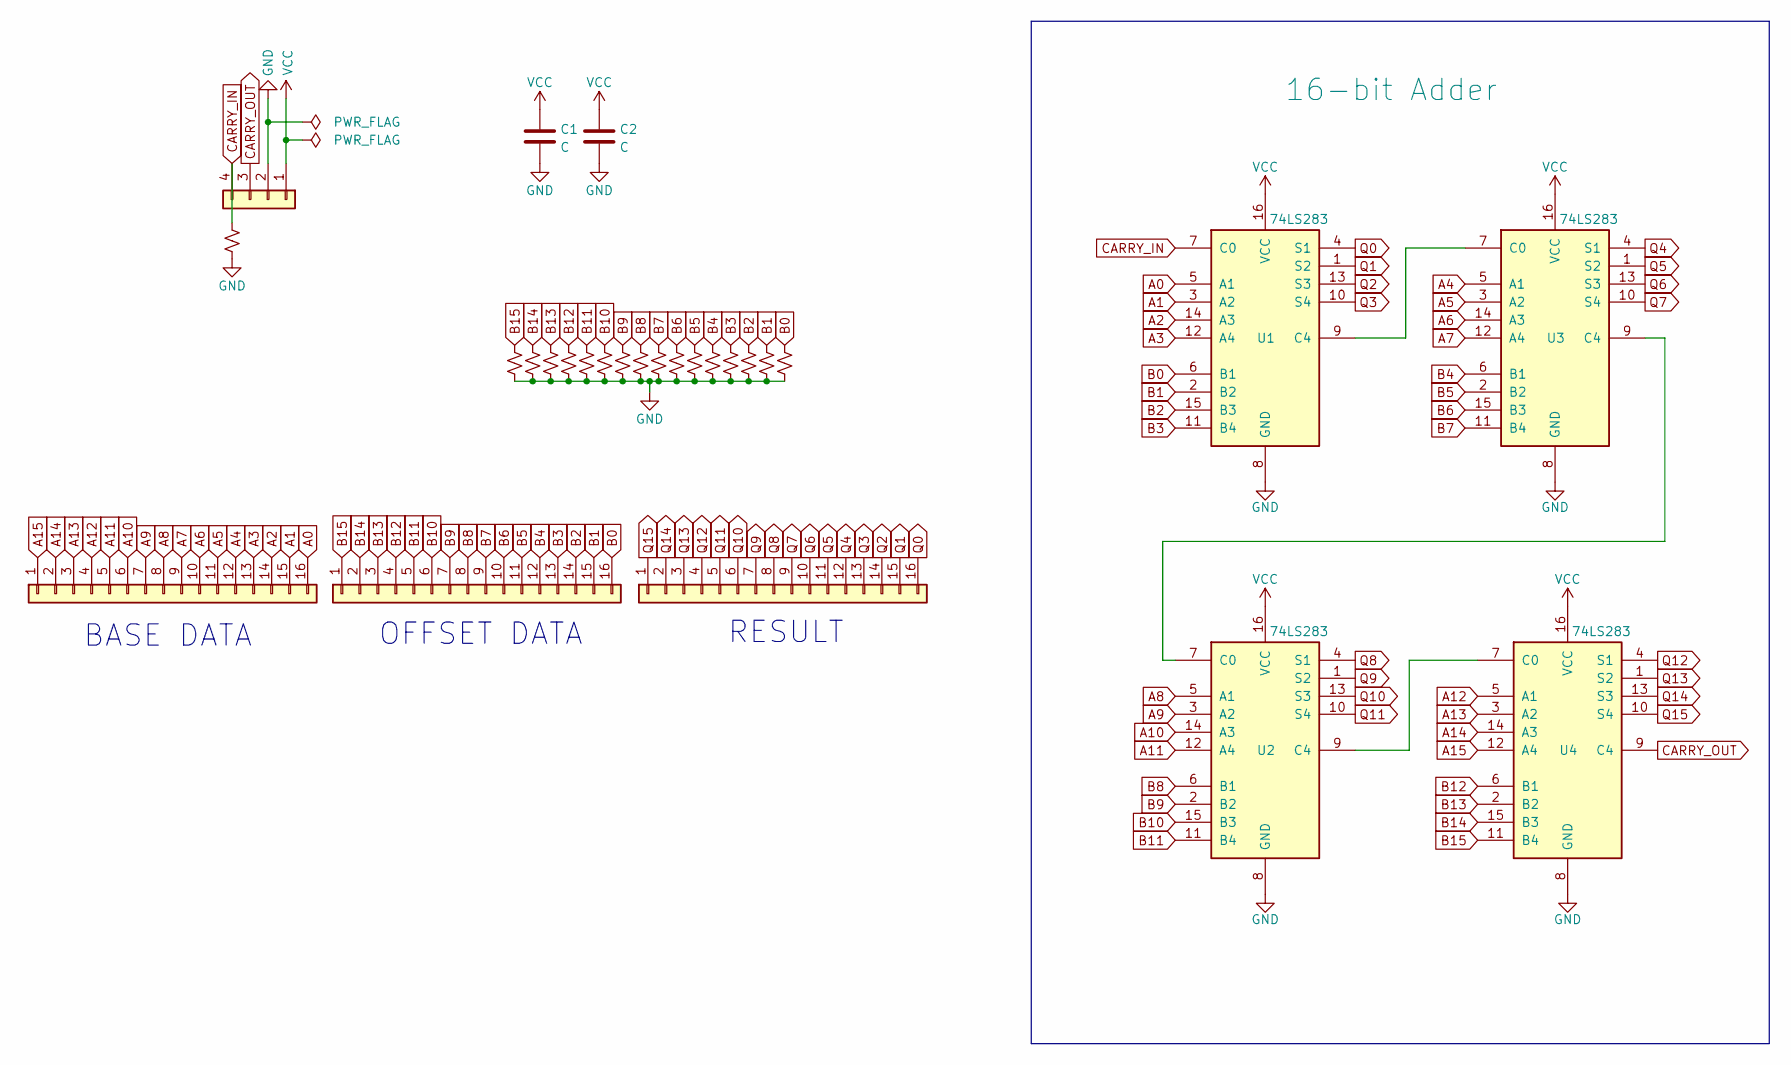
[picture p259: schematic powerful-register-2022.kicad_sch]

Parts:
C1, C2: C; C_0805_2012Metric
J1: Conn_01x06; PinHeader_1x04_P2.54mm_Vertical
J2, J3, J4: Conn_01x16; PinHeader_1x16_P2.54mm_Vertical
R1, R2, R3, R4, R5, R6, R7, R8, R9, R10, R11, R12, R13, R14, R15, R16, R17: R_Small_US; R_0805_2012Metric
U1, U2, U3, U4: 74LS283; SOIC-16_4.55x10.3mm_P1.27mm

Connections:
A0: J2.16, U1.5 (A1)
A1: J2.15, U1.3 (A2)
A2: J2.14, U1.14 (A3)
A3: J2.13, U1.12 (A4)
A4: J2.12, U3.5 (A1)
A5: J2.11, U3.3 (A2)
A6: J2.10, U3.14 (A3)
A7: J2.9, U3.12 (A4)
A8: J2.8, U2.5 (A1)
A9: J2.7, U2.3 (A2)
A10: J2.6, U2.14 (A3)
A11: J2.5, U2.12 (A4)
A12: J2.4, U4.5 (A1)
A13: J2.3, U4.3 (A2)
A14: J2.2, U4.14 (A3)
A15: J2.1, U4.12 (A4)
B0: J4.16, R17.1, U1.6 (B1)
B1: J4.15, R16.1, U1.2 (B2)
B2: J4.14, R15.1, U1.15 (B3)
B3: J4.13, R14.1, U1.11 (B4)
B4: J4.12, R13.1, U3.6 (B1)
B5: J4.11, R12.1, U3.2 (B2)
B6: J4.10, R11.1, U3.15 (B3)
B7: J4.9, R10.1, U3.11 (B4)
B8: J4.8, R9.1, U2.6 (B1)
B9: J4.7, R8.1, U2.2 (B2)
B10: J4.6, R7.1, U2.15 (B3)
B11: J4.5, R6.1, U2.11 (B4)
B12: J4.4, R5.1, U4.6 (B1)
B13: J4.3, R4.1, U4.2 (B2)
B14: J4.2, R2.1, U4.15 (B3)
B15: J4.1, R1.1, U4.11 (B4)
GND: C1.2, C2.2, J1.2, R1.2, R2.2, R3.2, R4.2, R5.2, R6.2, R7.2, R8.2, R9.2, R10.2, R11.2, R12.2, R13.2, R14.2, R15.2, R16.2, R17.2, U1.8 (GND), U2.8 (GND), U3.8 (GND), U4.8 (GND)
unnamed: U1.9 (C4), U3.7 (C0)
unnamed: U2.7 (C0), U3.9 (C4)
unnamed: U2.9 (C4), U4.7 (C0)
Q0: J3.16, U1.4 (S1)
Q1: J3.15, U1.1 (S2)
Q2: J3.14, U1.13 (S3)
Q3: J3.13, U1.10 (S4)
Q4: J3.12, U3.4 (S1)
Q5: J3.11, U3.1 (S2)
Q6: J3.10, U3.13 (S3)
Q7: J3.9, U3.10 (S4)
Q8: J3.8, U2.4 (S1)
Q9: J3.7, U2.1 (S2)
Q10: J3.6, U2.13 (S3)
Q11: J3.5, U2.10 (S4)
Q12: J3.4, U4.4 (S1)
Q13: J3.3, U4.1 (S2)
Q14: J3.2, U4.13 (S3)
Q15: J3.1, U4.10 (S4)
VCC: C1.1, C2.1, J1.1, U1.16 (VCC), U2.16 (VCC), U3.16 (VCC), U4.16 (VCC)

Notes on the sheet:
BASE DATA
RESULT
OFFSET DATA

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
Board: 4 copper layers, 27 parts (4 on the bottom side), 55 nets, no tracks yet.
