theWickedWebDev/8-bit-computer/PCBs/99_IN PROGRESS/IO-Timer-2022/interrupts.kicad_pcb

## KiCad design PCBs/99_IN PROGRESS/IO-Timer-2022/interrupts.kicad_pcb (2022-06-18)

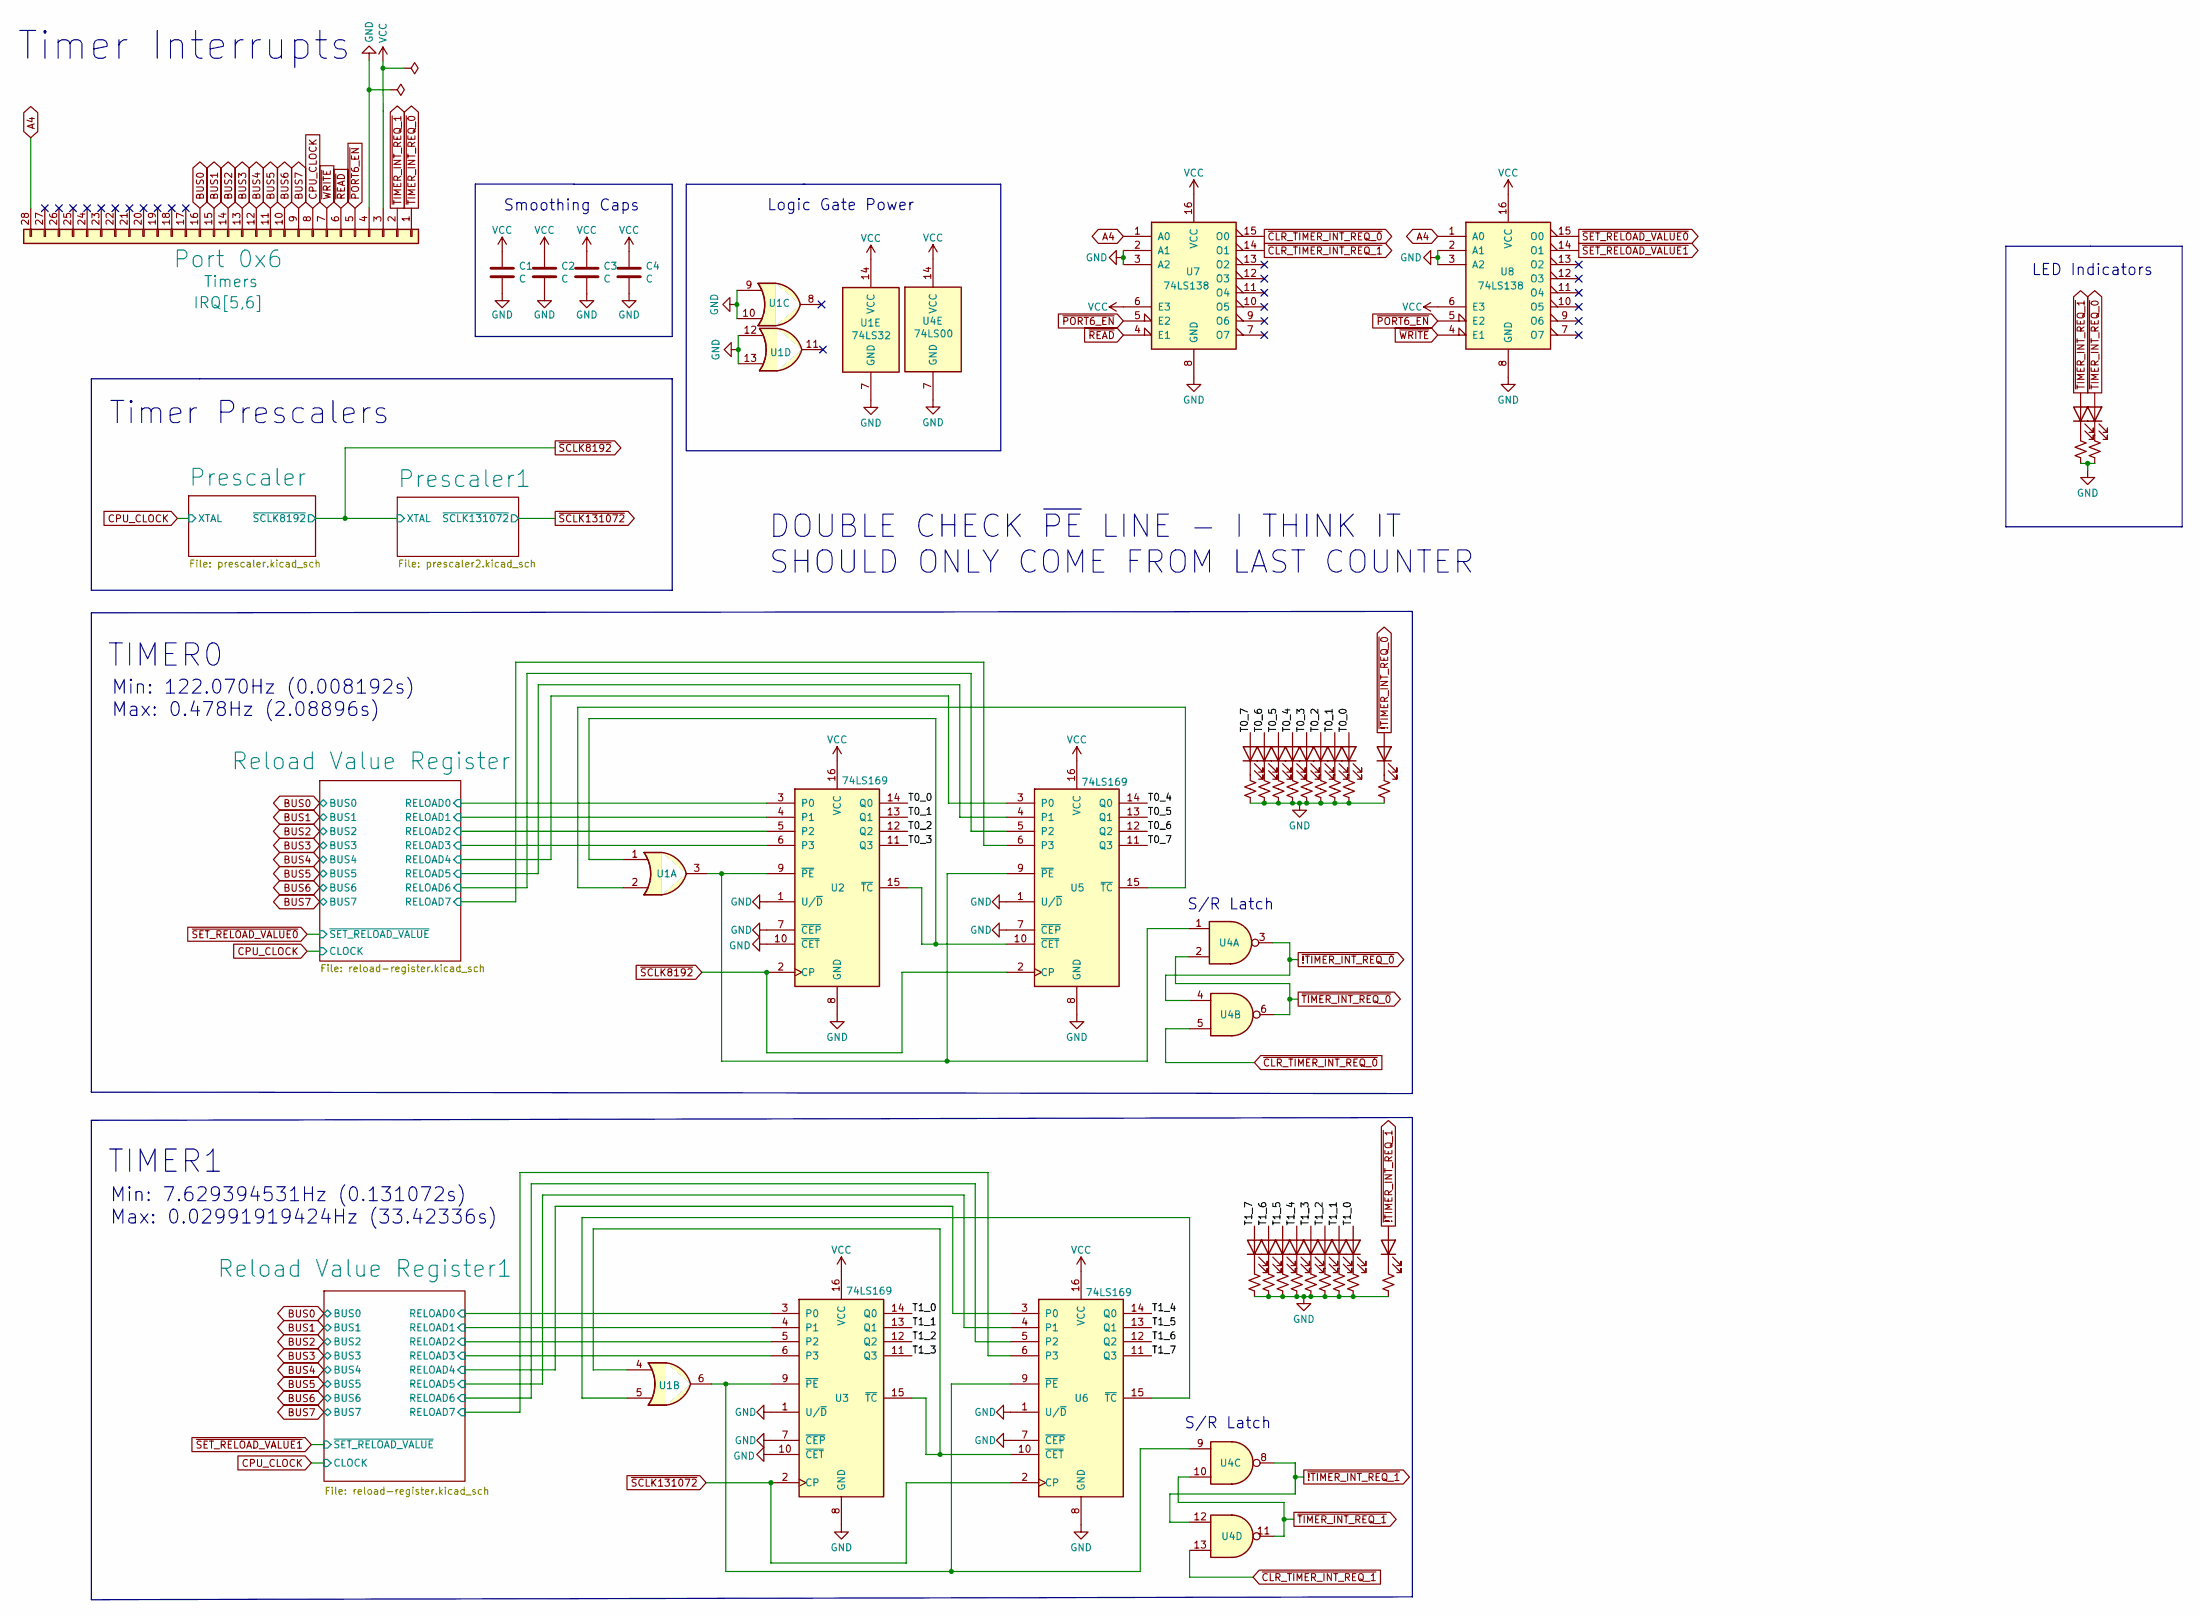
[picture p260: schematic interrupts.kicad_sch]

Parts:
C1, C2, C3, C4: C; C_0805_2012Metric
D1, D2, D3, D4, D5, D6, D7, D8, D9, D10, D11, D12, D13, D14, D15, D16, D17, D18, D19, D20: LED; LED_0805_2012Metric
J1: Conn_01x28; PinHeader_1x28_P2.54mm_Horizontal
R1, R2, R3, R4, R5, R6, R7, R8, R9, R10, R11, R12, R13, R14, R15, R16, R17, R18, R19, R20: R_Small_US; R_0805_2012Metric
U1: 74LS32
U2, U3, U5, U6: 74LS169; SOIC-16_3.9x9.9mm_P1.27mm
U4: 74LS00
U7, U8: 74LS138; SOIC-16_3.9x9.9mm_P1.27mm

Connections:
/Reload Value Register1/RELOAD0: U3.3 (P0); also elsewhere on the board
/Reload Value Register1/RELOAD1: U3.4 (P1); also elsewhere on the board
/Reload Value Register1/RELOAD2: U3.5 (P2); also elsewhere on the board
/Reload Value Register1/RELOAD3: U3.6 (P3); also elsewhere on the board
/Reload Value Register1/RELOAD4: U6.3 (P0); also elsewhere on the board
/Reload Value Register1/RELOAD5: U6.4 (P1); also elsewhere on the board
/Reload Value Register1/RELOAD6: U6.5 (P2); also elsewhere on the board
/Reload Value Register1/RELOAD7: U6.6 (P3); also elsewhere on the board
/Reload Value Register/RELOAD0: U2.3 (P0); also elsewhere on the board
/Reload Value Register/RELOAD1: U2.4 (P1); also elsewhere on the board
/Reload Value Register/RELOAD2: U2.5 (P2); also elsewhere on the board
/Reload Value Register/RELOAD3: U2.6 (P3); also elsewhere on the board
/Reload Value Register/RELOAD4: U5.3 (P0); also elsewhere on the board
/Reload Value Register/RELOAD5: U5.4 (P1); also elsewhere on the board
/Reload Value Register/RELOAD6: U5.5 (P2); also elsewhere on the board
/Reload Value Register/RELOAD7: U5.6 (P3); also elsewhere on the board
/T0_0: D15.2 (A), U2.14 (Q0)
/T0_1: D13.2 (A), U2.13 (Q1)
/T0_2: D11.2 (A), U2.12 (Q2)
/T0_3: D9.2 (A), U2.11 (Q3)
/T0_4: D7.2 (A), U5.14 (Q0)
/T0_5: D5.2 (A), U5.13 (Q1)
/T0_6: D3.2 (A), U5.12 (Q2)
/T0_7: D1.2 (A), U5.11 (Q3)
/T1_0: D16.2 (A), U3.14 (Q0)
/T1_1: D14.2 (A), U3.13 (Q1)
/T1_2: D12.2 (A), U3.12 (Q2)
/T1_3: D10.2 (A), U3.11 (Q3)
/T1_4: D8.2 (A), U6.14 (Q0)
/T1_5: D6.2 (A), U6.13 (Q1)
/T1_6: D4.2 (A), U6.12 (Q2)
/T1_7: D2.2 (A), U6.11 (Q3)
A4: J1.28, U7.1 (A0), U8.1 (A0)
BUS0: J1.16; also elsewhere on the board
BUS1: J1.15; also elsewhere on the board
BUS2: J1.14; also elsewhere on the board
BUS3: J1.13; also elsewhere on the board
BUS4: J1.12; also elsewhere on the board
BUS5: J1.11; also elsewhere on the board
BUS6: J1.10; also elsewhere on the board
BUS7: J1.9; also elsewhere on the board
CPU_CLOCK: J1.8; also elsewhere on the board
GND: C1.2, C2.2, C3.2, C4.2, J1.4, R1.2, R2.2, R3.2, R4.2, R5.2, R6.2, R7.2, R8.2, R9.2, R10.2, R11.2, R12.2, R13.2, R14.2, R15.2, R16.2, R17.2, R18.2, R19.2, R20.2, U1.7 (GND), U1.9, U1.10, U1.12, U1.13, U2.1 (U/~D), U2.7 (~CEP), U2.8 (GND), U2.10 (~CET), U3.1 (U/~D), U3.7 (~CEP), U3.8 (GND), U3.10 (~CET), U4.7 (GND), U5.1 (U/~D), U5.7 (~CEP), U5.8 (GND), U6.1 (U/~D), U6.7 (~CEP), U6.8 (GND), U7.2 (A1), U7.3 (A2), U7.8 (GND), U8.2 (A1), U8.3 (A2), U8.8 (GND); also elsewhere on the board
unnamed: D1.1 (K), R1.1
unnamed: D2.1 (K), R2.1
unnamed: D3.1 (K), R3.1
unnamed: D4.1 (K), R4.1
unnamed: D5.1 (K), R5.1
unnamed: D6.1 (K), R6.1
unnamed: D7.1 (K), R7.1
unnamed: D8.1 (K), R8.1
unnamed: D9.1 (K), R9.1
unnamed: D10.1 (K), R10.1
unnamed: D11.1 (K), R11.1
unnamed: D12.1 (K), R12.1
unnamed: D13.1 (K), R13.1
unnamed: D14.1 (K), R14.1
unnamed: D15.1 (K), R15.1
unnamed: D16.1 (K), R16.1
unnamed: D17.1 (K), R17.1
unnamed: D18.1 (K), R18.1
unnamed: D19.1 (K), R19.1
unnamed: D20.1 (K), R20.1
unnamed: U1.1, U2.15 (~TC), U5.10 (~CET)
unnamed: U1.2, U5.15 (~TC)
unnamed: U1.3, U2.9 (~PE), U4.1, U5.9 (~PE)
unnamed: U1.4, U3.15 (~TC), U6.10 (~CET)
unnamed: U1.5, U6.15 (~TC)
unnamed: U1.6, U3.9 (~PE), U4.9, U6.9 (~PE)
VCC: C1.1, C2.1, C3.1, C4.1, J1.3, U1.14 (VCC), U2.16 (VCC), U3.16 (VCC), U4.14 (VCC), U5.16 (VCC), U6.16 (VCC), U7.6 (E3), U7.16 (VCC), U8.6 (E3), U8.16 (VCC); also elsewhere on the board
~!TIMER_INT_REQ_0: D17.2 (A), U4.3, U4.4
~!TIMER_INT_REQ_1: D18.2 (A), U4.8, U4.12
~CLR_TIMER_INT_REQ_0: U4.5, U7.15 (O0)
~CLR_TIMER_INT_REQ_1: U4.13, U7.14 (O1)
~PORT6_EN: J1.5, U7.5 (E2), U8.5 (E2)
~READ: J1.6, U7.4 (E1)
~SCLK8192: U2.2 (CP), U5.2 (CP); also elsewhere on the board
~SCLK131072: U3.2 (CP), U6.2 (CP); also elsewhere on the board
~SET_RELOAD_VALUE0: U8.15 (O0); also elsewhere on the board
~SET_RELOAD_VALUE1: U8.14 (O1); also elsewhere on the board
~TIMER_INT_REQ_0: D20.2 (A), J1.1, U4.2, U4.6
~TIMER_INT_REQ_1: D19.2 (A), J1.2, U4.10, U4.11
~WRITE: J1.7, U8.4 (E1)

Notes on the sheet:
DOUBLE CHECK ~{PE} LINE - I THINK IT SHOULD ONLY COME FROM LAST COUNTER
Min: 7.629394531Hz (0.131072s) Max: 0.02991919424Hz (33.42336s)
TIMER1
LED Indicators
Timer Interrupts
Timer Prescalers
Smoothing Caps
Logic Gate Power
S/R Latch
TIMER0
Min: 122.070Hz (0.008192s) Max: 0.478Hz (2.08896s)

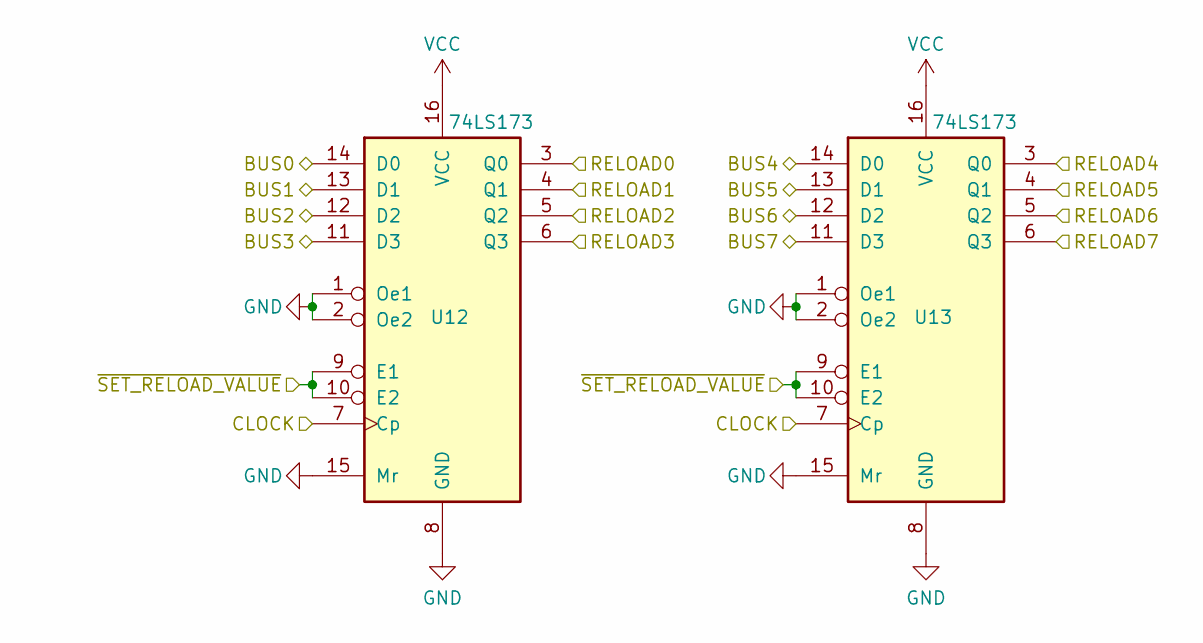
[picture p261: schematic reload-register.kicad_sch]

Parts:
U12, U13: 74LS173; SOIC-16_3.9x9.9mm_P1.27mm

Connections:
/Reload Value Register1/RELOAD0: U12.3 (Q0); also elsewhere on the board
/Reload Value Register1/RELOAD1: U12.4 (Q1); also elsewhere on the board
/Reload Value Register1/RELOAD2: U12.5 (Q2); also elsewhere on the board
/Reload Value Register1/RELOAD3: U12.6 (Q3); also elsewhere on the board
/Reload Value Register1/RELOAD4: U13.3 (Q0); also elsewhere on the board
/Reload Value Register1/RELOAD5: U13.4 (Q1); also elsewhere on the board
/Reload Value Register1/RELOAD6: U13.5 (Q2); also elsewhere on the board
/Reload Value Register1/RELOAD7: U13.6 (Q3); also elsewhere on the board
BUS0: U12.14 (D0); also elsewhere on the board
BUS1: U12.13 (D1); also elsewhere on the board
BUS2: U12.12 (D2); also elsewhere on the board
BUS3: U12.11 (D3); also elsewhere on the board
BUS4: U13.14 (D0); also elsewhere on the board
BUS5: U13.13 (D1); also elsewhere on the board
BUS6: U13.12 (D2); also elsewhere on the board
BUS7: U13.11 (D3); also elsewhere on the board
CPU_CLOCK: U12.7 (Cp), U13.7 (Cp); also elsewhere on the board
GND: U12.1 (Oe1), U12.2 (Oe2), U12.8 (GND), U12.15 (Mr), U13.1 (Oe1), U13.2 (Oe2), U13.8 (GND), U13.15 (Mr); also elsewhere on the board
VCC: U12.16 (VCC), U13.16 (VCC); also elsewhere on the board
~SET_RELOAD_VALUE1: U12.9 (E1), U12.10 (E2), U13.9 (E1), U13.10 (E2); also elsewhere on the board

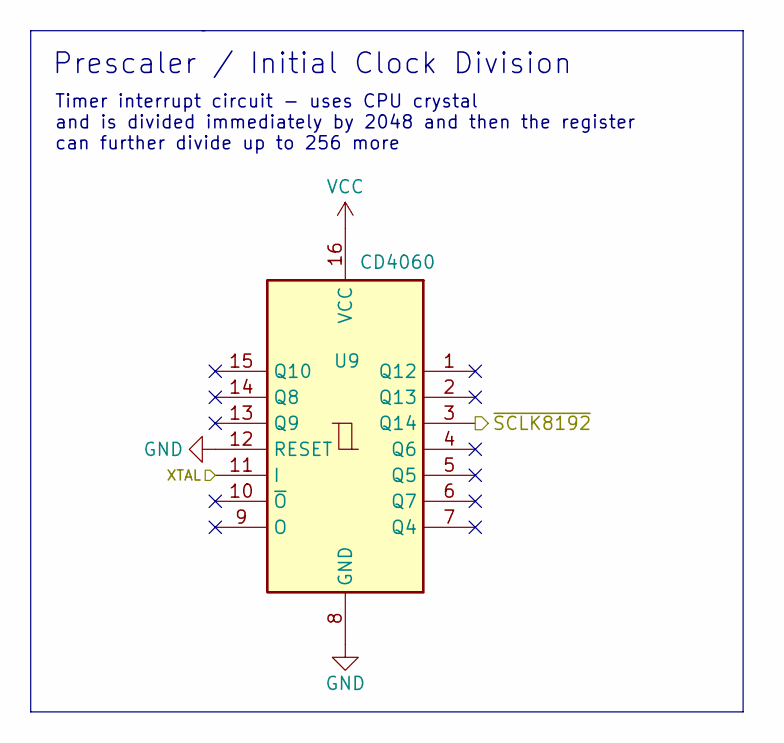
[picture p262: schematic prescaler.kicad_sch]

Parts:
U9: CD4060; SOIC-16_3.9x9.9mm_P1.27mm

Connections:
CPU_CLOCK: U9.11 (I); also elsewhere on the board
GND: U9.8 (GND), U9.12 (RESET); also elsewhere on the board
VCC: U9.16 (VCC); also elsewhere on the board
~SCLK8192: U9.3 (Q14); also elsewhere on the board

Notes on the sheet:
Timer interrupt circuit - uses CPU crystal and is divided immediately by 2048 and then the register can further divide up to 256 more
Prescaler / Initial Clock Division

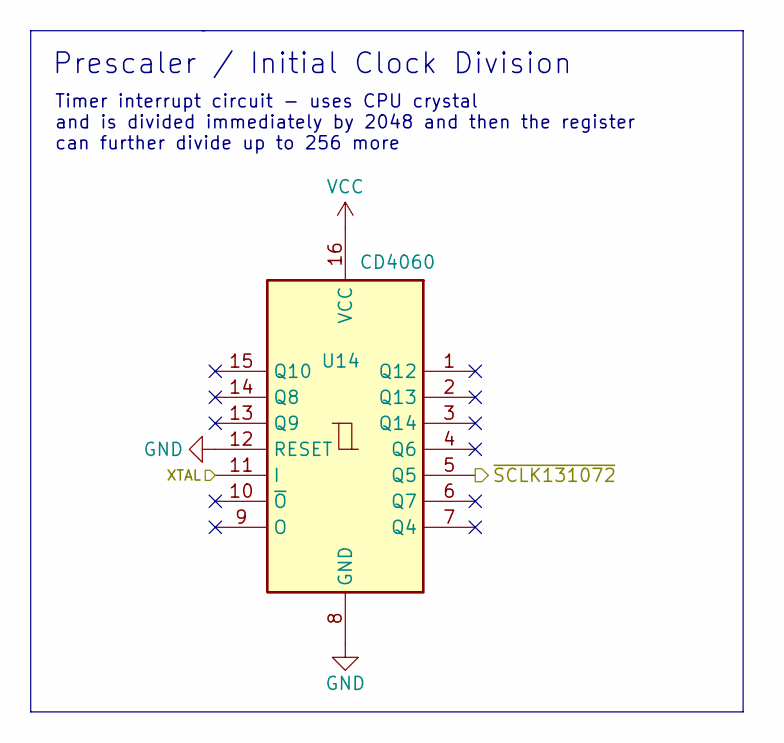
[picture p263: schematic prescaler2.kicad_sch]

Parts:
U14: CD4060; SOIC-16_3.9x9.9mm_P1.27mm

Connections:
GND: U14.8 (GND), U14.12 (RESET); also elsewhere on the board
VCC: U14.16 (VCC); also elsewhere on the board
~SCLK8192: U14.11 (I); also elsewhere on the board
~SCLK131072: U14.5 (Q5); also elsewhere on the board

Notes on the sheet:
Prescaler / Initial Clock Division
Timer interrupt circuit - uses CPU crystal and is divided immediately by 2048 and then the register can further divide up to 256 more

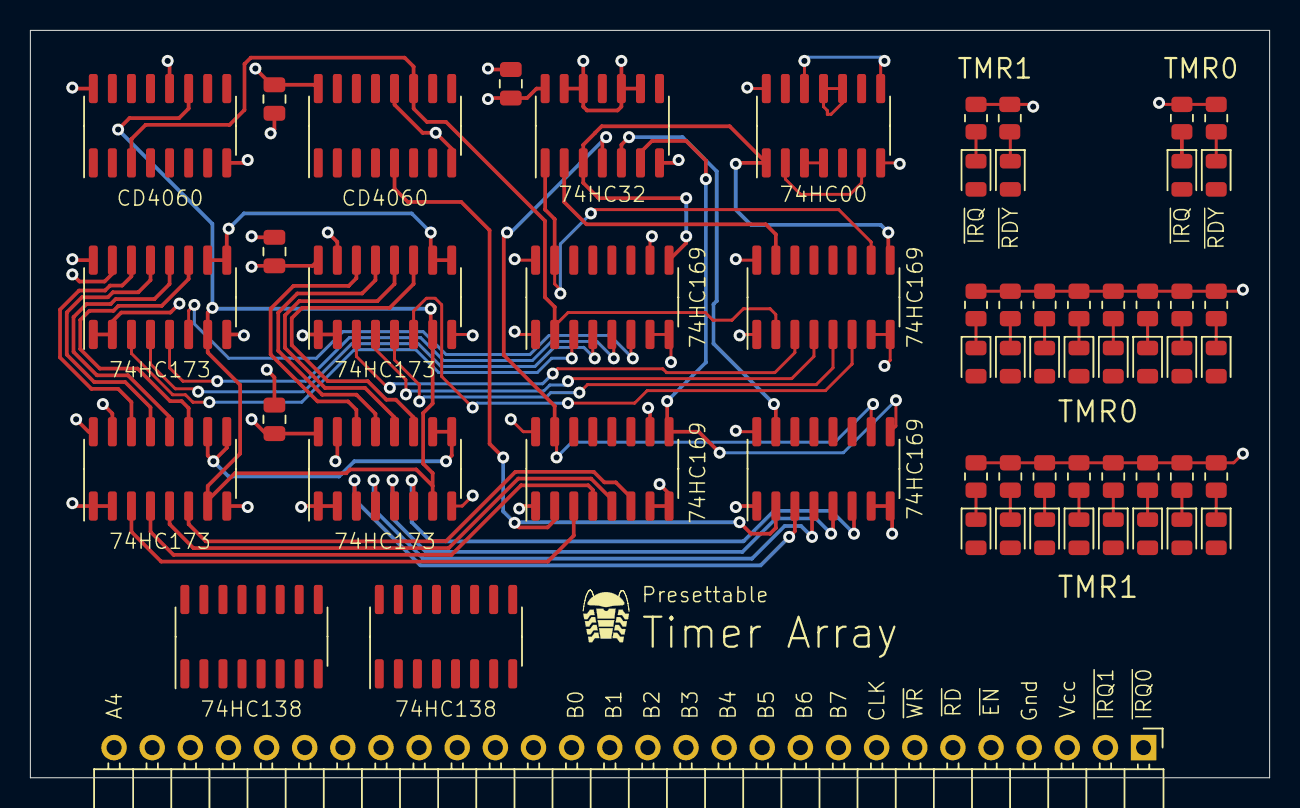
[picture p264: board interrupts.kicad_pcb from above]

Board: 4 copper layers, 82.5 x 49.8 mm, 59 parts (0 on the bottom side), 83 nets.

Other parts of the board:
U10, U11: 74LS173; SOIC-16_3.9x9.9mm_P1.27mm

Their connections:
/Reload Value Register/RELOAD0: U10.3 (Q0); also elsewhere on the board
/Reload Value Register/RELOAD1: U10.4 (Q1); also elsewhere on the board
/Reload Value Register/RELOAD2: U10.5 (Q2); also elsewhere on the board
/Reload Value Register/RELOAD3: U10.6 (Q3); also elsewhere on the board
/Reload Value Register/RELOAD4: U11.3 (Q0); also elsewhere on the board
/Reload Value Register/RELOAD5: U11.4 (Q1); also elsewhere on the board
/Reload Value Register/RELOAD6: U11.5 (Q2); also elsewhere on the board
/Reload Value Register/RELOAD7: U11.6 (Q3); also elsewhere on the board
BUS0: U10.14 (D0); also elsewhere on the board
BUS1: U10.13 (D1); also elsewhere on the board
BUS2: U10.12 (D2); also elsewhere on the board
BUS3: U10.11 (D3); also elsewhere on the board
BUS4: U11.14 (D0); also elsewhere on the board
BUS5: U11.13 (D1); also elsewhere on the board
BUS6: U11.12 (D2); also elsewhere on the board
BUS7: U11.11 (D3); also elsewhere on the board
CPU_CLOCK: U10.7 (Cp), U11.7 (Cp); also elsewhere on the board
GND: U10.1 (Oe1), U10.2 (Oe2), U10.8 (GND), U10.15 (Mr), U11.1 (Oe1), U11.2 (Oe2), U11.8 (GND), U11.15 (Mr); also elsewhere on the board
VCC: U10.16 (VCC), U11.16 (VCC); also elsewhere on the board
~SET_RELOAD_VALUE0: U10.9 (E1), U10.10 (E2), U11.9 (E1), U11.10 (E2); also elsewhere on the board
