theWickedWebDev/8-bit-computer/PCBs/99_IN PROGRESS/IO-Midi-TTL/IO-Midi-TTL.kicad_pcb

## KiCad design PCBs/99_IN PROGRESS/IO-Midi-TTL/IO-Midi-TTL.kicad_pcb (2022-08-27)

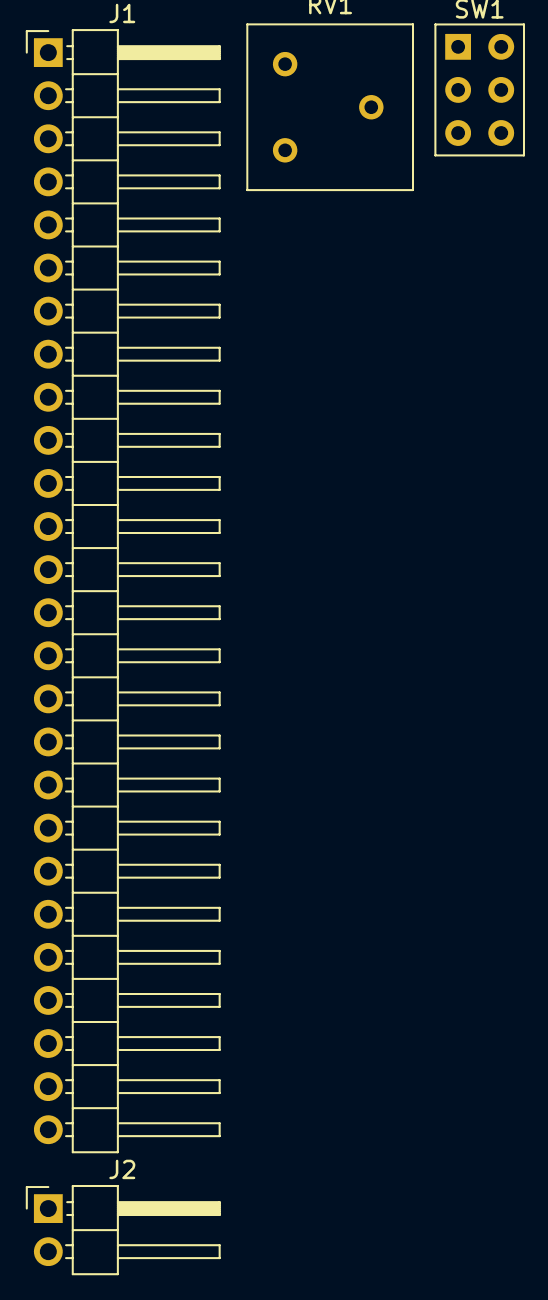
[picture p265: board IO-Midi-TTL.kicad_pcb from above]

Board: 2 copper layers, 4 parts (0 on the bottom side), 2 nets, no tracks yet.

Parts:
J1: Conn_01x26; PinHeader_1x26_P2.54mm_Horizontal
J2: Conn_01x02; PinHeader_1x02_P2.54mm_Horizontal
RV1: R_POT_TRIM_US; Potentiometer_Bourns_3386F_Vertical
SW1: SW_Push_DPDT; SW_NKK_G1xJP

Connections:
GND: J1.25, RV1.3
SPEAKER_OUT: J2.1, J2.2
