theWickedWebDev/8-bit-computer/PCBs/99_IN PROGRESS/ADC-Backplane/ADC-Backplane.kicad_pcb

## KiCad design PCBs/99_IN PROGRESS/ADC-Backplane/ADC-Backplane.kicad_pcb (2022-06-18)

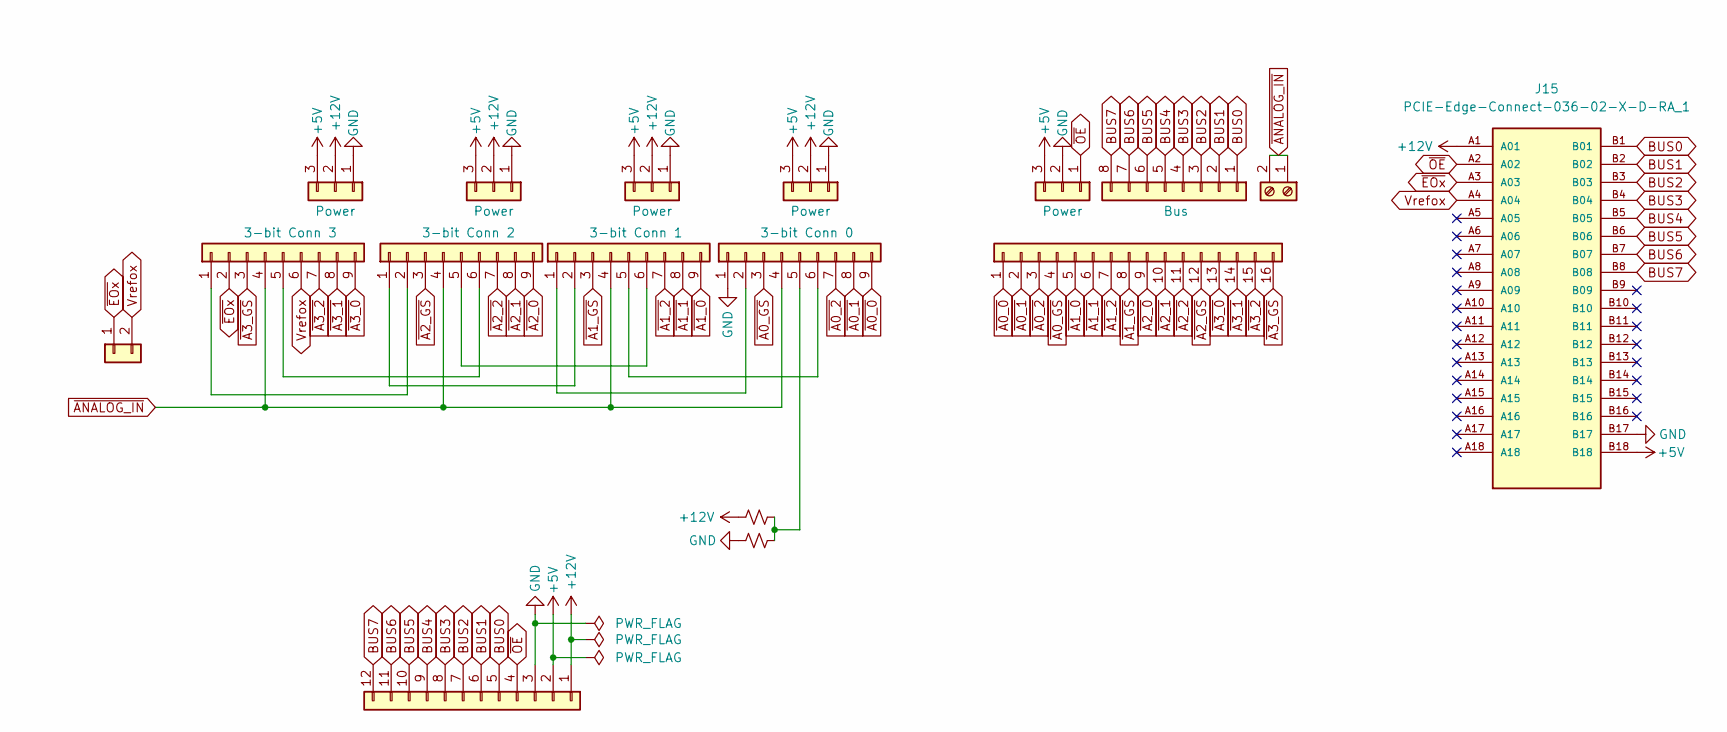
[picture p266: schematic ADC-Backplane.kicad_sch]

Parts:
J1: Conn_01x02; PinHeader_1x02_P2.54mm_Horizontal
J2, J4, J7, J9: Conn_01x09; PinSocket_1x09_P2.54mm_Vertical
J3, J6, J8, J10, J11: Conn_01x03; PinSocket_1x03_P2.54mm_Vertical
J5: Conn_01x12; PinHeader_1x12_P2.54mm_Horizontal
J12: Conn_01x16; PinSocket_1x16_P2.54mm_Vertical
J13: Conn_01x08; PinSocket_1x08_P2.54mm_Vertical
J14: Screw_Terminal_01x02; TerminalBlock_TE_282834-2_1x02_P2.54mm_Horizontal
J15: PCIE-Edge-Connect-036-02-X-D-RA_1; BUS_PCIexpress_x1; PARTREV D
R1, R2: R_Small_US; R_0805_2012Metric

Connections:
+5V: J3.3, J5.2, J6.3, J8.3, J10.3, J11.3, J15.B18
+12V: J3.2, J5.1, J6.2, J8.2, J10.2, J15.A1 (A01), R1.2
BUS0: J5.5, J13.1, J15.B1 (B01)
BUS1: J5.6, J13.2, J15.B2 (B02)
BUS2: J5.7, J13.3, J15.B3 (B03)
BUS3: J5.8, J13.4, J15.B4 (B04)
BUS4: J5.9, J13.5, J15.B5 (B05)
BUS5: J5.10, J13.6, J15.B6 (B06)
BUS6: J5.11, J13.7, J15.B7 (B07)
BUS7: J5.12, J13.8, J15.B8 (B08)
GND: J3.1, J5.3, J6.1, J8.1, J9.1, J10.1, J11.2, J15.B17, R2.2
unnamed: J2.1, J4.2
unnamed: J2.5, J4.6
unnamed: J4.1, J7.2
unnamed: J4.5, J7.6
unnamed: J7.1, J9.2
unnamed: J7.5, J9.6
unnamed: J9.5, R1.1, R2.1
Vrefox: J1.2, J2.6, J15.A4 (A04)
~A0_0: J9.9, J12.1
~A0_1: J9.8, J12.2
~A0_2: J9.7, J12.3
~A0_GS: J9.3, J12.4
~A1_0: J7.9, J12.5
~A1_1: J7.8, J12.6
~A1_2: J7.7, J12.7
~A1_GS: J7.3, J12.8
~A2_0: J4.9, J12.9
~A2_1: J4.8, J12.10
~A2_2: J4.7, J12.11
~A2_GS: J4.3, J12.12
~A3_0: J2.9, J12.13
~A3_1: J2.8, J12.14
~A3_2: J2.7, J12.15
~A3_GS: J2.3, J12.16
~ANALOG_IN: J2.4, J4.4, J7.4, J9.4, J14.1, J14.2
~EOx: J1.1, J2.2, J15.A3 (A03)
~OE: J5.4, J11.1, J15.A2 (A02)

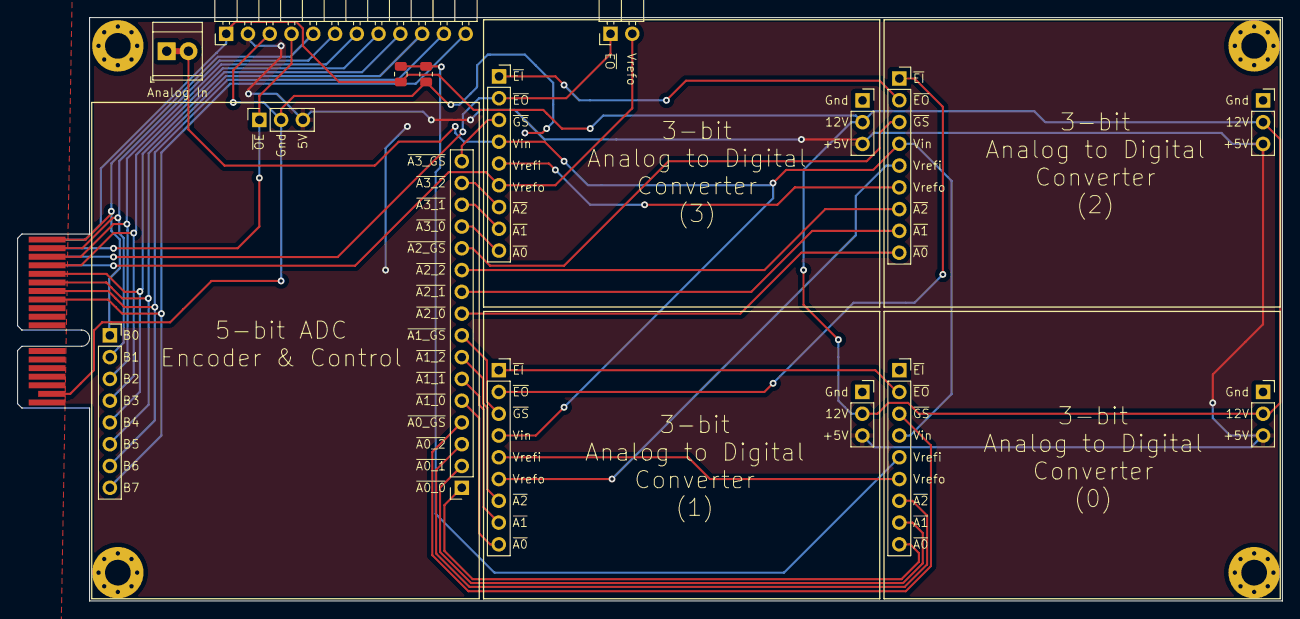
[picture p267: board ADC-Backplane.kicad_pcb from above]

Board: 2 copper layers, 147.6 x 68.1 mm, 17 parts (0 on the bottom side), 38 nets.
