theWickedWebDev/8-bit-computer/PCBs/99_IN PROGRESS/IO-VGA-DAC/IO-VGA-DAC.kicad_pcb

## KiCad design PCBs/99_IN PROGRESS/IO-VGA-DAC/IO-VGA-DAC.kicad_pcb (2022-08-27)

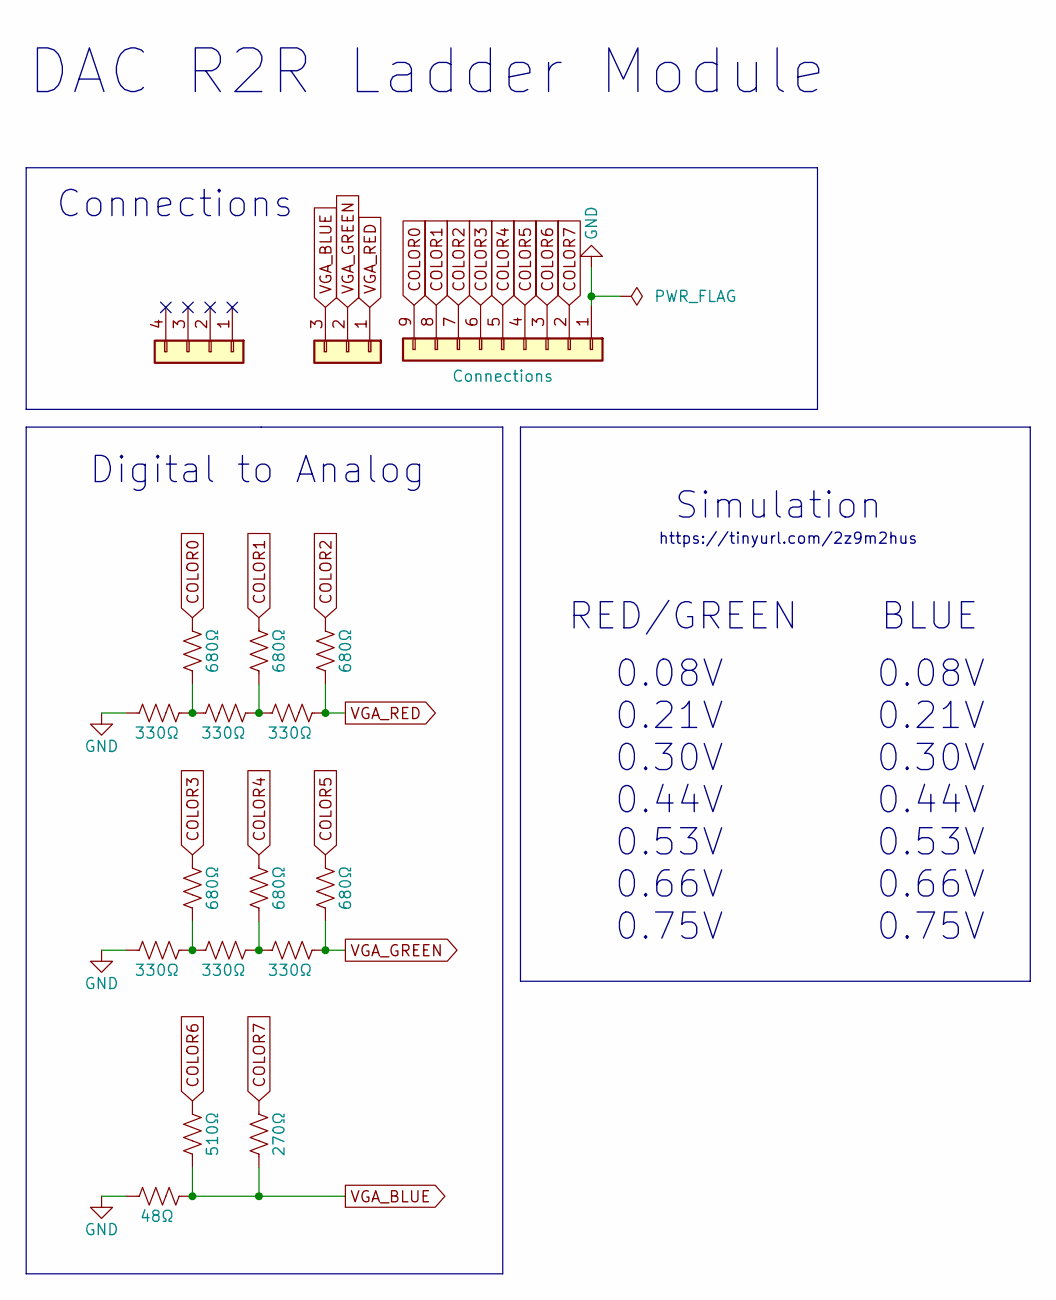
[picture p268: schematic IO-VGA-DAC.kicad_sch]

Parts:
J1: Conn_01x03; PinHeader_1x03_P2.54mm_Vertical
J2: Conn_01x09; PinHeader_1x09_P2.54mm_Vertical
J4: Conn_01x04; PinHeader_1x04_P2.54mm_Vertical
R1, R2, R3, R4, R5, R6, R7, R8, R10, R11, R12, R13, R14, R15, R16: R_US; R_0805_2012Metric

Connections:
COLOR0: J2.9, R4.1
COLOR1: J2.8, R10.1
COLOR2: J2.7, R15.1
COLOR3: J2.6, R5.1
COLOR4: J2.5, R11.1
COLOR5: J2.4, R16.1
COLOR6: J2.3, R6.1
COLOR7: J2.2, R12.1
GND: J2.1, R1.1, R2.1, R3.1
unnamed: R1.2, R4.2, R7.1
unnamed: R2.2, R5.2, R8.1
unnamed: R7.2, R10.2, R13.1
unnamed: R8.2, R11.2, R14.1
VGA_BLUE: J1.3, R3.2, R6.2, R12.2
VGA_GREEN: J1.2, R14.2, R16.2
VGA_RED: J1.1, R13.2, R15.2

Notes on the sheet:
0.08V 0.21V 0.30V 0.44V 0.53V 0.66V 0.75V
Simulation
BLUE
https://tinyurl.com/2z9m2hus
Digital to Analog
Connections
DAC R2R Ladder Module
RED/GREEN

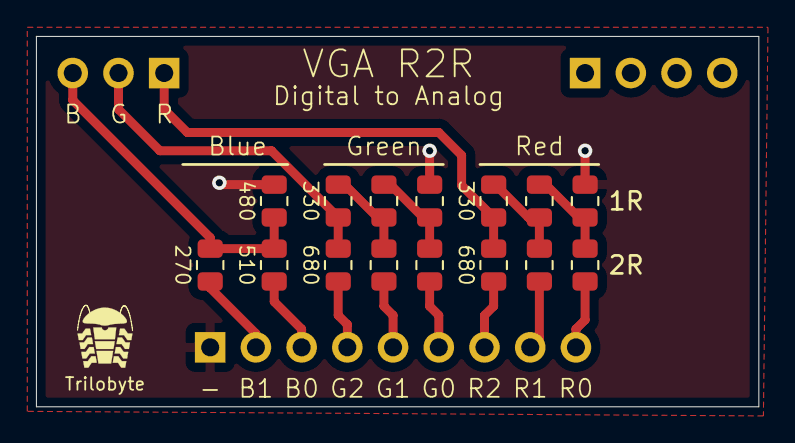
[picture p269: board IO-VGA-DAC.kicad_pcb from above]

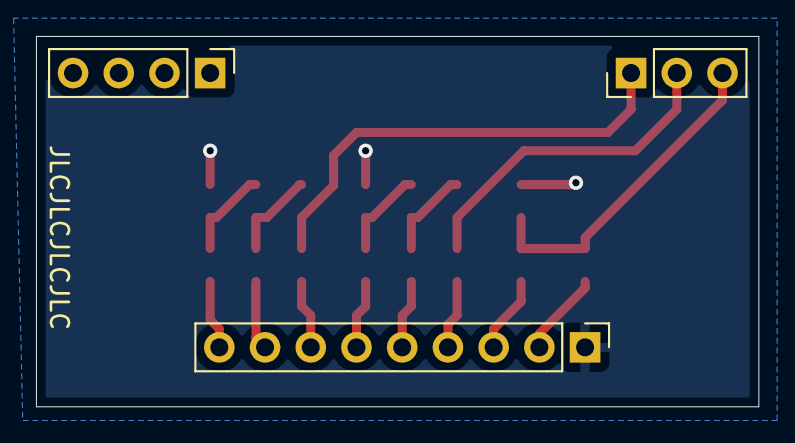
[picture p270: board IO-VGA-DAC.kicad_pcb from below]

Board: 2 copper layers, 40.1 x 20.6 mm, 18 parts (3 on the bottom side), 16 nets.
