theWickedWebDev/8-bit-computer/PCBs/999-QUEUED-TO-PRINT/Instruction-Decoder-SPR-ALU/CPU-Instruction-Decoder.kicad_pcb

## KiCad design PCBs/999-QUEUED-TO-PRINT/Instruction-Decoder-SPR-ALU/CPU-Instruction-Decoder.kicad_pcb (2022-11-09)

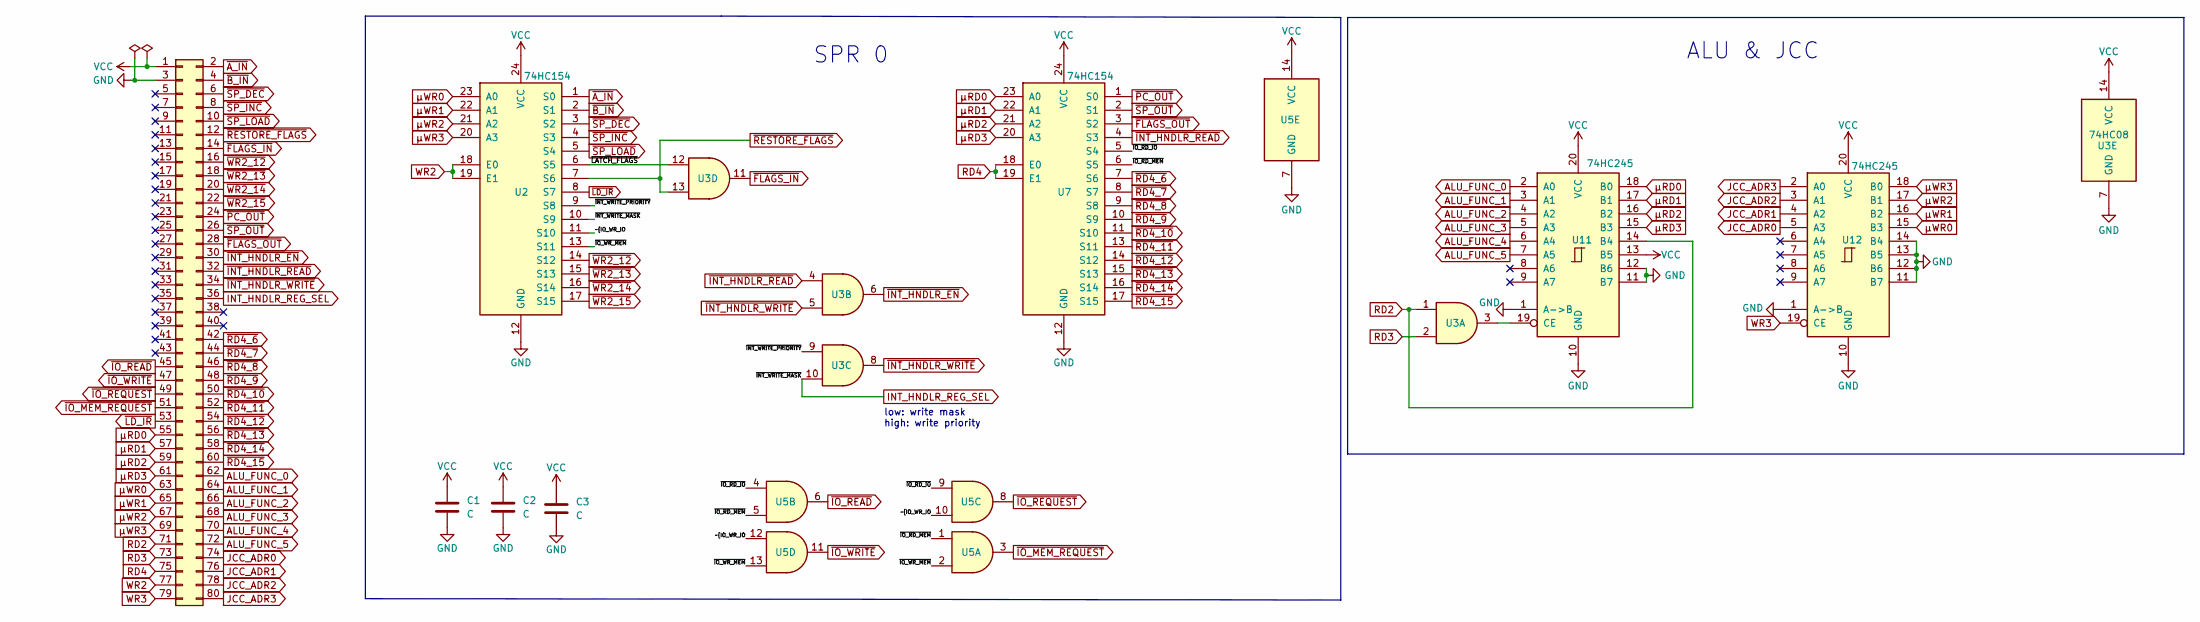
[picture p271: schematic CPU-Instruction-Decoder.kicad_sch]

Parts:
C1, C2, C3: C; C_0805_2012Metric
J1: Conn_02x40_Odd_Even; PinHeader_2x40_P2.54mm_Horizontal
U2, U7: 74HC154; SOIC-24W_7.5x15.4mm_P1.27mm
U3, U5: 74HC08; SOIC-14_3.9x8.7mm_P1.27mm
U11, U12: 74HC245; SOIC-20W_7.5x12.8mm_P1.27mm

Connections:
/~INT_WRITE_PRIORITY: U2.9 (S8), U3.9
/~IO_RD_IO: U5.4, U5.9, U7.5 (S4)
/~IO_RD_MEM: U5.1, U5.5, U7.6 (S5)
/~IO_WR_IO: U2.11 (S10), U5.10, U5.12
/~IO_WR_MEM: U2.13 (S11), U5.2, U5.13
/~LATCH_FLAGS: U2.6 (S5), U3.12
ALU_FUNC_0: J1.62, U11.2 (A0)
ALU_FUNC_1: J1.64, U11.3 (A1)
ALU_FUNC_2: J1.66, U11.4 (A2)
ALU_FUNC_3: J1.68, U11.5 (A3)
ALU_FUNC_4: J1.70, U11.6 (A4)
ALU_FUNC_5: J1.72, U11.7 (A5)
GND: C1.2, C2.2, C3.2, J1.3, U2.12 (GND), U3.7 (GND), U5.7 (GND), U7.12 (GND), U11.1 (A->B), U11.10 (GND), U11.11 (B7), U11.12 (B6), U12.1 (A->B), U12.10 (GND), U12.11 (B7), U12.12 (B6), U12.13 (B5), U12.14 (B4)
INT_HNDLR_REG_SEL: J1.36, U2.10 (S9), U3.10
JCC_ADR0: J1.74, U12.5 (A3)
JCC_ADR1: J1.76, U12.4 (A2)
JCC_ADR2: J1.78, U12.3 (A1)
JCC_ADR3: J1.80, U12.2 (A0)
unnamed: U3.3, U11.19 (CE)
RD2: J1.71, U3.1, U11.14 (B4)
RD3: J1.73, U3.2
RD4: J1.75, U7.18 (E0), U7.19 (E1)
VCC: C1.1, C2.1, C3.1, J1.1, U2.24 (VCC), U3.14 (VCC), U5.14 (VCC), U7.24 (VCC), U11.13 (B5), U11.20 (VCC), U12.20 (VCC)
WR2: J1.77, U2.18 (E0), U2.19 (E1)
WR3: J1.79, U12.19 (CE)
~A_IN: J1.2, U2.1 (S0)
~B_IN: J1.4, U2.2 (S1)
~FLAGS_IN: J1.14, U3.11
~FLAGS_OUT: J1.28, U7.3 (S2)
~INT_HNDLR_EN: J1.30, U3.6
~INT_HNDLR_READ: J1.32, U3.4, U7.4 (S3)
~INT_HNDLR_WRITE: J1.34, U3.5, U3.8
~IO_MEM_REQUEST: J1.51, U5.3
~IO_READ: J1.45, U5.6
~IO_REQUEST: J1.49, U5.8
~IO_WRITE: J1.47, U5.11
~LD_IR: J1.53, U2.8 (S7)
~PC_OUT: J1.24, U7.1 (S0)
~RD4_6: J1.42, U7.7 (S6)
~RD4_7: J1.44, U7.8 (S7)
~RD4_8: J1.46, U7.9 (S8)
~RD4_9: J1.48, U7.10 (S9)
~RD4_10: J1.50, U7.11 (S10)
~RD4_11: J1.52, U7.13 (S11)
~RD4_12: J1.54, U7.14 (S12)
~RD4_13: J1.56, U7.15 (S13)
~RD4_14: J1.58, U7.16 (S14)
~RD4_15: J1.60, U7.17 (S15)
~RESTORE_FLAGS: J1.12, U2.7 (S6), U3.13
~SP_DEC: J1.6, U2.3 (S2)
~SP_INC: J1.8, U2.4 (S3)
~SP_LOAD: J1.10, U2.5 (S4)
~SP_OUT: J1.26, U7.2 (S1)
~WR2_12: J1.16, U2.14 (S12)
~WR2_13: J1.18, U2.15 (S13)
~WR2_14: J1.20, U2.16 (S14)
~WR2_15: J1.22, U2.17 (S15)
μRD0: J1.55, U7.23 (A0), U11.18 (B0)
μRD1: J1.57, U7.22 (A1), U11.17 (B1)
μRD2: J1.59, U7.21 (A2), U11.16 (B2)
μRD3: J1.61, U7.20 (A3), U11.15 (B3)
μWR0: J1.63, U2.23 (A0), U12.15 (B3)
μWR1: J1.65, U2.22 (A1), U12.16 (B2)
μWR2: J1.67, U2.21 (A2), U12.17 (B1)
μWR3: J1.69, U2.20 (A3), U12.18 (B0)

Notes on the sheet:
ALU & JCC
low: write mask high: write priority
SPR 0

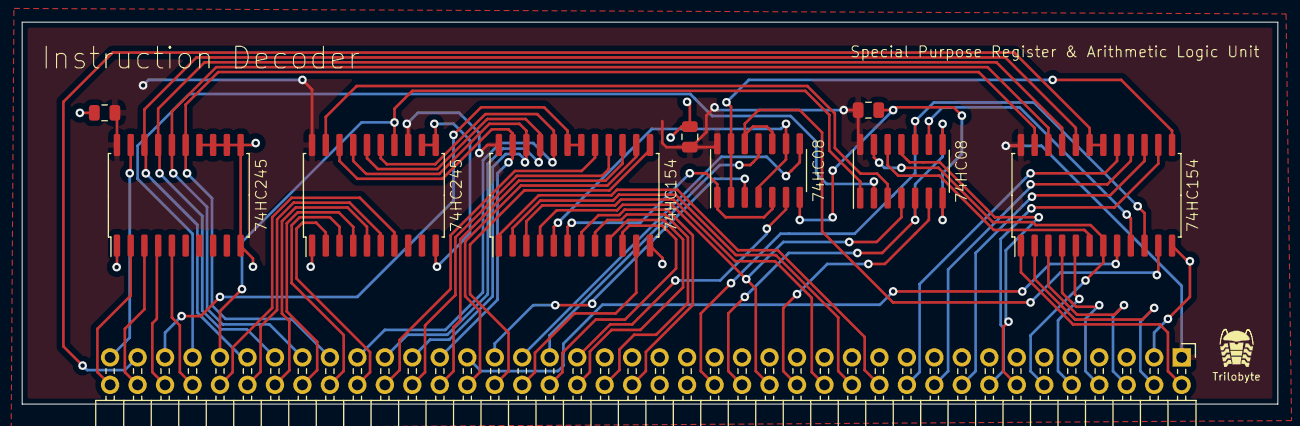
[picture p272: board PCBs/999-QUEUED-TO-PRINT/Instruction-Decoder-SPR-ALU/CPU-Instruction-… from above]

Board: 2 copper layers, 116.1 x 35.3 mm, 10 parts (0 on the bottom side), 65 nets.
