theWickedWebDev/8-bit-computer/PCBs/03_MODULES/CPU-ALU/Logic Gates/Modules.kicad_pcb

## KiCad design PCBs/03_MODULES/CPU-ALU/Logic Gates/Modules.kicad_pcb (2022-01-18)

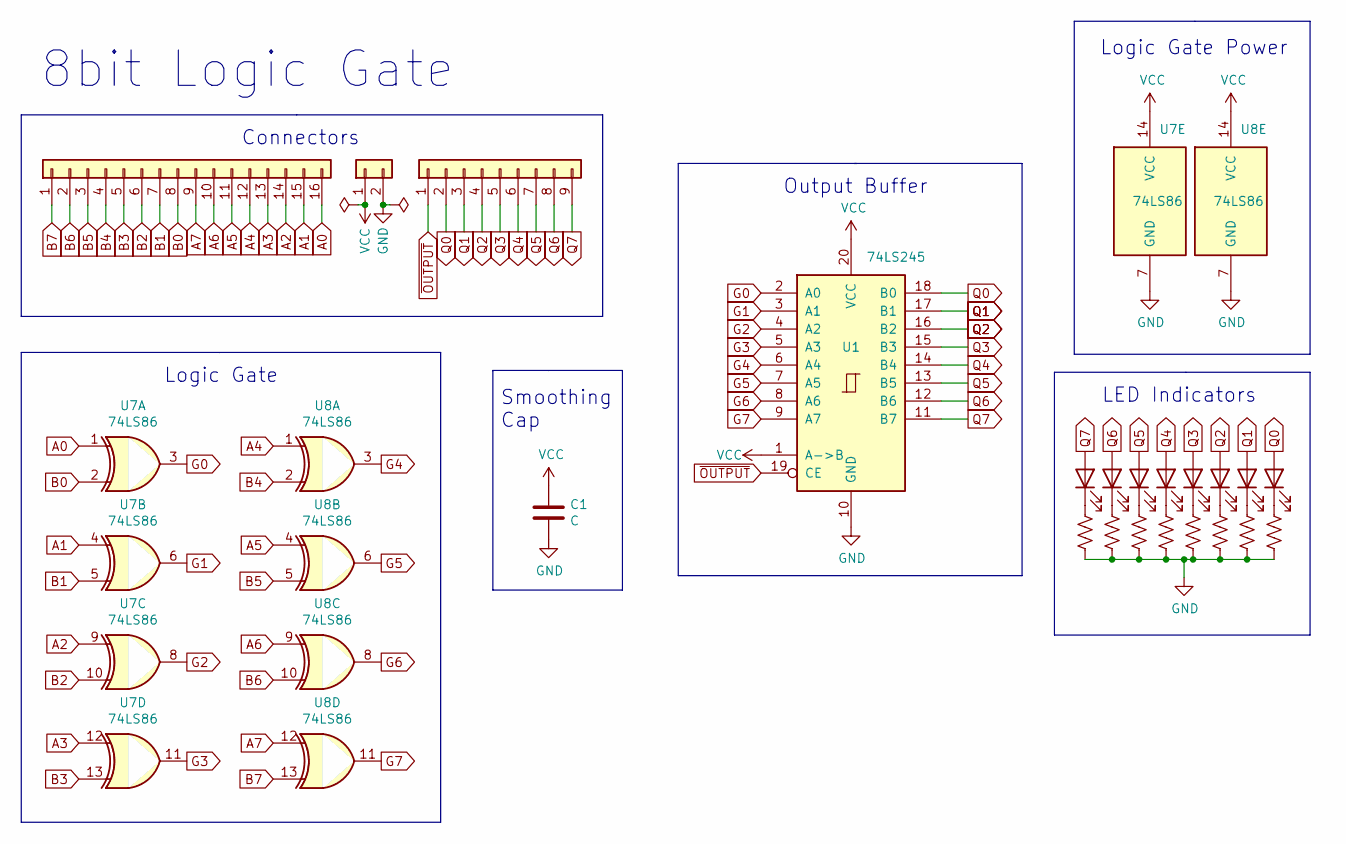
[picture p273: schematic Modules.kicad_sch, 8bit Logic Gate (ALU)]

Parts:
C1: C; C_0805_2012Metric
D1, D2, D3, D4, D5, D6, D7, D8: LED; LED_0805_2012Metric
J1: Conn_01x16; PinSocket_1x16_P2.54mm_Vertical
J2: Conn_01x02; PinSocket_1x02_P2.54mm_Vertical
J3: Conn_01x09; PinSocket_1x09_P2.54mm_Vertical
R1, R2, R3, R4, R5, R6, R7, R8: R_US; R_0805_2012Metric
U1: 74LS245; TSSOP-20_4.4x6.5mm_P0.65mm
U7, U8: 74LS86; TSSOP-14_4.4x5mm_P0.65mm

Connections:
A0: J1.16, U7.1
A1: J1.15, U7.4
A2: J1.14, U7.9
A3: J1.13, U7.12
A4: J1.12, U8.1
A5: J1.11, U8.4
A6: J1.10, U8.9
A7: J1.9, U8.12
B0: J1.8, U7.2
B1: J1.7, U7.5
B2: J1.6, U7.10
B3: J1.5, U7.13
B4: J1.4, U8.2
B5: J1.3, U8.5
B6: J1.2, U8.10
B7: J1.1, U8.13
GND: C1.2, J2.2, R1.2, R2.2, R3.2, R4.2, R5.2, R6.2, R7.2, R8.2, U1.10 (GND), U7.7 (GND), U8.7 (GND)
unnamed: D1.1 (K), R1.1
unnamed: D2.1 (K), R2.1
unnamed: D3.1 (K), R3.1
unnamed: D4.1 (K), R4.1
unnamed: D5.1 (K), R5.1
unnamed: D6.1 (K), R6.1
unnamed: D7.1 (K), R7.1
unnamed: D8.1 (K), R8.1
unnamed: U1.2 (A0), U7.3
unnamed: U1.3 (A1), U7.6
unnamed: U1.4 (A2), U7.8
unnamed: U1.5 (A3), U7.11
unnamed: U1.6 (A4), U8.3
unnamed: U1.7 (A5), U8.6
unnamed: U1.8 (A6), U8.8
unnamed: U1.9 (A7), U8.11
Q0: D8.2 (A), J3.2, U1.18 (B0)
Q1: D7.2 (A), J3.3, U1.17 (B1)
Q2: D6.2 (A), J3.4, U1.16 (B2)
Q3: D5.2 (A), J3.5, U1.15 (B3)
Q4: D4.2 (A), J3.6, U1.14 (B4)
Q5: D3.2 (A), J3.7, U1.13 (B5)
Q6: D2.2 (A), J3.8, U1.12 (B6)
Q7: D1.2 (A), J3.9, U1.11 (B7)
VCC: C1.1, J2.1, U1.1 (A->B), U1.20 (VCC), U7.14 (VCC), U8.14 (VCC)
~OUTPUT: J3.1, U1.19 (CE)

Notes on the sheet:
LED Indicators
8bit Logic Gate
Logic Gate Power
Smoothing Cap
Connectors
Logic Gate
Output Buffer

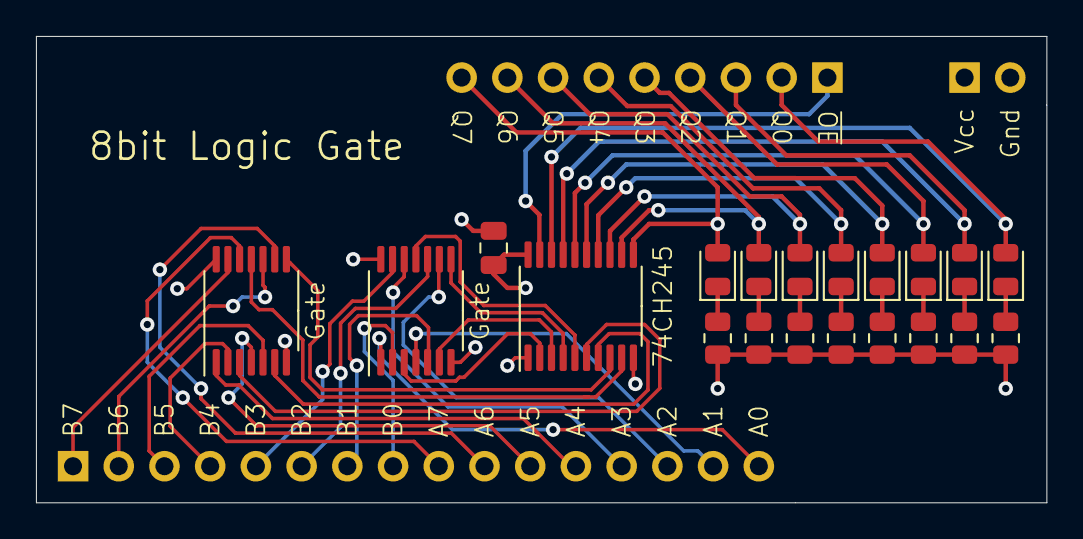
[picture p274: board PCBs/03_MODULES/CPU-ALU/Logic Gates/Modules.kicad_pcb from above]

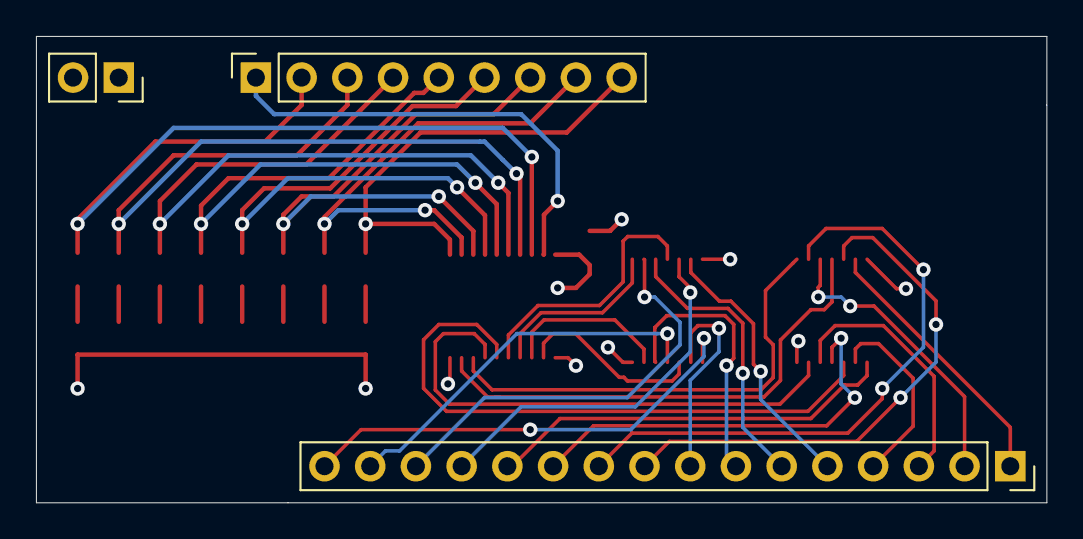
[picture p275: board PCBs/03_MODULES/CPU-ALU/Logic Gates/Modules.kicad_pcb from below]

Board: 4 copper layers, 56.1 x 25.9 mm, 23 parts (3 on the bottom side), 43 nets.
