theWickedWebDev/8-bit-computer/PCBs/99_IN PROGRESS/IO-VGA-comparator/Comparator.kicad_pcb

## KiCad design PCBs/99_IN PROGRESS/IO-VGA-comparator/Comparator.kicad_pcb (2022-08-27)

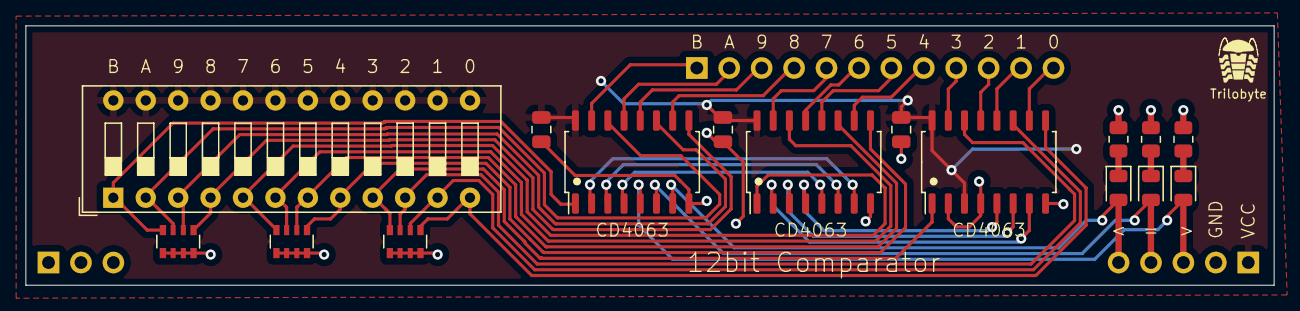
[picture p276: board Comparator.kicad_pcb from above]

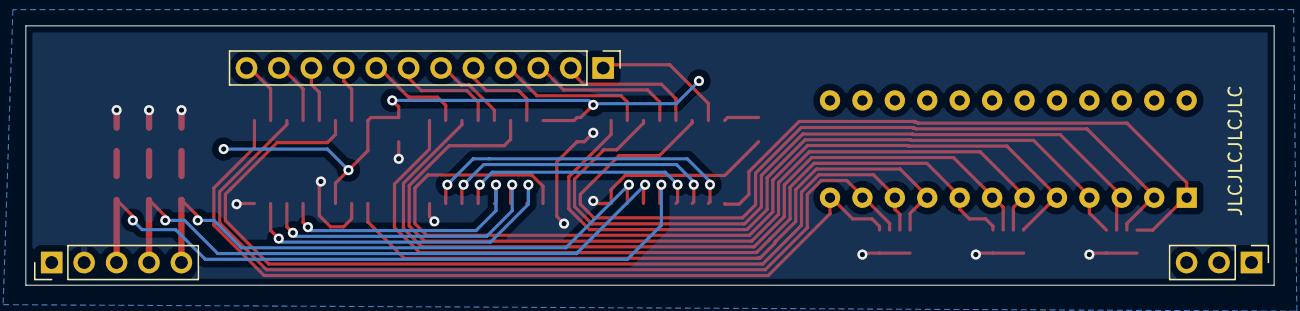
[picture p277: board Comparator.kicad_pcb from below]

Board: 2 copper layers, 97.8 x 20.3 mm, 19 parts (3 on the bottom side), 38 nets.

Parts:
C11, C12, C13: C; C_0805_2012Metric
D4, D5, D6: LED; LED_0805_2012Metric
J7: Conn_01x12; PinHeader_1x12_P2.54mm_Vertical
J8: Conn_01x05; PinHeader_1x05_P2.54mm_Vertical
J29: Conn_01x03; PinHeader_1x03_P2.54mm_Vertical
R4, R5, R6: R_US; R_0805_2012Metric
RN4, RN5, RN6: R_Pack04; R_Array_Convex_4x0603
SW2: SW_DIP_x12; SW_DIP_SPSTx12_Slide_9.78x32.66mm_W7.62mm_P2.54mm
U4, U5, U6: CD4063; SOIC-16_4.55x10.3mm_P1.27mm

Connections:
/Horizontal Timing/Comparator/D0_0: RN4.1 (R1.1), SW2.12, U4.9 (B0)
/Horizontal Timing/Comparator/D0_1: RN4.2 (R2.1), SW2.11, U4.11 (B1)
/Horizontal Timing/Comparator/D0_2: RN4.3 (R3.1), SW2.10, U4.14 (B2)
/Horizontal Timing/Comparator/D0_3: RN4.4 (R4.1), SW2.9, U4.1 (B3)
/Horizontal Timing/Comparator/D0_4: RN5.1 (R1.1), SW2.8, U5.9 (B0)
/Horizontal Timing/Comparator/D0_5: RN5.2 (R2.1), SW2.7, U5.11 (B1)
/Horizontal Timing/Comparator/D0_6: RN5.3 (R3.1), SW2.6, U5.14 (B2)
/Horizontal Timing/Comparator/D0_7: RN5.4 (R4.1), SW2.5, U5.1 (B3)
/Horizontal Timing/Comparator/D0_8: RN6.1 (R1.1), SW2.4, U6.9 (B0)
/Horizontal Timing/Comparator/D0_9: RN6.2 (R2.1), SW2.3, U6.11 (B1)
/Horizontal Timing/Comparator/D0_10: RN6.3 (R3.1), SW2.2, U6.14 (B2)
/Horizontal Timing/Comparator/D0_11: RN6.4 (R4.1), SW2.1, U6.1 (B3)
COUNT0: J7.12, U4.10 (A0)
COUNT1: J7.11, U4.12 (A1)
COUNT2: J7.10, U4.13 (A2)
COUNT3: J7.9, U4.15 (A3)
COUNT4: J7.8, U5.10 (A0)
COUNT5: J7.7, U5.12 (A1)
COUNT6: J7.6, U5.13 (A2)
COUNT7: J7.5, U5.15 (A3)
COUNT8: J7.4, U6.10 (A0)
COUNT9: J7.3, U6.12 (A1)
COUNT10: J7.2, U6.13 (A2)
COUNT11: J7.1, U6.15 (A3)
GND: C11.2, C12.2, C13.2, J8.2, R4.2, R5.2, R6.2, RN4.5 (R4.2), RN4.6 (R3.2), RN4.7 (R2.2), RN4.8 (R1.2), RN5.5 (R4.2), RN5.6 (R3.2), RN5.7 (R2.2), RN5.8 (R1.2), RN6.5 (R4.2), RN6.6 (R3.2), RN6.7 (R2.2), RN6.8 (R1.2), U4.2 (Ia<b), U4.4 (Ia>b), U4.8 (GND), U5.8 (GND), U6.8 (GND)
unnamed: D4.1 (K), R4.1
unnamed: D5.1 (K), R5.1
unnamed: D6.1 (K), R6.1
unnamed: U4.5 (Oa>b), U5.4 (Ia>b)
unnamed: U4.6 (Oa=b), U5.3 (Ia=b)
unnamed: U4.7 (Oa<b), U5.2 (Ia<b)
unnamed: U5.5 (Oa>b), U6.4 (Ia>b)
unnamed: U5.6 (Oa=b), U6.3 (Ia=b)
unnamed: U5.7 (Oa<b), U6.2 (Ia<b)
VCC: C11.1, C12.1, C13.1, J8.1, SW2.13, SW2.14, SW2.15, SW2.16, SW2.17, SW2.18, SW2.19, SW2.20, SW2.21, SW2.22, SW2.23, SW2.24, U4.3 (Ia=b), U4.16 (VCC), U5.16 (VCC), U6.16 (VCC)
~EQ0: D5.2 (A), J8.4, U6.6 (Oa=b)
~GT0: D6.2 (A), J8.3, U6.5 (Oa>b)
~LT0: D4.2 (A), J8.5, U6.7 (Oa<b)
