theWickedWebDev/8-bit-computer/PCBs/999-QUEUED-TO-PRINT/Mem-GPR-CPU-Instruction-Decoder/CPU-Instruction-Decoder.kicad_pcb

## KiCad design PCBs/999-QUEUED-TO-PRINT/Mem-GPR-CPU-Instruction-Decoder/CPU-Instruction-Decoder.kicad_pcb (2022-11-09)

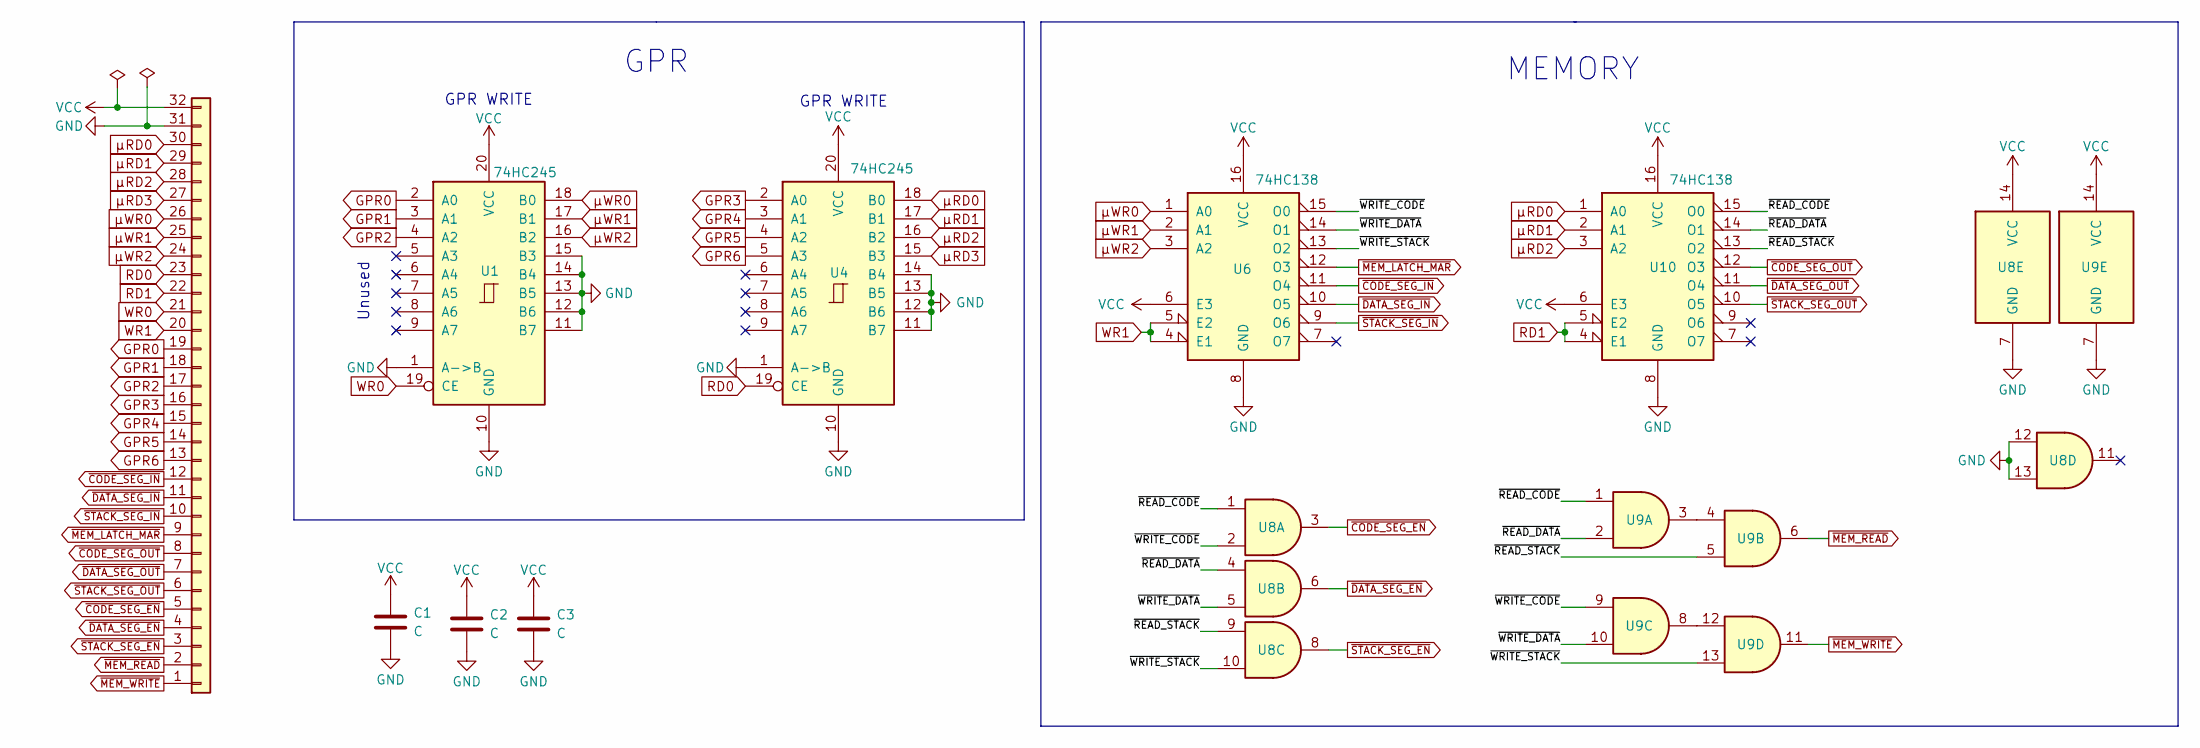
[picture p278: schematic CPU-Instruction-Decoder.kicad_sch]

Parts:
C1, C2, C3: C; C_0805_2012Metric
J1: Conn_01x32; PinHeader_1x32_P2.54mm_Horizontal
U1, U4: 74HC245; SOIC-20W_7.5x12.8mm_P1.27mm
U6, U10: 74HC138; SOIC-16_3.9x9.9mm_P1.27mm
U8, U9: 74HC08; SOIC-14_3.9x8.7mm_P1.27mm

Connections:
/~READ_CODE: U8.1, U9.1, U10.15 (O0)
/~READ_DATA: U8.4, U9.2, U10.14 (O1)
/~READ_STACK: U8.9, U9.5, U10.13 (O2)
/~WRITE_CODE: U6.15 (O0), U8.2, U9.9
/~WRITE_DATA: U6.14 (O1), U8.5, U9.10
/~WRITE_STACK: U6.13 (O2), U8.10, U9.13
GND: C1.2, C2.2, C3.2, J1.31, U1.1 (A->B), U1.10 (GND), U1.11 (B7), U1.12 (B6), U1.13 (B5), U1.14 (B4), U1.15 (B3), U4.1 (A->B), U4.10 (GND), U4.11 (B7), U4.12 (B6), U4.13 (B5), U4.14 (B4), U6.8 (GND), U8.7 (GND), U8.12, U8.13, U9.7 (GND), U10.8 (GND)
GPR0: J1.19, U1.2 (A0)
GPR1: J1.18, U1.3 (A1)
GPR2: J1.17, U1.4 (A2)
GPR3: J1.16, U4.2 (A0)
GPR4: J1.15, U4.3 (A1)
GPR5: J1.14, U4.4 (A2)
GPR6: J1.13, U4.5 (A3)
unnamed: U9.3, U9.4
unnamed: U9.8, U9.12
RD0: J1.23, U4.19 (CE)
RD1: J1.22, U10.4 (E1), U10.5 (E2)
VCC: C1.1, C2.1, C3.1, J1.32, U1.20 (VCC), U4.20 (VCC), U6.6 (E3), U6.16 (VCC), U8.14 (VCC), U9.14 (VCC), U10.6 (E3), U10.16 (VCC)
WR0: J1.21, U1.19 (CE)
WR1: J1.20, U6.4 (E1), U6.5 (E2)
~CODE_SEG_EN: J1.5, U8.3
~CODE_SEG_IN: J1.12, U6.11 (O4)
~CODE_SEG_OUT: J1.8, U10.12 (O3)
~DATA_SEG_EN: J1.4, U8.6
~DATA_SEG_IN: J1.11, U6.10 (O5)
~DATA_SEG_OUT: J1.7, U10.11 (O4)
~MEM_LATCH_MAR: J1.9, U6.12 (O3)
~MEM_READ: J1.2, U9.6
~MEM_WRITE: J1.1, U9.11
~STACK_SEG_EN: J1.3, U8.8
~STACK_SEG_IN: J1.10, U6.9 (O6)
~STACK_SEG_OUT: J1.6, U10.10 (O5)
μRD0: J1.30, U4.18 (B0), U10.1 (A0)
μRD1: J1.29, U4.17 (B1), U10.2 (A1)
μRD2: J1.28, U4.16 (B2), U10.3 (A2)
μRD3: J1.27, U4.15 (B3)
μWR0: J1.26, U1.18 (B0), U6.1 (A0)
μWR1: J1.25, U1.17 (B1), U6.2 (A1)
μWR2: J1.24, U1.16 (B2), U6.3 (A2)

Notes on the sheet:
MEMORY
GPR
GPR WRITE
Unused

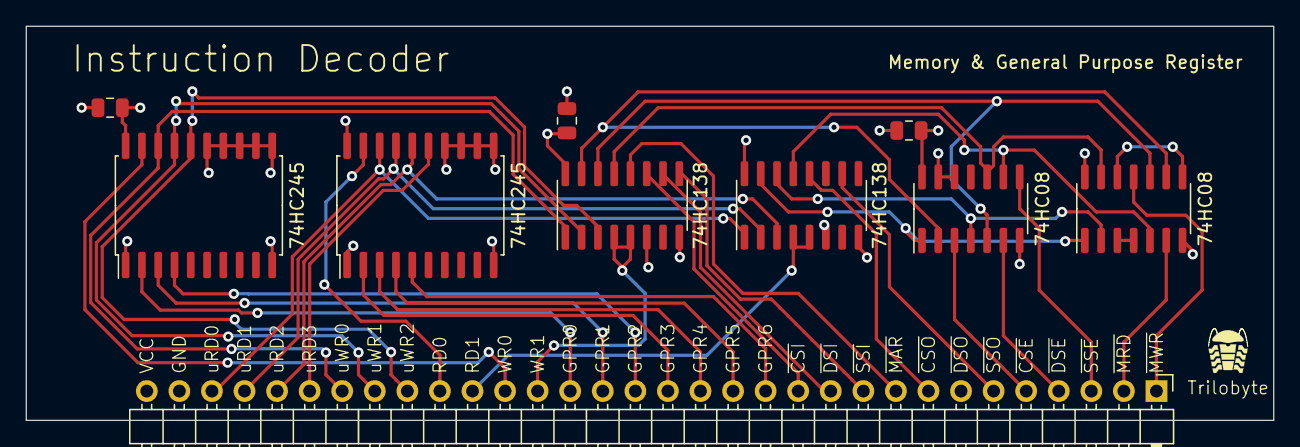
[picture p279: board PCBs/999-QUEUED-TO-PRINT/Mem-GPR-CPU-Instruction-Decoder/CPU-Instruct… from above]

Board: 4 copper layers, 97.3 x 30.7 mm, 10 parts (0 on the bottom side), 40 nets.
