theWickedWebDev/8-bit-computer/PCBs/999-QUEUED-TO-PRINT/Instruction-Decoder-Extra/CPU-Instruction-Decoder.kicad_pcb

## KiCad design PCBs/999-QUEUED-TO-PRINT/Instruction-Decoder-Extra/CPU-Instruction-Decoder.kicad_pcb (2022-11-09)

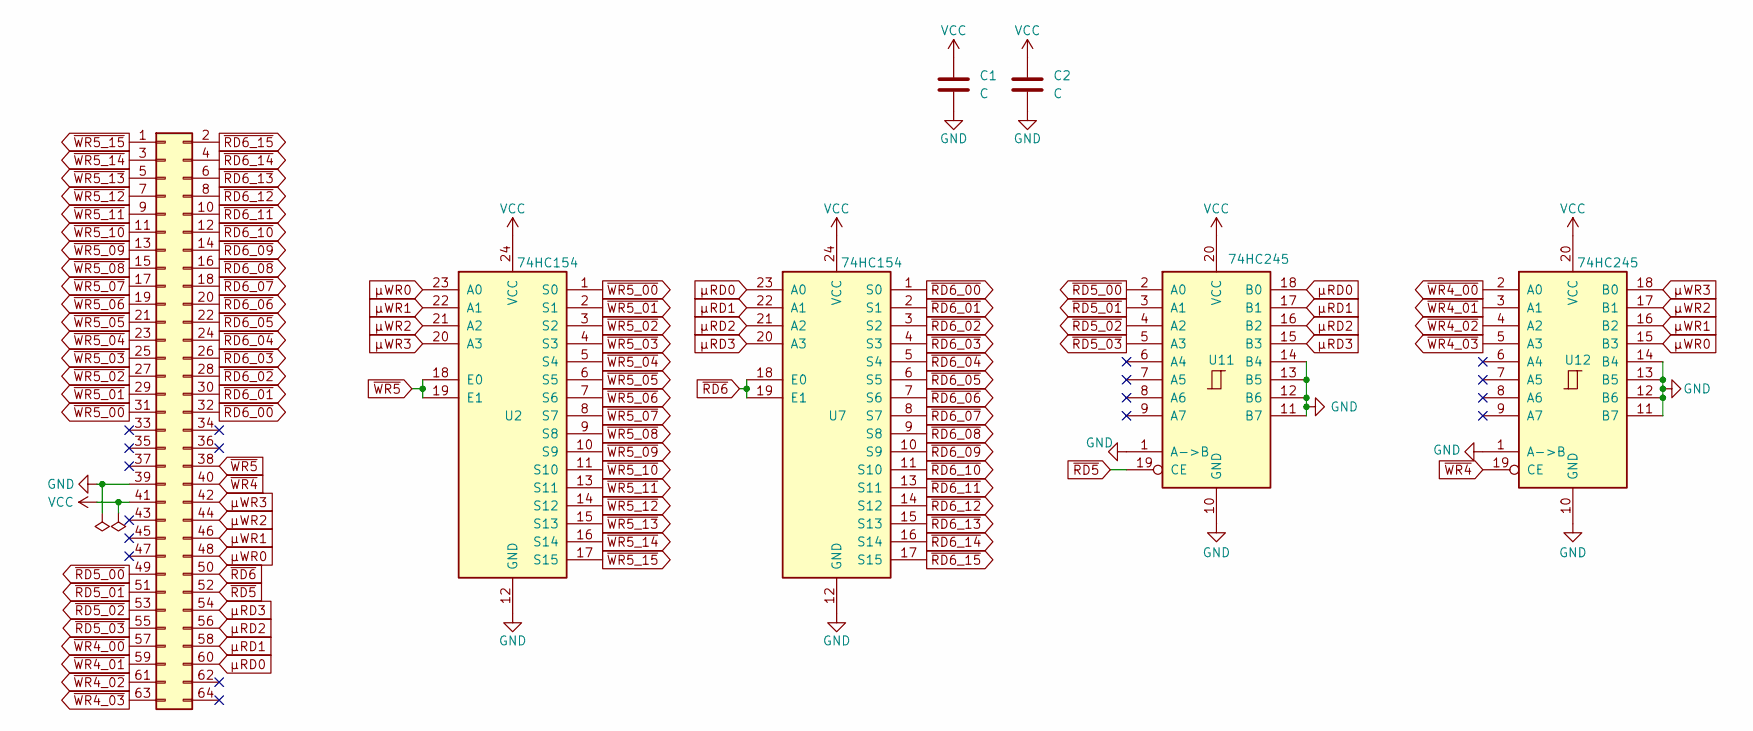
[picture p280: schematic CPU-Instruction-Decoder.kicad_sch]

Parts:
C1, C2: C; C_0805_2012Metric
J1: Conn_02x32_Odd_Even; PinHeader_2x32_P2.54mm_Horizontal
U2, U7: 74HC154; SOIC-24W_7.5x15.4mm_P1.27mm
U11, U12: 74HC245; SOIC-20W_7.5x12.8mm_P1.27mm

Connections:
GND: C1.2, C2.2, J1.39, U2.12 (GND), U7.12 (GND), U11.1 (A->B), U11.10 (GND), U11.11 (B7), U11.12 (B6), U11.13 (B5), U11.14 (B4), U12.1 (A->B), U12.10 (GND), U12.11 (B7), U12.12 (B6), U12.13 (B5), U12.14 (B4)
VCC: C1.1, C2.1, J1.41, U2.24 (VCC), U7.24 (VCC), U11.20 (VCC), U12.20 (VCC)
~RD5_00: J1.49, U11.2 (A0)
~RD5_01: J1.51, U11.3 (A1)
~RD5_02: J1.53, U11.4 (A2)
~RD5_03: J1.55, U11.5 (A3)
~RD5: J1.52, U11.19 (CE)
~RD6_00: J1.32, U7.1 (S0)
~RD6_01: J1.30, U7.2 (S1)
~RD6_02: J1.28, U7.3 (S2)
~RD6_03: J1.26, U7.4 (S3)
~RD6_04: J1.24, U7.5 (S4)
~RD6_05: J1.22, U7.6 (S5)
~RD6_06: J1.20, U7.7 (S6)
~RD6_07: J1.18, U7.8 (S7)
~RD6_08: J1.16, U7.9 (S8)
~RD6_09: J1.14, U7.10 (S9)
~RD6_10: J1.12, U7.11 (S10)
~RD6_11: J1.10, U7.13 (S11)
~RD6_12: J1.8, U7.14 (S12)
~RD6_13: J1.6, U7.15 (S13)
~RD6_14: J1.4, U7.16 (S14)
~RD6_15: J1.2, U7.17 (S15)
~RD6: J1.50, U7.18 (E0), U7.19 (E1)
~WR4_00: J1.57, U12.2 (A0)
~WR4_01: J1.59, U12.3 (A1)
~WR4_02: J1.61, U12.4 (A2)
~WR4_03: J1.63, U12.5 (A3)
~WR4: J1.40, U12.19 (CE)
~WR5_00: J1.31, U2.1 (S0)
~WR5_01: J1.29, U2.2 (S1)
~WR5_02: J1.27, U2.3 (S2)
~WR5_03: J1.25, U2.4 (S3)
~WR5_04: J1.23, U2.5 (S4)
~WR5_05: J1.21, U2.6 (S5)
~WR5_06: J1.19, U2.7 (S6)
~WR5_07: J1.17, U2.8 (S7)
~WR5_08: J1.15, U2.9 (S8)
~WR5_09: J1.13, U2.10 (S9)
~WR5_10: J1.11, U2.11 (S10)
~WR5_11: J1.9, U2.13 (S11)
~WR5_12: J1.7, U2.14 (S12)
~WR5_13: J1.5, U2.15 (S13)
~WR5_14: J1.3, U2.16 (S14)
~WR5_15: J1.1, U2.17 (S15)
~WR5: J1.38, U2.18 (E0), U2.19 (E1)
μRD0: J1.60, U7.23 (A0), U11.18 (B0)
μRD1: J1.58, U7.22 (A1), U11.17 (B1)
μRD2: J1.56, U7.21 (A2), U11.16 (B2)
μRD3: J1.54, U7.20 (A3), U11.15 (B3)
μWR0: J1.48, U2.23 (A0), U12.15 (B3)
μWR1: J1.46, U2.22 (A1), U12.16 (B2)
μWR2: J1.44, U2.21 (A2), U12.17 (B1)
μWR3: J1.42, U2.20 (A3), U12.18 (B0)

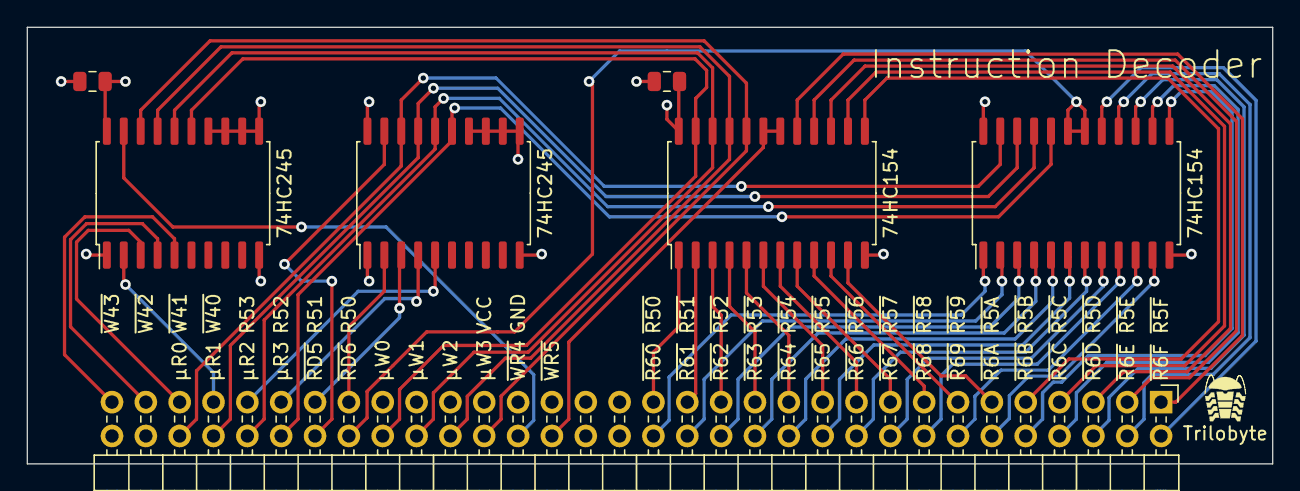
[picture p281: board PCBs/999-QUEUED-TO-PRINT/Instruction-Decoder-Extra/CPU-Instruction-De… from above]

Board: 4 copper layers, 93.5 x 32.8 mm, 7 parts (0 on the bottom side), 54 nets.
