theWickedWebDev/8-bit-computer/PCBs/03_MODULES/CPU-ALU/ALU-Conditional-Jumps/control-unit.kicad_pcb

## KiCad design PCBs/03_MODULES/CPU-ALU/ALU-Conditional-Jumps/control-unit.kicad_pcb (2022-08-27)

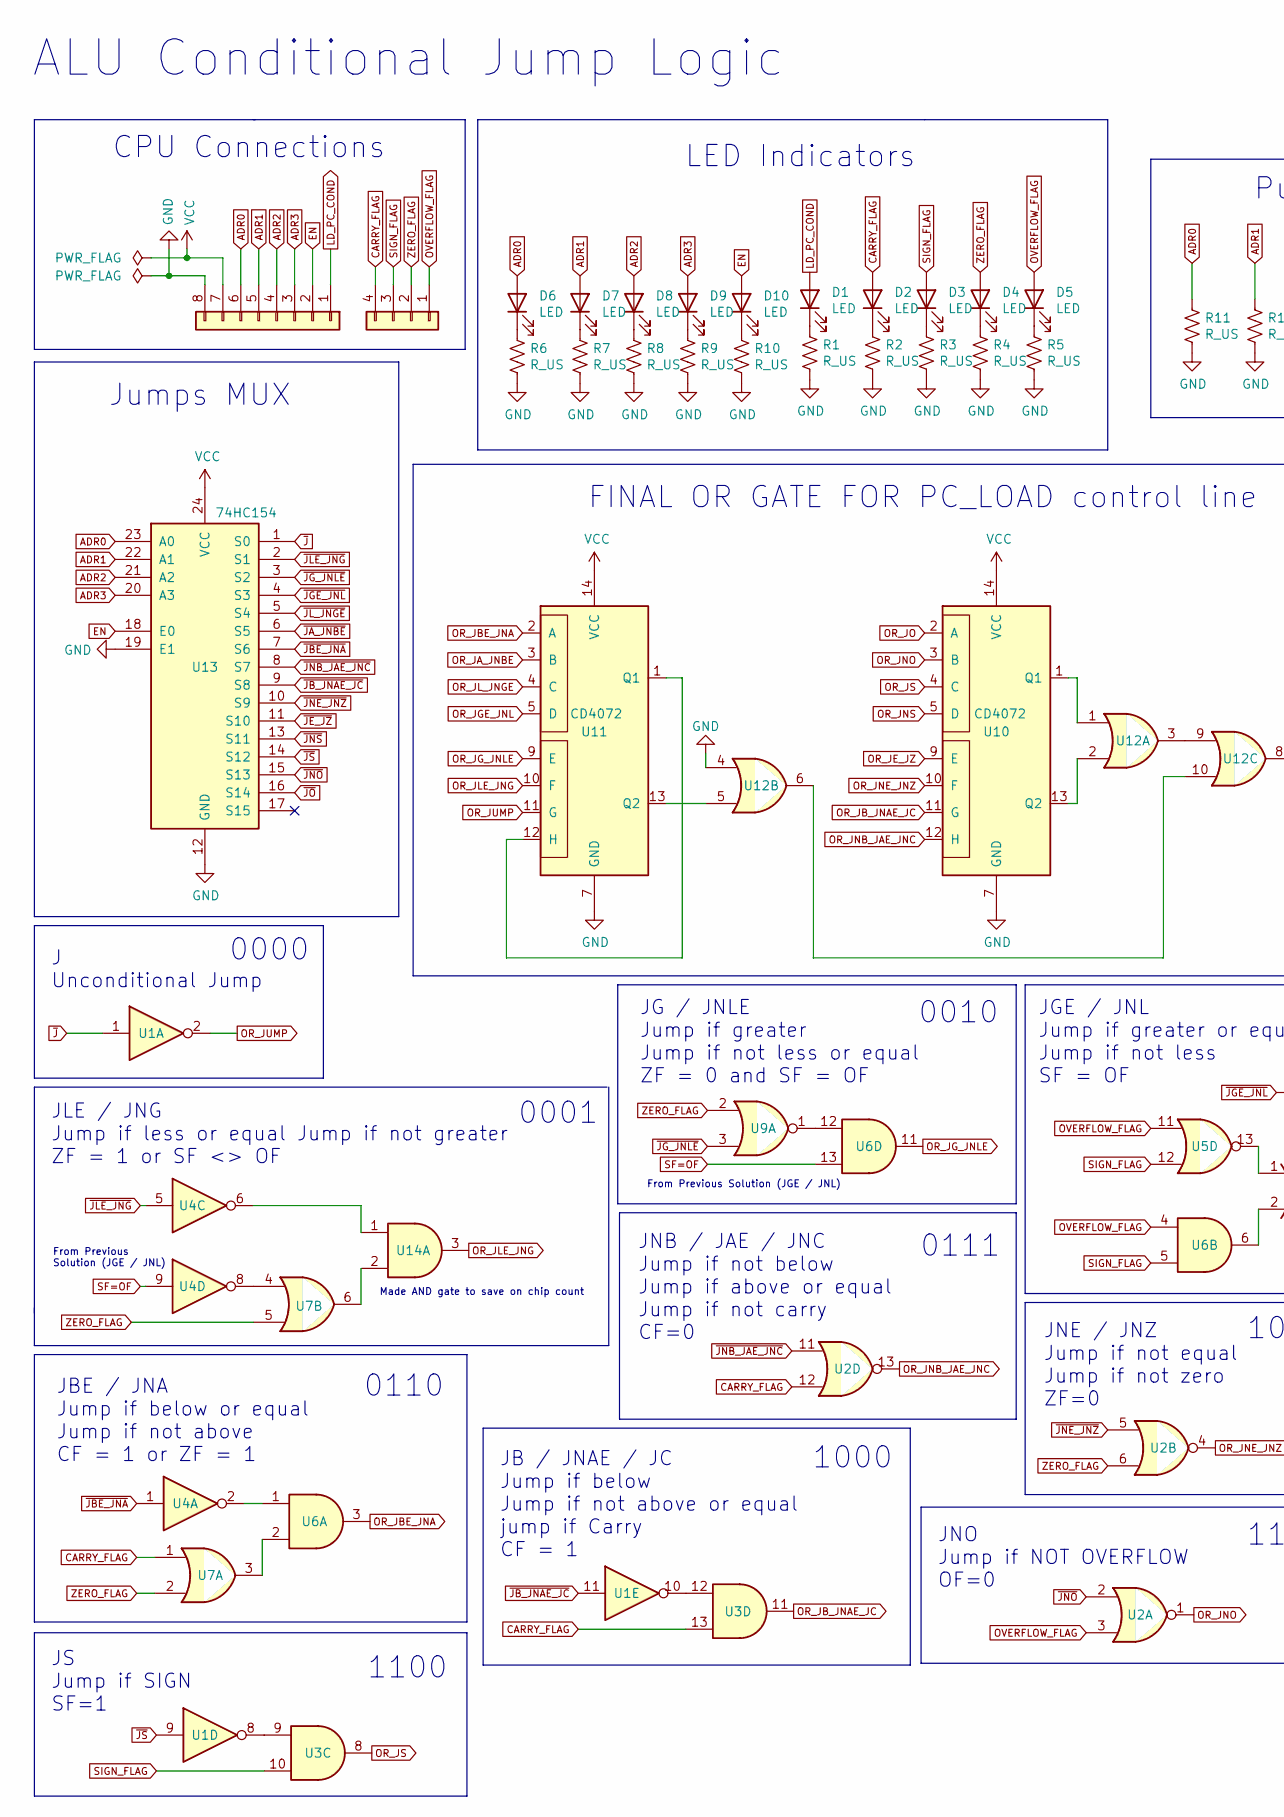
[picture p282: schematic control-unit.kicad_sch, Conditional Jump Logic - ALU, part in row 1, column 1]

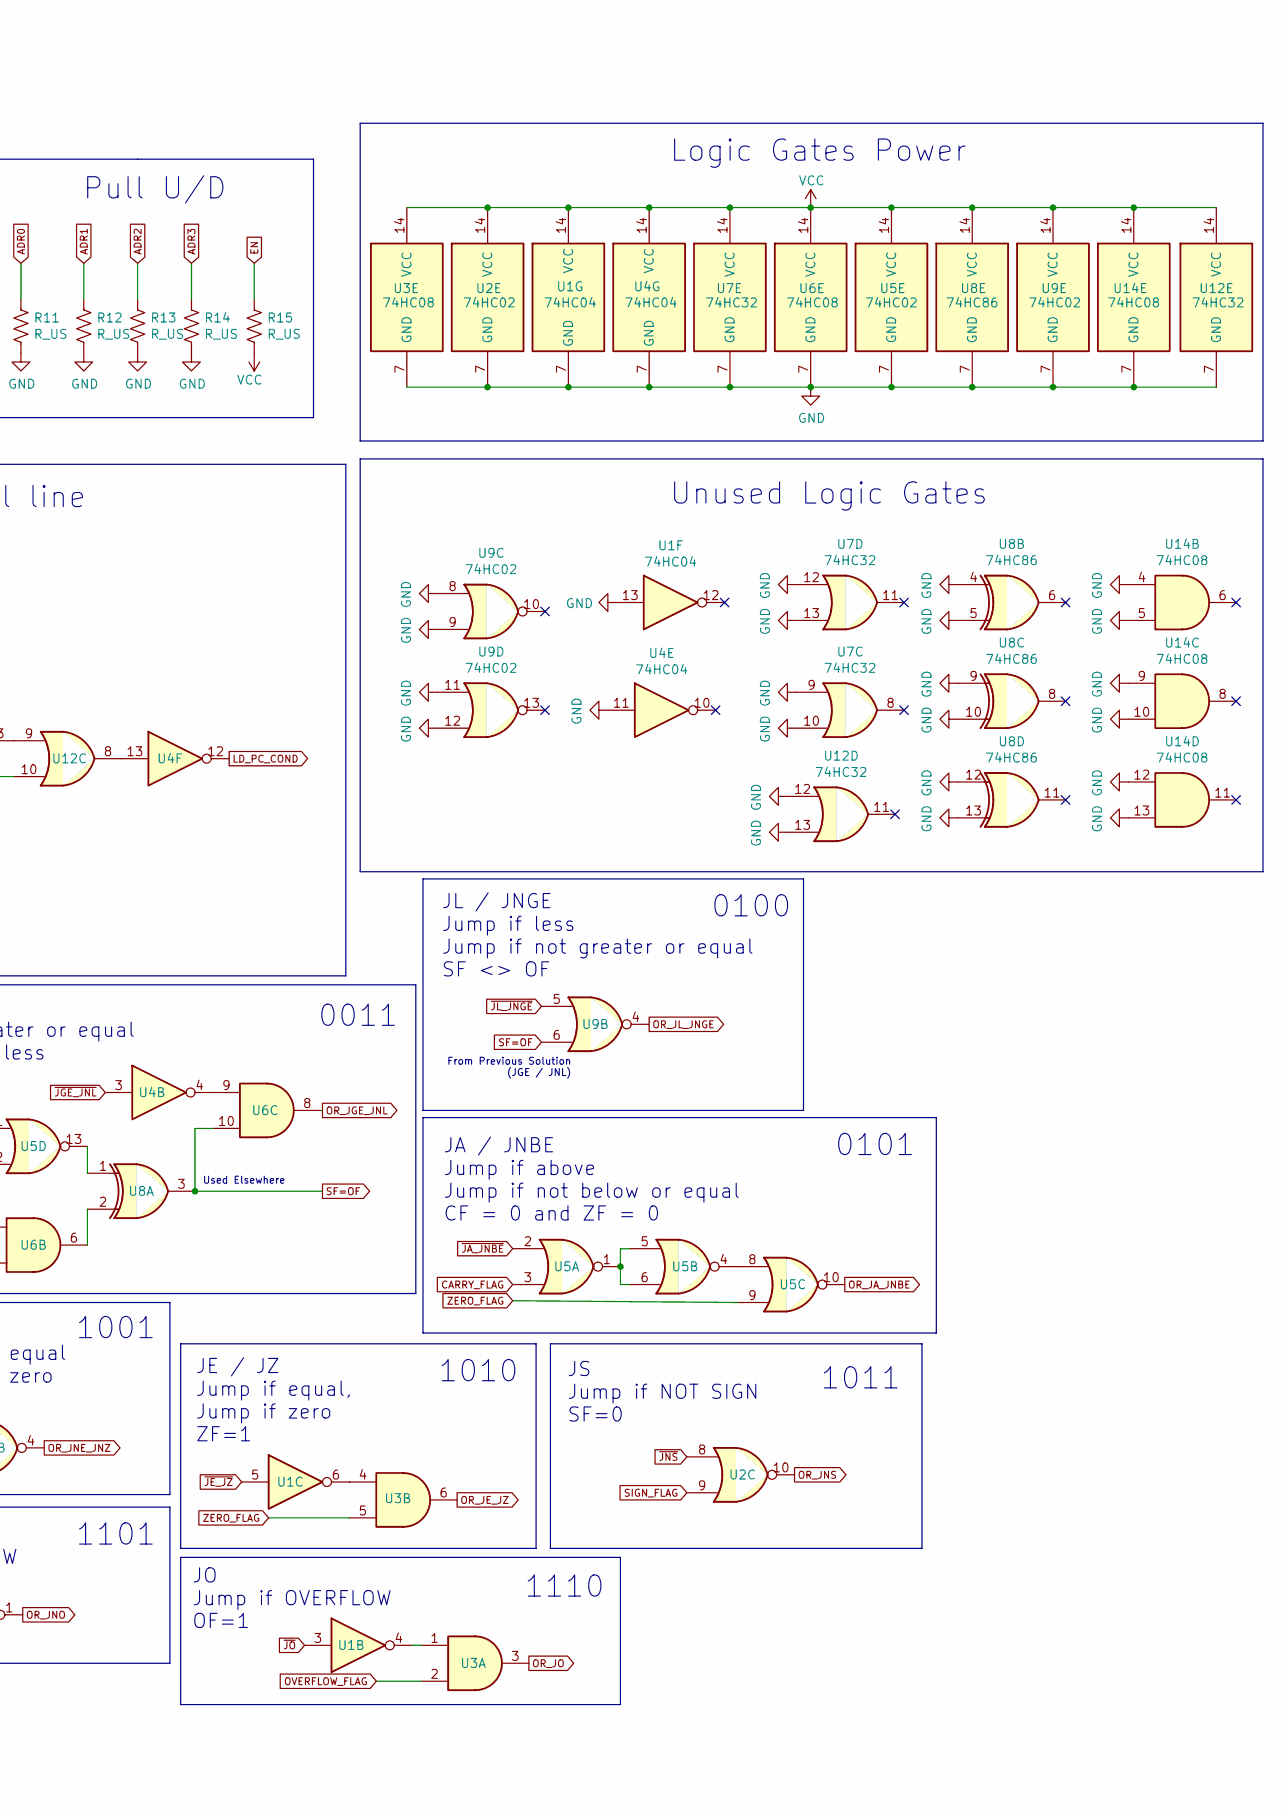
[picture p283: schematic control-unit.kicad_sch, Conditional Jump Logic - ALU, part in row 1, column 2]

Parts:
D1, D2, D3, D4, D5, D6, D7, D8, D9, D10: LED; LED_0805_2012Metric
J3: Conn_01x08; PinHeader_1x08_P2.54mm_Vertical
J4: Conn_01x04; PinHeader_1x04_P2.54mm_Vertical
R1, R2, R3, R4, R5, R6, R7, R8, R9, R10, R11, R12, R13, R14, R15: R_US; R_0805_2012Metric
U1, U4: 74HC04; TSSOP-14_4.4x5mm_P0.65mm
U2, U5, U9: 74HC02; TSSOP-14_4.4x5mm_P0.65mm
U3, U6, U14: 74HC08; TSSOP-14_4.4x5mm_P0.65mm
U7, U12: 74HC32; TSSOP-14_4.4x5mm_P0.65mm
U8: 74HC86; TSSOP-14_4.4x5mm_P0.65mm
U10, U11: CD4072; SOIC-14_3.9x8.7mm_P1.27mm
U13: 74HC154; SOIC-24W_7.5x15.4mm_P1.27mm

Connections:
ADR0: D6.2 (A), J3.6, R11.1, U13.23 (A0)
ADR1: D7.2 (A), J3.5, R12.1, U13.22 (A1)
ADR2: D8.2 (A), J3.4, R13.1, U13.21 (A2)
ADR3: D9.2 (A), J3.3, R14.1, U13.20 (A3)
CARRY_FLAG: D2.2 (A), J4.4, U2.12, U3.13, U5.3, U7.1
EN: D10.2 (A), J3.2, R15.1, U13.18 (E0)
GND: J3.8, R1.2, R2.2, R3.2, R4.2, R5.2, R6.2, R7.2, R8.2, R9.2, R10.2, R11.2, R12.2, R13.2, R14.2, U1.7 (GND), U1.13, U2.7 (GND), U3.7 (GND), U4.7 (GND), U4.11, U5.7 (GND), U6.7 (GND), U7.7 (GND), U7.9, U7.10, U7.12, U7.13, U8.4, U8.5, U8.7 (GND), U8.9, U8.10, U8.12, U8.13, U9.7 (GND), U9.8, U9.9, U9.11, U9.12, U10.7 (GND), U11.7 (GND), U12.4, U12.7 (GND), U12.12, U12.13, U13.12 (GND), U13.19 (E1), U14.4, U14.5, U14.7 (GND), U14.9, U14.10, U14.12, U14.13
LD_PC_COND: D1.2 (A), J3.1, U4.12
unnamed: D1.1 (K), R1.1
unnamed: D2.1 (K), R2.1
unnamed: D3.1 (K), R3.1
unnamed: D4.1 (K), R4.1
unnamed: D5.1 (K), R5.1
unnamed: D6.1 (K), R6.1
unnamed: D7.1 (K), R7.1
unnamed: D8.1 (K), R8.1
unnamed: D9.1 (K), R9.1
unnamed: D10.1 (K), R10.1
unnamed: U1.4, U3.1
unnamed: U1.6, U3.4
unnamed: U1.8, U3.9
unnamed: U1.10, U3.12
unnamed: U4.2, U6.1
unnamed: U4.8, U7.4
unnamed: U5.1, U5.5, U5.6
unnamed: U5.4, U5.8
unnamed: U5.13, U8.1
unnamed: U6.2, U7.3
unnamed: U6.6, U8.2
unnamed: U4.4, U6.9
unnamed: U6.12, U9.1
unnamed: U10.1 (Q1), U12.1
unnamed: U10.13 (Q2), U12.2
unnamed: U11.1 (Q1), U11.12 (H)
unnamed: U11.13 (Q2), U12.5
unnamed: U12.3, U12.9
unnamed: U4.13, U12.8
unnamed: U12.6, U12.10
unnamed: U4.6, U14.1
unnamed: U7.6, U14.2
OR_JA_JNBE: U5.10, U11.3 (B)
OR_JBE_JNA: U6.3, U11.2 (A)
OR_JB_JNAE_JC: U3.11, U10.11 (G)
OR_JE_JZ: U3.6, U10.9 (E)
OR_JGE_JNL: U6.8, U11.5 (D)
OR_JG_JNLE: U6.11, U11.9 (E)
OR_JLE_JNG: U11.10 (F), U14.3
OR_JL_JNGE: U9.4, U11.4 (C)
OR_JNB_JAE_JNC: U2.13, U10.12 (H)
OR_JNE_JNZ: U2.4, U10.10 (F)
OR_JNO: U2.1, U10.3 (B)
OR_JNS: U2.10, U10.5 (D)
OR_JO: U3.3, U10.2 (A)
OR_JS: U3.8, U10.4 (C)
OR_JUMP: U1.2, U11.11 (G)
OVERFLOW_FLAG: D5.2 (A), J4.1, U2.3, U3.2, U5.11, U6.4
SF=OF: U4.9, U6.10, U6.13, U8.3, U9.6
SIGN_FLAG: D3.2 (A), J4.3, U2.9, U3.10, U5.12, U6.5
VCC: J3.7, R15.2, U1.14 (VCC), U2.14 (VCC), U3.14 (VCC), U4.14 (VCC), U5.14 (VCC), U6.14 (VCC), U7.14 (VCC), U8.14 (VCC), U9.14 (VCC), U10.14 (VCC), U11.14 (VCC), U12.14 (VCC), U13.24 (VCC), U14.14 (VCC)
ZERO_FLAG: D4.2 (A), J4.2, U2.6, U3.5, U5.9, U7.2, U7.5, U9.2
~JA_JNBE: U5.2, U13.6 (S5)
~JBE_JNA: U4.1, U13.7 (S6)
~JB_JNAE_JC: U1.11, U13.9 (S8)
~JE_JZ: U1.5, U13.11 (S10)
~JGE_JNL: U4.3, U13.4 (S3)
~JG_JNLE: U9.3, U13.3 (S2)
~JLE_JNG: U4.5, U13.2 (S1)
~JL_JNGE: U9.5, U13.5 (S4)
~JNB_JAE_JNC: U2.11, U13.8 (S7)
~JNE_JNZ: U2.5, U13.10 (S9)
~JNO: U2.2, U13.15 (S13)
~JNS: U2.8, U13.13 (S11)
~JO: U1.3, U13.16 (S14)
~JS: U1.9, U13.14 (S12)
~J: U1.1, U13.1 (S0)

Notes on the sheet:
JE / JZ Jump if equal, Jump if zero ZF=1
1000
1100
0000
Used Elsewhere
ALU Conditional Jump Logic
JS Jump if NOT SIGN SF=0
From Previous Solution (JGE / JNL)
JA / JNBE Jump if above Jump if not below or equal CF = 0 and ZF = 0
0111
JGE / JNL Jump if greater or equal Jump if not less SF = OF
JLE / JNG Jump if less or equal Jump if not greater ZF = 1 or SF <> OF
From Previous Solution (JGE / JNL)
0010
1001
JS Jump if SIGN SF=1
1101
JB / JNAE / JC Jump if below Jump if not above or equal jump if Carry CF = 1
From Previous Solution (JGE / JNL)
JNB / JAE / JNC Jump if not below Jump if above or equal Jump if not carry CF=0
Pull U/D
Unused Logic Gates
0100
JNE / JNZ Jump if not equal Jump if not zero ZF=0
JG / JNLE Jump if greater Jump if not less or equal ZF = 0 and SF = OF
JBE / JNA Jump if below or equal Jump if not above CF = 1 or ZF = 1
J Unconditional Jump
Made AND gate to save on chip count
Logic Gates Power
0001
JNO Jump if NOT OVERFLOW OF=0
LED Indicators
CPU Connections
1011
FINAL OR GATE FOR PC_LOAD control line
Jumps MUX
1010
0011
JL / JNGE Jump if less Jump if not greater or equal SF <> OF
0101
1110
0110
JO Jump if OVERFLOW OF=1

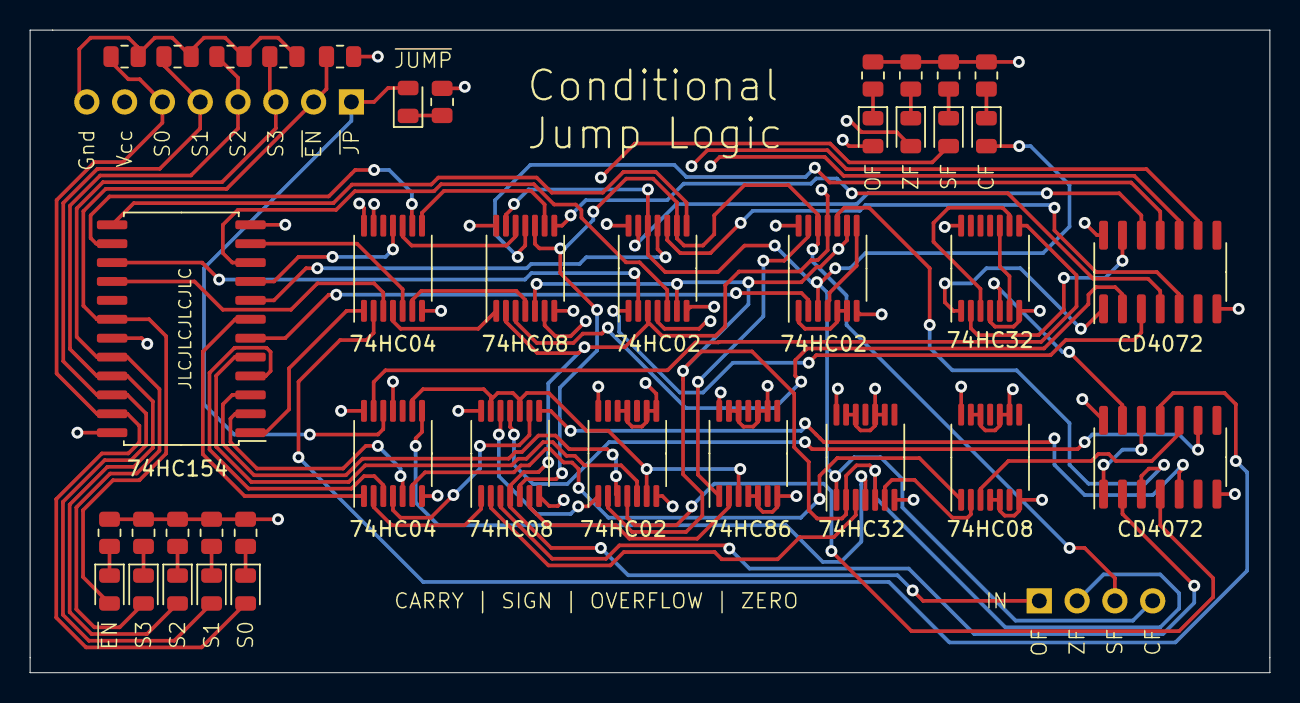
[picture p284: board control-unit.kicad_pcb from above]

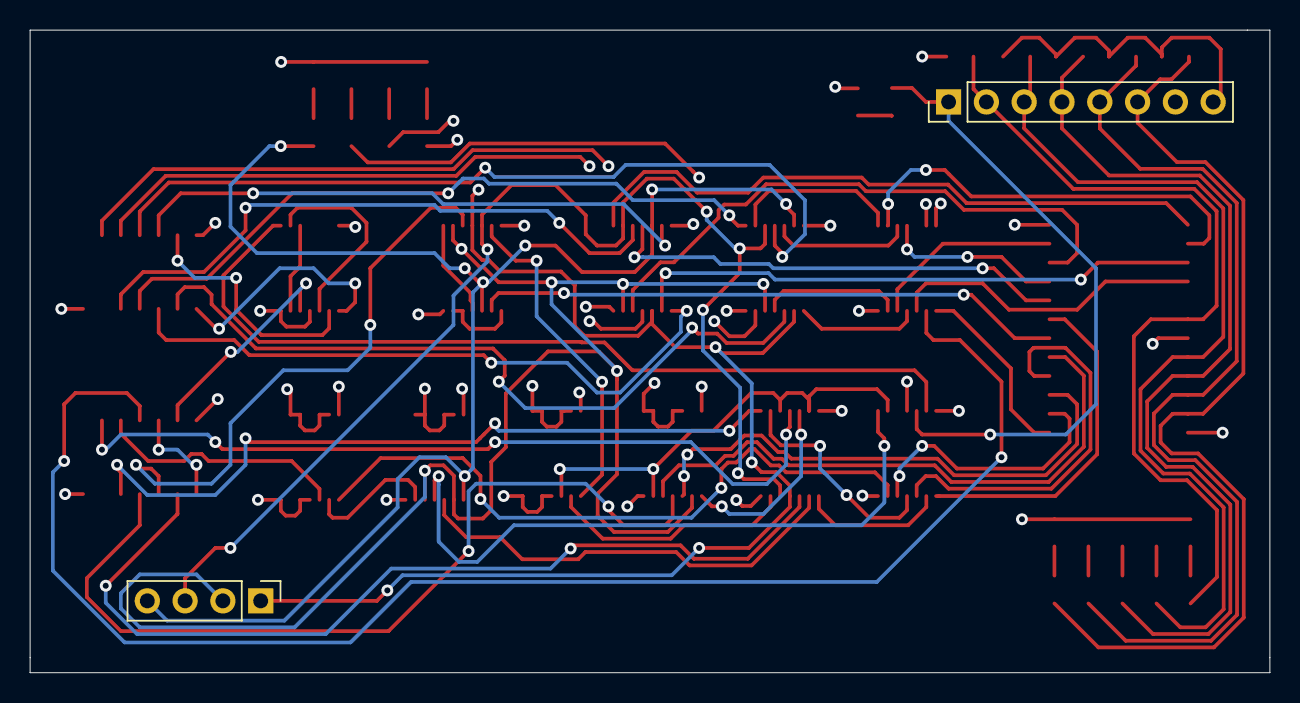
[picture p285: board control-unit.kicad_pcb from below]

Board: 4 copper layers, 83.3 x 43.2 mm, 41 parts (2 on the bottom side), 75 nets.
