theWickedWebDev/8-bit-computer/PCBs/99_IN PROGRESS/IO-VGA-output/IO-VGA-output.kicad_pcb

## KiCad design PCBs/99_IN PROGRESS/IO-VGA-output/IO-VGA-output.kicad_pcb (2022-08-27)

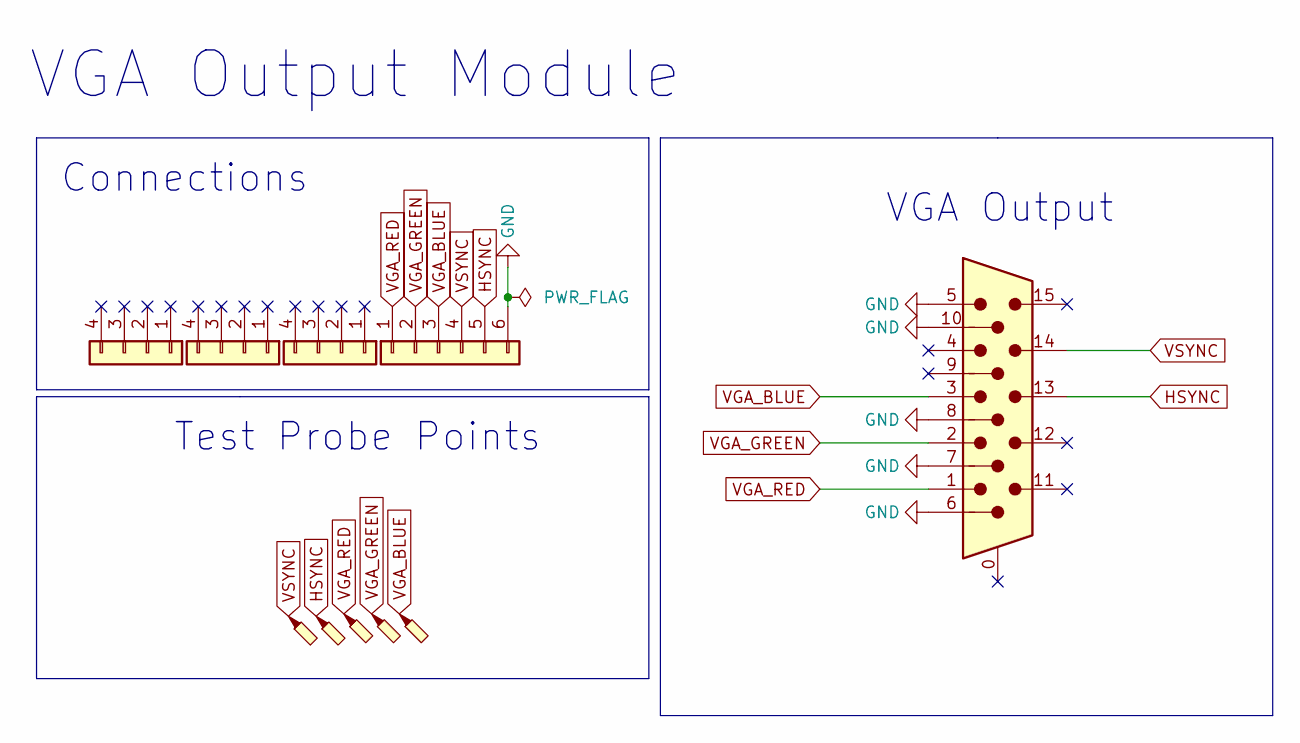
[picture p286: schematic IO-VGA-output.kicad_sch]

Parts:
J1: DB15_Male_HighDensity_MountingHoles; DSUB-15-HD_Female_Horizontal_P2.29x1.98mm_EdgePinOffset8.35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
J2, J4, J5: Conn_01x04; PinHeader_1x04_P2.54mm_Vertical
J3: Conn_01x06; PinHeader_1x06_P2.54mm_Vertical
TP1, TP2, TP3, TP4, TP5: TestPoint_Probe; TestPoint_Pad_D3.0mm

Connections:
GND: J1.5, J1.6, J1.7, J1.8, J1.10, J3.6
HSYNC: J1.13, J3.5, TP4.1
VGA_BLUE: J1.3, J3.3, TP1.1
VGA_GREEN: J1.2, J3.2, TP2.1
VGA_RED: J1.1, J3.1, TP3.1
VSYNC: J1.14, J3.4, TP5.1

Notes on the sheet:
VGA Output
Test Probe Points
Connections
VGA Output Module

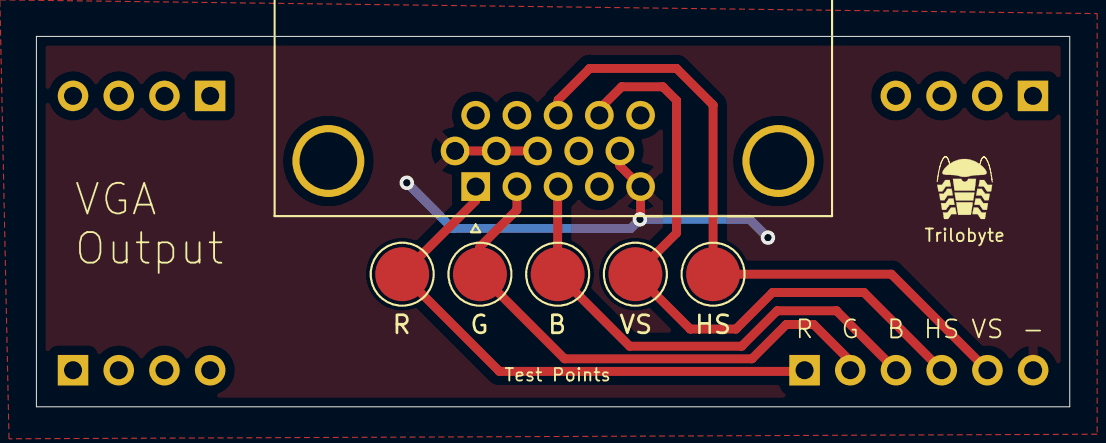
[picture p287: board IO-VGA-output.kicad_pcb from above]

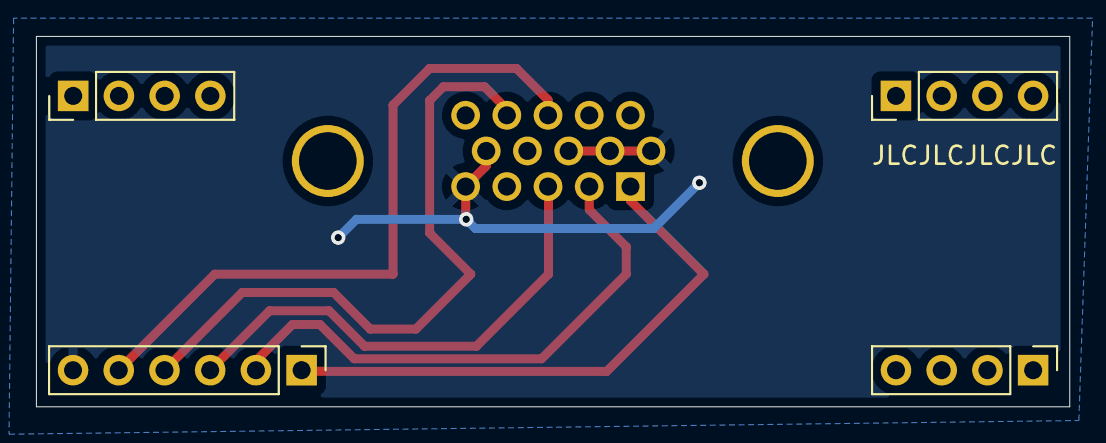
[picture p288: board IO-VGA-output.kicad_pcb from below]

Board: 2 copper layers, 57.4 x 20.6 mm, 10 parts (4 on the bottom side), 6 nets.
