theWickedWebDev/8-bit-computer/PCBs/99_IN PROGRESS/IO-Midi-SN76489/IO-Midi-SN76489.kicad_pcb

## KiCad design PCBs/99_IN PROGRESS/IO-Midi-SN76489/IO-Midi-SN76489.kicad_pcb (2022-08-27)

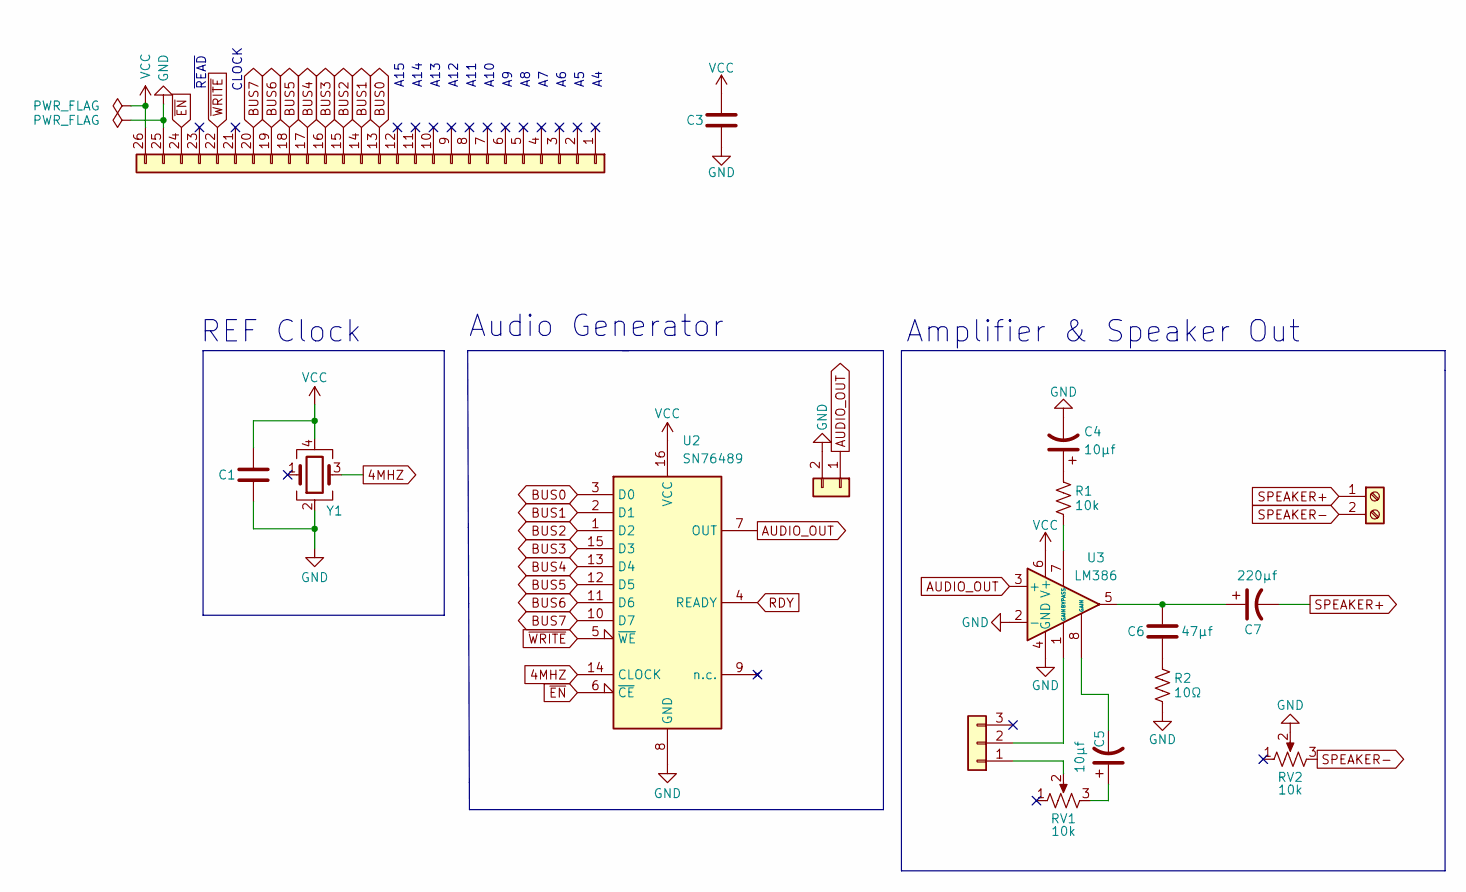
[picture p289: schematic IO-Midi-SN76489.kicad_sch]

Parts:
C1, C3: C; C_0805_2012Metric
C4, C5: 10µf; CP_Elec_5x5.4
C6: 47µf; C_0805_2012Metric
C7: 220µf; CP_Elec_6.3x7.7
J1: Conn_01x26; PinHeader_1x26_P2.54mm_Horizontal
J2: Conn_01x03; PinHeader_1x03_P2.54mm_Vertical
J3: Screw_Terminal_01x02; TerminalBlock_Phoenix_MPT-0,5-2-2.54_1x02_P2.54mm_Horizontal
J4: Conn_01x02; PinHeader_1x02_P2.54mm_Vertical
R1: 10k; R_0805_2012Metric
R2: 10Ω; R_0805_2012Metric
RV1, RV2: 10k; Potentiometer_ACP_CA9-H3,8_Horizontal
U2: SN76489; DIP-16_W7.62mm
U3: LM386; DIP-8_W7.62mm
Y1: 4MHz; Crystal_DIP_4_14

Connections:
4MHZ: U2.14 (CLOCK), Y1.3
AUDIO_OUT: J4.1, U2.7 (OUT), U3.3 (+)
BUS0: J1.13, U2.3 (D0)
BUS1: J1.14, U2.2 (D1)
BUS2: J1.15, U2.1 (D2)
BUS3: J1.16, U2.15 (D3)
BUS4: J1.17, U2.13 (D4)
BUS5: J1.18, U2.12 (D5)
BUS6: J1.19, U2.11 (D6)
BUS7: J1.20, U2.10 (D7)
GND: C1.2, C3.2, C4.2, J1.25, J4.2, R2.2, RV2.2, U2.8 (GND), U3.2 (-), U3.4 (GND), Y1.2
unnamed: C4.1, R1.1
unnamed: C5.1, RV1.3
unnamed: C5.2, U3.8 (GAIN)
unnamed: C6.1, C7.1, U3.5
unnamed: C6.2, R2.1
unnamed: J2.1, RV1.2
unnamed: R1.2, U3.7 (BYPASS)
unnamed: J2.2, U3.1 (GAIN)
RDY: U2.4 (READY)
SPEAKER+: C7.2, J3.1
SPEAKER-: J3.2, RV2.3
VCC: C1.1, C3.1, J1.26, U2.16 (VCC), U3.6 (V+), Y1.4
~EN: J1.24, U2.6 (~CE)
~WRITE: J1.22, U2.5 (~WE)

Notes on the sheet:
A12
A10
A13
CLOCK
Amplifier & Speaker Out
REF Clock
A15
~{READ}
Audio Generator
A14
A11

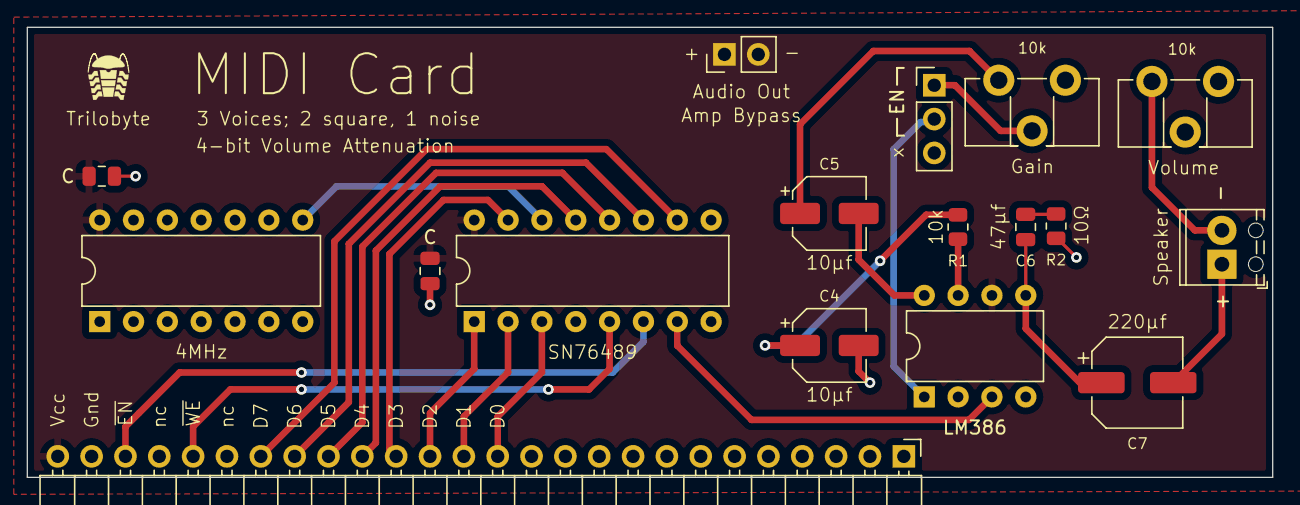
[picture p290: board IO-Midi-SN76489.kicad_pcb from above]

Board: 2 copper layers, 93.5 x 33.8 mm, 17 parts (0 on the bottom side), 24 nets.
