theWickedWebDev/8-bit-computer/PCBs/03_MODULES/CPU-ALU/ALU-Flags-Register/Flags Register.kicad_pcb

## KiCad design PCBs/03_MODULES/CPU-ALU/ALU-Flags-Register/Flags Register.kicad_pcb (2022-02-28)

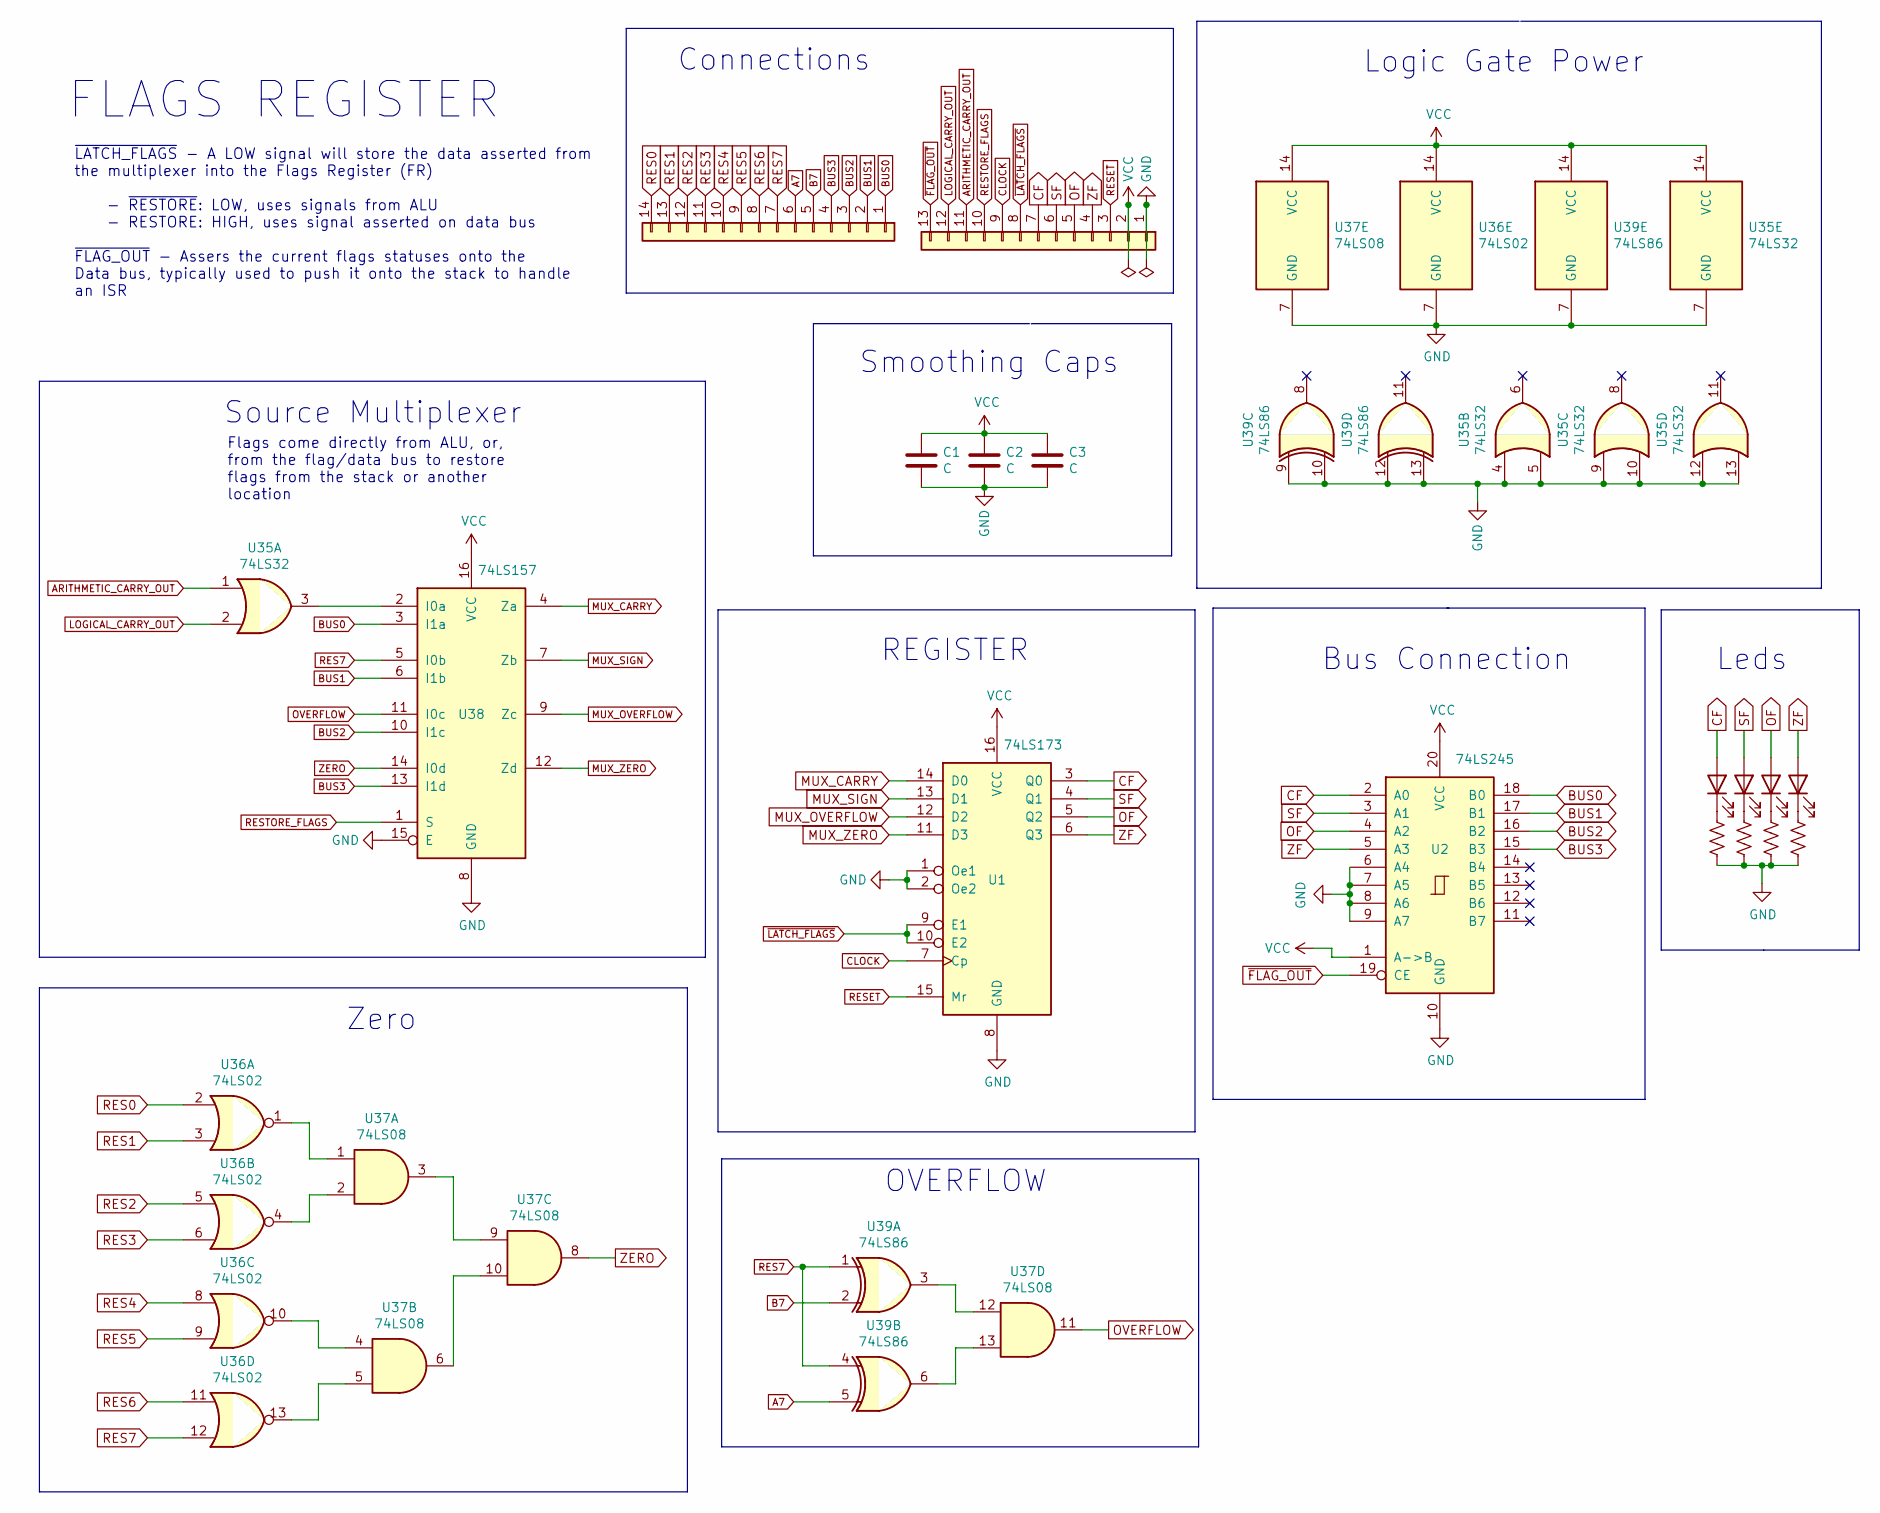
[picture p291: schematic Flags Register.kicad_sch]

Parts:
C1, C2, C3: C; C_0805_2012Metric
D1, D2, D3, D4: LED; LED_0805_2012Metric
J1: Conn_01x13; PinHeader_1x13_P2.54mm_Vertical
J2: Conn_01x14; PinHeader_1x14_P2.54mm_Vertical
R1, R2, R3, R4: R_US; R_0805_2012Metric
U1: 74LS173; TSSOP-16_4.4x5mm_P0.65mm
U2: 74LS245; TSSOP-20_4.4x6.5mm_P0.65mm
U35: 74LS32; TSSOP-14_4.4x5mm_P0.65mm
U36: 74LS02; TSSOP-14_4.4x5mm_P0.65mm
U37: 74LS08; TSSOP-14_4.4x5mm_P0.65mm
U38: 74LS157; TSSOP-16_4.4x5mm_P0.65mm
U39: 74LS86; TSSOP-14_4.4x5mm_P0.65mm

Connections:
A7: J2.6, U39.5
ARITHMETIC_CARRY_OUT: J1.11, U35.1
B7: J2.5, U39.2
BUS0: J2.1, U2.18 (B0), U38.3 (I1a)
BUS1: J2.2, U2.17 (B1), U38.6 (I1b)
BUS2: J2.3, U2.16 (B2), U38.10 (I1c)
BUS3: J2.4, U2.15 (B3), U38.13 (I1d)
CF: D1.2 (A), J1.7, U1.3 (Q0), U2.2 (A0)
CLOCK: J1.9, U1.7 (Cp)
GND: C1.2, C2.2, C3.2, J1.1, R1.2, R2.2, R3.2, R4.2, U1.1 (Oe1), U1.2 (Oe2), U1.8 (GND), U2.6 (A4), U2.7 (A5), U2.8 (A6), U2.9 (A7), U2.10 (GND), U35.4, U35.5, U35.7 (GND), U35.9, U35.10, U35.12, U35.13, U36.7 (GND), U37.7 (GND), U38.8 (GND), U38.15 (E), U39.7 (GND), U39.9, U39.10, U39.12, U39.13
LOGICAL_CARRY_OUT: J1.12, U35.2
MUX_CARRY: U1.14 (D0), U38.4 (Za)
MUX_OVERFLOW: U1.12 (D2), U38.9 (Zc)
MUX_SIGN: U1.13 (D1), U38.7 (Zb)
MUX_ZERO: U1.11 (D3), U38.12 (Zd)
unnamed: D1.1 (K), R1.1
unnamed: D2.1 (K), R2.1
unnamed: D3.1 (K), R3.1
unnamed: D4.1 (K), R4.1
unnamed: U35.3, U38.2 (I0a)
unnamed: U36.1, U37.1
unnamed: U36.4, U37.2
unnamed: U36.10, U37.4
unnamed: U36.13, U37.5
unnamed: U37.3, U37.9
unnamed: U37.6, U37.10
unnamed: U37.12, U39.3
unnamed: U37.13, U39.6
OF: D3.2 (A), J1.5, U1.5 (Q2), U2.4 (A2)
OVERFLOW: U37.11, U38.11 (I0c)
RES0: J2.14, U36.2
RES1: J2.13, U36.3
RES2: J2.12, U36.5
RES3: J2.11, U36.6
RES4: J2.10, U36.8
RES5: J2.9, U36.9
RES6: J2.8, U36.11
RES7: J2.7, U36.12, U38.5 (I0b), U39.1, U39.4
RESET: J1.3, U1.15 (Mr)
RESTORE_FLAGS: J1.10, U38.1 (S)
SF: D2.2 (A), J1.6, U1.4 (Q1), U2.3 (A1)
VCC: C1.1, C2.1, C3.1, J1.2, U1.16 (VCC), U2.1 (A->B), U2.20 (VCC), U35.14 (VCC), U36.14 (VCC), U37.14 (VCC), U38.16 (VCC), U39.14 (VCC)
ZERO: U37.8, U38.14 (I0d)
ZF: D4.2 (A), J1.4, U1.6 (Q3), U2.5 (A3)
~FLAG_OUT: J1.13, U2.19 (CE)
~LATCH_FLAGS: J1.8, U1.9 (E1), U1.10 (E2)

Notes on the sheet:
Source Multiplexer
Bus Connection
Smoothing Caps
~{LATCH_FLAGS} - A LOW signal will store the data asserted from the multiplexer into the Flags Register (FR) - ~{RESTORE}: LOW, uses signals from ALU - RESTORE: HIGH, uses signal asserted on data bus ~{FLAG_OUT} - Assers the current flags statuses onto the Data bus, typically used to push it onto t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
Flags come directly from ALU, or, from the flag/data bus to restore flags from the stack or another location
Leds
Connections
Logic Gate Power
FLAGS REGISTER
REGISTER
OVERFLOW
Zero

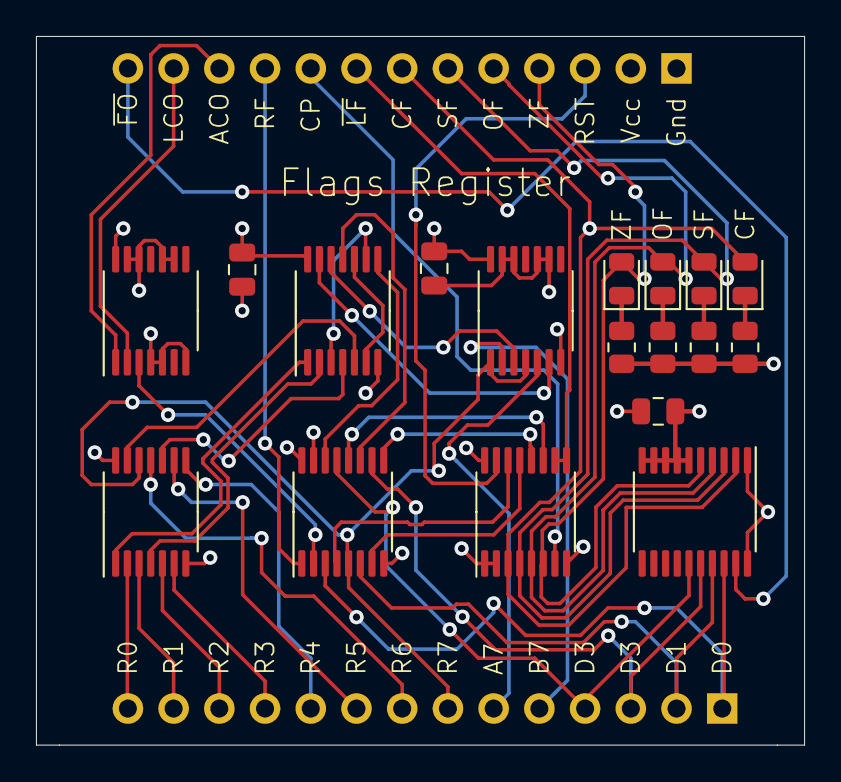
[picture p292: board Flags Register.kicad_pcb from above]

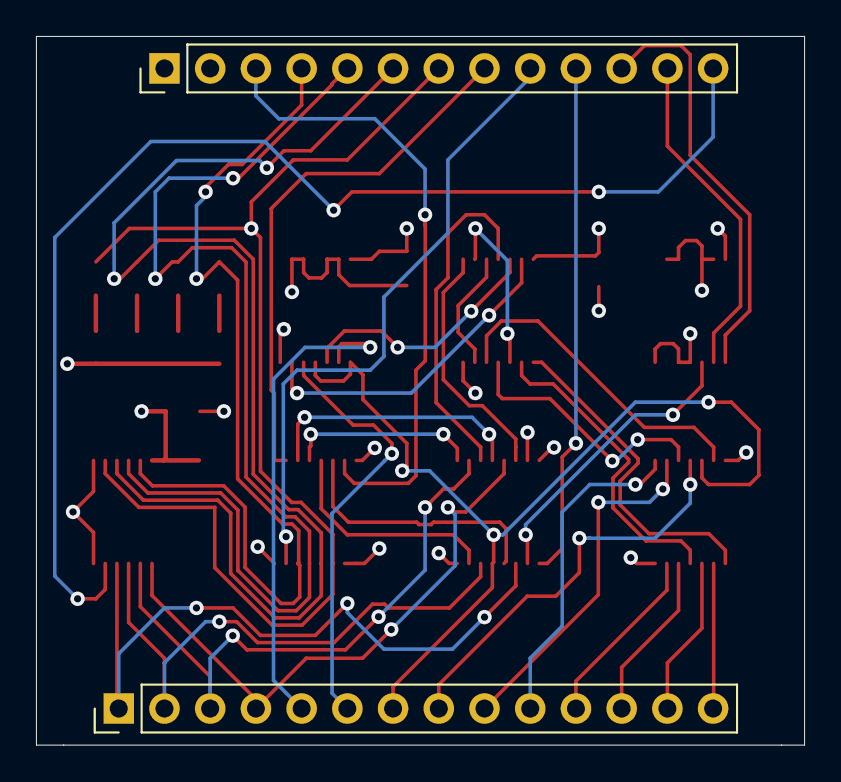
[picture p293: board Flags Register.kicad_pcb from below]

Board: 4 copper layers, 42.7 x 39.4 mm, 20 parts (2 on the bottom side), 46 nets.
