theWickedWebDev/8-bit-computer/PCBs/99_IN PROGRESS/IO-VGA-nand-gates/IO-VGA-nand-gates.kicad_pcb

## KiCad design PCBs/99_IN PROGRESS/IO-VGA-nand-gates/IO-VGA-nand-gates.kicad_pcb (2022-08-27)

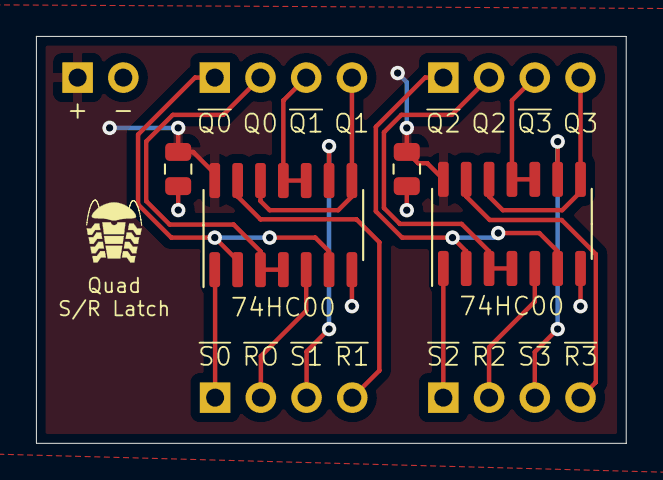
[picture p294: board IO-VGA-nand-gates.kicad_pcb from above]

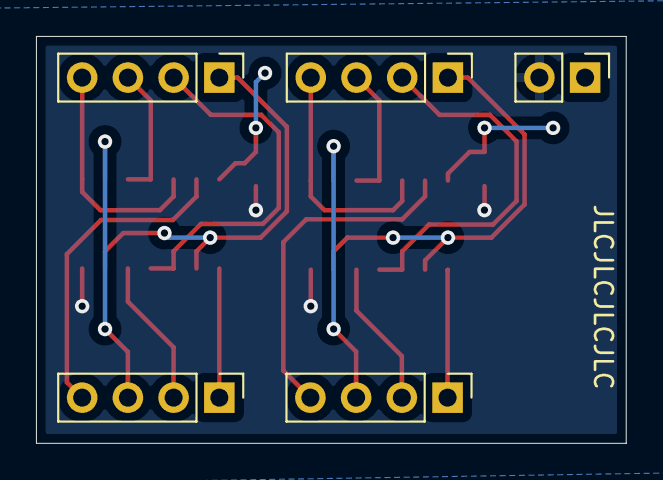
[picture p295: board IO-VGA-nand-gates.kicad_pcb from below]

Board: 2 copper layers, 32.8 x 22.6 mm, 9 parts (5 on the bottom side), 18 nets.

Parts:
C1, C2: C; C_0805_2012Metric
J1, J3, J4, J5: Conn_01x04; PinHeader_1x04_P2.54mm_Vertical
J2: Conn_01x02; PinHeader_1x02_P2.54mm_Vertical
U1, U2: 74LS00; SOIC-14_3.9x8.7mm_P1.27mm

Connections:
/Q0: J5.2, U1.3, U1.4
/Q1: J5.4, U1.8, U1.12
/Q2: J4.2, U2.3, U2.4
/Q3: J4.4, U2.8, U2.12
/~Q0: J5.1, U1.2, U1.6
/~Q1: J5.3, U1.10, U1.11
/~Q2: J4.1, U2.2, U2.6
/~Q3: J4.3, U2.10, U2.11
/~R0: J1.2, U1.5
/~R1: J1.4, U1.13
/~R2: J3.2, U2.5
/~R3: J3.4, U2.13
/~S0: J1.1, U1.1
/~S1: J1.3, U1.9
/~S2: J3.1, U2.1
/~S3: J3.3, U2.9
GND: C1.2, C2.2, J2.2, U1.7 (GND), U2.7 (GND)
VCC: C1.1, C2.1, J2.1, U1.14 (VCC), U2.14 (VCC)
