theWickedWebDev/8-bit-computer/PCBs/01_BACKPLANES/CPU-MicrocodeEEPROM_Backplane/CPU-MicrocodeEEPROM_Backplane.kicad_pcb

## KiCad design PCBs/01_BACKPLANES/CPU-MicrocodeEEPROM_Backplane/CPU-MicrocodeEEPROM_Backplane.kicad_pcb (2022-08-27)

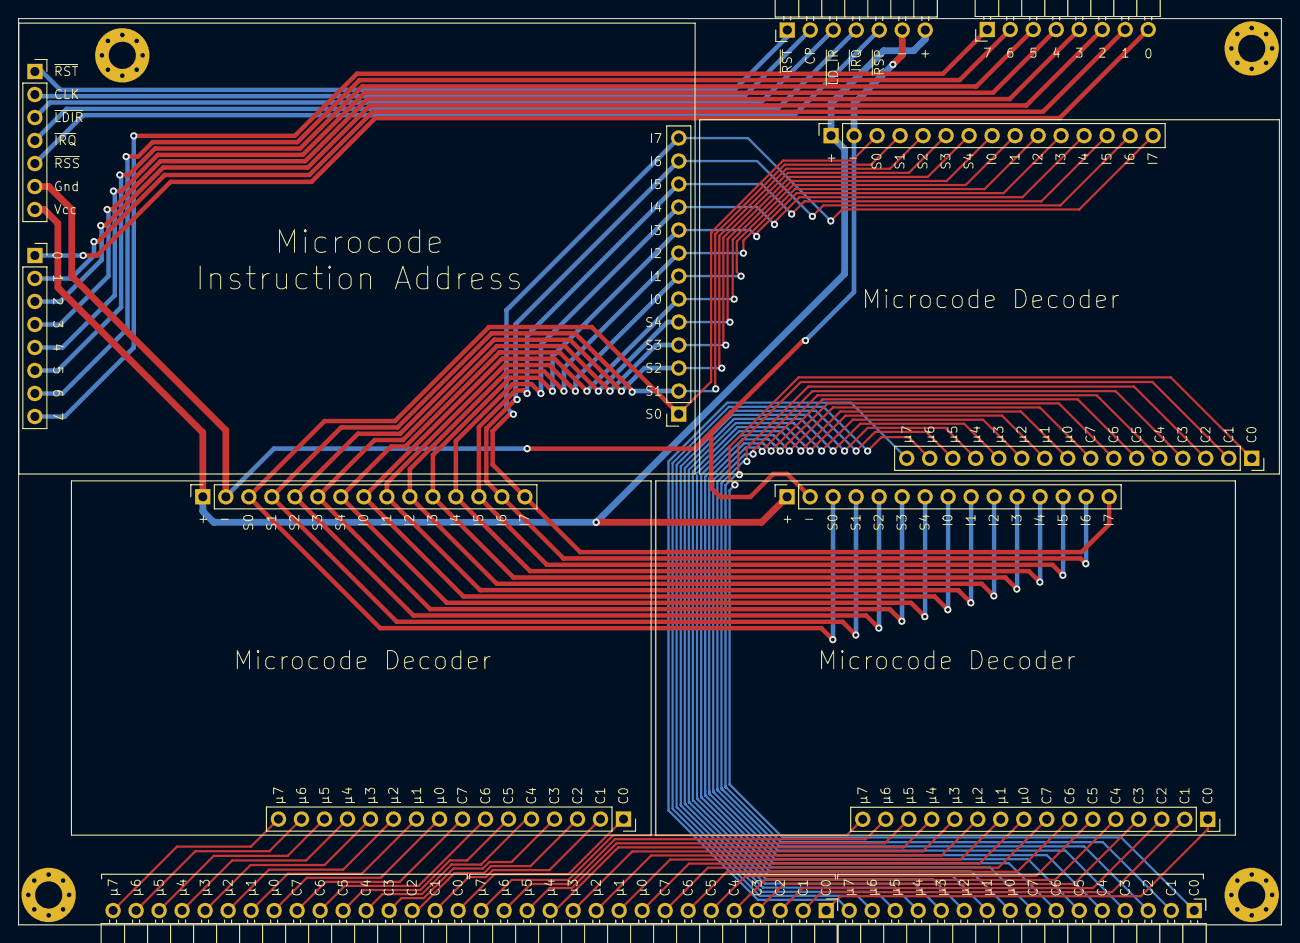
[picture p296: board CPU-MicrocodeEEPROM_Backplane.kicad_pcb from above]

Board: 2 copper layers, 139.4 x 100.1 mm, 13 parts (0 on the bottom side), 76 nets.

Parts:
J1: Conn_01x08; PinSocket_1x08_P2.54mm_Vertical
J2: Conn_01x08; PinHeader_1x08_P2.54mm_Horizontal
J3: Conn_01x13; PinSocket_1x13_P2.54mm_Vertical
J4: Conn_01x07; PinHeader_1x07_P2.54mm_Horizontal
J5: Conn_01x07; PinSocket_1x07_P2.54mm_Vertical
J6, J9, J12: Conn_01x16; PinSocket_1x16_P2.54mm_Vertical
J7, J10, J13: Conn_01x15; PinSocket_1x15_P2.54mm_Vertical
J8: Conn_01x15; PinHeader_1x32_P2.54mm_Horizontal
J11: Conn_01x16; PinHeader_1x16_P2.54mm_Horizontal

Connections:
BUS0: J1.1, J2.8
BUS1: J1.2, J2.7
BUS2: J1.3, J2.6
BUS3: J1.4, J2.5
BUS4: J1.5, J2.4
BUS5: J1.6, J2.3
BUS6: J1.7, J2.2
BUS7: J1.8, J2.1
CLOCK: J4.2, J5.2
GND: J4.6, J5.6, J7.2, J10.2, J13.2
INSTRUCTION0: J3.6, J7.8, J10.8, J13.8
INSTRUCTION1: J3.7, J7.9, J10.9, J13.9
INSTRUCTION2: J3.8, J7.10, J10.10, J13.10
INSTRUCTION3: J3.9, J7.11, J10.11, J13.11
INSTRUCTION4: J3.10, J7.12, J10.12, J13.12
INSTRUCTION5: J3.11, J7.13, J10.13, J13.13
INSTRUCTION6: J3.12, J7.14, J10.14, J13.14
INSTRUCTION7: J3.13, J7.15, J10.15, J13.15
STEP0: J3.1, J7.3, J10.3, J13.3
STEP1: J3.2, J7.4, J10.4, J13.4
STEP2: J3.3, J7.5, J10.5, J13.5
STEP3: J3.4, J7.6, J10.6, J13.6
STEP4: J3.5, J7.7, J10.7, J13.7
VCC: J4.7, J5.7, J7.1, J10.1, J13.1
~DECODE_CONTROL_0b: J8.1, J9.1
~DECODE_CONTROL_0c: J11.1, J12.1
~DECODE_CONTROL_0: J6.1, J8.17
~DECODE_CONTROL_1b: J8.2, J9.2
~DECODE_CONTROL_1c: J11.2, J12.2
~DECODE_CONTROL_1: J6.2, J8.18
~DECODE_CONTROL_2b: J8.3, J9.3
~DECODE_CONTROL_2c: J11.3, J12.3
~DECODE_CONTROL_2: J6.3, J8.19
~DECODE_CONTROL_3b: J8.4, J9.4
~DECODE_CONTROL_3c: J11.4, J12.4
~DECODE_CONTROL_3: J6.4, J8.20
~DECODE_CONTROL_4b: J8.5, J9.5
~DECODE_CONTROL_4c: J11.5, J12.5
~DECODE_CONTROL_4: J6.5, J8.21
~DECODE_CONTROL_5b: J8.6, J9.6
~DECODE_CONTROL_5c: J11.6, J12.6
~DECODE_CONTROL_5: J6.6, J8.22
~DECODE_CONTROL_6b: J8.7, J9.7
~DECODE_CONTROL_6c: J11.7, J12.7
~DECODE_CONTROL_6: J6.7, J8.23
~DECODE_CONTROL_7b: J8.8, J9.8
~DECODE_CONTROL_7c: J11.8, J12.8
~DECODE_CONTROL_7: J6.8, J8.24
~INT_REQUEST: J4.4, J5.4
~LD_IR: J4.3, J5.3
~RESET_STEP: J4.5, J5.5
~RESET: J4.1, J5.1
μ0: J6.9, J8.25
μ0b: J8.9, J9.9
μ0c: J11.9, J12.9
μ1: J6.10, J8.26
μ1b: J8.10, J9.10
μ1c: J11.10, J12.10
μ2: J6.11, J8.27
μ2b: J8.11, J9.11
μ2c: J11.11, J12.11
μ3: J6.12, J8.28
μ3b: J8.12, J9.12
μ3c: J11.12, J12.12
μ4: J6.13, J8.29
μ4b: J8.13, J9.13
μ4c: J11.13, J12.13
μ5: J6.14, J8.30
μ5b: J8.14, J9.14
μ5c: J11.14, J12.14
μ6: J6.15, J8.31
μ6b: J8.15, J9.15
μ6c: J11.15, J12.15
μ7: J6.16, J8.32
μ7b: J8.16, J9.16
μ7c: J11.16, J12.16
