theWickedWebDev/8-bit-computer/PCBs/999-QUEUED-TO-PRINT/CPU-Backplane-Vertical/Backplane-Concept-Vertical.kicad_pcb

## KiCad design PCBs/999-QUEUED-TO-PRINT/CPU-Backplane-Vertical/Backplane-Concept-Vertical.kicad_pcb (2022-11-09)

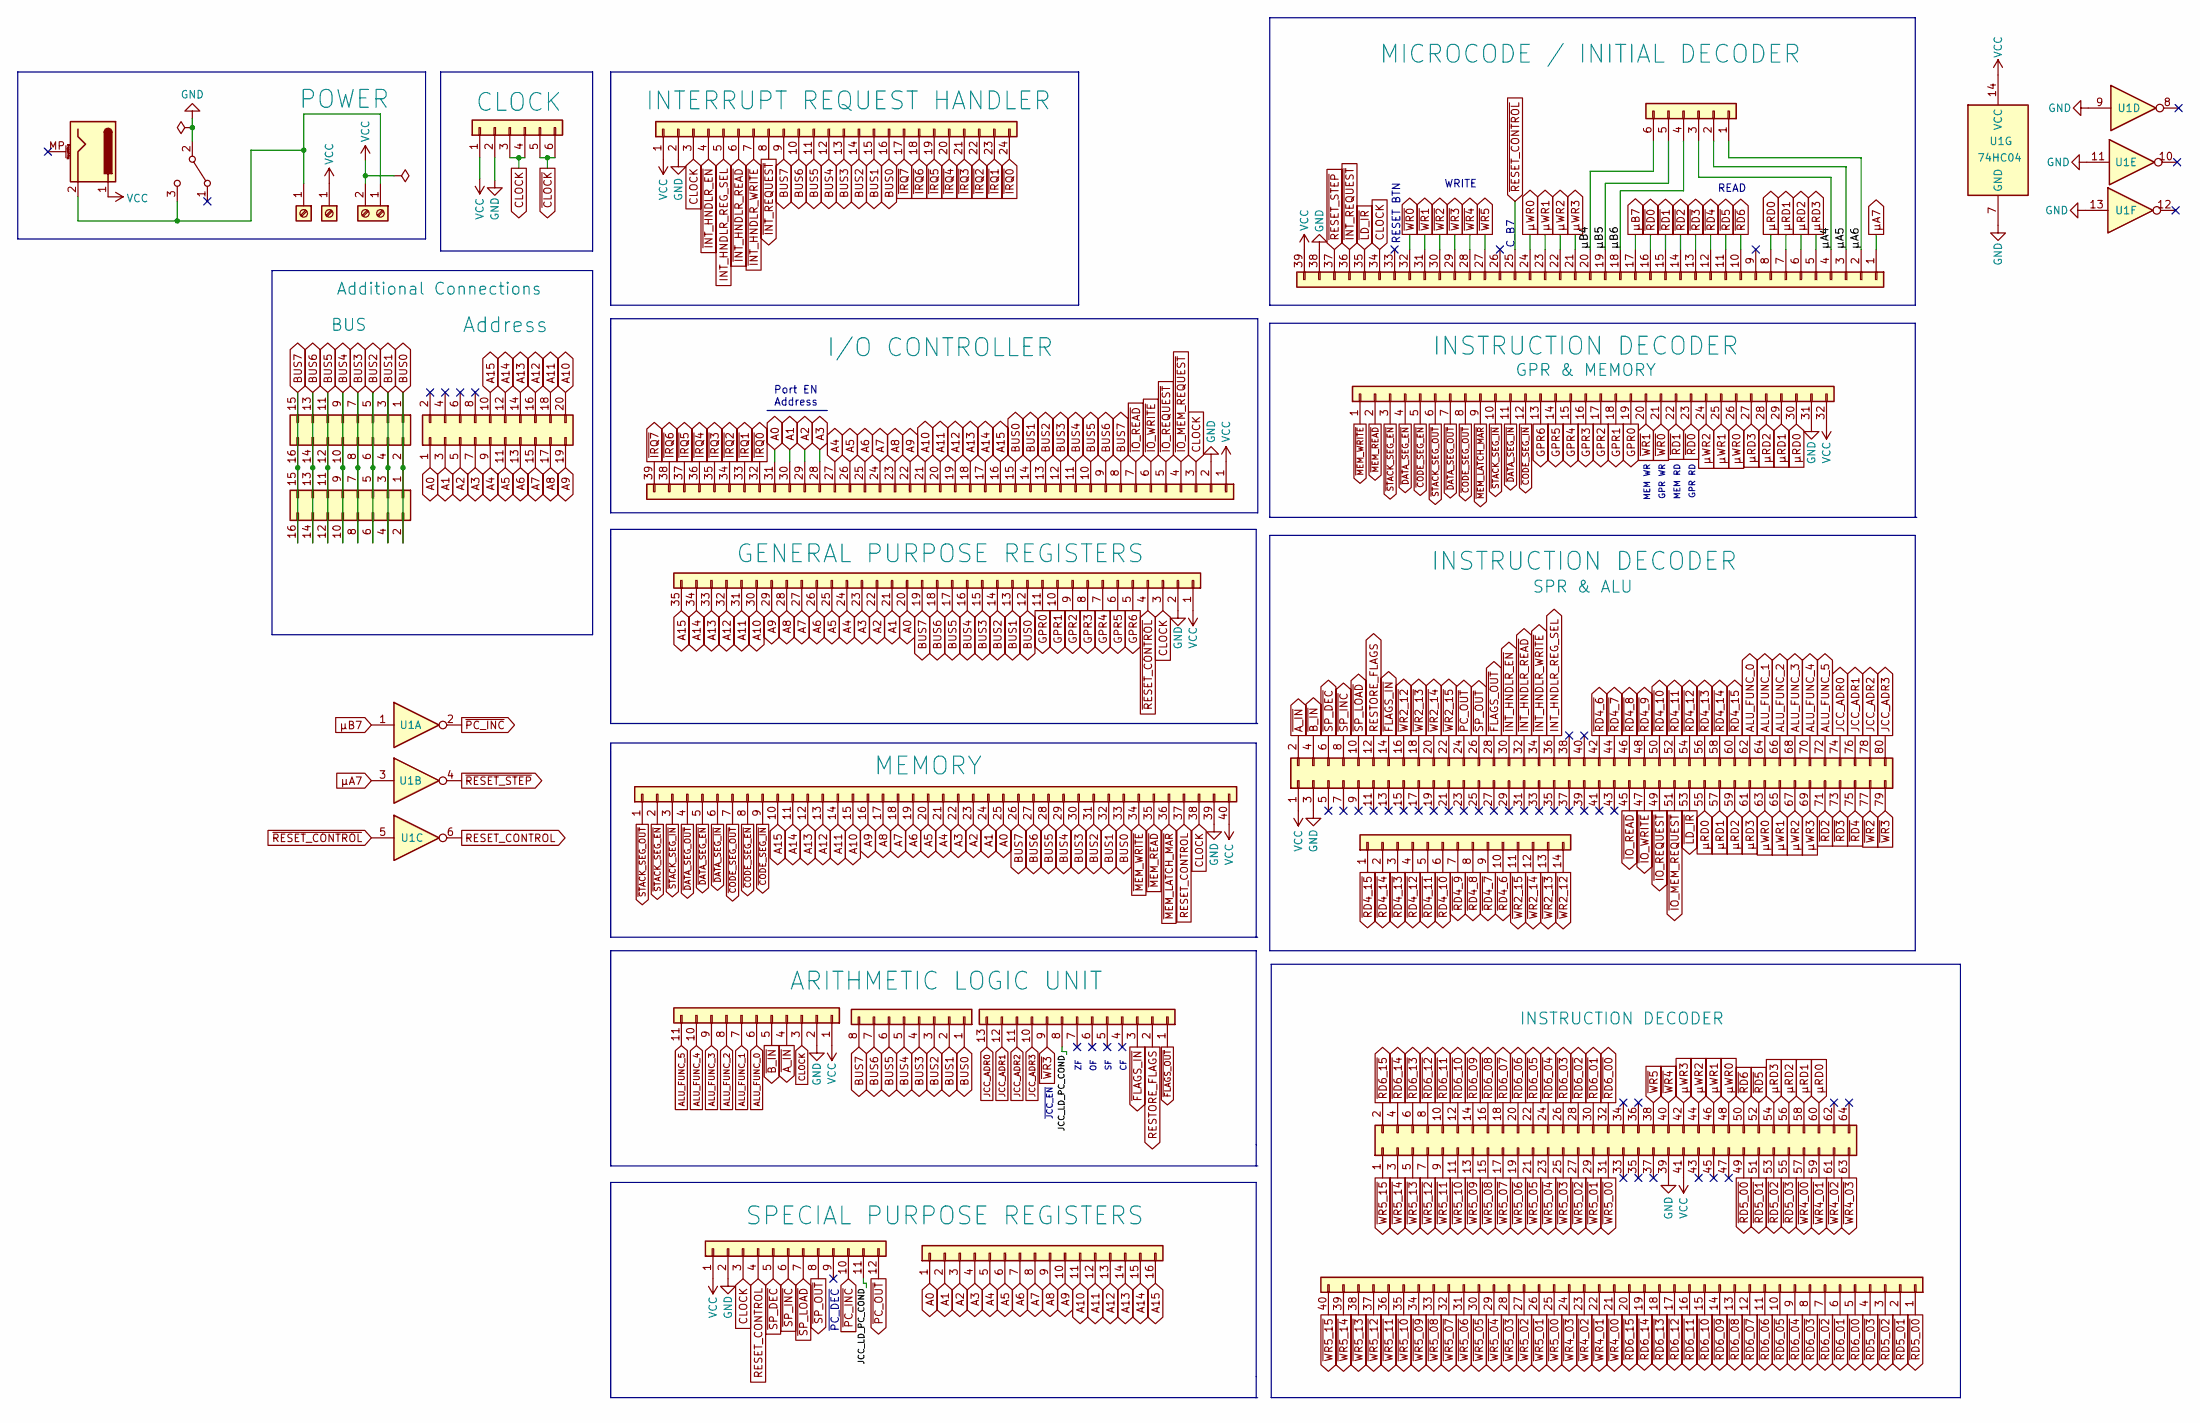
[picture p297: schematic Backplane-Concept-Vertical.kicad_sch]

Parts:
J1: Conn_01x12; PinSocket_2x40_P2.54mm_Vertical
J2: Conn_01x12; PinSocket_1x11_P2.54mm_Vertical
J3: Conn_01x24; PinSocket_1x12_P2.54mm_Vertical
J4: Conn_01x08; PinSocket_1x24_P2.54mm_Vertical
J5: Conn_01x40; PinSocket_1x08_P2.54mm_Vertical
J6: Conn_01x35; PinSocket_1x40_P2.54mm_Vertical
J7: Conn_01x16; PinSocket_1x35_P2.54mm_Vertical
J8: Conn_01x13; PinSocket_1x16_P2.54mm_Vertical
J9: Conn_01x06; PinSocket_1x13_P2.54mm_Vertical
J10: Screw_Terminal_01x01; PinSocket_1x06_P2.54mm_Vertical
J11, J12: Screw_Terminal_01x01; BananaJack-2mm-Single
J13: Screw_Terminal_01x02; TerminalBlock_Phoenix_MKDS-1,5-2_1x02_P5.00mm_Horizontal
J14: Conn_01x14; PinHeader_1x14_P2.54mm_Horizontal
J15: Conn_01x39; PinSocket_1x39_P2.54mm_Vertical
J16: Conn_01x39; PinSocket_1x39_P2.54mm_Horizontal
J17, J23: Conn_01x08; PinHeader_2x08_P2.54mm_Vertical
J18: Conn_01x32; PinSocket_1x32_P2.54mm_Vertical
J19: Conn_02x20_Odd_Even; IDC-Header_2x10_P2.54mm_Vertical
J20: Conn_01x06; PinHeader_1x06_P2.54mm_Horizontal
J21: Conn_01x40; PinSocket_1x40_P2.54mm_Horizontal
J22: Barrel_Jack_MountingPin; BarrelJack_Horizontal
J25: Conn_02x32_Odd_Even; PinSocket_2x32_P2.54mm_Vertical
SW1: SW_SPDT; SPDT-Slide-Switch-THT
U1: 74HC04

Connections:
/JCC_LD_PC_COND: J3.11, J9.8
/μA4: J15.4, J20.3
/μA5: J15.3, J20.2
/μA6: J15.2, J20.1
/μB4: J15.20, J20.6
/μB5: J15.19, J20.5
/μB6: J15.18, J20.4
A0: J6.25, J7.20, J8.1, J16.31, J19.1
A1: J6.24, J7.21, J8.2, J16.30, J19.3
A2: J6.23, J7.22, J8.3, J16.29, J19.5
A3: J6.22, J7.23, J8.4, J16.28, J19.7
A4: J6.21, J7.24, J8.5, J16.27, J19.9
A5: J6.20, J7.25, J8.6, J16.26, J19.11
A6: J6.19, J7.26, J8.7, J16.25, J19.13
A7: J6.18, J7.27, J8.8, J16.24, J19.15
A8: J6.17, J7.28, J8.9, J16.23, J19.17
A9: J6.16, J7.29, J8.10, J16.22, J19.19
A10: J6.15, J7.30, J8.11, J16.21, J19.20
A11: J6.14, J7.31, J8.12, J16.20, J19.18
A12: J6.13, J7.32, J8.13, J16.19, J19.16
A13: J6.12, J7.33, J8.14, J16.18, J19.14
A14: J6.11, J7.34, J8.15, J16.17, J19.12
A15: J6.10, J7.35, J8.16, J16.16, J19.10
ALU_FUNC_0: J1.62, J2.6
ALU_FUNC_1: J1.64, J2.7
ALU_FUNC_2: J1.66, J2.8
ALU_FUNC_3: J1.68, J2.9
ALU_FUNC_4: J1.70, J2.10
ALU_FUNC_5: J1.72, J2.11
BUS0: J4.16, J5.1, J6.33, J7.12, J16.15, J17.1, J17.2, J23.1, J23.2
BUS1: J4.15, J5.2, J6.32, J7.13, J16.14, J17.3, J17.4, J23.3, J23.4
BUS2: J4.14, J5.3, J6.31, J7.14, J16.13, J17.5, J17.6, J23.5, J23.6
BUS3: J4.13, J5.4, J6.30, J7.15, J16.12, J17.7, J17.8, J23.7, J23.8
BUS4: J4.12, J5.5, J6.29, J7.16, J16.11, J17.9, J17.10, J23.9, J23.10
BUS5: J4.11, J5.6, J6.28, J7.17, J16.10, J17.11, J17.12, J23.11, J23.12
BUS6: J4.10, J5.7, J6.27, J7.18, J16.9, J17.13, J17.14, J23.13, J23.14
BUS7: J4.9, J5.8, J6.26, J7.19, J16.8, J17.15, J17.16, J23.15, J23.16
CLOCK: J2.3, J3.3, J4.3, J6.38, J7.3, J10.3, J10.4, J15.34, J16.3
GND: J1.3, J2.2, J3.2, J4.2, J6.39, J7.2, J10.2, J15.38, J16.2, J18.31, J25.39, SW1.2 (B), U1.7 (GND), U1.9, U1.11, U1.13
GPR0: J7.11, J18.19
GPR1: J7.10, J18.18
GPR2: J7.9, J18.17
GPR3: J7.8, J18.16
GPR4: J7.7, J18.15
GPR5: J7.6, J18.14
GPR6: J7.5, J18.13
INT_HNDLR_REG_SEL: J1.36, J4.5
JCC_ADR0: J1.74, J9.13
JCC_ADR1: J1.76, J9.12
JCC_ADR2: J1.78, J9.11
JCC_ADR3: J1.80, J9.10
unnamed: J11.1, J13.1, J22.2, SW1.3 (C)
RESET_CONTROL: J3.4, J6.37, U1.6
RESTORE_FLAGS: J1.12, J9.2
VCC: J1.1, J2.1, J3.1, J4.1, J6.40, J7.1, J10.1, J12.1, J13.2, J15.39, J16.1, J18.32, J22.1, J25.41, U1.14 (VCC)
~A_IN: J1.2, J2.4
~B_IN: J1.4, J2.5
~CLOCK: J10.5, J10.6
~CODE_SEG_EN: J6.8, J18.5
~CODE_SEG_IN: J6.9, J18.12
~CODE_SEG_OUT: J6.7, J18.8
~DATA_SEG_EN: J6.5, J18.4
~DATA_SEG_IN: J6.6, J18.11
~DATA_SEG_OUT: J6.4, J18.7
~FLAGS_IN: J1.14, J9.3
~FLAGS_OUT: J1.28, J9.1
~INT_HNDLR_EN: J1.30, J4.4
~INT_HNDLR_READ: J1.32, J4.6
~INT_HNDLR_WRITE: J1.34, J4.7
~INT_REQUEST: J4.8, J15.36
~IO_MEM_REQUEST: J1.51, J16.4
~IO_READ: J1.45, J16.7
~IO_REQUEST: J1.49, J16.5
~IO_WRITE: J1.47, J16.6
~IRQ0: J4.24, J16.32
~IRQ1: J4.23, J16.33
~IRQ2: J4.22, J16.34
~IRQ3: J4.21, J16.35
~IRQ4: J4.20, J16.36
~IRQ5: J4.19, J16.37
~IRQ6: J4.18, J16.38
~IRQ7: J4.17, J16.39
~LD_IR: J1.53, J15.35
~MEM_LATCH_MAR: J6.36, J18.9
~MEM_READ: J6.35, J18.2
~MEM_WRITE: J6.34, J18.1
~PC_INC: J3.10, U1.2
~PC_OUT: J1.24, J3.12
~RD0: J15.16, J18.23
~RD1: J15.15, J18.22
~RD2: J1.71, J15.14
~RD3: J1.73, J15.13
~RD4_6: J1.42, J14.10
~RD4_7: J1.44, J14.9
~RD4_8: J1.46, J14.8
~RD4_9: J1.48, J14.7
~RD4_10: J1.50, J14.6
~RD4_11: J1.52, J14.5
~RD4_12: J1.54, J14.4
~RD4_13: J1.56, J14.3
~RD4_14: J1.58, J14.2
~RD4_15: J1.60, J14.1
~RD4: J1.75, J15.12
~RD5_00: J21.1, J25.49
~RD5_01: J21.2, J25.51
~RD5_02: J21.3, J25.53
~RD5_03: J21.4, J25.55
~RD5: J15.11, J25.52
~RD6_00: J21.5, J25.32
~RD6_01: J21.6, J25.30
~RD6_02: J21.7, J25.28
~RD6_03: J21.8, J25.26
~RD6_04: J21.9, J25.24
~RD6_05: J21.10, J25.22
~RD6_06: J21.11, J25.20
~RD6_07: J21.12, J25.18
~RD6_08: J21.13, J25.16
~RD6_09: J21.14, J25.14
~RD6_10: J21.15, J25.12
~RD6_11: J21.16, J25.10
~RD6_12: J21.17, J25.8
~RD6_13: J21.18, J25.6
~RD6_14: J21.19, J25.4
~RD6_15: J21.20, J25.2
~RD6: J15.10, J25.50
~RESET_CONTROL: J7.4, J15.25, U1.5
~RESET_STEP: J15.37, U1.4
~SP_DEC: J1.6, J3.5
~SP_INC: J1.8, J3.6
~SP_LOAD: J1.10, J3.7
~SP_OUT: J1.26, J3.8
~STACK_SEG_EN: J6.2, J18.3
~STACK_SEG_IN: J6.3, J18.10
~STACK_SEG_OUT: J6.1, J18.6
~WR0: J15.32, J18.21
~WR1: J15.31, J18.20
~WR2_12: J1.16, J14.14
~WR2_13: J1.18, J14.13
~WR2_14: J1.20, J14.12
~WR2_15: J1.22, J14.11
~WR2: J1.77, J15.30
~WR3: J1.79, J9.9, J15.29
~WR4_00: J21.21, J25.57
~WR4_01: J21.22, J25.59
~WR4_02: J21.23, J25.61
~WR4_03: J21.24, J25.63
~WR4: J15.28, J25.40
~WR5_00: J21.25, J25.31
~WR5_01: J21.26, J25.29
~WR5_02: J21.27, J25.27
~WR5_03: J21.28, J25.25
~WR5_04: J21.29, J25.23
~WR5_05: J21.30, J25.21
~WR5_06: J21.31, J25.19
~WR5_07: J21.32, J25.17
~WR5_08: J21.33, J25.15
~WR5_09: J21.34, J25.13
~WR5_10: J21.35, J25.11
~WR5_11: J21.36, J25.9
~WR5_12: J21.37, J25.7
~WR5_13: J21.38, J25.5
~WR5_14: J21.39, J25.3
~WR5_15: J21.40, J25.1
~WR5: J15.27, J25.38
μA7: J15.1, U1.3
μB7: J15.17, U1.1
μRD0: J1.55, J15.8, J18.30, J25.60
μRD1: J1.57, J15.7, J18.29, J25.58
μRD2: J1.59, J15.6, J18.28, J25.56
μRD3: J1.61, J15.5, J18.27, J25.54
μWR0: J1.63, J15.24, J18.26, J25.48
μWR1: J1.65, J15.23, J18.25, J25.46
μWR2: J1.67, J15.22, J18.24, J25.44
μWR3: J1.69, J15.21, J25.42

Notes on the sheet:
RESET BTN
MEM WR
Port EN Address
MEM RD
~{JCC_EN}
GPR WR
READ
~{PC_DEC}
GPR RD
C_B7
WRITE

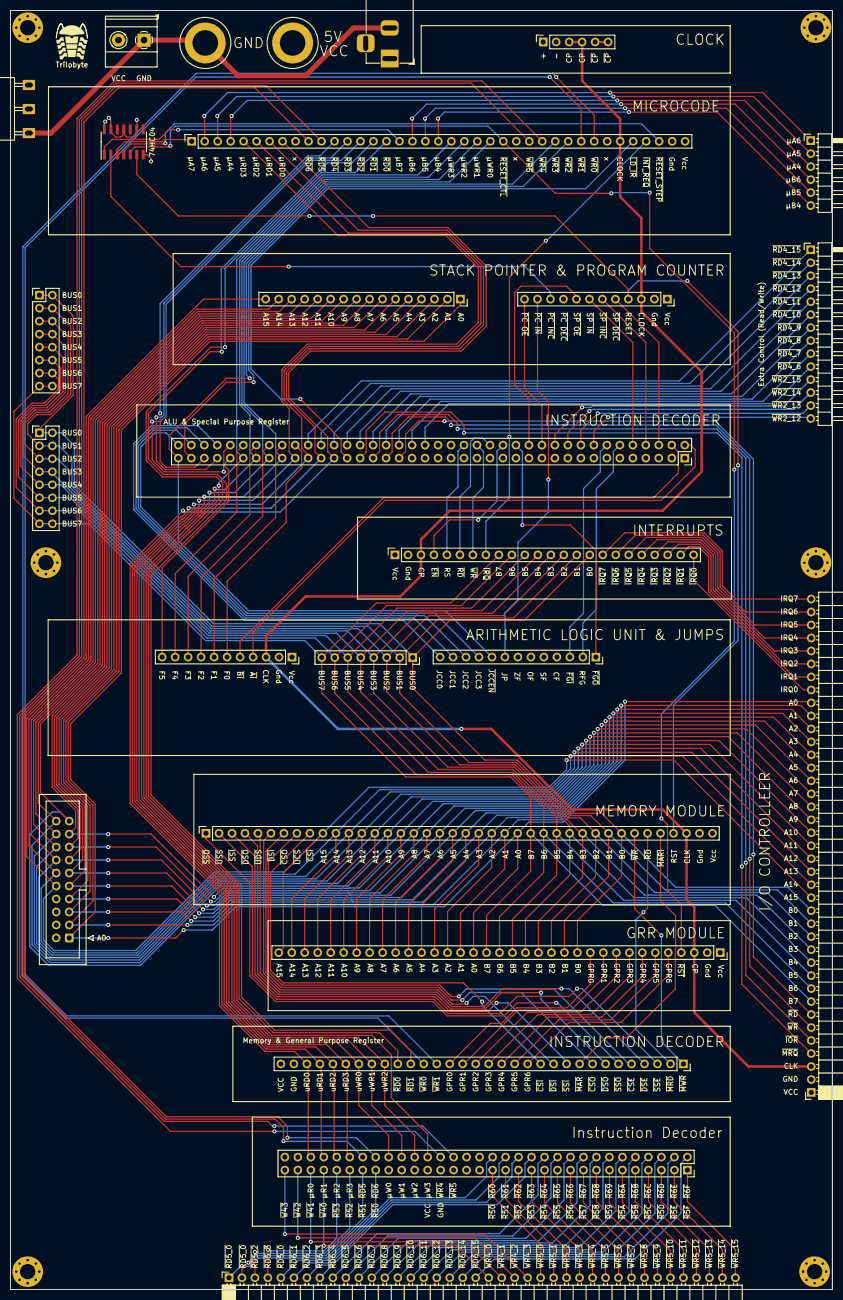
[picture p298: board Backplane-Concept-Vertical.kicad_pcb from above]

Board: 4 copper layers, 160.8 x 250.2 mm, 26 parts (0 on the bottom side), 174 nets.
