theWickedWebDev/8-bit-computer/PCBs/99_IN PROGRESS/IO-FIFO/GPR-RegisterArray/GPR-RegisterArray.kicad_pcb

## KiCad design PCBs/99_IN PROGRESS/IO-FIFO/GPR-RegisterArray/GPR-RegisterArray.kicad_pcb (2022-08-27)

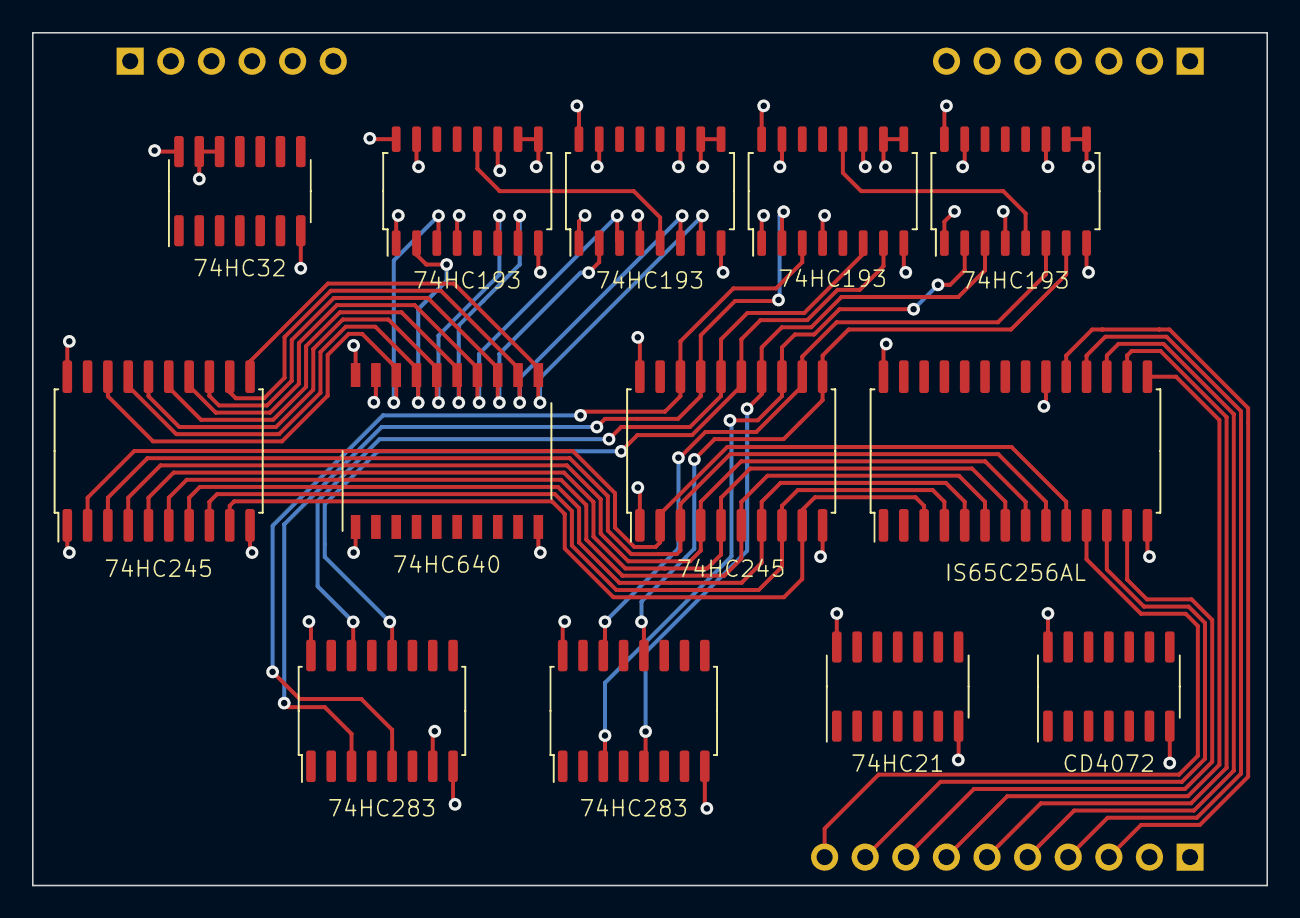
[picture p299: board GPR-RegisterArray.kicad_pcb from above]

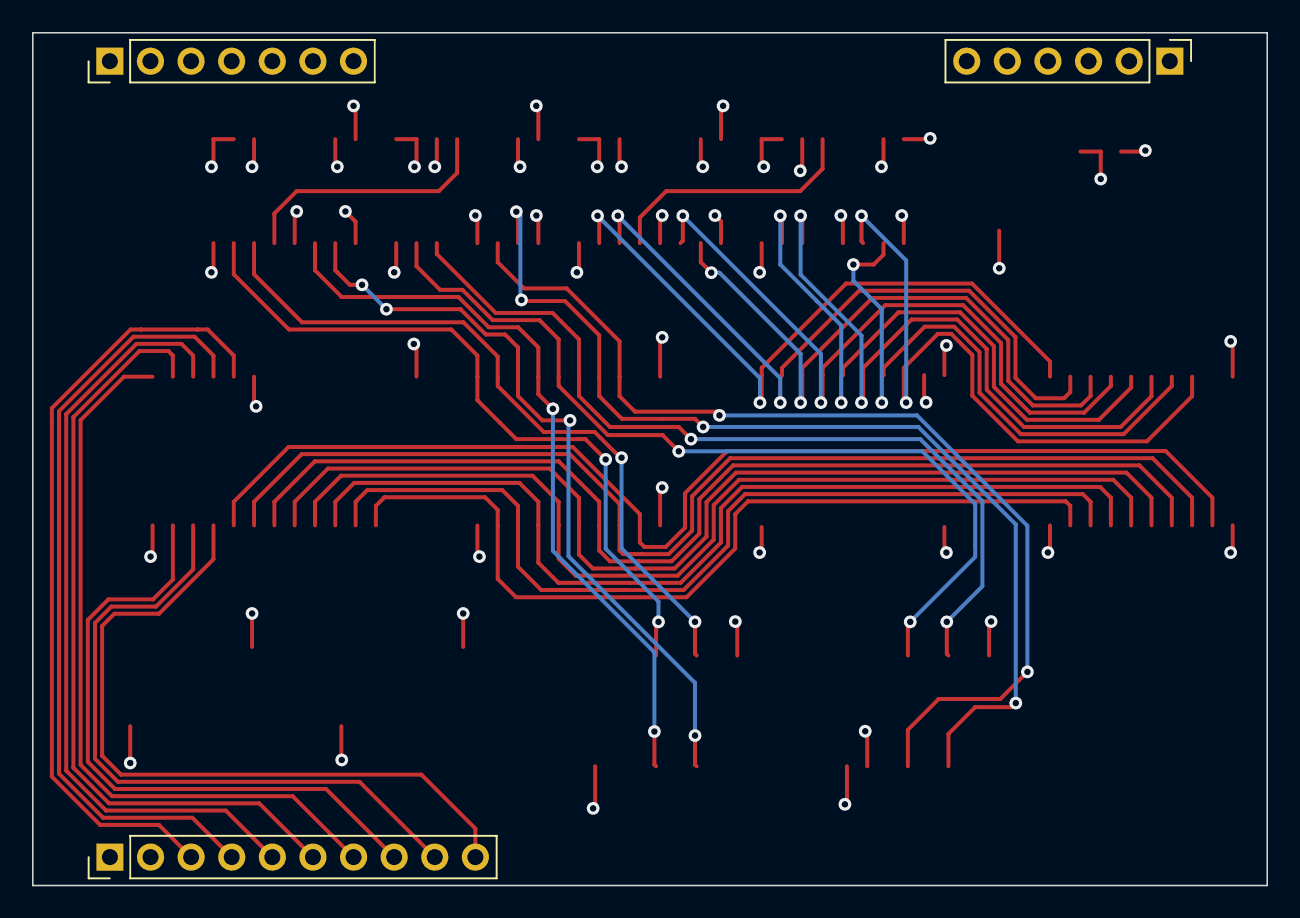
[picture p300: board GPR-RegisterArray.kicad_pcb from below]

Board: 4 copper layers, 77.2 x 53.3 mm, 16 parts (3 on the bottom side), 69 nets.

Parts:
J1: Conn_01x10; PinHeader_1x10_P2.54mm_Vertical
J2: Conn_01x06; PinHeader_1x06_P2.54mm_Vertical
J3: Conn_01x07; PinHeader_1x07_P2.54mm_Vertical
U1: 74HC32; SOIC-14_3.9x8.7mm_P1.27mm
U2: IS65C256AL; SOIC-28W_7.5x17.9mm_P1.27mm
U3: 74HC21; SOIC-14_3.9x8.7mm_P1.27mm
U4: CD4072; SOIC-14_3.9x8.7mm_P1.27mm
U7, U8, U10, U11: 74HC193; SOIC-16_4.55x10.3mm_P1.27mm
U9, U12: 74HC245; SOIC-20W_7.5x12.8mm_P1.27mm
U13: 74HC640; SO-20_12.8x7.5mm_P1.27mm
U14, U15: 74HC283; SO-16_5.3x10.2mm_P1.27mm

Connections:
/Subtractor/!B0: U13.2 (A0), U14.6 (B1)
/Subtractor/!B1: U13.3 (A1), U14.2 (B2)
/Subtractor/!B2: U13.4 (A2), U14.15 (B3)
/Subtractor/!B3: U13.5 (A3), U14.11 (B4)
/Subtractor/!B4: U13.6 (A4), U15.6 (B1)
/Subtractor/!B5: U13.7 (A5), U15.2 (B2)
/Subtractor/!B6: U13.8 (A6), U15.15 (B3)
/Subtractor/!B7: U13.9 (A7), U15.11 (B4)
/~READ_EN: U1.6, U2.22 (~OE), U7.5 (UP), U9.19 (CE)
/~WRITE_EN: U1.8, U2.27 (~WE), U10.5 (UP), U12.19 (CE)
A0: U2.10 (A0), U9.2 (A0), U12.2 (A0)
A1: U2.9 (A1), U9.3 (A1), U12.3 (A1)
A2: U2.8 (A2), U9.4 (A2), U12.4 (A2)
A3: U2.7 (A3), U9.5 (A3), U12.5 (A3)
A4: U2.6 (A4), U9.6 (A4), U12.6 (A4)
A5: U2.5 (A5), U9.7 (A5), U12.7 (A5)
A6: U2.4 (A6), U9.8 (A6), U12.8 (A6)
A7: U2.3 (A7), U9.9 (A7), U12.9 (A7)
BANK0: J3.1, U2.25 (A8)
BANK1: J3.2, U2.24 (A9)
BANK2: J3.3, U2.21 (A10)
BANK3: J3.4, U2.23 (A11)
BANK4: J3.5, U2.2 (A12)
BANK5: J3.6, U2.26 (A13)
BANK6: J3.7, U2.1 (A14)
BUS0: J1.10, U2.11 (D0)
BUS1: J1.9, U2.12 (D1)
BUS2: J1.8, U2.13 (D2)
BUS3: J1.7, U2.15 (D3)
BUS4: J1.6, U2.16 (D4)
BUS5: J1.5, U2.17 (D5)
BUS6: J1.4, U2.18 (D6)
BUS7: J1.3, U2.19 (D7)
CLEAR: J2.6, U7.14 (CLR), U8.14 (CLR), U10.14 (CLR), U11.14 (CLR)
COUNT0: U3.1, U4.2, U14.4 (S1)
COUNT1: U3.2, U4.3, U14.1 (S2)
COUNT2: U3.4, U4.4, U14.13 (S3)
COUNT3: U3.5, U4.5, U14.10 (S4)
COUNT4: U3.9, U4.9, U15.4 (S1)
COUNT5: U3.10, U4.10, U15.1 (S2)
COUNT6: U3.12, U4.11, U15.13 (S3)
COUNT7: U3.13, U4.12, U15.10 (S4)
GND: J1.2, U1.7 (GND), U1.12, U1.13, U2.14 (GND), U2.20 (~CS), U3.7 (GND), U4.7 (VSS), U7.1 (B), U7.8 (GND), U7.9 (D), U7.10 (C), U7.15 (A), U8.1 (B), U8.8 (GND), U8.9 (D), U8.10 (C), U8.15 (A), U9.1 (A->B), U9.10 (GND), U10.1 (B), U10.8 (GND), U10.9 (D), U10.10 (C), U10.15 (A), U11.1 (B), U11.8 (GND), U11.9 (D), U11.10 (C), U11.15 (A), U12.1 (A->B), U12.10 (GND), U13.1 (A->B), U13.10 (GND), U13.19 (CE), U14.8 (GND), U15.8 (GND)
unnamed: U1.1, U4.1
unnamed: U1.2, U4.13
unnamed: U7.12 (~CO), U8.5 (UP)
unnamed: U10.12 (~CO), U11.5 (UP)
unnamed: U14.9 (C4), U15.7 (C0)
READ0: U7.3 (QA), U9.18 (B0), U13.18 (B0)
READ1: U7.2 (QB), U9.17 (B1), U13.17 (B1)
READ2: U7.6 (QC), U9.16 (B2), U13.16 (B2)
READ3: U7.7 (QD), U9.15 (B3), U13.15 (B3)
READ4: U8.3 (QA), U9.14 (B4), U13.14 (B4)
READ5: U8.2 (QB), U9.13 (B5), U13.13 (B5)
READ6: U8.6 (QC), U9.12 (B6), U13.12 (B6)
READ7: U8.7 (QD), U9.11 (B7), U13.11 (B7)
VCC: J1.1, U1.14 (VCC), U2.28 (VCC), U3.14 (VCC), U4.14 (VDD), U7.4 (DOWN), U7.11 (~LOAD), U7.16 (VCC), U8.4 (DOWN), U8.11 (~LOAD), U8.16 (VCC), U9.20 (VCC), U10.4 (DOWN), U10.11 (~LOAD), U10.16 (VCC), U11.4 (DOWN), U11.11 (~LOAD), U11.16 (VCC), U12.20 (VCC), U13.20 (VCC), U14.7 (C0), U14.16 (VCC), U15.16 (VCC)
WRITE0: U10.3 (QA), U12.18 (B0), U14.5 (A1)
WRITE1: U10.2 (QB), U12.17 (B1), U14.3 (A2)
WRITE2: U10.6 (QC), U12.16 (B2), U14.14 (A3)
WRITE3: U10.7 (QD), U12.15 (B3), U14.12 (A4)
WRITE4: U11.3 (QA), U12.14 (B4), U15.5 (A1)
WRITE5: U11.2 (QB), U12.13 (B5), U15.3 (A2)
WRITE6: U11.6 (QC), U12.12 (B6), U15.14 (A3)
WRITE7: U11.7 (QD), U12.11 (B7), U15.12 (A4)
~NOT_FULL: J2.4, U1.10
~READ: J2.1, U1.4
~WRITE: J2.2, U1.9
~ZERO: J2.3, U1.3, U1.5
