theWickedWebDev/8-bit-computer/PCBs/99_IN PROGRESS/IO-Midi/audio.kicad_pcb

## KiCad design PCBs/99_IN PROGRESS/IO-Midi/audio.kicad_pcb (2022-06-18)

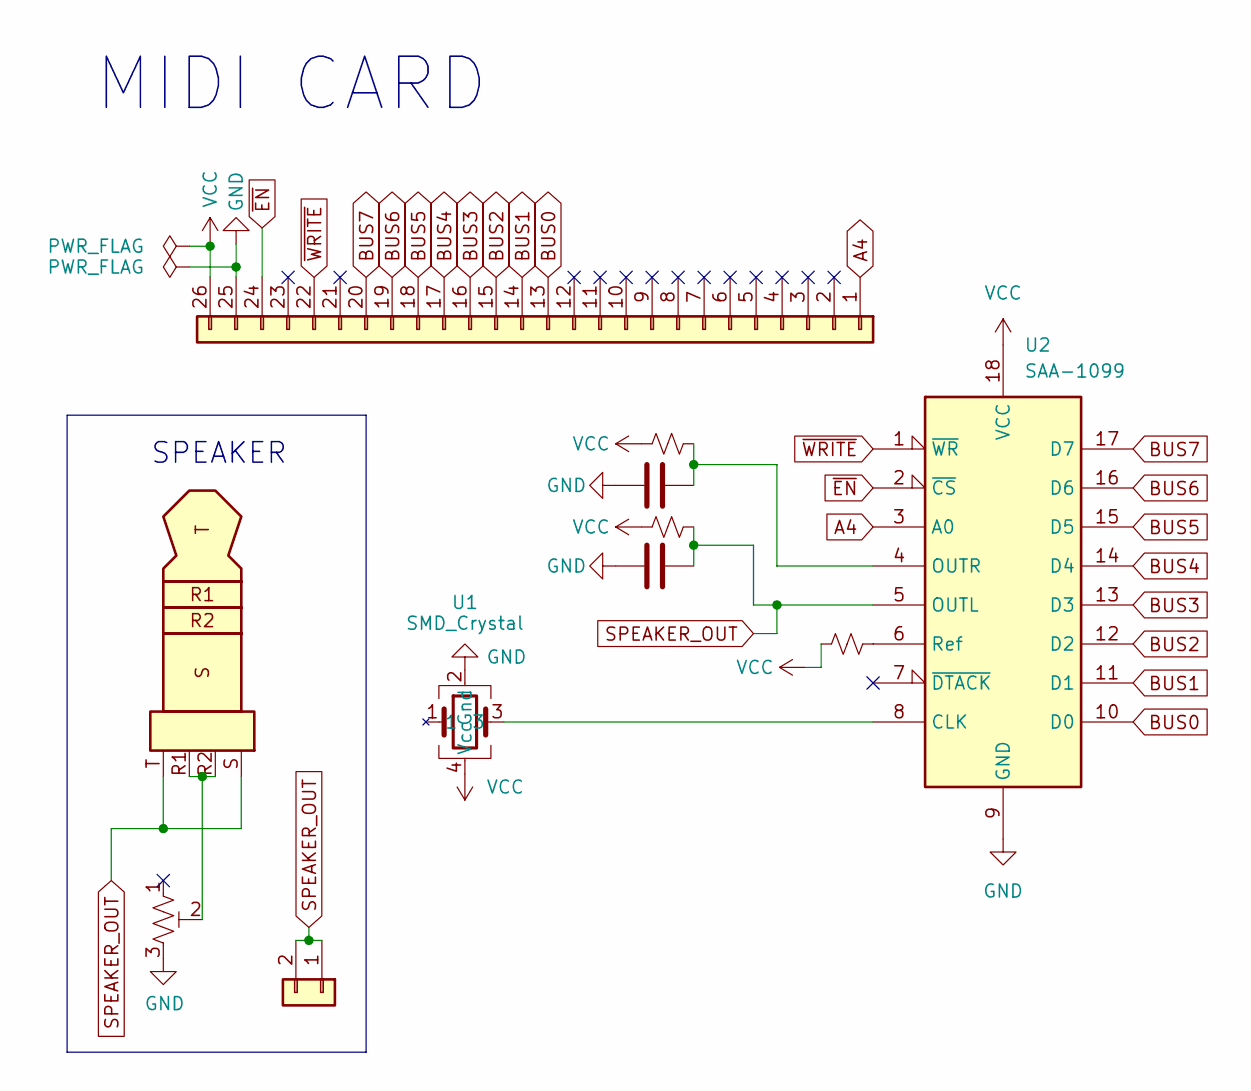
[picture p301: schematic audio.kicad_sch]

Parts:
C1, C2: C; C_0805_2012Metric
J1: Conn_01x02; PinHeader_1x02_P2.54mm_Horizontal
J2: Conn_01x26; PinHeader_1x26_P2.54mm_Horizontal
LS1: Speaker; speaker-jack
R1, R2, R3: R_Small_US; R_0805_2012Metric
RV1: R_POT_TRIM_US; Potentiometer_Bourns_3386F_Vertical
U1: SMD_Crystal; CFPS-72 SMD Clock
U2: SAA-1099; DIP-18_W7.62mm

Connections:
A4: J2.1, U2.3 (A0)
BUS0: J2.13, U2.10 (D0)
BUS1: J2.14, U2.11 (D1)
BUS2: J2.15, U2.12 (D2)
BUS3: J2.16, U2.13 (D3)
BUS4: J2.17, U2.14 (D4)
BUS5: J2.18, U2.15 (D5)
BUS6: J2.19, U2.16 (D6)
BUS7: J2.20, U2.17 (D7)
GND: C1.1, C2.1, J2.25, RV1.3, U1.2 (Gnd), U2.9 (GND)
unnamed: C1.2, R1.2, U2.4 (OUTR)
unnamed: LS1.R1, LS1.R2, RV1.2
unnamed: R3.2, U2.6 (Ref)
unnamed: U1.3, U2.8 (CLK)
SPEAKER_OUT: C2.2, J1.1, J1.2, LS1.S, LS1.T, R2.2, U2.5 (OUTL)
VCC: J2.26, R1.1, R2.1, R3.1, U1.4 (Vcc), U2.18 (VCC)
~EN: J2.24, U2.2 (~CS)
~WRITE: J2.22, U2.1 (~WR)

Notes on the sheet:
MIDI CARD
SPEAKER

Board: 2 copper layers, 11 parts (0 on the bottom side), 18 nets, no tracks yet.
