theWickedWebDev/8-bit-computer/PCBs/99_IN PROGRESS/Displacement/SPR-Displacement-Backplane/Backplane-DislacementRegister.kicad_pcb

## KiCad design PCBs/99_IN PROGRESS/Displacement/SPR-Displacement-Backplane/Backplane-DislacementRegister.kicad_pcb (2022-06-18)

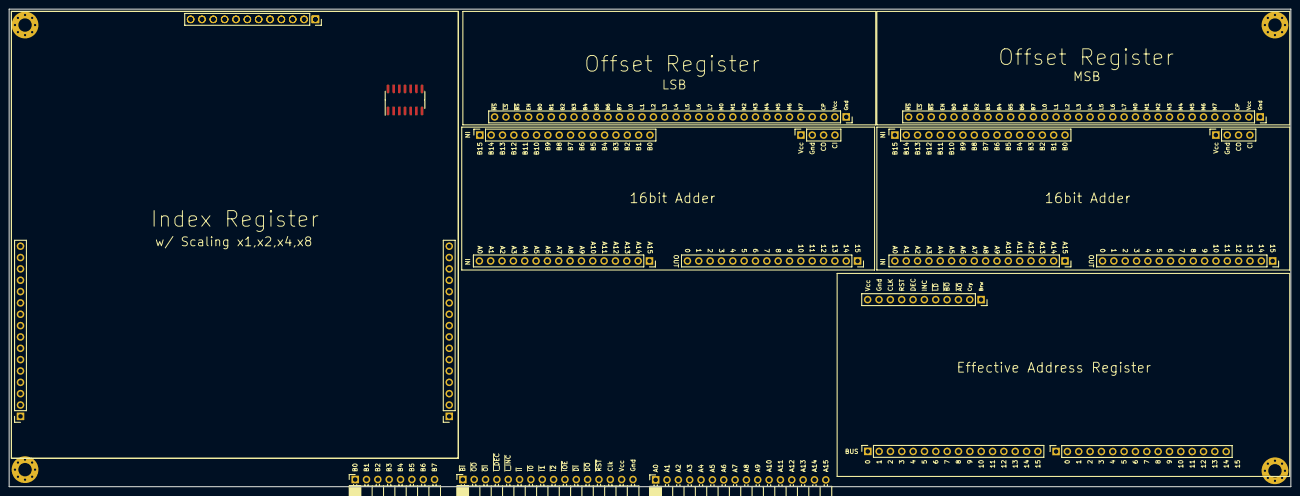
[picture p302: board Backplane-DislacementRegister.kicad_pcb from above]

Board: 2 copper layers, 287.0 x 106.9 mm, 21 parts (1 on the bottom side), 105 nets, no tracks yet.

Parts:
J1, J4, J5, J6, J7, J8, J9, J11, J12, J16: Conn_01x16; PinSocket_1x16_P2.54mm_Vertical
J1#2: Conn_01x12; PinHeader_1x12_P2.54mm_Vertical
J2, J3: Conn_01x16; PinSocket_1x16_P2.54mm_Horizontal
J10: Conn_01x08; PinSocket_1x08_P2.54mm_Horizontal
J13, J14: Conn_01x32; PinSocket_1x32_P2.54mm_Vertical
J15: Conn_01x12; PinSocket_1x12_P2.54mm_Vertical
J17: Conn_01x11; PinSocket_1x11_P2.54mm_Vertical
J18, J19: Conn_01x06; PinSocket_1x04_P2.54mm_Vertical
U1: 74LS04; SOIC-14_3.9x8.7mm_P1.27mm

Connections:
/ADD0: J5.16, J6.16
/ADD1: J5.15, J6.15
/ADD2: J5.14, J6.14
/ADD2_0: J11.16, J12.1
/ADD2_1: J11.15, J12.2
/ADD2_2: J11.14, J12.3
/ADD2_3: J11.13, J12.4
/ADD2_4: J11.12, J12.5
/ADD2_5: J11.11, J12.6
/ADD2_6: J11.10, J12.7
/ADD2_7: J11.9, J12.8
/ADD2_8: J11.8, J12.9
/ADD2_9: J11.7, J12.10
/ADD2_10: J11.6, J12.11
/ADD2_11: J11.5, J12.12
/ADD2_12: J11.4, J12.13
/ADD2_13: J11.3, J12.14
/ADD2_14: J11.2, J12.15
/ADD2_15: J11.1, J12.16
/ADD3: J5.13, J6.13
/ADD4: J5.12, J6.12
/ADD5: J5.11, J6.11
/ADD6: J5.10, J6.10
/ADD7: J5.9, J6.9
/ADD8: J5.8, J6.8
/ADD9: J5.7, J6.7
/ADD10: J5.6, J6.6
/ADD11: J5.5, J6.5
/ADD12: J5.4, J6.4
/ADD13: J5.3, J6.3
/ADD14: J5.2, J6.2
/ADD15: J5.1, J6.1
/B0: J7.16, J9.16
/B1: J7.15, J9.15
/B2: J7.14, J9.14
/B3: J7.13, J9.13
/B4: J7.12, J9.12
/B5: J7.11, J9.11
/B6: J7.10, J9.10
/B7: J7.9, J9.9
/B8: J7.8, J9.8
/B9: J7.7, J9.7
/B10: J7.6, J9.6
/B11: J7.5, J9.5
/B12: J7.4, J9.4
/B13: J7.3, J9.3
/B14: J7.2, J9.2
/B15: J7.1, J9.1
/BUS1: J10.2, J13.27
/BUS2: J10.3, J13.26
/BUS6: J10.7, J13.22
/C0: J13.20, J16.16
/C1: J13.19, J16.15
/C2: J13.18, J16.14
/C3: J13.17, J16.13
/C4: J13.16, J16.12
/C5: J13.15, J16.11
/C6: J13.14, J16.10
/C7: J13.13, J16.9
/C8: J14.12, J16.8
/C9: J14.11, J16.7
/C10: J14.10, J16.6
/C11: J14.9, J16.5
/C12: J14.8, J16.4
/C13: J14.7, J16.3
/C14: J14.6, J16.2
/C15: J14.5, J16.1
A0: J1.16, J2.1, J4.16, J8.1
A1: J1.15, J2.2, J4.15, J8.2
A2: J1.14, J2.3, J4.14, J8.3
A3: J1.13, J2.4, J4.13, J8.4
A4: J1.12, J2.5, J4.12, J8.5
A5: J1.11, J2.6, J4.11, J8.6
A6: J1.10, J2.7, J4.10, J8.7
A7: J1.9, J2.8, J4.9, J8.8
A8: J1.8, J2.9, J4.8, J8.9
A9: J1.7, J2.10, J4.7, J8.10
A10: J1.6, J2.11, J4.6, J8.11
A11: J1.5, J2.12, J4.5, J8.12
A12: J1.4, J2.13, J4.4, J8.13
A13: J1.3, J2.14, J4.3, J8.14
A14: J1.2, J2.15, J4.2, J8.15
A15: J1.1, J2.16, J4.1, J8.16
BUS7: J10.8, J13.21, J14.21, J14.22, J14.23, J14.24, J14.25, J14.26, J14.27, J14.28
CLOCK: J3.14, J13.3, J14.3, J17.9
GND: J1#2.2, J3.16, J13.1, J14.1, J15.2, J17.10, J18.2, J19.2, U1.5, U1.7 (GND), U1.9, U1.11, U1.13
unnamed: J10.1, J13.28
unnamed: J10.4, J13.25
unnamed: J10.5, J13.24
unnamed: J10.6, J13.23
unnamed: J15.3, U1.4
OFFSET_LATCH: J13.29, J14.29, U1.2
VCC: J1#2.1, J3.15, J13.2, J14.2, J15.1, J17.11, J18.1, J19.1, U1.14 (VCC)
~DISPLACEMENT_LATCH: J3.11, J17.5
~DISPLACEMENT_OUT: J3.12, J17.3
~INDEX_C0: J1#2.7, J3.7, J15.7
~INDEX_C1: J1#2.8, J3.8, J15.8
~INDEX_C2: J1#2.9, J3.9, J15.9
~INDEX_DEC: J1#2.4, J3.4, J15.4
~INDEX_INC: J1#2.5, J3.5, J15.5
~INDEX_LOAD: J1#2.6, J3.6, J15.6
~INDEX_OE: J1#2.10, J3.10, J15.10
~OFFSET_LATCH: J3.3, U1.1
~OFFSET_OUT: J3.2, J13.31, J14.32
~RESET: J3.13, J17.8, U1.3
