theWickedWebDev/8-bit-computer/PCBs/99_IN PROGRESS/ADC-3-bit/ADC-3-bit.kicad_pcb

## KiCad design PCBs/99_IN PROGRESS/ADC-3-bit/ADC-3-bit.kicad_pcb (2022-04-04)

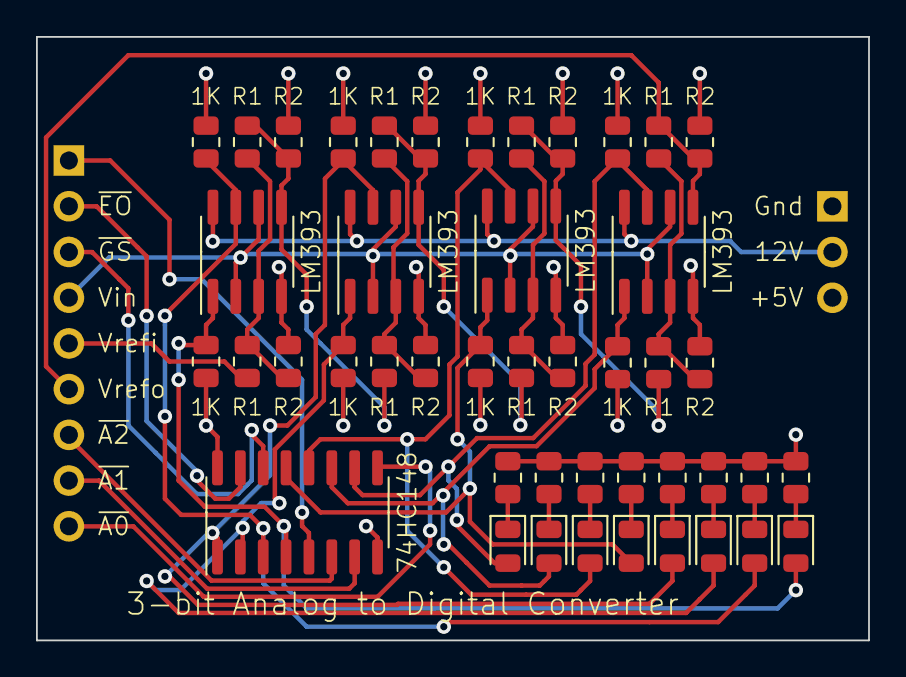
[picture p303: board ADC-3-bit.kicad_pcb from above]

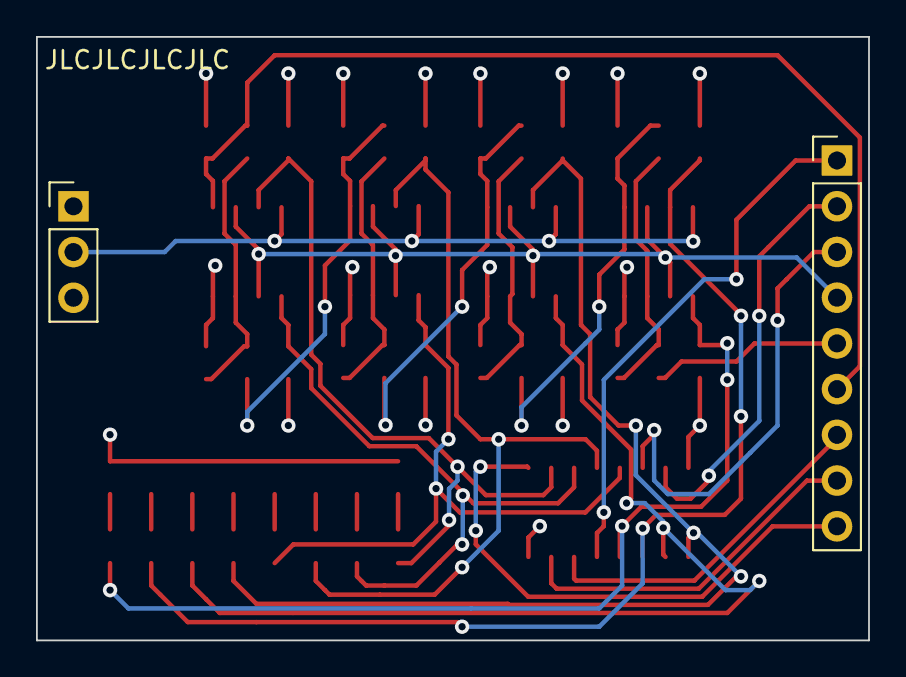
[picture p304: board ADC-3-bit.kicad_pcb from below]

Board: 4 copper layers, 46.2 x 33.5 mm, 47 parts (2 on the bottom side), 35 nets.

Parts:
D1, D2, D3, D4, D5, D6, D7, D8: LED; LED_0805_2012Metric
J1: Conn_01x03; PinHeader_1x03_P2.54mm_Vertical
J2: Conn_01x09; PinHeader_1x09_P2.54mm_Vertical
R1, R2, R3, R4, R5, R6, R7, R8, R9, R10, R11, R12, R13, R14, R15, R16, R17, R18, R19, R20, R21, R22, R23, R24, R25, R26, R27, R28, R29, R30, R31, R32: R_Small_US; R_0805_2012Metric
U1, U2, U3, U4: LM393; SOIC-8_3.9x4.9mm_P1.27mm
U5: 74LS148; SOIC-16_3.9x9.9mm_P1.27mm

Connections:
+5V: J1.3, R6.2, R7.2, R19.2, R20.2, R25.2, R26.2, R31.2, R32.2, U5.16 (VCC)
+12V: J1.2, U1.8 (V+), U2.8 (V+), U3.8 (V+), U4.8 (V+)
GND: J1.1, R1.1, R2.1, R5.2, R8.2, R9.2, R10.2, R11.2, R12.2, R13.2, R14.2, R15.1, R16.1, R21.1, R22.1, R27.1, R28.1, U1.4 (V-), U2.4 (V-), U3.4 (V-), U4.4 (V-), U5.8 (GND)
unnamed: D1.1 (K), R5.1
unnamed: D2.1 (K), R8.1
unnamed: D3.1 (K), R9.1
unnamed: D4.1 (K), R10.1
unnamed: D5.1 (K), R11.1
unnamed: D6.1 (K), R12.1
unnamed: D7.1 (K), R13.1
unnamed: D8.1 (K), R14.1
unnamed: R1.2, R3.2, R4.1, U1.3 (+)
unnamed: R15.2, R17.2, R18.1, U2.3 (+)
unnamed: R16.2, R18.2, R23.1, U2.5 (+)
unnamed: R2.2, R4.2, R17.1, U1.5 (+)
unnamed: R21.2, R23.2, R24.1, U3.3 (+)
unnamed: R22.2, R24.2, R29.1, U3.5 (+)
unnamed: R27.2, R29.2, R30.1, U4.3 (+)
Q0: D8.2 (A), R6.1, U1.1, U5.4 (I7)
Q1: D7.2 (A), R7.1, U1.7, U5.3 (I6)
Q2: D6.2 (A), R19.1, U2.1, U5.2 (I5)
Q3: D5.2 (A), R20.1, U2.7, U5.1 (I4)
Q4: D4.2 (A), R25.1, U3.1, U5.13 (I3)
Q5: D3.2 (A), R26.1, U3.7, U5.12 (I2)
Q6: D2.2 (A), R31.1, U4.1, U5.11 (I1)
Q7: D1.2 (A), R32.1, U4.7, U5.10 (IO)
Vin: J2.4, U1.2 (-), U1.6 (_), U2.2 (-), U2.6 (_), U3.2 (-), U3.6 (_), U4.2 (-), U4.6 (_)
Vrefi: J2.5, R3.1
Vrefo: J2.6, R28.2, R30.2, U4.5 (+)
~A0: J2.9, U5.9 (S0)
~A1: J2.8, U5.7 (S1)
~A2: J2.7, U5.6 (S2)
~EI: J2.1, U5.5 (EI)
~EO: J2.2, U5.15 (EO)
~GS: J2.3, U5.14 (GS)
