theWickedWebDev/8-bit-computer/PCBs/999-QUEUED-TO-PRINT/Backplane-Interrupt-Handler/Backplane-Interrupt-Handler.kicad_pcb

## KiCad design PCBs/999-QUEUED-TO-PRINT/Backplane-Interrupt-Handler/Backplane-Interrupt-Handler.kicad_pcb (2022-11-09)

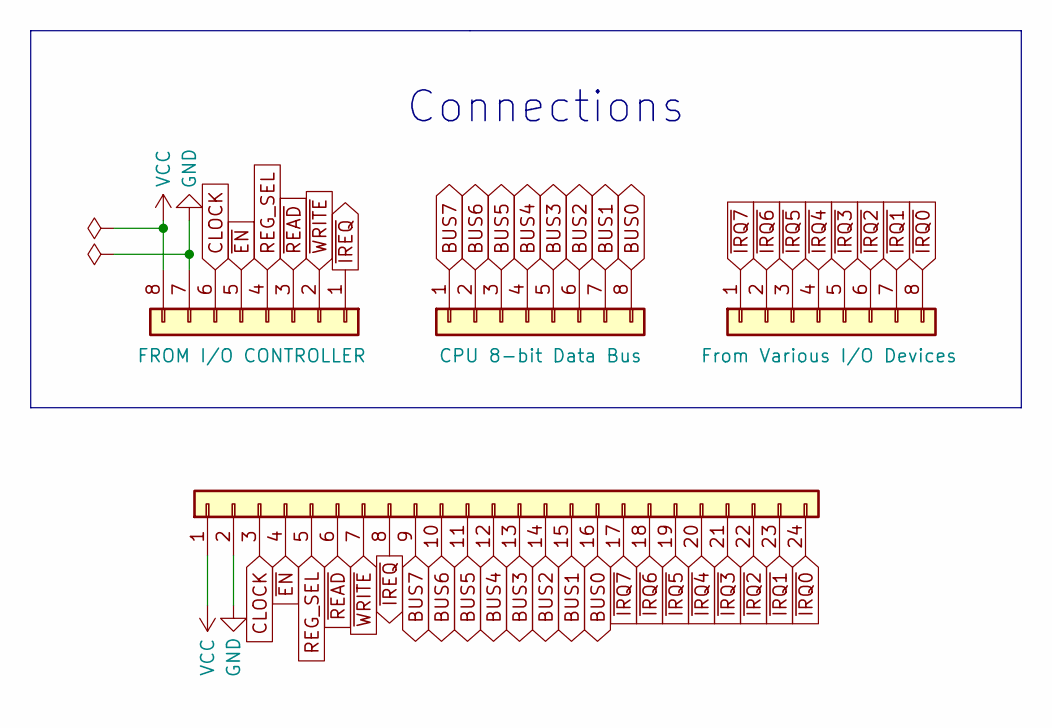
[picture p305: schematic Backplane-Interrupt-Handler.kicad_sch]

Parts:
J1, J3, J4: Conn_01x08; PinSocket_1x08_P2.54mm_Vertical
J2: Conn_01x24; PinSocket_1x24_P2.54mm_Horizontal

Connections:
BUS0: J2.16, J3.8
BUS1: J2.15, J3.7
BUS2: J2.14, J3.6
BUS3: J2.13, J3.5
BUS4: J2.12, J3.4
BUS5: J2.11, J3.3
BUS6: J2.10, J3.2
BUS7: J2.9, J3.1
CLOCK: J1.6, J2.3
GND: J1.7, J2.2
REG_SEL: J1.4, J2.5
VCC: J1.8, J2.1
~EN: J1.5, J2.4
~IREQ: J1.1, J2.8
~IRQ0: J2.24, J4.8
~IRQ1: J2.23, J4.7
~IRQ2: J2.22, J4.6
~IRQ3: J2.21, J4.5
~IRQ4: J2.20, J4.4
~IRQ5: J2.19, J4.3
~IRQ6: J2.18, J4.2
~IRQ7: J2.17, J4.1
~READ: J1.3, J2.6
~WRITE: J1.2, J2.7

Notes on the sheet:
Connections

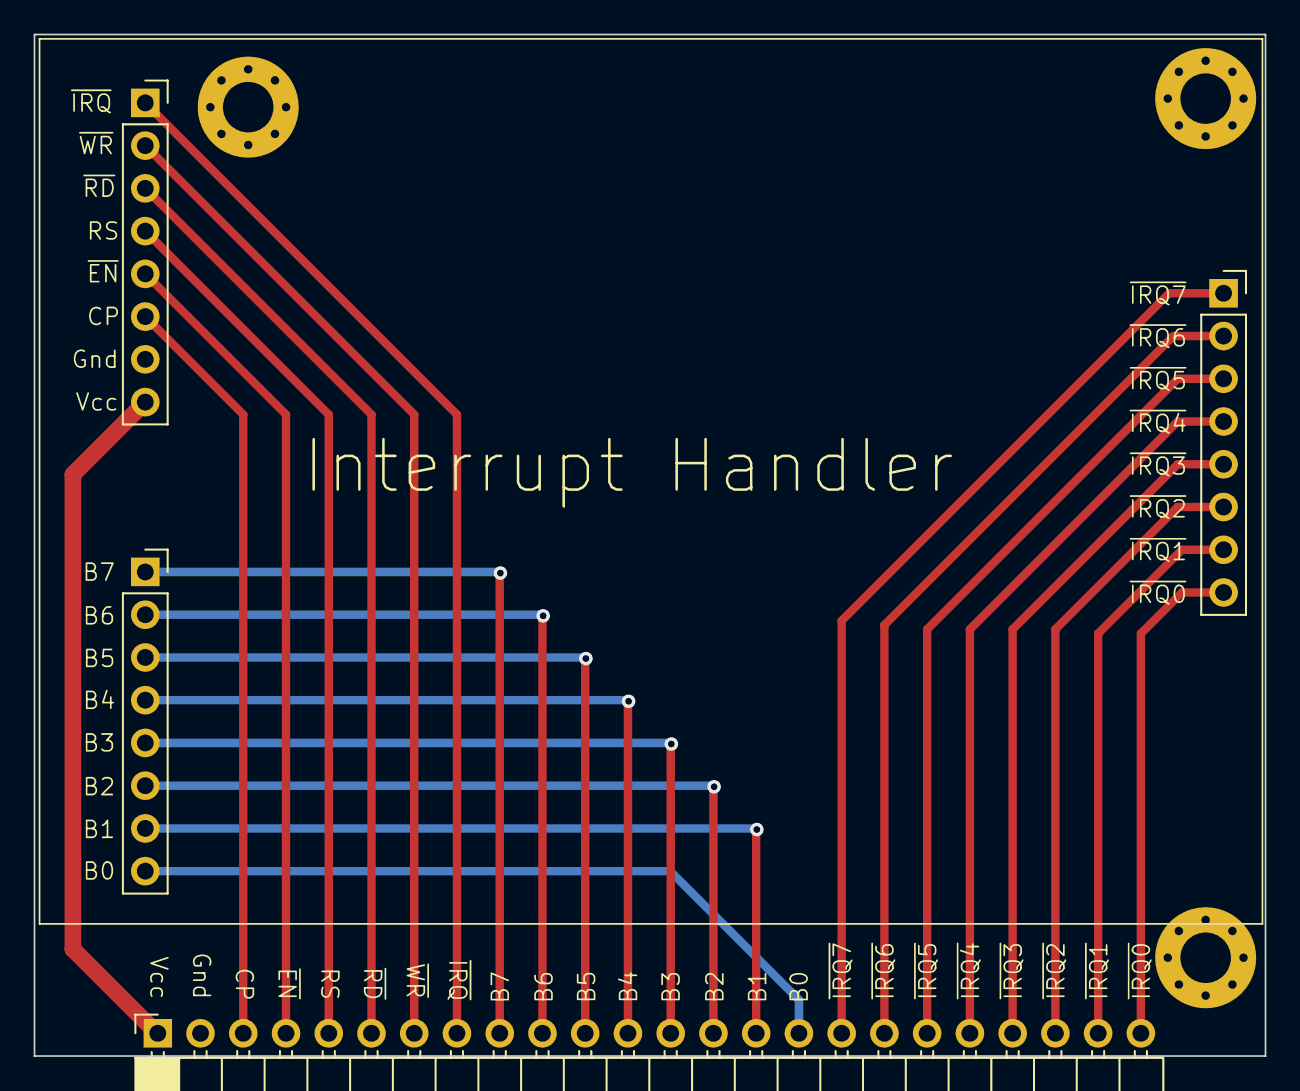
[picture p306: board Backplane-Interrupt-Handler.kicad_pcb from above]

Board: 2 copper layers, 73.2 x 60.7 mm, 4 parts (0 on the bottom side), 24 nets.
