theWickedWebDev/8-bit-computer/PCBs/99_IN PROGRESS/Displacement/SPR-Displacement-IndexRegister-with-Scaling/IndexRegister-with-Scaling.kicad_pcb

## KiCad design PCBs/99_IN PROGRESS/Displacement/SPR-Displacement-IndexRegister-with-Scaling/IndexRegister-with-Scaling.kicad_pcb (2022-06-18)

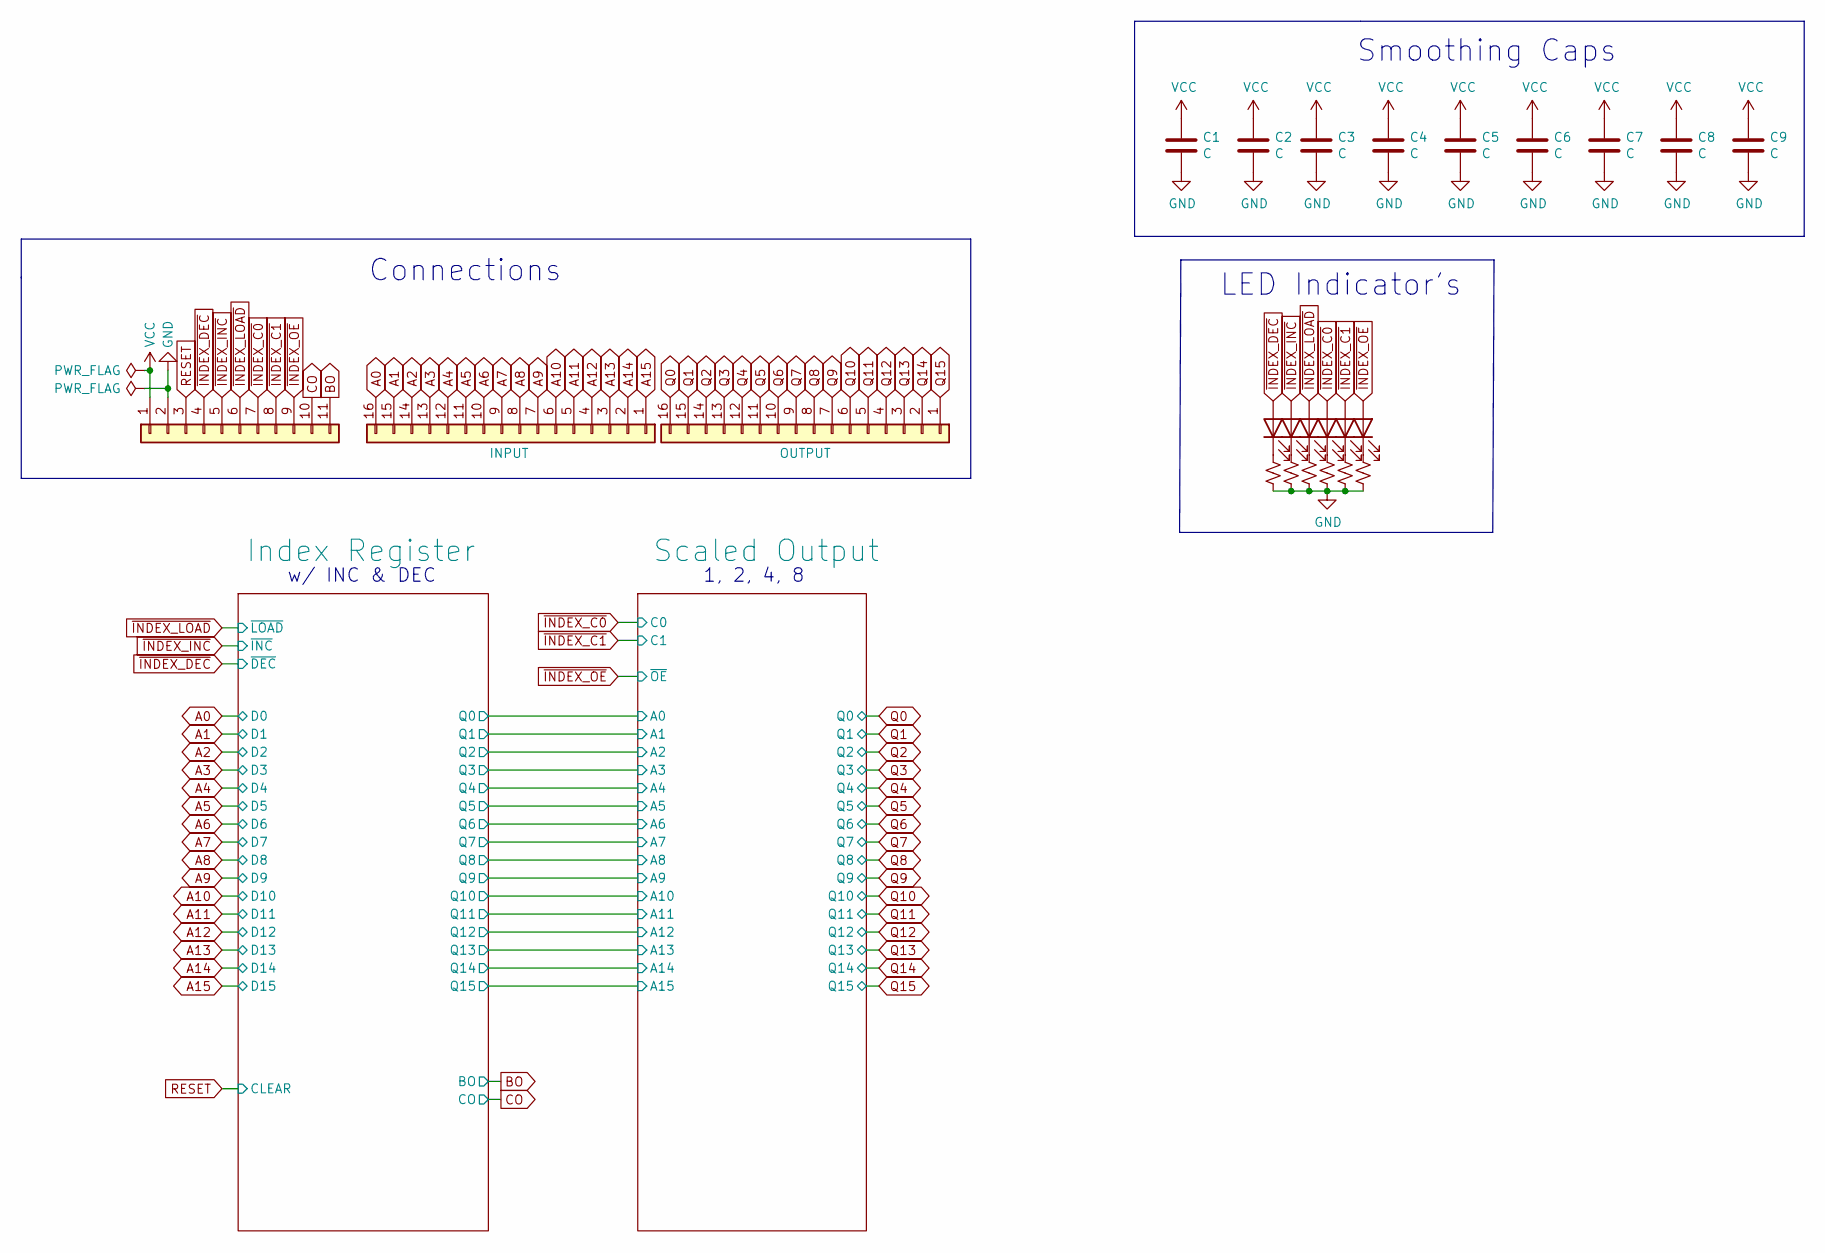
[picture p307: schematic IndexRegister-with-Scaling.kicad_sch]

Parts:
C1, C2, C3, C4, C5, C6, C7, C8, C9: C; C_0805_2012Metric
D1, D2, D3, D4, D5, D7: LED; LED_1206_3216Metric
J1: Conn_01x11; PinHeader_1x11_P2.54mm_Vertical
J2, J3: Conn_01x16; PinHeader_1x16_P2.54mm_Vertical
R1, R2, R3, R4, R5, R7: R_Small_US; R_0805_2012Metric

Connections:
A0: J2.16; also elsewhere on the board
A1: J2.15; also elsewhere on the board
A2: J2.14; also elsewhere on the board
A3: J2.13; also elsewhere on the board
A4: J2.12; also elsewhere on the board
A5: J2.11; also elsewhere on the board
A6: J2.10; also elsewhere on the board
A7: J2.9; also elsewhere on the board
A8: J2.8; also elsewhere on the board
A9: J2.7; also elsewhere on the board
A10: J2.6; also elsewhere on the board
A11: J2.5; also elsewhere on the board
A12: J2.4; also elsewhere on the board
A13: J2.3; also elsewhere on the board
A14: J2.2; also elsewhere on the board
A15: J2.1; also elsewhere on the board
BO: J1.11; also elsewhere on the board
CO: J1.10; also elsewhere on the board
GND: C1.2, C2.2, C3.2, C4.2, C5.2, C6.2, C7.2, C8.2, C9.2, J1.2, R1.2, R2.2, R3.2, R4.2, R5.2, R7.2; also elsewhere on the board
unnamed: D1.1 (K), R1.1
unnamed: D2.1 (K), R2.1
unnamed: D3.1 (K), R3.1
unnamed: D4.1 (K), R4.1
unnamed: D5.1 (K), R5.1
unnamed: D7.1 (K), R7.1
Q0: J3.16; also elsewhere on the board
Q1: J3.15; also elsewhere on the board
Q2: J3.14; also elsewhere on the board
Q3: J3.13; also elsewhere on the board
Q4: J3.12; also elsewhere on the board
Q5: J3.11; also elsewhere on the board
Q6: J3.10; also elsewhere on the board
Q7: J3.9; also elsewhere on the board
Q8: J3.8; also elsewhere on the board
Q9: J3.7; also elsewhere on the board
Q10: J3.6; also elsewhere on the board
Q11: J3.5; also elsewhere on the board
Q12: J3.4; also elsewhere on the board
Q13: J3.3; also elsewhere on the board
Q14: J3.2; also elsewhere on the board
Q15: J3.1; also elsewhere on the board
RESET: J1.3; also elsewhere on the board
VCC: C1.1, C2.1, C3.1, C4.1, C5.1, C6.1, C7.1, C8.1, C9.1, J1.1; also elsewhere on the board
~INDEX_C0: D4.2 (A), J1.7; also elsewhere on the board
~INDEX_C1: D5.2 (A), J1.8; also elsewhere on the board
~INDEX_DEC: D1.2 (A), J1.4; also elsewhere on the board
~INDEX_INC: D2.2 (A), J1.5; also elsewhere on the board
~INDEX_LOAD: D3.2 (A), J1.6; also elsewhere on the board
~INDEX_OE: D7.2 (A), J1.9; also elsewhere on the board

Notes on the sheet:
1, 2, 4, 8
Connections
w/ INC & DEC
LED Indicator's
Smoothing Caps

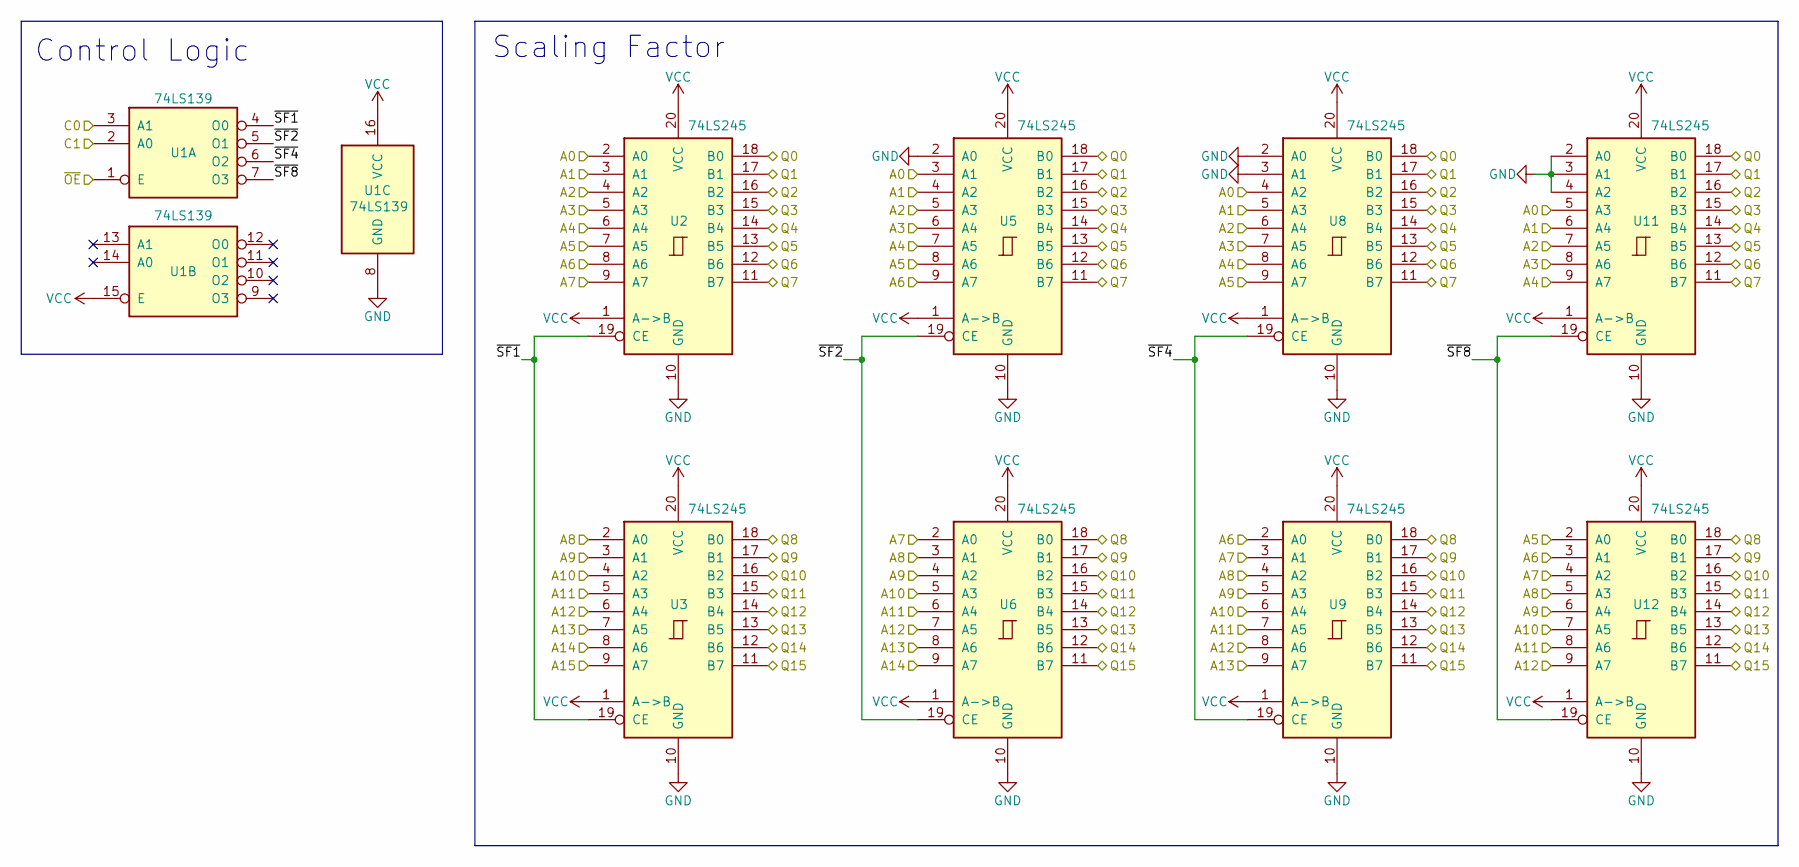
[picture p308: schematic scale-factor.kicad_sch]

Parts:
U1: 74LS139; SO-16_3.9x9.9mm_P1.27mm
U2, U3, U5, U6, U8, U9, U11, U12: 74LS245; SO-20_5.3x12.6mm_P1.27mm

Connections:
/Index Register/Q0: U2.2 (A0), U5.3 (A1), U8.4 (A2), U11.5 (A3); also elsewhere on the board
/Index Register/Q1: U2.3 (A1), U5.4 (A2), U8.5 (A3), U11.6 (A4); also elsewhere on the board
/Index Register/Q2: U2.4 (A2), U5.5 (A3), U8.6 (A4), U11.7 (A5); also elsewhere on the board
/Index Register/Q3: U2.5 (A3), U5.6 (A4), U8.7 (A5), U11.8 (A6); also elsewhere on the board
/Index Register/Q4: U2.6 (A4), U5.7 (A5), U8.8 (A6), U11.9 (A7); also elsewhere on the board
/Index Register/Q5: U2.7 (A5), U5.8 (A6), U8.9 (A7), U12.2 (A0); also elsewhere on the board
/Index Register/Q6: U2.8 (A6), U5.9 (A7), U9.2 (A0), U12.3 (A1); also elsewhere on the board
/Index Register/Q7: U2.9 (A7), U6.2 (A0), U9.3 (A1), U12.4 (A2); also elsewhere on the board
/Index Register/Q8: U3.2 (A0), U6.3 (A1), U9.4 (A2), U12.5 (A3); also elsewhere on the board
/Index Register/Q9: U3.3 (A1), U6.4 (A2), U9.5 (A3), U12.6 (A4); also elsewhere on the board
/Index Register/Q10: U3.4 (A2), U6.5 (A3), U9.6 (A4), U12.7 (A5); also elsewhere on the board
/Index Register/Q11: U3.5 (A3), U6.6 (A4), U9.7 (A5), U12.8 (A6); also elsewhere on the board
/Index Register/Q12: U3.6 (A4), U6.7 (A5), U9.8 (A6), U12.9 (A7); also elsewhere on the board
/Index Register/Q13: U3.7 (A5), U6.8 (A6), U9.9 (A7); also elsewhere on the board
/Index Register/Q14: U3.8 (A6), U6.9 (A7); also elsewhere on the board
/Index Register/Q15: U3.9 (A7); also elsewhere on the board
/Scaled Output/~SF1: U1.4 (O0), U2.19 (CE), U3.19 (CE)
/Scaled Output/~SF2: U1.5 (O1), U5.19 (CE), U6.19 (CE)
/Scaled Output/~SF4: U1.6 (O2), U8.19 (CE), U9.19 (CE)
/Scaled Output/~SF8: U1.7 (O3), U11.19 (CE), U12.19 (CE)
GND: U1.8 (GND), U2.10 (GND), U3.10 (GND), U5.2 (A0), U5.10 (GND), U6.10 (GND), U8.2 (A0), U8.3 (A1), U8.10 (GND), U9.10 (GND), U11.2 (A0), U11.3 (A1), U11.4 (A2), U11.10 (GND), U12.10 (GND); also elsewhere on the board
Q0: U2.18 (B0), U5.18 (B0), U8.18 (B0), U11.18 (B0); also elsewhere on the board
Q1: U2.17 (B1), U5.17 (B1), U8.17 (B1), U11.17 (B1); also elsewhere on the board
Q2: U2.16 (B2), U5.16 (B2), U8.16 (B2), U11.16 (B2); also elsewhere on the board
Q3: U2.15 (B3), U5.15 (B3), U8.15 (B3), U11.15 (B3); also elsewhere on the board
Q4: U2.14 (B4), U5.14 (B4), U8.14 (B4), U11.14 (B4); also elsewhere on the board
Q5: U2.13 (B5), U5.13 (B5), U8.13 (B5), U11.13 (B5); also elsewhere on the board
Q6: U2.12 (B6), U5.12 (B6), U8.12 (B6), U11.12 (B6); also elsewhere on the board
Q7: U2.11 (B7), U5.11 (B7), U8.11 (B7), U11.11 (B7); also elsewhere on the board
Q8: U3.18 (B0), U6.18 (B0), U9.18 (B0), U12.18 (B0); also elsewhere on the board
Q9: U3.17 (B1), U6.17 (B1), U9.17 (B1), U12.17 (B1); also elsewhere on the board
Q10: U3.16 (B2), U6.16 (B2), U9.16 (B2), U12.16 (B2); also elsewhere on the board
Q11: U3.15 (B3), U6.15 (B3), U9.15 (B3), U12.15 (B3); also elsewhere on the board
Q12: U3.14 (B4), U6.14 (B4), U9.14 (B4), U12.14 (B4); also elsewhere on the board
Q13: U3.13 (B5), U6.13 (B5), U9.13 (B5), U12.13 (B5); also elsewhere on the board
Q14: U3.12 (B6), U6.12 (B6), U9.12 (B6), U12.12 (B6); also elsewhere on the board
Q15: U3.11 (B7), U6.11 (B7), U9.11 (B7), U12.11 (B7); also elsewhere on the board
VCC: U1.15 (E), U1.16 (VCC), U2.1 (A->B), U2.20 (VCC), U3.1 (A->B), U3.20 (VCC), U5.1 (A->B), U5.20 (VCC), U6.1 (A->B), U6.20 (VCC), U8.1 (A->B), U8.20 (VCC), U9.1 (A->B), U9.20 (VCC), U11.1 (A->B), U11.20 (VCC), U12.1 (A->B), U12.20 (VCC); also elsewhere on the board
~INDEX_C0: U1.3 (A1); also elsewhere on the board
~INDEX_C1: U1.2 (A0); also elsewhere on the board
~INDEX_OE: U1.1 (E); also elsewhere on the board

Notes on the sheet:
Scaling Factor
Control Logic

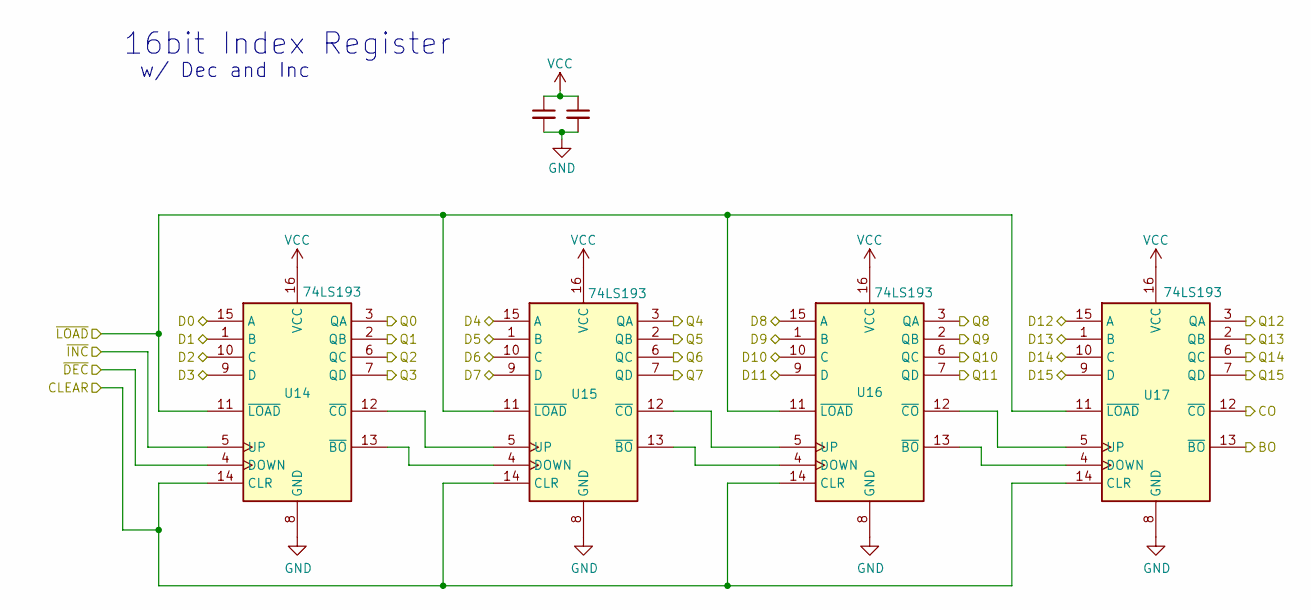
[picture p309: schematic index-register.kicad_sch]

Parts:
C14, C15: C_Small; C_0805_2012Metric
U14, U15, U16, U17: 74LS193; SO-16_5.3x10.2mm_P1.27mm

Connections:
/Index Register/Q0: U14.3 (QA); also elsewhere on the board
/Index Register/Q1: U14.2 (QB); also elsewhere on the board
/Index Register/Q2: U14.6 (QC); also elsewhere on the board
/Index Register/Q3: U14.7 (QD); also elsewhere on the board
/Index Register/Q4: U15.3 (QA); also elsewhere on the board
/Index Register/Q5: U15.2 (QB); also elsewhere on the board
/Index Register/Q6: U15.6 (QC); also elsewhere on the board
/Index Register/Q7: U15.7 (QD); also elsewhere on the board
/Index Register/Q8: U16.3 (QA); also elsewhere on the board
/Index Register/Q9: U16.2 (QB); also elsewhere on the board
/Index Register/Q10: U16.6 (QC); also elsewhere on the board
/Index Register/Q11: U16.7 (QD); also elsewhere on the board
/Index Register/Q12: U17.3 (QA); also elsewhere on the board
/Index Register/Q13: U17.2 (QB); also elsewhere on the board
/Index Register/Q14: U17.6 (QC); also elsewhere on the board
/Index Register/Q15: U17.7 (QD); also elsewhere on the board
A0: U14.15 (A); also elsewhere on the board
A1: U14.1 (B); also elsewhere on the board
A2: U14.10 (C); also elsewhere on the board
A3: U14.9 (D); also elsewhere on the board
A4: U15.15 (A); also elsewhere on the board
A5: U15.1 (B); also elsewhere on the board
A6: U15.10 (C); also elsewhere on the board
A7: U15.9 (D); also elsewhere on the board
A8: U16.15 (A); also elsewhere on the board
A9: U16.1 (B); also elsewhere on the board
A10: U16.10 (C); also elsewhere on the board
A11: U16.9 (D); also elsewhere on the board
A12: U17.15 (A); also elsewhere on the board
A13: U17.1 (B); also elsewhere on the board
A14: U17.10 (C); also elsewhere on the board
A15: U17.9 (D); also elsewhere on the board
BO: U17.13 (~BO); also elsewhere on the board
CO: U17.12 (~CO); also elsewhere on the board
GND: C14.2, C15.2, U14.8 (GND), U15.8 (GND), U16.8 (GND), U17.8 (GND); also elsewhere on the board
unnamed: U14.12 (~CO), U15.5 (UP)
unnamed: U14.13 (~BO), U15.4 (DOWN)
unnamed: U15.12 (~CO), U16.5 (UP)
unnamed: U15.13 (~BO), U16.4 (DOWN)
unnamed: U16.12 (~CO), U17.5 (UP)
unnamed: U16.13 (~BO), U17.4 (DOWN)
RESET: U14.14 (CLR), U15.14 (CLR), U16.14 (CLR), U17.14 (CLR); also elsewhere on the board
VCC: C14.1, C15.1, U14.16 (VCC), U15.16 (VCC), U16.16 (VCC), U17.16 (VCC); also elsewhere on the board
~INDEX_DEC: U14.4 (DOWN); also elsewhere on the board
~INDEX_INC: U14.5 (UP); also elsewhere on the board
~INDEX_LOAD: U14.11 (~LOAD), U15.11 (~LOAD), U16.11 (~LOAD), U17.11 (~LOAD); also elsewhere on the board

Notes on the sheet:
16bit Index Register
w/ Dec and Inc

Board: 2 copper layers, 40 parts (2 on the bottom side), 75 nets, no tracks yet.

Other parts of the board:
C13: C_Small; C_0805_2012Metric

Their connections:
GND: C13.2; also elsewhere on the board
VCC: C13.1; also elsewhere on the board
