theWickedWebDev/8-bit-computer/PCBs/99_IN PROGRESS/IO-VGA-counter/VGA.kicad_pcb

## KiCad design PCBs/99_IN PROGRESS/IO-VGA-counter/VGA.kicad_pcb (2022-08-27)

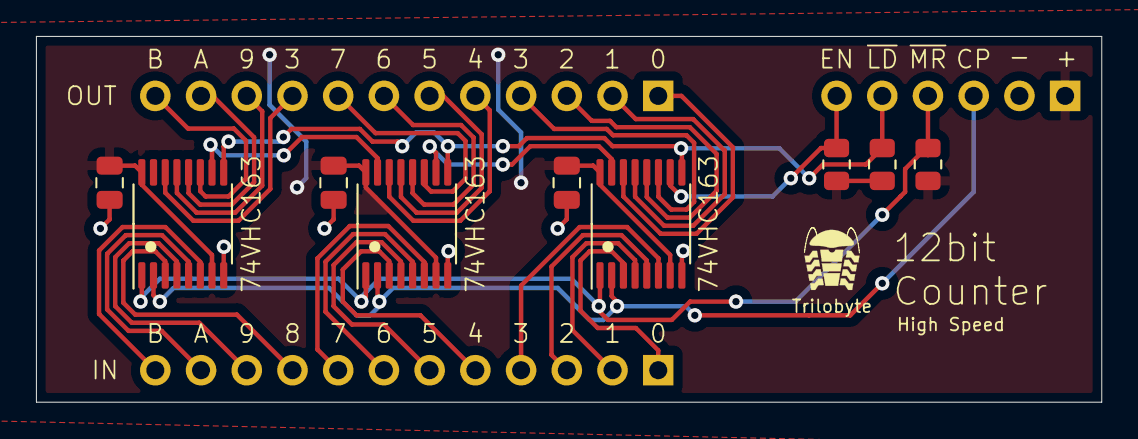
[picture p310: board VGA.kicad_pcb from above]

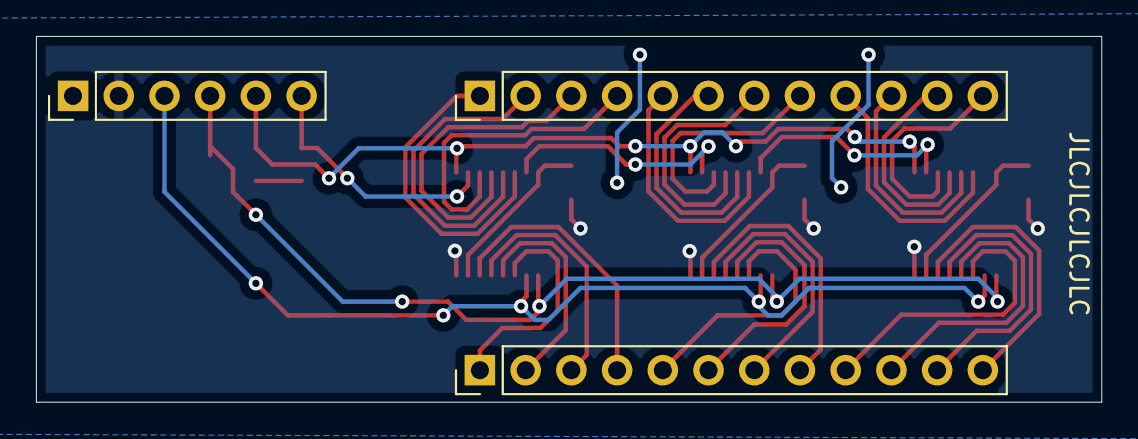
[picture p311: board VGA.kicad_pcb from below]

Board: 2 copper layers, 59.2 x 20.3 mm, 12 parts (3 on the bottom side), 32 nets.

Parts:
C1, C2, C3: C; C_0805_2012Metric
J1, J2: Conn_01x12; PinHeader_1x12_P2.54mm_Vertical
J3: Conn_01x06; PinHeader_1x06_P2.54mm_Vertical
R1, R2, R3: R_US; R_0805_2012Metric
U1, U2, U3: 74LS163; TSSOP-16_4.4x5mm_P0.65mm

Connections:
/CLOCK: J3.3, U1.2 (CP), U2.2 (CP), U3.2 (CP)
/D0: J1.1, U1.3 (D0)
/D1: J1.2, U1.4 (D1)
/D2: J1.3, U1.5 (D2)
/D3: J1.4, U1.6 (D3)
/D4: J1.5, U2.3 (D0)
/D5: J1.6, U2.4 (D1)
/D6: J1.7, U2.5 (D2)
/D7: J1.8, U2.6 (D3)
/D8: J1.9, U3.3 (D0)
/D9: J1.10, U3.4 (D1)
/D10: J1.11, U3.5 (D2)
/D11: J1.12, U3.6 (D3)
/EN: J3.6, R1.1, U1.10 (CET)
/Q0: J2.1, U1.14 (Q0)
/Q1: J2.2, U1.13 (Q1)
/Q2: J2.3, U1.12 (Q2)
/Q3: J2.4, U1.11 (Q3)
/Q4: J2.5, U2.14 (Q0)
/Q5: J2.6, U2.13 (Q1)
/Q6: J2.7, U2.12 (Q2)
/Q7: J2.8, U2.11 (Q3)
/Q8: J2.9, U3.14 (Q0)
/Q9: J2.10, U3.13 (Q1)
/Q10: J2.11, U3.12 (Q2)
/Q11: J2.12, U3.11 (Q3)
/~LOAD: J3.5, R2.1, U1.9 (~PE), U2.9 (~PE), U3.9 (~PE)
/~RESET: J3.4, R3.1, U1.1 (~MR), U2.1 (~MR), U3.1 (~MR)
GND: C1.2, C2.2, C3.2, J3.2, U1.8 (GND), U2.8 (GND), U3.8 (GND)
unnamed: U1.15 (TC), U2.10 (CET)
unnamed: U2.15 (TC), U3.10 (CET)
VCC: C1.1, C2.1, C3.1, J3.1, R1.2, R2.2, R3.2, U1.7 (CEP), U1.16 (VCC), U2.7 (CEP), U2.16 (VCC), U3.7 (CEP), U3.16 (VCC)
