theWickedWebDev/8-bit-computer/Modules/alu/ALU-181.sch

## KiCad design Modules/alu/ALU-181.sch (2021-07-10)

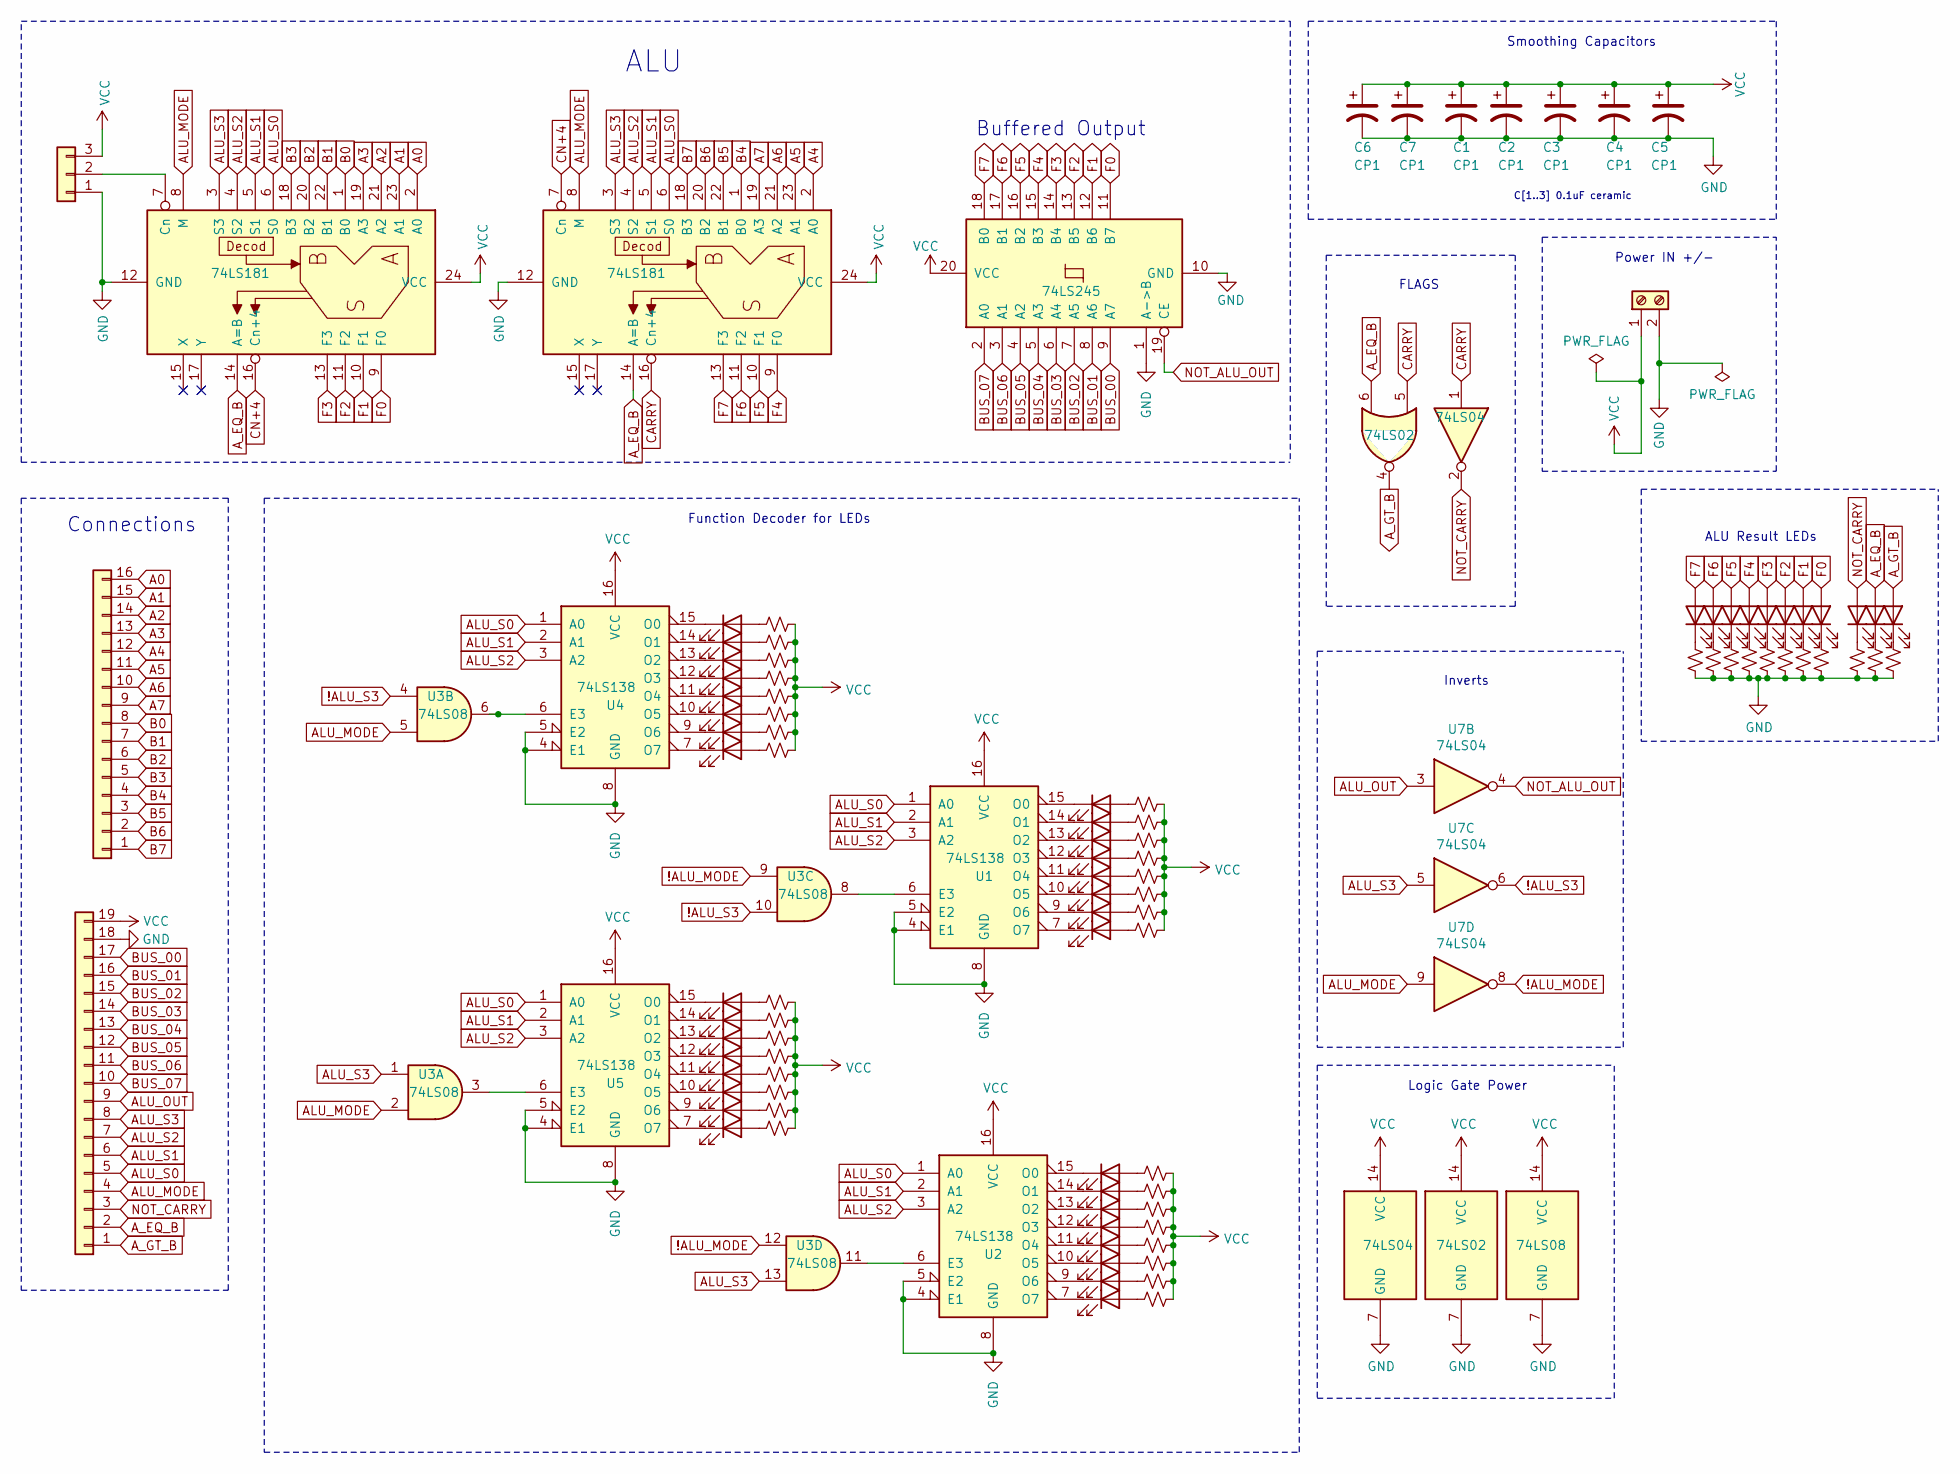
[picture p312: schematic ALU-181.sch]

Parts:
C1, C2, C3, C4, C5, C6, C7: CP1; C_0805_2012Metric
D1, D2, D3, D4, D5, D6, D7, D8, D9, D10, D11, D12, D13, D14, D15, D16, D17, D18, D19, D20, D21, D22, D23, D24, D25, D26, D27, D28, D29, D30, D31, D32, D33, D34, D35, D36, D37, D38, D39, D40, D41, D42, D43: LED; LED_0805_2012Metric
J2: Conn_01x19; PinHeader_1x19_P2.54mm_Vertical
J3: Screw_Terminal_01x02; TerminalBlock_Phoenix_MKDS-1,5-2_1x02_P5.00mm_Horizontal
J4: Conn_01x16; PinHeader_1x16_P2.54mm_Vertical
J17: Conn_01x03; PinHeader_1x03_P2.54mm_Vertical
R1, R2, R3, R4, R5, R6, R7, R8, R9, R10, R11, R12, R13, R14, R15, R16, R17, R18, R19, R20, R21, R22, R23, R24, R25, R26, R27, R28, R29, R30, R31, R32, R33, R34, R35, R36, R37, R38, R39, R40, R41, R42, R43: R_Small_US; R_0805_2012Metric
U1, U2, U4, U5: 74LS138; DIP-16_W7.62mm_Socket
U3: 74LS08; DIP-14_W7.62mm
U7: 74LS04; DIP-14_W7.62mm
U8: 74LS02; DIP-14_W7.62mm
U9, U11: 74LS181; DIP-24_W15.24mm
U10: 74LS245; DIP-20_W7.62mm

Connections:
!ALU_MODE: U3.9, U3.12, U7.8
!ALU_S3: U3.4, U3.10, U7.6
A0: J4.16, U11.2 (A0)
A1: J4.15, U11.23 (A1)
A2: J4.14, U11.21 (A2)
A3: J4.13, U11.19 (A3)
A4: J4.12, U9.2 (A0)
A5: J4.11, U9.23 (A1)
A6: J4.10, U9.21 (A2)
A7: J4.9, U9.19 (A3)
ALU_MODE: J2.4, U3.2, U3.5, U7.9, U9.8 (M), U11.8 (M)
ALU_OUT: J2.9, U7.3
ALU_S0: J2.5, U1.1 (A0), U2.1 (A0), U4.1 (A0), U5.1 (A0), U9.6 (S0), U11.6 (S0)
ALU_S1: J2.6, U1.2 (A1), U2.2 (A1), U4.2 (A1), U5.2 (A1), U9.5 (S1), U11.5 (S1)
ALU_S2: J2.7, U1.3 (A2), U2.3 (A2), U4.3 (A2), U5.3 (A2), U9.4 (S2), U11.4 (S2)
ALU_S3: J2.8, U3.1, U3.13, U7.5, U9.3 (S3), U11.3 (S3)
A_EQ_B: D42.2 (A), J2.2, U8.6, U9.14 (A=B), U11.14 (A=B)
A_GT_B: D43.2 (A), J2.1, U8.4
B0: J4.8, U11.1 (B0)
B1: J4.7, U11.22 (B1)
B2: J4.6, U11.20 (B2)
B3: J4.5, U11.18 (B3)
B4: J4.4, U9.1 (B0)
B5: J4.3, U9.22 (B1)
B6: J4.2, U9.20 (B2)
B7: J4.1, U9.18 (B3)
BUS_00: J2.17, U10.9 (A7)
BUS_01: J2.16, U10.8 (A6)
BUS_02: J2.15, U10.7 (A5)
BUS_03: J2.14, U10.6 (A4)
BUS_04: J2.13, U10.5 (A3)
BUS_05: J2.12, U10.4 (A2)
BUS_06: J2.11, U10.3 (A1)
BUS_07: J2.10, U10.2 (A0)
CARRY: U7.1, U8.5, U9.16 (Cn+4)
CN+4: U9.7 (Cn), U11.16 (Cn+4)
F0: D8.2 (A), U10.11 (B7), U11.9 (F0)
F1: D7.2 (A), U10.12 (B6), U11.10 (F1)
F2: D6.2 (A), U10.13 (B5), U11.11 (F2)
F3: D5.2 (A), U10.14 (B4), U11.13 (F3)
F4: D4.2 (A), U9.9 (F0), U10.15 (B3)
F5: D3.2 (A), U9.10 (F1), U10.16 (B2)
F6: D2.2 (A), U9.11 (F2), U10.17 (B1)
F7: D1.2 (A), U9.13 (F3), U10.18 (B0)
GND: C1.2, C2.2, C3.2, C4.2, C5.2, C6.2, C7.2, J2.18, J3.2, J17.1, R1.2, R2.2, R3.2, R4.2, R5.2, R6.2, R7.2, R8.2, R41.2, R42.2, R43.2, U1.4 (E1), U1.5 (E2), U1.8 (GND), U2.4 (E1), U2.5 (E2), U2.8 (GND), U3.7 (GND), U4.4 (E1), U4.5 (E2), U4.8 (GND), U5.4 (E1), U5.5 (E2), U5.8 (GND), U7.7 (GND), U8.7 (GND), U9.12 (GND), U10.1 (A->B), U10.10 (GND), U11.12 (GND)
NOT_ALU_OUT: U7.4, U10.19 (CE)
NOT_CARRY: D41.2 (A), J2.3, U7.2
unnamed: D1.1 (K), R1.1
unnamed: D2.1 (K), R2.1
unnamed: D3.1 (K), R3.1
unnamed: D4.1 (K), R4.1
unnamed: D5.1 (K), R5.1
unnamed: D6.1 (K), R6.1
unnamed: D7.1 (K), R7.1
unnamed: D8.1 (K), R8.1
unnamed: D9.1 (K), U1.7 (O7)
unnamed: D9.2 (A), R16.1
unnamed: D10.1 (K), U1.9 (O6)
unnamed: D10.2 (A), R15.1
unnamed: D11.1 (K), U1.10 (O5)
unnamed: D11.2 (A), R14.1
unnamed: D12.1 (K), U1.11 (O4)
unnamed: D12.2 (A), R13.1
unnamed: D13.1 (K), U1.12 (O3)
unnamed: D13.2 (A), R12.1
unnamed: D14.1 (K), U1.13 (O2)
unnamed: D14.2 (A), R11.1
unnamed: D15.1 (K), U1.14 (O1)
unnamed: D15.2 (A), R10.1
unnamed: D16.1 (K), U1.15 (O0)
unnamed: D16.2 (A), R9.1
unnamed: D17.1 (K), U2.7 (O7)
unnamed: D17.2 (A), R24.1
unnamed: D18.1 (K), U2.9 (O6)
unnamed: D18.2 (A), R23.1
unnamed: D19.1 (K), U2.10 (O5)
unnamed: D19.2 (A), R22.1
unnamed: D20.1 (K), U2.11 (O4)
unnamed: D20.2 (A), R21.1
unnamed: D21.1 (K), U2.12 (O3)
unnamed: D21.2 (A), R20.1
unnamed: D22.1 (K), U2.13 (O2)
unnamed: D22.2 (A), R19.1
unnamed: D23.1 (K), U2.14 (O1)
unnamed: D23.2 (A), R18.1
unnamed: D24.1 (K), U2.15 (O0)
unnamed: D24.2 (A), R17.1
unnamed: D25.1 (K), U4.7 (O7)
unnamed: D25.2 (A), R32.1
unnamed: D26.1 (K), U4.9 (O6)
unnamed: D26.2 (A), R31.1
unnamed: D27.1 (K), U4.10 (O5)
unnamed: D27.2 (A), R30.1
unnamed: D28.1 (K), U4.11 (O4)
unnamed: D28.2 (A), R29.1
unnamed: D29.1 (K), U4.12 (O3)
unnamed: D29.2 (A), R28.1
unnamed: D30.1 (K), U4.13 (O2)
unnamed: D30.2 (A), R27.1
unnamed: D31.1 (K), U4.14 (O1)
unnamed: D31.2 (A), R26.1
unnamed: D32.1 (K), U4.15 (O0)
unnamed: D32.2 (A), R25.1
unnamed: D33.1 (K), U5.7 (O7)
unnamed: D33.2 (A), R40.1
unnamed: D34.1 (K), U5.9 (O6)
unnamed: D34.2 (A), R39.1
unnamed: D35.1 (K), U5.10 (O5)
unnamed: D35.2 (A), R38.1
unnamed: D36.1 (K), U5.11 (O4)
unnamed: D36.2 (A), R37.1
unnamed: D37.1 (K), U5.12 (O3)
unnamed: D37.2 (A), R36.1
unnamed: D38.1 (K), U5.13 (O2)
unnamed: D38.2 (A), R35.1
unnamed: D39.1 (K), U5.14 (O1)
unnamed: D39.2 (A), R34.1
unnamed: D40.1 (K), U5.15 (O0)
unnamed: D40.2 (A), R33.1
unnamed: D41.1 (K), R41.1
unnamed: D42.1 (K), R42.1
unnamed: D43.1 (K), R43.1
unnamed: J17.2, U11.7 (Cn)
unnamed: U1.6 (E3), U3.8
unnamed: U2.6 (E3), U3.11
unnamed: U3.3, U5.6 (E3)
unnamed: U3.6, U4.6 (E3)
VCC: C1.1, C2.1, C3.1, C4.1, C5.1, C6.1, C7.1, J2.19, J3.1, J17.3, R9.2, R10.2, R11.2, R12.2, R13.2, R14.2, R15.2, R16.2, R17.2, R18.2, R19.2, R20.2, R21.2, R22.2, R23.2, R24.2, R25.2, R26.2, R27.2, R28.2, R29.2, R30.2, R31.2, R32.2, R33.2, R34.2, R35.2, R36.2, R37.2, R38.2, R39.2, R40.2, U1.16 (VCC), U2.16 (VCC), U3.14 (VCC), U4.16 (VCC), U5.16 (VCC), U7.14 (VCC), U8.14 (VCC), U9.24 (VCC), U10.20 (VCC), U11.24 (VCC)

Notes on the sheet:
Smoothing Capacitors
C[1..3] 0.1uF ceramic
Power IN +/-
ALU
FLAGS
Buffered Output
Connections
Logic Gate Power
Function Decoder for LEDs
Inverts
ALU Result LEDs
