theWickedWebDev/8-bit-computer/Modules/display-module/DISPLAY.sch

## KiCad design Modules/display-module/DISPLAY.sch (2021-06-29)

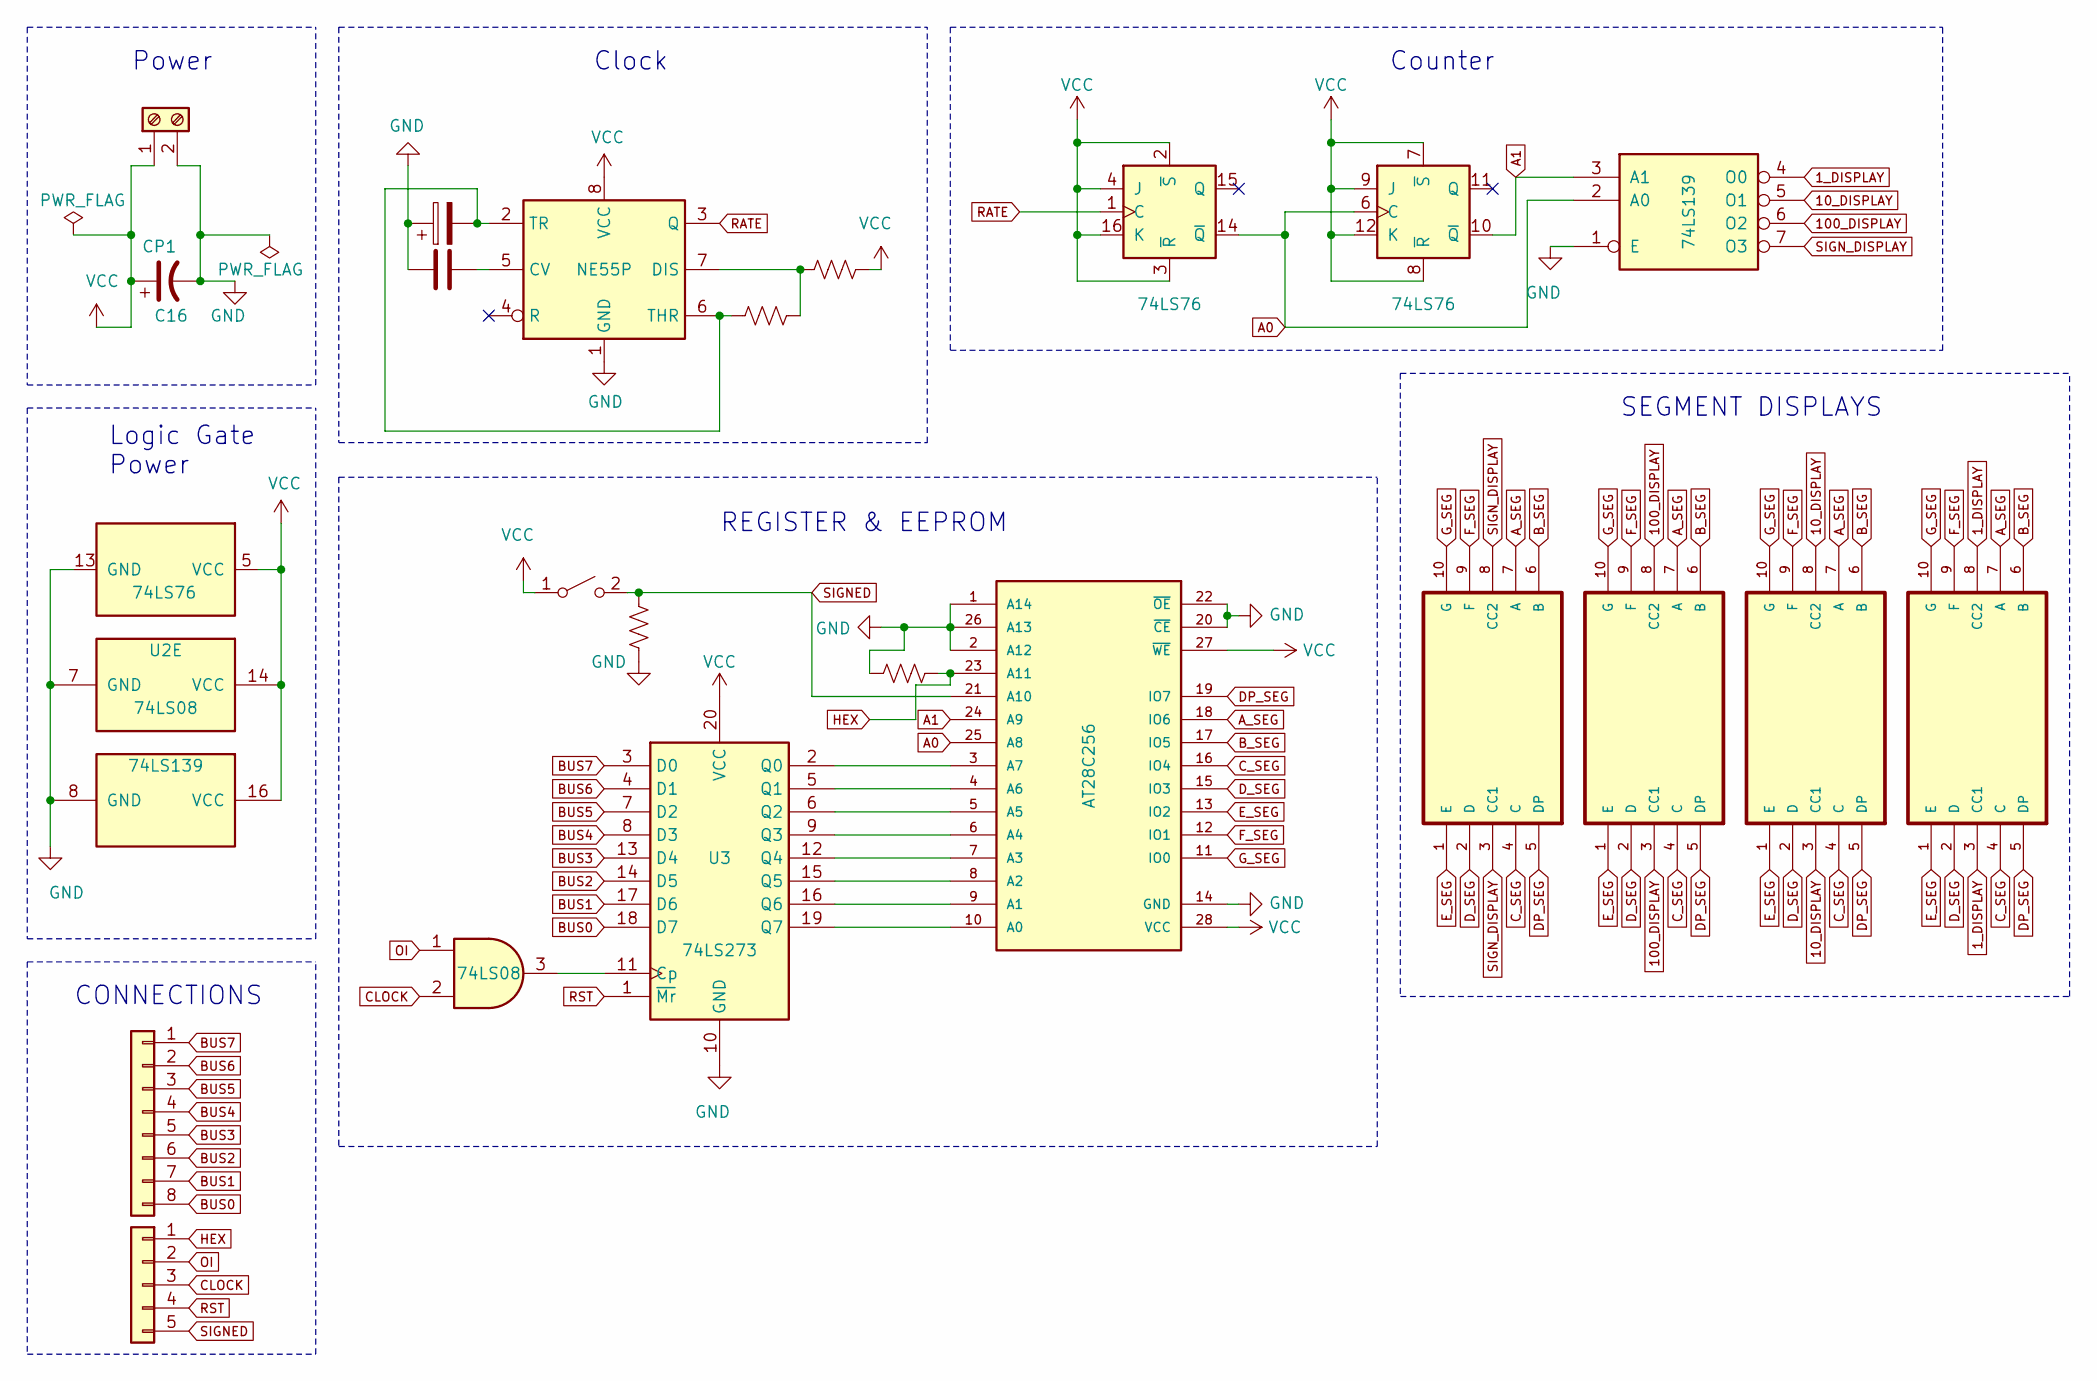
[picture p313: schematic DISPLAY.sch]

Parts:
C16: CP1; CP_Radial_D6.3mm_P2.50mm
C133: CP; C_Disc_D6.0mm_W2.5mm_P5.00mm
C233: C; C_Disc_D6.0mm_W2.5mm_P5.00mm
J1: Screw_Terminal_01x02; TerminalBlock_Phoenix_MKDS-1,5-2_1x02_P5.00mm_Horizontal
J2: Conn_01x08; PinHeader_1x08_P2.54mm_Vertical
J3: Conn_01x05; PinHeader_1x05_P2.54mm_Vertical
R1, R2, R1452, R2123: R_US; R_Axial_DIN0207_L6.3mm_D2.5mm_P10.16mm_Horizontal
SW1: SW_SPST; SW_DIP_SPSTx01_Slide_9.78x4.72mm_W7.62mm_P2.54mm
U1, U4, U5, U6: HDSP-7503; 7SegmentLED_LTS6760_LTS6780
U2: 74LS08; DIP-16_W7.62mm
U3: 74LS273; DIP-20_W7.62mm
U9: AT28C256; DIP_Socket-40_W11.9_W12.7_W15.24_W17.78_W18.5_3M_240-1280-0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
U1555: NE55P; DIP-8_W7.62mm
U2444: 74LS76; DIP-16_W7.62mm
U4332: 74LS139; DIP-16_W7.62mm

Connections:
1_DISPLAY: U6.3 (CC1), U6.8 (CC2), U4332.4 (O0)
10_DISPLAY: U5.3 (CC1), U5.8 (CC2), U4332.5 (O1)
100_DISPLAY: U4.3 (CC1), U4.8 (CC2), U4332.6 (O2)
A0: U9.25 (A8), U2444.6 (C), U2444.14 (~Q), U4332.2 (A0)
A1: U9.24 (A9), U2444.10 (~Q), U4332.3 (A1)
A_SEG: U1.7 (A), U4.7 (A), U5.7 (A), U6.7 (A), U9.18 (IO6)
BUS0: J2.8, U3.18 (D7)
BUS1: J2.7, U3.17 (D6)
BUS2: J2.6, U3.14 (D5)
BUS3: J2.5, U3.13 (D4)
BUS4: J2.4, U3.8 (D3)
BUS5: J2.3, U3.7 (D2)
BUS6: J2.2, U3.4 (D1)
BUS7: J2.1, U3.3 (D0)
B_SEG: U1.6 (B), U4.6 (B), U5.6 (B), U6.6 (B), U9.17 (IO5)
CLOCK: J3.3, U2.2
C_SEG: U1.4 (C), U4.4 (C), U5.4 (C), U6.4 (C), U9.16 (IO4)
DP_SEG: U1.5 (DP), U4.5 (DP), U5.5 (DP), U6.5 (DP), U9.19 (IO7)
D_SEG: U1.2 (D), U4.2 (D), U5.2 (D), U6.2 (D), U9.15 (IO3)
E_SEG: U1.1 (E), U4.1 (E), U5.1 (E), U6.1 (E), U9.13 (IO2)
F_SEG: U1.9 (F), U4.9 (F), U5.9 (F), U6.9 (F), U9.12 (IO1)
GND: C16.2, C133.1, C233.2, J1.2, R1.1, R2.1, U2.7 (GND), U3.10 (GND), U9.1 (A14), U9.2 (A12), U9.14 (GND), U9.20 (~CE), U9.22 (~OE), U9.26 (A13), U1555.1 (GND), U2444.13 (GND), U4332.1 (E), U4332.8 (GND)
G_SEG: U1.10 (G), U4.10 (G), U5.10 (G), U6.10 (G), U9.11 (IO0)
HEX: J3.1, R2.2, U9.23 (A11)
unnamed: C133.2, R1452.2, U1555.2 (TR), U1555.6 (THR)
unnamed: C233.1, U1555.5 (CV)
unnamed: R1452.1, R2123.1, U1555.7 (DIS)
unnamed: U2.3, U3.11 (Cp)
unnamed: U3.2 (Q0), U9.3 (A7)
unnamed: U3.5 (Q1), U9.4 (A6)
unnamed: U3.6 (Q2), U9.5 (A5)
unnamed: U3.9 (Q3), U9.6 (A4)
unnamed: U3.12 (Q4), U9.7 (A3)
unnamed: U3.15 (Q5), U9.8 (A2)
unnamed: U3.16 (Q6), U9.9 (A1)
unnamed: U3.19 (Q7), U9.10 (A0)
OI: J3.2, U2.1
RATE: U1555.3 (Q), U2444.1 (C)
RST: J3.4, U3.1 (~Mr)
SIGNED: J3.5, R1.2, SW1.2 (B), U9.21 (A10)
SIGN_DISPLAY: U1.3 (CC1), U1.8 (CC2), U4332.7 (O3)
VCC: C16.1, J1.1, R2123.2, SW1.1 (A), U2.14 (VCC), U3.20 (VCC), U9.27 (~WE), U9.28 (VCC), U1555.8 (VCC), U2444.2 (~S), U2444.3 (~R), U2444.4 (J), U2444.5 (VCC), U2444.7 (~S), U2444.8 (~R), U2444.9 (J), U2444.12 (K), U2444.16 (K), U4332.16 (VCC)

Notes on the sheet:
Power
Counter
Clock
Logic Gate Power
CONNECTIONS
SEGMENT DISPLAYS
REGISTER & EEPROM
