theWickedWebDev/8-bit-computer/Modules/prototyping-board/prototyping-board.sch

## KiCad design Modules/prototyping-board/prototyping-board.sch (2021-07-10)

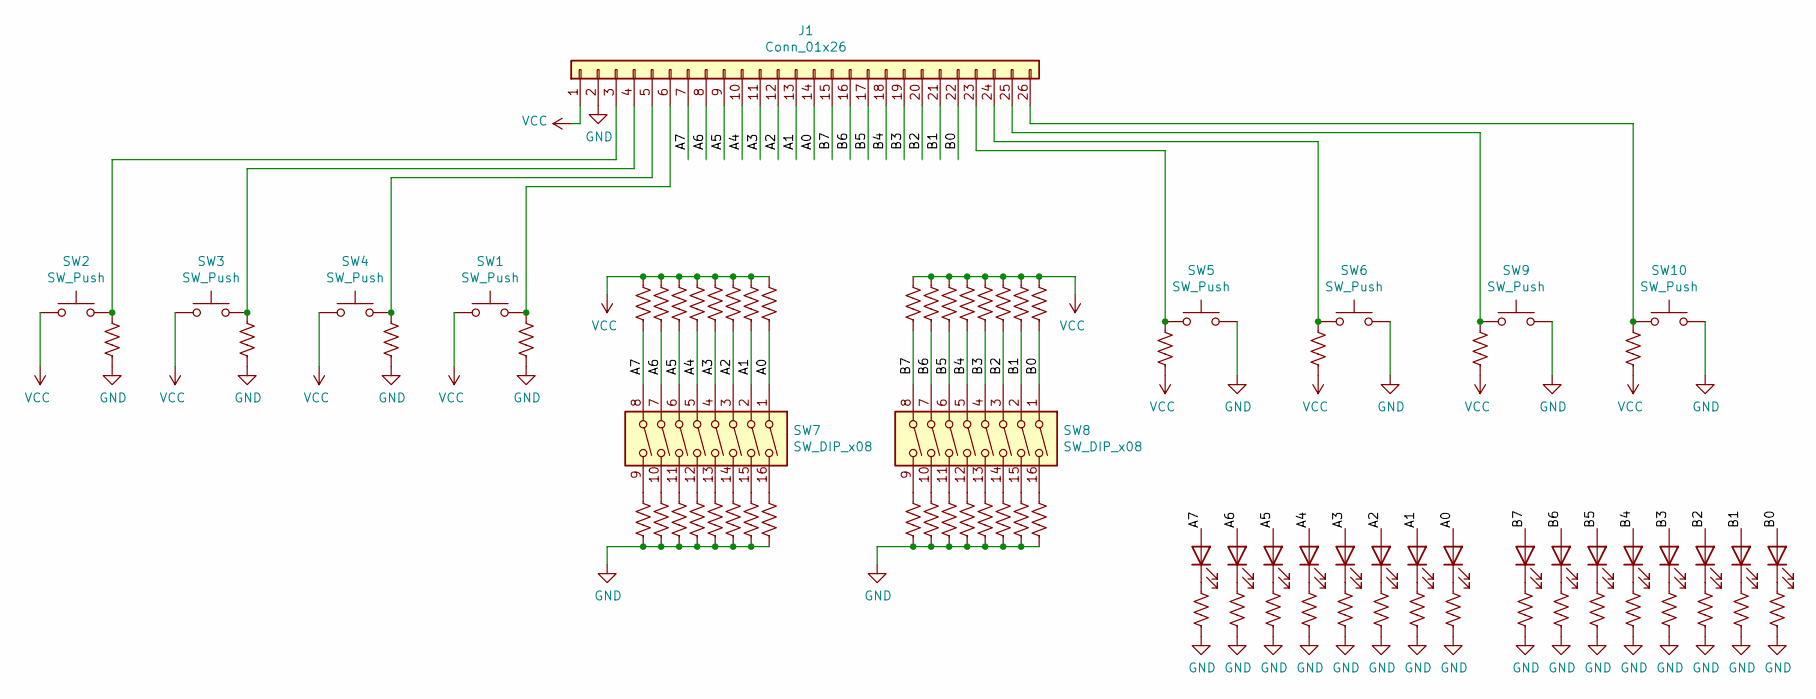
[picture p314: schematic prototyping-board.sch]

Parts:
D1, D2, D3, D4, D5, D6, D7, D8, D9, D10, D11, D12, D13, D14, D15, D16: LED; LED_0805_2012Metric
J1: Conn_01x26; PinHeader_1x26_P2.54mm_Horizontal
R1, R2, R3, R4, R5, R6, R7, R8, R9, R10, R11, R12, R13, R14, R15, R16, R17, R18, R19, R20, R21, R22, R23, R24, R25, R26, R27, R28, R29, R30, R31, R32, R33, R34, R35, R36, R37, R38, R39, R40, R41, R42, R43, R44, R45, R46, R47, R48, R49, R50, R51, R52, R53, R54, R55, R56: R_US; R_0805_2012Metric
SW1, SW2, SW3, SW4, SW5, SW6, SW9, SW10: SW_Push; SW_PUSH_6mm
SW7, SW8: SW_DIP_x08; SW_DIP_SPSTx08_Slide_9.78x22.5mm_W7.62mm_P2.54mm

Connections:
A0: D8.2 (A), J1.14, R16.2, SW7.1
A1: D7.2 (A), J1.13, R15.2, SW7.2
A2: D6.2 (A), J1.12, R14.2, SW7.3
A3: D5.2 (A), J1.11, R13.2, SW7.4
A4: D4.2 (A), J1.10, R12.2, SW7.5
A5: D3.2 (A), J1.9, R11.2, SW7.6
A6: D2.2 (A), J1.8, R10.2, SW7.7
A7: D1.2 (A), J1.7, R9.2, SW7.8
B0: D16.2 (A), J1.22, R24.2, SW8.1
B1: D15.2 (A), J1.21, R23.2, SW8.2
B2: D14.2 (A), J1.20, R22.2, SW8.3
B3: D13.2 (A), J1.19, R21.2, SW8.4
B4: D12.2 (A), J1.18, R20.2, SW8.5
B5: D11.2 (A), J1.17, R19.2, SW8.6
B6: D10.2 (A), J1.16, R18.2, SW8.7
B7: D9.2 (A), J1.15, R17.2, SW8.8
GND: J1.2, R1.2, R2.2, R3.2, R4.2, R5.2, R6.2, R7.2, R8.2, R25.2, R26.2, R27.2, R28.2, R29.2, R30.2, R31.2, R32.2, R33.2, R34.2, R35.2, R36.2, R41.2, R42.2, R43.2, R44.2, R45.2, R46.2, R47.2, R48.2, R49.2, R50.2, R51.2, R52.2, R53.2, R54.2, R55.2, R56.2, SW5.2, SW6.2, SW9.2, SW10.2
unnamed: D1.1 (K), R41.1
unnamed: D2.1 (K), R42.1
unnamed: D3.1 (K), R43.1
unnamed: D4.1 (K), R44.1
unnamed: D5.1 (K), R45.1
unnamed: D6.1 (K), R46.1
unnamed: D7.1 (K), R47.1
unnamed: D8.1 (K), R48.1
unnamed: D9.1 (K), R49.1
unnamed: D10.1 (K), R50.1
unnamed: D11.1 (K), R51.1
unnamed: D12.1 (K), R52.1
unnamed: D13.1 (K), R53.1
unnamed: D14.1 (K), R54.1
unnamed: D15.1 (K), R55.1
unnamed: D16.1 (K), R56.1
unnamed: J1.3, R33.1, SW2.2
unnamed: J1.4, R34.1, SW3.2
unnamed: J1.5, R35.1, SW4.2
unnamed: J1.6, R36.1, SW1.2
unnamed: J1.23, R37.1, SW5.1
unnamed: J1.24, R38.1, SW6.1
unnamed: J1.25, R39.1, SW9.1
unnamed: J1.26, R40.1, SW10.1
unnamed: R1.1, SW7.9
unnamed: R2.1, SW7.10
unnamed: R3.1, SW7.11
unnamed: R4.1, SW7.12
unnamed: R5.1, SW7.13
unnamed: R6.1, SW7.14
unnamed: R7.1, SW7.15
unnamed: R8.1, SW7.16
unnamed: R25.1, SW8.9
unnamed: R26.1, SW8.10
unnamed: R27.1, SW8.11
unnamed: R28.1, SW8.12
unnamed: R29.1, SW8.13
unnamed: R30.1, SW8.14
unnamed: R31.1, SW8.15
unnamed: R32.1, SW8.16
VCC: J1.1, R9.1, R10.1, R11.1, R12.1, R13.1, R14.1, R15.1, R16.1, R17.1, R18.1, R19.1, R20.1, R21.1, R22.1, R23.1, R24.1, R37.2, R38.2, R39.2, R40.2, SW1.1, SW2.1, SW3.1, SW4.1
