theWickedWebDev/8-bit-computer/Modules/ram-module/ram-combined.sch

## KiCad design Modules/ram-module/ram-combined.sch (2021-06-29)

Schematic: ram-combined.sch

Parts:
BAR1, BAR2, BAR3: HDSP-4830_2; HDSP-4830
C1, C2, C3, C4, C5: CP1_Small; CP_Radial_D5.0mm_P2.50mm
D1, D2, D3, D4, D5, D6, D7, D8: LED; LED_D5.0mm
J1, J2, J8: Conn_01x08; PinHeader_1x08_P2.54mm_Vertical
J3: Conn_01x10; PinHeader_1x10_P2.54mm_Vertical
J4: Conn_01x02; PinHeader_1x02_P2.54mm_Vertical
J5: Screw_Terminal_01x02; TerminalBlock_Phoenix_MKDS-1,5-2_1x02_P5.00mm_Horizontal
J6: Conn_01x16; PinHeader_1x16_P2.54mm_Vertical
J7: Conn_01x08; PinHeader_1x03_P2.54mm_Vertical
R1, R2, R3: R_US; R_Axial_DIN0207_L6.3mm_D2.5mm_P10.16mm_Horizontal
RN1, RN2, RN3, RN4, RN5, RN6, RN7, RN8, RN9, RN10: R_Network08_US; R_Array_SIP9
SW1: SW_SPDT; PinHeader_1x03_P2.54mm_Vertical
SW2: SW_Push; SW_PUSH_6mm_H5mm
SW3, SW4, SW5: SW_DIP_x08; SW_DIP_SPSTx08_Slide_9.78x22.5mm_W7.62mm_P2.54mm
U1: 74LS00; DIP-14_W7.62mm
U2: 74LS32; DIP-14_W7.62mm
U3, U4, U6, U7, U15, U17: 74LS157; DIP-16_W7.62mm
U5, U8, U10, U12, U14, U16: 74LS173; DIP-16_W7.62mm
U9: IS61C1024-15N; DIP-32_W7.62mm
U11, U13: 74LS245; DIP-20_W7.62mm

Notes on the sheet:
MAR Low Bits
MAR High Bits
MEMORY ADDRESS MULTIPLEXER
MANUAL MEMORY ADDRESS SWITCHES
RAM CONTENTS OUTPUT
RAM DATA IN
RAM IC
2 OCTAL BUFFERS
ACTIVE LOW
POWER
RAM OUTPUT DISPLAY
Decoupling Capacitors
C1 - 100nF Polarized
CONTROL LINES
CONNECTIONS
BUS CONNECTION
bi-directional
Using two 74LS245 (Octal BUS Transceivers/Buffers) so that we can switch between the I/O lines being INPUTS and OUTPUTS
OE is tied LOW - dont confuse this with OUTPUT_ENABLED on the BUS Buffer
128K x 8 HIGH-SPEED CMOS STATIC RAM
ACTIVE HIGH
MEMORY ADDRESS LEDS
MEMORY ADDRESS REGISTER
RAM
I/O BUFFER
Memory Data
SWITCHES
