theWickedWebDev/8-bit-computer/Modules/register-smd/register-smd.sch

## KiCad design Modules/register-smd/register-smd.sch (2021-07-10)

Schematic: register-smd.sch

Parts:
C1, C2, C3: C; C_0805_2012Metric; JLC C15525
C4: CP1; CP_Radial_D5.0mm_P2.50mm
D1, D2, D3, D4, D5, D6, D7, D8, D9, D10, D11, D12, D13, D14, D15, D16, D17, D18, D19, D20, D21, D22, D23, D24, D25, D26, D27, D28, D29, D30, D31, D32: LED; LED_0805_2012Metric
J1: Screw_Terminal_01x02; TerminalBlock_Phoenix_MKDS-1,5-2_1x02_P5.00mm_Horizontal
J2: Conn_01x16; PinHeader_1x16_P2.54mm_Horizontal
J8: Conn_01x18; PinHeader_1x18_P2.54mm_Horizontal
R1, R2, R3, R4, R5, R6, R7, R8, R9, R10, R11, R12, R13, R14, R15, R16, R17, R18, R19, R20, R21, R22, R23, R24, R25, R26, R27, R28, R29, R30, R31, R32, R33, R34, R35, R36, R37, R38: R_Small_US; R_0805_2012Metric; JLC C4109
U1, U3, U6: 74HC273; DIP-20_W7.62mm_Socket; JLCPCB Part # C9030
U2: 74HC08; DIP-14_W7.62mm_Socket
U4: 74LS04; DIP-14_W7.62mm_Socket
U5, U7, U47: 74HC245; DIP-20_W7.62mm_Socket
