theWickedWebDev/8-bit-computer/Modules/smd-prototyping-board/smd-prototyping-board.sch

## KiCad design Modules/smd-prototyping-board/smd-prototyping-board.sch (2021-07-04)

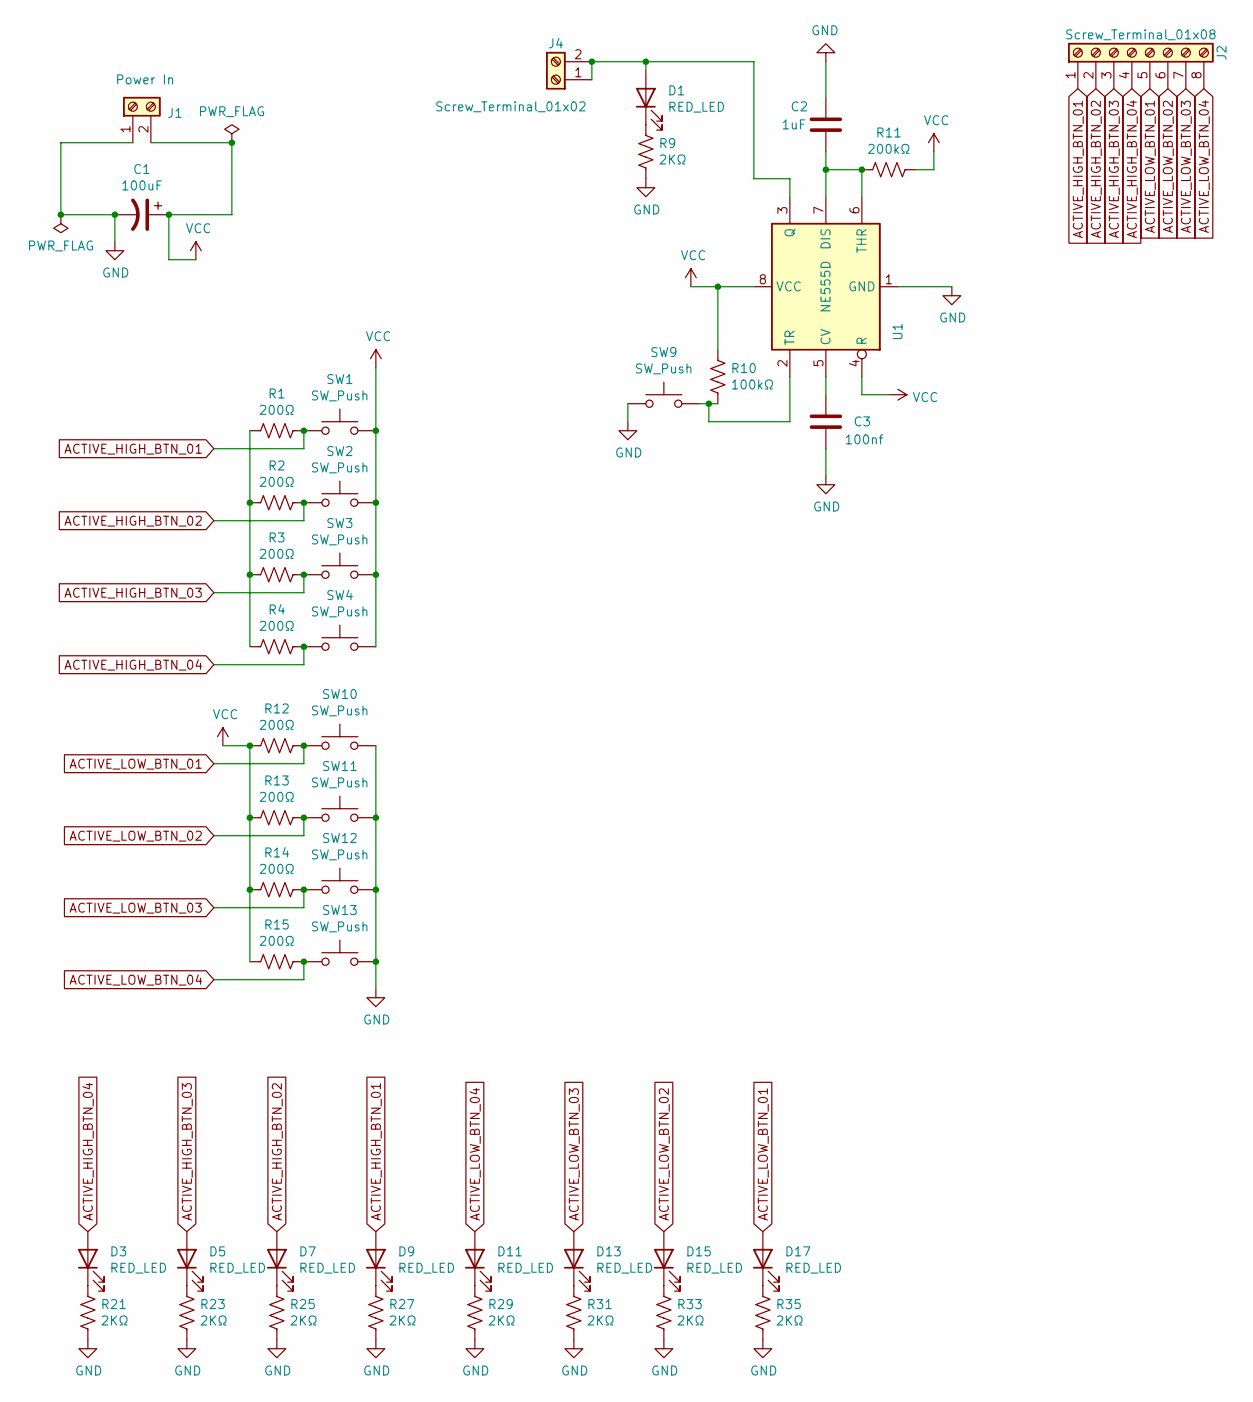
[picture p315: schematic smd-prototyping-board.sch]

Parts:
C1: 100uF; CP_Elec_6.3x7.7; JLCPCB Part # C99837
C2: 1uF; C_0402_1005Metric; JLCPCB Part # C52923
C3: 100nf; C_0402_1005Metric; JLCPCB Part # C1525
D1, D3, D5, D7, D9, D11, D13, D15, D17: RED_LED; LED_0603_1608Metric; JLCPCB Part # C72041
J1: Power In; TerminalBlock_Phoenix_MKDS-1,5-2_1x02_P5.00mm_Horizontal
J2: Screw_Terminal_01x08; TerminalBlock_TE_282834-8_1x08_P2.54mm_Horizontal
J4: Screw_Terminal_01x02; TerminalBlock_TE_282834-2_1x02_P2.54mm_Horizontal
R1, R2, R3, R4, R12, R13, R14, R15: 200Ω; R_0402_1005Metric; JLCPCB Part # C25087
R9, R21, R23, R25, R27, R29, R31, R33, R35: 2KΩ; R_0402_1005Metric; JLCPCB Part # C25879
R10: 100kΩ; R_0402_1005Metric; JLCPCB Part # C25741
R11: 200kΩ; R_0402_1005Metric; JLCPCB Part # C25087
SW1, SW2, SW3, SW4, SW9, SW10, SW11, SW12, SW13: SW_Push; SW_SPST_B3U-1000P; JLCPCB Part # C231329
U1: NE555D; SOIC-8_3.9x4.9mm_P1.27mm; JLCPCB Part # C7593

Connections:
ACTIVE_HIGH_BTN_01: D9.2 (A), J2.1, R1.2, SW1.1
ACTIVE_HIGH_BTN_02: D7.2 (A), J2.2, R2.2, SW2.1
ACTIVE_HIGH_BTN_03: D5.2 (A), J2.3, R3.2, SW3.1
ACTIVE_HIGH_BTN_04: D3.2 (A), J2.4, R4.2, SW4.1
ACTIVE_LOW_BTN_01: D17.2 (A), J2.5, R12.2, SW10.1
ACTIVE_LOW_BTN_02: D15.2 (A), J2.6, R13.2, SW11.1
ACTIVE_LOW_BTN_03: D13.2 (A), J2.7, R14.2, SW12.1
ACTIVE_LOW_BTN_04: D11.2 (A), J2.8, R15.2, SW13.1
GND: C1.2, C2.1, C3.2, J1.1, R9.1, R21.1, R23.1, R25.1, R27.1, R29.1, R31.1, R33.1, R35.1, SW9.1, SW10.2, SW11.2, SW12.2, SW13.2, U1.1 (GND)
unnamed: C2.2, R11.1, U1.6 (THR), U1.7 (DIS)
unnamed: C3.1, U1.5 (CV)
unnamed: D1.1 (K), R9.2
unnamed: D1.2 (A), J4.1, J4.2, U1.3 (Q)
unnamed: D3.1 (K), R21.2
unnamed: D5.1 (K), R23.2
unnamed: D7.1 (K), R25.2
unnamed: D9.1 (K), R27.2
unnamed: D11.1 (K), R29.2
unnamed: D13.1 (K), R31.2
unnamed: D15.1 (K), R33.2
unnamed: D17.1 (K), R35.2
unnamed: R1.1, R2.1, R3.1, R4.1
unnamed: R10.1, SW9.2, U1.2 (TR)
VCC: C1.1, J1.2, R10.2, R11.2, R12.1, R13.1, R14.1, R15.1, SW1.2, SW2.2, SW3.2, SW4.2, U1.4 (R), U1.8 (VCC)
