theWickedWebDev/8-bit-computer/Modules/sound-module/voice.sch

## KiCad design Modules/sound-module/voice.sch (2021-05-25)

Schematic: voice.sch

Parts:
D38, D39, D40, D41, D42, D43, D44, D45, D46, D47: LED; LED_D3.0mm
J3: Conn_01x10; PinHeader_1x10_P2.54mm_Vertical
J4: Conn_01x04; PinHeader_1x04_P2.54mm_Vertical
R14, R15: R_Small_US; R_Axial_DIN0207_L6.3mm_D2.5mm_P10.16mm_Horizontal
RN5: R_Network08_US; R_Array_SIP9
U23, U25, U27, U28: 74LS193; DIP-16_W7.62mm
U24: CD4052B; DIP-16_W7.62mm
U29, U30, U31: 74LS173; DIP-16_W7.62mm
