theWickedWebDev/8-bit-computer/modules/clock/555-debounce.sch

## KiCad design modules/clock/555-debounce.sch (2021-09-13)

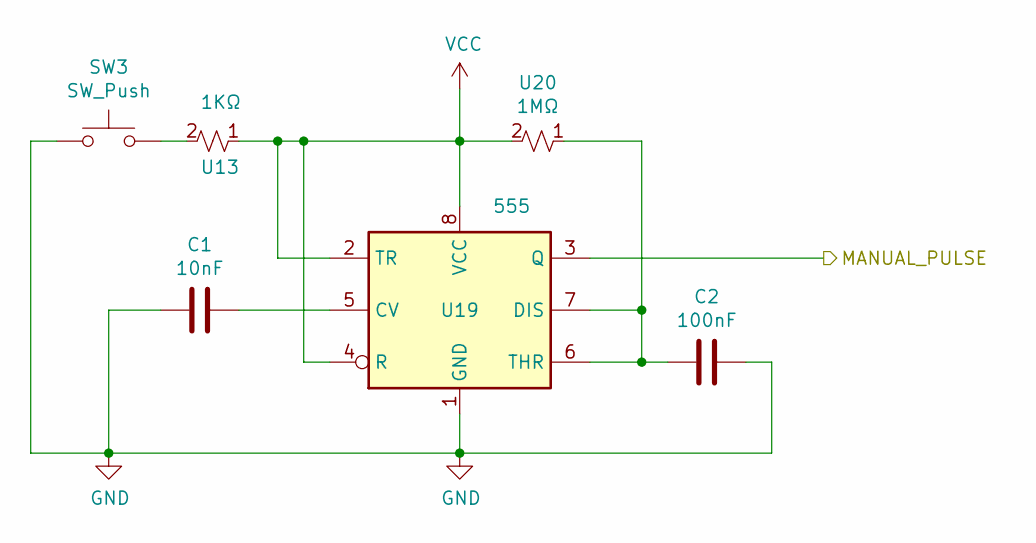
[picture p316: schematic 555-debounce.sch]

Parts:
C1: 0603B103K500NT; C_0603_1608Metric
C2: CC0603KRX7R9BB104; C_0603_1608Metric
SW3: SW_Push; SW_PUSH_6mm
U13: 0603WAF1001T5E; R_0603_1608Metric
U19: TLC555QDRG4; SOIC-8_3.9x4.9mm_P1.27mm
U20: 0603WAF1004T5E; R_0603_1608Metric

Connections:
GND: C1.2, C2.2, SW3.1, U19.1 (GND)
MANUAL_PULSE: U19.3 (Q)
unnamed: C1.1, U19.5 (CV)
unnamed: C2.1, U19.6 (THR), U19.7 (DIS), U20.1
unnamed: SW3.2, U13.2
VCC: U13.1, U19.2 (TR), U19.4 (R), U19.8 (VCC), U20.2
