theWickedWebDev/8-bit-computer/modules/clock/555-debounce_switch.sch

## KiCad design modules/clock/555-debounce_switch.sch (2021-09-13)

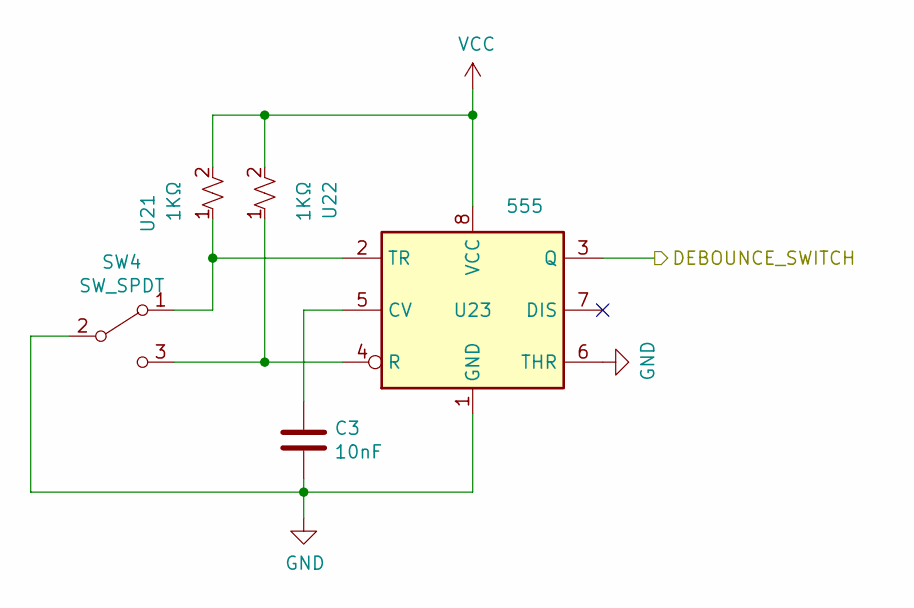
[picture p317: schematic 555-debounce_switch.sch]

Parts:
C3: 0603B103K500NT; C_0603_1608Metric
SW4: SW_SPDT; SMD_SW_SPDT_JLCPCB
U21, U22: 0603WAF1001T5E; R_0603_1608Metric
U23: TLC555QDRG4; SOIC-8_3.9x4.9mm_P1.27mm

Connections:
DEBOUNCE_SWITCH: U23.3 (Q)
GND: C3.1, SW4.2 (B), U23.1 (GND), U23.6 (THR)
unnamed: C3.2, U23.5 (CV)
unnamed: SW4.1 (A), U21.1, U23.2 (TR)
unnamed: SW4.3 (C), U22.1, U23.4 (R)
VCC: U21.2, U22.2, U23.8 (VCC)
