theWickedWebDev/8-bit-computer/modules/clock/clock.sch

## KiCad design modules/clock/clock.sch (2021-09-13)

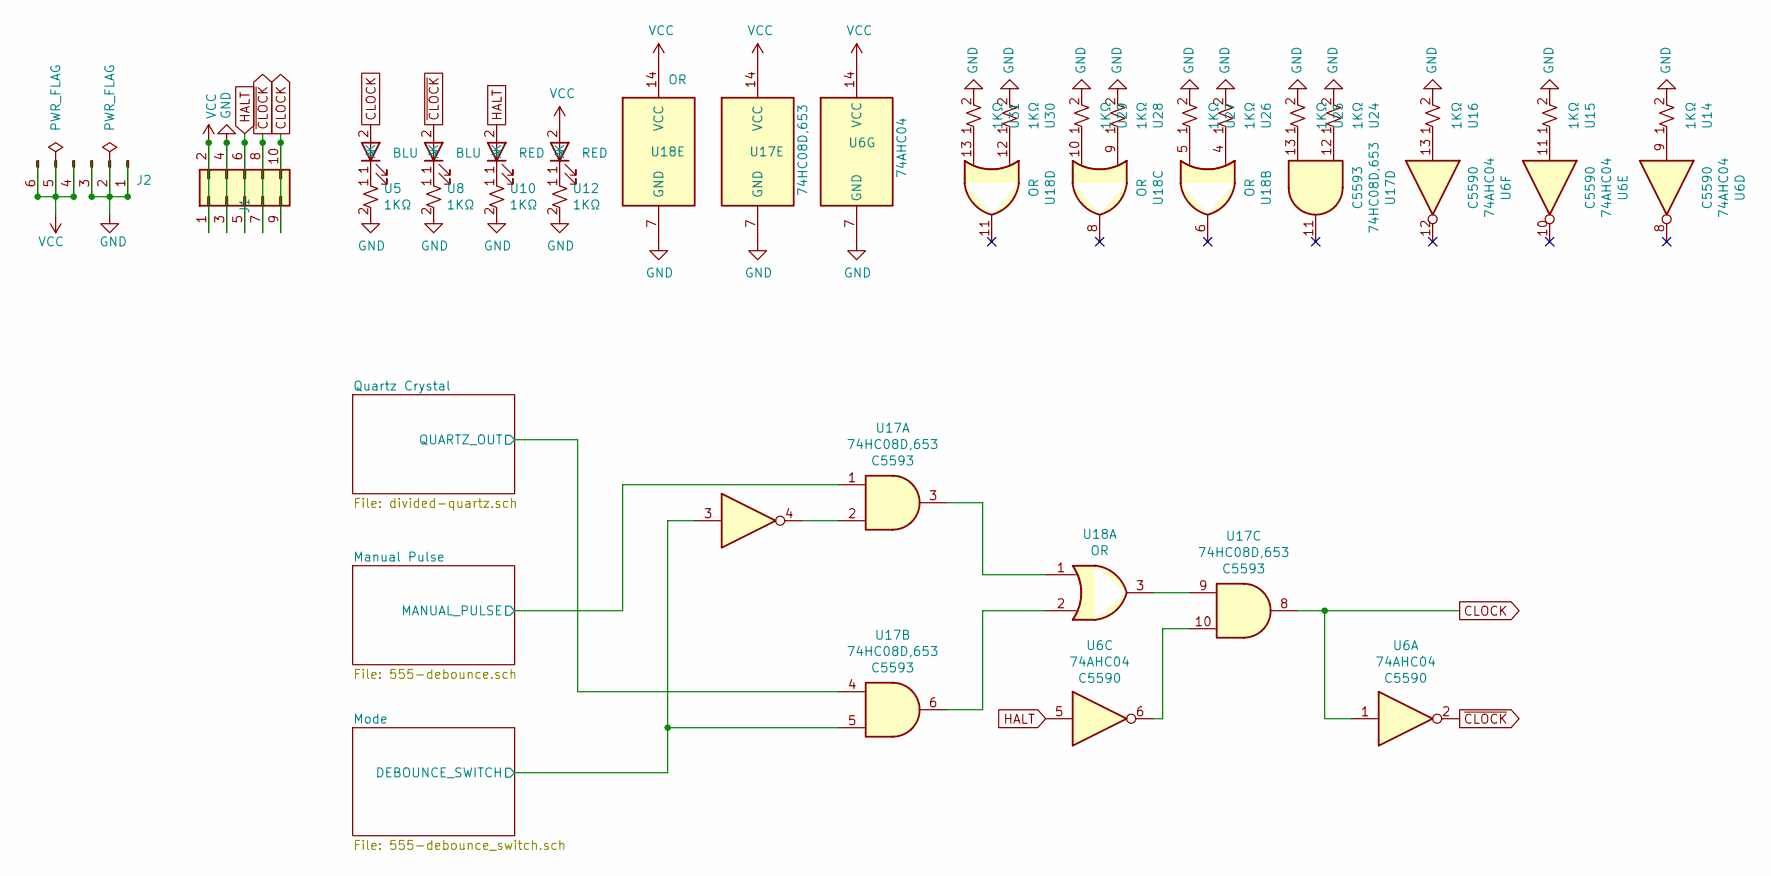
[picture p318: schematic clock.sch]

Parts:
J1: Conn_01x05_Male; PinHeader_2x05_P2.54mm_Vertical
J2: Conn_01x06_Male; PinHeader_1x06_P2.54mm_Vertical
U4, U7: 1206B; LED_1206_3216Metric
U5, U8, U10, U12, U14, U15, U16, U24, U25, U26, U27, U28, U29, U30, U31: 0603WAF1001T5E; R_0603_1608Metric
U6: 74AHC04; SOIC-14_3.9x8.7mm_P1.27mm
U9, U11: TJ-S3216SW9TGLC2R-A5; LED_1206_3216Metric
U17: 74HC08D,653; SOIC-14_3.9x8.7mm_P1.27mm
U18: 74HC32D,653; SOIC-14_3.9x8.7mm_P1.27mm

Connections:
CLOCK: J1.9, J1.10, U4.2 (A), U6.1, U17.8
DEBOUNCE_SWITCH: U6.3, U17.5
GND: J1.3, J1.4, J2.1, J2.2, J2.3, U5.2, U6.7 (GND), U8.2, U10.2, U12.2, U14.2, U15.2, U16.2, U17.7 (GND), U18.7 (GND), U24.2, U25.2, U26.2, U27.2, U28.2, U29.2, U30.2, U31.2
HALT: J1.5, J1.6, U6.5, U9.2 (A)
MANUAL_PULSE: U17.1
unnamed: U4.1 (K), U5.1
unnamed: U7.1 (K), U8.1
unnamed: U9.1 (K), U10.1
unnamed: U11.1 (K), U12.1
unnamed: U6.9, U14.1
unnamed: U6.11, U15.1
unnamed: U6.13, U16.1
unnamed: U6.4, U17.2
unnamed: U17.3, U18.1
unnamed: U17.6, U18.2
unnamed: U17.9, U18.3
unnamed: U6.6, U17.10
unnamed: U17.12, U24.1
unnamed: U17.13, U25.1
unnamed: U18.4, U26.1
unnamed: U18.5, U27.1
unnamed: U18.9, U28.1
unnamed: U18.10, U29.1
unnamed: U18.12, U30.1
unnamed: U18.13, U31.1
QUARTZ_OUT: U17.4
VCC: J1.1, J1.2, J2.4, J2.5, J2.6, U6.14 (VCC), U11.2 (A), U17.14 (VCC), U18.14 (VCC)
~CLOCK: J1.7, J1.8, U6.2, U7.2 (A)
