theWickedWebDev/8-bit-computer/modules/clock/divided-quartz.sch

## KiCad design modules/clock/divided-quartz.sch (2021-09-13)

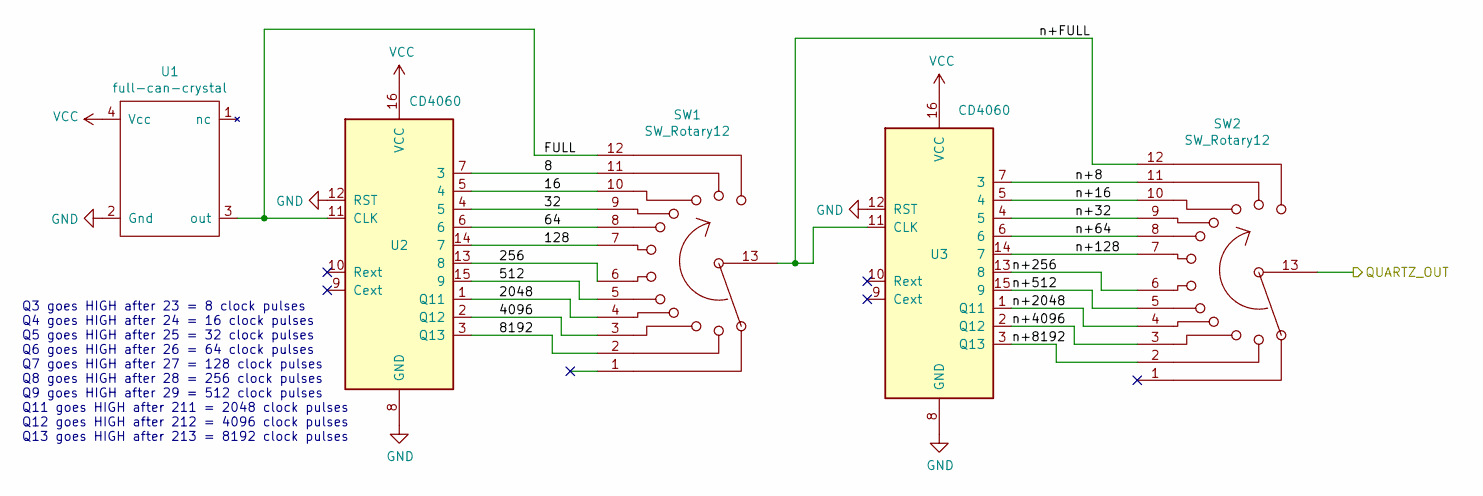
[picture p319: schematic divided-quartz.sch]

Parts:
SW1, SW2: SW_Rotary12; Rotary_Switch_12_pos_1_pole
U1: full-can-crystal; full-can-14pin
U2, U3: CD4060BM96; SOIC-16_3.9x9.9mm_P1.27mm

Connections:
8: SW1.11, U2.7 (3)
16: SW1.10, U2.5 (4)
32: SW1.9, U2.4 (5)
64: SW1.8, U2.6
128: SW1.7, U2.14 (7)
256: SW1.6, U2.13 (8)
512: SW1.5, U2.15 (9)
2048: SW1.4, U2.1 (Q11)
4096: SW1.3, U2.2 (Q12)
8192: SW1.2, U2.3 (Q13)
FULL: SW1.12, U1.3 (out), U2.11 (CLK)
GND: U1.2 (Gnd), U2.8 (GND), U2.12 (RST), U3.8 (GND), U3.12 (RST)
QUARTZ_OUT: SW2.13
VCC: U1.4 (Vcc), U2.16 (VCC), U3.16 (VCC)
n+8: SW2.11, U3.7 (3)
n+16: SW2.10, U3.5 (4)
n+32: SW2.9, U3.4 (5)
n+64: SW2.8, U3.6
n+128: SW2.7, U3.14 (7)
n+256: SW2.6, U3.13 (8)
n+512: SW2.5, U3.15 (9)
n+2048: SW2.4, U3.1 (Q11)
n+4096: SW2.3, U3.2 (Q12)
n+8192: SW2.2, U3.3 (Q13)
n+FULL: SW1.13, SW2.12, U3.11 (CLK)

Notes on the sheet:
Q3 goes HIGH after 23 = 8 clock pulses Q4 goes HIGH after 24 = 16 clock pulses Q5 goes HIGH after 25 = 32 clock pulses Q6 goes HIGH after 26 = 64 clock pulses Q7 goes HIGH after 27 = 128 clock pulses Q8 goes HIGH after 28 = 256 clock pulses Q9 goes HIGH after 29 = 512 clock pulses Q11 goes HIGH aft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
