theWickedWebDev/8-bit-computer/other-modules/ALU-DISCRETE-LOGIC/ADD_SUB.sch

## KiCad design other-modules/ALU-DISCRETE-LOGIC/ADD_SUB.sch (2021-04-21)

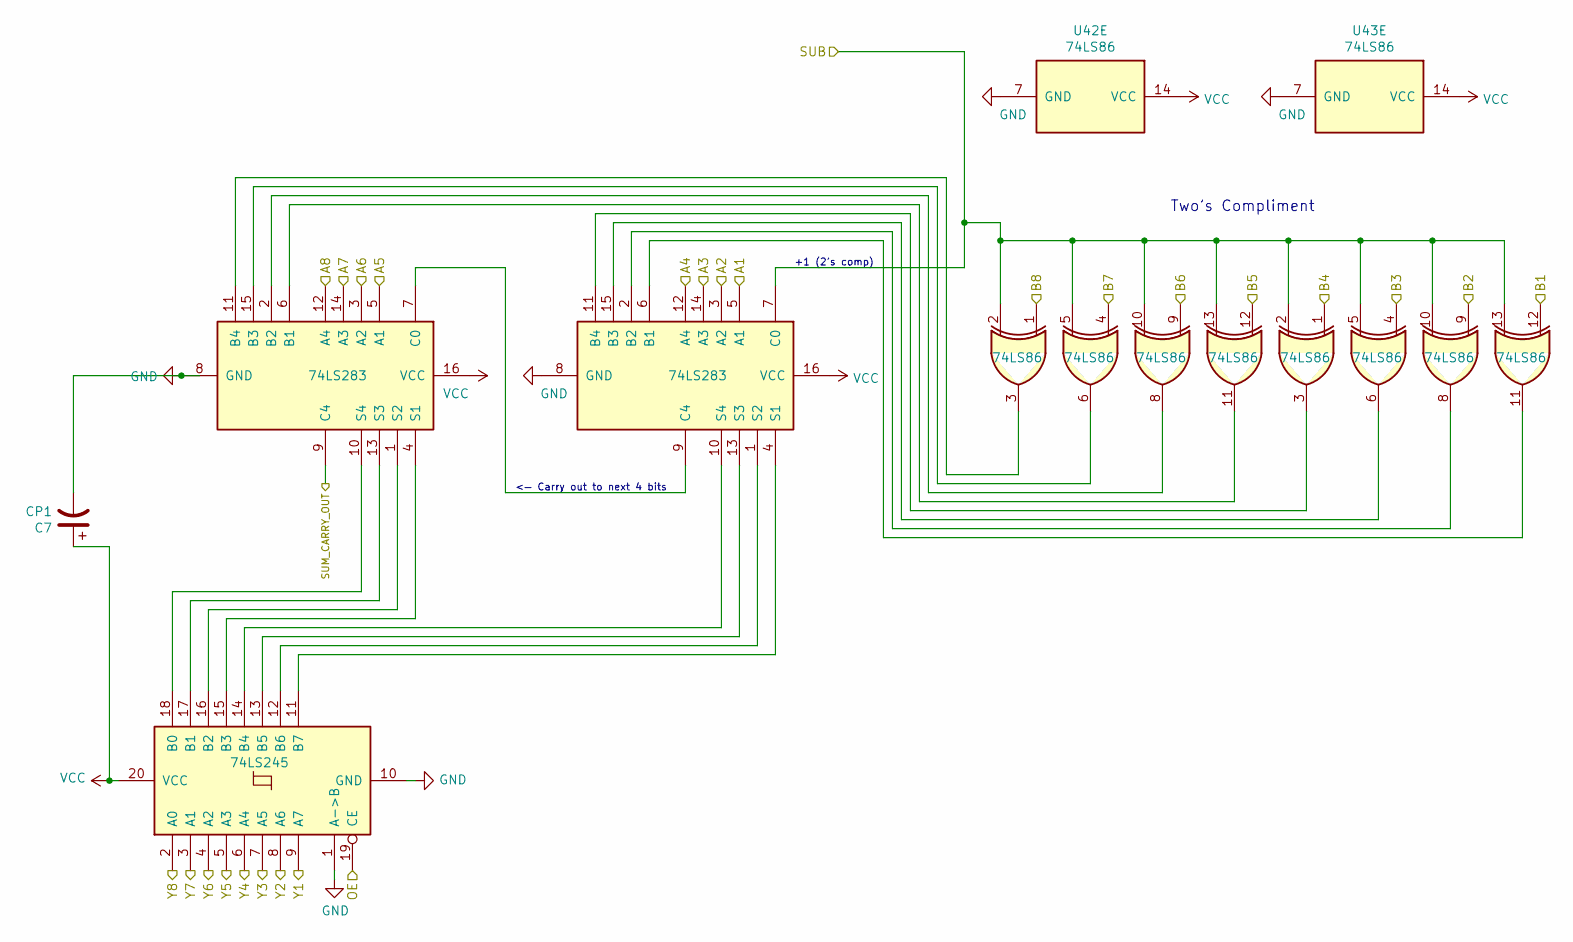
[picture p320: schematic ADD_SUB.sch]

Parts:
C5: CP1; C_Radial_D6.3mm_H11.0mm_P2.50mm
U15: 74LS245; DIP-20_W7.62mm
U16, U17: 74LS283; DIP-16_W7.62mm
U18, U19: 74LS86; DIP-14_W7.62mm

Connections:
A1: U17.5 (A1)
A2: U17.3 (A2)
A3: U17.14 (A3)
A4: U17.12 (A4)
A5: U16.5 (A1)
A6: U16.3 (A2)
A7: U16.14 (A3)
A8: U16.12 (A4)
B1: U19.12
B2: U19.9
B3: U19.4
B4: U19.1
B5: U18.12
B6: U18.9
B7: U18.4
B8: U18.1
GND: C5.2, U15.1 (A->B), U15.10 (GND), U16.8 (GND), U17.8 (GND), U18.7 (GND), U19.7 (GND)
unnamed: U15.11 (B7), U17.4 (S1)
unnamed: U15.12 (B6), U17.1 (S2)
unnamed: U15.13 (B5), U17.13 (S3)
unnamed: U15.14 (B4), U17.10 (S4)
unnamed: U15.15 (B3), U16.4 (S1)
unnamed: U15.16 (B2), U16.1 (S2)
unnamed: U15.17 (B1), U16.13 (S3)
unnamed: U15.18 (B0), U16.10 (S4)
unnamed: U16.2 (B2), U18.8
unnamed: U16.6 (B1), U18.11
unnamed: U16.7 (C0), U17.9 (C4)
unnamed: U16.11 (B4), U18.3
unnamed: U16.15 (B3), U18.6
unnamed: U17.2 (B2), U19.8
unnamed: U17.6 (B1), U19.11
unnamed: U17.11 (B4), U19.3
unnamed: U17.15 (B3), U19.6
OE: U15.19 (CE)
SUB: U17.7 (C0), U18.2, U18.5, U18.10, U18.13, U19.2, U19.5, U19.10, U19.13
SUM_CARRY_OUT: U16.9 (C4)
VCC: C5.1, U15.20 (VCC), U16.16 (VCC), U17.16 (VCC), U18.14 (VCC), U19.14 (VCC)
Y1: U15.9 (A7)
Y2: U15.8 (A6)
Y3: U15.7 (A5)
Y4: U15.6 (A4)
Y5: U15.5 (A3)
Y6: U15.4 (A2)
Y7: U15.3 (A1)
Y8: U15.2 (A0)

Notes on the sheet:
<— Carry out to next 4 bits
Two’s Compliment
+1 (2’s comp)
