theWickedWebDev/8-bit-computer/other-modules/ALU-DISCRETE-LOGIC/ALU.sch

## KiCad design other-modules/ALU-DISCRETE-LOGIC/ALU.sch (2021-04-29)

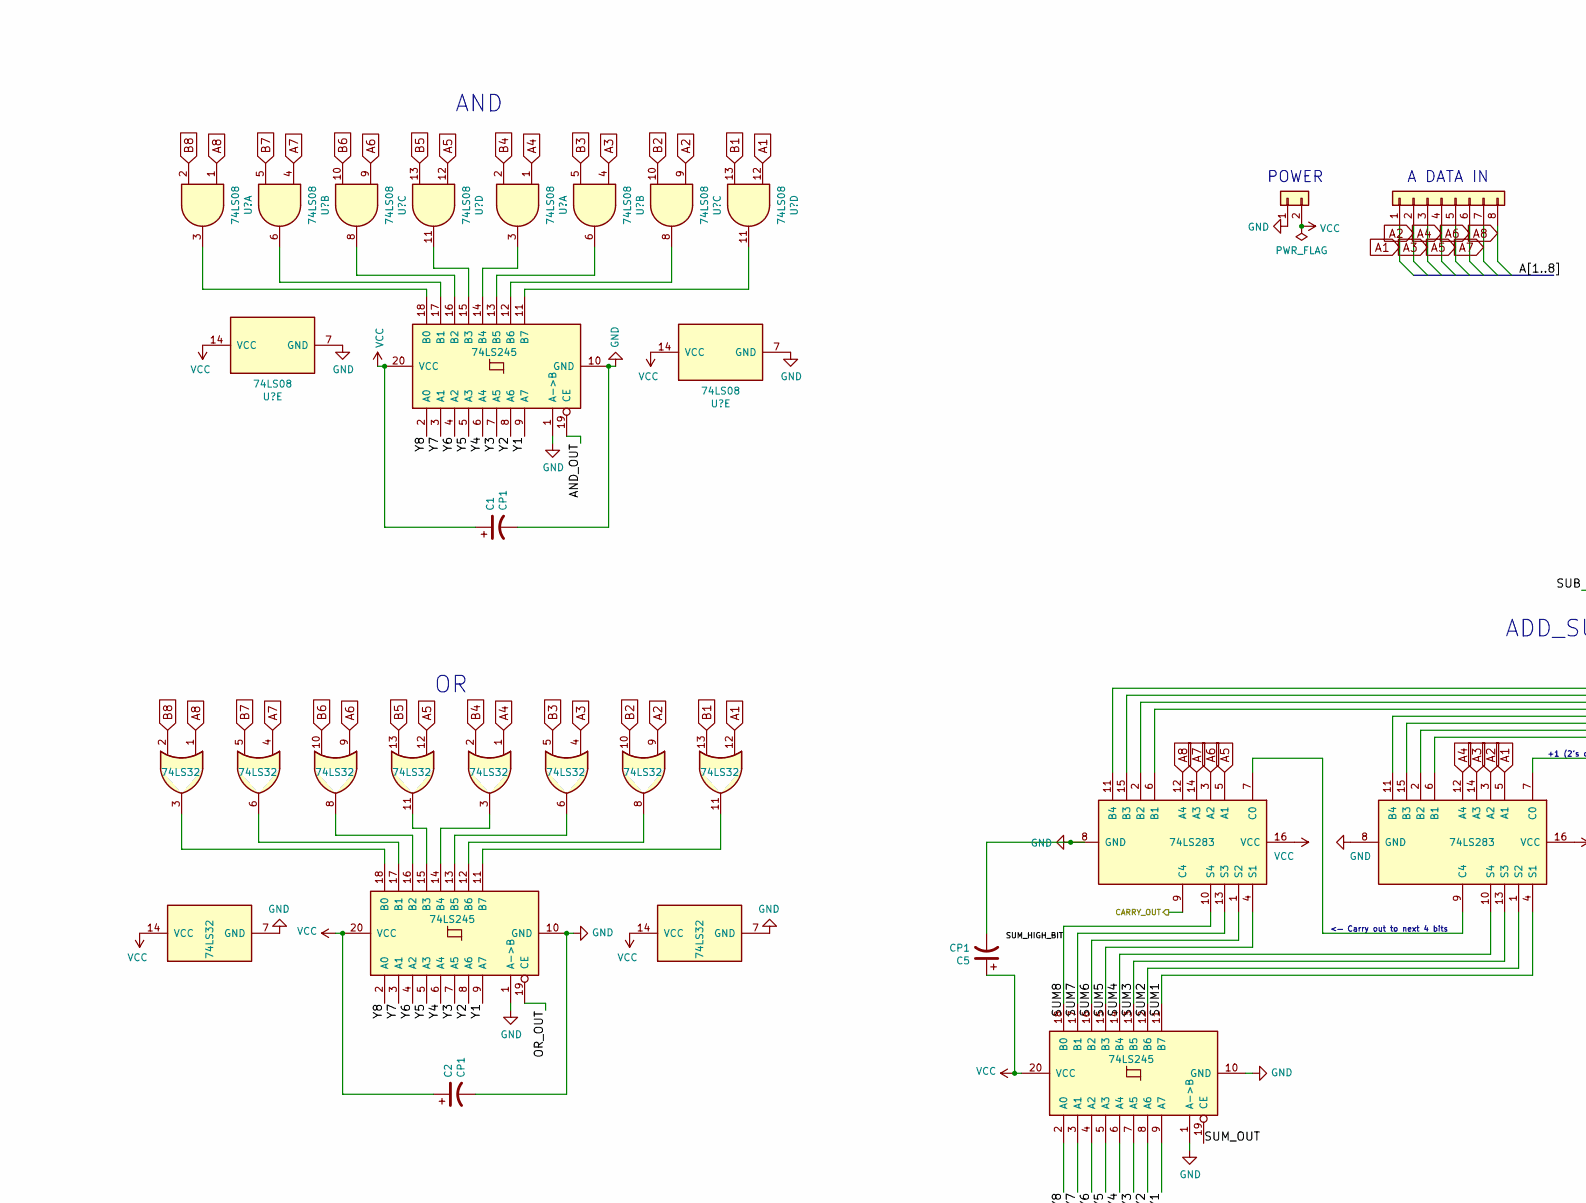
[picture p321: schematic ALU.sch, part in row 1, column 1]

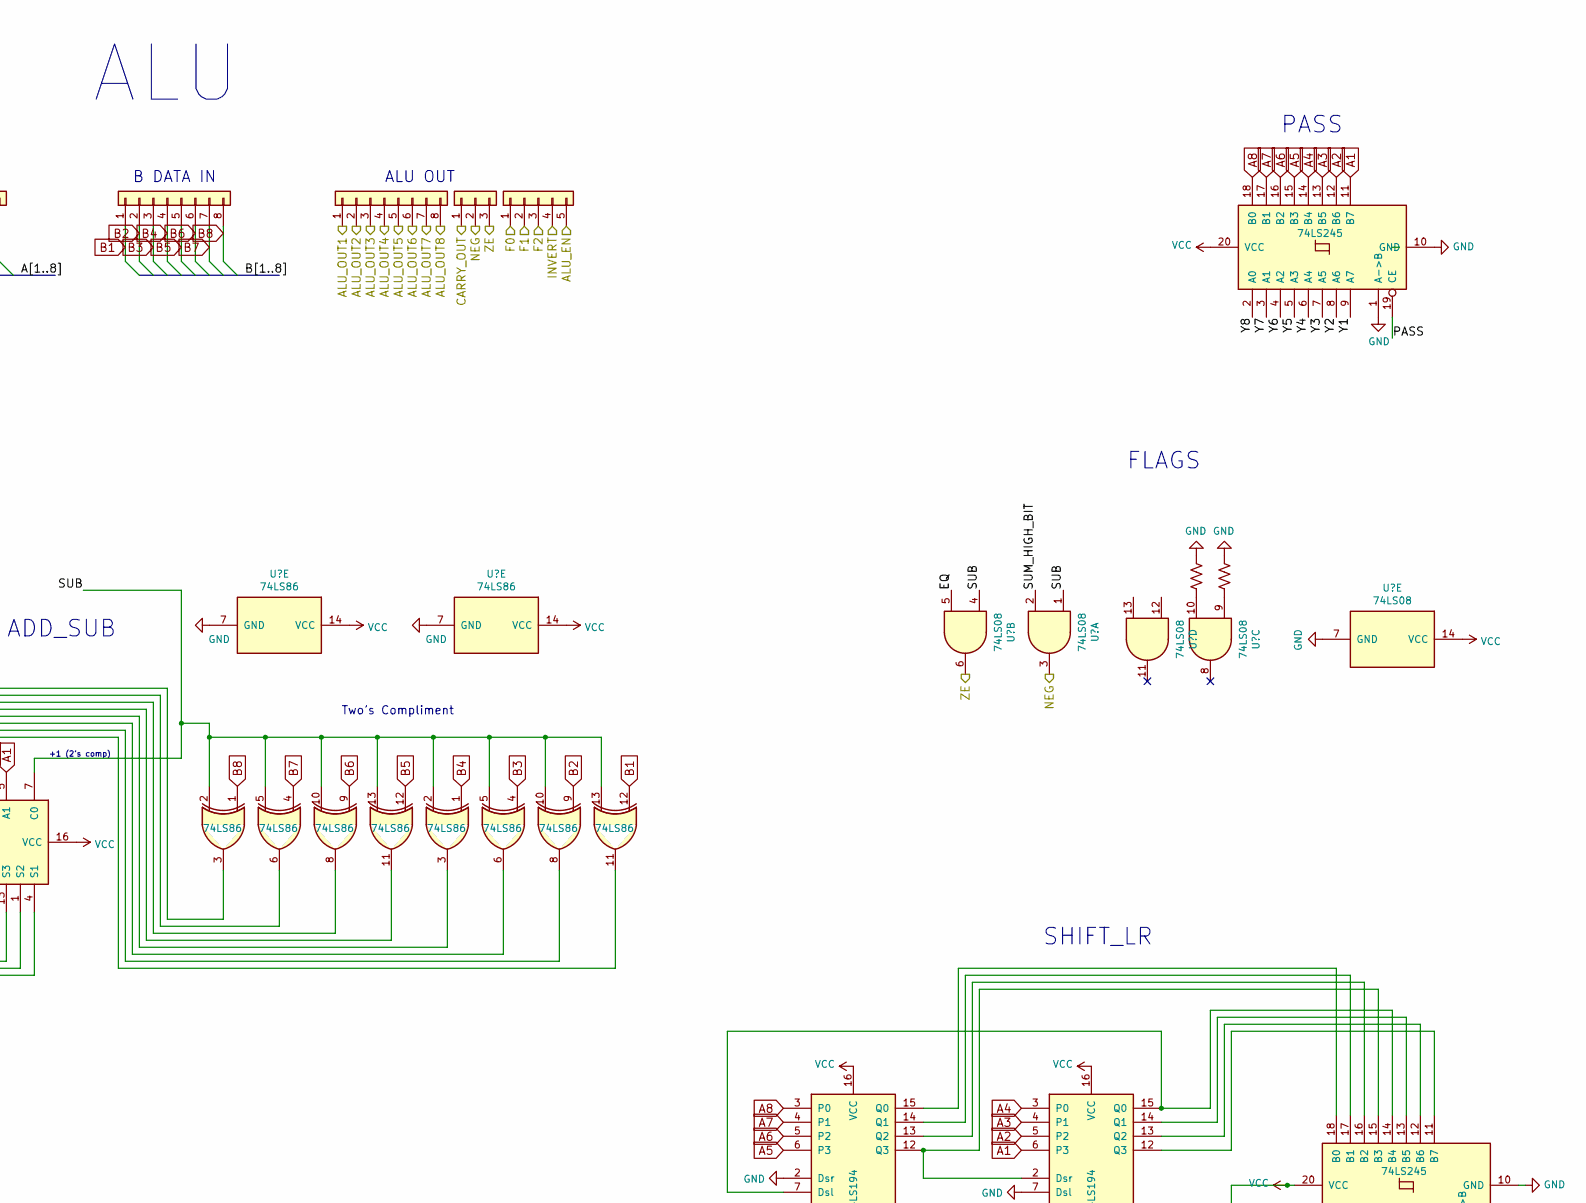
[picture p322: schematic ALU.sch, part in row 1, column 2]

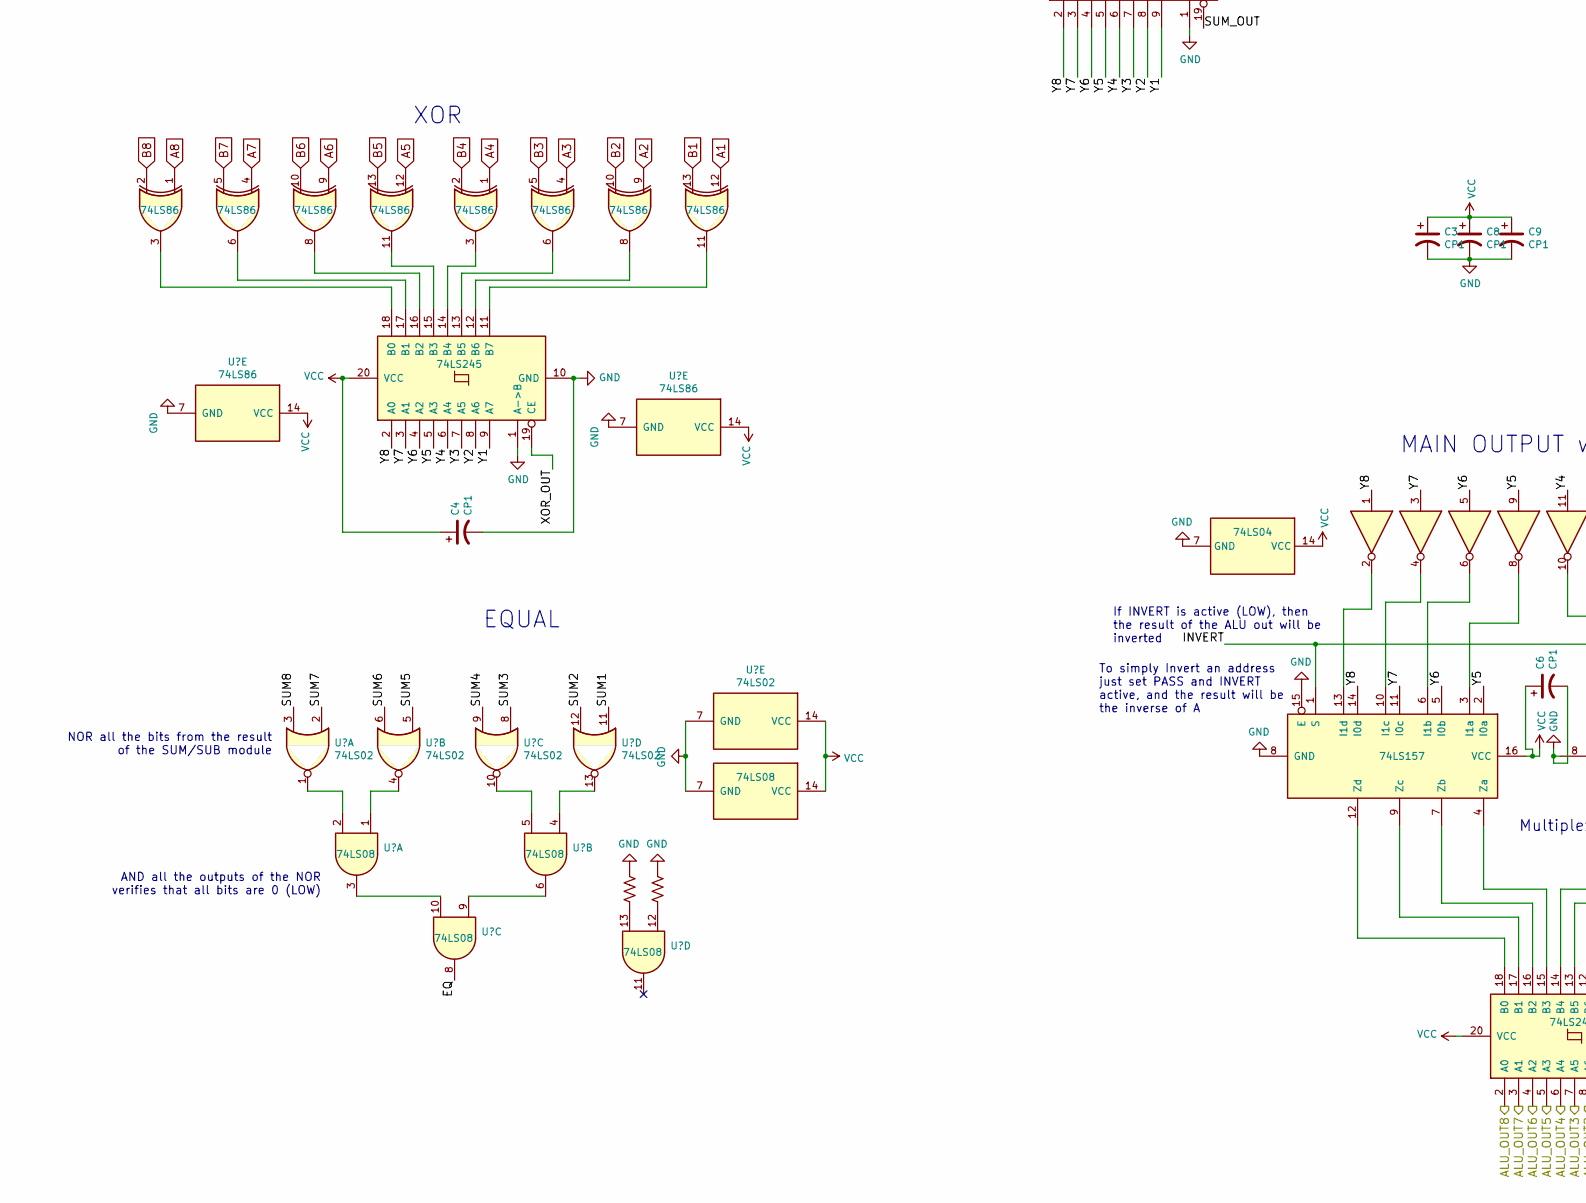
[picture p323: schematic ALU.sch, part in row 2, column 1]

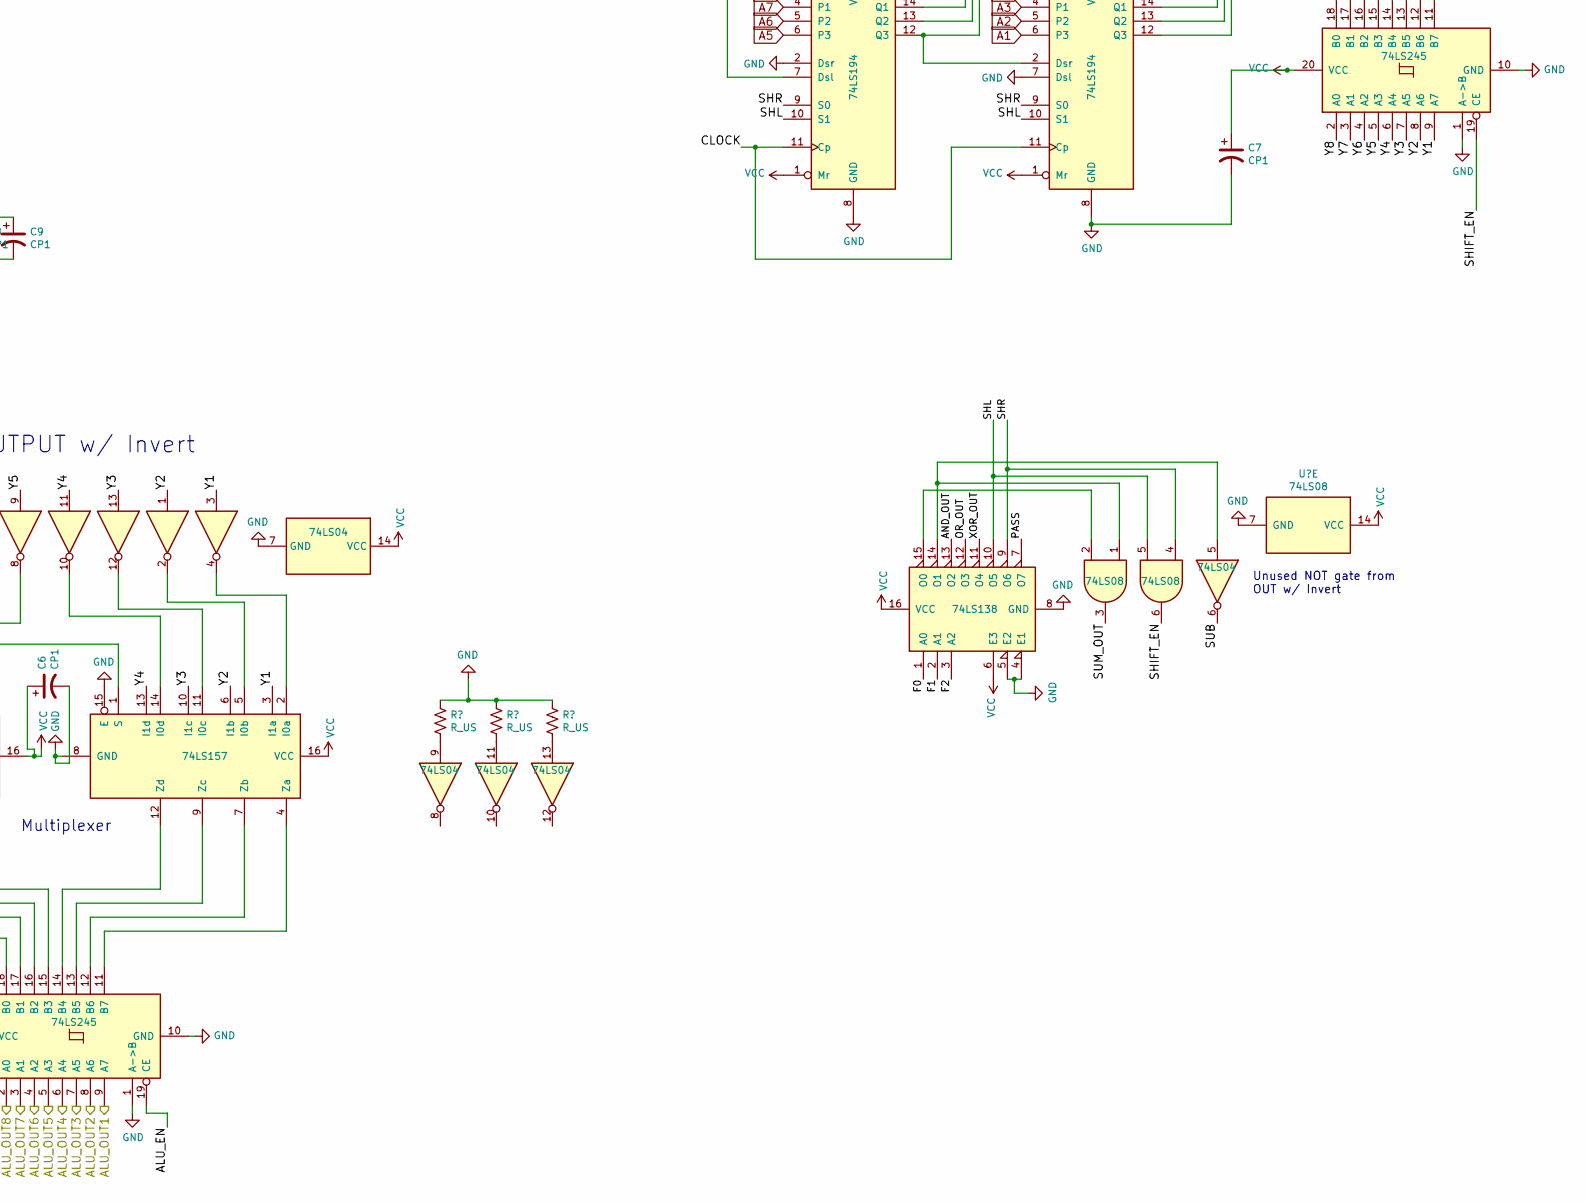
[picture p324: schematic ALU.sch, part in row 2, column 2]

Parts:
C1, C2, C3, C4, C5, C6, C7, C8, C9: CP1; C_Radial_D6.3mm_H11.0mm_P2.50mm
R6, R7, R8, R9, R10, R11, R12: R_US; R_Axial_DIN0207_L6.3mm_D2.5mm_P10.16mm_Horizontal
U1, U7: 74LS08; DIP-14_W7.62mm
U2, U10, U21, U23: 74LS86; DIP-14_W7.62mm
U3, U9: 74LS32; DIP-14_W7.62mm
U5, U6, U8, U13, U14, U24, U28: 74LS245; DIP-20_W7.62mm
U12, U19: 74LS04; DIP-14_W7.62mm
U15, U17: 74LS283; DIP-16_W7.62mm
U16, U20: 74LS157; DIP-16_W7.62mm
U18, U22: 74LS194; DIP-16_W7.62mm

Connections:
A1: U7.12, U9.12, U10.12, U13.11 (B7), U17.5 (A1), U22.6 (P3)
A2: U7.9, U9.9, U10.9, U13.12 (B6), U17.3 (A2), U22.5 (P2)
A3: U7.4, U9.4, U10.4, U13.13 (B5), U17.14 (A3), U22.4 (P1)
A4: U7.1, U9.1, U10.1, U13.14 (B4), U17.12 (A4), U22.3 (P0)
A5: U1.12, U2.12, U3.12, U13.15 (B3), U15.5 (A1), U18.6 (P3)
A6: U1.9, U2.9, U3.9, U13.16 (B2), U15.3 (A2), U18.5 (P2)
A7: U1.4, U2.4, U3.4, U13.17 (B1), U15.14 (A3), U18.4 (P1)
A8: U1.1, U2.1, U3.1, U13.18 (B0), U15.12 (A4), U18.3 (P0)
ALU_EN: U28.19 (CE)
ALU_OUT1: U28.9 (A7)
ALU_OUT2: U28.8 (A6)
ALU_OUT3: U28.7 (A5)
ALU_OUT4: U28.6 (A4)
ALU_OUT5: U28.5 (A3)
ALU_OUT6: U28.4 (A2)
ALU_OUT7: U28.3 (A1)
ALU_OUT8: U28.2 (A0)
AND_OUT: U5.19 (CE)
B1: U7.13, U9.13, U10.13, U23.12
B2: U7.10, U9.10, U10.10, U23.9
B3: U7.5, U9.5, U10.5, U23.4
B4: U7.2, U9.2, U10.2, U23.1
B5: U1.13, U2.13, U3.13, U21.12
B6: U1.10, U2.10, U3.10, U21.9
B7: U1.5, U2.5, U3.5, U21.4
B8: U1.2, U2.2, U3.2, U21.1
CARRY_OUT: U15.9 (C4)
CLOCK: U18.11 (Cp), U22.11 (Cp)
GND: C1.2, C2.2, C3.2, C4.2, C5.2, C6.2, C7.2, C8.2, C9.2, R6.1, R7.1, R8.1, R9.1, R10.1, R11.1, R12.1, U1.7 (GND), U2.7 (GND), U3.7 (GND), U5.1 (A->B), U5.10 (GND), U6.1 (A->B), U6.10 (GND), U7.7 (GND), U8.1 (A->B), U8.10 (GND), U9.7 (GND), U10.7 (GND), U12.7 (GND), U13.1 (A->B), U13.10 (GND), U14.1 (A->B), U14.10 (GND), U15.8 (GND), U16.8 (GND), U16.15 (E), U17.8 (GND), U18.2 (Dsr), U18.8 (GND), U19.7 (GND), U20.8 (GND), U20.15 (E), U21.7 (GND), U22.7 (Dsl), U22.8 (GND), U23.7 (GND), U24.1 (A->B), U24.10 (GND), U28.1 (A->B), U28.10 (GND)
INVERT: U16.1 (S), U20.1 (S)
unnamed: R6.2, U19.9
unnamed: R7.2, U19.11
unnamed: R8.2, U19.13
unnamed: U1.3, U5.18 (B0)
unnamed: U1.6, U5.17 (B1)
unnamed: U1.8, U5.16 (B2)
unnamed: U1.11, U5.15 (B3)
unnamed: U2.3, U8.18 (B0)
unnamed: U2.6, U8.17 (B1)
unnamed: U2.8, U8.16 (B2)
unnamed: U2.11, U8.15 (B3)
unnamed: U3.3, U6.18 (B0)
unnamed: U3.6, U6.17 (B1)
unnamed: U3.8, U6.16 (B2)
unnamed: U3.11, U6.15 (B3)
unnamed: U5.11 (B7), U7.11
unnamed: U5.12 (B6), U7.8
unnamed: U5.13 (B5), U7.6
unnamed: U5.14 (B4), U7.3
unnamed: U6.11 (B7), U9.11
unnamed: U6.12 (B6), U9.8
unnamed: U6.13 (B5), U9.6
unnamed: U6.14 (B4), U9.3
unnamed: U8.14 (B4), U10.3
unnamed: U8.13 (B5), U10.6
unnamed: U8.12 (B6), U10.8
unnamed: U8.11 (B7), U10.11
unnamed: U12.2, U16.13 (I1d)
unnamed: U12.4, U16.10 (I1c)
unnamed: U12.6, U16.6 (I1b)
unnamed: U12.8, U16.3 (I1a)
unnamed: U12.10, U20.14 (I0d)
unnamed: U12.12, U20.11 (I0c)
unnamed: U15.2 (B2), U21.8
unnamed: U15.6 (B1), U21.11
unnamed: U15.7 (C0), U17.9 (C4)
unnamed: U15.11 (B4), U21.3
unnamed: U15.15 (B3), U21.6
unnamed: U16.4 (Za), U28.15 (B3)
unnamed: U16.7 (Zb), U28.16 (B2)
unnamed: U16.9 (Zc), U28.17 (B1)
unnamed: U16.12 (Zd), U28.18 (B0)
unnamed: U17.2 (B2), U23.8
unnamed: U17.6 (B1), U23.11
unnamed: U17.11 (B4), U23.3
unnamed: U17.15 (B3), U23.6
unnamed: U18.7 (Dsl), U22.15 (Q0), U24.14 (B4)
unnamed: U18.12 (Q3), U22.2 (Dsr), U24.15 (B3)
unnamed: U18.13 (Q2), U24.16 (B2)
unnamed: U18.14 (Q1), U24.17 (B1)
unnamed: U18.15 (Q0), U24.18 (B0)
unnamed: U19.2, U20.5 (I0b)
unnamed: U19.4, U20.2 (I0a)
unnamed: U20.4 (Za), U28.11 (B7)
unnamed: U20.7 (Zb), U28.12 (B6)
unnamed: U20.9 (Zc), U28.13 (B5)
unnamed: U20.12 (Zd), U28.14 (B4)
unnamed: U22.12 (Q3), U24.11 (B7)
unnamed: U22.13 (Q2), U24.12 (B6)
unnamed: U22.14 (Q1), U24.13 (B5)
OR_OUT: U6.19 (CE)
PASS: U13.19 (CE)
SHIFT_EN: U24.19 (CE)
SHL: U18.10 (S1), U22.10 (S1)
SHR: U18.9 (S0), U22.9 (S0)
SUB: U17.7 (C0), U19.6, U21.2, U21.5, U21.10, U21.13, U23.2, U23.5, U23.10, U23.13
SUM1: U14.11 (B7), U17.4 (S1)
SUM2: U14.12 (B6), U17.1 (S2)
SUM3: U14.13 (B5), U17.13 (S3)
SUM4: U14.14 (B4), U17.10 (S4)
SUM5: U14.15 (B3), U15.4 (S1)
SUM6: U14.16 (B2), U15.1 (S2)
SUM7: U14.17 (B1), U15.13 (S3)
SUM8: U14.18 (B0), U15.10 (S4)
SUM_OUT: U14.19 (CE)
VCC: C1.1, C2.1, C3.1, C4.1, C5.1, C6.1, C7.1, C8.1, C9.1, U1.14 (VCC), U2.14 (VCC), U3.14 (VCC), U5.20 (VCC), U6.20 (VCC), U7.14 (VCC), U8.20 (VCC), U9.14 (VCC), U10.14 (VCC), U12.14 (VCC), U13.20 (VCC), U14.20 (VCC), U15.16 (VCC), U16.16 (VCC), U17.16 (VCC), U18.1 (Mr), U18.16 (VCC), U19.14 (VCC), U20.16 (VCC), U21.14 (VCC), U22.1 (Mr), U22.16 (VCC), U23.14 (VCC), U24.20 (VCC), U28.20 (VCC)
XOR_OUT: U8.19 (CE)
Y1: U5.9 (A7), U6.9 (A7), U8.9 (A7), U13.9 (A7), U14.9 (A7), U19.3, U20.3 (I1a), U24.9 (A7)
Y2: U5.8 (A6), U6.8 (A6), U8.8 (A6), U13.8 (A6), U14.8 (A6), U19.1, U20.6 (I1b), U24.8 (A6)
Y3: U5.7 (A5), U6.7 (A5), U8.7 (A5), U12.13, U13.7 (A5), U14.7 (A5), U20.10 (I1c), U24.7 (A5)
Y4: U5.6 (A4), U6.6 (A4), U8.6 (A4), U12.11, U13.6 (A4), U14.6 (A4), U20.13 (I1d), U24.6 (A4)
Y5: U5.5 (A3), U6.5 (A3), U8.5 (A3), U12.9, U13.5 (A3), U14.5 (A3), U16.2 (I0a), U24.5 (A3)
Y6: U5.4 (A2), U6.4 (A2), U8.4 (A2), U12.5, U13.4 (A2), U14.4 (A2), U16.5 (I0b), U24.4 (A2)
Y7: U5.3 (A1), U6.3 (A1), U8.3 (A1), U12.3, U13.3 (A1), U14.3 (A1), U16.11 (I0c), U24.3 (A1)
Y8: U5.2 (A0), U6.2 (A0), U8.2 (A0), U12.1, U13.2 (A0), U14.2 (A0), U16.14 (I0d), U24.2 (A0)

Notes on the sheet:
AND
<— Carry out to next 4 bits
Two’s Compliment
+1 (2’s comp)
ADD_SUB
Multiplexer
MAIN OUTPUT w/ Invert
PASS
SHIFT_LR
XOR
A DATA IN
B DATA IN
ALU OUT
ALU
POWER
FLAGS
EQUAL
NOR all the bits from the result of the SUM/SUB module
AND all the outputs of the NOR verifies that all bits are 0 (LOW)
If INVERT is active (LOW), then the result of the ALU out will be inverted
To simply Invert an address just set PASS and INVERT active, and the result will be the inverse of A
Unused NOT gate from OUT w/ Invert
