theWickedWebDev/8-bit-computer/other-modules/ALU-DISCRETE-LOGIC/AND.sch

## KiCad design other-modules/ALU-DISCRETE-LOGIC/AND.sch (2021-04-21)

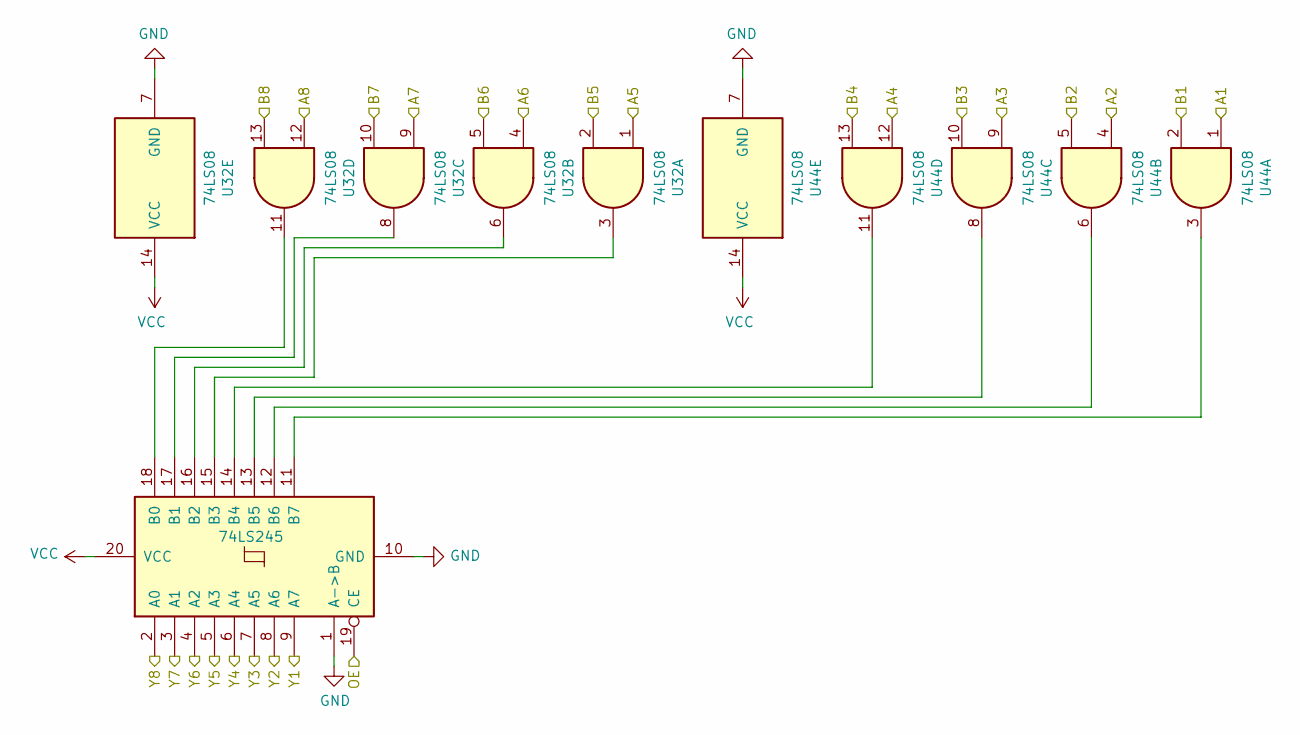
[picture p325: schematic AND.sch]

Parts:
U32, U44: 74LS08; DIP-14_W7.62mm
U33: 74LS245; DIP-20_W7.62mm

Connections:
A1: U44.1
A2: U44.4
A3: U44.9
A4: U44.12
A5: U32.1
A6: U32.4
A7: U32.9
A8: U32.12
B1: U44.2
B2: U44.5
B3: U44.10
B4: U44.13
B5: U32.2
B6: U32.5
B7: U32.10
B8: U32.13
GND: U32.7 (GND), U33.1 (A->B), U33.10 (GND), U44.7 (GND)
unnamed: U32.3, U33.15 (B3)
unnamed: U32.6, U33.16 (B2)
unnamed: U32.8, U33.17 (B1)
unnamed: U32.11, U33.18 (B0)
unnamed: U33.11 (B7), U44.3
unnamed: U33.12 (B6), U44.6
unnamed: U33.13 (B5), U44.8
unnamed: U33.14 (B4), U44.11
OE: U33.19 (CE)
VCC: U32.14 (VCC), U33.20 (VCC), U44.14 (VCC)
Y1: U33.9 (A7)
Y2: U33.8 (A6)
Y3: U33.7 (A5)
Y4: U33.6 (A4)
Y5: U33.5 (A3)
Y6: U33.4 (A2)
Y7: U33.3 (A1)
Y8: U33.2 (A0)
