theWickedWebDev/8-bit-computer/other-modules/ALU-DISCRETE-LOGIC/COMPARE.sch

## KiCad design other-modules/ALU-DISCRETE-LOGIC/COMPARE.sch (2021-04-21)

Schematic: COMPARE.sch

Parts:
D81, D82, D83: LED; LED_D5.0mm
R47, R48, R49, R50: R_US; R_Axial_DIN0207_L6.3mm_D2.5mm_P10.16mm_Horizontal
U59, U60: 74LS85; DIP-16_W7.62mm
