theWickedWebDev/8-bit-computer/other-modules/ALU-DISCRETE-LOGIC/NOT.sch

## KiCad design other-modules/ALU-DISCRETE-LOGIC/NOT.sch (2021-04-21)

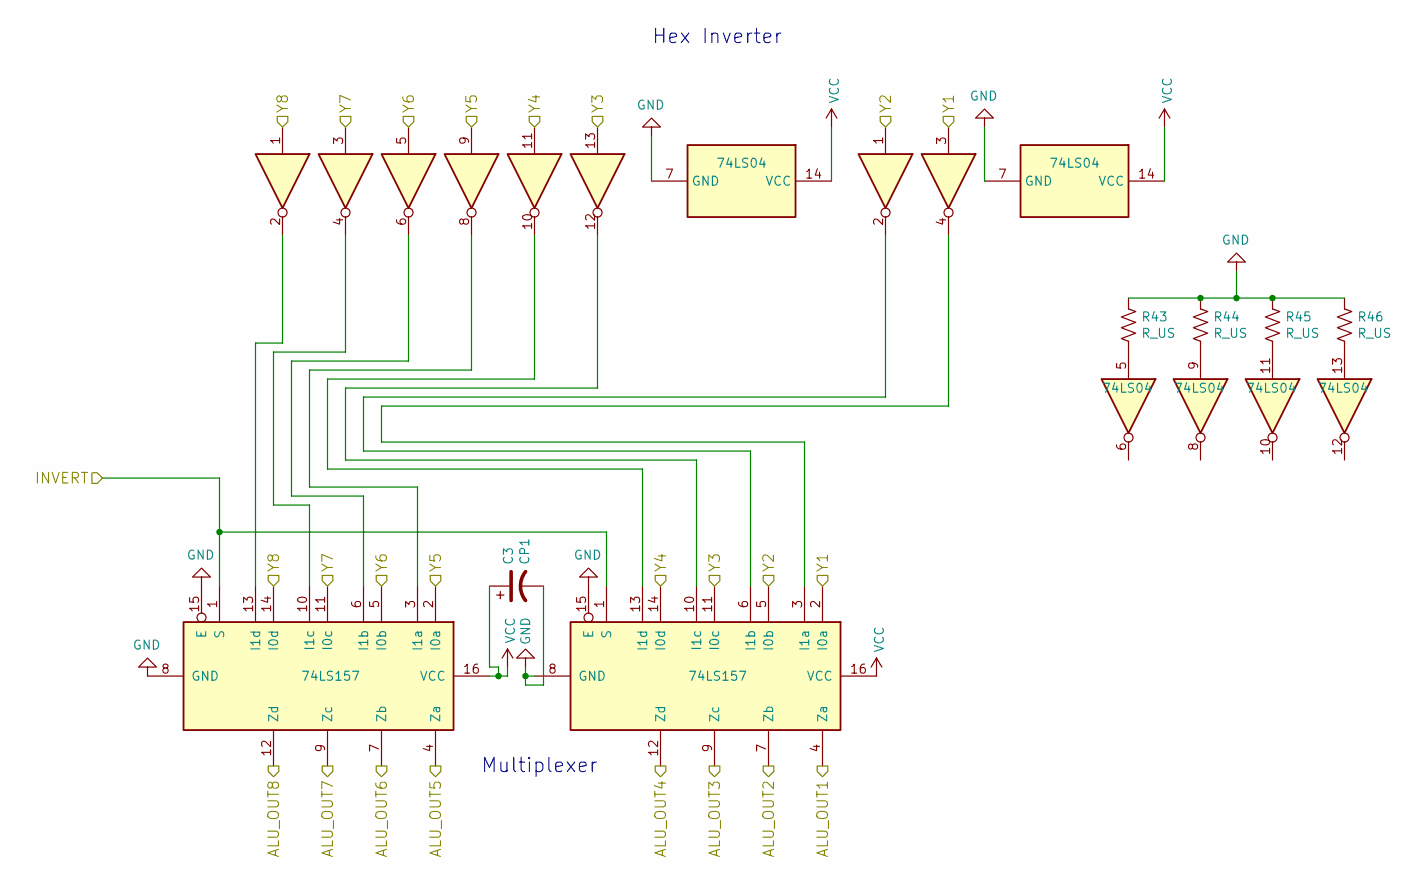
[picture p326: schematic NOT.sch]

Parts:
C2: CP1; C_Radial_D6.3mm_H11.0mm_P2.50mm
R43, R44, R45, R46: R_US; R_Axial_DIN0207_L6.3mm_D2.5mm_P10.16mm_Horizontal
U16, U52, U55, U58: 74LS04; DIP-14_W7.62mm
U56, U57: 74LS157; DIP-16_W7.62mm

Connections:
ALU_OUT1: U57.4 (Za)
ALU_OUT2: U57.7 (Zb)
ALU_OUT3: U57.9 (Zc)
ALU_OUT4: U57.12 (Zd)
ALU_OUT5: U56.4 (Za)
ALU_OUT6: U56.7 (Zb)
ALU_OUT7: U56.9 (Zc)
ALU_OUT8: U56.12 (Zd)
GND: C2.2, R43.1, R44.1, R45.1, R46.1, U52.7 (GND), U55.7 (GND), U56.8 (GND), U56.15 (E), U57.8 (GND), U57.15 (E)
INVERT: U56.1 (S), U57.1 (S)
unnamed: R43.2, U52.5
unnamed: R44.2, U52.9
unnamed: R45.2, U52.11
unnamed: R46.2, U52.13
unnamed: U16.4, U56.10 (I1c)
unnamed: U16.6, U56.6 (I1b)
unnamed: U16.8, U56.3 (I1a)
unnamed: U16.10, U57.13 (I1d)
unnamed: U16.12, U57.10 (I1c)
unnamed: U52.4, U57.3 (I1a)
unnamed: U55.2, U56.13 (I1d)
unnamed: U57.6 (I1b), U58.2
VCC: C2.1, U52.14 (VCC), U55.14 (VCC), U56.16 (VCC), U57.16 (VCC)
Y1: U52.3, U57.2 (I0a)
Y2: U57.5 (I0b), U58.1
Y3: U16.13, U57.11 (I0c)
Y4: U16.11, U57.14 (I0d)
Y5: U16.9, U56.2 (I0a)
Y6: U16.5, U56.5 (I0b)
Y7: U16.3, U56.11 (I0c)
Y8: U55.1, U56.14 (I0d)

Notes on the sheet:
Hex Inverter
Multiplexer
