theWickedWebDev/8-bit-computer/other-modules/ALU-DISCRETE-LOGIC/OR.sch

## KiCad design other-modules/ALU-DISCRETE-LOGIC/OR.sch (2021-04-21)

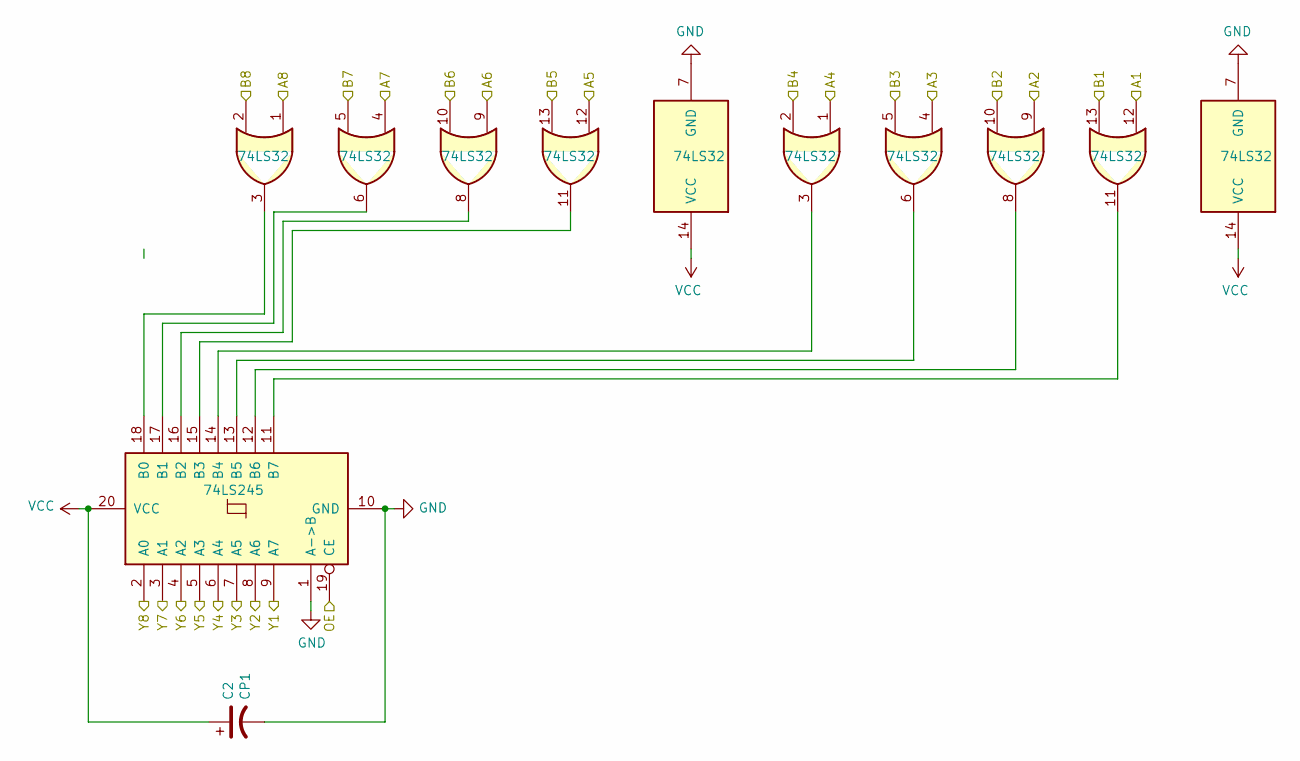
[picture p327: schematic OR.sch]

Parts:
C4: CP1; C_Radial_D6.3mm_H11.0mm_P2.50mm
U4: 74LS245; DIP-20_W7.62mm
U45, U49: 74LS32; DIP-14_W7.62mm

Connections:
A1: U49.12
A2: U49.9
A3: U49.4
A4: U49.1
A5: U45.12
A6: U45.9
A7: U45.4
A8: U45.1
B1: U49.13
B2: U49.10
B3: U49.5
B4: U49.2
B5: U45.13
B6: U45.10
B7: U45.5
B8: U45.2
GND: C4.2, U4.1 (A->B), U4.10 (GND), U45.7 (GND), U49.7 (GND)
unnamed: U4.11 (B7), U49.11
unnamed: U4.12 (B6), U49.8
unnamed: U4.13 (B5), U49.6
unnamed: U4.14 (B4), U49.3
unnamed: U4.15 (B3), U45.11
unnamed: U4.16 (B2), U45.8
unnamed: U4.17 (B1), U45.6
unnamed: U4.18 (B0), U45.3
OE: U4.19 (CE)
VCC: C4.1, U4.20 (VCC), U45.14 (VCC), U49.14 (VCC)
Y1: U4.9 (A7)
Y2: U4.8 (A6)
Y3: U4.7 (A5)
Y4: U4.6 (A4)
Y5: U4.5 (A3)
Y6: U4.4 (A2)
Y7: U4.3 (A1)
Y8: U4.2 (A0)
