theWickedWebDev/8-bit-computer/other-modules/ALU-DISCRETE-LOGIC/SHIFT_LR.sch

## KiCad design other-modules/ALU-DISCRETE-LOGIC/SHIFT_LR.sch (2021-04-21)

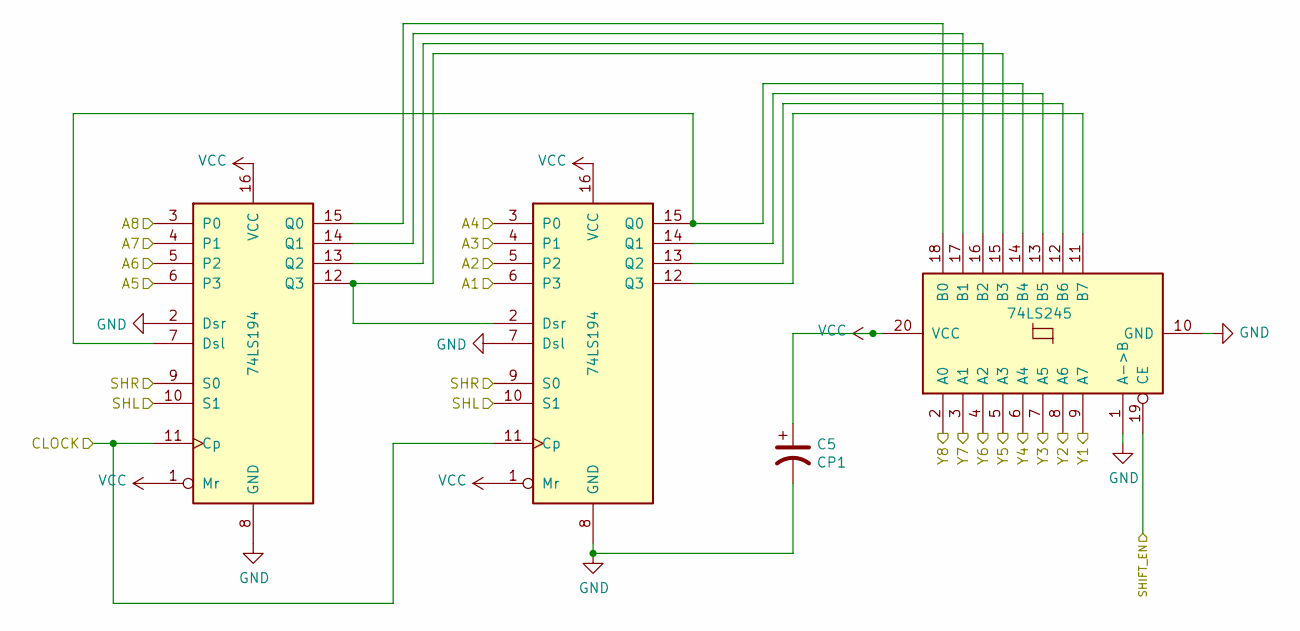
[picture p328: schematic SHIFT_LR.sch]

Parts:
C6: CP1; C_Radial_D6.3mm_H11.0mm_P2.50mm
U23: 74LS245; DIP-20_W7.62mm
U50, U51: 74LS194; DIP-16_W7.62mm

Connections:
A1: U51.6 (P3)
A2: U51.5 (P2)
A3: U51.4 (P1)
A4: U51.3 (P0)
A5: U50.6 (P3)
A6: U50.5 (P2)
A7: U50.4 (P1)
A8: U50.3 (P0)
CLOCK: U50.11 (Cp), U51.11 (Cp)
GND: C6.2, U23.1 (A->B), U23.10 (GND), U50.2 (Dsr), U50.8 (GND), U51.7 (Dsl), U51.8 (GND)
unnamed: U23.11 (B7), U51.12 (Q3)
unnamed: U23.12 (B6), U51.13 (Q2)
unnamed: U23.13 (B5), U51.14 (Q1)
unnamed: U23.14 (B4), U50.7 (Dsl), U51.15 (Q0)
unnamed: U23.15 (B3), U50.12 (Q3), U51.2 (Dsr)
unnamed: U23.16 (B2), U50.13 (Q2)
unnamed: U23.17 (B1), U50.14 (Q1)
unnamed: U23.18 (B0), U50.15 (Q0)
SHIFT_EN: U23.19 (CE)
SHL: U50.10 (S1), U51.10 (S1)
SHR: U50.9 (S0), U51.9 (S0)
VCC: C6.1, U23.20 (VCC), U50.1 (Mr), U50.16 (VCC), U51.1 (Mr), U51.16 (VCC)
Y1: U23.9 (A7)
Y2: U23.8 (A6)
Y3: U23.7 (A5)
Y4: U23.6 (A4)
Y5: U23.5 (A3)
Y6: U23.4 (A2)
Y7: U23.3 (A1)
Y8: U23.2 (A0)
