theWickedWebDev/8-bit-computer/other-modules/ALU-DISCRETE-LOGIC/XOR.sch

## KiCad design other-modules/ALU-DISCRETE-LOGIC/XOR.sch (2021-04-21)

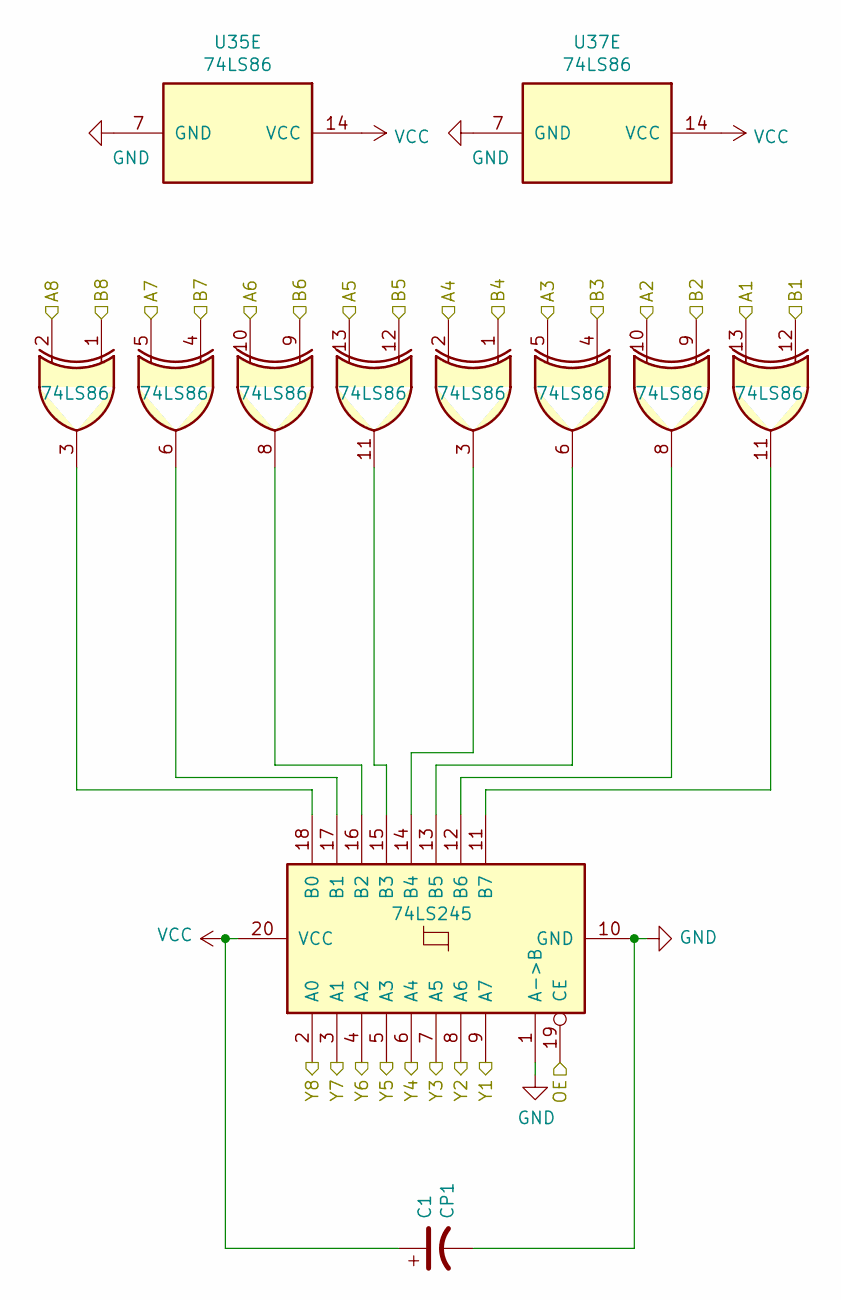
[picture p329: schematic XOR.sch]

Parts:
C1: CP1; C_Radial_D6.3mm_H11.0mm_P2.50mm
U20, U22: 74LS86; DIP-14_W7.62mm
U21: 74LS245; DIP-20_W7.62mm

Connections:
A1: U22.13
A2: U22.10
A3: U22.5
A4: U22.2
A5: U20.13
A6: U20.10
A7: U20.5
A8: U20.2
B1: U22.12
B2: U22.9
B3: U22.4
B4: U22.1
B5: U20.12
B6: U20.9
B7: U20.4
B8: U20.1
GND: C1.2, U20.7 (GND), U21.1 (A->B), U21.10 (GND), U22.7 (GND)
unnamed: U20.3, U21.18 (B0)
unnamed: U20.6, U21.17 (B1)
unnamed: U20.8, U21.16 (B2)
unnamed: U20.11, U21.15 (B3)
unnamed: U21.11 (B7), U22.11
unnamed: U21.12 (B6), U22.8
unnamed: U21.13 (B5), U22.6
unnamed: U21.14 (B4), U22.3
OE: U21.19 (CE)
VCC: C1.1, U20.14 (VCC), U21.20 (VCC), U22.14 (VCC)
Y1: U21.9 (A7)
Y2: U21.8 (A6)
Y3: U21.7 (A5)
Y4: U21.6 (A4)
Y5: U21.5 (A3)
Y6: U21.4 (A2)
Y7: U21.3 (A1)
Y8: U21.2 (A0)
