theWickedWebDev/8-bit-computer/other-modules/BUS_BOARD/bus-board.sch

## KiCad design other-modules/BUS_BOARD/bus-board.sch (2021-04-22)

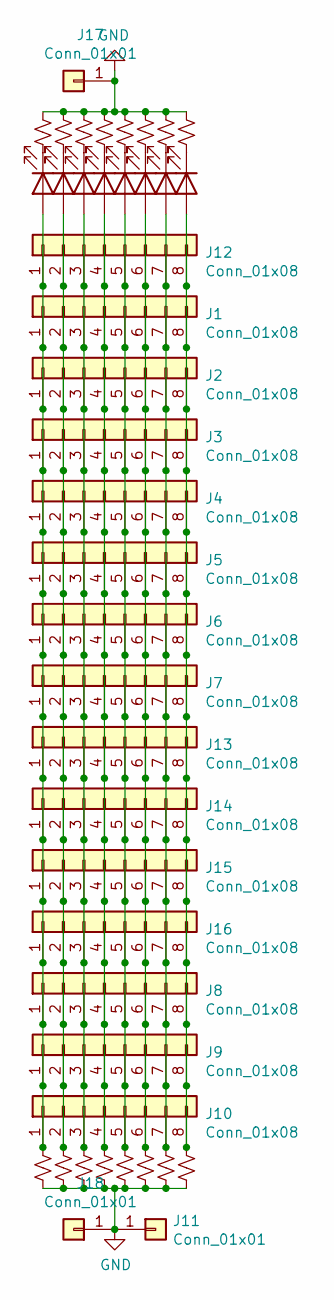
[picture p330: schematic bus-board.sch]

Parts:
D1, D2, D3, D4, D5, D6, D7, D8: LED; LED_D5.0mm
J1, J2, J3, J4, J5, J6, J7, J8, J9, J10, J12, J13, J14, J15, J16: Conn_01x08; PinHeader_1x08_P2.54mm_Vertical
J11, J17, J18: Conn_01x01; PinSocket_1x01_P2.54mm_Vertical
R1, R2, R3, R4, R5, R6, R7, R8, R9, R10, R11, R12, R13, R14, R15, R16: R_Small_US; R_Axial_DIN0207_L6.3mm_D2.5mm_P10.16mm_Horizontal

Connections:
GND: J11.1, J17.1, J18.1, R1.2, R2.2, R3.2, R4.2, R5.2, R6.2, R7.2, R8.2, R9.2, R10.2, R11.2, R12.2, R13.2, R14.2, R15.2, R16.2
unnamed: D1.1 (K), R9.1
unnamed: D1.2 (A), J1.1, J2.1, J3.1, J4.1, J5.1, J6.1, J7.1, J8.1, J9.1, J10.1, J12.1, J13.1, J14.1, J15.1, J16.1, R1.1
unnamed: D2.1 (K), R10.1
unnamed: D2.2 (A), J1.2, J2.2, J3.2, J4.2, J5.2, J6.2, J7.2, J8.2, J9.2, J10.2, J12.2, J13.2, J14.2, J15.2, J16.2, R2.1
unnamed: D3.1 (K), R11.1
unnamed: D3.2 (A), J1.3, J2.3, J3.3, J4.3, J5.3, J6.3, J7.3, J8.3, J9.3, J10.3, J12.3, J13.3, J14.3, J15.3, J16.3, R3.1
unnamed: D4.1 (K), R12.1
unnamed: D4.2 (A), J1.4, J2.4, J3.4, J4.4, J5.4, J6.4, J7.4, J8.4, J9.4, J10.4, J12.4, J13.4, J14.4, J15.4, J16.4, R4.1
unnamed: D5.1 (K), R13.1
unnamed: D5.2 (A), J1.5, J2.5, J3.5, J4.5, J5.5, J6.5, J7.5, J8.5, J9.5, J10.5, J12.5, J13.5, J14.5, J15.5, J16.5, R5.1
unnamed: D6.1 (K), R14.1
unnamed: D6.2 (A), J1.6, J2.6, J3.6, J4.6, J5.6, J6.6, J7.6, J8.6, J9.6, J10.6, J12.6, J13.6, J14.6, J15.6, J16.6, R6.1
unnamed: D7.1 (K), R15.1
unnamed: D7.2 (A), J1.7, J2.7, J3.7, J4.7, J5.7, J6.7, J7.7, J8.7, J9.7, J10.7, J12.7, J13.7, J14.7, J15.7, J16.7, R7.1
unnamed: D8.1 (K), R16.1
unnamed: D8.2 (A), J1.8, J2.8, J3.8, J4.8, J5.8, J6.8, J7.8, J8.8, J9.8, J10.8, J12.8, J13.8, J14.8, J15.8, J16.8, R8.1
