theWickedWebDev/8-bit-computer/other-modules/MULTIPLEXER/MULTIPLEXER.sch

## KiCad design other-modules/MULTIPLEXER/MULTIPLEXER.sch (2021-05-30)

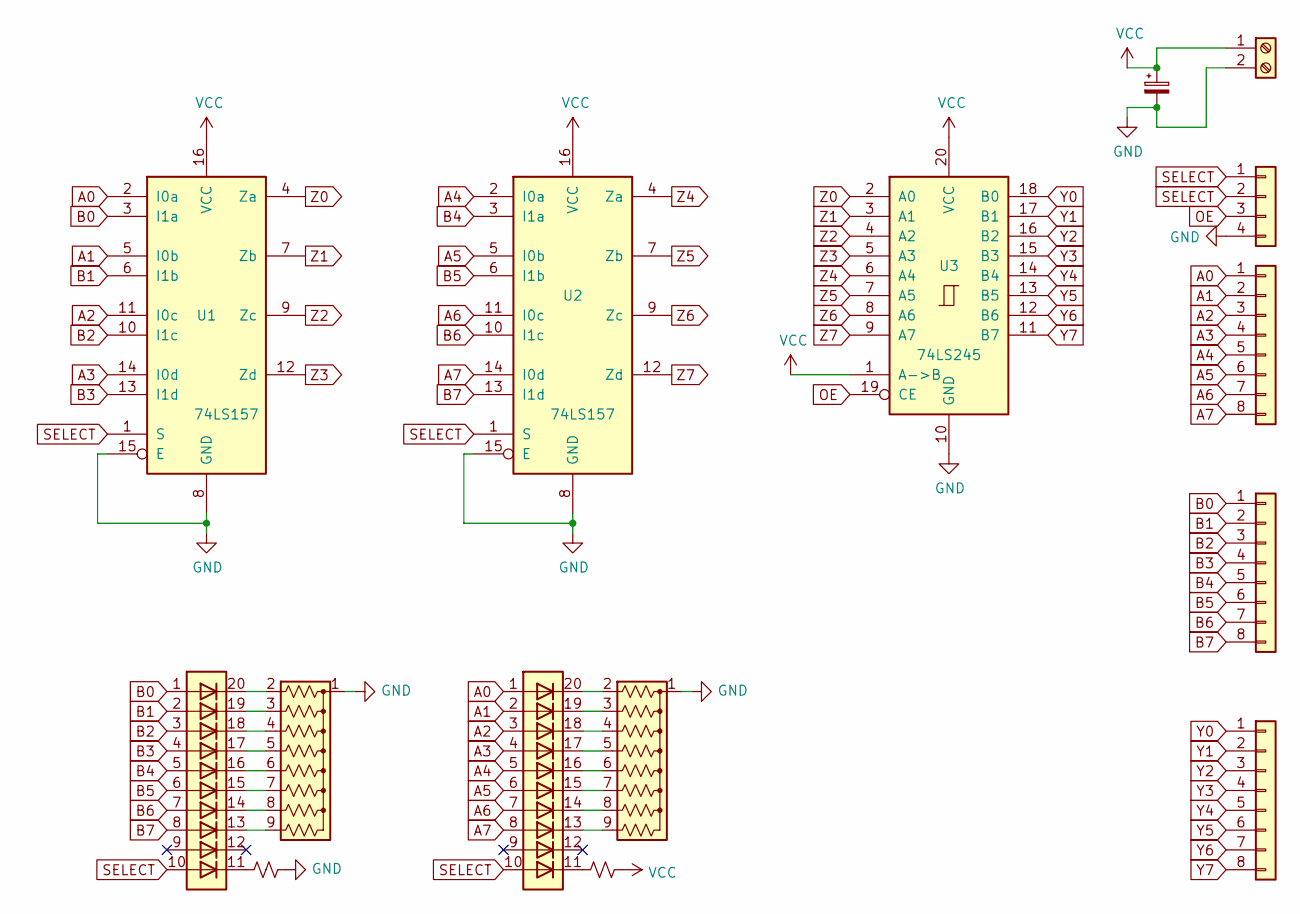
[picture p331: schematic MULTIPLEXER.sch]

Parts:
BAR1, BAR2: HDSP-4830_2; HDSP-4830
C1: CP_Small; CP_Radial_D8.0mm_P3.80mm
J1: Screw_Terminal_01x02; TerminalBlock_Phoenix_MKDS-1,5-2_1x02_P5.00mm_Horizontal
J3: Conn_01x04; PinHeader_1x04_P2.54mm_Vertical
J4, J5, J6: Conn_01x08; PinHeader_1x08_P2.54mm_Vertical
R1, R3: R_Small_US; R_Axial_DIN0207_L6.3mm_D2.5mm_P10.16mm_Horizontal
RN1, RN2: R_Network08_US; R_Array_SIP9
U1, U2: 74LS157; DIP-16_W7.62mm
U3: 74LS245; DIP-20_W7.62mm

Connections:
A0: BAR1.1 (A), J4.1, U1.2 (I0a)
A1: BAR1.2 (A), J4.2, U1.5 (I0b)
A2: BAR1.3 (A), J4.3, U1.11 (I0c)
A3: BAR1.4 (A), J4.4, U1.14 (I0d)
A4: BAR1.5 (A), J4.5, U2.2 (I0a)
A5: BAR1.6 (A), J4.6, U2.5 (I0b)
A6: BAR1.7 (A), J4.7, U2.11 (I0c)
A7: BAR1.8 (A), J4.8, U2.14 (I0d)
B0: BAR2.1 (A), J5.1, U1.3 (I1a)
B1: BAR2.2 (A), J5.2, U1.6 (I1b)
B2: BAR2.3 (A), J5.3, U1.10 (I1c)
B3: BAR2.4 (A), J5.4, U1.13 (I1d)
B4: BAR2.5 (A), J5.5, U2.3 (I1a)
B5: BAR2.6 (A), J5.6, U2.6 (I1b)
B6: BAR2.7 (A), J5.7, U2.10 (I1c)
B7: BAR2.8 (A), J5.8, U2.13 (I1d)
GND: C1.2, J1.2, J3.4, R3.1, RN1.1 (common), RN2.1 (common), U1.8 (GND), U1.15 (E), U2.8 (GND), U2.15 (E), U3.10 (GND)
unnamed: BAR1.11 (K), R1.2
unnamed: BAR1.13 (K), RN1.9 (R8)
unnamed: BAR1.14 (K), RN1.8 (R7)
unnamed: BAR1.15 (K), RN1.7 (R6)
unnamed: BAR1.16 (K), RN1.6 (R5)
unnamed: BAR1.17 (K), RN1.5 (R4)
unnamed: BAR1.18 (K), RN1.4 (R3)
unnamed: BAR1.19 (K), RN1.3 (R2)
unnamed: BAR1.20 (K), RN1.2 (R1)
unnamed: BAR2.11 (K), R3.2
unnamed: BAR2.13 (K), RN2.9 (R8)
unnamed: BAR2.14 (K), RN2.8 (R7)
unnamed: BAR2.15 (K), RN2.7 (R6)
unnamed: BAR2.16 (K), RN2.6 (R5)
unnamed: BAR2.17 (K), RN2.5 (R4)
unnamed: BAR2.18 (K), RN2.4 (R3)
unnamed: BAR2.19 (K), RN2.3 (R2)
unnamed: BAR2.20 (K), RN2.2 (R1)
OE: J3.3, U3.19 (CE)
SELECT: BAR1.10 (A), BAR2.10 (A), J3.1, J3.2, U1.1 (S), U2.1 (S)
VCC: C1.1, J1.1, R1.1, U1.16 (VCC), U2.16 (VCC), U3.1 (A->B), U3.20 (VCC)
Y0: J6.1, U3.18 (B0)
Y1: J6.2, U3.17 (B1)
Y2: J6.3, U3.16 (B2)
Y3: J6.4, U3.15 (B3)
Y4: J6.5, U3.14 (B4)
Y5: J6.6, U3.13 (B5)
Y6: J6.7, U3.12 (B6)
Y7: J6.8, U3.11 (B7)
Z0: U1.4 (Za), U3.2 (A0)
Z1: U1.7 (Zb), U3.3 (A1)
Z2: U1.9 (Zc), U3.4 (A2)
Z3: U1.12 (Zd), U3.5 (A3)
Z4: U2.4 (Za), U3.6 (A4)
Z5: U2.7 (Zb), U3.7 (A5)
Z6: U2.9 (Zc), U3.8 (A6)
Z7: U2.12 (Zd), U3.9 (A7)
