theWickedWebDev/8-bit-computer/other-modules/PLAYER_CONTROLLER/PLAYER_CONTROLLER.sch

## KiCad design other-modules/PLAYER_CONTROLLER/PLAYER_CONTROLLER.sch (2021-06-15)

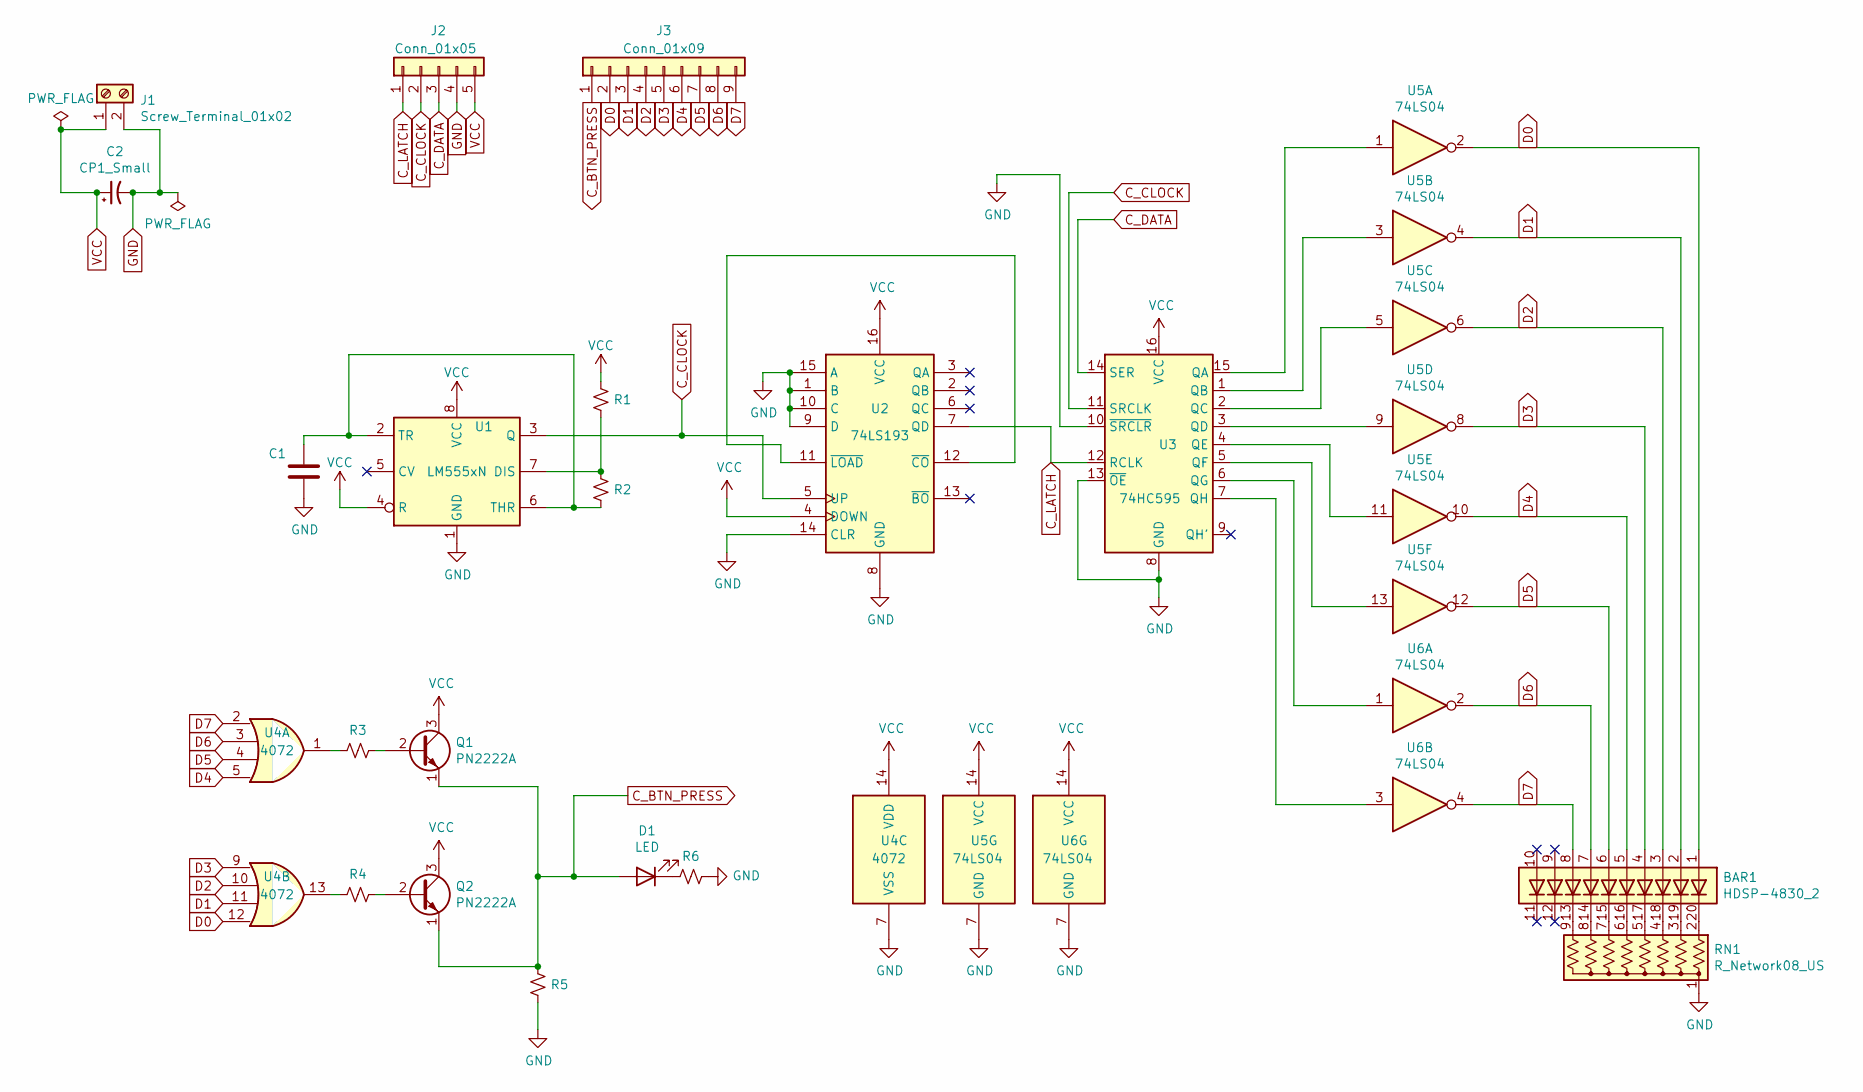
[picture p332: schematic PLAYER_CONTROLLER.sch]

Parts:
BAR1: HDSP-4830_2; HDSP-4830
C1: CP1_Small; C_Disc_D3.8mm_W2.6mm_P2.50mm
C2: CP1_Small; CP_Radial_D5.0mm_P2.50mm
D1: LED; LED_D5.0mm
J1: Screw_Terminal_01x02; TerminalBlock_Phoenix_MKDS-1,5-2_1x02_P5.00mm_Horizontal
J2: Conn_01x05; PinHeader_1x05_P2.54mm_Vertical
J3: Conn_01x09; PinHeader_1x09_P2.54mm_Vertical
Q1, Q2: PN2222A; TO-92_Inline
R1, R2, R3, R4, R5, R6: R_Small_US; R_Axial_DIN0207_L6.3mm_D2.5mm_P10.16mm_Horizontal
RN1: R_Network08_US; R_Array_SIP9
U1: LM555xN; DIP-8_W7.62mm
U2: 74LS193; DIP-16_W7.62mm
U3: 74HC595; DIP-16_W7.62mm
U4: 4072; DIP-14_W7.62mm
U5, U6: 74LS04; DIP-14_W7.62mm

Connections:
C_BTN_PRESS: D1.2 (A), J3.1, Q1.1 (E), Q2.1 (E), R5.1
C_CLOCK: J2.2, U1.3 (Q), U2.5 (UP), U3.11 (SRCLK)
C_DATA: J2.3, U3.14 (SER)
C_LATCH: J2.1, U2.7 (QD), U3.12 (RCLK)
D0: BAR1.1 (A), J3.2, U4.12, U5.2
D1: BAR1.2 (A), J3.3, U4.11, U5.4
D2: BAR1.3 (A), J3.4, U4.10, U5.6
D3: BAR1.4 (A), J3.5, U4.9, U5.8
D4: BAR1.5 (A), J3.6, U4.5, U5.10
D5: BAR1.6 (A), J3.7, U4.4, U5.12
D6: BAR1.7 (A), J3.8, U4.3, U6.2
D7: BAR1.8 (A), J3.9, U4.2, U6.4
GND: C1.2, C2.2, J1.2, J2.4, R5.2, R6.1, RN1.1 (common), U1.1 (GND), U2.1 (B), U2.8 (GND), U2.9 (D), U2.10 (C), U2.14 (CLR), U2.15 (A), U3.8 (GND), U3.10 (~SRCLR), U3.13 (~OE), U4.7 (VSS), U5.7 (GND), U6.7 (GND)
unnamed: BAR1.13 (K), RN1.9 (R8)
unnamed: BAR1.14 (K), RN1.8 (R7)
unnamed: BAR1.15 (K), RN1.7 (R6)
unnamed: BAR1.16 (K), RN1.6 (R5)
unnamed: BAR1.17 (K), RN1.5 (R4)
unnamed: BAR1.18 (K), RN1.4 (R3)
unnamed: BAR1.19 (K), RN1.3 (R2)
unnamed: BAR1.20 (K), RN1.2 (R1)
unnamed: C1.1, R2.2, U1.2 (TR), U1.6 (THR)
unnamed: D1.1 (K), R6.2
unnamed: Q1.2 (B), R3.1
unnamed: Q2.2 (B), R4.1
unnamed: R1.2, R2.1, U1.7 (DIS)
unnamed: R3.2, U4.1
unnamed: R4.2, U4.13
unnamed: U2.11 (~LOAD), U2.12 (~CO)
unnamed: U3.1 (QB), U5.3
unnamed: U3.2 (QC), U5.5
unnamed: U3.3 (QD), U5.9
unnamed: U3.4 (QE), U5.11
unnamed: U3.5 (QF), U5.13
unnamed: U3.6 (QG), U6.1
unnamed: U3.7 (QH), U6.3
unnamed: U3.15 (QA), U5.1
VCC: C2.1, J1.1, J2.5, Q1.3 (C), Q2.3 (C), R1.1, U1.4 (R), U1.8 (VCC), U2.4 (DOWN), U2.16 (VCC), U3.16 (VCC), U4.14 (VDD), U5.14 (VCC), U6.14 (VCC)
