theWickedWebDev/8-bit-computer/other-modules/POWER/POWER.sch

## KiCad design other-modules/POWER/POWER.sch (2021-05-08)

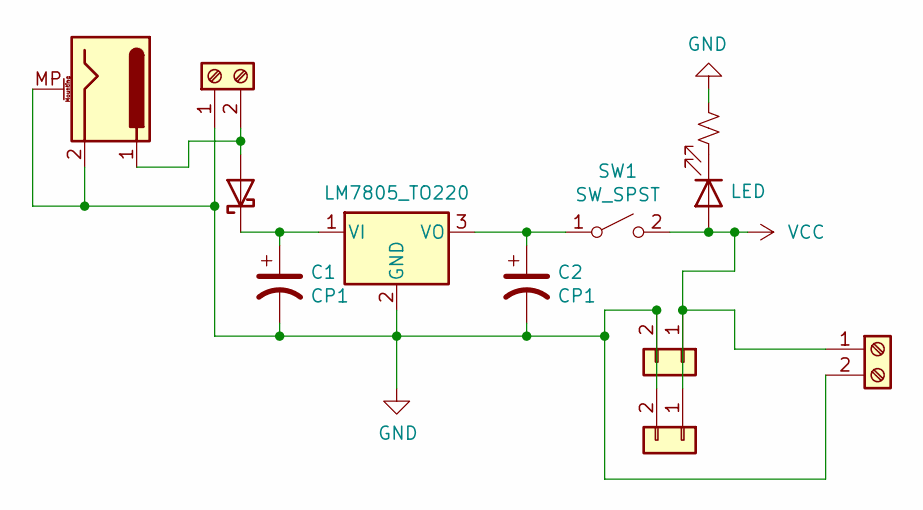
[picture p333: schematic POWER.sch]

Parts:
C1, C2: CP1; CP_Radial_D5.0mm_P2.50mm
D1: D_Schottky; D_DO-34_SOD68_P7.62mm_Horizontal
D2: LED; LED_D3.0mm
J1, J4: Screw_Terminal_01x02; TerminalBlock_Phoenix_MKDS-1,5-2_1x02_P5.00mm_Horizontal
J2: Conn_01x02; PinHeader_1x02_P2.54mm_Horizontal
J3: Conn_01x02; PinHeader_1x02_P2.54mm_Vertical
J5: Barrel_Jack_MountingPin; BarrelJack_Horizontal
R1: R_Small_US; R_Axial_DIN0207_L6.3mm_D2.5mm_P10.16mm_Horizontal
SW1: SW_SPST; SW_DIP_SPSTx01_Slide_9.78x4.72mm_W7.62mm_P2.54mm
U1: LM7805_TO220; TO-220-3_Vertical

Connections:
GND: C1.2, C2.2, J1.1, J2.2, J3.2, J4.2, J5.2, J5.MP (MountPin), R1.2, U1.2 (GND)
unnamed: C1.1, D1.1 (K), U1.1 (VI)
unnamed: C2.1, SW1.1 (A), U1.3 (VO)
unnamed: D1.2 (A), J1.2, J5.1
unnamed: D2.1 (K), R1.1
VCC: D2.2 (A), J2.1, J3.1, J4.1, SW1.2 (B)
