theWickedWebDev/8-bit-computer/Modules/display-module/SMD/DISPLAY.sch

## KiCad design Modules/display-module/SMD/DISPLAY.sch (2021-04-21)

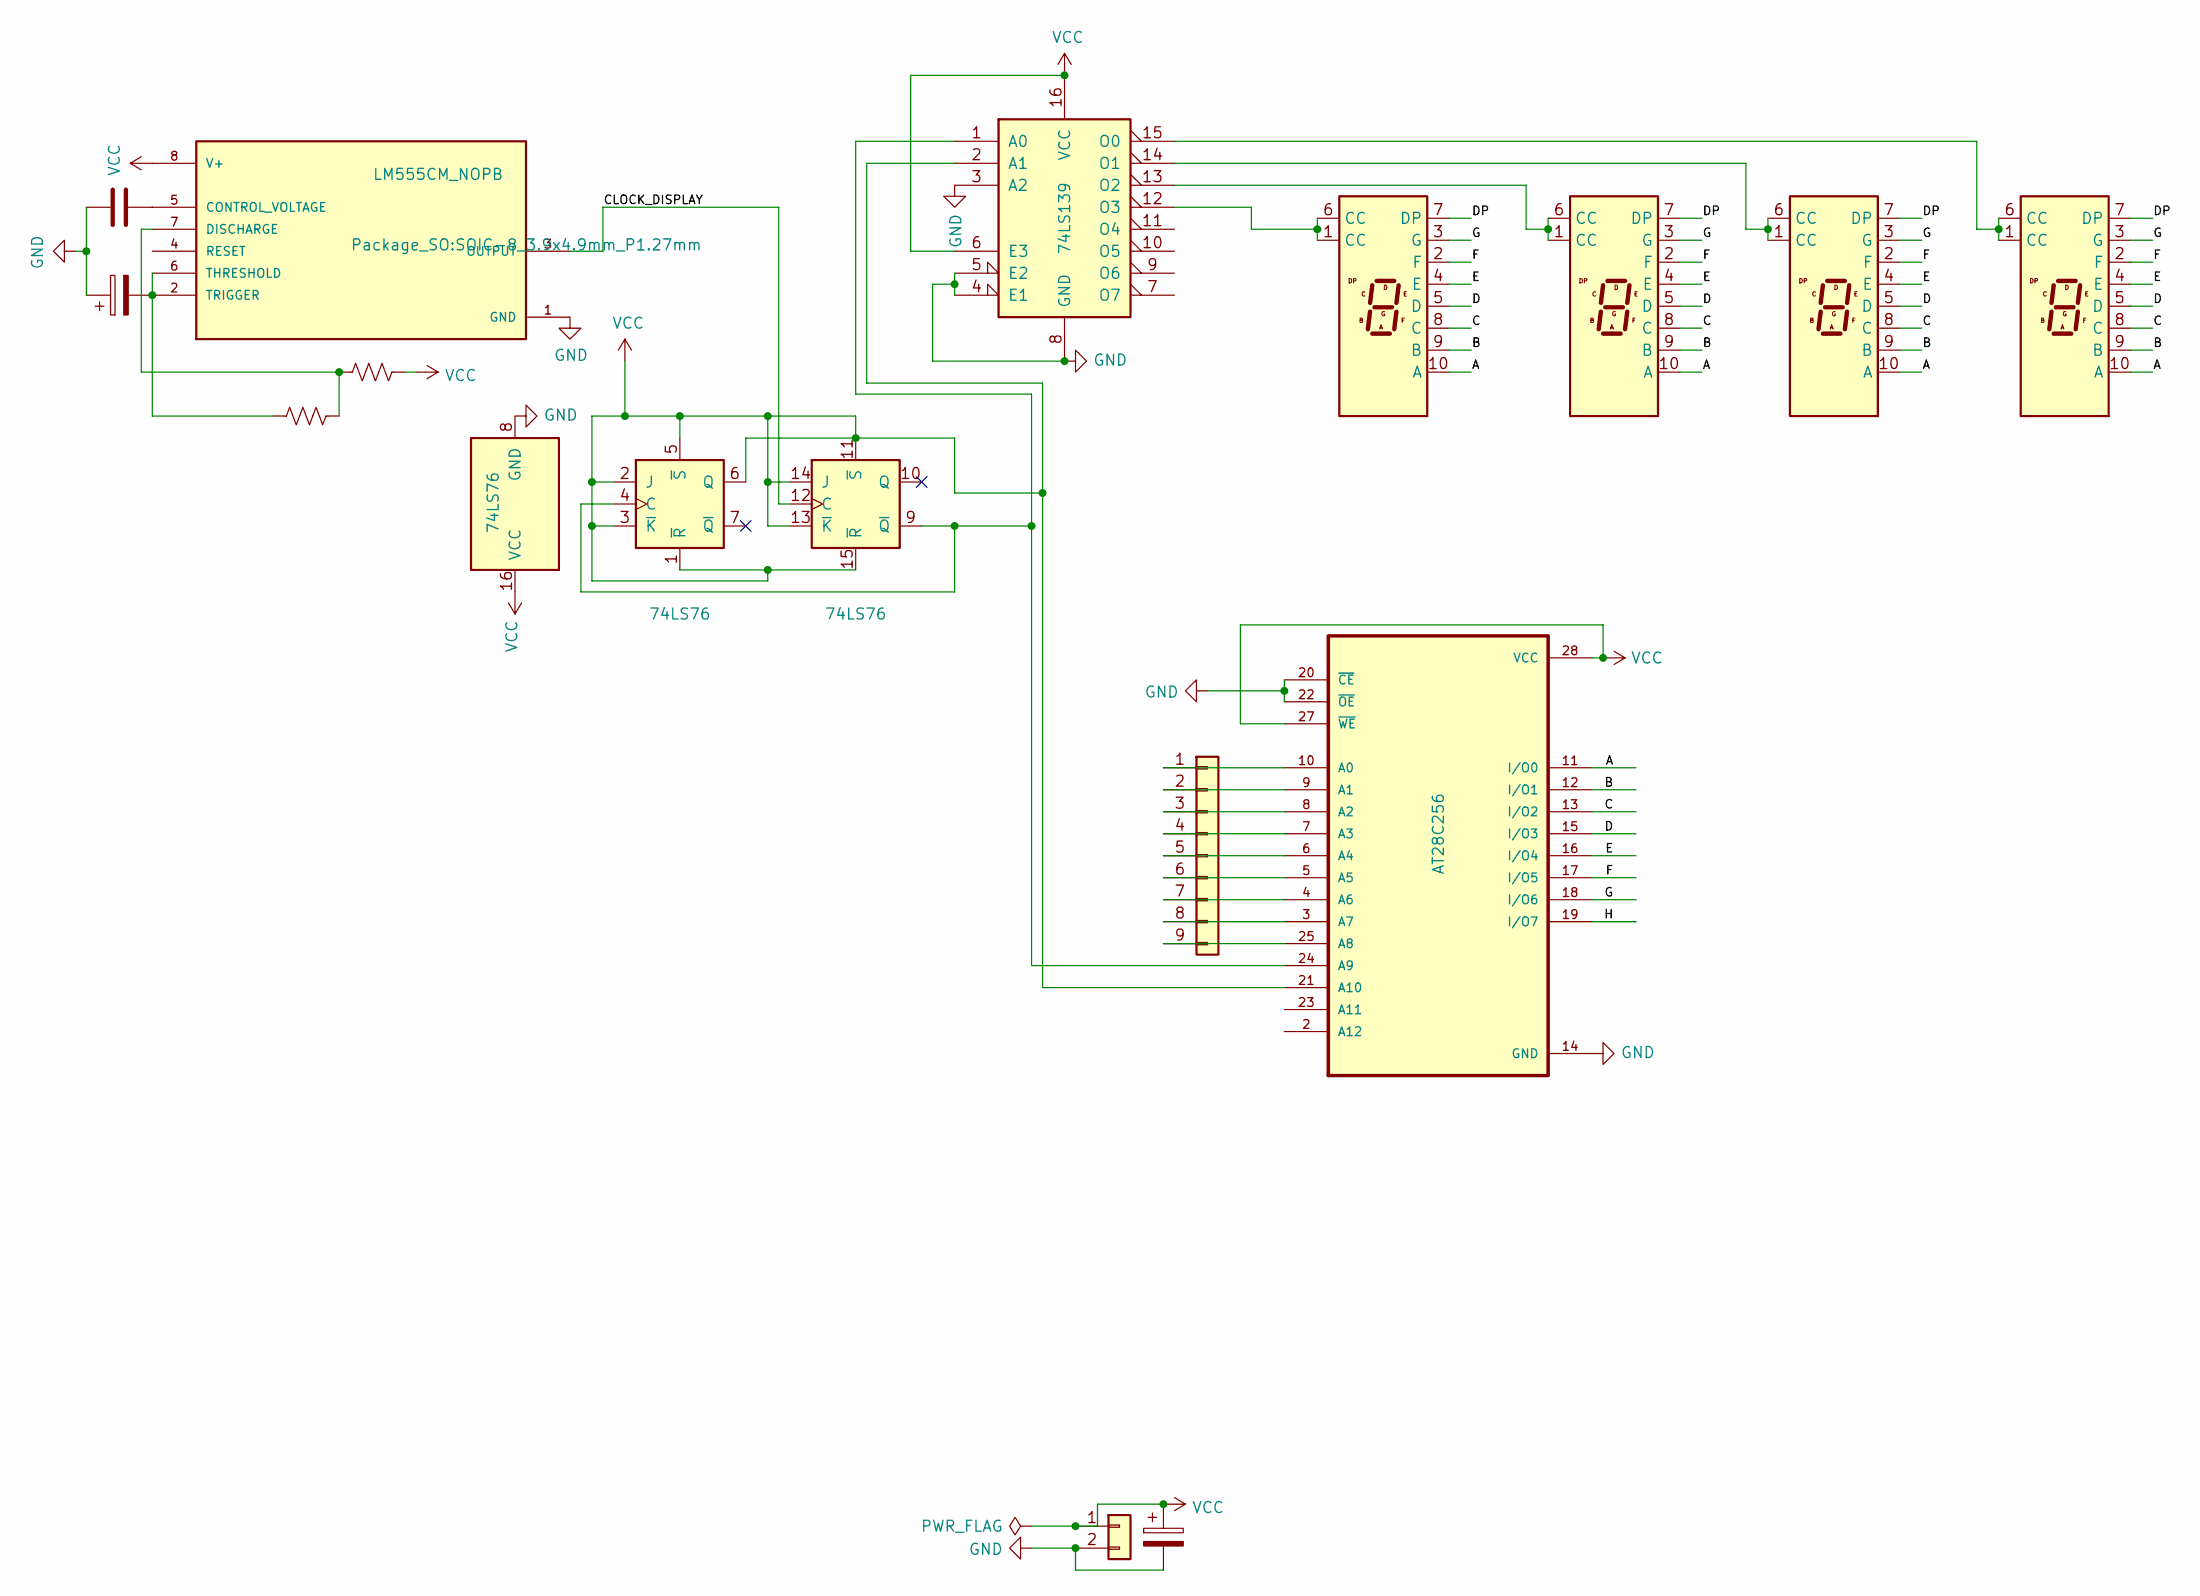
[picture p334: schematic DISPLAY.sch]

Parts:
C1, C3: CP; C_Elec_3x5.4
C2: C; C_Elec_3x5.4
J1: Conn_01x09; PinHeader_1x09_P2.54mm_Vertical
J16: Conn_01x04; PinHeader_1x02_P2.54mm_Vertical
R1, R2: R_US; R_0805_2012Metric
U1: LM555CM_NOPB; SOIC-8_3.9x4.9mm_P1.27mm; PARTREV D
U2: 74LS76; SOIC-16_3.9x9.9mm_P1.27mm
U4: 74LS139; SOIC-16_3.9x9.9mm_P1.27mm
U6, U7, U8, U10: HDSP-7503; 7SegmentLED_LTS6760_LTS6780
U9: AT28C256; SOIC-28W_7.5x17.9mm_P1.27mm

Connections:
A: U6.10 (A), U7.10 (A), U8.10 (A), U9.11 (I/O0), U10.10 (A)
B: U6.9 (B), U7.9 (B), U8.9 (B), U9.12 (I/O1), U10.9 (B)
C: U6.8 (C), U7.8 (C), U8.8 (C), U9.13 (I/O2), U10.8 (C)
CLOCK_DISPLAY: U1.3 (OUTPUT), U2.12 (C)
D: U6.5 (D), U7.5 (D), U8.5 (D), U9.15 (I/O3), U10.5 (D)
DP: U6.7 (DP), U7.7 (DP), U8.7 (DP), U10.7 (DP)
E: U6.4 (E), U7.4 (E), U8.4 (E), U9.16 (I/O4), U10.4 (E)
F: U6.2 (F), U7.2 (F), U8.2 (F), U9.17 (I/O5), U10.2 (F)
G: U6.3 (G), U7.3 (G), U8.3 (G), U9.18 (I/O6), U10.3 (G)
GND: C1.1, C2.2, C3.2, J16.2, U1.1 (GND), U2.8 (GND), U4.3 (A2), U4.4 (E1), U4.5 (E2), U4.8 (GND), U9.14 (GND), U9.20 (~CE), U9.22 (~OE)
H: U9.19 (I/O7)
unnamed: C1.2, R1.2, U1.2 (TRIGGER), U1.6 (THRESHOLD)
unnamed: C2.1, U1.5 (CONTROL_VOLTAGE)
unnamed: J1.1, U9.10 (A0)
unnamed: J1.2, U9.9 (A1)
unnamed: J1.3, U9.8 (A2)
unnamed: J1.4, U9.7 (A3)
unnamed: J1.5, U9.6 (A4)
unnamed: J1.6, U9.5 (A5)
unnamed: J1.7, U9.4 (A6)
unnamed: J1.8, U9.3 (A7)
unnamed: J1.9, U9.25 (A8)
unnamed: R1.1, R2.1, U1.7 (DISCHARGE)
unnamed: U2.4 (C), U2.9 (~Q), U4.1 (A0), U9.24 (A9)
unnamed: U4.12 (O3), U6.1 (CC), U6.6 (CC)
unnamed: U4.13 (O2), U7.1 (CC), U7.6 (CC)
unnamed: U4.14 (O1), U8.1 (CC), U8.6 (CC)
unnamed: U4.15 (O0), U10.1 (CC), U10.6 (CC)
VCC: C3.1, J16.1, R2.2, U1.8 (V+), U2.1 (~R), U2.2 (J), U2.3 (~K), U2.5 (~S), U2.6 (Q), U2.11 (~S), U2.13 (~K), U2.14 (J), U2.15 (~R), U2.16 (VCC), U4.2 (A1), U4.6 (E3), U4.16 (VCC), U9.21 (A10), U9.27 (~WE), U9.28 (VCC)
