theWickedWebDev/8-bit-computer/Modules/storage-register/Kicad/REGISTER.sch

## KiCad design Modules/storage-register/Kicad/REGISTER.sch (2021-06-15)

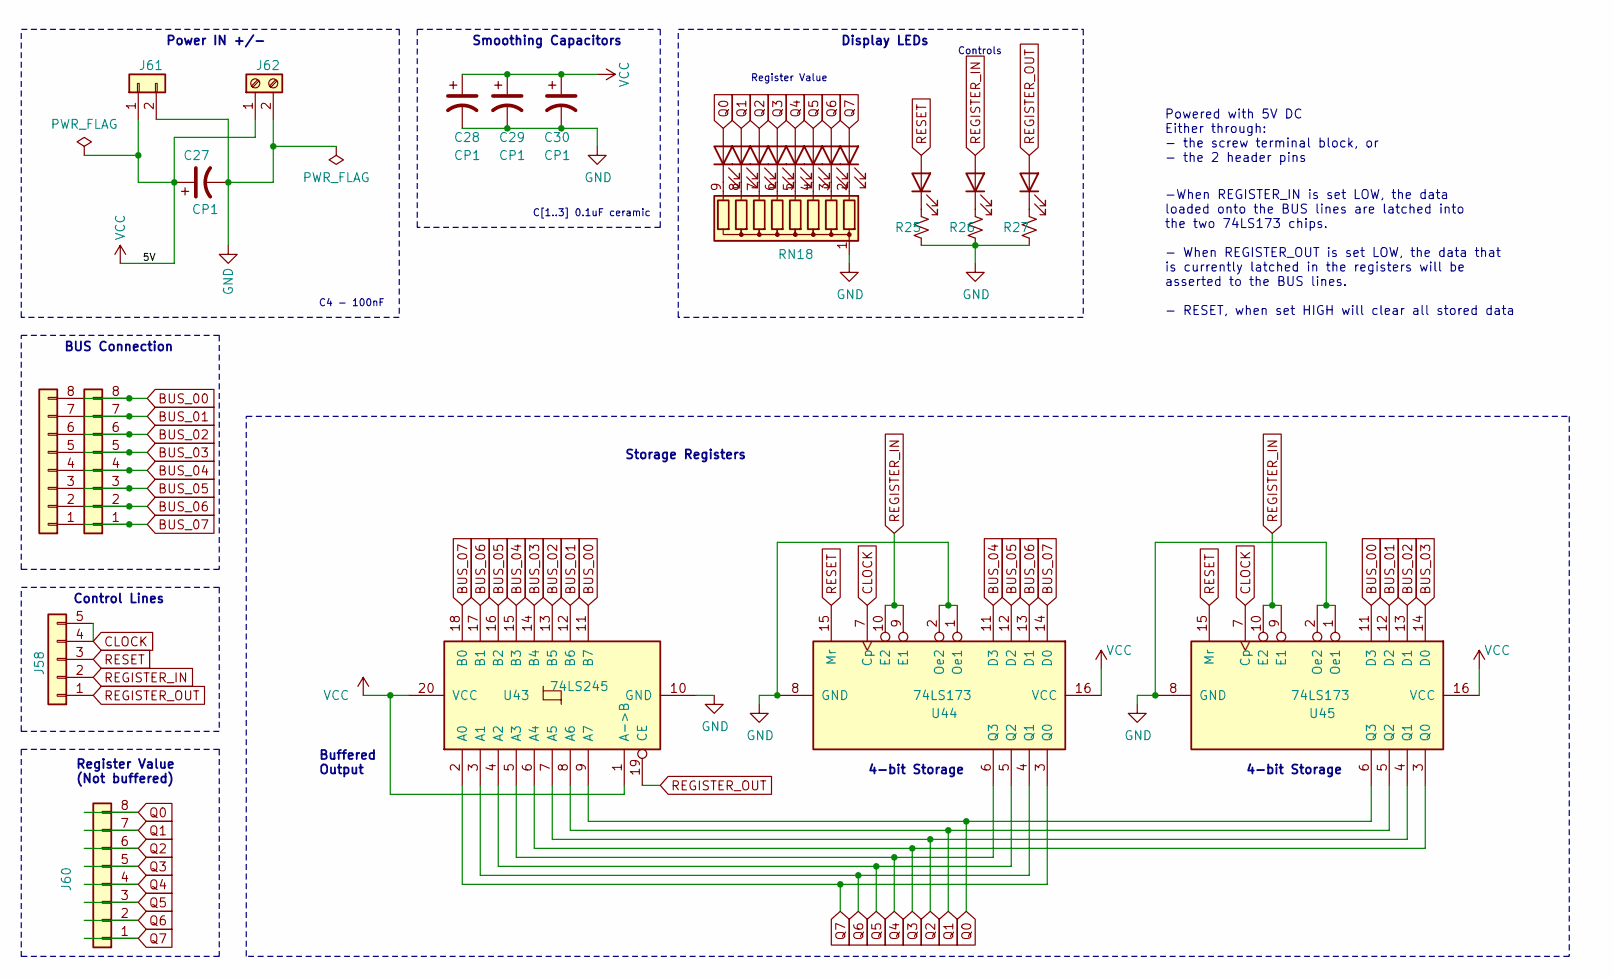
[picture p335: schematic REGISTER.sch]

Parts:
C1: CP1; C_Radial_D5.0mm_H7.0mm_P2.00mm
C2, C3, C4: CP1; C_Disc_D3.8mm_W2.6mm_P2.50mm
D1, D2, D3, D4, D5, D6, D7, D8: LED; LED_D5.0mm
D9, D10, D11: LED; LED_D3.0mm
J1, J3, J4: Conn_01x08; PinHeader_1x08_P2.54mm_Vertical
J2: Conn_01x05; PinHeader_1x05_P2.54mm_Vertical
J5: Conn_01x02; PinHeader_1x02_P2.54mm_Vertical
J6: Screw_Terminal_01x02; TerminalBlock_Phoenix_MKDS-1,5-2_1x02_P5.00mm_Horizontal
R1, R2, R3: R_Small_US; R_Axial_DIN0207_L6.3mm_D2.5mm_P10.16mm_Horizontal
RN1: R_Network08; R_Array_SIP9
U1: 74LS245; DIP-20_W7.62mm_Socket
U2, U3: 74LS173; DIP-16_W7.62mm_Socket

Connections:
BUS_00: J1.8, J3.8, U1.11 (B7), U3.11 (D3)
BUS_01: J1.7, J3.7, U1.12 (B6), U3.12 (D2)
BUS_02: J1.6, J3.6, U1.13 (B5), U3.13 (D1)
BUS_03: J1.5, J3.5, U1.14 (B4), U3.14 (D0)
BUS_04: J1.4, J3.4, U1.15 (B3), U2.11 (D3)
BUS_05: J1.3, J3.3, U1.16 (B2), U2.12 (D2)
BUS_06: J1.2, J3.2, U1.17 (B1), U2.13 (D1)
BUS_07: J1.1, J3.1, U1.18 (B0), U2.14 (D0)
CLOCK: J2.4, J2.5, U2.7 (Cp), U3.7 (Cp)
GND: C1.2, C2.2, C3.2, C4.2, J5.2, J6.2, R1.2, R2.2, R3.2, RN1.1 (common), U1.10 (GND), U2.1 (Oe1), U2.2 (Oe2), U2.8 (GND), U3.1 (Oe1), U3.2 (Oe2), U3.8 (GND)
unnamed: D1.1 (K), RN1.9 (R8)
unnamed: D2.1 (K), RN1.8 (R7)
unnamed: D3.1 (K), RN1.7 (R6)
unnamed: D4.1 (K), RN1.6 (R5)
unnamed: D5.1 (K), RN1.5 (R4)
unnamed: D6.1 (K), RN1.4 (R3)
unnamed: D7.1 (K), RN1.3 (R2)
unnamed: D8.1 (K), RN1.2 (R1)
unnamed: D9.1 (K), R1.1
unnamed: D10.1 (K), R2.1
unnamed: D11.1 (K), R3.1
Q0: D1.2 (A), J4.8, U1.9 (A7), U3.6 (Q3)
Q1: D2.2 (A), J4.7, U1.8 (A6), U3.5 (Q2)
Q2: D3.2 (A), J4.6, U1.7 (A5), U3.4 (Q1)
Q3: D4.2 (A), J4.5, U1.6 (A4), U3.3 (Q0)
Q4: D5.2 (A), J4.4, U1.5 (A3), U2.6 (Q3)
Q5: D6.2 (A), J4.3, U1.4 (A2), U2.5 (Q2)
Q6: D7.2 (A), J4.2, U1.3 (A1), U2.4 (Q1)
Q7: D8.2 (A), J4.1, U1.2 (A0), U2.3 (Q0)
REGISTER_IN: D10.2 (A), J2.2, U2.9 (E1), U2.10 (E2), U3.9 (E1), U3.10 (E2)
REGISTER_OUT: D11.2 (A), J2.1, U1.19 (CE)
RESET: D9.2 (A), J2.3, U2.15 (Mr), U3.15 (Mr)
VCC: C1.1, C2.1, C3.1, C4.1, J5.1, J6.1, U1.1 (A->B), U1.20 (VCC), U2.16 (VCC), U3.16 (VCC)

Notes on the sheet:
Smoothing Capacitors
BUS Connection
Powered with 5V DC Either through: - the screw terminal block, or - the 2 header pins
-When REGISTER_IN is set LOW, the data loaded onto the BUS lines are latched into the two 74LS173 chips. - When REGISTER_OUT is set LOW, the data that is currently latched in the registers will be asserted to the BUS lines. - RESET, when set HIGH will clear all stored data
C[1..3] 0.1uF ceramic
Register Value (Not buffered)
Display LEDs
Buffered Output
4-bit Storage
Control Lines
C4 - 100nF
Power IN +/-
Register Value
Controls
Storage Registers
