theWickedWebDev/8-bit-computer/PCB-Modules/01_BACKPLANES/Backplane-Connector-1/Backplane-Connector-1.kicad_sch

## KiCad design PCB-Modules/01_BACKPLANES/Backplane-Connector-1/Backplane-Connector-1.kicad_sch (2022-02-28)

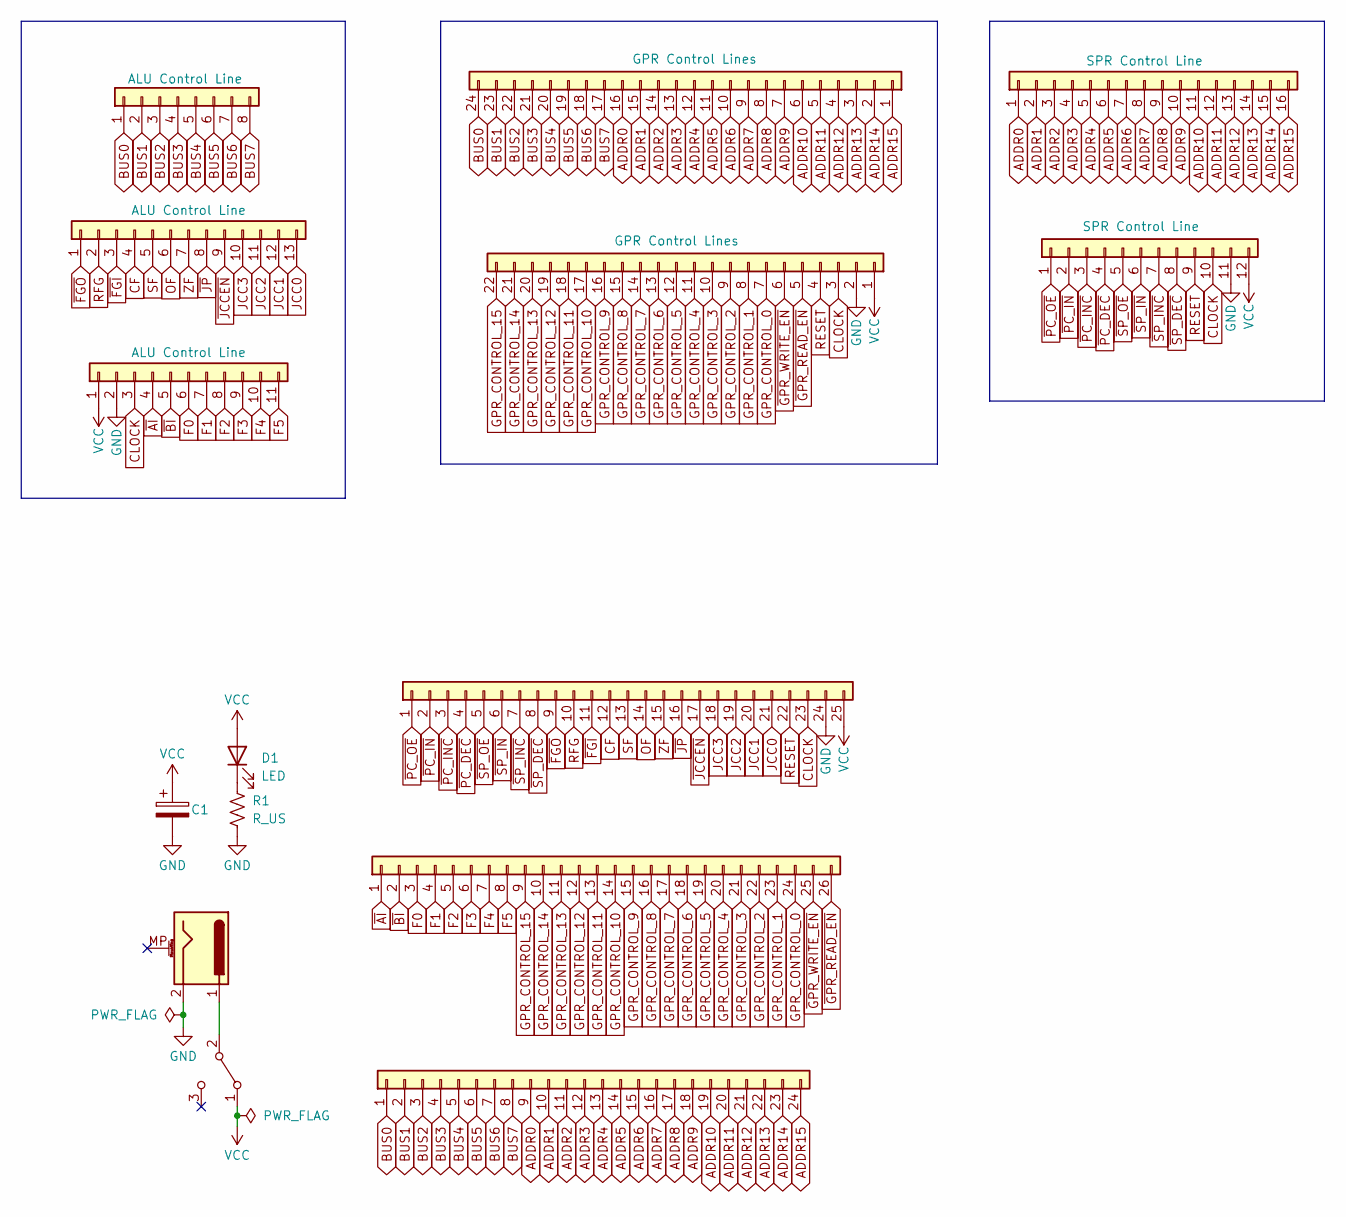
[picture p336: schematic Backplane-Connector-1.kicad_sch]

Parts:
C1: C_Polarized; CP_Elec_5x5.9
D1: LED; LED_0805_2012Metric
J1: Conn_01x08; PinHeader_1x08_P2.54mm_Vertical
J2: Conn_01x13; PinHeader_1x13_P2.54mm_Vertical
J3: Conn_01x11; PinHeader_1x11_P2.54mm_Vertical
J4, J8: Conn_01x24; PinHeader_1x24_P2.54mm_Vertical
J5: Conn_01x22; PinHeader_1x22_P2.54mm_Vertical
J6: Conn_01x12; PinHeader_1x12_P2.54mm_Vertical
J7: Conn_01x16; PinHeader_1x16_P2.54mm_Vertical
J9: Barrel_Jack_MountingPin; BarrelJack_Horizontal
J10: Conn_01x26; PinHeader_1x26_P2.54mm_Vertical
J11: Conn_01x25; PinHeader_1x25_P2.54mm_Vertical
R1: R_US; R_0805_2012Metric
SW1: SW_DPDT_x2; PinHeader_1x03_P2.54mm_Vertical

Connections:
ADDR0: J4.16, J7.1, J8.9
ADDR1: J4.15, J7.2, J8.10
ADDR2: J4.14, J7.3, J8.11
ADDR3: J4.13, J7.4, J8.12
ADDR4: J4.12, J7.5, J8.13
ADDR5: J4.11, J7.6, J8.14
ADDR6: J4.10, J7.7, J8.15
ADDR7: J4.9, J7.8, J8.16
ADDR8: J4.8, J7.9, J8.17
ADDR9: J4.7, J7.10, J8.18
ADDR10: J4.6, J7.11, J8.19
ADDR11: J4.5, J7.12, J8.20
ADDR12: J4.4, J7.13, J8.21
ADDR13: J4.3, J7.14, J8.22
ADDR14: J4.2, J7.15, J8.23
ADDR15: J4.1, J7.16, J8.24
BUS0: J1.1, J4.24, J8.1
BUS1: J1.2, J4.23, J8.2
BUS2: J1.3, J4.22, J8.3
BUS3: J1.4, J4.21, J8.4
BUS4: J1.5, J4.20, J8.5
BUS5: J1.6, J4.19, J8.6
BUS6: J1.7, J4.18, J8.7
BUS7: J1.8, J4.17, J8.8
CF: J2.4, J11.12
CLOCK: J3.3, J5.3, J6.10, J11.23
F0: J3.6, J10.3
F1: J3.7, J10.4
F2: J3.8, J10.5
F3: J3.9, J10.6
F4: J3.10, J10.7
F5: J3.11, J10.8
GND: C1.2, J3.2, J5.2, J6.11, J9.2, J11.24, R1.2
GPR_CONTROL_0: J5.7, J10.24
GPR_CONTROL_1: J5.8, J10.23
GPR_CONTROL_2: J5.9, J10.22
GPR_CONTROL_3: J5.10, J10.21
GPR_CONTROL_4: J5.11, J10.20
GPR_CONTROL_5: J5.12, J10.19
GPR_CONTROL_6: J5.13, J10.18
GPR_CONTROL_7: J5.14, J10.17
GPR_CONTROL_8: J5.15, J10.16
GPR_CONTROL_9: J5.16, J10.15
GPR_CONTROL_10: J5.17, J10.14
GPR_CONTROL_11: J5.18, J10.13
GPR_CONTROL_12: J5.19, J10.12
GPR_CONTROL_13: J5.20, J10.11
GPR_CONTROL_14: J5.21, J10.10
GPR_CONTROL_15: J5.22, J10.9
JCC0: J2.13, J11.21
JCC1: J2.12, J11.20
JCC2: J2.11, J11.19
JCC3: J2.10, J11.18
unnamed: D1.1 (K), R1.1
unnamed: J9.1, SW1.2 (B)
OF: J2.6, J11.14
RESET: J5.4, J6.9, J11.22
RFG: J2.2, J11.10
SF: J2.5, J11.13
VCC: C1.1, D1.2 (A), J3.1, J5.1, J6.12, J11.25, SW1.1 (A)
ZF: J2.7, J11.15
~AI: J3.4, J10.1
~BI: J3.5, J10.2
~FGI: J2.3, J11.11
~FGO: J2.1, J11.9
~GPR_READ_EN: J5.5, J10.26
~GPR_WRITE_EN: J5.6, J10.25
~JCCEN: J2.9, J11.17
~JP: J2.8, J11.16
~PC_DEC: J6.4, J11.4
~PC_INC: J6.3, J11.3
~PC_IN: J6.2, J11.2
~PC_OE: J6.1, J11.1
~SP_DEC: J6.8, J11.8
~SP_INC: J6.7, J11.7
~SP_IN: J6.6, J11.6
~SP_OE: J6.5, J11.5
