theWickedWebDev/8-bit-computer/PCB-Modules/01_BACKPLANES/HALF-assembly-backplane/FULL-assembly-backplane.sch

## KiCad design PCB-Modules/01_BACKPLANES/HALF-assembly-backplane/FULL-assembly-backplane.sch (2021-12-09)

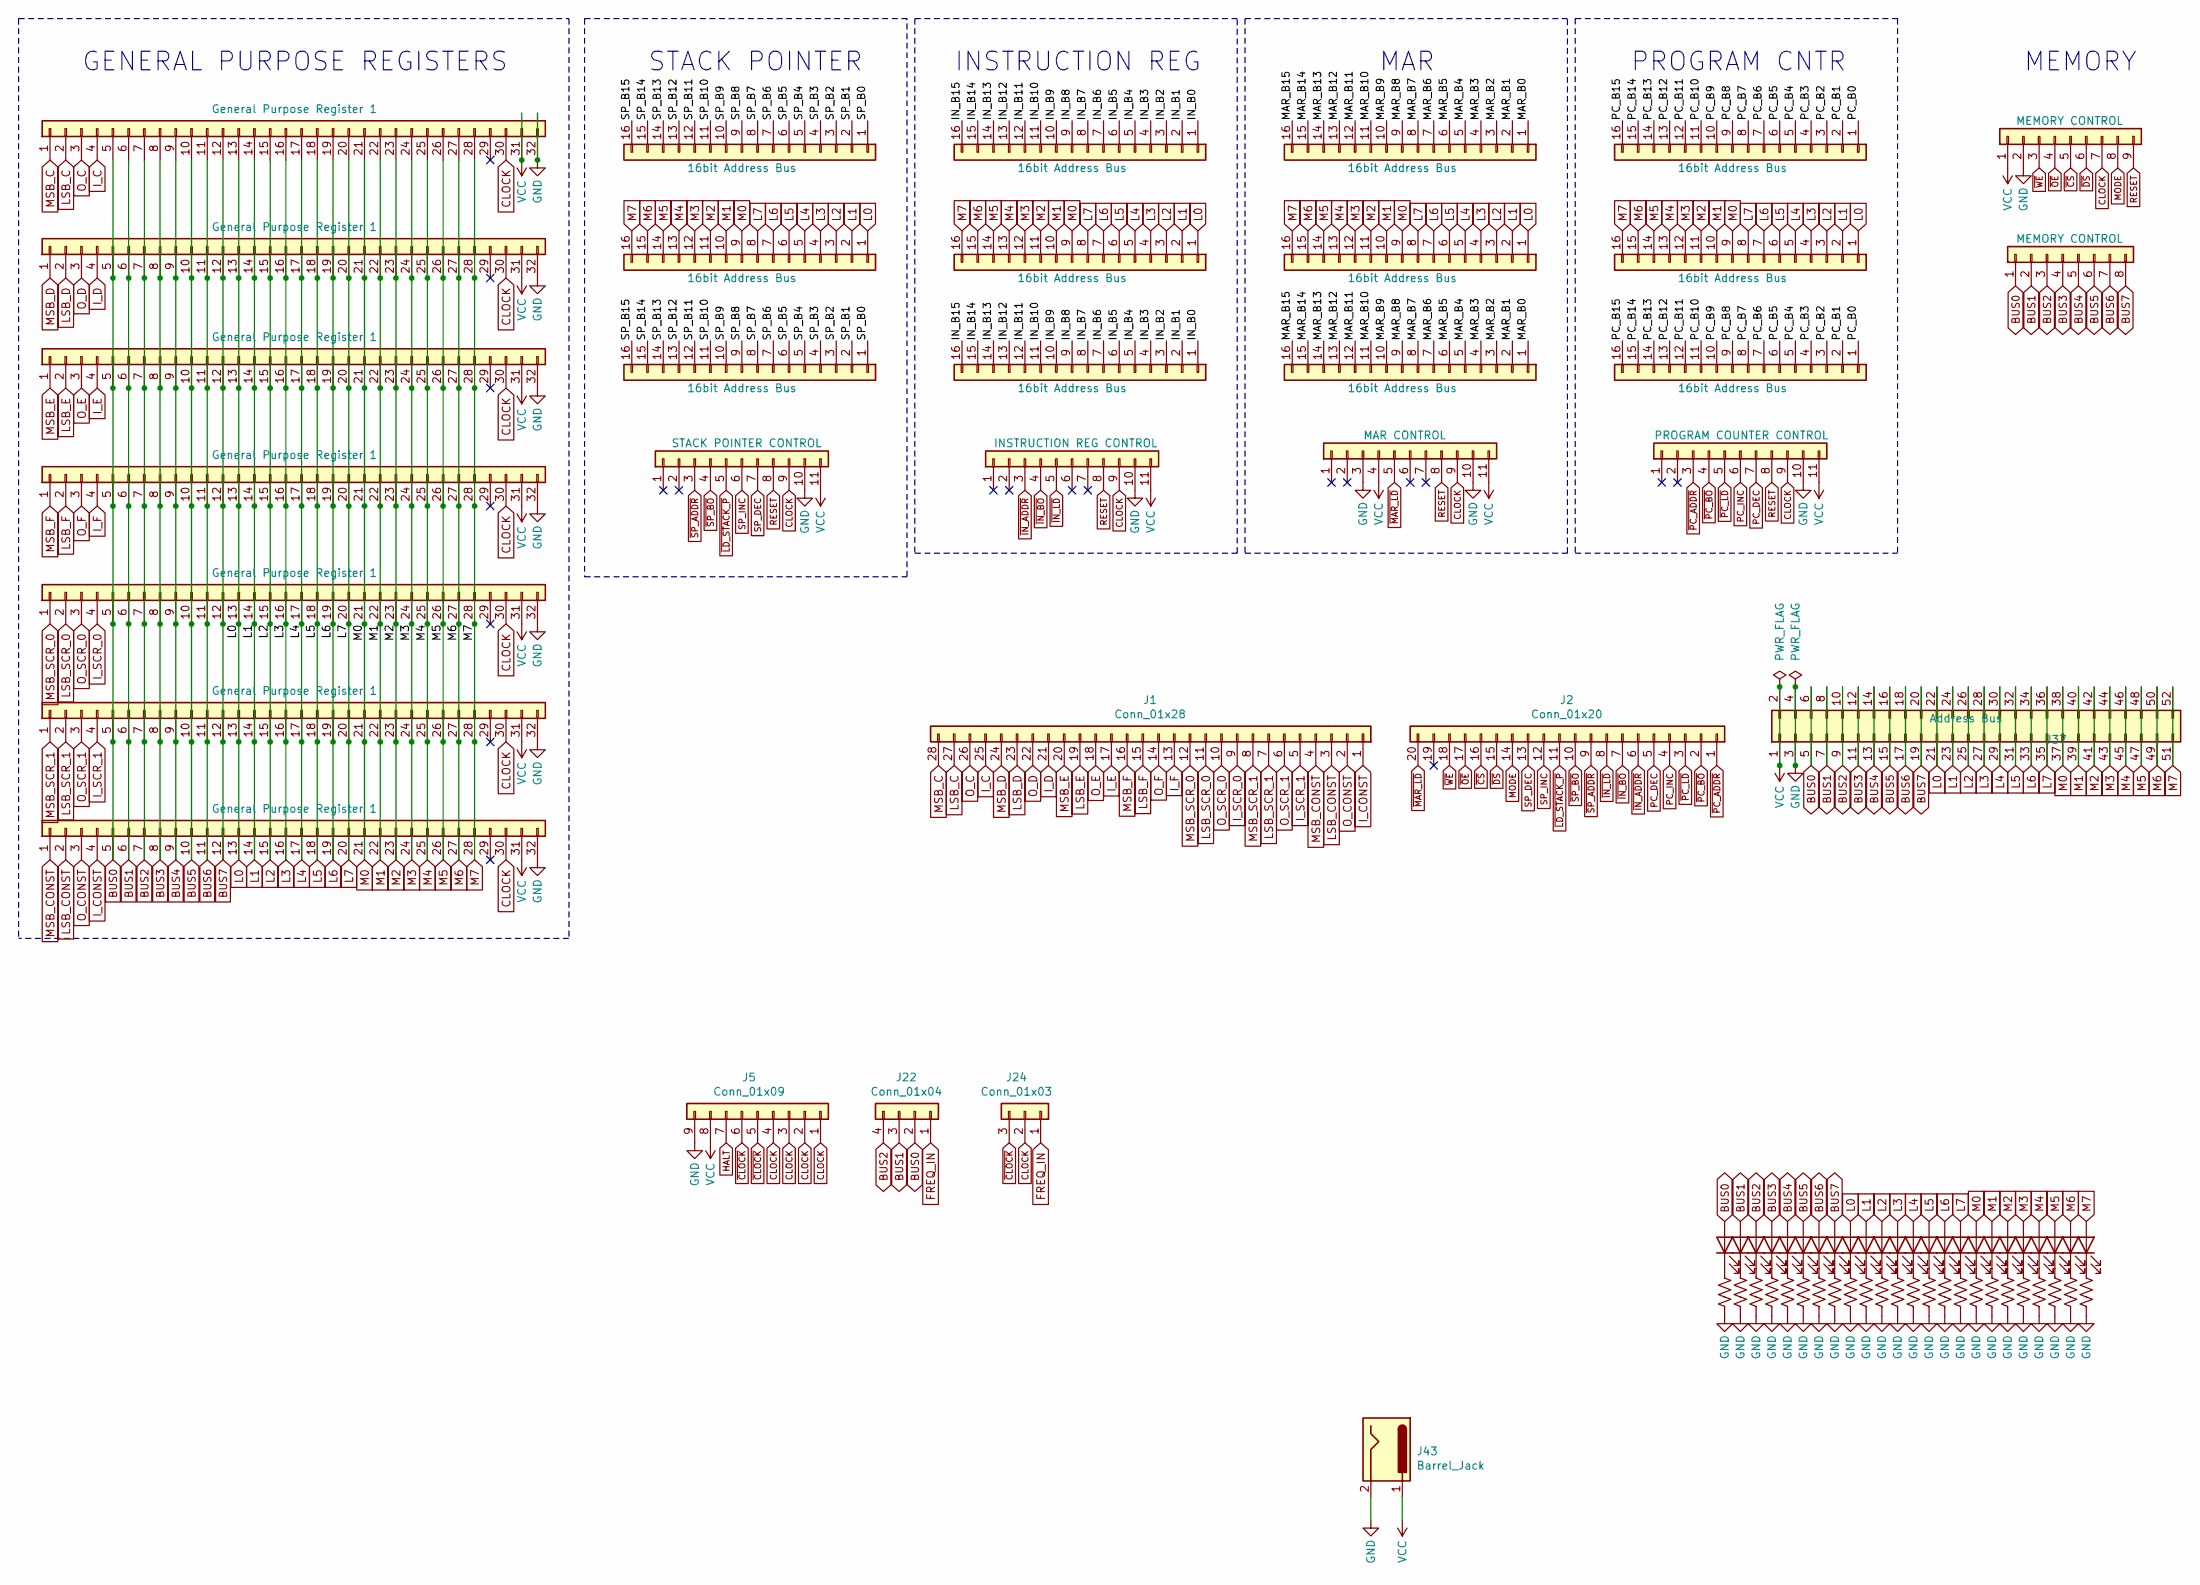
[picture p337: schematic FULL-assembly-backplane.sch]

Parts:
D1, D2, D3, D4, D5, D6, D7, D8, D9, D10, D11, D12, D13, D14, D15, D16, D17, D18, D19, D20, D21, D22, D23, D24: LED; LED_0805_2012Metric
J1: Conn_01x28; PinHeader_1x28_P2.54mm_Vertical
J2: Conn_01x20; PinHeader_1x20_P2.54mm_Vertical
J3: Conn_01x08; PinHeader_1x08_P2.54mm_Vertical
J4, J5: Conn_01x09; PinHeader_1x09_P2.54mm_Vertical
J6, J7, J8, J9, J10, J11, J12, J13, J14, J15, J16, J17: Conn_01x16; PinHeader_1x16_P2.54mm_Vertical
J18, J19, J20, J21: Conn_01x11; PinHeader_1x11_P2.54mm_Vertical
J22: Conn_01x04; PinHeader_1x04_P2.54mm_Vertical
J24: Conn_01x03; PinHeader_1x03_P2.54mm_Vertical
J25, J26, J32, J33, J34, J35, J36: Conn_01x32; PinSocket_1x32_P2.54mm_Vertical
J37: Conn_01x26; PinHeader_2x26_P2.54mm_Vertical
J43: Barrel_Jack; BarrelJack_Horizontal
R1, R2, R3, R4, R5, R6, R7, R8, R9, R10, R11, R12, R13, R14, R15, R16, R17, R18, R19, R20, R21, R22, R23, R24: R_US; R_0805_2012Metric

Connections:
BUS0: D1.2 (A), J3.1, J22.2, J25.5, J26.5, J32.5, J33.5, J34.5, J35.5, J36.5, J37.5, J37.6
BUS1: D2.2 (A), J3.2, J22.3, J25.6, J26.6, J32.6, J33.6, J34.6, J35.6, J36.6, J37.7, J37.8
BUS2: D3.2 (A), J3.3, J22.4, J25.7, J26.7, J32.7, J33.7, J34.7, J35.7, J36.7, J37.9, J37.10
BUS3: D4.2 (A), J3.4, J25.8, J26.8, J32.8, J33.8, J34.8, J35.8, J36.8, J37.11, J37.12
BUS4: D5.2 (A), J3.5, J25.9, J26.9, J32.9, J33.9, J34.9, J35.9, J36.9, J37.13, J37.14
BUS5: D6.2 (A), J3.6, J25.10, J26.10, J32.10, J33.10, J34.10, J35.10, J36.10, J37.15, J37.16
BUS6: D7.2 (A), J3.7, J25.11, J26.11, J32.11, J33.11, J34.11, J35.11, J36.11, J37.17, J37.18
BUS7: D8.2 (A), J3.8, J25.12, J26.12, J32.12, J33.12, J34.12, J35.12, J36.12, J37.19, J37.20
CLOCK: J4.7, J5.1, J5.2, J5.3, J5.4, J18.9, J19.9, J20.9, J21.9, J24.2, J25.30, J26.30, J32.30, J33.30, J34.30, J35.30, J36.30
FREQ_IN: J22.1, J24.1
GND: J4.2, J5.9, J18.10, J19.10, J20.3, J20.10, J21.10, J25.32, J26.32, J32.32, J33.32, J34.32, J35.32, J36.32, J37.3, J37.4, J43.2, R1.2, R2.2, R3.2, R4.2, R5.2, R6.2, R7.2, R8.2, R9.2, R10.2, R11.2, R12.2, R13.2, R14.2, R15.2, R16.2, R17.2, R18.2, R19.2, R20.2, R21.2, R22.2, R23.2, R24.2
HALT: J5.7
IN_B0: J9.1, J11.1
IN_B1: J9.2, J11.2
IN_B2: J9.3, J11.3
IN_B3: J9.4, J11.4
IN_B4: J9.5, J11.5
IN_B5: J9.6, J11.6
IN_B6: J9.7, J11.7
IN_B7: J9.8, J11.8
IN_B8: J9.9, J11.9
IN_B9: J9.10, J11.10
IN_B10: J9.11, J11.11
IN_B11: J9.12, J11.12
IN_B12: J9.13, J11.13
IN_B13: J9.14, J11.14
IN_B14: J9.15, J11.15
IN_B15: J9.16, J11.16
I_C: J1.25, J32.4
I_CONST: J1.1, J26.4
I_D: J1.21, J33.4
I_E: J1.17, J34.4
I_F: J1.13, J35.4
I_SCR_0: J1.9, J36.4
I_SCR_1: J1.5, J25.4
L0: D9.2 (A), J7.1, J10.1, J13.1, J16.1, J25.13, J26.13, J32.13, J33.13, J34.13, J35.13, J36.13, J37.21, J37.22
L1: D10.2 (A), J7.2, J10.2, J13.2, J16.2, J25.14, J26.14, J32.14, J33.14, J34.14, J35.14, J36.14, J37.23, J37.24
L2: D11.2 (A), J7.3, J10.3, J13.3, J16.3, J25.15, J26.15, J32.15, J33.15, J34.15, J35.15, J36.15, J37.25, J37.26
L3: D12.2 (A), J7.4, J10.4, J13.4, J16.4, J25.16, J26.16, J32.16, J33.16, J34.16, J35.16, J36.16, J37.27, J37.28
L4: D13.2 (A), J7.5, J10.5, J13.5, J16.5, J25.17, J26.17, J32.17, J33.17, J34.17, J35.17, J36.17, J37.29, J37.30
L5: D14.2 (A), J7.6, J10.6, J13.6, J16.6, J25.18, J26.18, J32.18, J33.18, J34.18, J35.18, J36.18, J37.31, J37.32
L6: D15.2 (A), J7.7, J10.7, J13.7, J16.7, J25.19, J26.19, J32.19, J33.19, J34.19, J35.19, J36.19, J37.33, J37.34
L7: D16.2 (A), J7.8, J10.8, J13.8, J16.8, J25.20, J26.20, J32.20, J33.20, J34.20, J35.20, J36.20, J37.35, J37.36
LSB_C: J1.27, J32.2
LSB_CONST: J1.3, J26.2
LSB_D: J1.23, J33.2
LSB_E: J1.19, J34.2
LSB_F: J1.15, J35.2
LSB_SCR_0: J1.11, J36.2
LSB_SCR_1: J1.7, J25.2
M0: D17.2 (A), J7.9, J10.9, J13.9, J16.9, J25.21, J26.21, J32.21, J33.21, J34.21, J35.21, J36.21, J37.37, J37.38
M1: D18.2 (A), J7.10, J10.10, J13.10, J16.10, J25.22, J26.22, J32.22, J33.22, J34.22, J35.22, J36.22, J37.39, J37.40
M2: D19.2 (A), J7.11, J10.11, J13.11, J16.11, J25.23, J26.23, J32.23, J33.23, J34.23, J35.23, J36.23, J37.41, J37.42
M3: D20.2 (A), J7.12, J10.12, J13.12, J16.12, J25.24, J26.24, J32.24, J33.24, J34.24, J35.24, J36.24, J37.43, J37.44
M4: D21.2 (A), J7.13, J10.13, J13.13, J16.13, J25.25, J26.25, J32.25, J33.25, J34.25, J35.25, J36.25, J37.45, J37.46
M5: D22.2 (A), J7.14, J10.14, J13.14, J16.14, J25.26, J26.26, J32.26, J33.26, J34.26, J35.26, J36.26, J37.47, J37.48
M6: D23.2 (A), J7.15, J10.15, J13.15, J16.15, J25.27, J26.27, J32.27, J33.27, J34.27, J35.27, J36.27, J37.49, J37.50
M7: D24.2 (A), J7.16, J10.16, J13.16, J16.16, J25.28, J26.28, J32.28, J33.28, J34.28, J35.28, J36.28, J37.51, J37.52
MAR_B0: J15.1, J17.1
MAR_B1: J15.2, J17.2
MAR_B2: J15.3, J17.3
MAR_B3: J15.4, J17.4
MAR_B4: J15.5, J17.5
MAR_B5: J15.6, J17.6
MAR_B6: J15.7, J17.7
MAR_B7: J15.8, J17.8
MAR_B8: J15.9, J17.9
MAR_B9: J15.10, J17.10
MAR_B10: J15.11, J17.11
MAR_B11: J15.12, J17.12
MAR_B12: J15.13, J17.13
MAR_B13: J15.14, J17.14
MAR_B14: J15.15, J17.15
MAR_B15: J15.16, J17.16
MODE: J2.14, J4.8
MSB_C: J1.28, J32.1
MSB_CONST: J1.4, J26.1
MSB_D: J1.24, J33.1
MSB_E: J1.20, J34.1
MSB_F: J1.16, J35.1
MSB_SCR_0: J1.12, J36.1
MSB_SCR_1: J1.8, J25.1
unnamed: D1.1 (K), R1.1
unnamed: D2.1 (K), R2.1
unnamed: D3.1 (K), R3.1
unnamed: D4.1 (K), R4.1
unnamed: D5.1 (K), R5.1
unnamed: D6.1 (K), R6.1
unnamed: D7.1 (K), R7.1
unnamed: D8.1 (K), R8.1
unnamed: D9.1 (K), R9.1
unnamed: D10.1 (K), R10.1
unnamed: D11.1 (K), R11.1
unnamed: D12.1 (K), R12.1
unnamed: D13.1 (K), R13.1
unnamed: D14.1 (K), R14.1
unnamed: D15.1 (K), R15.1
unnamed: D16.1 (K), R16.1
unnamed: D17.1 (K), R17.1
unnamed: D18.1 (K), R18.1
unnamed: D19.1 (K), R19.1
unnamed: D20.1 (K), R20.1
unnamed: D21.1 (K), R21.1
unnamed: D22.1 (K), R22.1
unnamed: D23.1 (K), R23.1
unnamed: D24.1 (K), R24.1
O_C: J1.26, J32.3
O_CONST: J1.2, J26.3
O_D: J1.22, J33.3
O_E: J1.18, J34.3
O_F: J1.14, J35.3
O_SCR_0: J1.10, J36.3
O_SCR_1: J1.6, J25.3
PC_B0: J12.1, J14.1
PC_B1: J12.2, J14.2
PC_B2: J12.3, J14.3
PC_B3: J12.4, J14.4
PC_B4: J12.5, J14.5
PC_B5: J12.6, J14.6
PC_B6: J12.7, J14.7
PC_B7: J12.8, J14.8
PC_B8: J12.9, J14.9
PC_B9: J12.10, J14.10
PC_B10: J12.11, J14.11
PC_B11: J12.12, J14.12
PC_B12: J12.13, J14.13
PC_B13: J12.14, J14.14
PC_B14: J12.15, J14.15
PC_B15: J12.16, J14.16
PC_DEC: J2.5, J21.7
PC_INC: J2.4, J21.6
RESET: J4.9, J18.8, J19.8, J20.8, J21.8
SP_B0: J6.1, J8.1
SP_B1: J6.2, J8.2
SP_B2: J6.3, J8.3
SP_B3: J6.4, J8.4
SP_B4: J6.5, J8.5
SP_B5: J6.6, J8.6
SP_B6: J6.7, J8.7
SP_B7: J6.8, J8.8
SP_B8: J6.9, J8.9
SP_B9: J6.10, J8.10
SP_B10: J6.11, J8.11
SP_B11: J6.12, J8.12
SP_B12: J6.13, J8.13
SP_B13: J6.14, J8.14
SP_B14: J6.15, J8.15
SP_B15: J6.16, J8.16
SP_DEC: J2.13, J18.7
SP_INC: J2.12, J18.6
VCC: J4.1, J5.8, J18.11, J19.11, J20.4, J20.11, J21.11, J25.31, J26.31, J32.31, J33.31, J34.31, J35.31, J36.31, J37.1, J37.2, J43.1
~CLOCK: J5.5, J5.6, J24.3
~CS: J2.16, J4.5
~DS: J2.15, J4.6
~IN_ADDR: J2.6, J19.3
~IN_BO: J2.7, J19.4
~IN_LD: J2.8, J19.5
~LD_STACK_P: J2.11, J18.5
~MAR_LD: J2.20, J20.5
~OE: J2.17, J4.4
~PC_ADDR: J2.1, J21.3
~PC_BO: J2.2, J21.4
~PC_LD: J2.3, J21.5
~SP_ADDR: J2.9, J18.3
~SP_BO: J2.10, J18.4
~WE: J2.18, J4.3

Notes on the sheet:
GENERAL PURPOSE REGISTERS
MAR
PROGRAM CNTR
INSTRUCTION REG
STACK POINTER
MEMORY
