theWickedWebDev/8-bit-computer/PCB-Modules/01_BACKPLANES/INTERCONNECTS/INTERCONNECTS.sch

## KiCad design PCB-Modules/01_BACKPLANES/INTERCONNECTS/INTERCONNECTS.sch (2021-11-28)

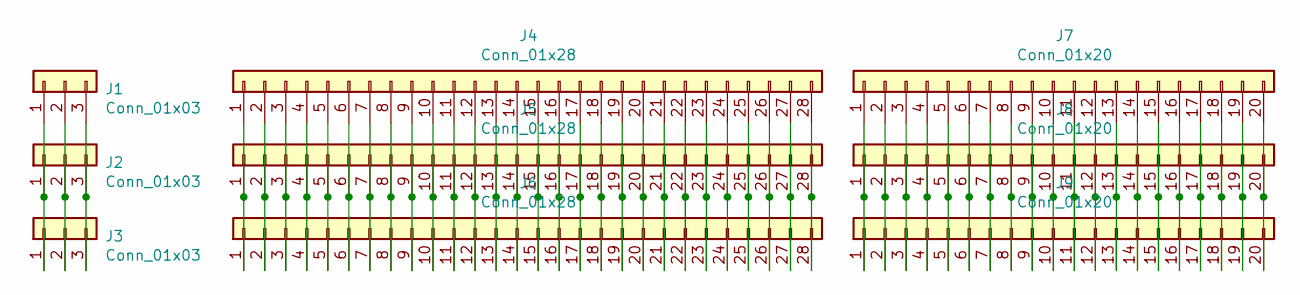
[picture p338: schematic INTERCONNECTS.sch]

Parts:
J1, J2, J3: Conn_01x03; PinHeader_1x03_P2.54mm_Vertical
J4, J5, J6: Conn_01x28; PinHeader_1x28_P2.54mm_Vertical
J7, J8, J9: Conn_01x20; PinHeader_1x20_P2.54mm_Vertical

Connections:
unnamed: J1.1, J2.1, J3.1
unnamed: J1.2, J2.2, J3.2
unnamed: J1.3, J2.3, J3.3
unnamed: J4.1, J5.1, J6.1
unnamed: J4.2, J5.2, J6.2
unnamed: J4.3, J5.3, J6.3
unnamed: J4.4, J5.4, J6.4
unnamed: J4.5, J5.5, J6.5
unnamed: J4.6, J5.6, J6.6
unnamed: J4.7, J5.7, J6.7
unnamed: J4.8, J5.8, J6.8
unnamed: J4.9, J5.9, J6.9
unnamed: J4.10, J5.10, J6.10
unnamed: J4.11, J5.11, J6.11
unnamed: J4.12, J5.12, J6.12
unnamed: J4.13, J5.13, J6.13
unnamed: J4.14, J5.14, J6.14
unnamed: J4.15, J5.15, J6.15
unnamed: J4.16, J5.16, J6.16
unnamed: J4.17, J5.17, J6.17
unnamed: J4.18, J5.18, J6.18
unnamed: J4.19, J5.19, J6.19
unnamed: J4.20, J5.20, J6.20
unnamed: J4.21, J5.21, J6.21
unnamed: J4.22, J5.22, J6.22
unnamed: J4.23, J5.23, J6.23
unnamed: J4.24, J5.24, J6.24
unnamed: J4.25, J5.25, J6.25
unnamed: J4.26, J5.26, J6.26
unnamed: J4.27, J5.27, J6.27
unnamed: J4.28, J5.28, J6.28
unnamed: J7.1, J8.1, J9.1
unnamed: J7.2, J8.2, J9.2
unnamed: J7.3, J8.3, J9.3
unnamed: J7.4, J8.4, J9.4
unnamed: J7.5, J8.5, J9.5
unnamed: J7.6, J8.6, J9.6
unnamed: J7.7, J8.7, J9.7
unnamed: J7.8, J8.8, J9.8
unnamed: J7.9, J8.9, J9.9
unnamed: J7.10, J8.10, J9.10
unnamed: J7.11, J8.11, J9.11
unnamed: J7.12, J8.12, J9.12
unnamed: J7.13, J8.13, J9.13
unnamed: J7.14, J8.14, J9.14
unnamed: J7.15, J8.15, J9.15
unnamed: J7.16, J8.16, J9.16
unnamed: J7.17, J8.17, J9.17
unnamed: J7.18, J8.18, J9.18
unnamed: J7.19, J8.19, J9.19
unnamed: J7.20, J8.20, J9.20
