theWickedWebDev/8-bit-computer/PCB-Modules/01_BACKPLANES/gpr-new-register-backplane/new-register-backplane.kicad_sch

## KiCad design PCB-Modules/01_BACKPLANES/gpr-new-register-backplane/new-register-backplane.kicad_sch (2022-01-18)

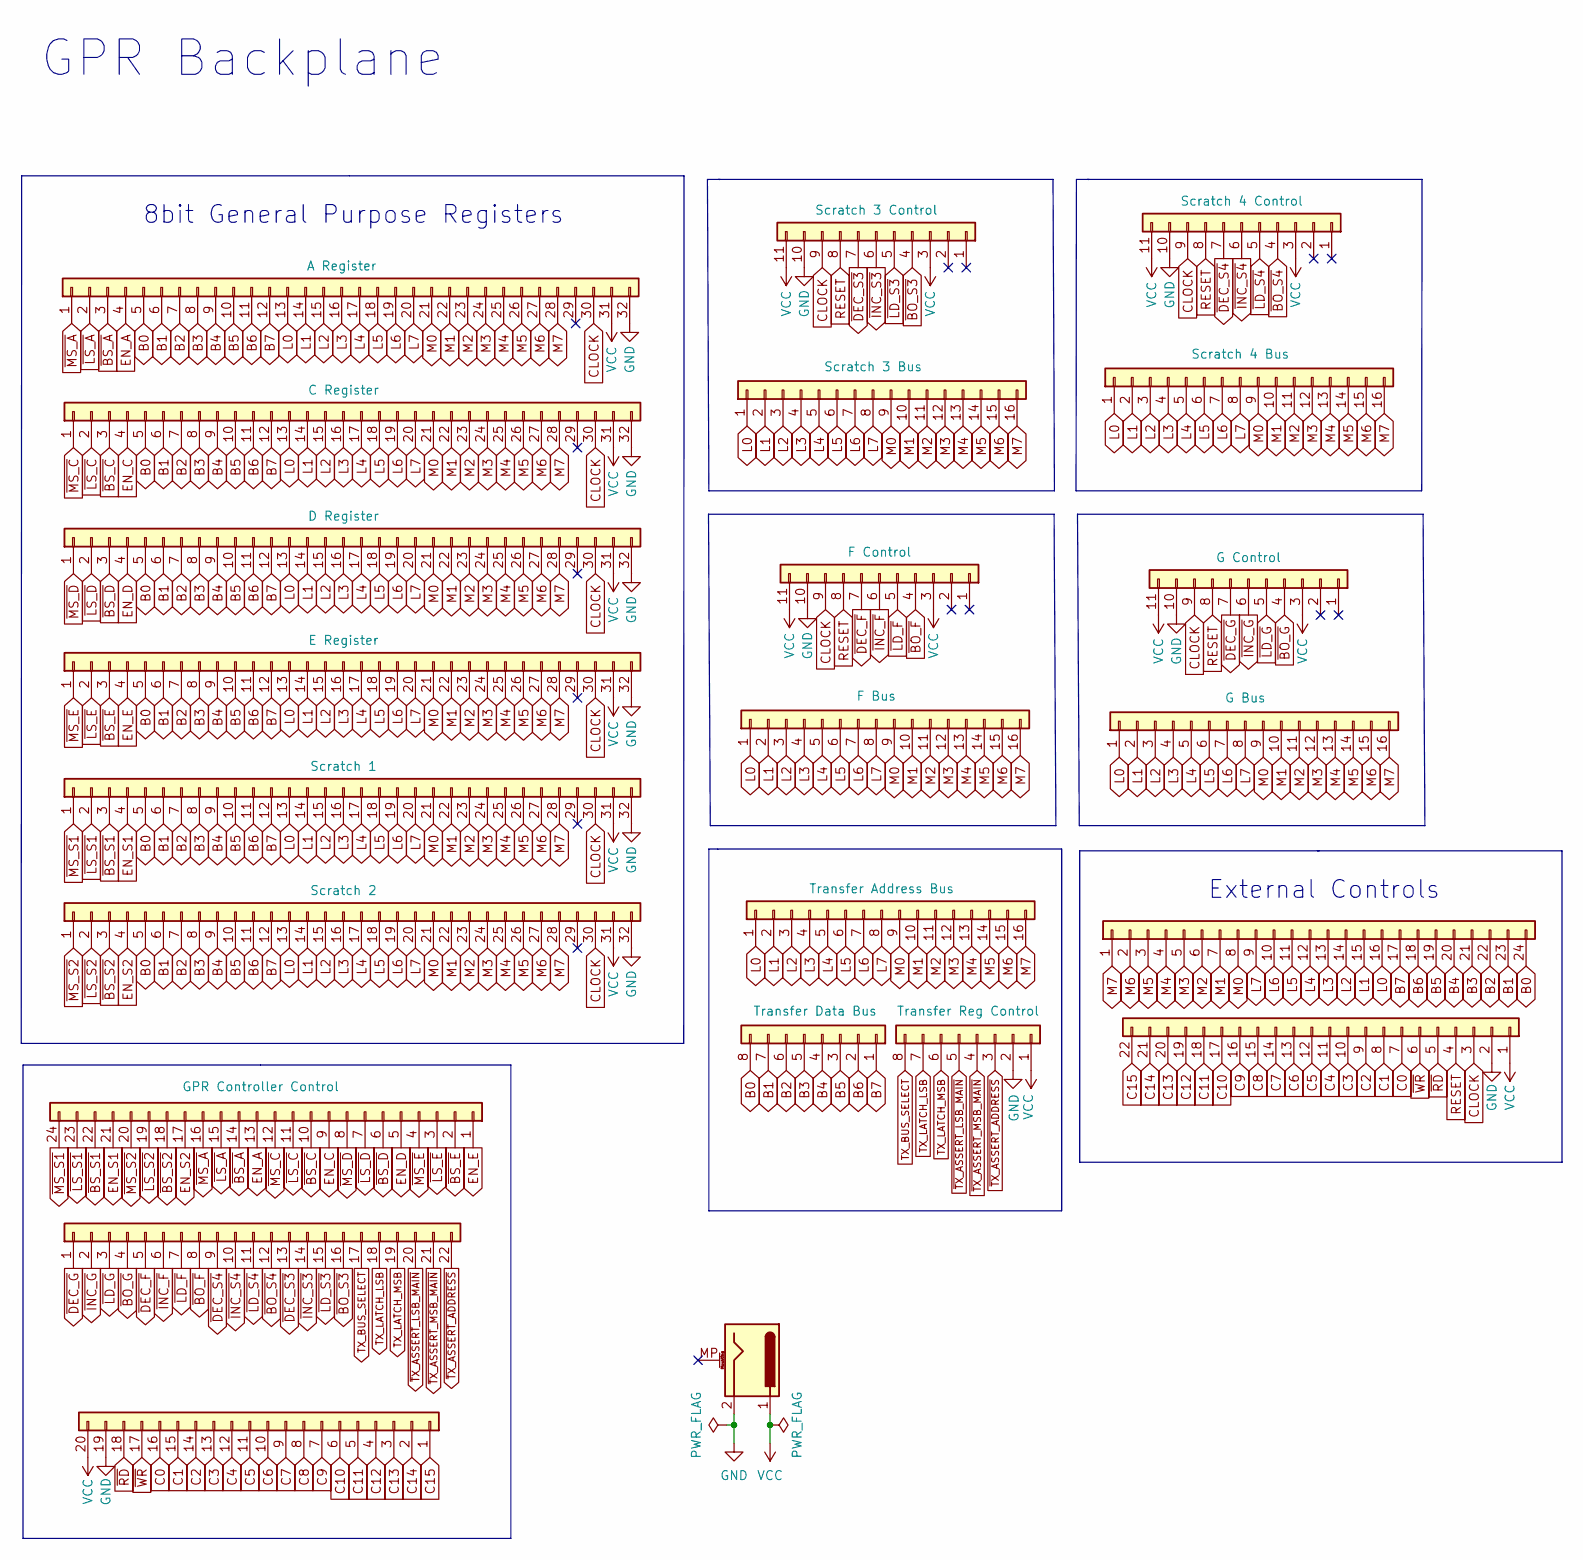
[picture p339: schematic new-register-backplane.kicad_sch]

Parts:
J1: Conn_01x22; PinHeader_1x22_P2.54mm_Horizontal
J2: Conn_01x20; PinHeader_1x20_P2.54mm_Vertical
J3, J5, J6, J7, J8, J9: Conn_01x32; PinHeader_1x32_P2.54mm_Vertical
J4: Conn_01x24; PinHeader_1x24_P2.54mm_Horizontal
J10, J15, J18, J21: Conn_01x11; PinHeader_1x11_P2.54mm_Vertical
J11, J13, J17, J20, J24: Conn_01x16; PinHeader_1x16_P2.54mm_Vertical
J22, J25: Conn_01x08; PinHeader_1x08_P2.54mm_Vertical
J28: Conn_01x22; PinHeader_1x22_P2.54mm_Vertical
J29: Conn_01x24; PinHeader_1x24_P2.54mm_Vertical
J31: Barrel_Jack_MountingPin; BarrelJack_Horizontal

Connections:
B0: J3.5, J4.24, J5.5, J6.5, J7.5, J8.5, J9.5, J22.8
B1: J3.6, J4.23, J5.6, J6.6, J7.6, J8.6, J9.6, J22.7
B2: J3.7, J4.22, J5.7, J6.7, J7.7, J8.7, J9.7, J22.6
B3: J3.8, J4.21, J5.8, J6.8, J7.8, J8.8, J9.8, J22.5
B4: J3.9, J4.20, J5.9, J6.9, J7.9, J8.9, J9.9, J22.4
B5: J3.10, J4.19, J5.10, J6.10, J7.10, J8.10, J9.10, J22.3
B6: J3.11, J4.18, J5.11, J6.11, J7.11, J8.11, J9.11, J22.2
B7: J3.12, J4.17, J5.12, J6.12, J7.12, J8.12, J9.12, J22.1
C0: J1.7, J2.16
C1: J1.8, J2.15
C2: J1.9, J2.14
C3: J1.10, J2.13
C4: J1.11, J2.12
C5: J1.12, J2.11
C6: J1.13, J2.10
C7: J1.14, J2.9
C8: J1.15, J2.8
C9: J1.16, J2.7
C10: J1.17, J2.6
C11: J1.18, J2.5
C12: J1.19, J2.4
C13: J1.20, J2.3
C14: J1.21, J2.2
C15: J1.22, J2.1
CLOCK: J1.3, J3.30, J5.30, J6.30, J7.30, J8.30, J9.30, J10.9, J15.9, J18.9, J21.9
EN_A: J3.4, J29.13
EN_C: J5.4, J29.9
EN_D: J6.4, J29.5
EN_E: J7.4, J29.1
EN_S1: J8.4, J29.21
EN_S2: J9.4, J29.17
GND: J1.2, J2.19, J3.32, J5.32, J6.32, J7.32, J8.32, J9.32, J10.10, J15.10, J18.10, J21.10, J25.2, J31.2
L0: J3.13, J4.16, J5.13, J6.13, J7.13, J8.13, J9.13, J11.1, J13.1, J17.1, J20.1, J24.1
L1: J3.14, J4.15, J5.14, J6.14, J7.14, J8.14, J9.14, J11.2, J13.2, J17.2, J20.2, J24.2
L2: J3.15, J4.14, J5.15, J6.15, J7.15, J8.15, J9.15, J11.3, J13.3, J17.3, J20.3, J24.3
L3: J3.16, J4.13, J5.16, J6.16, J7.16, J8.16, J9.16, J11.4, J13.4, J17.4, J20.4, J24.4
L4: J3.17, J4.12, J5.17, J6.17, J7.17, J8.17, J9.17, J11.5, J13.5, J17.5, J20.5, J24.5
L5: J3.18, J4.11, J5.18, J6.18, J7.18, J8.18, J9.18, J11.6, J13.6, J17.6, J20.6, J24.6
L6: J3.19, J4.10, J5.19, J6.19, J7.19, J8.19, J9.19, J11.7, J13.7, J17.7, J20.7, J24.7
L7: J3.20, J4.9, J5.20, J6.20, J7.20, J8.20, J9.20, J11.8, J13.8, J17.8, J20.8, J24.8
M0: J3.21, J4.8, J5.21, J6.21, J7.21, J8.21, J9.21, J11.9, J13.9, J17.9, J20.9, J24.9
M1: J3.22, J4.7, J5.22, J6.22, J7.22, J8.22, J9.22, J11.10, J13.10, J17.10, J20.10, J24.10
M2: J3.23, J4.6, J5.23, J6.23, J7.23, J8.23, J9.23, J11.11, J13.11, J17.11, J20.11, J24.11
M3: J3.24, J4.5, J5.24, J6.24, J7.24, J8.24, J9.24, J11.12, J13.12, J17.12, J20.12, J24.12
M4: J3.25, J4.4, J5.25, J6.25, J7.25, J8.25, J9.25, J11.13, J13.13, J17.13, J20.13, J24.13
M5: J3.26, J4.3, J5.26, J6.26, J7.26, J8.26, J9.26, J11.14, J13.14, J17.14, J20.14, J24.14
M6: J3.27, J4.2, J5.27, J6.27, J7.27, J8.27, J9.27, J11.15, J13.15, J17.15, J20.15, J24.15
M7: J3.28, J4.1, J5.28, J6.28, J7.28, J8.28, J9.28, J11.16, J13.16, J17.16, J20.16, J24.16
RESET: J1.4, J10.8, J15.8, J18.8, J21.8
TX_BUS_SELECT: J25.8, J28.17
TX_LATCH_LSB: J25.7, J28.18
TX_LATCH_MSB: J25.6, J28.19
VCC: J1.1, J2.20, J3.31, J5.31, J6.31, J7.31, J8.31, J9.31, J10.3, J10.11, J15.3, J15.11, J18.3, J18.11, J21.3, J21.11, J25.1, J31.1
~BO_F: J18.4, J28.8
~BO_G: J21.4, J28.4
~BO_S3: J10.4, J28.16
~BO_S4: J15.4, J28.12
~BS_A: J3.3, J29.14
~BS_C: J5.3, J29.10
~BS_D: J6.3, J29.6
~BS_E: J7.3, J29.2
~BS_S1: J8.3, J29.22
~BS_S2: J9.3, J29.18
~DEC_F: J18.7, J28.5
~DEC_G: J21.7, J28.1
~DEC_S3: J10.7, J28.13
~DEC_S4: J15.7, J28.9
~INC_F: J18.6, J28.6
~INC_G: J21.6, J28.2
~INC_S3: J10.6, J28.14
~INC_S4: J15.6, J28.10
~LD_F: J18.5, J28.7
~LD_G: J21.5, J28.3
~LD_S3: J10.5, J28.15
~LD_S4: J15.5, J28.11
~LS_A: J3.2, J29.15
~LS_C: J5.2, J29.11
~LS_D: J6.2, J29.7
~LS_E: J7.2, J29.3
~LS_S1: J8.2, J29.23
~LS_S2: J9.2, J29.19
~MS_A: J3.1, J29.16
~MS_C: J5.1, J29.12
~MS_D: J6.1, J29.8
~MS_E: J7.1, J29.4
~MS_S1: J8.1, J29.24
~MS_S2: J9.1, J29.20
~RD: J1.5, J2.18
~TX_ASSERT_ADDRESS: J25.3, J28.22
~TX_ASSERT_LSB_MAIN: J25.5, J28.20
~TX_ASSERT_MSB_MAIN: J25.4, J28.21
~WR: J1.6, J2.17

Notes on the sheet:
External Controls
GPR Backplane
8bit General Purpose Registers
