theWickedWebDev/8-bit-computer/PCB-Modules/01_BACKPLANES/register-backplane/backplane.sch

## KiCad design PCB-Modules/01_BACKPLANES/register-backplane/backplane.sch (2021-11-19)

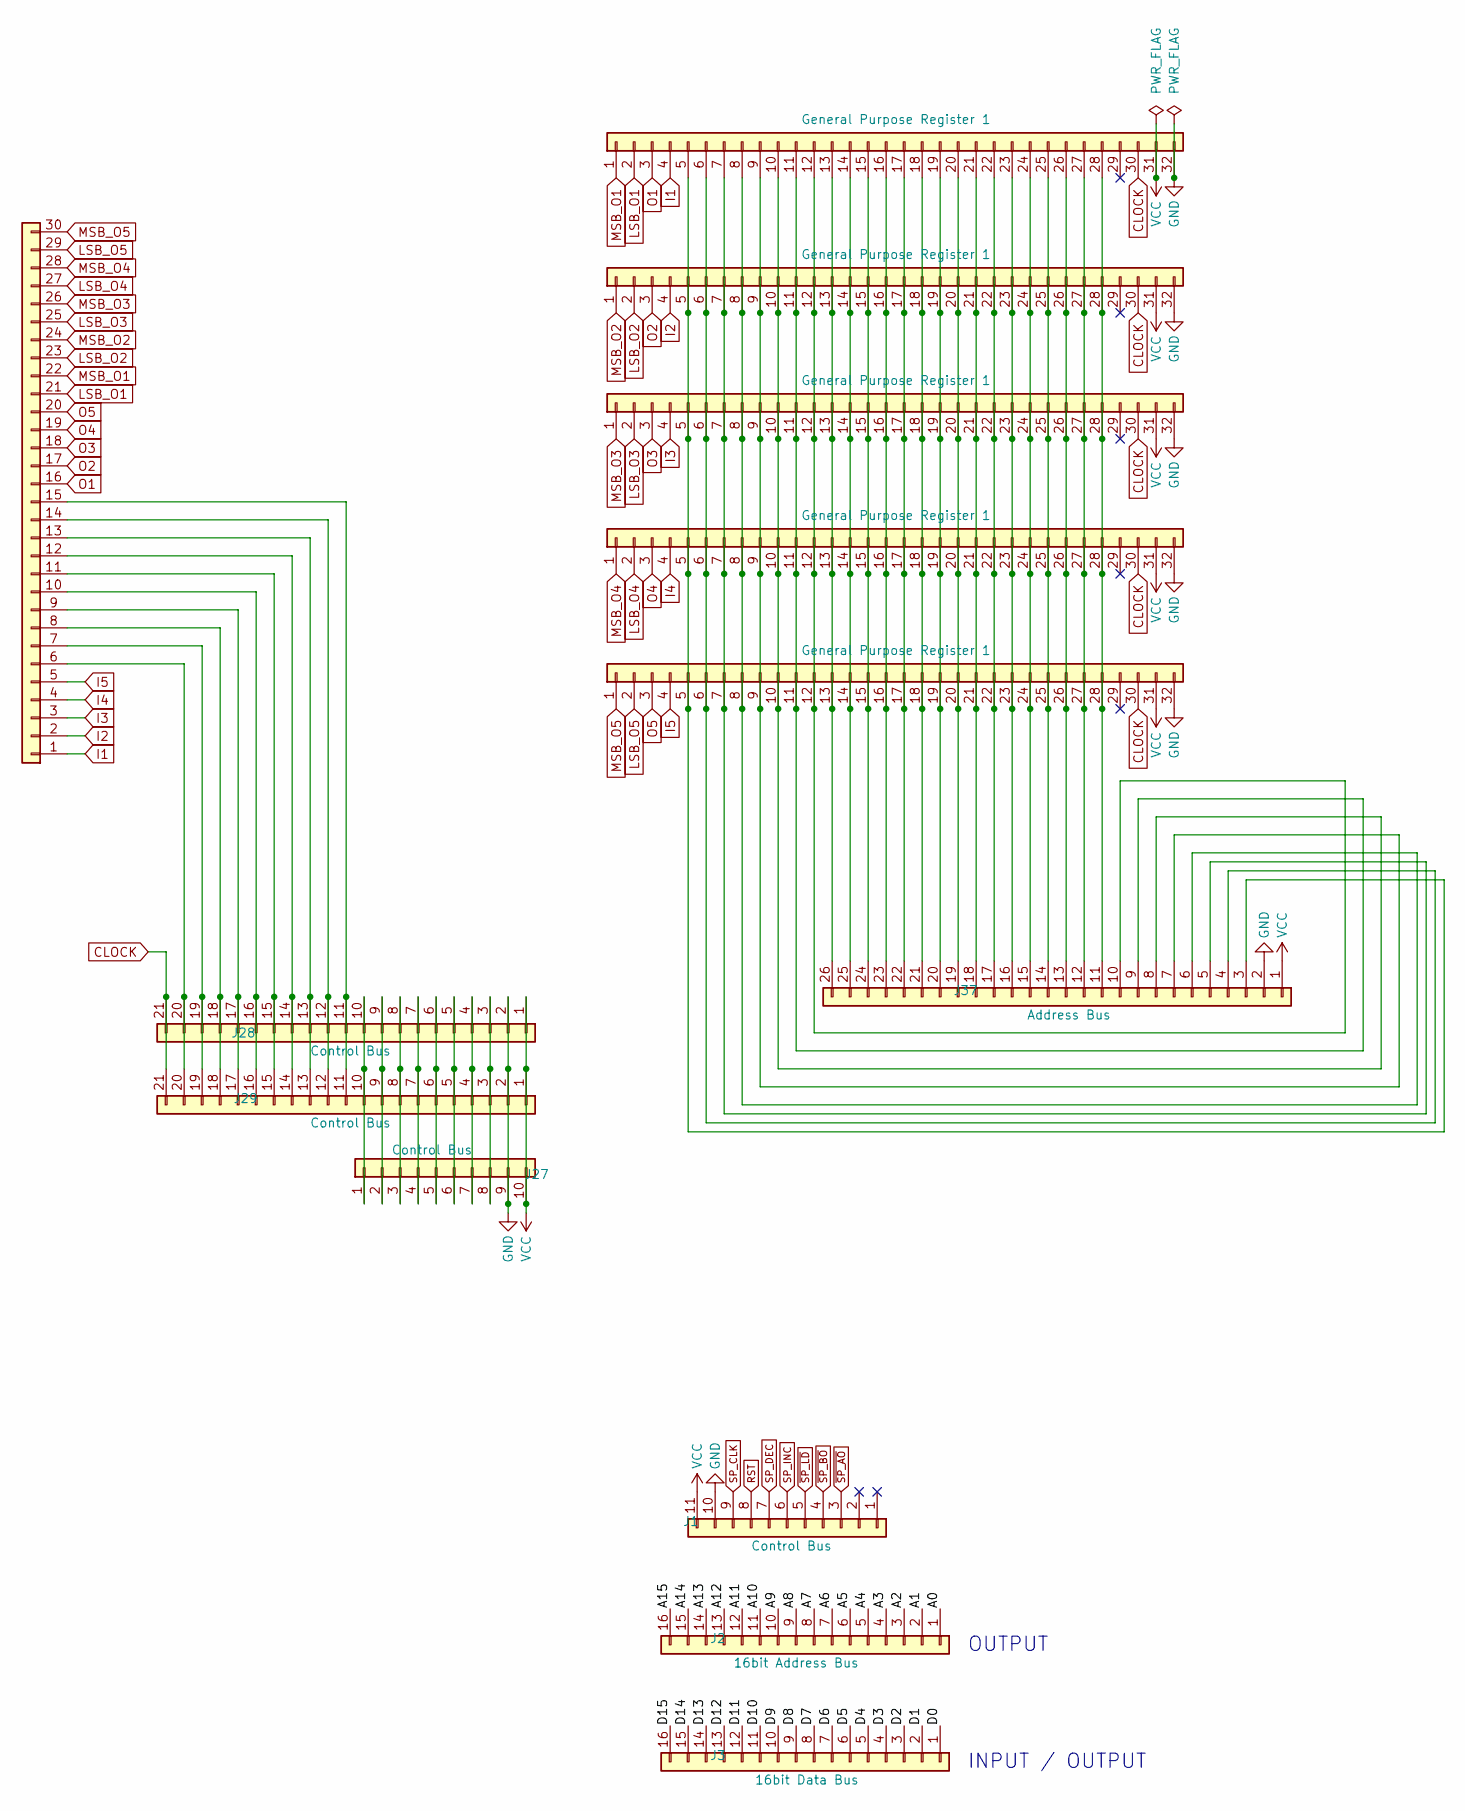
[picture p340: schematic backplane.sch]

Parts:
J1: Conn_01x11; PinHeader_1x11_P2.54mm_Vertical
J2, J3: Conn_01x16; PinHeader_1x16_P2.54mm_Vertical
J27: Conn_01x10; PinSocket_1x10_P2.54mm_Vertical
J28: Conn_01x21; PinSocket_1x21_P2.54mm_Vertical
J29: Conn_01x21; PinSocket_1x21_P2.54mm_Horizontal
J30: Conn_01x30; PinSocket_1x30_P2.54mm_Vertical
J32, J33, J34, J35, J36: Conn_01x32; PinSocket_1x32_P2.54mm_Vertical
J37: Conn_01x26; PinHeader_1x26_P2.54mm_Horizontal

Connections:
A0: J2.1
A1: J2.2
A2: J2.3
A3: J2.4
A4: J2.5
A5: J2.6
A6: J2.7
A7: J2.8
A8: J2.9
A9: J2.10
A10: J2.11
A11: J2.12
A12: J2.13
A13: J2.14
A14: J2.15
A15: J2.16
CLOCK: J28.21, J29.21, J32.30, J33.30, J34.30, J35.30, J36.30
D0: J3.1
D1: J3.2
D2: J3.3
D3: J3.4
D4: J3.5
D5: J3.6
D6: J3.7
D7: J3.8
D8: J3.9
D9: J3.10
D10: J3.11
D11: J3.12
D12: J3.13
D13: J3.14
D14: J3.15
D15: J3.16
GND: J1.10, J27.9, J28.2, J29.2, J32.32, J33.32, J34.32, J35.32, J36.32, J37.2
I1: J30.1, J32.4
I2: J30.2, J33.4
I3: J30.3, J34.4
I4: J30.4, J35.4
I5: J30.5, J36.4
LSB_O1: J30.21, J32.2
LSB_O2: J30.23, J33.2
LSB_O3: J30.25, J34.2
LSB_O4: J30.27, J35.2
LSB_O5: J30.29, J36.2
MSB_O1: J30.22, J32.1
MSB_O2: J30.24, J33.1
MSB_O3: J30.26, J34.1
MSB_O4: J30.28, J35.1
MSB_O5: J30.30, J36.1
unnamed: J27.1, J28.10, J29.10
unnamed: J27.2, J28.9, J29.9
unnamed: J27.3, J28.8, J29.8
unnamed: J27.4, J28.7, J29.7
unnamed: J27.5, J28.6, J29.6
unnamed: J27.6, J28.5, J29.5
unnamed: J27.7, J28.4, J29.4
unnamed: J27.8, J28.3, J29.3
unnamed: J28.11, J29.11, J30.15
unnamed: J28.12, J29.12, J30.14
unnamed: J28.13, J29.13, J30.13
unnamed: J28.14, J29.14, J30.12
unnamed: J28.15, J29.15, J30.11
unnamed: J28.16, J29.16, J30.10
unnamed: J28.17, J29.17, J30.9
unnamed: J28.18, J29.18, J30.8
unnamed: J28.19, J29.19, J30.7
unnamed: J28.20, J29.20, J30.6
unnamed: J32.5, J33.5, J34.5, J35.5, J36.5, J37.3
unnamed: J32.6, J33.6, J34.6, J35.6, J36.6, J37.4
unnamed: J32.7, J33.7, J34.7, J35.7, J36.7, J37.5
unnamed: J32.8, J33.8, J34.8, J35.8, J36.8, J37.6
unnamed: J32.9, J33.9, J34.9, J35.9, J36.9, J37.7
unnamed: J32.10, J33.10, J34.10, J35.10, J36.10, J37.8
unnamed: J32.11, J33.11, J34.11, J35.11, J36.11, J37.9
unnamed: J32.12, J33.12, J34.12, J35.12, J36.12, J37.10
unnamed: J32.13, J33.13, J34.13, J35.13, J36.13, J37.26
unnamed: J32.14, J33.14, J34.14, J35.14, J36.14, J37.25
unnamed: J32.15, J33.15, J34.15, J35.15, J36.15, J37.24
unnamed: J32.16, J33.16, J34.16, J35.16, J36.16, J37.23
unnamed: J32.17, J33.17, J34.17, J35.17, J36.17, J37.22
unnamed: J32.18, J33.18, J34.18, J35.18, J36.18, J37.21
unnamed: J32.19, J33.19, J34.19, J35.19, J36.19, J37.20
unnamed: J32.20, J33.20, J34.20, J35.20, J36.20, J37.19
unnamed: J32.21, J33.21, J34.21, J35.21, J36.21, J37.18
unnamed: J32.22, J33.22, J34.22, J35.22, J36.22, J37.17
unnamed: J32.23, J33.23, J34.23, J35.23, J36.23, J37.16
unnamed: J32.24, J33.24, J34.24, J35.24, J36.24, J37.15
unnamed: J32.25, J33.25, J34.25, J35.25, J36.25, J37.14
unnamed: J32.26, J33.26, J34.26, J35.26, J36.26, J37.13
unnamed: J32.27, J33.27, J34.27, J35.27, J36.27, J37.12
unnamed: J32.28, J33.28, J34.28, J35.28, J36.28, J37.11
O1: J30.16, J32.3
O2: J30.17, J33.3
O3: J30.18, J34.3
O4: J30.19, J35.3
O5: J30.20, J36.3
RST: J1.8
SP_CLK: J1.9
SP_DEC: J1.7
SP_INC: J1.6
VCC: J1.11, J27.10, J28.1, J29.1, J32.31, J33.31, J34.31, J35.31, J36.31, J37.1
~SP_AO: J1.3
~SP_BO: J1.4
~SP_LD: J1.5

Notes on the sheet:
INPUT / OUTPUT
OUTPUT
