theWickedWebDev/8-bit-computer/PCB-Modules/99_IN PROGRESS/SHIFT/SHIFT.sch

## KiCad design PCB-Modules/99_IN PROGRESS/SHIFT/SHIFT.sch (2021-11-19)

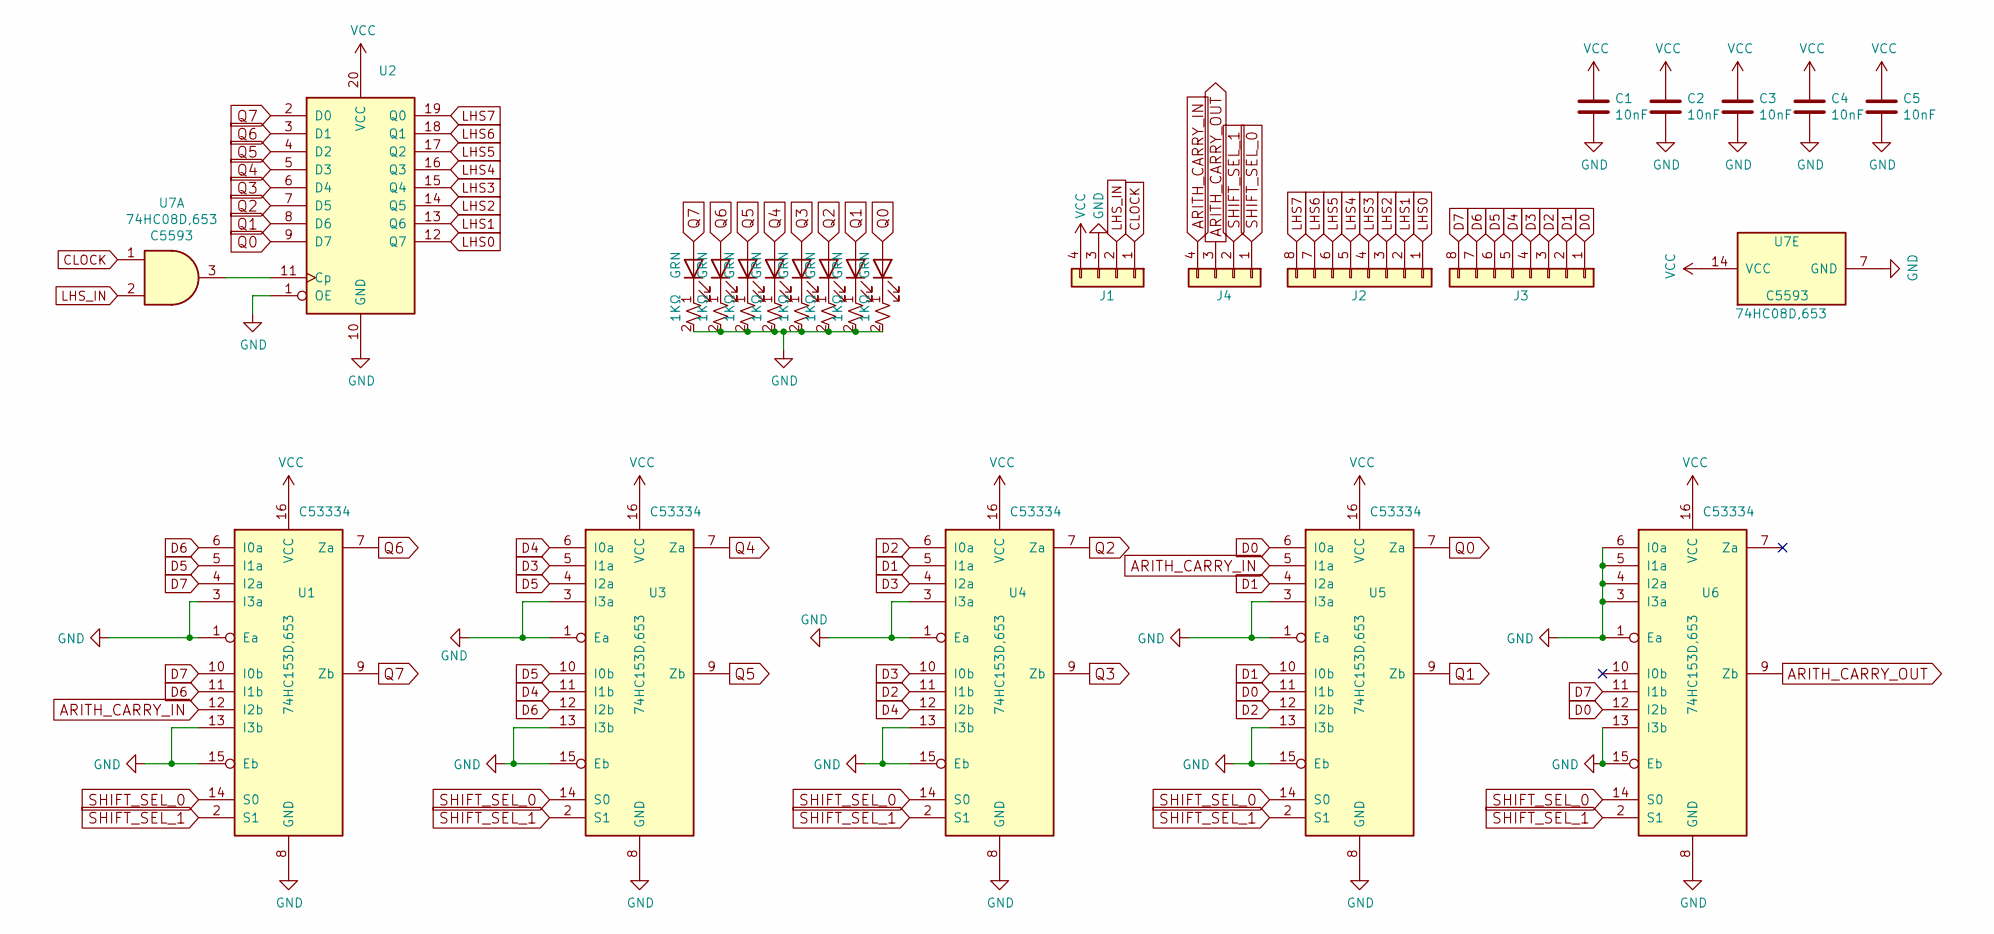
[picture p341: schematic SHIFT.sch]

Parts:
C1, C2, C3, C4, C5: 0603B103K500NT; C_0603_1608Metric
D1, D2, D3, D4, D5, D6, D7, D8: C2297; LED_0805_2012Metric
J1, J4: Conn_01x04; PinHeader_1x04_P2.54mm_Vertical
J2, J3: Conn_01x08; PinHeader_1x08_P2.54mm_Vertical
U1, U3, U4, U5, U6: 74HC153D,653; SOIC-16_3.9x9.9mm_P1.27mm
U2: 74HCT574; SOIC-20W_7.5x12.8mm_P1.27mm
U7: 74HC08D,653; SOIC-14_3.9x8.7mm_P1.27mm
U8, U9, U10, U11, U12, U13, U14, U15: 0603WAF1001T5E; R_0603_1608Metric

Connections:
ARITH_CARRY_IN: J4.4, U1.12 (I2b), U5.5 (I1a)
ARITH_CARRY_OUT: J4.3, U6.9 (Zb)
CLOCK: J1.1, U7.1
D0: J3.1, U5.6 (I0a), U5.11 (I1b), U6.12 (I2b)
D1: J3.2, U4.5 (I1a), U5.4 (I2a), U5.10 (I0b)
D2: J3.3, U4.6 (I0a), U4.11 (I1b), U5.12 (I2b)
D3: J3.4, U3.5 (I1a), U4.4 (I2a), U4.10 (I0b)
D4: J3.5, U3.6 (I0a), U3.11 (I1b), U4.12 (I2b)
D5: J3.6, U1.5 (I1a), U3.4 (I2a), U3.10 (I0b)
D6: J3.7, U1.6 (I0a), U1.11 (I1b), U3.12 (I2b)
D7: J3.8, U1.4 (I2a), U1.10 (I0b), U6.11 (I1b)
GND: C1.2, C2.2, C3.2, C4.2, C5.2, J1.3, U1.1 (Ea), U1.3 (I3a), U1.8 (GND), U1.13 (I3b), U1.15 (Eb), U2.1 (OE), U2.10 (GND), U3.1 (Ea), U3.3 (I3a), U3.8 (GND), U3.13 (I3b), U3.15 (Eb), U4.1 (Ea), U4.3 (I3a), U4.8 (GND), U4.13 (I3b), U4.15 (Eb), U5.1 (Ea), U5.3 (I3a), U5.8 (GND), U5.13 (I3b), U5.15 (Eb), U6.1 (Ea), U6.3 (I3a), U6.4 (I2a), U6.5 (I1a), U6.6 (I0a), U6.8 (GND), U6.13 (I3b), U6.15 (Eb), U7.7 (GND), U8.2, U9.2, U10.2, U11.2, U12.2, U13.2, U14.2, U15.2
LHS0: J2.1, U2.12 (Q7)
LHS1: J2.2, U2.13 (Q6)
LHS2: J2.3, U2.14 (Q5)
LHS3: J2.4, U2.15 (Q4)
LHS4: J2.5, U2.16 (Q3)
LHS5: J2.6, U2.17 (Q2)
LHS6: J2.7, U2.18 (Q1)
LHS7: J2.8, U2.19 (Q0)
LHS_IN: J1.2, U7.2
unnamed: D1.1 (K), U8.1
unnamed: D2.1 (K), U9.1
unnamed: D3.1 (K), U10.1
unnamed: D4.1 (K), U11.1
unnamed: D5.1 (K), U12.1
unnamed: D6.1 (K), U13.1
unnamed: D7.1 (K), U14.1
unnamed: D8.1 (K), U15.1
unnamed: U2.11 (Cp), U7.3
Q0: D8.2 (A), U2.9 (D7), U5.7 (Za)
Q1: D7.2 (A), U2.8 (D6), U5.9 (Zb)
Q2: D6.2 (A), U2.7 (D5), U4.7 (Za)
Q3: D5.2 (A), U2.6 (D4), U4.9 (Zb)
Q4: D4.2 (A), U2.5 (D3), U3.7 (Za)
Q5: D3.2 (A), U2.4 (D2), U3.9 (Zb)
Q6: D2.2 (A), U1.7 (Za), U2.3 (D1)
Q7: D1.2 (A), U1.9 (Zb), U2.2 (D0)
SHIFT_SEL_0: J4.1, U1.14 (S0), U3.14 (S0), U4.14 (S0), U5.14 (S0), U6.14 (S0)
SHIFT_SEL_1: J4.2, U1.2 (S1), U3.2 (S1), U4.2 (S1), U5.2 (S1), U6.2 (S1)
VCC: C1.1, C2.1, C3.1, C4.1, C5.1, J1.4, U1.16 (VCC), U2.20 (VCC), U3.16 (VCC), U4.16 (VCC), U5.16 (VCC), U6.16 (VCC), U7.14 (VCC)
