theWickedWebDev/8-bit-computer/PCB-Modules/99_IN PROGRESS/cond-jmp-transistors/cond-jmp-transistors.sch

## KiCad design PCB-Modules/99_IN PROGRESS/cond-jmp-transistors/cond-jmp-transistors.sch (2021-11-28)

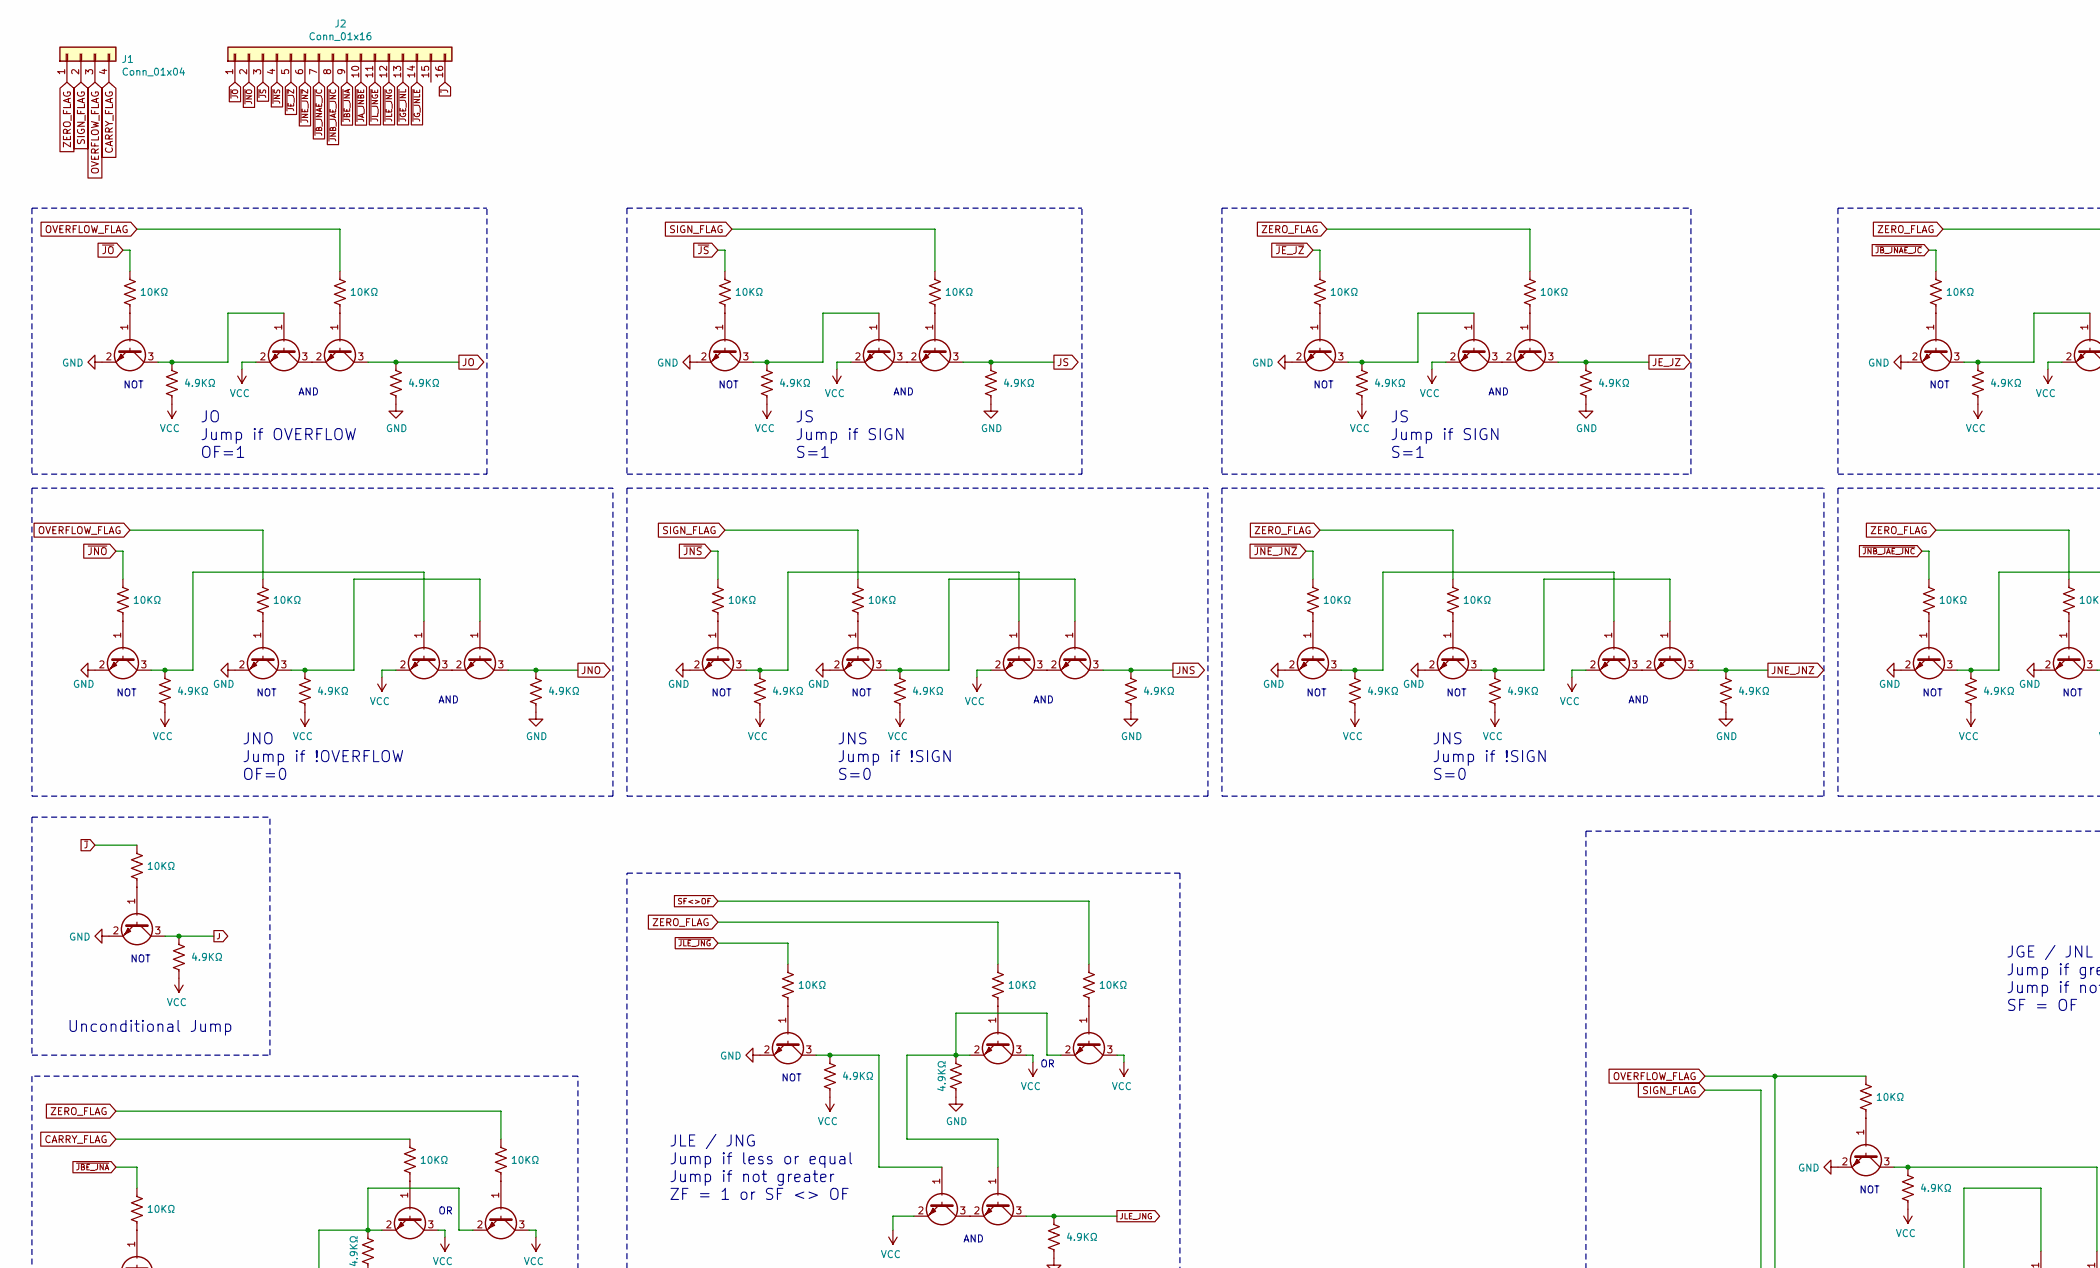
[picture p342: schematic cond-jmp-transistors.sch, part in row 1, column 1]

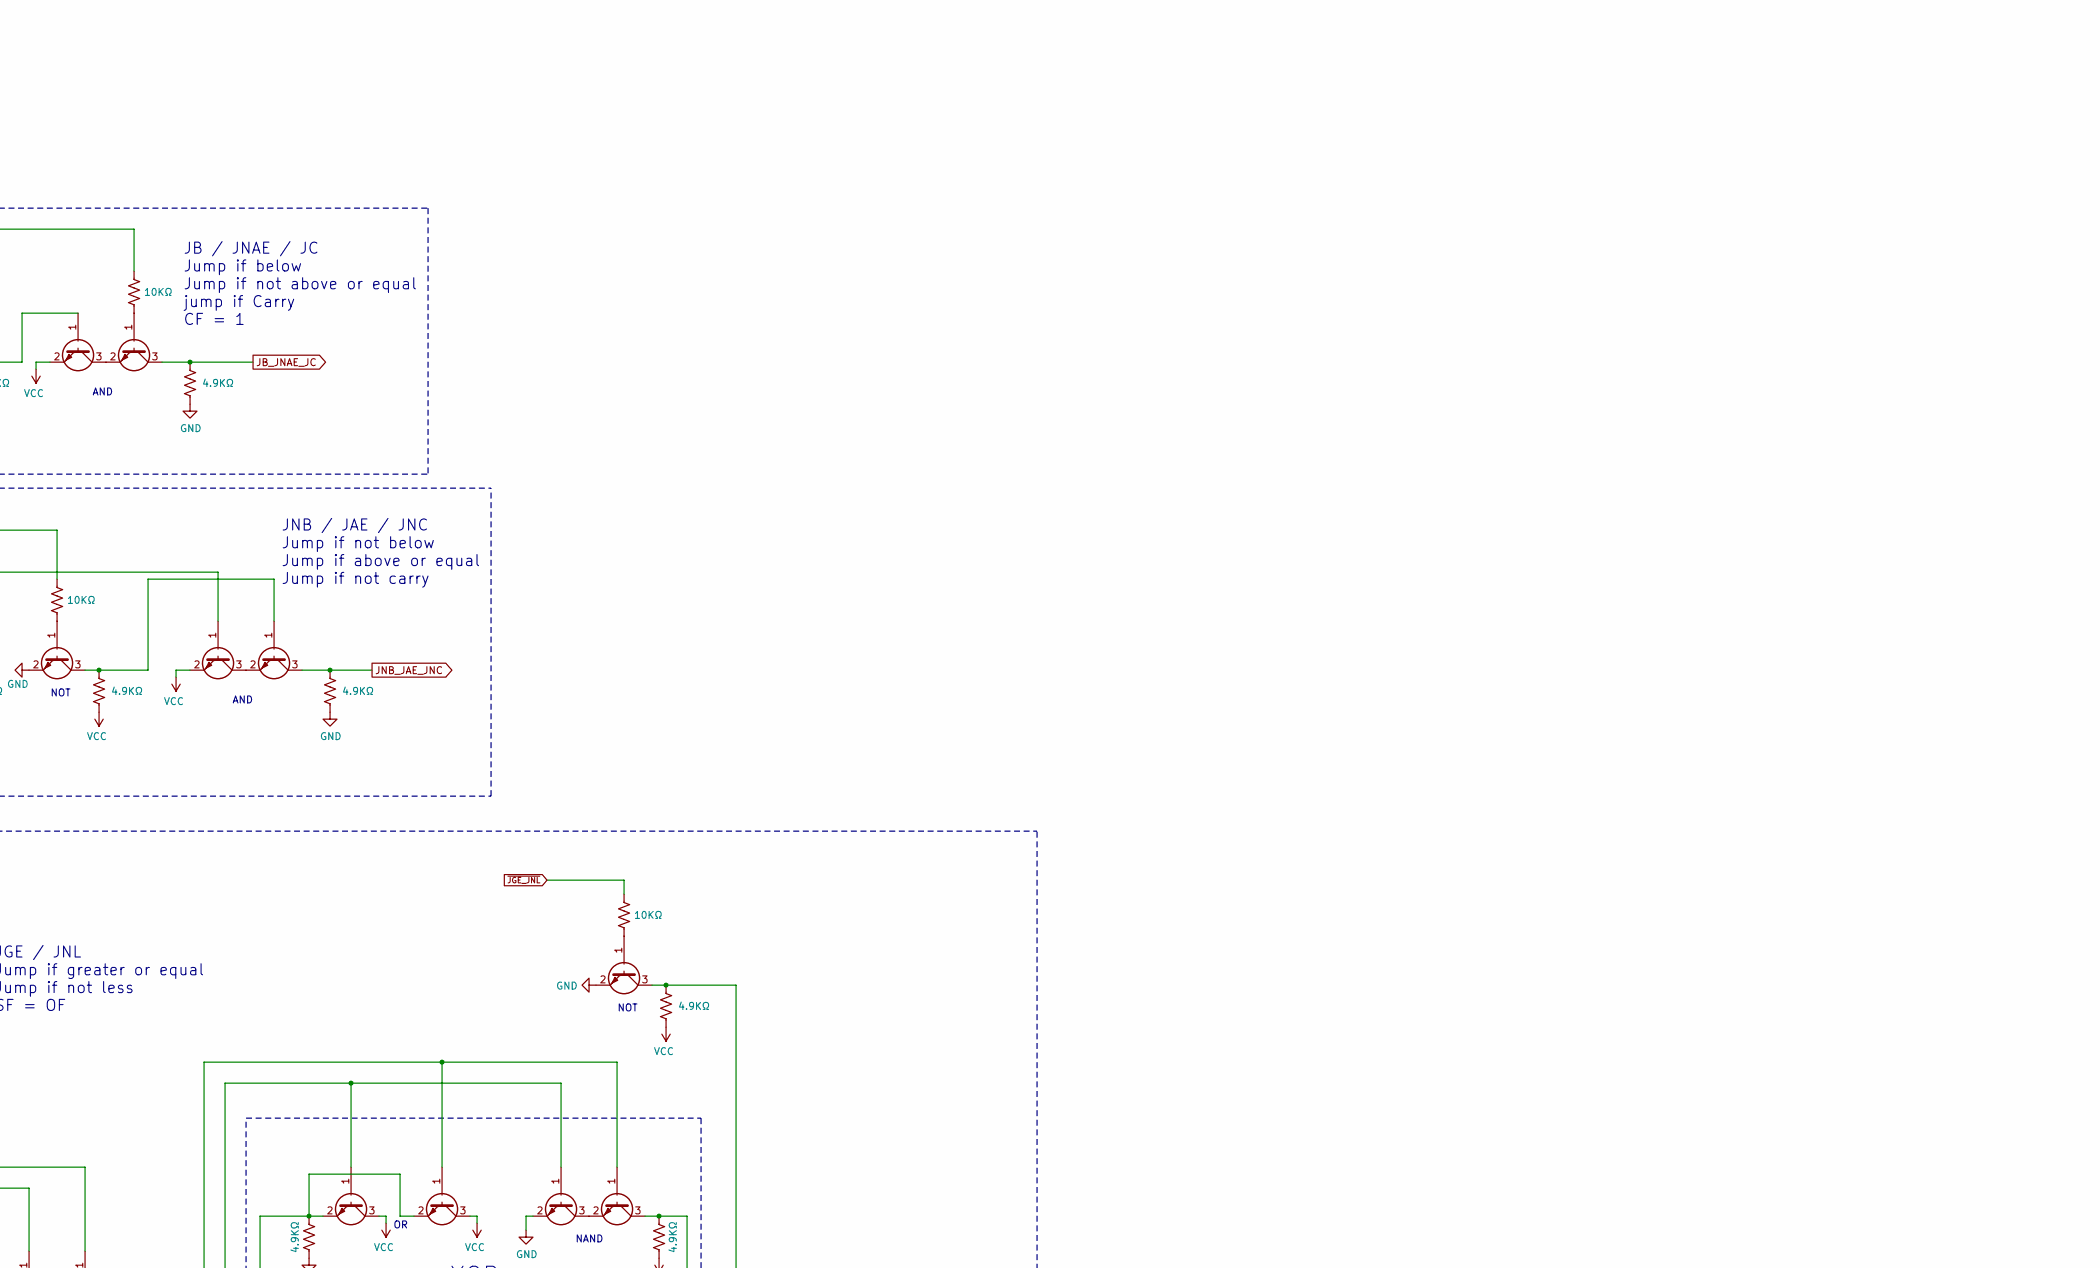
[picture p343: schematic cond-jmp-transistors.sch, part in row 1, column 2]

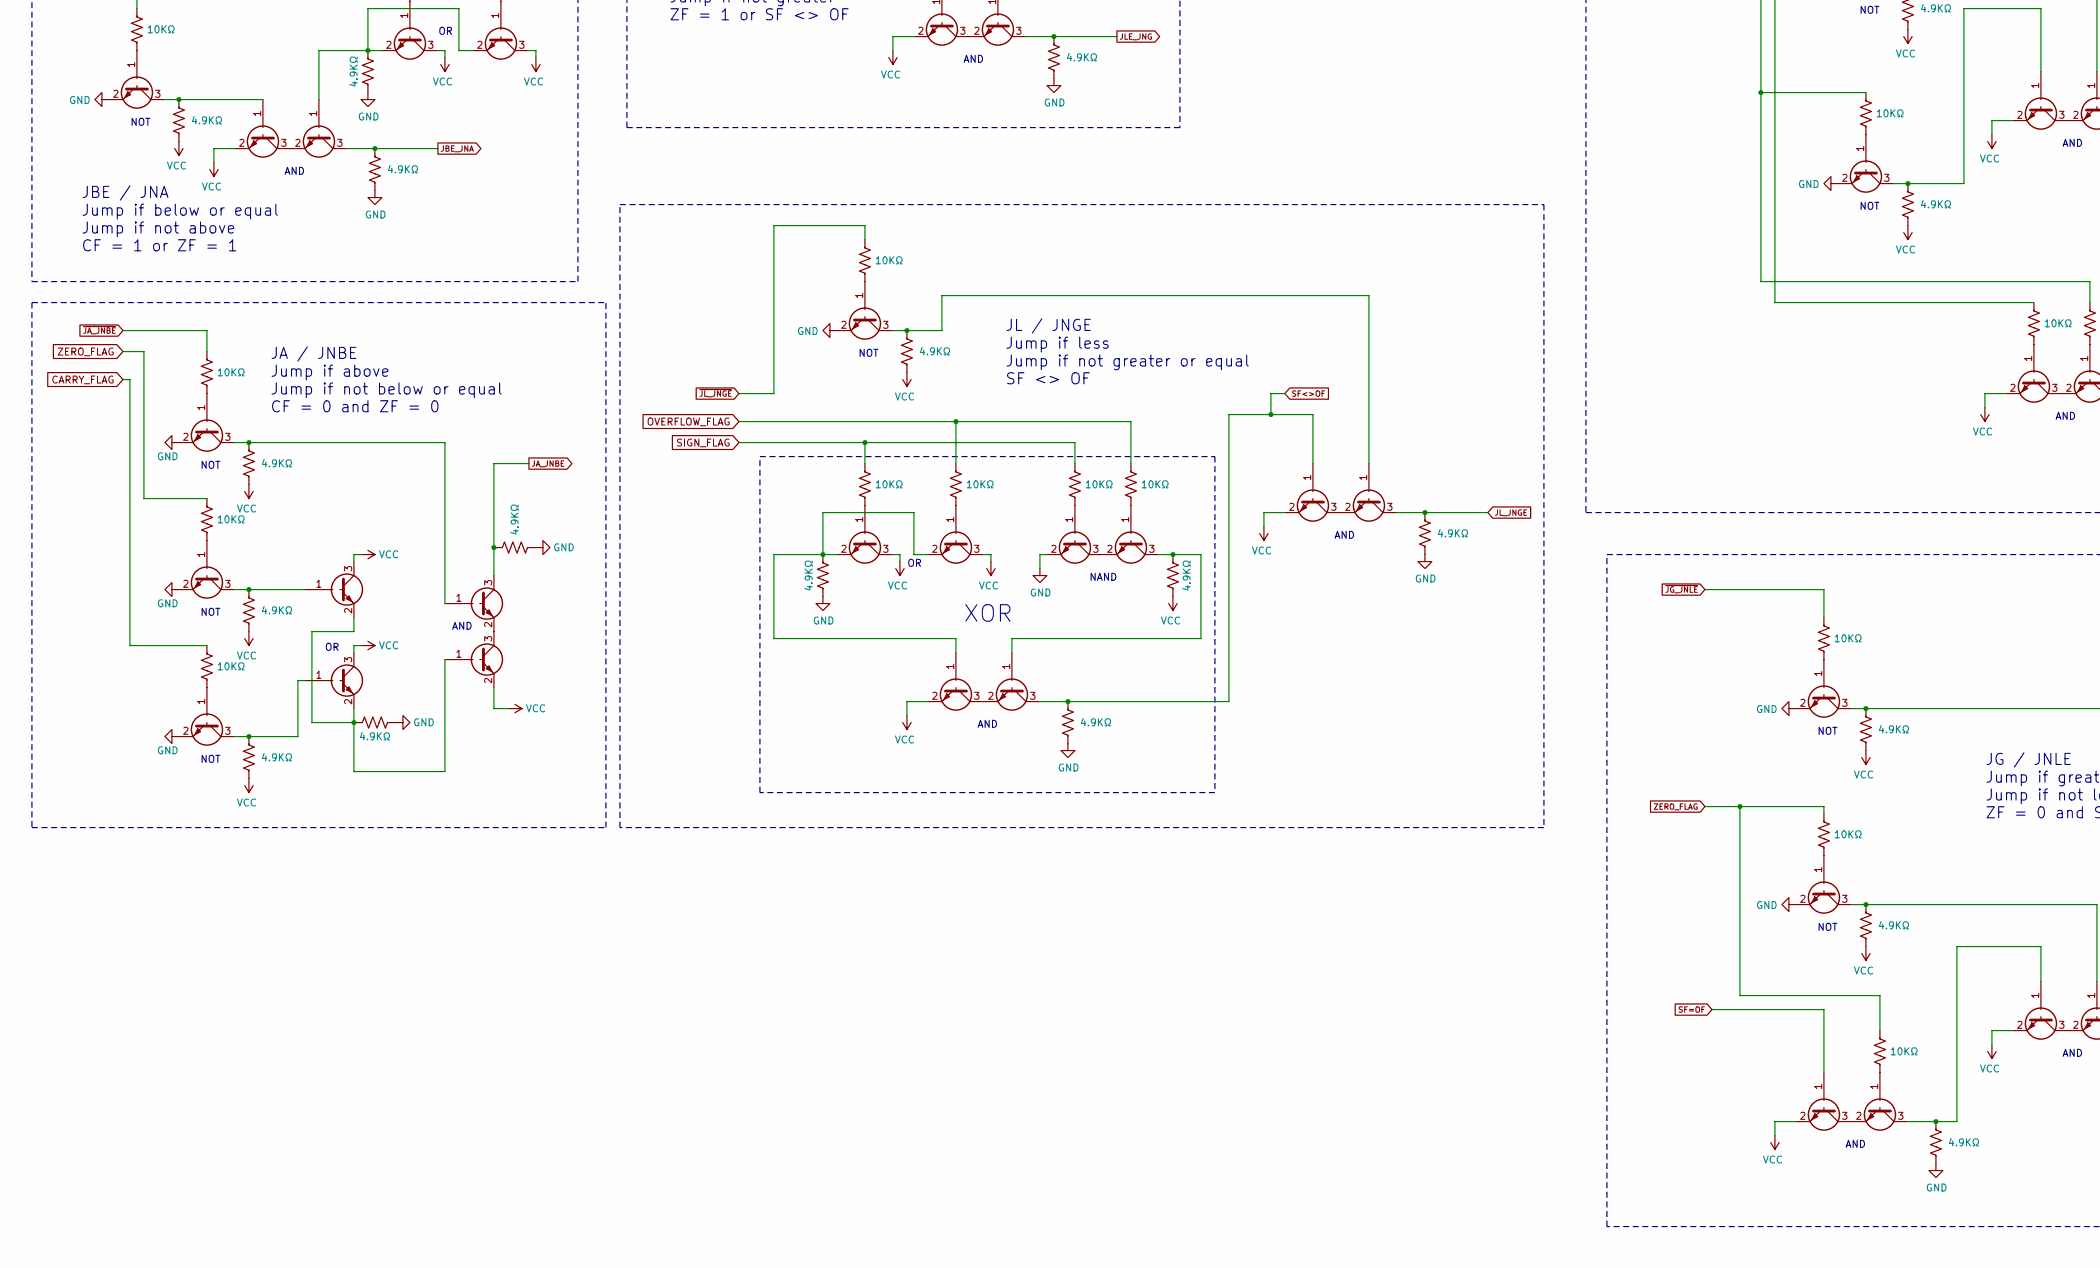
[picture p344: schematic cond-jmp-transistors.sch, part in row 2, column 1]

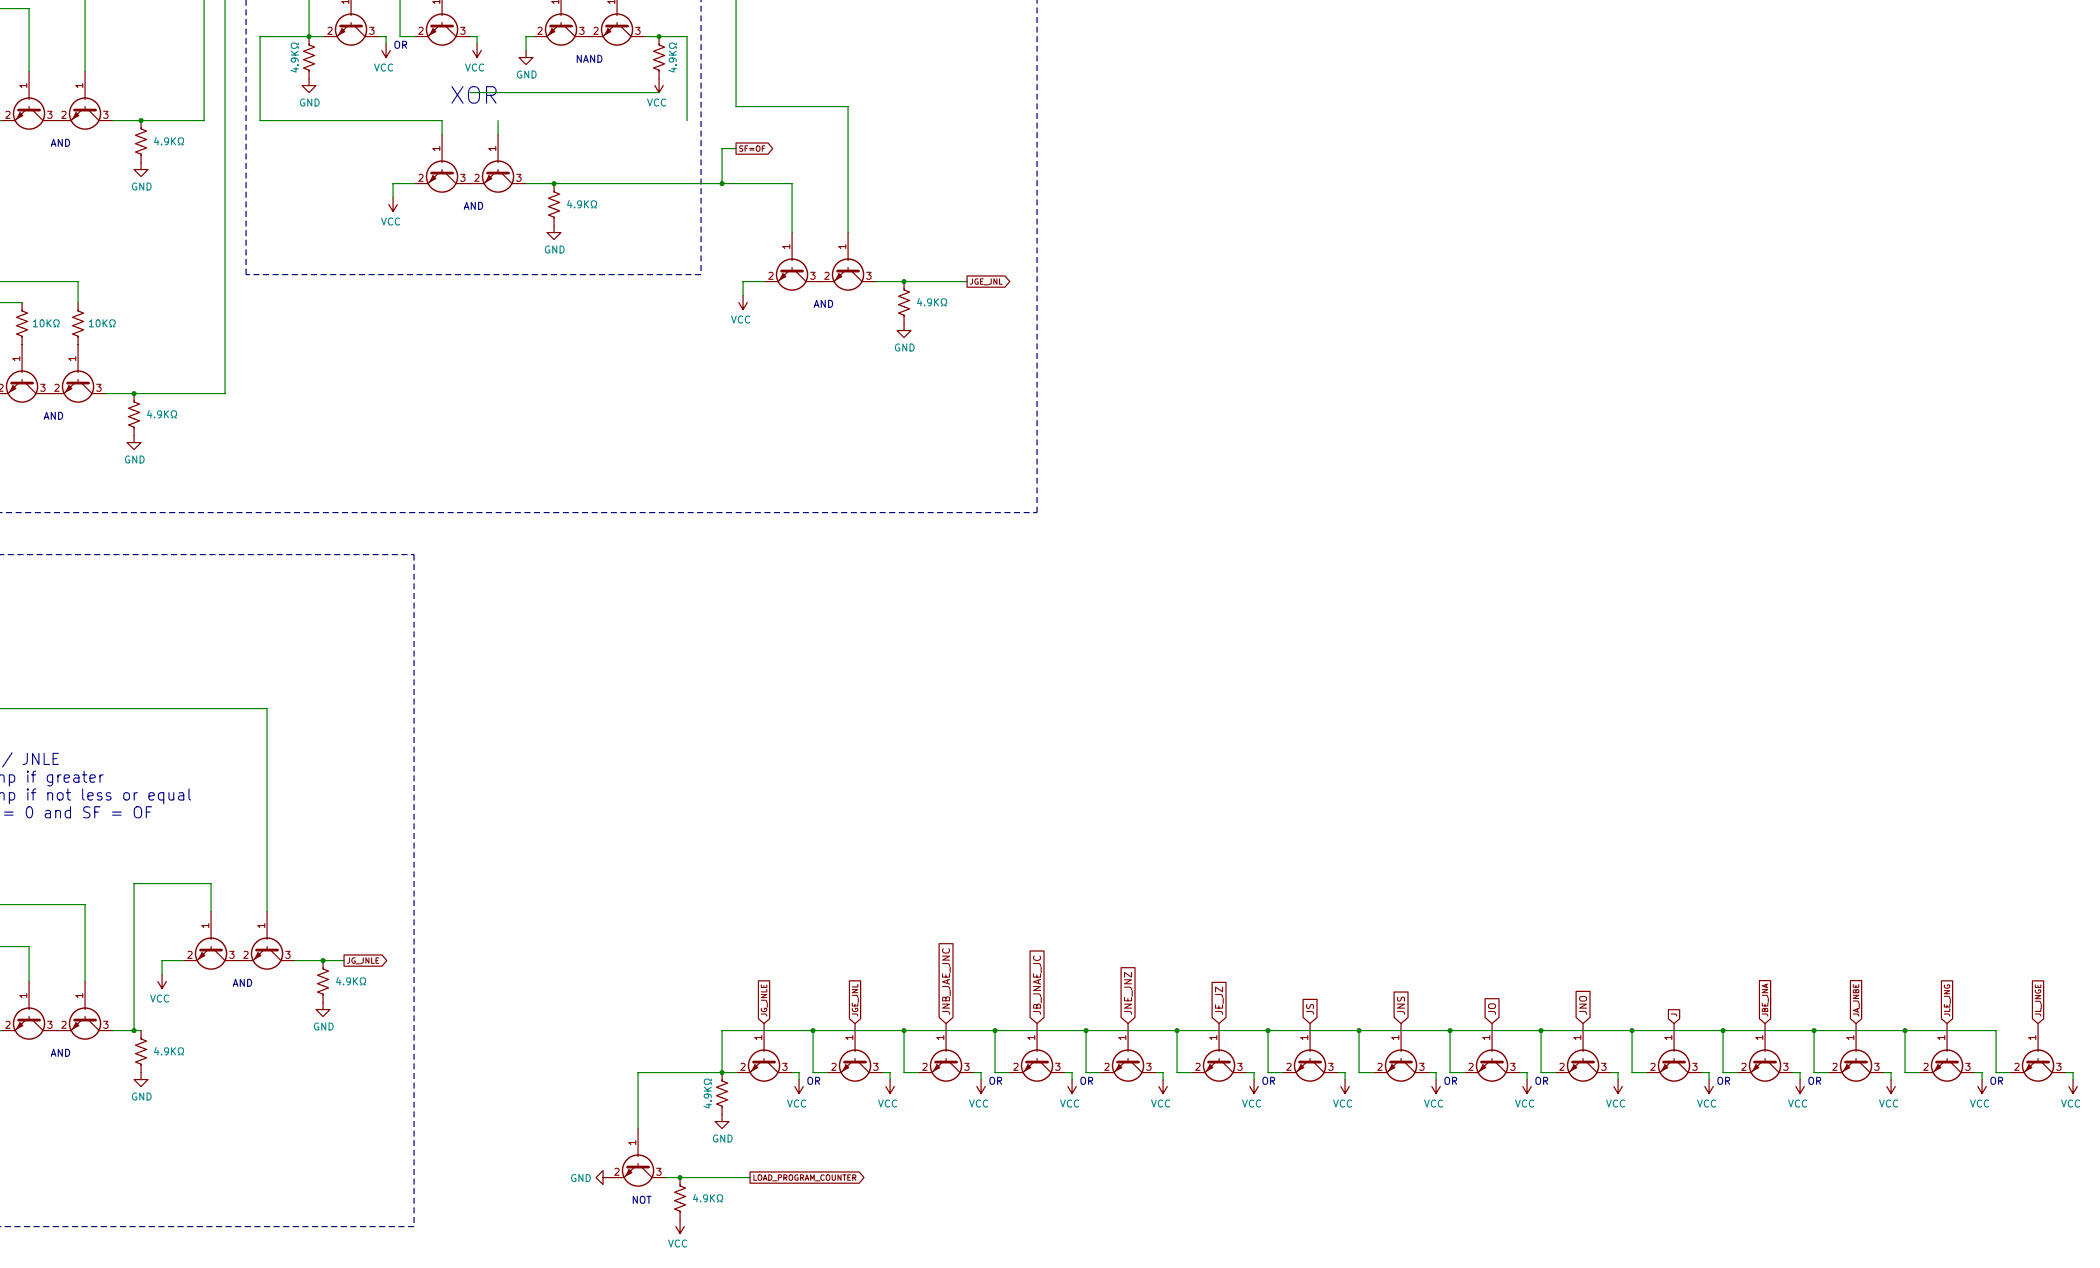
[picture p345: schematic cond-jmp-transistors.sch, part in row 2, column 2]

Parts:
J1: Conn_01x04; PinHeader_1x04_P2.54mm_Vertical
J2: Conn_01x16; PinHeader_1x16_P2.54mm_Vertical
Q1, Q2, Q3, Q4, Q5, Q6, Q7, Q8, Q9, Q10, Q11, Q12, Q13, Q14, Q15, Q16, Q17, Q18, Q19, Q20, Q21, Q22, Q23, Q24, Q25, Q26, Q27, Q28, Q29, Q30, Q31, Q32, Q33, Q34, Q35, Q36, Q37, Q38, Q39, Q40, Q41, Q42, Q43, Q44, Q45, Q46, Q47, Q48, Q49, Q50, Q51, Q52, Q53, Q54, Q55, Q56, Q57, Q58, Q59, Q60, Q61, Q62, Q63, Q64, Q65, Q66, Q67, Q68, Q69, Q70, Q71, Q72, Q73, Q74, Q75, Q76, Q77, Q78, Q79, Q80, Q81, Q82, Q83, Q84, Q85, Q86, Q87, Q88, Q89, Q90, Q91, Q92, Q93, Q94: PMBT2222; SOT-23
R1, R2, R5, R7, R10, R11, R14, R16, R19, R20, R23, R25, R28, R29, R32, R34, R37, R41, R42, R43, R45, R46, R47, R54, R55, R57, R59, R60, R63, R66, R68, R69, R70, R73, R74, R79, R83, R84, R87: 10kohm; R_0805_2012Metric
R3, R4, R6, R8, R9, R12, R13, R15, R17, R18, R21, R22, R24, R26, R27, R30, R31, R33, R35, R36, R38, R39, R40, R44, R48, R49, R50, R51, R52, R53, R56, R58, R61, R62, R64, R65, R67, R71, R72, R75, R76, R77, R78, R80, R81, R82, R85, R86, R88, R89, R90, R91, R92: 3.9kohm; R_0805_2012Metric

Connections:
CARRY_FLAG: J1.4, R41.1, R47.1
GND: Q1.2 (C), Q2.2 (C), Q3.2 (C), Q8.2 (C), Q9.2 (C), Q10.2 (C), Q15.2 (C), Q16.2 (C), Q17.2 (C), Q22.2 (C), Q23.2 (C), Q24.2 (C), Q29.2 (C), Q34.2 (C), Q35.2 (C), Q36.2 (C), Q37.2 (C), Q42.2 (C), Q47.2 (C), Q51.2 (C), Q56.2 (C), Q57.2 (C), Q66.2 (C), Q68.2 (C), Q71.2 (C), Q72.2 (C), Q79.2 (C), R8.2, R9.2, R17.2, R18.2, R26.2, R27.2, R35.2, R36.2, R39.1, R40.2, R51.1, R52.2, R53.1, R58.2, R62.2, R65.1, R67.2, R75.2, R76.2, R77.1, R78.2, R82.2, R88.2, R89.2, R90.2, R92.1
J: Q34.3 (E), Q90.1 (B), R44.1
JA_JNBE: Q40.3 (E), Q92.1 (B), R52.1
JBE_JNA: Q31.3 (E), Q91.1 (B), R40.1
JB_JNAE_JC: Q26.3 (E), Q83.1 (B), R35.1
JE_JZ: Q19.3 (E), Q85.1 (B), R26.1
JGE_JNL: Q70.3 (E), Q81.1 (B), R82.1
JG_JNLE: Q78.3 (E), Q80.1 (B), R90.1
JLE_JNG: Q54.3 (E), Q93.1 (B), R67.1
JL_JNGE: Q50.3 (E), Q94.1 (B), R62.1
JNB_JAE_JNC: Q28.3 (E), Q82.1 (B), R36.1
JNE_JNZ: Q21.3 (E), Q84.1 (B), R27.1
JNO: Q7.3 (E), Q89.1 (B), R9.1
JNS: Q14.3 (E), Q87.1 (B), R18.1
JO: Q5.3 (E), Q88.1 (B), R8.1
JS: Q12.3 (E), Q86.1 (B), R17.1
LOAD_PROGRAM_COUNTER: Q79.3 (E), R91.1
unnamed: Q1.1 (B), R1.2
unnamed: Q1.3 (E), Q6.1 (B), R3.1
unnamed: Q2.1 (B), R2.2
unnamed: Q2.3 (E), Q4.1 (B), R4.1
unnamed: Q3.1 (B), R5.2
unnamed: Q3.3 (E), Q7.1 (B), R6.1
unnamed: Q4.3 (E), Q5.2 (C)
unnamed: Q5.1 (B), R7.2
unnamed: Q6.3 (E), Q7.2 (C)
unnamed: Q8.1 (B), R10.2
unnamed: Q9.1 (B), R11.2
unnamed: Q10.1 (B), R14.2
unnamed: Q10.3 (E), Q14.1 (B), R15.1
unnamed: Q9.3 (E), Q11.1 (B), R13.1
unnamed: Q11.3 (E), Q12.2 (C)
unnamed: Q12.1 (B), R16.2
unnamed: Q8.3 (E), Q13.1 (B), R12.1
unnamed: Q13.3 (E), Q14.2 (C)
unnamed: Q15.1 (B), R19.2
unnamed: Q15.3 (E), Q20.1 (B), R21.1
unnamed: Q16.1 (B), R20.2
unnamed: Q16.3 (E), Q18.1 (B), R22.1
unnamed: Q17.1 (B), R23.2
unnamed: Q17.3 (E), Q21.1 (B), R24.1
unnamed: Q18.3 (E), Q19.2 (C)
unnamed: Q19.1 (B), R25.2
unnamed: Q20.3 (E), Q21.2 (C)
unnamed: Q22.1 (B), R28.2
unnamed: Q22.3 (E), Q27.1 (B), R30.1
unnamed: Q23.1 (B), R29.2
unnamed: Q23.3 (E), Q25.1 (B), R31.1
unnamed: Q24.1 (B), R32.2
unnamed: Q24.3 (E), Q28.1 (B), R33.1
unnamed: Q25.3 (E), Q26.2 (C)
unnamed: Q26.1 (B), R34.2
unnamed: Q27.3 (E), Q28.2 (C)
unnamed: Q29.1 (B), R37.2
unnamed: Q29.3 (E), Q30.1 (B), R38.1
unnamed: Q30.3 (E), Q31.2 (C)
unnamed: Q31.1 (B), Q32.2 (C), Q33.2 (C), R39.2
unnamed: Q32.1 (B), R41.2
unnamed: Q33.1 (B), R42.2
unnamed: Q34.1 (B), R43.2
unnamed: Q35.1 (B), R45.2
unnamed: Q35.3 (E), Q40.1 (B), R48.1
unnamed: Q36.1 (B), R46.2
unnamed: Q36.3 (E), Q38.1 (B), R49.1
unnamed: Q37.1 (B), R47.2
unnamed: Q37.3 (E), Q39.1 (B), R50.1
unnamed: Q38.2 (C), Q39.2 (C), Q41.1 (B), R51.2
unnamed: Q40.2 (C), Q41.3 (E)
unnamed: Q42.1 (B), R54.2
unnamed: Q42.3 (E), Q50.1 (B), R56.1
unnamed: Q43.1 (B), R55.2
unnamed: Q43.2 (C), Q44.2 (C), Q45.1 (B), R53.2
unnamed: Q44.1 (B), R57.2
unnamed: Q45.3 (E), Q46.2 (C)
unnamed: Q46.1 (B), Q48.3 (E), R61.2
unnamed: Q47.1 (B), R59.2
unnamed: Q47.3 (E), Q48.2 (C)
unnamed: Q48.1 (B), R60.2
unnamed: Q49.3 (E), Q50.2 (C)
unnamed: Q51.1 (B), R63.2
unnamed: Q51.3 (E), Q52.1 (B), R64.1
unnamed: Q52.3 (E), Q54.2 (C)
unnamed: Q53.1 (B), R66.2
unnamed: Q53.2 (C), Q54.1 (B), Q55.2 (C), R65.2
unnamed: Q55.1 (B), R68.2
unnamed: Q56.1 (B), R69.2
unnamed: Q56.3 (E), Q61.1 (B), R71.1
unnamed: Q57.1 (B), R70.2
unnamed: Q57.3 (E), Q59.1 (B), R72.1
unnamed: Q58.1 (B), R73.2
unnamed: Q58.3 (E), Q60.2 (C)
unnamed: Q59.3 (E), Q61.2 (C)
unnamed: Q60.1 (B), R74.2
unnamed: Q60.3 (E), Q62.1 (B), Q66.1 (B), R75.1
unnamed: Q61.3 (E), Q63.1 (B), Q67.1 (B), R76.1
unnamed: Q62.2 (C), Q63.2 (C), Q64.1 (B), R77.2
unnamed: Q64.3 (E), Q65.2 (C)
unnamed: Q66.3 (E), Q67.2 (C)
unnamed: Q67.3 (E), R80.2
unnamed: Q68.1 (B), R79.2
unnamed: Q68.3 (E), Q70.1 (B), R81.1
unnamed: Q69.3 (E), Q70.2 (C)
unnamed: Q71.1 (B), R83.2
unnamed: Q71.3 (E), Q78.1 (B), R85.1
unnamed: Q72.1 (B), R84.2
unnamed: Q72.3 (E), Q76.1 (B), R86.1
unnamed: Q73.3 (E), Q74.2 (C)
unnamed: Q74.1 (B), R87.2
unnamed: Q74.3 (E), Q75.1 (B), R88.1
unnamed: Q75.3 (E), Q76.2 (C)
unnamed: Q76.3 (E), Q77.1 (B), R89.1
unnamed: Q77.3 (E), Q78.2 (C)
unnamed: Q79.1 (B), Q80.2 (C), Q81.2 (C), Q82.2 (C), Q83.2 (C), Q84.2 (C), Q85.2 (C), Q86.2 (C), Q87.2 (C), Q88.2 (C), Q89.2 (C), Q90.2 (C), Q91.2 (C), Q92.2 (C), Q93.2 (C), Q94.2 (C), R92.2
OVERFLOW_FLAG: J1.3, R5.1, R7.1, R57.1, R60.1, R69.1, R73.1
SF<>OF: Q46.3 (E), Q49.1 (B), R58.1, R68.1
SF=OF: Q65.3 (E), Q69.1 (B), Q73.1 (B), R78.1
SIGN_FLAG: J1.2, R14.1, R16.1, R55.1, R59.1, R70.1, R74.1
VCC: Q4.2 (C), Q6.2 (C), Q11.2 (C), Q13.2 (C), Q18.2 (C), Q20.2 (C), Q25.2 (C), Q27.2 (C), Q30.2 (C), Q32.3 (E), Q33.3 (E), Q38.3 (E), Q39.3 (E), Q41.2 (C), Q43.3 (E), Q44.3 (E), Q45.2 (C), Q49.2 (C), Q52.2 (C), Q53.3 (E), Q55.3 (E), Q58.2 (C), Q59.2 (C), Q62.3 (E), Q63.3 (E), Q64.2 (C), Q69.2 (C), Q73.2 (C), Q75.2 (C), Q77.2 (C), Q80.3 (E), Q81.3 (E), Q82.3 (E), Q83.3 (E), Q84.3 (E), Q85.3 (E), Q86.3 (E), Q87.3 (E), Q88.3 (E), Q89.3 (E), Q90.3 (E), Q91.3 (E), Q92.3 (E), Q93.3 (E), Q94.3 (E), R3.2, R4.2, R6.2, R12.2, R13.2, R15.2, R21.2, R22.2, R24.2, R30.2, R31.2, R33.2, R38.2, R44.2, R48.2, R49.2, R50.2, R56.2, R61.1, R64.2, R71.2, R72.2, R80.1, R81.2, R85.2, R86.2, R91.2
ZERO_FLAG: J1.1, R23.1, R25.1, R32.1, R34.1, R42.1, R46.1, R66.1, R84.1, R87.1
~J: J2.16, R43.1
~JA_JNBE: J2.10, R45.1
~JBE_JNA: J2.9, R37.1
~JB_JNAE_JC: J2.7, R29.1
~JE_JZ: J2.5, R20.1
~JGE_JNL: J2.13, R79.1
~JG_JNLE: J2.14, R83.1
~JLE_JNG: J2.12, R63.1
~JL_JNGE: J2.11, R54.1
~JNB_JAE_JNC: J2.8, R28.1
~JNE_JNZ: J2.6, R19.1
~JNO: J2.2, R1.1
~JNS: J2.4, R10.1
~JO: J2.1, R2.1
~JS: J2.3, R11.1

Notes on the sheet:
AND
NOT
JO Jump if OVERFLOW OF=1
JNO Jump if !OVERFLOW OF=0
JS Jump if SIGN S=1
JNS Jump if !SIGN S=0
JB / JNAE / JC Jump if below Jump if not above or equal jump if Carry CF = 1
JNB / JAE / JNC Jump if not below Jump if above or equal Jump if not carry
JBE / JNA Jump if below or equal Jump if not above CF = 1 or ZF = 1
Unconditional Jump
JA / JNBE Jump if above Jump if not below or equal CF = 0 and ZF = 0
JL / JNGE Jump if less Jump if not greater or equal SF <> OF
NAND
XOR
JLE / JNG Jump if less or equal Jump if not greater ZF = 1 or SF <> OF
JGE / JNL Jump if greater or equal Jump if not less SF = OF
JG / JNLE Jump if greater Jump if not less or equal ZF = 0 and SF = OF
