theWickedWebDev/8-bit-computer/PCB-Modules/99_IN PROGRESS/control-unit-register-control/control-unit.sch

## KiCad design PCB-Modules/99_IN PROGRESS/control-unit-register-control/control-unit.sch (2021-12-09)

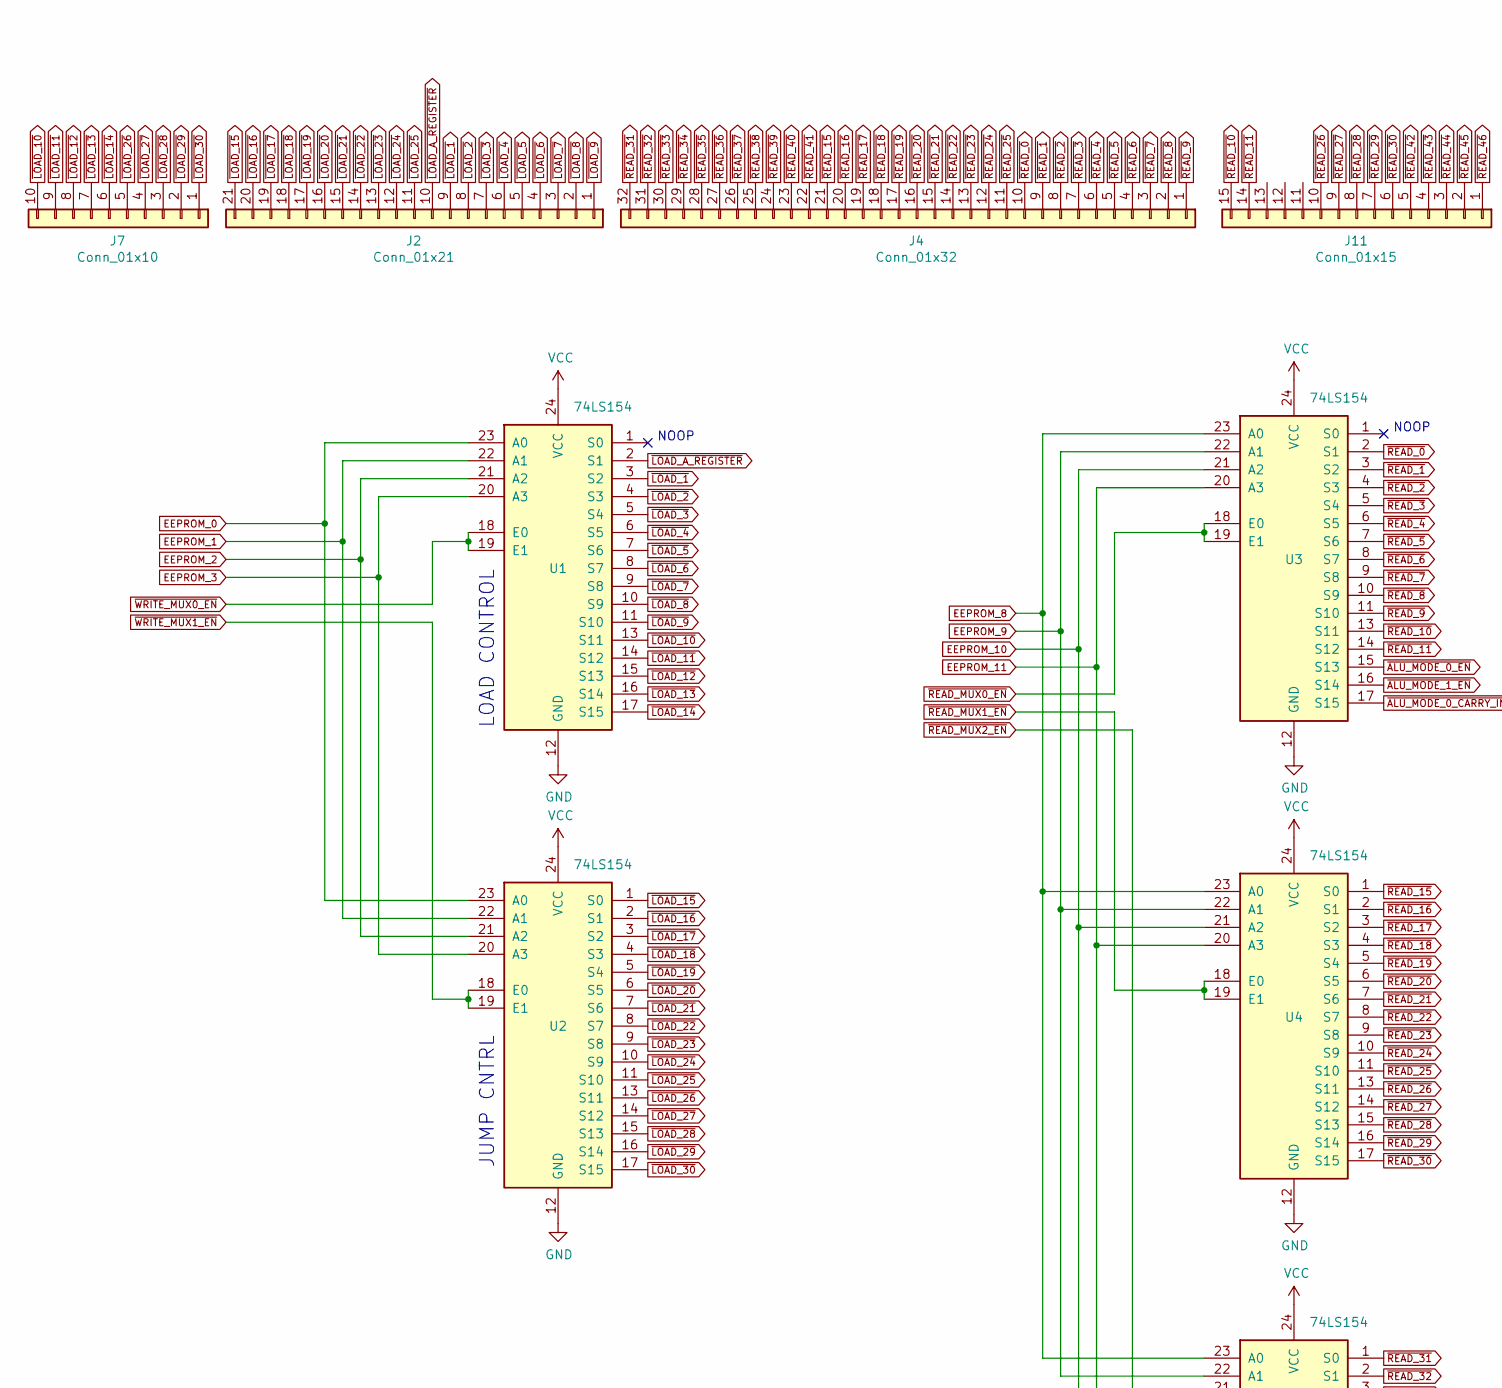
[picture p346: schematic control-unit.sch, part in row 1, column 1]

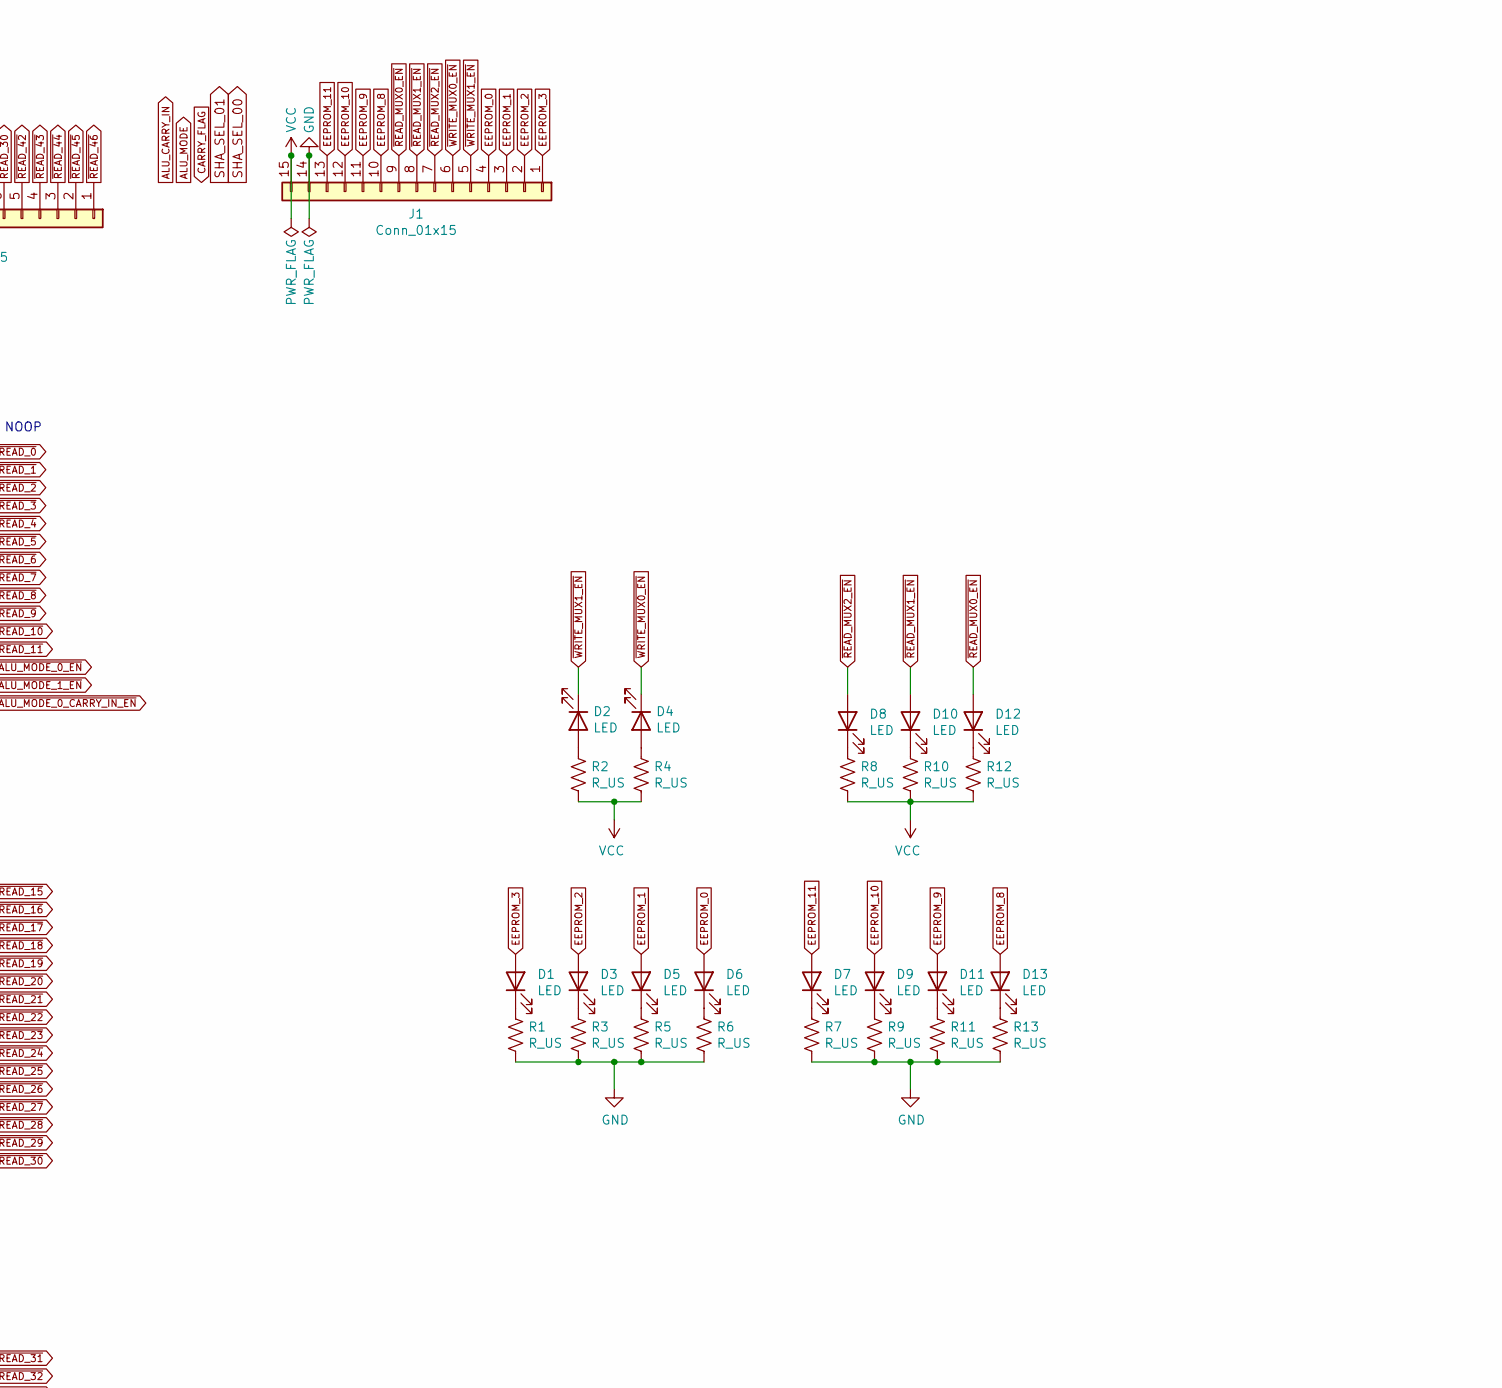
[picture p347: schematic control-unit.sch, part in row 1, column 2]

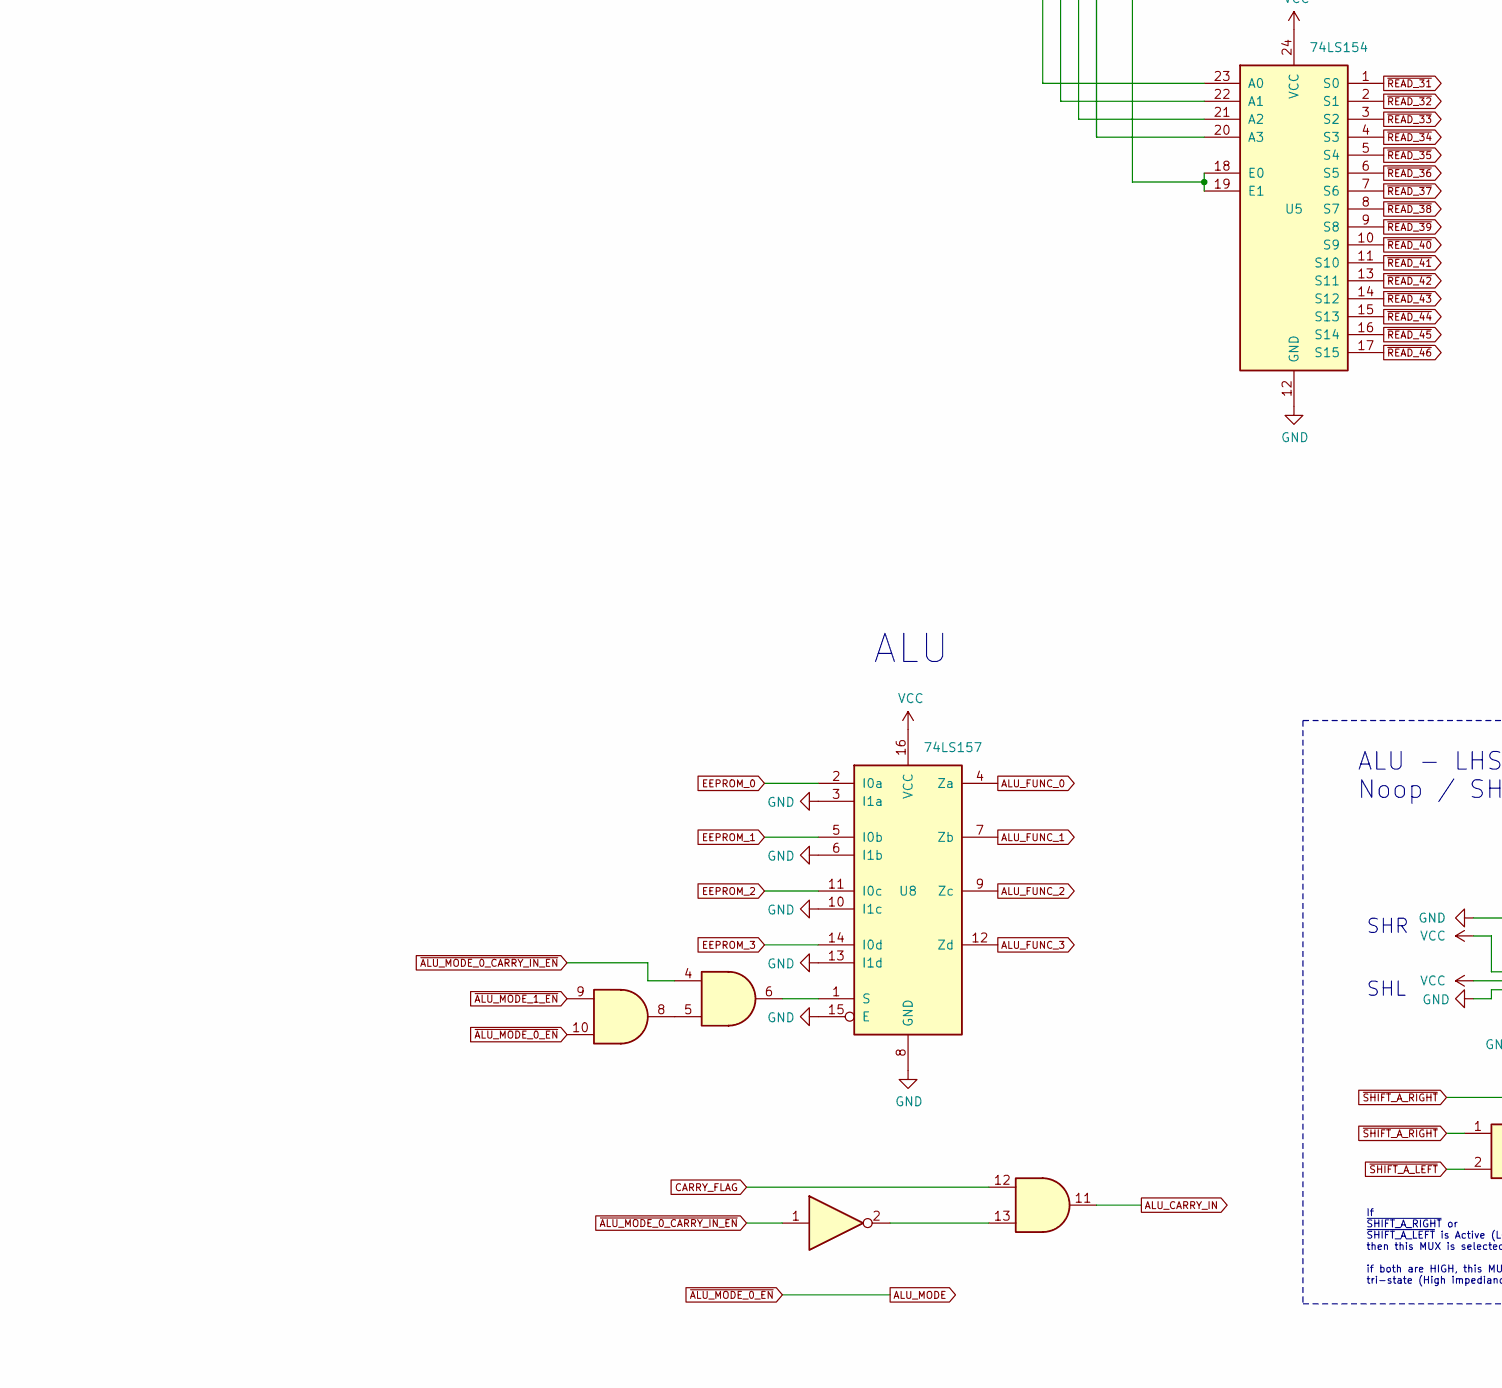
[picture p348: schematic control-unit.sch, part in row 2, column 1]

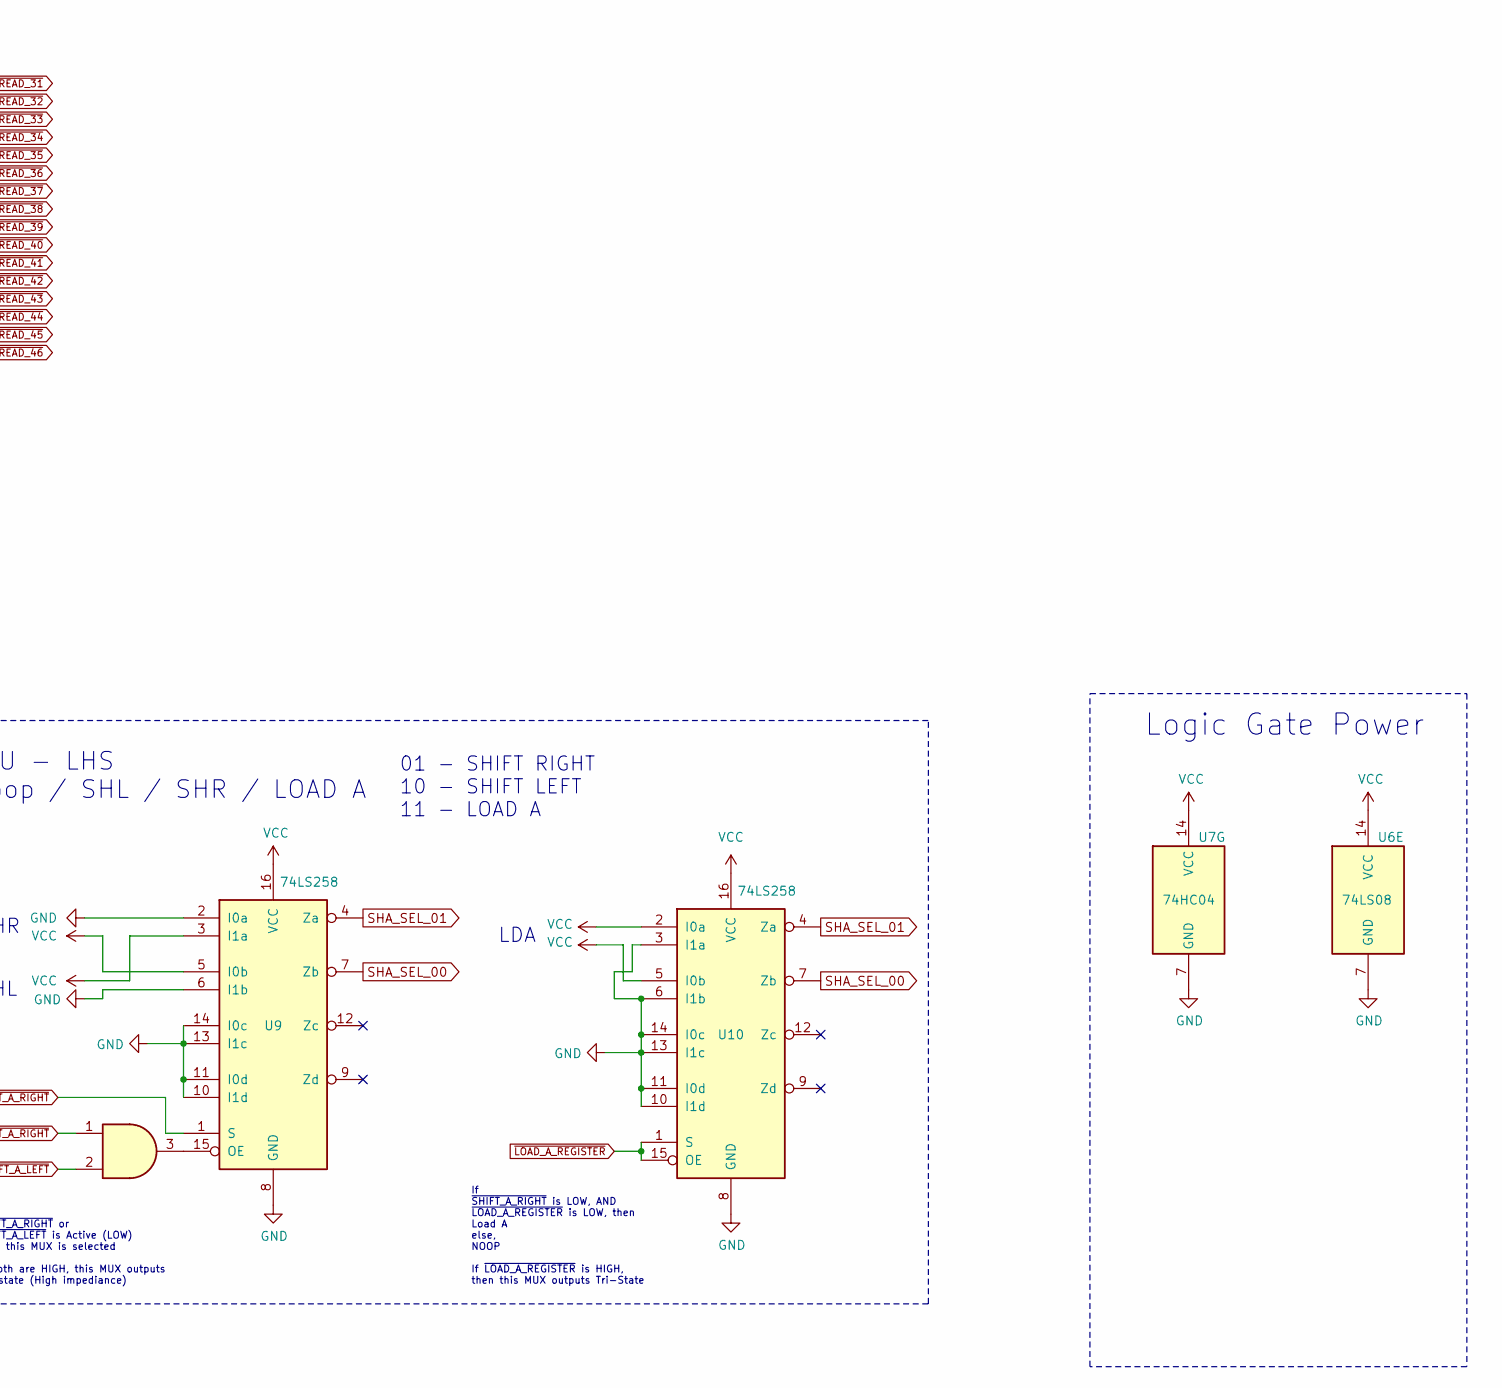
[picture p349: schematic control-unit.sch, part in row 2, column 2]

Parts:
D1, D2, D3, D4, D5, D6, D7, D8, D9, D10, D11, D12, D13: LED; LED_0805_2012Metric
J1, J11: Conn_01x15; PinHeader_1x15_P2.54mm_Vertical
J2: Conn_01x21; PinHeader_1x21_P2.54mm_Vertical
J4: Conn_01x32; PinHeader_1x32_P2.54mm_Vertical
J7: Conn_01x10; PinHeader_1x10_P2.54mm_Vertical
R1, R2, R3, R4, R5, R6, R7, R8, R9, R10, R11, R12, R13: R_US; R_0805_2012Metric
U1, U2, U3, U4, U5: 74LS154; TSSOP-24_4.4x7.8mm_P0.65mm
U6: 74LS08; TSSOP-14_4.4x5mm_P0.65mm
U7: 74HC04; TSSOP-14_4.4x5mm_P0.65mm
U8: 74LS157; TSSOP-16_4.4x5mm_P0.65mm
U9, U10: 74LS258; TSSOP-16_4.4x5mm_P0.65mm

Connections:
ALU_CARRY_IN: U6.11
ALU_FUNC_0: U8.4 (Za)
ALU_FUNC_1: U8.7 (Zb)
ALU_FUNC_2: U8.9 (Zc)
ALU_FUNC_3: U8.12 (Zd)
ALU_MODE: U3.15 (S13), U6.10
CARRY_FLAG: U6.12
EEPROM_0: D6.2 (A), J1.4, U1.23 (A0), U2.23 (A0), U8.2 (I0a)
EEPROM_1: D5.2 (A), J1.3, U1.22 (A1), U2.22 (A1), U8.5 (I0b)
EEPROM_2: D3.2 (A), J1.2, U1.21 (A2), U2.21 (A2), U8.11 (I0c)
EEPROM_3: D1.2 (A), J1.1, U1.20 (A3), U2.20 (A3), U8.14 (I0d)
EEPROM_8: D13.2 (A), J1.10, U3.23 (A0), U4.23 (A0), U5.23 (A0)
EEPROM_9: D11.2 (A), J1.11, U3.22 (A1), U4.22 (A1), U5.22 (A1)
EEPROM_10: D9.2 (A), J1.12, U3.21 (A2), U4.21 (A2), U5.21 (A2)
EEPROM_11: D7.2 (A), J1.13, U3.20 (A3), U4.20 (A3), U5.20 (A3)
GND: J1.14, R1.2, R3.2, R5.2, R6.2, R7.2, R9.2, R11.2, R13.2, U1.12 (GND), U2.12 (GND), U3.12 (GND), U4.12 (GND), U5.12 (GND), U6.7 (GND), U7.7 (GND), U8.3 (I1a), U8.6 (I1b), U8.8 (GND), U8.10 (I1c), U8.13 (I1d), U8.15 (E), U9.2 (I0a), U9.6 (I1b), U9.8 (GND), U9.10 (I1d), U9.11 (I0d), U9.13 (I1c), U9.14 (I0c), U10.3 (I1a), U10.6 (I1b), U10.8 (GND), U10.10 (I1d), U10.11 (I0d), U10.13 (I1c), U10.14 (I0c)
unnamed: D1.1 (K), R1.1
unnamed: D2.2 (A), R2.1
unnamed: D3.1 (K), R3.1
unnamed: D4.2 (A), R4.1
unnamed: D5.1 (K), R5.1
unnamed: D6.1 (K), R6.1
unnamed: D7.1 (K), R7.1
unnamed: D8.1 (K), R8.1
unnamed: D9.1 (K), R9.1
unnamed: D10.1 (K), R10.1
unnamed: D11.1 (K), R11.1
unnamed: D12.1 (K), R12.1
unnamed: D13.1 (K), R13.1
unnamed: U6.3, U9.15 (OE)
unnamed: U6.5, U6.8
unnamed: U6.6, U8.1 (S)
unnamed: U6.13, U7.2
SHA_SEL_00: U9.7 (Zb), U10.7 (Zb)
SHA_SEL_01: U9.4 (Za), U10.4 (Za)
VCC: J1.15, R2.2, R4.2, R8.2, R10.2, R12.2, U1.24 (VCC), U2.24 (VCC), U3.24 (VCC), U4.24 (VCC), U5.24 (VCC), U6.14 (VCC), U7.14 (VCC), U8.16 (VCC), U9.3 (I1a), U9.5 (I0b), U9.16 (VCC), U10.2 (I0a), U10.5 (I0b), U10.16 (VCC)
~ALU_MODE_0_CARRY_IN_EN: U3.17 (S15), U6.4, U7.1
~ALU_MODE_1_EN: U3.16 (S14), U6.9
~LOAD_1: J2.9, U1.3 (S2)
~LOAD_2: J2.8, U1.4 (S3)
~LOAD_3: J2.7, U1.5 (S4)
~LOAD_4: J2.6, U1.6 (S5)
~LOAD_5: J2.5, U1.7 (S6)
~LOAD_6: J2.4, U1.8 (S7)
~LOAD_7: J2.3, U1.9 (S8)
~LOAD_8: J2.2, U1.10 (S9)
~LOAD_9: J2.1, U1.11 (S10)
~LOAD_10: J7.10, U1.13 (S11)
~LOAD_11: J7.9, U1.14 (S12)
~LOAD_12: J7.8, U1.15 (S13)
~LOAD_13: J7.7, U1.16 (S14)
~LOAD_14: J7.6, U1.17 (S15)
~LOAD_15: J2.21, U2.1 (S0)
~LOAD_16: J2.20, U2.2 (S1)
~LOAD_17: J2.19, U2.3 (S2)
~LOAD_18: J2.18, U2.4 (S3)
~LOAD_19: J2.17, U2.5 (S4)
~LOAD_20: J2.16, U2.6 (S5)
~LOAD_21: J2.15, U2.7 (S6)
~LOAD_22: J2.14, U2.8 (S7)
~LOAD_23: J2.13, U2.9 (S8)
~LOAD_24: J2.12, U2.10 (S9)
~LOAD_25: J2.11, U2.11 (S10)
~LOAD_26: J7.5, U2.13 (S11)
~LOAD_27: J7.4, U2.14 (S12)
~LOAD_28: J7.3, U2.15 (S13)
~LOAD_29: J7.2, U2.16 (S14)
~LOAD_30: J7.1, U2.17 (S15)
~LOAD_A_REGISTER: J2.10, U1.2 (S1), U10.1 (S), U10.15 (OE)
~READ_0: J4.10, U3.2 (S1)
~READ_1: J4.9, U3.3 (S2)
~READ_2: J4.8, U3.4 (S3)
~READ_3: J4.7, U3.5 (S4)
~READ_4: J4.6, U3.6 (S5)
~READ_5: J4.5, U3.7 (S6)
~READ_6: J4.4, U3.8 (S7)
~READ_7: J4.3, U3.9 (S8)
~READ_8: J4.2, U3.10 (S9)
~READ_9: J4.1, U3.11 (S10)
~READ_10: J11.15, U3.13 (S11)
~READ_11: J11.14, U3.14 (S12)
~READ_15: J4.21, U4.1 (S0)
~READ_16: J4.20, U4.2 (S1)
~READ_17: J4.19, U4.3 (S2)
~READ_18: J4.18, U4.4 (S3)
~READ_19: J4.17, U4.5 (S4)
~READ_20: J4.16, U4.6 (S5)
~READ_21: J4.15, U4.7 (S6)
~READ_22: J4.14, U4.8 (S7)
~READ_23: J4.13, U4.9 (S8)
~READ_24: J4.12, U4.10 (S9)
~READ_25: J4.11, U4.11 (S10)
~READ_26: J11.10, U4.13 (S11)
~READ_27: J11.9, U4.14 (S12)
~READ_28: J11.8, U4.15 (S13)
~READ_29: J11.7, U4.16 (S14)
~READ_30: J11.6, U4.17 (S15)
~READ_31: J4.32, U5.1 (S0)
~READ_32: J4.31, U5.2 (S1)
~READ_33: J4.30, U5.3 (S2)
~READ_34: J4.29, U5.4 (S3)
~READ_35: J4.28, U5.5 (S4)
~READ_36: J4.27, U5.6 (S5)
~READ_37: J4.26, U5.7 (S6)
~READ_38: J4.25, U5.8 (S7)
~READ_39: J4.24, U5.9 (S8)
~READ_40: J4.23, U5.10 (S9)
~READ_41: J4.22, U5.11 (S10)
~READ_42: J11.5, U5.13 (S11)
~READ_43: J11.4, U5.14 (S12)
~READ_44: J11.3, U5.15 (S13)
~READ_45: J11.2, U5.16 (S14)
~READ_46: J11.1, U5.17 (S15)
~READ_MUX0_EN: D12.2 (A), J1.9, U3.18 (E0), U3.19 (E1)
~READ_MUX1_EN: D10.2 (A), J1.8, U4.18 (E0), U4.19 (E1)
~READ_MUX2_EN: D8.2 (A), J1.7, U5.18 (E0), U5.19 (E1)
~SHIFT_A_LEFT: U6.2
~SHIFT_A_RIGHT: U6.1, U9.1 (S)
~WRITE_MUX0_EN: D4.1 (K), J1.6, U1.18 (E0), U1.19 (E1)
~WRITE_MUX1_EN: D2.1 (K), J1.5, U2.18 (E0), U2.19 (E1)

Notes on the sheet:
NOOP
JUMP CNTRL
LOAD CONTROL
ALU
ALU - LHS Noop / SHL / SHR / LOAD A
SHL
SHR
LDA
01 - SHIFT RIGHT 10 - SHIFT LEFT 11 - LOAD A
If ~SHIFT_A_RIGHT~ or ~SHIFT_A_LEFT~ is Active (LOW) then this MUX is selected if both are HIGH, this MUX outputs tri-state (High impediance)
If ~SHIFT_A_RIGHT~ is LOW, AND ~LOAD_A_REGISTER~ is LOW, then Load A else, NOOP If ~LOAD_A_REGISTER~ is HIGH, then this MUX outputs Tri-State
Logic Gate Power
