theWickedWebDev/8-bit-computer/PCB-Modules/99_IN PROGRESS/control-unit-register-control/jumps.sch

## KiCad design PCB-Modules/99_IN PROGRESS/control-unit-register-control/jumps.sch (2021-11-28)

Schematic: jumps.sch

Parts:
U15, U17: 74LS00; TSSOP-14_4.4x5mm_P0.65mm
U16, U21: 74LS04; TSSOP-14_4.4x5mm_P0.65mm
U19, U28, U30: 74LS32; TSSOP-14_4.4x5mm_P0.65mm
U22: 74LS86; TSSOP-14_4.4x5mm_P0.65mm
U23, U24: 74LS08; TSSOP-14_4.4x5mm_P0.65mm
U25: 74LS08
U26, U27: CD4072; SOIC-14_3.9x8.7mm_P1.27mm
