theWickedWebDev/8-bit-computer/PCB-Modules/99_IN PROGRESS/memory/RAM-MODULE.sch

## KiCad design PCB-Modules/99_IN PROGRESS/memory/RAM-MODULE.sch (2021-11-19)

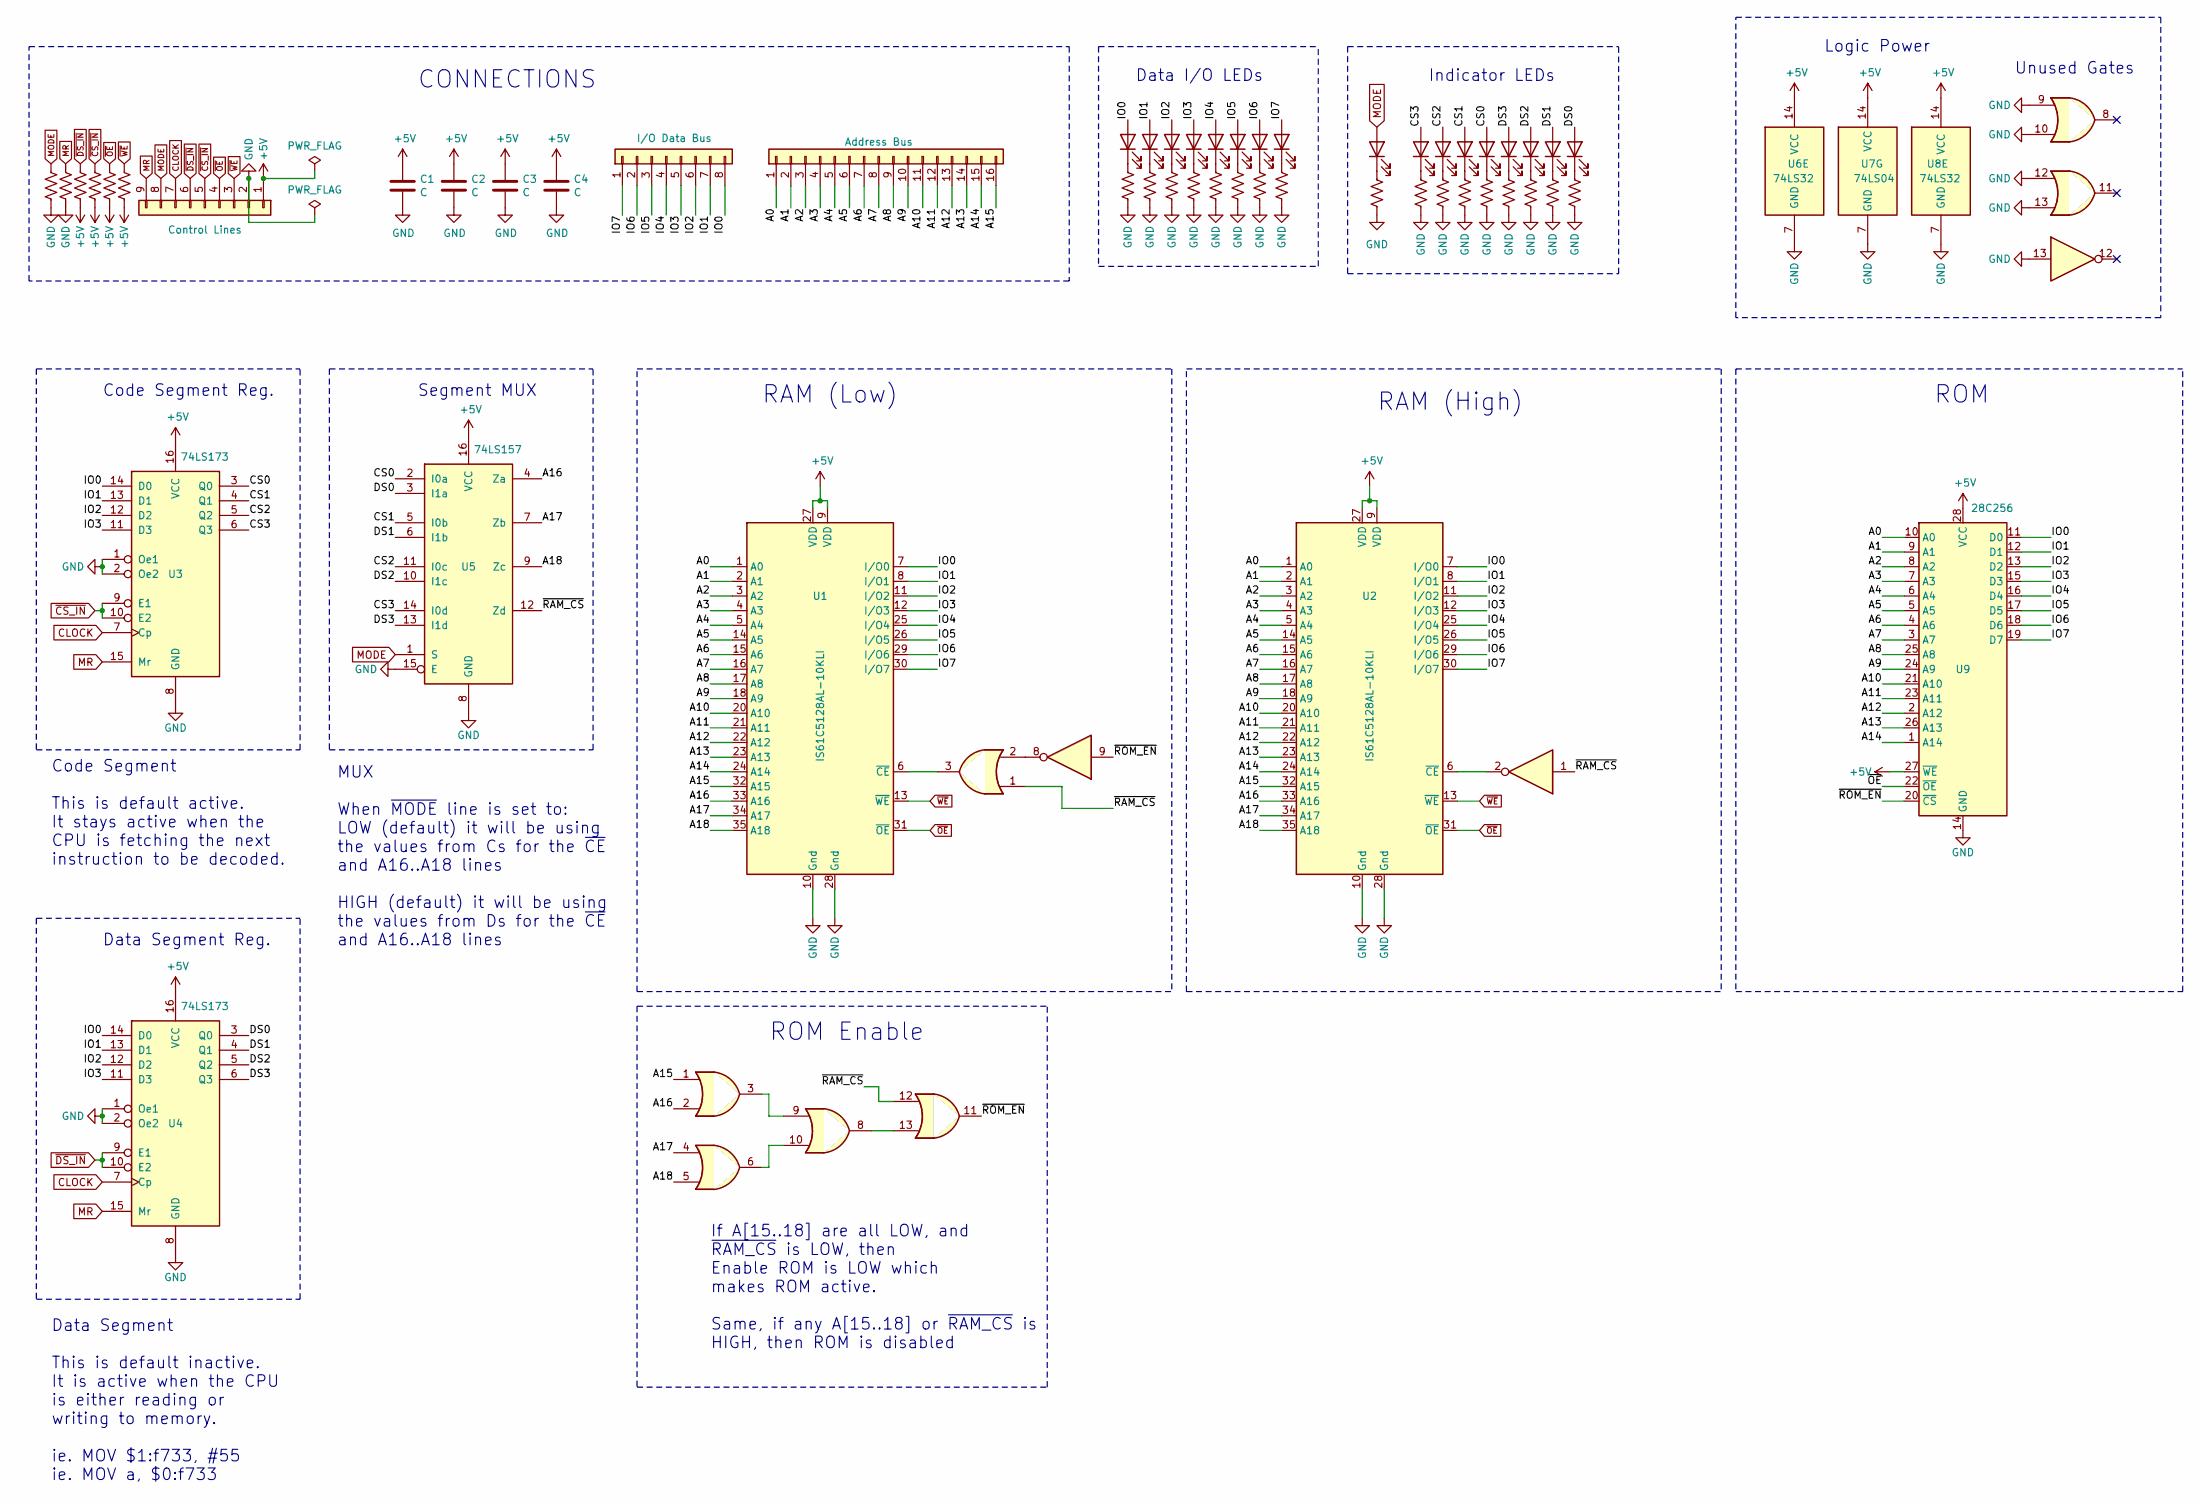
[picture p350: schematic RAM-MODULE.sch]

Parts:
C1, C2, C3, C4: C; C_0805_2012Metric
D1, D2, D3, D4, D5, D6, D7, D8, D9, D10, D11, D12, D13, D14, D15, D16, D17: LED; LED_0805_2012Metric
J1: Conn_01x09; PinHeader_1x09_P2.54mm_Vertical
J2: Conn_01x08; PinHeader_1x08_P2.54mm_Vertical
J3: Conn_01x16; PinHeader_1x16_P2.54mm_Vertical
R1, R2, R3, R4, R5, R6, R7, R8, R9, R10, R11, R12, R13, R14, R15, R16, R17, R18, R19, R20, R21, R22, R23: R_US; R_0805_2012Metric
U1, U2: IS61C5128AL-10KLI; SOJ-36_10.16x23.49mm_P1.27mm
U3, U4: 74LS173; TSSOP-16_4.4x5mm_P0.65mm
U5: 74LS157; TSSOP-16_4.4x5mm_P0.65mm
U6, U8: 74LS32; TSSOP-14_4.4x5mm_P0.65mm
U7: 74LS04; TSSOP-14_4.4x5mm_P0.65mm
U9: 28C256; DIP-28_W15.24mm_Socket

Connections:
+5V: C1.1, C2.1, C3.1, C4.1, J1.1, R17.2, R21.2, R22.2, R23.2, U1.9 (VDD), U1.27 (VDD), U2.9 (VDD), U2.27 (VDD), U3.16 (VCC), U4.16 (VCC), U5.16 (VCC), U6.14 (VCC), U7.14 (VCC), U8.14 (VCC), U9.27 (~WE), U9.28 (VCC)
A0: J3.1, U1.1 (A0), U2.1 (A0), U9.10 (A0)
A1: J3.2, U1.2 (A1), U2.2 (A1), U9.9 (A1)
A2: J3.3, U1.3 (A2), U2.3 (A2), U9.8 (A2)
A3: J3.4, U1.4 (A3), U2.4 (A3), U9.7 (A3)
A4: J3.5, U1.5 (A4), U2.5 (A4), U9.6 (A4)
A5: J3.6, U1.14 (A5), U2.14 (A5), U9.5 (A5)
A6: J3.7, U1.15 (A6), U2.15 (A6), U9.4 (A6)
A7: J3.8, U1.16 (A7), U2.16 (A7), U9.3 (A7)
A8: J3.9, U1.17 (A8), U2.17 (A8), U9.25 (A8)
A9: J3.10, U1.18 (A9), U2.18 (A9), U9.24 (A9)
A10: J3.11, U1.20 (A10), U2.20 (A10), U9.21 (A10)
A11: J3.12, U1.21 (A11), U2.21 (A11), U9.23 (A11)
A12: J3.13, U1.22 (A12), U2.22 (A12), U9.2 (A12)
A13: J3.14, U1.23 (A13), U2.23 (A13), U9.26 (A13)
A14: J3.15, U1.24 (A14), U2.24 (A14), U9.1 (A14)
A15: J3.16, U1.32 (A15), U2.32 (A15), U6.1
A16: U1.33 (A16), U2.33 (A16), U5.4 (Za), U6.2
A17: U1.34 (A17), U2.34 (A17), U5.7 (Zb), U6.4
A18: U1.35 (A18), U2.35 (A18), U5.9 (Zc), U6.5
CLOCK: J1.7, U3.7 (Cp), U4.7 (Cp)
CS0: D13.2 (A), U3.3 (Q0), U5.2 (I0a)
CS1: D12.2 (A), U3.4 (Q1), U5.5 (I0b)
CS2: D11.2 (A), U3.5 (Q2), U5.11 (I0c)
CS3: D10.2 (A), U3.6 (Q3), U5.14 (I0d)
DS0: D16.2 (A), U4.3 (Q0), U5.3 (I1a)
DS1: D15.2 (A), U4.4 (Q1), U5.6 (I1b)
DS2: D14.2 (A), U4.5 (Q2), U5.10 (I1c)
DS3: D17.2 (A), U4.6 (Q3), U5.13 (I1d)
GND: C1.2, C2.2, C3.2, C4.2, J1.2, R1.2, R2.2, R3.2, R4.2, R5.2, R6.2, R7.2, R8.2, R9.2, R10.2, R11.2, R12.2, R13.2, R14.2, R15.2, R16.2, R18.2, R19.2, R20.2, U1.10 (Gnd), U1.28 (Gnd), U2.10 (Gnd), U2.28 (Gnd), U3.1 (Oe1), U3.2 (Oe2), U3.8 (GND), U4.1 (Oe1), U4.2 (Oe2), U4.8 (GND), U5.8 (GND), U5.15 (E), U6.7 (GND), U7.7 (GND), U7.13, U8.7 (GND), U8.9, U8.10, U8.12, U8.13, U9.14 (GND)
IO0: D1.2 (A), J2.8, U1.7 (I/O0), U2.7 (I/O0), U3.14 (D0), U4.14 (D0), U9.11 (D0)
IO1: D2.2 (A), J2.7, U1.8 (I/O1), U2.8 (I/O1), U3.13 (D1), U4.13 (D1), U9.12 (D1)
IO2: D3.2 (A), J2.6, U1.11 (I/O2), U2.11 (I/O2), U3.12 (D2), U4.12 (D2), U9.13 (D2)
IO3: D4.2 (A), J2.5, U1.12 (I/O3), U2.12 (I/O3), U3.11 (D3), U4.11 (D3), U9.15 (D3)
IO4: D5.2 (A), J2.4, U1.25 (I/O4), U2.25 (I/O4), U9.16 (D4)
IO5: D6.2 (A), J2.3, U1.26 (I/O5), U2.26 (I/O5), U9.17 (D5)
IO6: D7.2 (A), J2.2, U1.29 (I/O6), U2.29 (I/O6), U9.18 (D6)
IO7: D8.2 (A), J2.1, U1.30 (I/O7), U2.30 (I/O7), U9.19 (D7)
MODE: D9.2 (A), J1.8, R18.1, U5.1 (S)
MR: J1.9, R10.1, U3.15 (Mr), U4.15 (Mr)
unnamed: D1.1 (K), R1.1
unnamed: D2.1 (K), R2.1
unnamed: D3.1 (K), R3.1
unnamed: D4.1 (K), R4.1
unnamed: D5.1 (K), R5.1
unnamed: D6.1 (K), R6.1
unnamed: D7.1 (K), R7.1
unnamed: D8.1 (K), R8.1
unnamed: D9.1 (K), R9.1
unnamed: D10.1 (K), R19.1
unnamed: D11.1 (K), R11.1
unnamed: D12.1 (K), R12.1
unnamed: D13.1 (K), R13.1
unnamed: D14.1 (K), R14.1
unnamed: D15.1 (K), R15.1
unnamed: D16.1 (K), R16.1
unnamed: D17.1 (K), R20.1
unnamed: U1.6 (~CE), U8.3
unnamed: U2.6 (~CE), U7.2
unnamed: U6.3, U6.9
unnamed: U6.6, U6.10
unnamed: U6.8, U6.13
unnamed: U7.8, U8.2
~CS_IN: J1.5, R21.1, U3.9 (E1), U3.10 (E2)
~DS_IN: J1.6, R17.1, U4.9 (E1), U4.10 (E2)
~OE: J1.4, R22.1, U1.31 (~OE), U2.31 (~OE), U9.22 (~OE)
~RAM_CS: U5.12 (Zd), U6.12, U7.1, U8.1
~ROM_EN: U6.11, U7.9, U9.20 (~CS)
~WE: J1.3, R23.1, U1.13 (~WE), U2.13 (~WE)

Notes on the sheet:
CONNECTIONS
RAM (Low)
Code Segment Reg.
Data Segment Reg.
Segment MUX
Data I/O LEDs
RAM (High)
Indicator LEDs
Code Segment This is default active. It stays active when the CPU is fetching the next instruction to be decoded.
Data Segment This is default inactive. It is active when the CPU is either reading or writing to memory. ie. MOV $1:f733, #55 ie. MOV a, $0:f733
MUX When ~MODE~ line is set to: LOW (default) it will be using the values from Cs for the ~CE~ and A16..A18 lines HIGH (default) it will be using the values from Ds for the ~CE~ and A16..A18 lines
ROM
If A[15..18] are all LOW, and ~RAM_CS~ is LOW, then Enable ROM is LOW which makes ROM active. Same, if any A[15..18] or ~RAM_CS~ is HIGH, then ROM is disabled
ROM Enable
Unused Gates
Logic Power
