theWickedWebDev/8-bit-computer/other-modules/ALU-DISCRETE-LOGIC/ALU-ADD-SUB/ALU.sch

## KiCad design other-modules/ALU-DISCRETE-LOGIC/ALU-ADD-SUB/ALU.sch (2021-04-29)

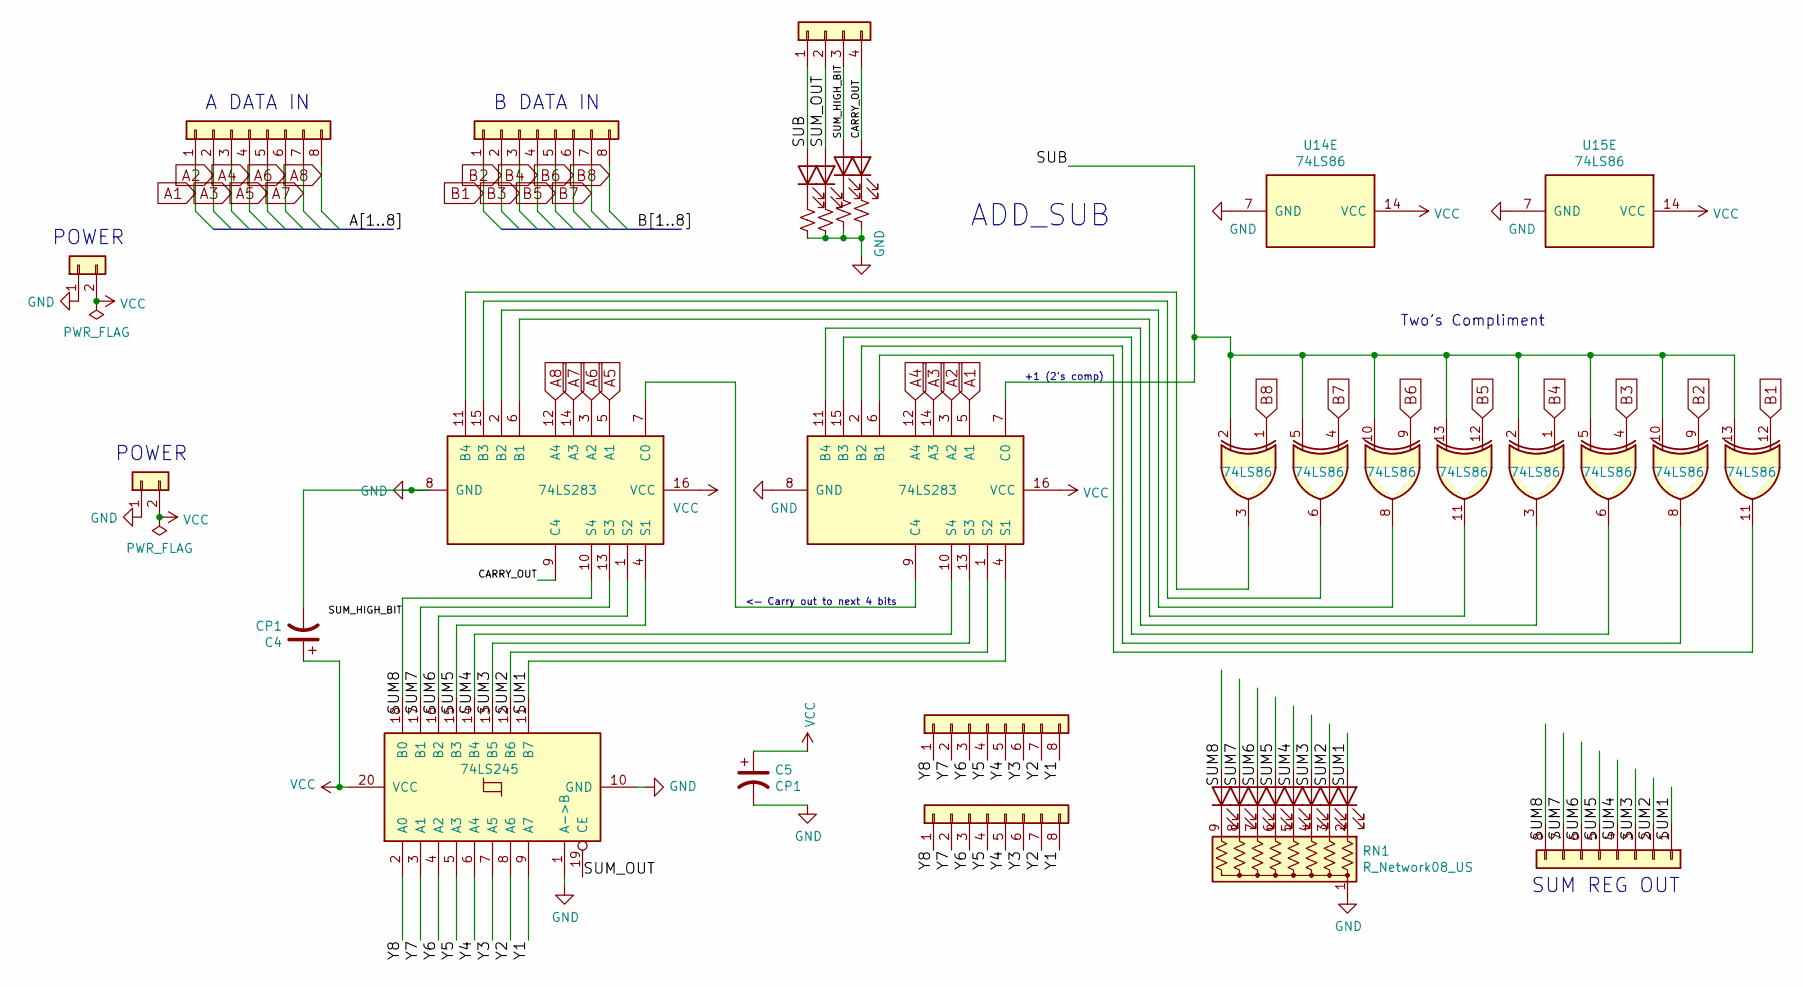
[picture p351: schematic ALU.sch]

Parts:
C4, C5: CP1; C_Radial_D6.3mm_H11.0mm_P2.50mm
D1, D2, D3, D4, D5, D6, D7, D8, D25, D26, D27, D28: LED; LED_D5.0mm
J1, J7: Conn_01x02; PinHeader_1x02_P2.54mm_Vertical
J2, J3, J4, J6, J8: Conn_01x08; PinHeader_1x08_P2.54mm_Vertical
J5: Conn_01x04; PinHeader_1x04_P2.54mm_Vertical
R1, R2, R3, R4: R_Small_US; R_Axial_DIN0207_L6.3mm_D2.5mm_P10.16mm_Horizontal
RN1: R_Network08_US; R_Array_SIP9
U11: 74LS245; DIP-20_W7.62mm
U12, U13: 74LS283; DIP-16_W7.62mm
U14, U15: 74LS86; DIP-14_W7.62mm

Connections:
A1: J2.1, U13.5 (A1)
A2: J2.2, U13.3 (A2)
A3: J2.3, U13.14 (A3)
A4: J2.4, U13.12 (A4)
A5: J2.5, U12.5 (A1)
A6: J2.6, U12.3 (A2)
A7: J2.7, U12.14 (A3)
A8: J2.8, U12.12 (A4)
B1: J3.1, U15.12
B2: J3.2, U15.9
B3: J3.3, U15.4
B4: J3.4, U15.1
B5: J3.5, U14.12
B6: J3.6, U14.9
B7: J3.7, U14.4
B8: J3.8, U14.1
CARRY_OUT: D28.2 (A), J5.4, U12.9 (C4)
GND: C4.2, C5.2, J1.1, J7.1, R1.2, R2.2, R3.2, R4.2, RN1.1 (common), U11.1 (A->B), U11.10 (GND), U12.8 (GND), U13.8 (GND), U14.7 (GND), U15.7 (GND)
unnamed: D1.1 (K), RN1.9 (R8)
unnamed: D2.1 (K), RN1.8 (R7)
unnamed: D3.1 (K), RN1.7 (R6)
unnamed: D4.1 (K), RN1.6 (R5)
unnamed: D5.1 (K), RN1.5 (R4)
unnamed: D6.1 (K), RN1.4 (R3)
unnamed: D7.1 (K), RN1.3 (R2)
unnamed: D8.1 (K), RN1.2 (R1)
unnamed: D25.1 (K), R1.1
unnamed: D26.1 (K), R2.1
unnamed: D27.1 (K), R3.1
unnamed: D28.1 (K), R4.1
unnamed: U12.2 (B2), U14.8
unnamed: U12.6 (B1), U14.11
unnamed: U12.7 (C0), U13.9 (C4)
unnamed: U12.11 (B4), U14.3
unnamed: U12.15 (B3), U14.6
unnamed: U13.2 (B2), U15.8
unnamed: U13.6 (B1), U15.11
unnamed: U13.11 (B4), U15.3
unnamed: U13.15 (B3), U15.6
SUB: D25.2 (A), J5.1, U13.7 (C0), U14.2, U14.5, U14.10, U14.13, U15.2, U15.5, U15.10, U15.13
SUM1: D8.2 (A), J8.1, U11.11 (B7), U13.4 (S1)
SUM2: D7.2 (A), J8.2, U11.12 (B6), U13.1 (S2)
SUM3: D6.2 (A), J8.3, U11.13 (B5), U13.13 (S3)
SUM4: D5.2 (A), J8.4, U11.14 (B4), U13.10 (S4)
SUM5: D4.2 (A), J8.5, U11.15 (B3), U12.4 (S1)
SUM6: D3.2 (A), J8.6, U11.16 (B2), U12.1 (S2)
SUM7: D2.2 (A), J8.7, U11.17 (B1), U12.13 (S3)
SUM8: D1.2 (A), D27.2 (A), J5.3, J8.8, U11.18 (B0), U12.10 (S4)
SUM_OUT: D26.2 (A), J5.2, U11.19 (CE)
VCC: C4.1, C5.1, J1.2, J7.2, U11.20 (VCC), U12.16 (VCC), U13.16 (VCC), U14.14 (VCC), U15.14 (VCC)
Y1: J4.8, J6.8, U11.9 (A7)
Y2: J4.7, J6.7, U11.8 (A6)
Y3: J4.6, J6.6, U11.7 (A5)
Y4: J4.5, J6.5, U11.6 (A4)
Y5: J4.4, J6.4, U11.5 (A3)
Y6: J4.3, J6.3, U11.4 (A2)
Y7: J4.2, J6.2, U11.3 (A1)
Y8: J4.1, J6.1, U11.2 (A0)

Notes on the sheet:
A DATA IN
B DATA IN
POWER
<— Carry out to next 4 bits
Two’s Compliment
+1 (2’s comp)
ADD_SUB
SUM REG OUT
