theWickedWebDev/8-bit-computer/other-modules/ALU-DISCRETE-LOGIC/ALU-CONTROL/ALU.sch

## KiCad design other-modules/ALU-DISCRETE-LOGIC/ALU-CONTROL/ALU.sch (2021-05-02)

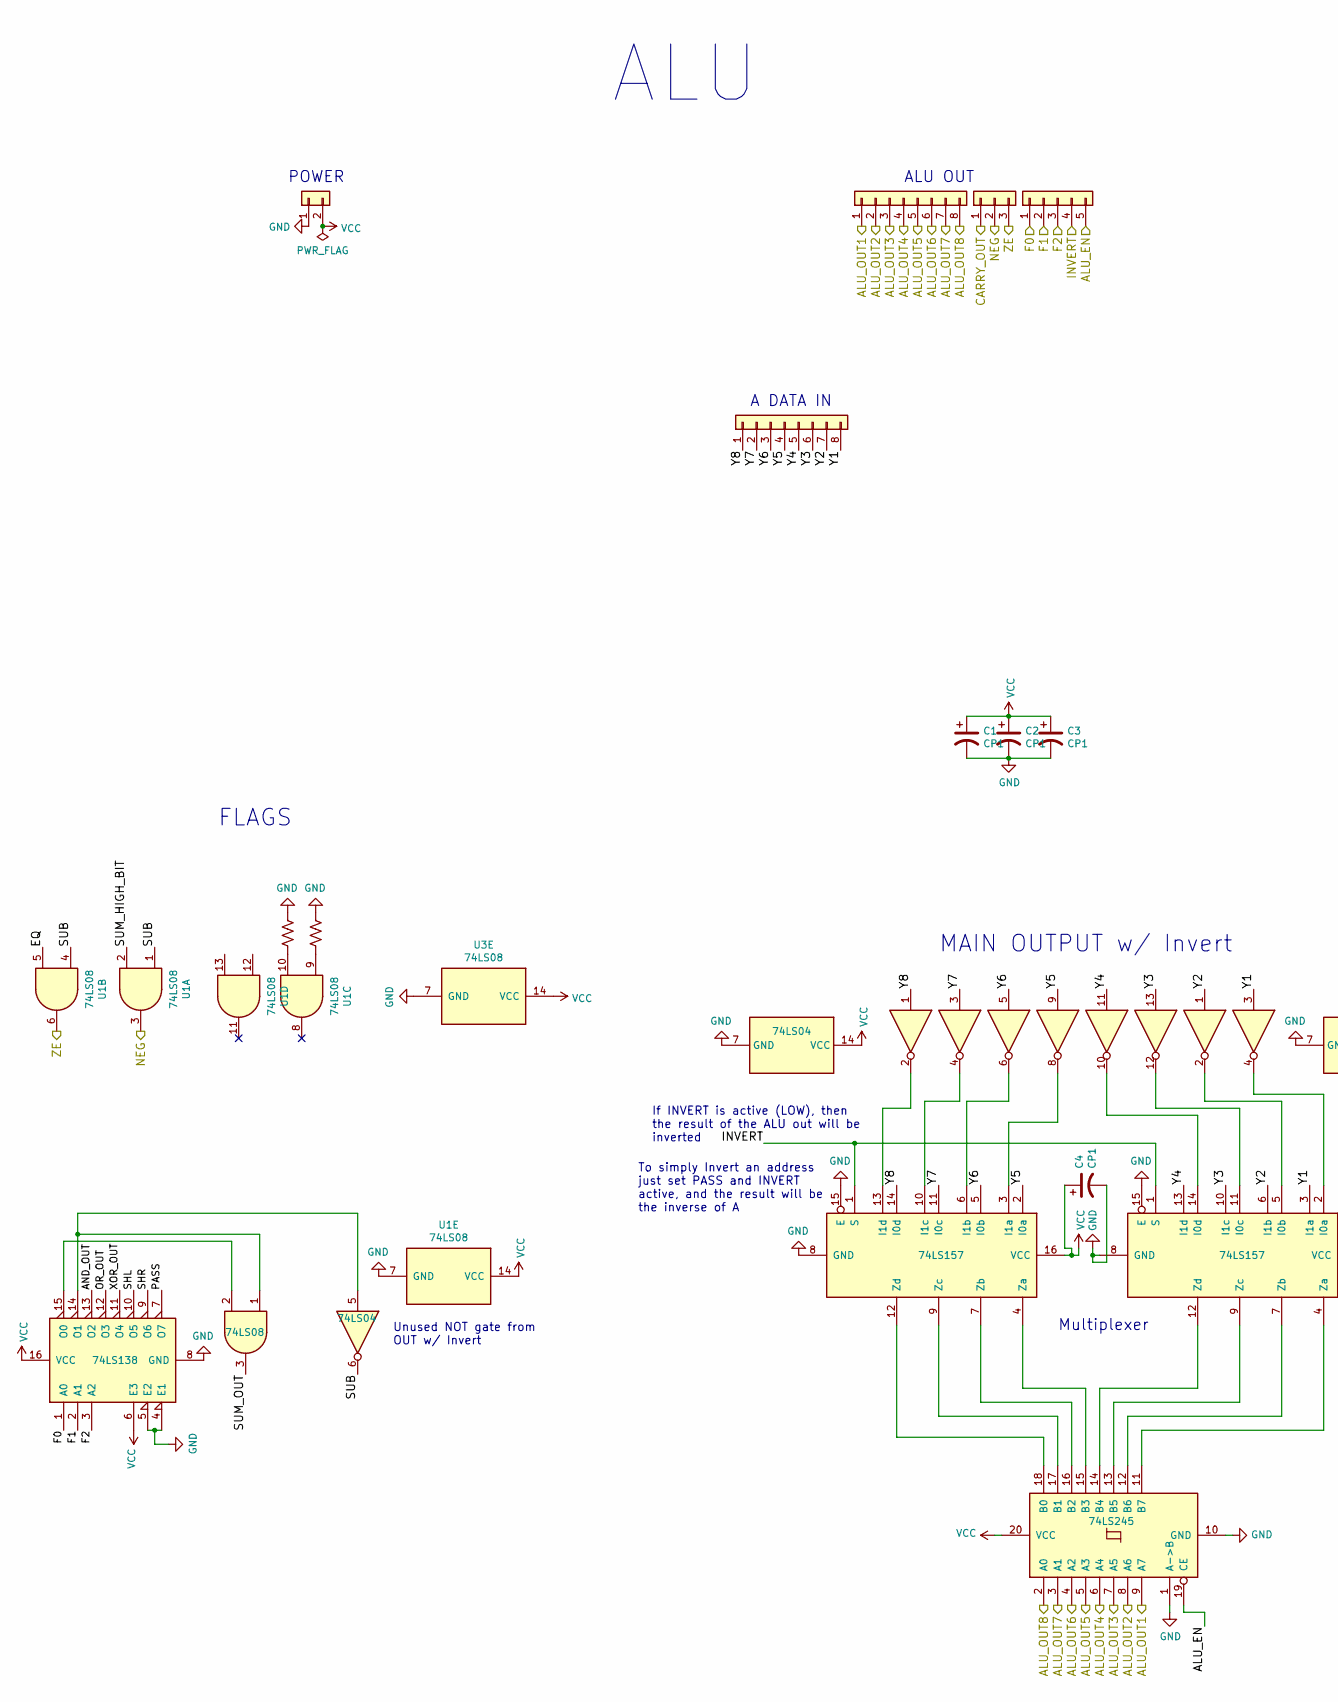
[picture p352: schematic ALU.sch, part in row 1, column 1]

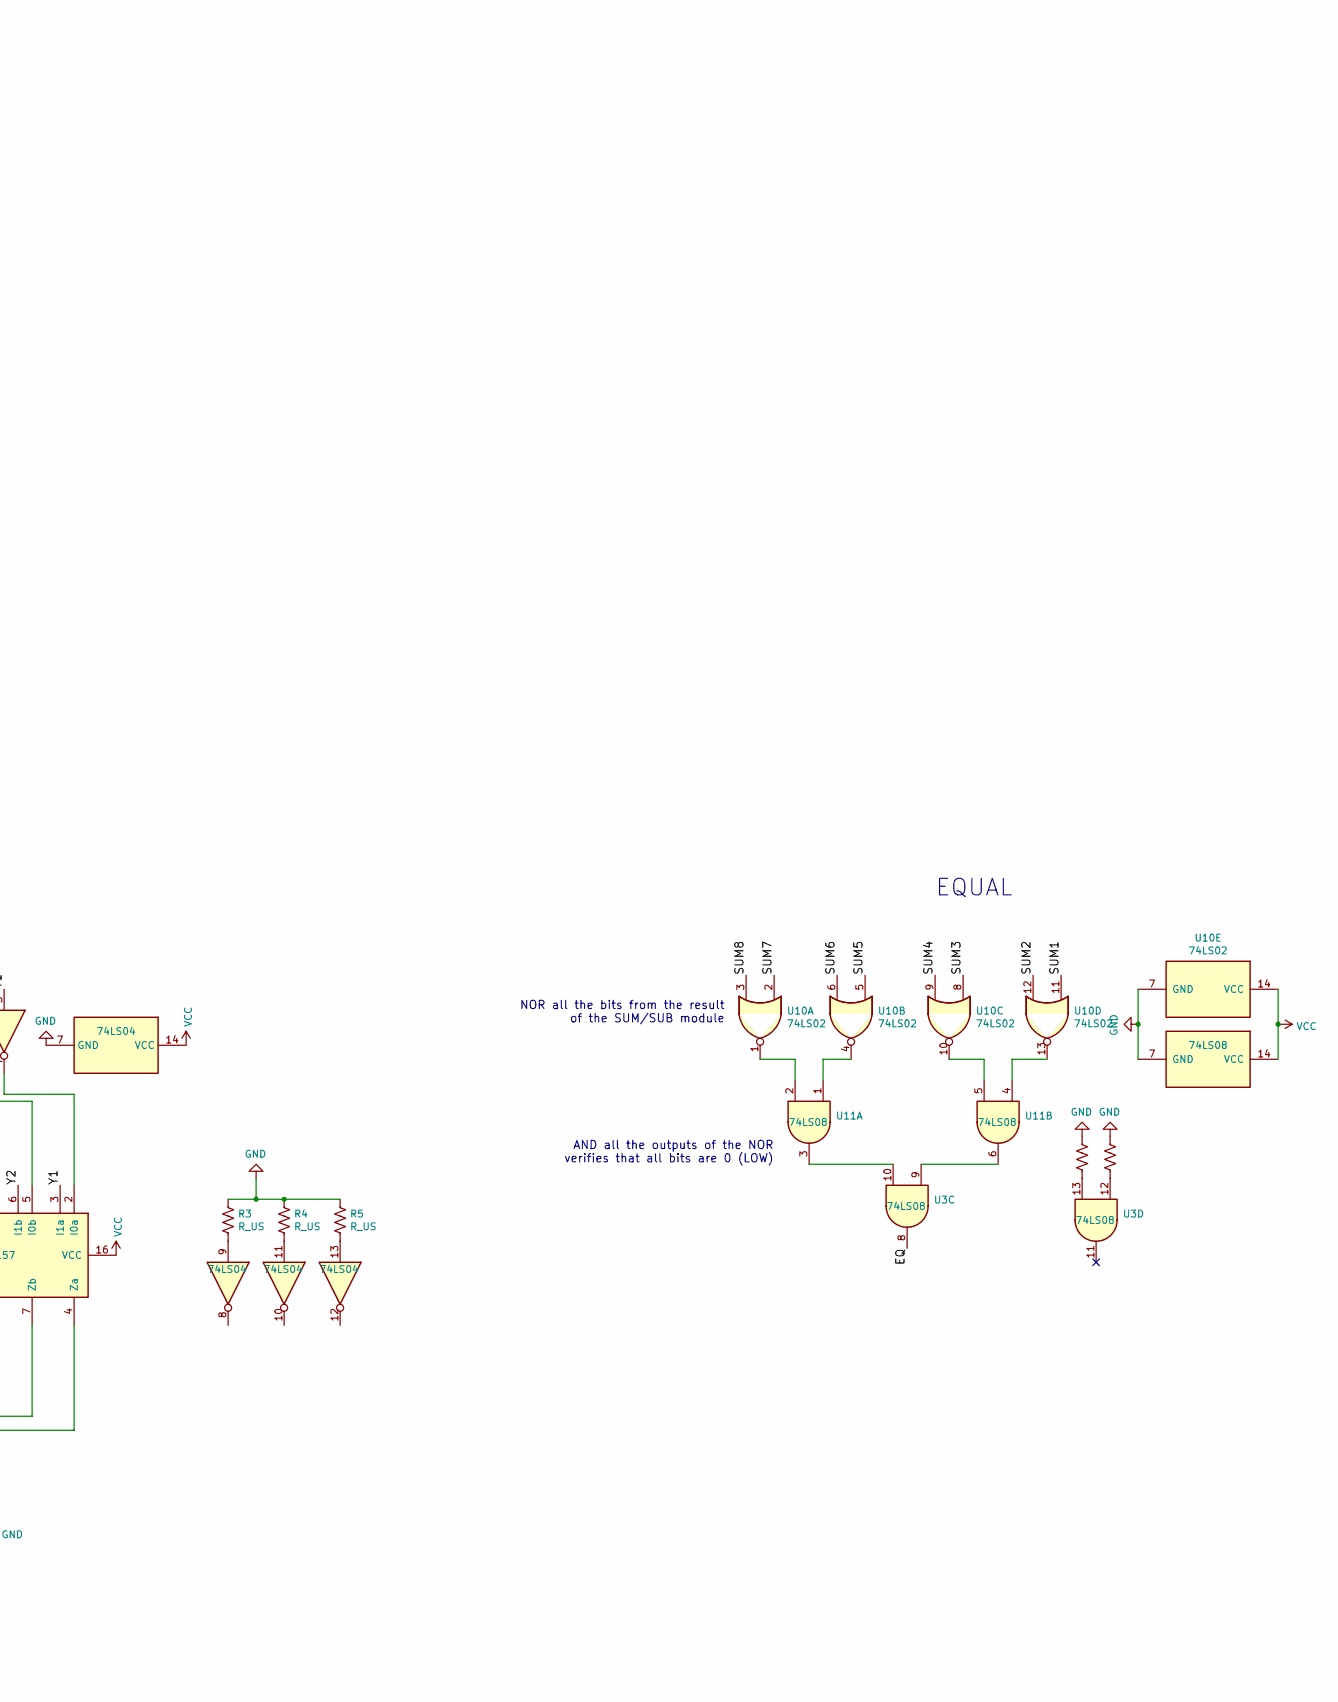
[picture p353: schematic ALU.sch, part in row 1, column 2]

Parts:
C1, C2, C3, C4: CP1; C_Radial_D6.3mm_H11.0mm_P2.50mm
J1: Conn_01x02; PinHeader_1x02_P2.54mm_Vertical
J2, J4: Conn_01x08; PinHeader_1x08_P2.54mm_Vertical
J5: Conn_01x03; PinHeader_1x03_P2.54mm_Vertical
J6: Conn_01x05; PinHeader_1x05_P2.54mm_Vertical
R1, R2, R3, R4, R5, R6, R7: R_US; R_Axial_DIN0207_L6.3mm_D2.5mm_P10.16mm_Horizontal
U1, U3, U11: 74LS08; DIP-14_W7.62mm
U2: 74LS138; DIP-16_W7.62mm
U4, U6: 74LS04; DIP-14_W7.62mm
U5, U8: 74LS157; DIP-16_W7.62mm
U7: 74LS245; DIP-20_W7.62mm
U10: 74LS02; DIP-14_W7.62mm

Connections:
ALU_EN: J6.5, U7.19 (CE)
ALU_OUT1: J4.1, U7.9 (A7)
ALU_OUT2: J4.2, U7.8 (A6)
ALU_OUT3: J4.3, U7.7 (A5)
ALU_OUT4: J4.4, U7.6 (A4)
ALU_OUT5: J4.5, U7.5 (A3)
ALU_OUT6: J4.6, U7.4 (A2)
ALU_OUT7: J4.7, U7.3 (A1)
ALU_OUT8: J4.8, U7.2 (A0)
AND_OUT: U2.13 (O2)
CARRY_OUT: J5.1
EQ: U1.5, U3.8
F0: J6.1, U2.1 (A0)
F1: J6.2, U2.2 (A1)
F2: J6.3, U2.3 (A2)
GND: C1.2, C2.2, C3.2, C4.2, J1.1, R1.1, R2.1, R3.1, R4.1, R5.1, R6.1, R7.1, U1.7 (GND), U2.4 (E1), U2.5 (E2), U2.8 (GND), U3.7 (GND), U4.7 (GND), U5.8 (GND), U5.15 (E), U6.7 (GND), U7.1 (A->B), U7.10 (GND), U8.8 (GND), U8.15 (E), U10.7 (GND), U11.7 (GND)
INVERT: J6.4, U5.1 (S), U8.1 (S)
NEG: J5.2, U1.3
unnamed: R1.2, U1.10
unnamed: R2.2, U1.9
unnamed: R3.2, U6.9
unnamed: R4.2, U6.11
unnamed: R5.2, U6.13
unnamed: R6.2, U3.13
unnamed: R7.2, U3.12
unnamed: U2.14 (O1), U3.1, U4.5
unnamed: U2.15 (O0), U3.2
unnamed: U4.2, U5.13 (I1d)
unnamed: U4.4, U5.10 (I1c)
unnamed: U4.8, U5.3 (I1a)
unnamed: U4.10, U8.14 (I0d)
unnamed: U4.12, U8.11 (I0c)
unnamed: U5.4 (Za), U7.15 (B3)
unnamed: U5.6 (I1b), U6.6
unnamed: U5.7 (Zb), U7.16 (B2)
unnamed: U5.9 (Zc), U7.17 (B1)
unnamed: U5.12 (Zd), U7.18 (B0)
unnamed: U6.2, U8.5 (I0b)
unnamed: U6.4, U8.2 (I0a)
unnamed: U7.11 (B7), U8.4 (Za)
unnamed: U7.12 (B6), U8.7 (Zb)
unnamed: U7.13 (B5), U8.9 (Zc)
unnamed: U7.14 (B4), U8.12 (Zd)
unnamed: U10.1, U11.2
unnamed: U10.4, U11.1
unnamed: U10.10, U11.5
unnamed: U10.13, U11.4
unnamed: U3.10, U11.3
unnamed: U3.9, U11.6
OR_OUT: U2.12 (O3)
PASS: U2.7 (O7)
SHL: U2.10 (O5)
SHR: U2.9 (O6)
SUB: U1.1, U1.4, U4.6
SUM1: U10.11
SUM2: U10.12
SUM3: U10.8
SUM4: U10.9
SUM5: U10.5
SUM6: U10.6
SUM7: U10.2
SUM8: U10.3
SUM_HIGH_BIT: U1.2
SUM_OUT: U3.3
VCC: C1.1, C2.1, C3.1, C4.1, J1.2, U1.14 (VCC), U2.6 (E3), U2.16 (VCC), U3.14 (VCC), U4.14 (VCC), U5.16 (VCC), U6.14 (VCC), U7.20 (VCC), U8.16 (VCC), U10.14 (VCC), U11.14 (VCC)
XOR_OUT: U2.11 (O4)
Y1: J2.8, U6.3, U8.3 (I1a)
Y2: J2.7, U6.1, U8.6 (I1b)
Y3: J2.6, U4.13, U8.10 (I1c)
Y4: J2.5, U4.11, U8.13 (I1d)
Y5: J2.4, U4.9, U5.2 (I0a)
Y6: J2.3, U5.5 (I0b), U6.5
Y7: J2.2, U4.3, U5.11 (I0c)
Y8: J2.1, U4.1, U5.14 (I0d)
ZE: J5.3, U1.6

Notes on the sheet:
Multiplexer
MAIN OUTPUT w/ Invert
A DATA IN
ALU OUT
ALU
POWER
EQUAL
NOR all the bits from the result of the SUM/SUB module
AND all the outputs of the NOR verifies that all bits are 0 (LOW)
If INVERT is active (LOW), then the result of the ALU out will be inverted
To simply Invert an address just set PASS and INVERT active, and the result will be the inverse of A
Unused NOT gate from OUT w/ Invert
FLAGS
