theWickedWebDev/8-bit-computer/other-modules/ALU-DISCRETE-LOGIC/ALU-SHIFT/ALU.sch

## KiCad design other-modules/ALU-DISCRETE-LOGIC/ALU-SHIFT/ALU.sch (2021-04-29)

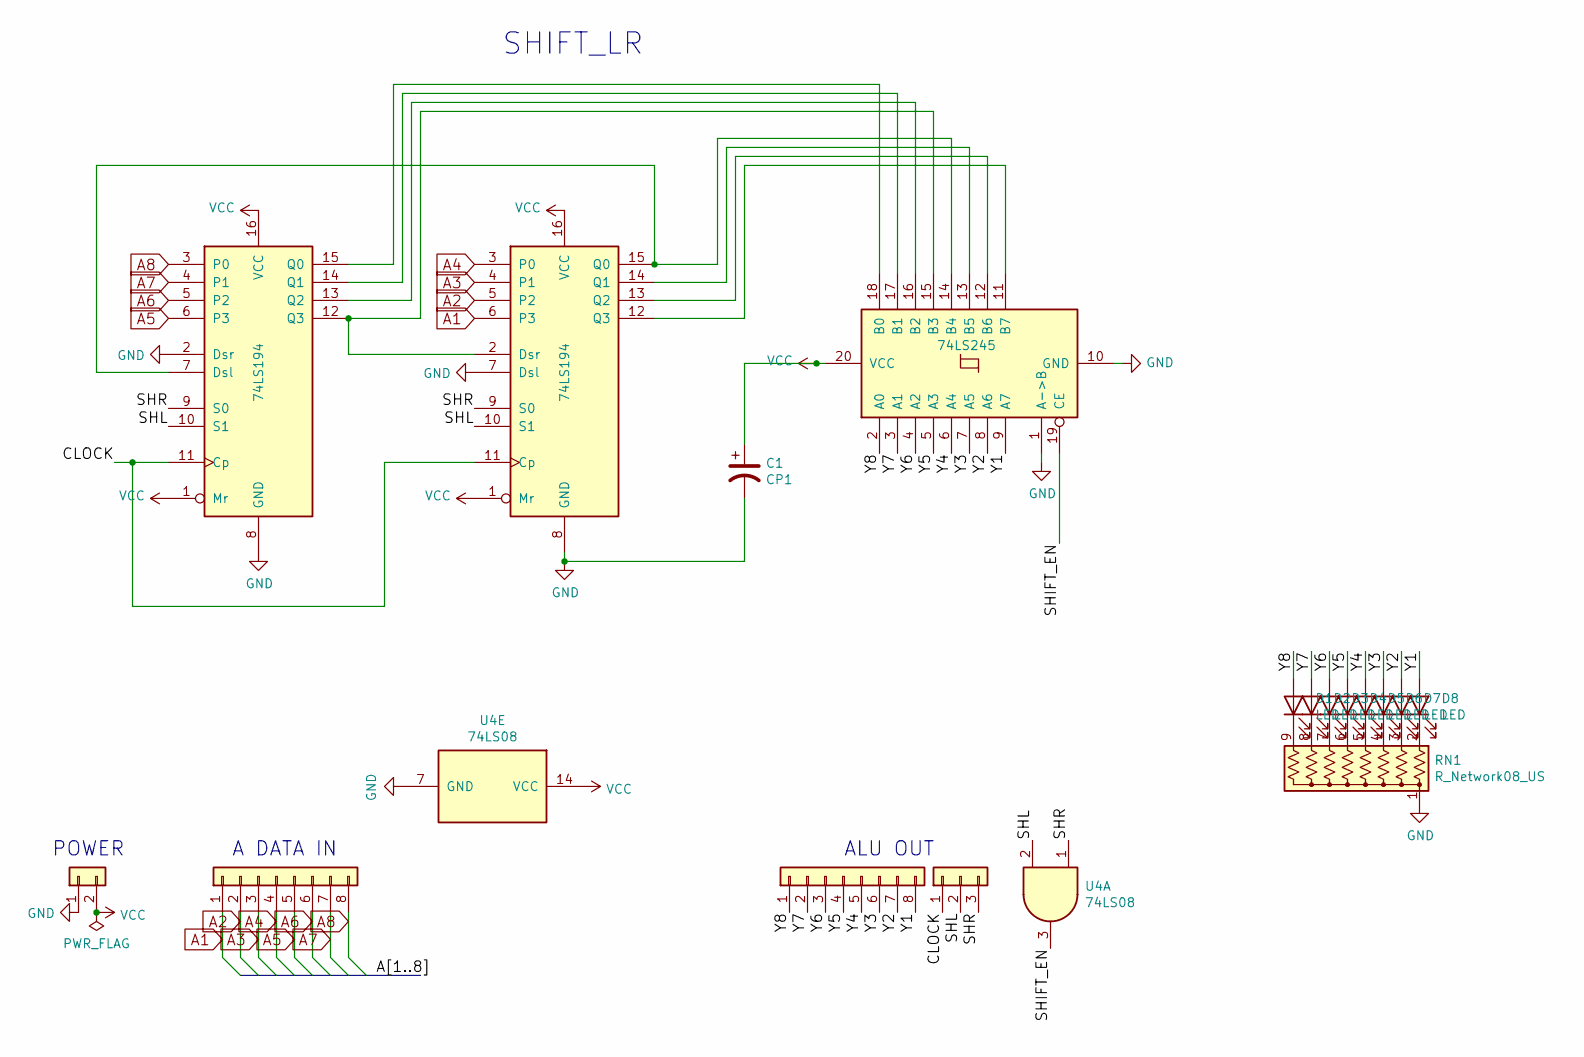
[picture p354: schematic ALU.sch]

Parts:
C1: CP1; C_Radial_D6.3mm_H11.0mm_P2.50mm
D1, D2, D3, D4, D5, D6, D7, D8: LED; LED_D3.0mm
J1: Conn_01x02; PinHeader_1x02_P2.54mm_Vertical
J2, J3: Conn_01x08; PinHeader_1x08_P2.54mm_Vertical
J4: Conn_01x03; PinHeader_1x03_P2.54mm_Vertical
RN1: R_Network08_US; R_Array_SIP9
U1, U2: 74LS194; DIP-16_W7.62mm
U3: 74LS245; DIP-20_W7.62mm
U4: 74LS08; DIP-14_W7.62mm

Connections:
A1: J2.1, U2.6 (P3)
A2: J2.2, U2.5 (P2)
A3: J2.3, U2.4 (P1)
A4: J2.4, U2.3 (P0)
A5: J2.5, U1.6 (P3)
A6: J2.6, U1.5 (P2)
A7: J2.7, U1.4 (P1)
A8: J2.8, U1.3 (P0)
CLOCK: J4.1, U1.11 (Cp), U2.11 (Cp)
GND: C1.2, J1.1, RN1.1 (common), U1.2 (Dsr), U1.8 (GND), U2.7 (Dsl), U2.8 (GND), U3.1 (A->B), U3.10 (GND), U4.7 (GND)
unnamed: D1.1 (K), RN1.9 (R8)
unnamed: D2.1 (K), RN1.8 (R7)
unnamed: D3.1 (K), RN1.7 (R6)
unnamed: D4.1 (K), RN1.6 (R5)
unnamed: D5.1 (K), RN1.5 (R4)
unnamed: D6.1 (K), RN1.4 (R3)
unnamed: D7.1 (K), RN1.3 (R2)
unnamed: D8.1 (K), RN1.2 (R1)
unnamed: U1.7 (Dsl), U2.15 (Q0), U3.14 (B4)
unnamed: U1.12 (Q3), U2.2 (Dsr), U3.15 (B3)
unnamed: U1.13 (Q2), U3.16 (B2)
unnamed: U1.14 (Q1), U3.17 (B1)
unnamed: U1.15 (Q0), U3.18 (B0)
unnamed: U2.12 (Q3), U3.11 (B7)
unnamed: U2.13 (Q2), U3.12 (B6)
unnamed: U2.14 (Q1), U3.13 (B5)
SHIFT_EN: U3.19 (CE), U4.3
SHL: J4.2, U1.10 (S1), U2.10 (S1), U4.2
SHR: J4.3, U1.9 (S0), U2.9 (S0), U4.1
VCC: C1.1, J1.2, U1.1 (Mr), U1.16 (VCC), U2.1 (Mr), U2.16 (VCC), U3.20 (VCC), U4.14 (VCC)
Y1: D8.2 (A), J3.8, U3.9 (A7)
Y2: D7.2 (A), J3.7, U3.8 (A6)
Y3: D6.2 (A), J3.6, U3.7 (A5)
Y4: D5.2 (A), J3.5, U3.6 (A4)
Y5: D4.2 (A), J3.4, U3.5 (A3)
Y6: D3.2 (A), J3.3, U3.4 (A2)
Y7: D2.2 (A), J3.2, U3.3 (A1)
Y8: D1.2 (A), J3.1, U3.2 (A0)

Notes on the sheet:
SHIFT_LR
A DATA IN
ALU OUT
POWER
