theWickedWebDev/8-bit-computer/other-modules/ALU-DISCRETE-LOGIC/ALU_LOGIC/ALU.sch

## KiCad design other-modules/ALU-DISCRETE-LOGIC/ALU_LOGIC/ALU.sch (2021-04-29)

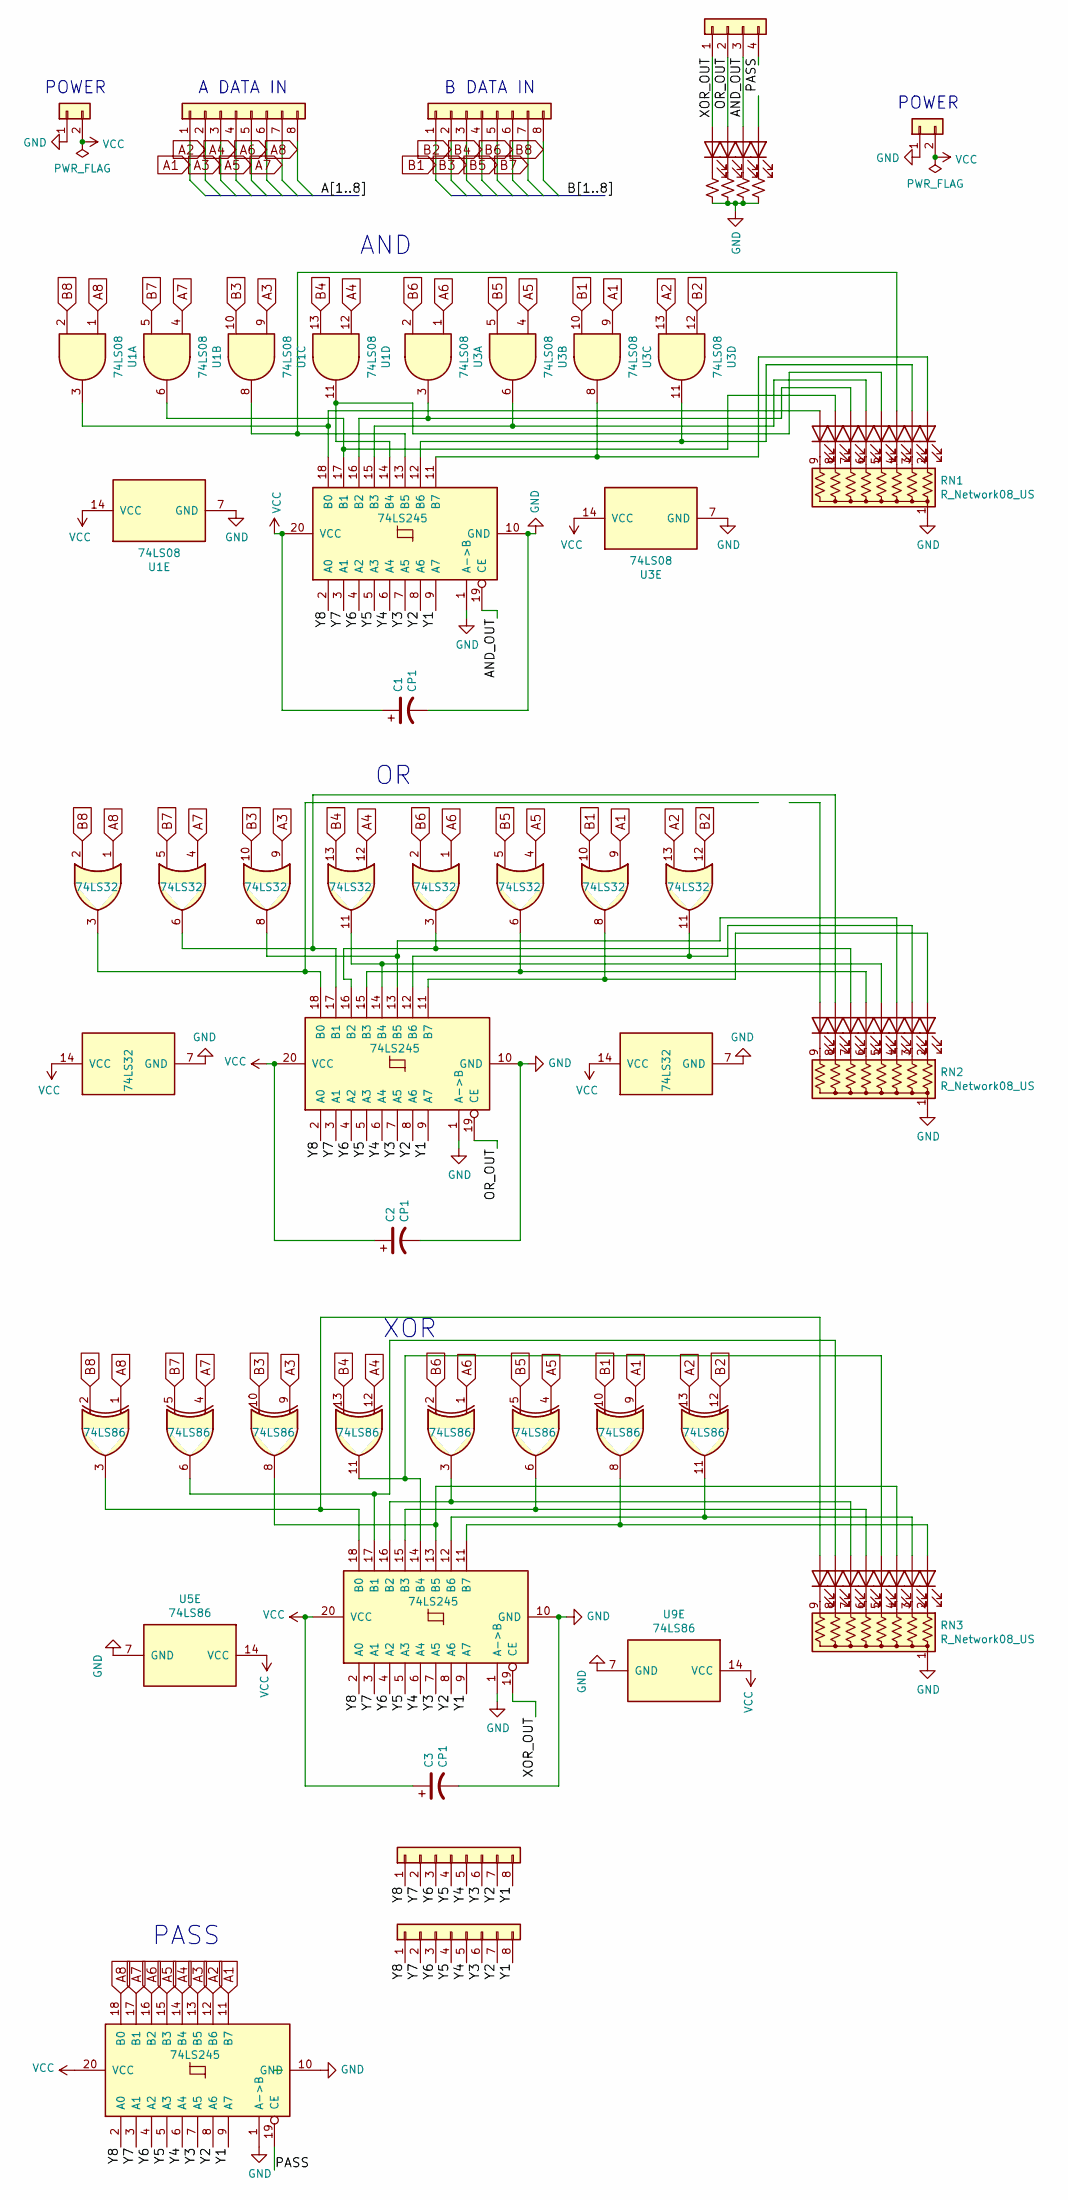
[picture p355: schematic ALU.sch]

Parts:
C1, C2, C3: CP1; C_Radial_D6.3mm_H11.0mm_P2.50mm
D1, D2, D3, D4, D5, D6, D7, D8, D9, D10, D11, D12, D13, D14, D15, D16, D17, D18, D19, D20, D21, D22, D23, D24, D25, D26, D27, D28: LED; LED_D5.0mm
J1, J7: Conn_01x02; PinHeader_1x02_P2.54mm_Vertical
J2, J3, J4, J6: Conn_01x08; PinHeader_1x08_P2.54mm_Vertical
J5: Conn_01x04; PinHeader_1x04_P2.54mm_Vertical
R1, R2, R3, R4: R_Small_US; R_Axial_DIN0207_L6.3mm_D2.5mm_P10.16mm_Horizontal
RN1, RN2, RN3: R_Network08_US; R_Array_SIP9
U1, U3: 74LS08; DIP-14_W7.62mm
U2, U6, U8, U10: 74LS245; DIP-20_W7.62mm
U4, U7: 74LS32; DIP-14_W7.62mm
U5, U9: 74LS86; DIP-14_W7.62mm

Connections:
A1: J2.1, U3.9, U7.9, U9.9, U10.11 (B7)
A2: J2.2, U3.13, U7.13, U9.13, U10.12 (B6)
A3: J2.3, U1.9, U4.9, U5.9, U10.13 (B5)
A4: J2.4, U1.12, U4.12, U5.12, U10.14 (B4)
A5: J2.5, U3.4, U7.4, U9.4, U10.15 (B3)
A6: J2.6, U3.1, U7.1, U9.1, U10.16 (B2)
A7: J2.7, U1.4, U4.4, U5.4, U10.17 (B1)
A8: J2.8, U1.1, U4.1, U5.1, U10.18 (B0)
AND_OUT: D27.2 (A), J5.3, U2.19 (CE)
B1: J3.1, U3.10, U7.10, U9.10
B2: J3.2, U3.12, U7.12, U9.12
B3: J3.3, U1.10, U4.10, U5.10
B4: J3.4, U1.13, U4.13, U5.13
B5: J3.5, U3.5, U7.5, U9.5
B6: J3.6, U3.2, U7.2, U9.2
B7: J3.7, U1.5, U4.5, U5.5
B8: J3.8, U1.2, U4.2, U5.2
GND: C1.2, C2.2, C3.2, J1.1, J7.1, R1.2, R2.2, R3.2, R4.2, RN1.1 (common), RN2.1 (common), RN3.1 (common), U1.7 (GND), U2.1 (A->B), U2.10 (GND), U3.7 (GND), U4.7 (GND), U5.7 (GND), U6.1 (A->B), U6.10 (GND), U7.7 (GND), U8.1 (A->B), U8.10 (GND), U9.7 (GND), U10.1 (A->B), U10.10 (GND)
unnamed: D1.1 (K), RN1.9 (R8)
unnamed: D1.2 (A), U1.3, U2.18 (B0)
unnamed: D2.1 (K), RN1.8 (R7)
unnamed: D2.2 (A), U1.6, U2.17 (B1)
unnamed: D3.1 (K), RN1.7 (R6)
unnamed: D3.2 (A), U2.16 (B2), U3.3
unnamed: D4.1 (K), RN1.6 (R5)
unnamed: D4.2 (A), U2.15 (B3), U3.6
unnamed: D5.1 (K), RN1.5 (R4)
unnamed: D5.2 (A), U1.11, U2.14 (B4)
unnamed: D6.1 (K), RN1.4 (R3)
unnamed: D6.2 (A), U1.8, U2.13 (B5)
unnamed: D7.1 (K), RN1.3 (R2)
unnamed: D7.2 (A), U2.12 (B6), U3.11
unnamed: D8.1 (K), RN1.2 (R1)
unnamed: D8.2 (A), U2.11 (B7), U3.8
unnamed: D9.1 (K), RN2.9 (R8)
unnamed: D10.1 (K), RN2.8 (R7)
unnamed: D10.2 (A), U4.6, U6.17 (B1)
unnamed: D11.1 (K), RN2.7 (R6)
unnamed: D11.2 (A), U6.16 (B2), U7.3
unnamed: D12.1 (K), RN2.6 (R5)
unnamed: D12.2 (A), U6.15 (B3), U7.6
unnamed: D13.1 (K), RN2.5 (R4)
unnamed: D13.2 (A), U4.11, U6.14 (B4)
unnamed: D14.1 (K), RN2.4 (R3)
unnamed: D14.2 (A), U4.8, U6.13 (B5)
unnamed: D15.1 (K), RN2.3 (R2)
unnamed: D15.2 (A), U6.12 (B6), U7.11
unnamed: D16.1 (K), RN2.2 (R1)
unnamed: D16.2 (A), U6.11 (B7), U7.8
unnamed: D17.1 (K), RN3.9 (R8)
unnamed: D17.2 (A), U5.3, U8.18 (B0)
unnamed: D18.1 (K), RN3.8 (R7)
unnamed: D18.2 (A), U5.6, U8.17 (B1)
unnamed: D19.1 (K), RN3.7 (R6)
unnamed: D19.2 (A), U8.16 (B2), U9.3
unnamed: D20.1 (K), RN3.6 (R5)
unnamed: D20.2 (A), U8.15 (B3), U9.6
unnamed: D21.1 (K), RN3.5 (R4)
unnamed: D21.2 (A), U5.11, U8.14 (B4)
unnamed: D22.1 (K), RN3.4 (R3)
unnamed: D22.2 (A), U5.8, U8.13 (B5)
unnamed: D23.1 (K), RN3.3 (R2)
unnamed: D23.2 (A), U8.12 (B6), U9.11
unnamed: D24.1 (K), RN3.2 (R1)
unnamed: D24.2 (A), U8.11 (B7), U9.8
unnamed: D25.1 (K), R1.1
unnamed: D26.1 (K), R2.1
unnamed: D27.1 (K), R3.1
unnamed: D28.1 (K), R4.1
unnamed: U4.3, U6.18 (B0)
OR_OUT: D26.2 (A), J5.2, U6.19 (CE)
PASS: J5.4, U10.19 (CE)
VCC: C1.1, C2.1, C3.1, J1.2, J7.2, U1.14 (VCC), U2.20 (VCC), U3.14 (VCC), U4.14 (VCC), U5.14 (VCC), U6.20 (VCC), U7.14 (VCC), U8.20 (VCC), U9.14 (VCC), U10.20 (VCC)
XOR_OUT: D25.2 (A), J5.1, U8.19 (CE)
Y1: J4.8, J6.8, U2.9 (A7), U6.9 (A7), U8.9 (A7), U10.9 (A7)
Y2: J4.7, J6.7, U2.8 (A6), U6.8 (A6), U8.8 (A6), U10.8 (A6)
Y3: J4.6, J6.6, U2.7 (A5), U6.7 (A5), U8.7 (A5), U10.7 (A5)
Y4: J4.5, J6.5, U2.6 (A4), U6.6 (A4), U8.6 (A4), U10.6 (A4)
Y5: J4.4, J6.4, U2.5 (A3), U6.5 (A3), U8.5 (A3), U10.5 (A3)
Y6: J4.3, J6.3, U2.4 (A2), U6.4 (A2), U8.4 (A2), U10.4 (A2)
Y7: J4.2, J6.2, U2.3 (A1), U6.3 (A1), U8.3 (A1), U10.3 (A1)
Y8: J4.1, J6.1, U2.2 (A0), U6.2 (A0), U8.2 (A0), U10.2 (A0)

Notes on the sheet:
AND
A DATA IN
B DATA IN
POWER
XOR
PASS
