theWickedWebDev/8-bit-computer/Modules/ram-module/SPLIT/MEMORY-ADDRESS-REGISTER/MAR.sch

## KiCad design Modules/ram-module/SPLIT/MEMORY-ADDRESS-REGISTER/MAR.sch (2021-06-15)

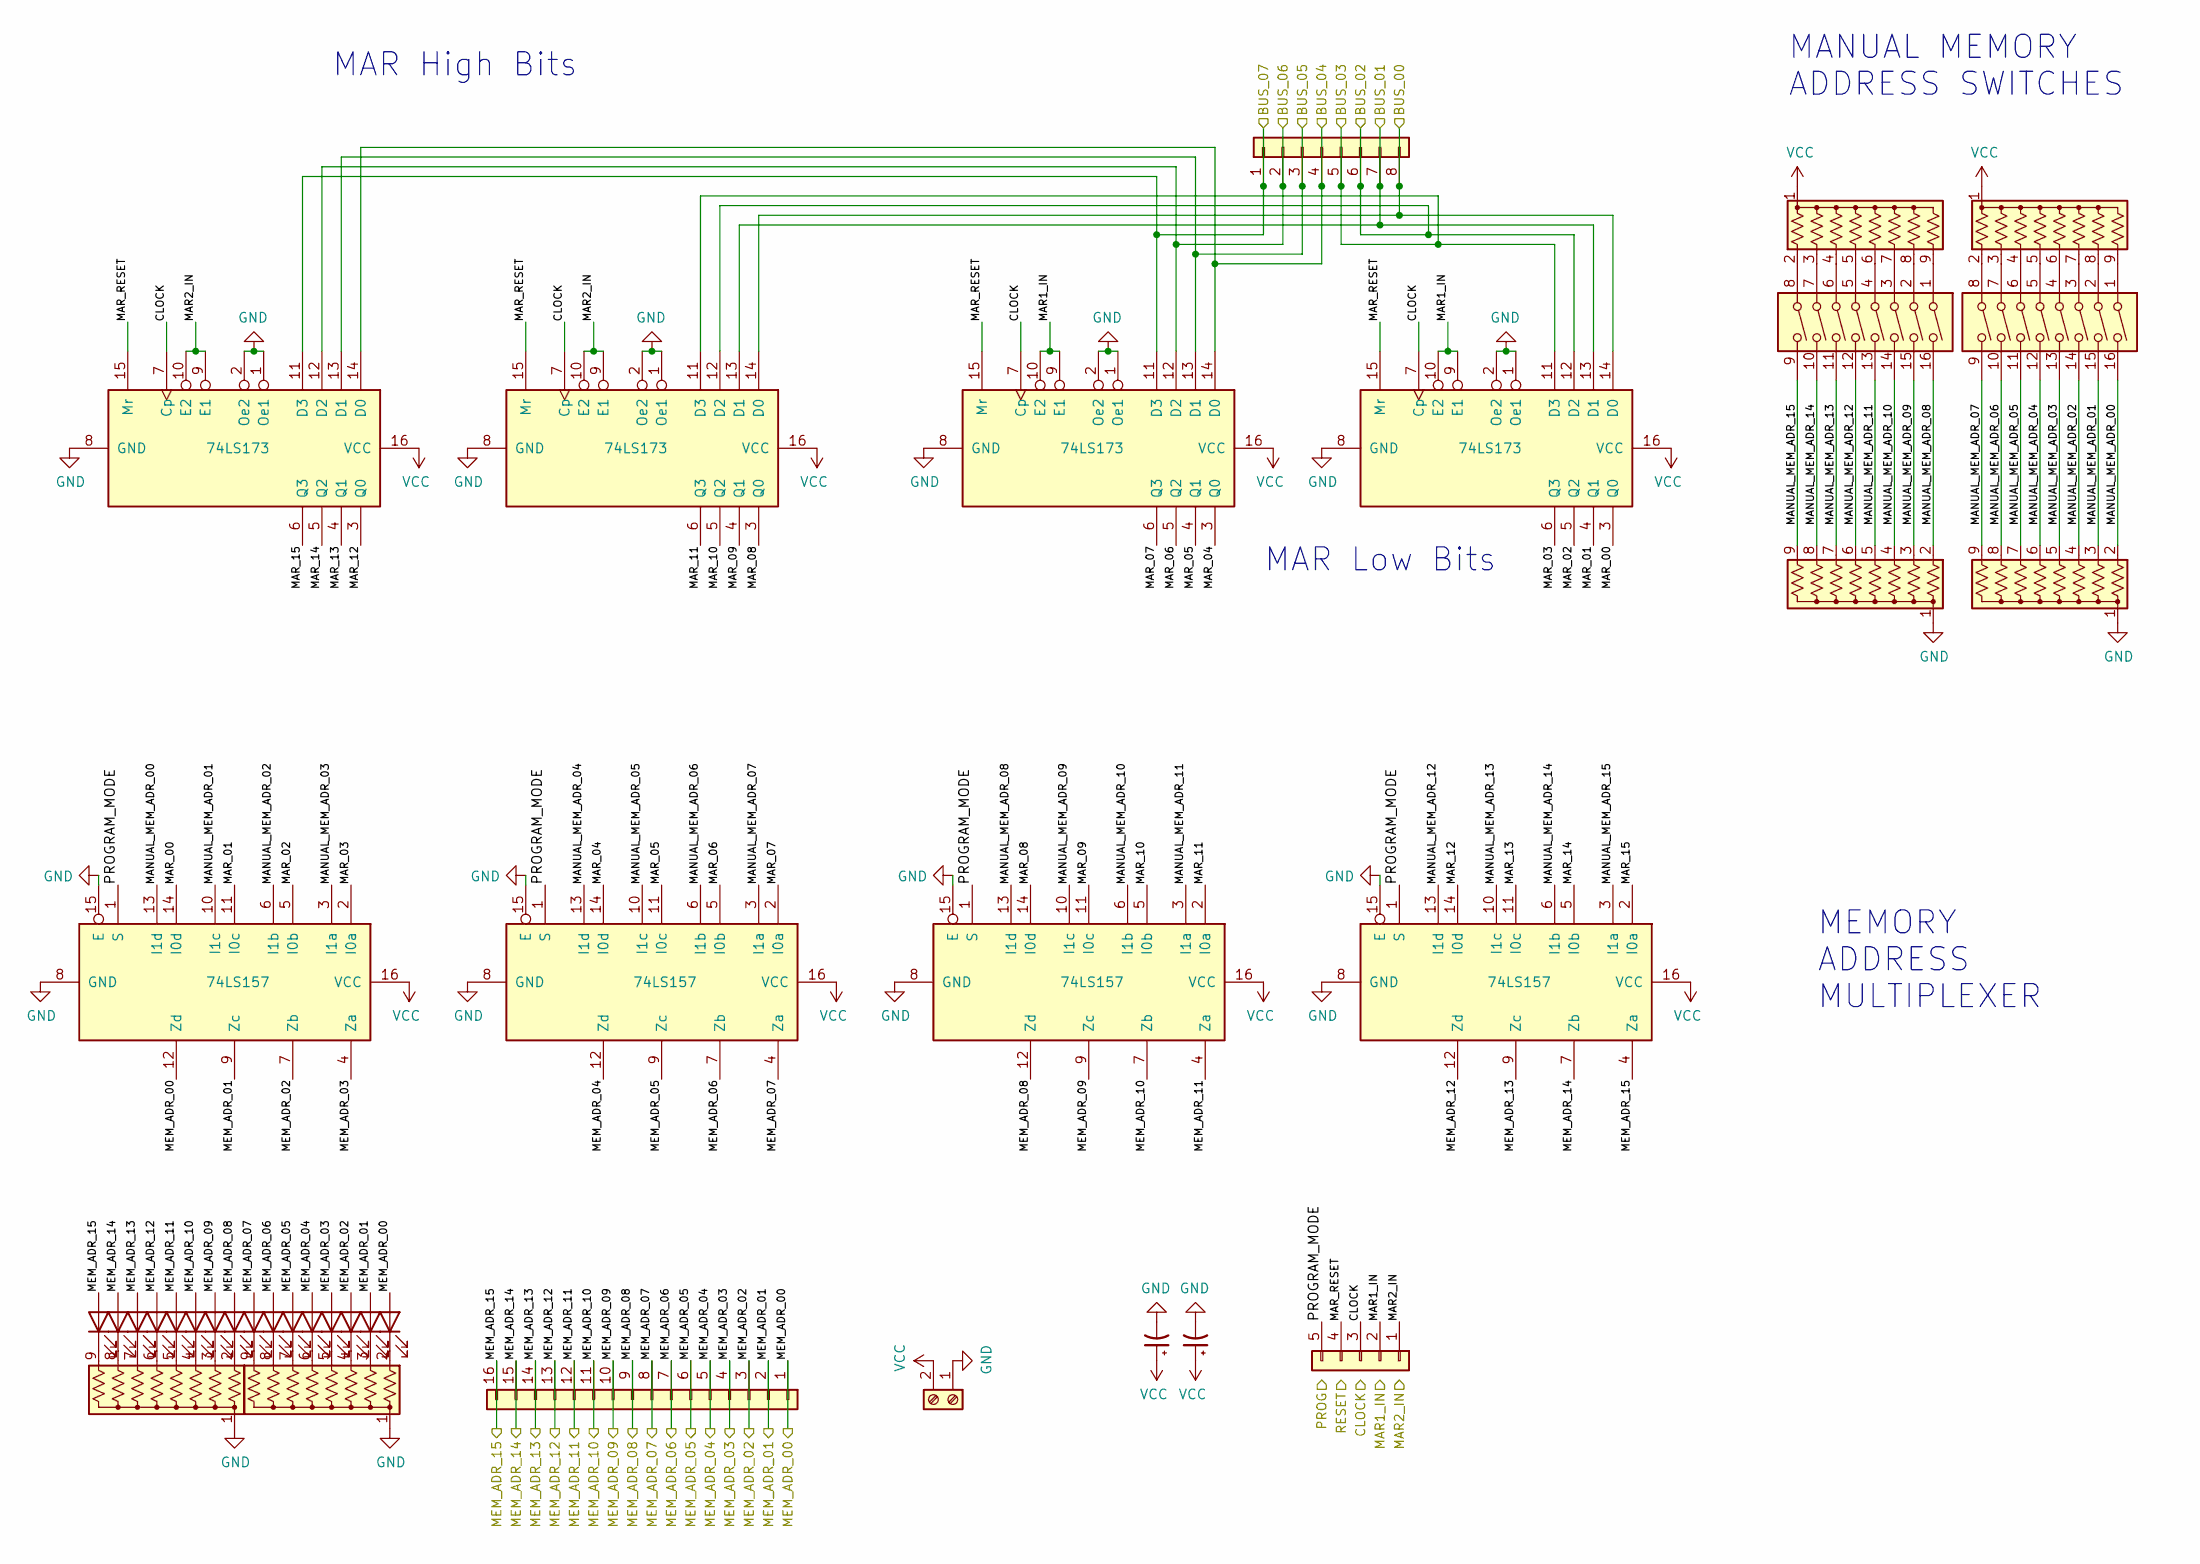
[picture p356: schematic MAR.sch]

Parts:
C11, C12: CP1_Small; CP_Radial_D5.0mm_P2.50mm
D34, D35, D36, D37, D38, D39, D40, D41, D42, D43, D44, D45, D46, D47, D48, D49: LED; LED_D3.0mm
J25: Conn_01x08; PinHeader_1x16_P2.54mm_Vertical
J26: Screw_Terminal_01x02; TerminalBlock_Phoenix_MKDS-1,5-2_1x02_P5.00mm_Horizontal
J27: Conn_01x08; PinHeader_1x08_P2.54mm_Vertical
J28: Conn_01x05; PinHeader_1x05_P2.54mm_Vertical
RN3, RN4, RN5, RN6, RN7, RN8: R_Network08_US; R_Array_SIP9
SW1, SW2: SW_DIP_x08; SW_DIP_SPSTx08_Slide_9.78x22.5mm_W7.62mm_P2.54mm
U15, U18, U19, U22: 74LS157; DIP-16_W7.62mm
U16, U17, U20, U21: 74LS173; DIP-16_W7.62mm

Connections:
BUS_00: J27.8, U17.14 (D0), U21.14 (D0)
BUS_01: J27.7, U17.13 (D1), U21.13 (D1)
BUS_02: J27.6, U17.12 (D2), U21.12 (D2)
BUS_03: J27.5, U17.11 (D3), U21.11 (D3)
BUS_04: J27.4, U16.14 (D0), U20.14 (D0)
BUS_05: J27.3, U16.13 (D1), U20.13 (D1)
BUS_06: J27.2, U16.12 (D2), U20.12 (D2)
BUS_07: J27.1, U16.11 (D3), U20.11 (D3)
CLOCK: J28.3, U16.7 (Cp), U17.7 (Cp), U20.7 (Cp), U21.7 (Cp)
GND: C11.2, C12.2, J26.1, RN3.1 (common), RN4.1 (common), RN5.1 (common), RN7.1 (common), U15.8 (GND), U15.15 (E), U16.1 (Oe1), U16.2 (Oe2), U16.8 (GND), U17.1 (Oe1), U17.2 (Oe2), U17.8 (GND), U18.8 (GND), U18.15 (E), U19.8 (GND), U19.15 (E), U20.1 (Oe1), U20.2 (Oe2), U20.8 (GND), U21.1 (Oe1), U21.2 (Oe2), U21.8 (GND), U22.8 (GND), U22.15 (E)
MANUAL_MEM_ADR_00: RN7.2 (R1), SW2.16, U15.13 (I1d)
MANUAL_MEM_ADR_01: RN7.3 (R2), SW2.15, U15.10 (I1c)
MANUAL_MEM_ADR_02: RN7.4 (R3), SW2.14, U15.6 (I1b)
MANUAL_MEM_ADR_03: RN7.5 (R4), SW2.13, U15.3 (I1a)
MANUAL_MEM_ADR_04: RN7.6 (R5), SW2.12, U18.13 (I1d)
MANUAL_MEM_ADR_05: RN7.7 (R6), SW2.11, U18.10 (I1c)
MANUAL_MEM_ADR_06: RN7.8 (R7), SW2.10, U18.6 (I1b)
MANUAL_MEM_ADR_07: RN7.9 (R8), SW2.9, U18.3 (I1a)
MANUAL_MEM_ADR_08: RN5.2 (R1), SW1.16, U19.13 (I1d)
MANUAL_MEM_ADR_09: RN5.3 (R2), SW1.15, U19.10 (I1c)
MANUAL_MEM_ADR_10: RN5.4 (R3), SW1.14, U19.6 (I1b)
MANUAL_MEM_ADR_11: RN5.5 (R4), SW1.13, U19.3 (I1a)
MANUAL_MEM_ADR_12: RN5.6 (R5), SW1.12, U22.13 (I1d)
MANUAL_MEM_ADR_13: RN5.7 (R6), SW1.11, U22.10 (I1c)
MANUAL_MEM_ADR_14: RN5.8 (R7), SW1.10, U22.6 (I1b)
MANUAL_MEM_ADR_15: RN5.9 (R8), SW1.9, U22.3 (I1a)
MAR1_IN: J28.2, U20.9 (E1), U20.10 (E2), U21.9 (E1), U21.10 (E2)
MAR2_IN: J28.1, U16.9 (E1), U16.10 (E2), U17.9 (E1), U17.10 (E2)
MAR_00: U15.14 (I0d), U21.3 (Q0)
MAR_01: U15.11 (I0c), U21.4 (Q1)
MAR_02: U15.5 (I0b), U21.5 (Q2)
MAR_03: U15.2 (I0a), U21.6 (Q3)
MAR_04: U18.14 (I0d), U20.3 (Q0)
MAR_05: U18.11 (I0c), U20.4 (Q1)
MAR_06: U18.5 (I0b), U20.5 (Q2)
MAR_07: U18.2 (I0a), U20.6 (Q3)
MAR_08: U17.3 (Q0), U19.14 (I0d)
MAR_09: U17.4 (Q1), U19.11 (I0c)
MAR_10: U17.5 (Q2), U19.5 (I0b)
MAR_11: U17.6 (Q3), U19.2 (I0a)
MAR_12: U16.3 (Q0), U22.14 (I0d)
MAR_13: U16.4 (Q1), U22.11 (I0c)
MAR_14: U16.5 (Q2), U22.5 (I0b)
MAR_15: U16.6 (Q3), U22.2 (I0a)
MAR_RESET: J28.4, U16.15 (Mr), U17.15 (Mr), U20.15 (Mr), U21.15 (Mr)
MEM_ADR_00: D49.2 (A), J25.1, U15.12 (Zd)
MEM_ADR_01: D48.2 (A), J25.2, U15.9 (Zc)
MEM_ADR_02: D47.2 (A), J25.3, U15.7 (Zb)
MEM_ADR_03: D46.2 (A), J25.4, U15.4 (Za)
MEM_ADR_04: D45.2 (A), J25.5, U18.12 (Zd)
MEM_ADR_05: D44.2 (A), J25.6, U18.9 (Zc)
MEM_ADR_06: D43.2 (A), J25.7, U18.7 (Zb)
MEM_ADR_07: D42.2 (A), J25.8, U18.4 (Za)
MEM_ADR_08: D41.2 (A), J25.9, U19.12 (Zd)
MEM_ADR_09: D40.2 (A), J25.10, U19.9 (Zc)
MEM_ADR_10: D39.2 (A), J25.11, U19.7 (Zb)
MEM_ADR_11: D38.2 (A), J25.12, U19.4 (Za)
MEM_ADR_12: D37.2 (A), J25.13, U22.12 (Zd)
MEM_ADR_13: D36.2 (A), J25.14, U22.9 (Zc)
MEM_ADR_14: D35.2 (A), J25.15, U22.7 (Zb)
MEM_ADR_15: D34.2 (A), J25.16, U22.4 (Za)
unnamed: D34.1 (K), RN3.9 (R8)
unnamed: D35.1 (K), RN3.8 (R7)
unnamed: D36.1 (K), RN3.7 (R6)
unnamed: D37.1 (K), RN3.6 (R5)
unnamed: D38.1 (K), RN3.5 (R4)
unnamed: D39.1 (K), RN3.4 (R3)
unnamed: D40.1 (K), RN3.3 (R2)
unnamed: D41.1 (K), RN3.2 (R1)
unnamed: D42.1 (K), RN4.9 (R8)
unnamed: D43.1 (K), RN4.8 (R7)
unnamed: D44.1 (K), RN4.7 (R6)
unnamed: D45.1 (K), RN4.6 (R5)
unnamed: D46.1 (K), RN4.5 (R4)
unnamed: D47.1 (K), RN4.4 (R3)
unnamed: D48.1 (K), RN4.3 (R2)
unnamed: D49.1 (K), RN4.2 (R1)
unnamed: RN6.2 (R1), SW1.8
unnamed: RN6.3 (R2), SW1.7
unnamed: RN6.4 (R3), SW1.6
unnamed: RN6.5 (R4), SW1.5
unnamed: RN6.6 (R5), SW1.4
unnamed: RN6.7 (R6), SW1.3
unnamed: RN6.8 (R7), SW1.2
unnamed: RN6.9 (R8), SW1.1
unnamed: RN8.2 (R1), SW2.8
unnamed: RN8.3 (R2), SW2.7
unnamed: RN8.4 (R3), SW2.6
unnamed: RN8.5 (R4), SW2.5
unnamed: RN8.6 (R5), SW2.4
unnamed: RN8.7 (R6), SW2.3
unnamed: RN8.8 (R7), SW2.2
unnamed: RN8.9 (R8), SW2.1
PROGRAM_MODE: J28.5, U15.1 (S), U18.1 (S), U19.1 (S), U22.1 (S)
VCC: C11.1, C12.1, J26.2, RN6.1 (common), RN8.1 (common), U15.16 (VCC), U16.16 (VCC), U17.16 (VCC), U18.16 (VCC), U19.16 (VCC), U20.16 (VCC), U21.16 (VCC), U22.16 (VCC)

Notes on the sheet:
MAR Low Bits
MAR High Bits
MEMORY ADDRESS MULTIPLEXER
MANUAL MEMORY ADDRESS SWITCHES
