theWickedWebDev/8-bit-computer/Modules/ram-module/SPLIT/RAM/RAM.sch

## KiCad design Modules/ram-module/SPLIT/RAM/RAM.sch (2021-06-15)

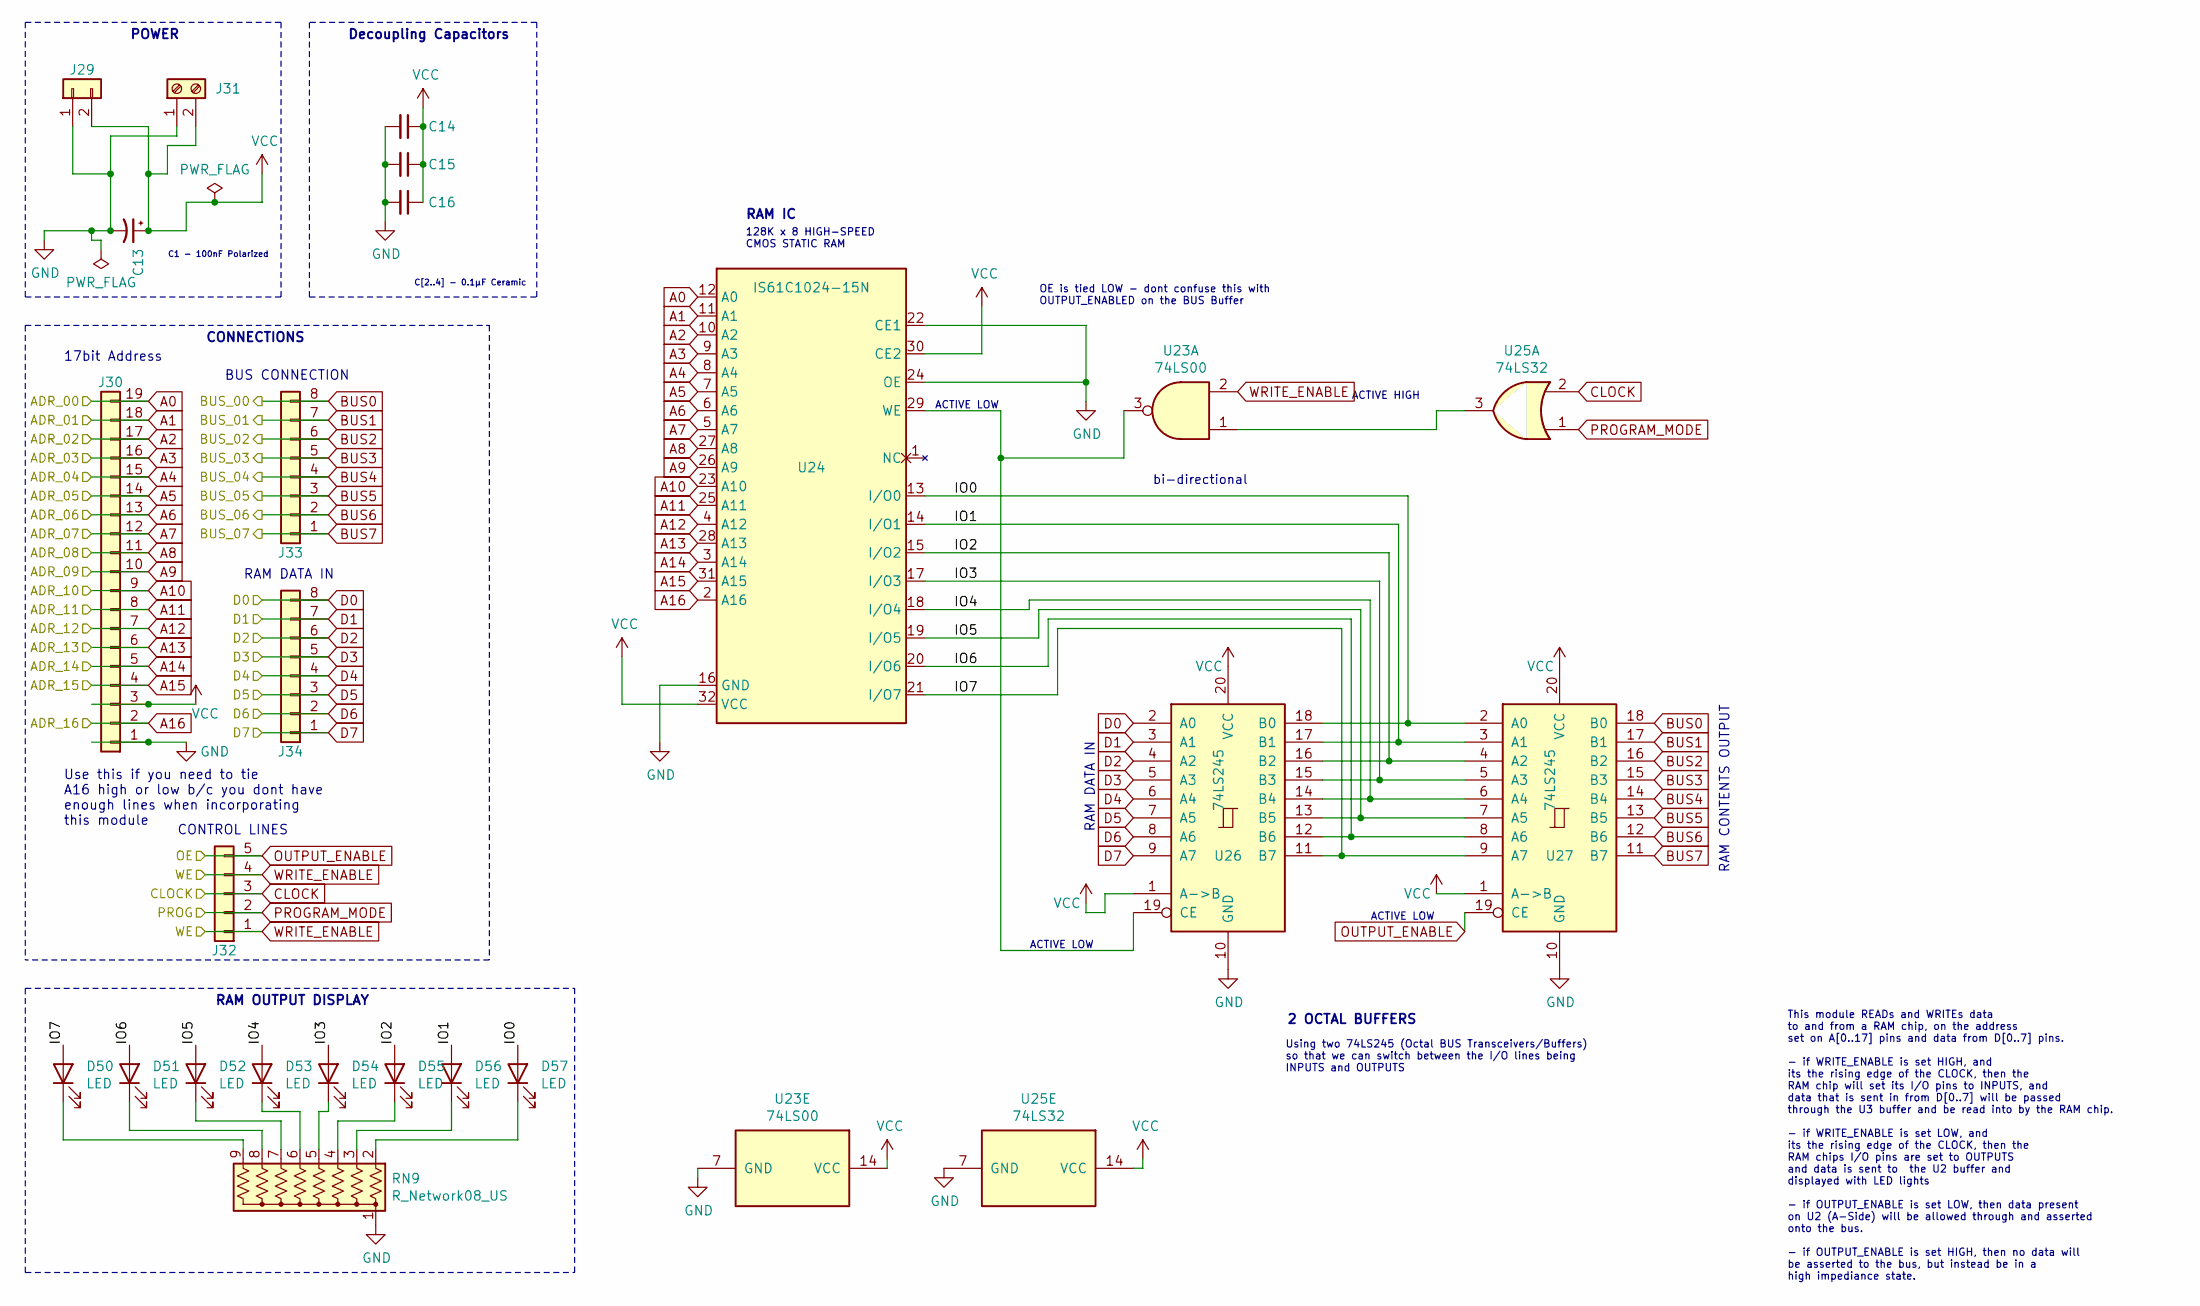
[picture p357: schematic RAM.sch]

Parts:
C13: CP1_Small; CP_Radial_D5.0mm_P2.50mm
C14, C15, C16: C_Small; C_Disc_D3.8mm_W2.6mm_P2.50mm
D50, D51, D52, D53, D54, D55, D56, D57: LED; LED_D5.0mm
J29: Conn_01x02; PinHeader_1x02_P2.54mm_Vertical
J30: Conn_01x19; PinHeader_1x19_P2.54mm_Vertical
J31: Screw_Terminal_01x02; TerminalBlock_Phoenix_MKDS-1,5-2_1x02_P5.00mm_Horizontal
J32: Conn_01x05; PinHeader_1x05_P2.54mm_Vertical
J33, J34: Conn_01x08; PinHeader_1x08_P2.54mm_Vertical
RN9: R_Network08_US; R_Array_SIP9
U23: 74LS00; DIP-14_W7.62mm_Socket
U24: IS61C1024-15N; DIP-32_W7.62mm
U25: 74LS32; DIP-14_W7.62mm_Socket
U26, U27: 74LS245; DIP-20_W7.62mm_Socket

Connections:
A0: J30.19, U24.12 (A0)
A1: J30.18, U24.11 (A1)
A2: J30.17, U24.10 (A2)
A3: J30.16, U24.9 (A3)
A4: J30.15, U24.8 (A4)
A5: J30.14, U24.7 (A5)
A6: J30.13, U24.6 (A6)
A7: J30.12, U24.5 (A7)
A8: J30.11, U24.27 (A8)
A9: J30.10, U24.26 (A9)
A10: J30.9, U24.23 (A10)
A11: J30.8, U24.25 (A11)
A12: J30.7, U24.4 (A12)
A13: J30.6, U24.28 (A13)
A14: J30.5, U24.3 (A14)
A15: J30.4, U24.31 (A15)
A16: J30.2, U24.2 (A16)
BUS0: J33.8, U27.18 (B0)
BUS1: J33.7, U27.17 (B1)
BUS2: J33.6, U27.16 (B2)
BUS3: J33.5, U27.15 (B3)
BUS4: J33.4, U27.14 (B4)
BUS5: J33.3, U27.13 (B5)
BUS6: J33.2, U27.12 (B6)
BUS7: J33.1, U27.11 (B7)
CLOCK: J32.3, U25.2
D0: J34.8, U26.2 (A0)
D1: J34.7, U26.3 (A1)
D2: J34.6, U26.4 (A2)
D3: J34.5, U26.5 (A3)
D4: J34.4, U26.6 (A4)
D5: J34.3, U26.7 (A5)
D6: J34.2, U26.8 (A6)
D7: J34.1, U26.9 (A7)
GND: C13.2, C14.2, C15.2, C16.2, J29.1, J30.1, J31.1, RN9.1 (common), U23.7 (GND), U24.16 (GND), U24.22 (CE1), U24.24 (OE), U25.7 (GND), U26.10 (GND), U27.10 (GND)
IO0: D57.2 (A), U24.13 (I/O0), U26.18 (B0), U27.2 (A0)
IO1: D56.2 (A), U24.14 (I/O1), U26.17 (B1), U27.3 (A1)
IO2: D55.2 (A), U24.15 (I/O2), U26.16 (B2), U27.4 (A2)
IO3: D54.2 (A), U24.17 (I/O3), U26.15 (B3), U27.5 (A3)
IO4: D53.2 (A), U24.18 (I/O4), U26.14 (B4), U27.6 (A4)
IO5: D52.2 (A), U24.19 (I/O5), U26.13 (B5), U27.7 (A5)
IO6: D51.2 (A), U24.20 (I/O6), U26.12 (B6), U27.8 (A6)
IO7: D50.2 (A), U24.21 (I/O7), U26.11 (B7), U27.9 (A7)
unnamed: D50.1 (K), RN9.9 (R8)
unnamed: D51.1 (K), RN9.8 (R7)
unnamed: D52.1 (K), RN9.7 (R6)
unnamed: D53.1 (K), RN9.6 (R5)
unnamed: D54.1 (K), RN9.5 (R4)
unnamed: D55.1 (K), RN9.4 (R3)
unnamed: D56.1 (K), RN9.3 (R2)
unnamed: D57.1 (K), RN9.2 (R1)
unnamed: U23.1, U25.3
unnamed: U23.3, U24.29 (WE), U26.19 (CE)
OUTPUT_ENABLE: J32.5, U27.19 (CE)
PROGRAM_MODE: J32.2, U25.1
VCC: C13.1, C14.1, C15.1, C16.1, J29.2, J30.3, J31.2, U23.14 (VCC), U24.30 (CE2), U24.32 (VCC), U25.14 (VCC), U26.1 (A->B), U26.20 (VCC), U27.1 (A->B), U27.20 (VCC)
WRITE_ENABLE: J32.1, J32.4, U23.2

Notes on the sheet:
Use this if you need to tie A16 high or low b/c you dont have enough lines when incorporating this module
RAM CONTENTS OUTPUT
RAM DATA IN
RAM IC
2 OCTAL BUFFERS
ACTIVE LOW
POWER
RAM OUTPUT DISPLAY
Decoupling Capacitors
C[2..4] - 0.1μF Ceramic
C1 - 100nF Polarized
CONTROL LINES
CONNECTIONS
17bit Address
BUS CONNECTION
bi-directional
This module READs and WRITEs data to and from a RAM chip, on the address set on A[0..17] pins and data from D[0..7] pins. - if WRITE_ENABLE is set HIGH, and its the rising edge of the CLOCK, then the RAM chip will set its I/O pins to INPUTS, and data that is sent in from D[0..7] will be passed thro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
Using two 74LS245 (Octal BUS Transceivers/Buffers) so that we can switch between the I/O lines being INPUTS and OUTPUTS
OE is tied LOW - dont confuse this with OUTPUT_ENABLED on the BUS Buffer
128K x 8 HIGH-SPEED CMOS STATIC RAM
ACTIVE HIGH
