theWickedWebDev/8-bit-computer/Modules/ram-module/SPLIT/RAM_PROGRAMMER/RAM_PROGRAMMER.sch

## KiCad design Modules/ram-module/SPLIT/RAM_PROGRAMMER/RAM_PROGRAMMER.sch (2021-05-22)

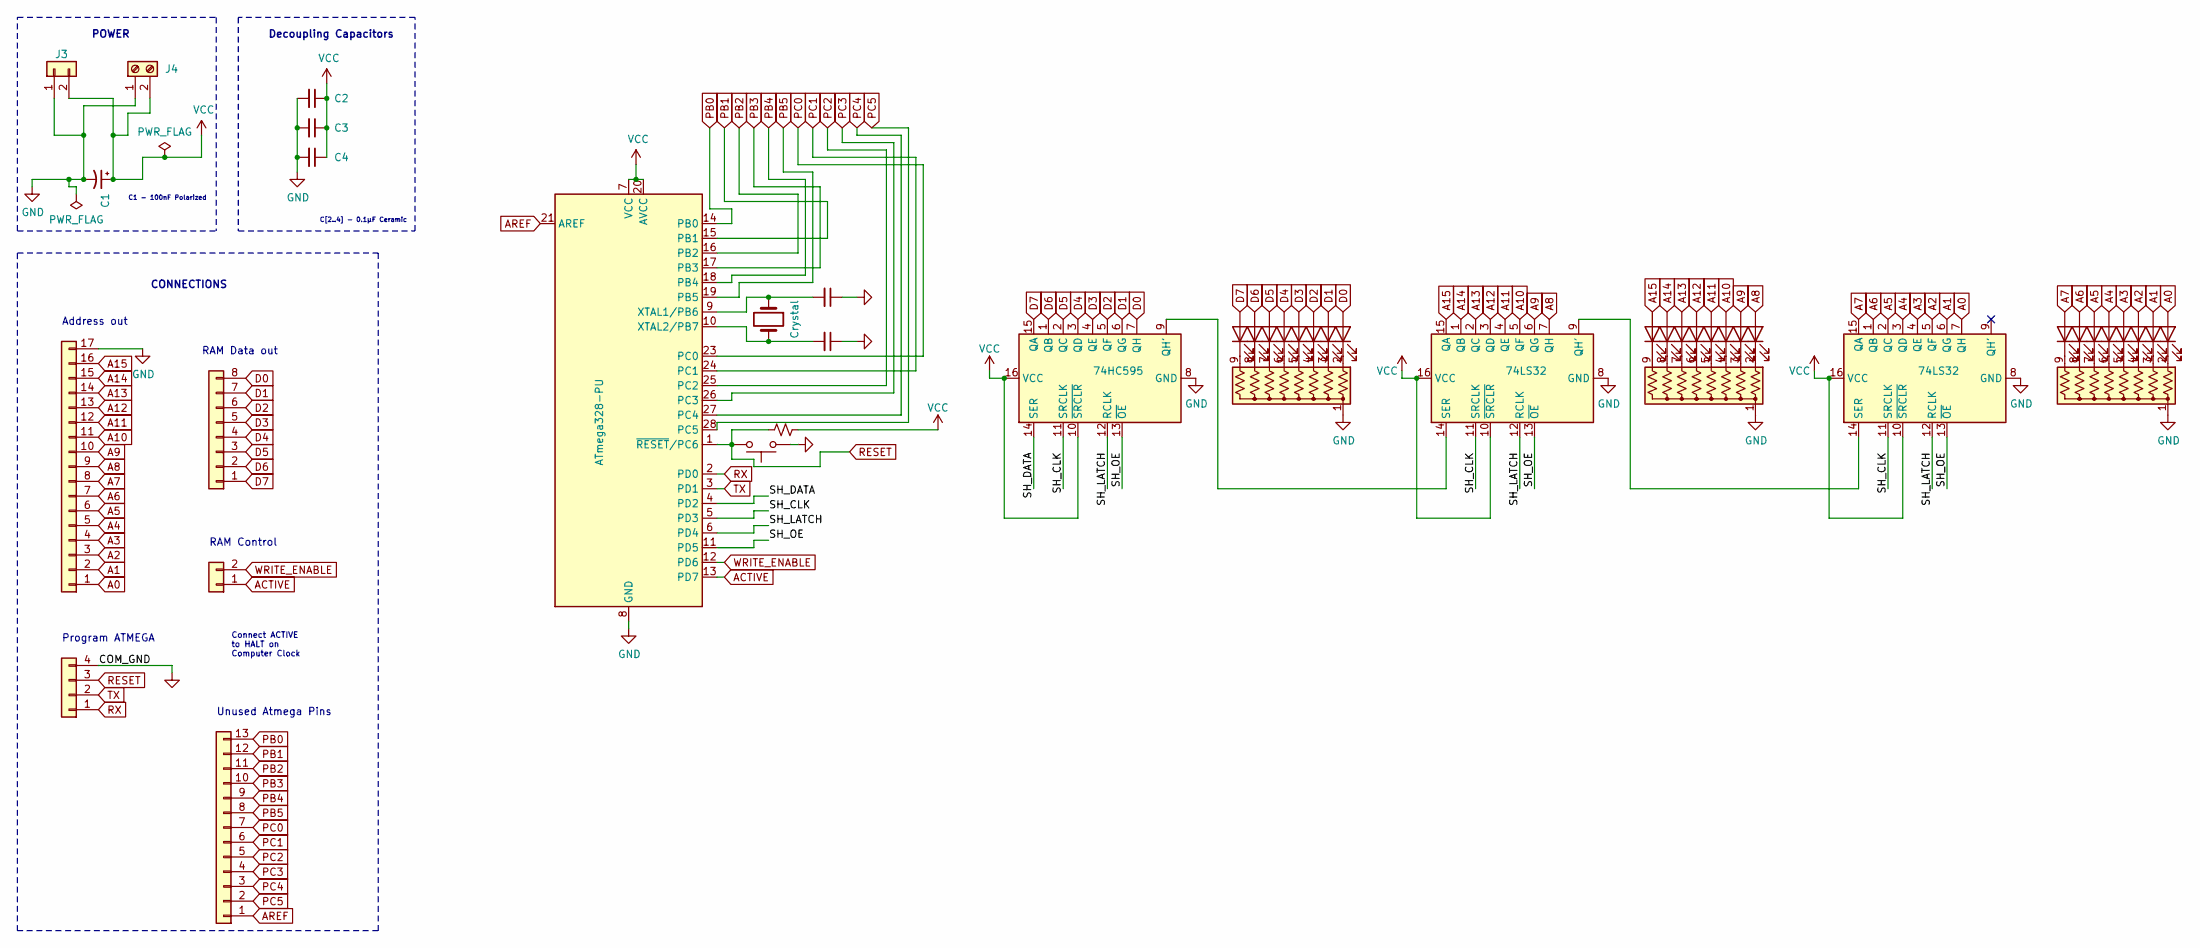
[picture p358: schematic RAM_PROGRAMMER.sch]

Parts:
C1: CP1_Small; CP_Radial_D5.0mm_P2.50mm
C2, C3, C4, C5, C6: C_Small; C_Disc_D3.8mm_W2.6mm_P2.50mm
D1, D2, D3, D4, D5, D6, D7, D8, D9, D10, D11, D12, D13, D14, D15, D16, D17, D18, D19, D20, D21, D22, D23, D24: LED; LED_D3.0mm
J1: Conn_01x17; PinHeader_1x17_P2.54mm_Vertical
J2, J3: Conn_01x02; PinHeader_1x02_P2.54mm_Vertical
J4: Screw_Terminal_01x02; TerminalBlock_Phoenix_MKDS-1,5-2_1x02_P5.00mm_Horizontal
J6: Conn_01x04; PinHeader_1x04_P2.54mm_Vertical
J7: Conn_01x08; PinHeader_1x08_P2.54mm_Vertical
J8: Conn_01x13; PinHeader_1x13_P2.54mm_Vertical
R1: R_Small_US; R_Axial_DIN0207_L6.3mm_D2.5mm_P7.62mm_Horizontal
RN1, RN2, RN3: R_Network08_US; R_Array_SIP9
SW1: SW_Push; SW_PUSH_6mm
U1: ATmega328-PU; DIP-28_W7.62mm
U2, U4: 74LS32; DIP-16_W7.62mm_Socket
U3: 74HC595; DIP-16_W7.62mm_Socket
Y1: Crystal; Resonator-2Pin_W7.0mm_H2.5mm

Connections:
A0: D23.2 (A), J1.1, U4.7 (QH)
A1: D21.2 (A), J1.2, U4.6 (QG)
A2: D19.2 (A), J1.3, U4.5 (QF)
A3: D17.2 (A), J1.4, U4.4 (QE)
A4: D15.2 (A), J1.5, U4.3 (QD)
A5: D13.2 (A), J1.6, U4.2 (QC)
A6: D11.2 (A), J1.7, U4.1 (QB)
A7: D9.2 (A), J1.8, U4.15 (QA)
A8: D8.2 (A), J1.9, U2.7 (QH)
A9: D7.2 (A), J1.10, U2.6 (QG)
A10: D6.2 (A), J1.11, U2.5 (QF)
A11: D5.2 (A), J1.12, U2.4 (QE)
A12: D4.2 (A), J1.13, U2.3 (QD)
A13: D3.2 (A), J1.14, U2.2 (QC)
A14: D2.2 (A), J1.15, U2.1 (QB)
A15: D1.2 (A), J1.16, U2.15 (QA)
ACTIVE: J2.1, U1.13 (PD7)
AREF: J8.1, U1.21 (AREF)
D0: D24.2 (A), J7.8, U3.7 (QH)
D1: D22.2 (A), J7.7, U3.6 (QG)
D2: D20.2 (A), J7.6, U3.5 (QF)
D3: D18.2 (A), J7.5, U3.4 (QE)
D4: D16.2 (A), J7.4, U3.3 (QD)
D5: D14.2 (A), J7.3, U3.2 (QC)
D6: D12.2 (A), J7.2, U3.1 (QB)
D7: D10.2 (A), J7.1, U3.15 (QA)
GND: C1.2, C2.2, C3.2, C4.2, C5.1, C6.1, J1.17, J3.1, J4.1, J6.4, RN1.1 (common), RN2.1 (common), RN3.1 (common), SW1.1, U1.8 (GND), U1.22 (GND), U2.8 (GND), U3.8 (GND), U4.8 (GND)
unnamed: C5.2, U1.9 (XTAL1/PB6), Y1.1
unnamed: C6.2, U1.10 (XTAL2/PB7), Y1.2
unnamed: D1.1 (K), RN1.9 (R8)
unnamed: D2.1 (K), RN1.8 (R7)
unnamed: D3.1 (K), RN1.7 (R6)
unnamed: D4.1 (K), RN1.6 (R5)
unnamed: D5.1 (K), RN1.5 (R4)
unnamed: D6.1 (K), RN1.4 (R3)
unnamed: D7.1 (K), RN1.3 (R2)
unnamed: D8.1 (K), RN1.2 (R1)
unnamed: D9.1 (K), RN2.9 (R8)
unnamed: D10.1 (K), RN3.9 (R8)
unnamed: D11.1 (K), RN2.8 (R7)
unnamed: D12.1 (K), RN3.8 (R7)
unnamed: D13.1 (K), RN2.7 (R6)
unnamed: D14.1 (K), RN3.7 (R6)
unnamed: D15.1 (K), RN2.6 (R5)
unnamed: D16.1 (K), RN3.6 (R5)
unnamed: D17.1 (K), RN2.5 (R4)
unnamed: D18.1 (K), RN3.5 (R4)
unnamed: D19.1 (K), RN2.4 (R3)
unnamed: D20.1 (K), RN3.4 (R3)
unnamed: D21.1 (K), RN2.3 (R2)
unnamed: D22.1 (K), RN3.3 (R2)
unnamed: D23.1 (K), RN2.2 (R1)
unnamed: D24.1 (K), RN3.2 (R1)
unnamed: U2.9 (QH'), U4.14 (SER)
unnamed: U2.14 (SER), U3.9 (QH')
PB0: J8.13, U1.14 (PB0)
PB1: J8.12, U1.15 (PB1)
PB2: J8.11, U1.16 (PB2)
PB3: J8.10, U1.17 (PB3)
PB4: J8.9, U1.18 (PB4)
PB5: J8.8, U1.19 (PB5)
PC0: J8.7, U1.23 (PC0)
PC1: J8.6, U1.24 (PC1)
PC2: J8.5, U1.25 (PC2)
PC3: J8.4, U1.26 (PC3)
PC4: J8.3, U1.27 (PC4)
PC5: J8.2, U1.28 (PC5)
RESET: J6.3, R1.2, SW1.2, U1.1 (~RESET~/PC6)
RX: J6.1, U1.2 (PD0)
SH_CLK: U1.5 (PD3), U2.11 (SRCLK), U3.11 (SRCLK), U4.11 (SRCLK)
SH_DATA: U1.4 (PD2), U3.14 (SER)
SH_LATCH: U1.6 (PD4), U2.12 (RCLK), U3.12 (RCLK), U4.12 (RCLK)
SH_OE: U1.11 (PD5), U2.13 (~OE), U3.13 (~OE), U4.13 (~OE)
TX: J6.2, U1.3 (PD1)
VCC: C1.1, C2.1, C3.1, C4.1, J3.2, J4.2, R1.1, U1.7 (VCC), U1.20 (AVCC), U2.10 (~SRCLR), U2.16 (VCC), U3.10 (~SRCLR), U3.16 (VCC), U4.10 (~SRCLR), U4.16 (VCC)
WRITE_ENABLE: J2.2, U1.12 (PD6)

Notes on the sheet:
POWER
Decoupling Capacitors
C[2..4] - 0.1μF Ceramic
C1 - 100nF Polarized
CONNECTIONS
Address out
RAM Data out
Connect ACTIVE to HALT on Computer Clock
Program ATMEGA
RAM Control
Unused Atmega Pins
