theWickedWebDev/8-bit-computer/PCB-Modules/99_IN PROGRESS/EEPROM-TO-RAM/RAM-control/RAM-control.sch

## KiCad design PCB-Modules/99_IN PROGRESS/EEPROM-TO-RAM/RAM-control/RAM-control.sch (2021-11-19)

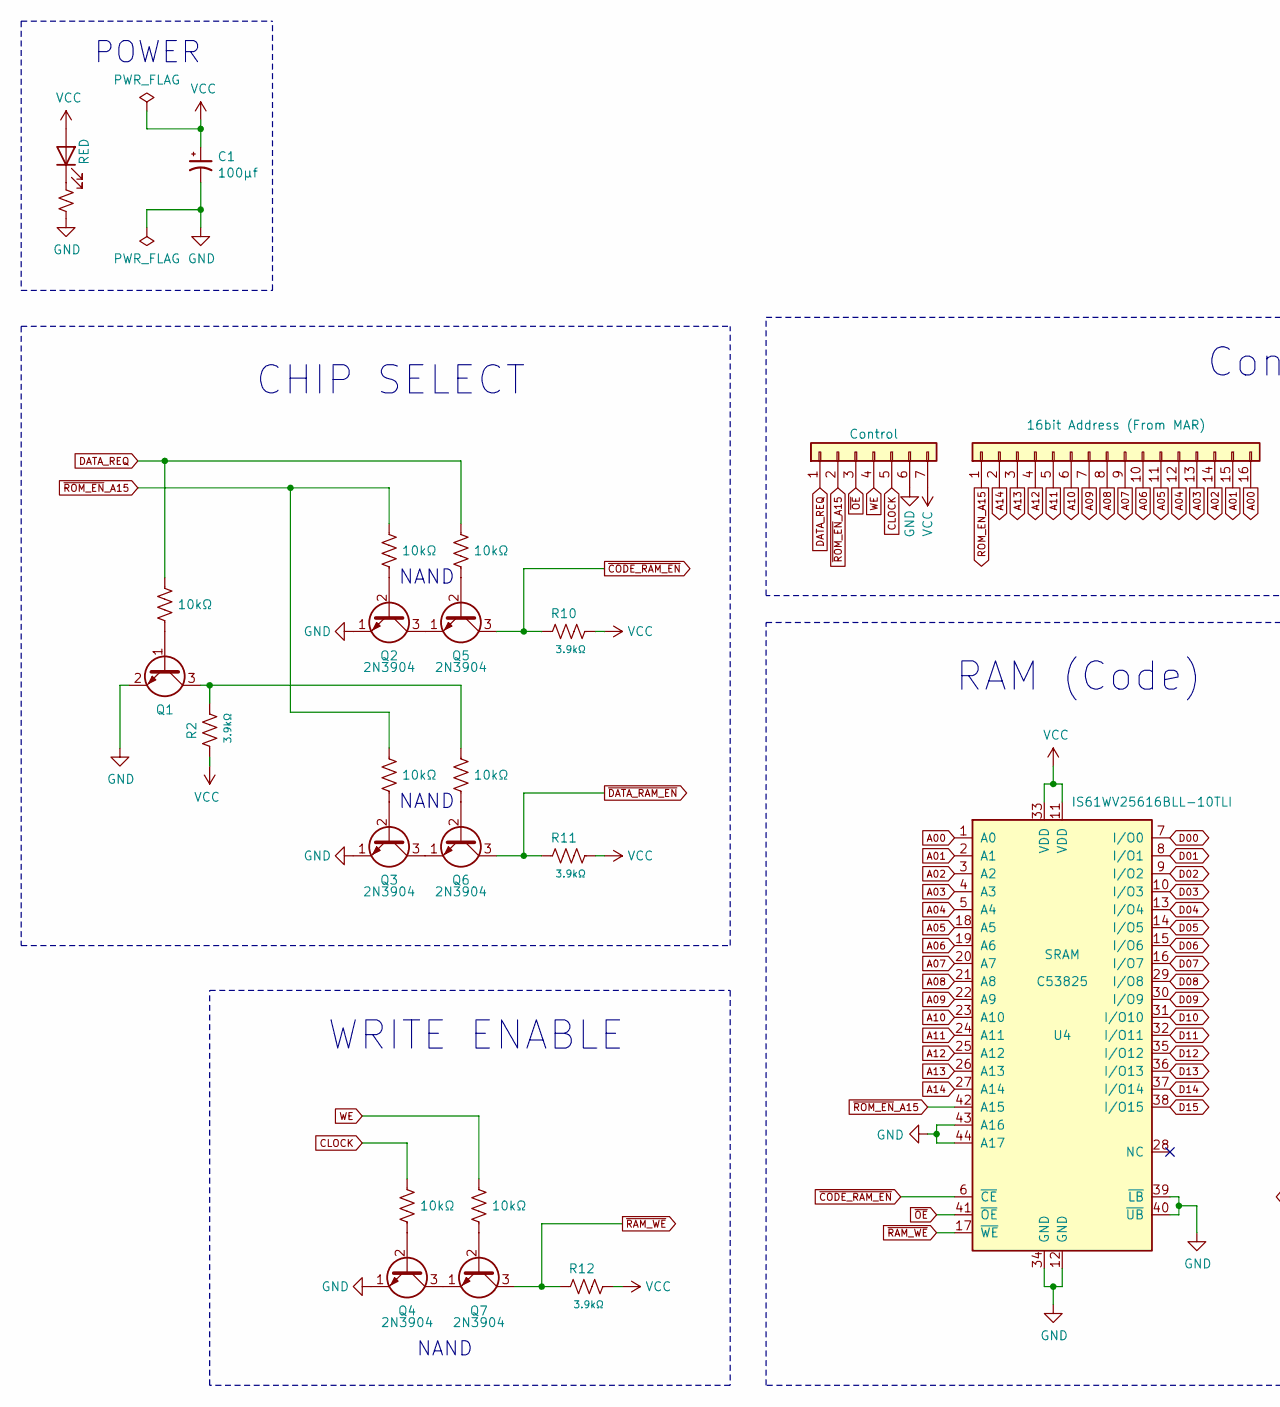
[picture p359: schematic RAM-control.sch, part in row 1, column 1]

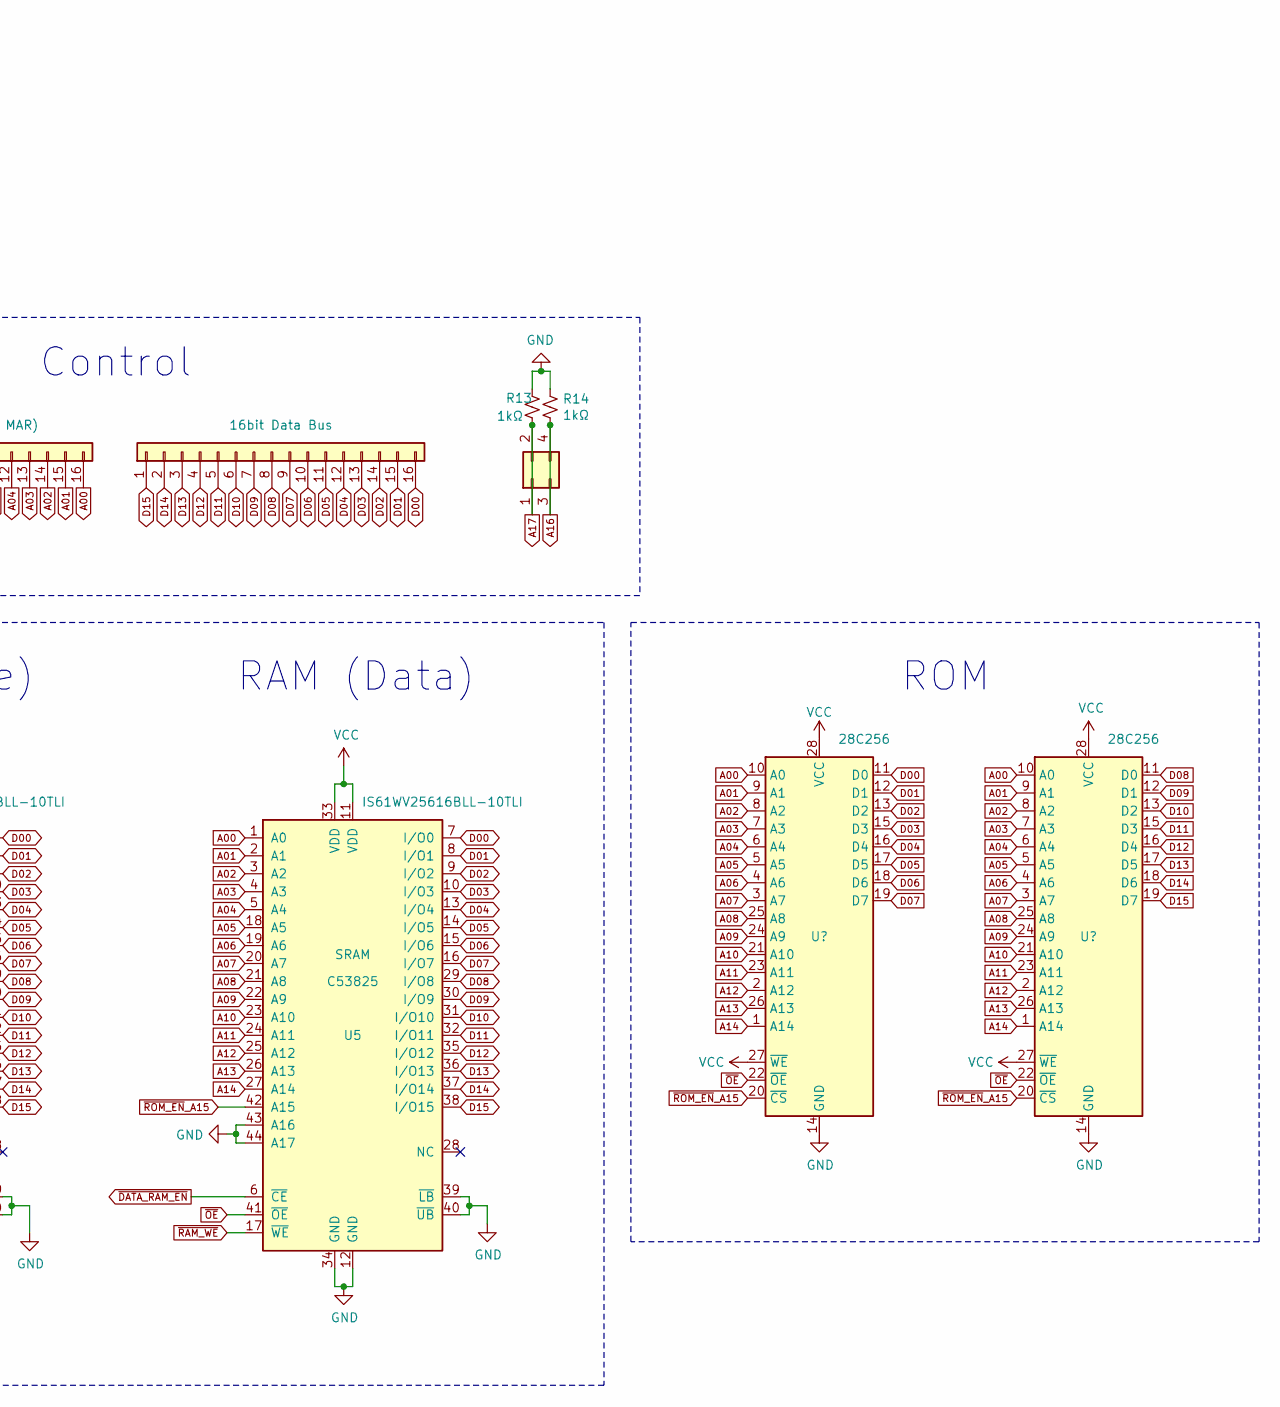
[picture p360: schematic RAM-control.sch, part in row 1, column 2]

Parts:
C1: SMD-ECAP-5x5.8; CP_Elec_5x5.8; JLCPCB C140924
D1: NCD0805R1; LED_0805_2012Metric; JLCPCB C84256
J1: Conn_01x07; PinHeader_1x07_P2.54mm_Vertical
J2, J3: Conn_01x16; PinHeader_1x16_P2.54mm_Vertical
J4: Conn_02x02; PinHeader_2x02_P2.54mm_Vertical
Q1: DDTD123YC-7-F; SOT-23
Q2, Q3, Q4, Q5, Q6, Q7: 2N3904S-RTK_PS; SOT-23
R1: 0402WGF1001TCE; R_0402_1005Metric; JLCPCB C11702
R2, R10, R11, R12: 0402WGF3901TCE; R_0402_1005Metric
R3, R4, R5, R6, R7, R8, R9: 0603WAF1002T5E; R_0402_1005Metric
R13, R14: 0402WGF1001TCE; R_0402_1005Metric
U4, U5: IS61WV25616BLL-10TLI; TSOP-II-44_10.16x18.41mm_P0.8mm

Connections:
A00: J2.16, U4.1 (A0), U5.1 (A0)
A01: J2.15, U4.2 (A1), U5.2 (A1)
A02: J2.14, U4.3 (A2), U5.3 (A2)
A03: J2.13, U4.4 (A3), U5.4 (A3)
A04: J2.12, U4.5 (A4), U5.5 (A4)
A05: J2.11, U4.18 (A5), U5.18 (A5)
A06: J2.10, U4.19 (A6), U5.19 (A6)
A07: J2.9, U4.20 (A7), U5.20 (A7)
A08: J2.8, U4.21 (A8), U5.21 (A8)
A09: J2.7, U4.22 (A9), U5.22 (A9)
A10: J2.6, U4.23 (A10), U5.23 (A10)
A11: J2.5, U4.24 (A11), U5.24 (A11)
A12: J2.4, U4.25 (A12), U5.25 (A12)
A13: J2.3, U4.26 (A13), U5.26 (A13)
A14: J2.2, U4.27 (A14), U5.27 (A14)
A16: J4.3, J4.4, R14.2
A17: J4.1, J4.2, R13.2
CLOCK: J1.5, R6.1
D00: J3.16, U4.7 (I/O0), U5.7 (I/O0)
D01: J3.15, U4.8 (I/O1), U5.8 (I/O1)
D02: J3.14, U4.9 (I/O2), U5.9 (I/O2)
D03: J3.13, U4.10 (I/O3), U5.10 (I/O3)
D04: J3.12, U4.13 (I/O4), U5.13 (I/O4)
D05: J3.11, U4.14 (I/O5), U5.14 (I/O5)
D06: J3.10, U4.15 (I/O6), U5.15 (I/O6)
D07: J3.9, U4.16 (I/O7), U5.16 (I/O7)
D08: J3.8, U4.29 (I/O8), U5.29 (I/O8)
D09: J3.7, U4.30 (I/O9), U5.30 (I/O9)
D10: J3.6, U4.31 (I/O10), U5.31 (I/O10)
D11: J3.5, U4.32 (I/O11), U5.32 (I/O11)
D12: J3.4, U4.35 (I/O12), U5.35 (I/O12)
D13: J3.3, U4.36 (I/O13), U5.36 (I/O13)
D14: J3.2, U4.37 (I/O14), U5.37 (I/O14)
D15: J3.1, U4.38 (I/O15), U5.38 (I/O15)
DATA_REQ: J1.1, R4.1, R7.1
GND: C1.2, J1.6, Q1.2 (E), Q2.1 (E), Q3.1 (E), Q4.1 (E), R1.2, R13.1, R14.1, U4.12 (GND), U4.34 (GND), U4.39 (~LB), U4.40 (~UB), U4.43 (A16), U4.44 (A17), U5.12 (GND), U5.34 (GND), U5.39 (~LB), U5.40 (~UB), U5.43 (A16), U5.44 (A17)
unnamed: D1.1 (K), R1.1
unnamed: Q1.1 (B), R4.2
unnamed: Q1.3 (C), R2.2, R8.1
unnamed: Q2.2 (B), R3.2
unnamed: Q2.3 (C), Q5.1 (E)
unnamed: Q3.2 (B), R5.2
unnamed: Q3.3 (C), Q6.1 (E)
unnamed: Q4.2 (B), R6.2
unnamed: Q4.3 (C), Q7.1 (E)
unnamed: Q5.2 (B), R7.2
unnamed: Q6.2 (B), R8.2
unnamed: Q7.2 (B), R9.2
ROM_EN_A15: J2.1
VCC: C1.1, D1.2 (A), J1.7, R2.1, R10.2, R11.2, R12.2, U4.11 (VDD), U4.33 (VDD), U5.11 (VDD), U5.33 (VDD)
WE: J1.4, R9.1
~CODE_RAM_EN: Q5.3 (C), R10.1, U4.6 (~CE)
~DATA_RAM_EN: Q6.3 (C), R11.1, U5.6 (~CE)
~OE: J1.3, U4.41 (~OE), U5.41 (~OE)
~RAM_WE: Q7.3 (C), R12.1, U4.17 (~WE), U5.17 (~WE)
~ROM_EN~_A15: J1.2, R3.1, R5.1, U4.42 (A15), U5.42 (A15)

Notes on the sheet:
POWER
RAM (Code)
ROM
RAM (Data)
WRITE ENABLE
NAND
CHIP SELECT
Control
