theWickedWebDev/8-bit-computer/PCB-Modules/99_IN PROGRESS/IO/ring-buffer-alt/address_counter.sch

## KiCad design PCB-Modules/99_IN PROGRESS/IO/ring-buffer-alt/address_counter.sch (2021-11-28)

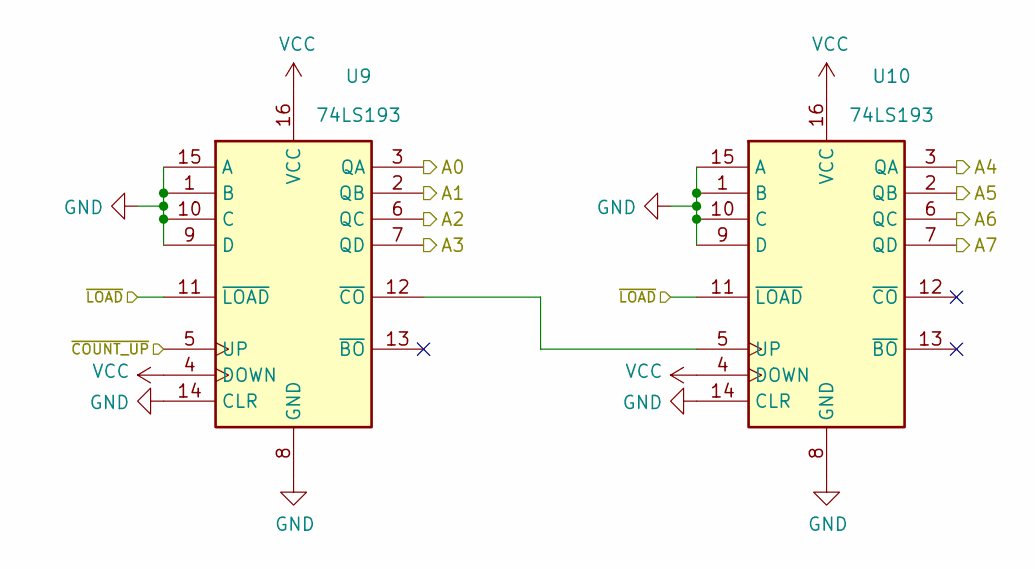
[picture p361: schematic address_counter.sch]

Parts:
U7, U8: 74LS193; SO-16_5.3x10.2mm_P1.27mm

Connections:
A0: U7.3 (QA)
A1: U7.2 (QB)
A2: U7.6 (QC)
A3: U7.7 (QD)
A4: U8.3 (QA)
A5: U8.2 (QB)
A6: U8.6 (QC)
A7: U8.7 (QD)
GND: U7.1 (B), U7.8 (GND), U7.9 (D), U7.10 (C), U7.14 (CLR), U7.15 (A), U8.1 (B), U8.8 (GND), U8.9 (D), U8.10 (C), U8.14 (CLR), U8.15 (A)
unnamed: U7.12 (~CO), U8.5 (UP)
VCC: U7.4 (DOWN), U7.16 (VCC), U8.4 (DOWN), U8.16 (VCC)
~COUNT_UP: U7.5 (UP)
~LOAD: U7.11 (~LOAD), U8.11 (~LOAD)
