theWickedWebDev/8-bit-computer/PCB-Modules/99_IN PROGRESS/IO/ring-buffer-alt/address_mux.sch

## KiCad design PCB-Modules/99_IN PROGRESS/IO/ring-buffer-alt/address_mux.sch (2021-11-28)

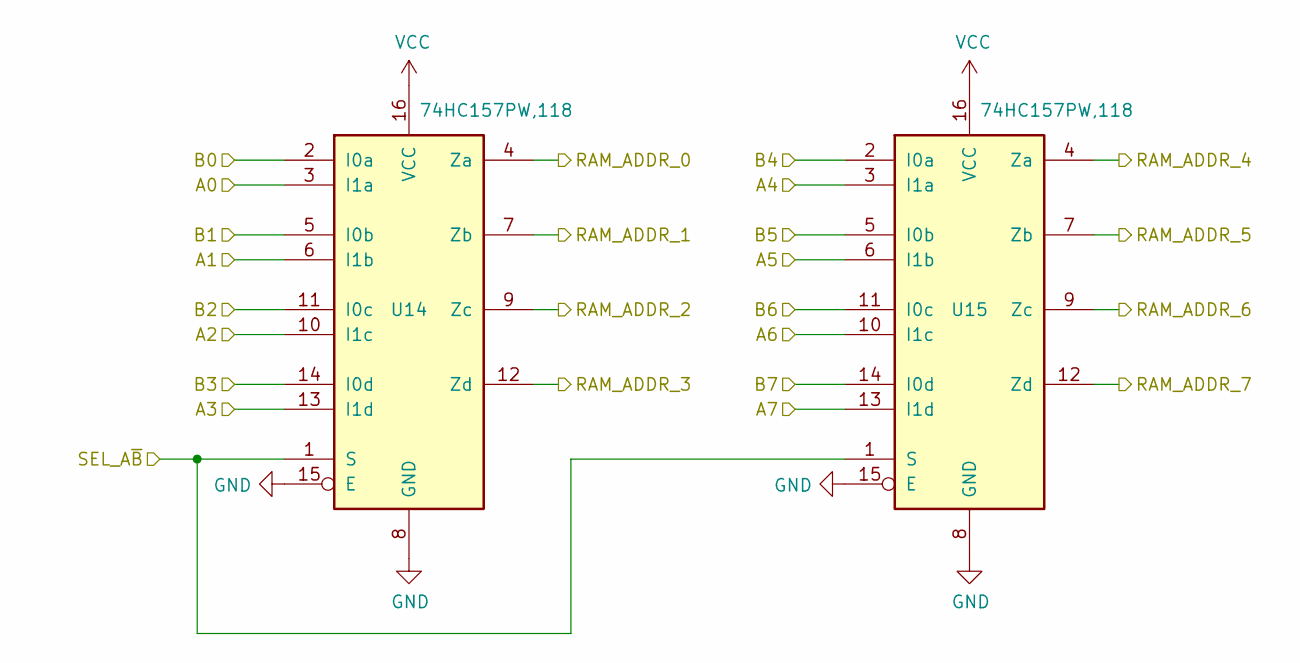
[picture p362: schematic address_mux.sch]

Parts:
U14, U15: 74HC157PW,118; TSSOP-16_4.4x5mm_P0.65mm

Connections:
A0: U14.3 (I1a)
A1: U14.6 (I1b)
A2: U14.10 (I1c)
A3: U14.13 (I1d)
A4: U15.3 (I1a)
A5: U15.6 (I1b)
A6: U15.10 (I1c)
A7: U15.13 (I1d)
B0: U14.2 (I0a)
B1: U14.5 (I0b)
B2: U14.11 (I0c)
B3: U14.14 (I0d)
B4: U15.2 (I0a)
B5: U15.5 (I0b)
B6: U15.11 (I0c)
B7: U15.14 (I0d)
GND: U14.8 (GND), U14.15 (E), U15.8 (GND), U15.15 (E)
RAM_ADDR_0: U14.4 (Za)
RAM_ADDR_1: U14.7 (Zb)
RAM_ADDR_2: U14.9 (Zc)
RAM_ADDR_3: U14.12 (Zd)
RAM_ADDR_4: U15.4 (Za)
RAM_ADDR_5: U15.7 (Zb)
RAM_ADDR_6: U15.9 (Zc)
RAM_ADDR_7: U15.12 (Zd)
SEL_A~B~: U14.1 (S), U15.1 (S)
VCC: U14.16 (VCC), U15.16 (VCC)
