theWickedWebDev/8-bit-computer/PCB-Modules/99_IN PROGRESS/IO/ring-buffer-alt/address_subtractor.sch

## KiCad design PCB-Modules/99_IN PROGRESS/IO/ring-buffer-alt/address_subtractor.sch (2021-11-28)

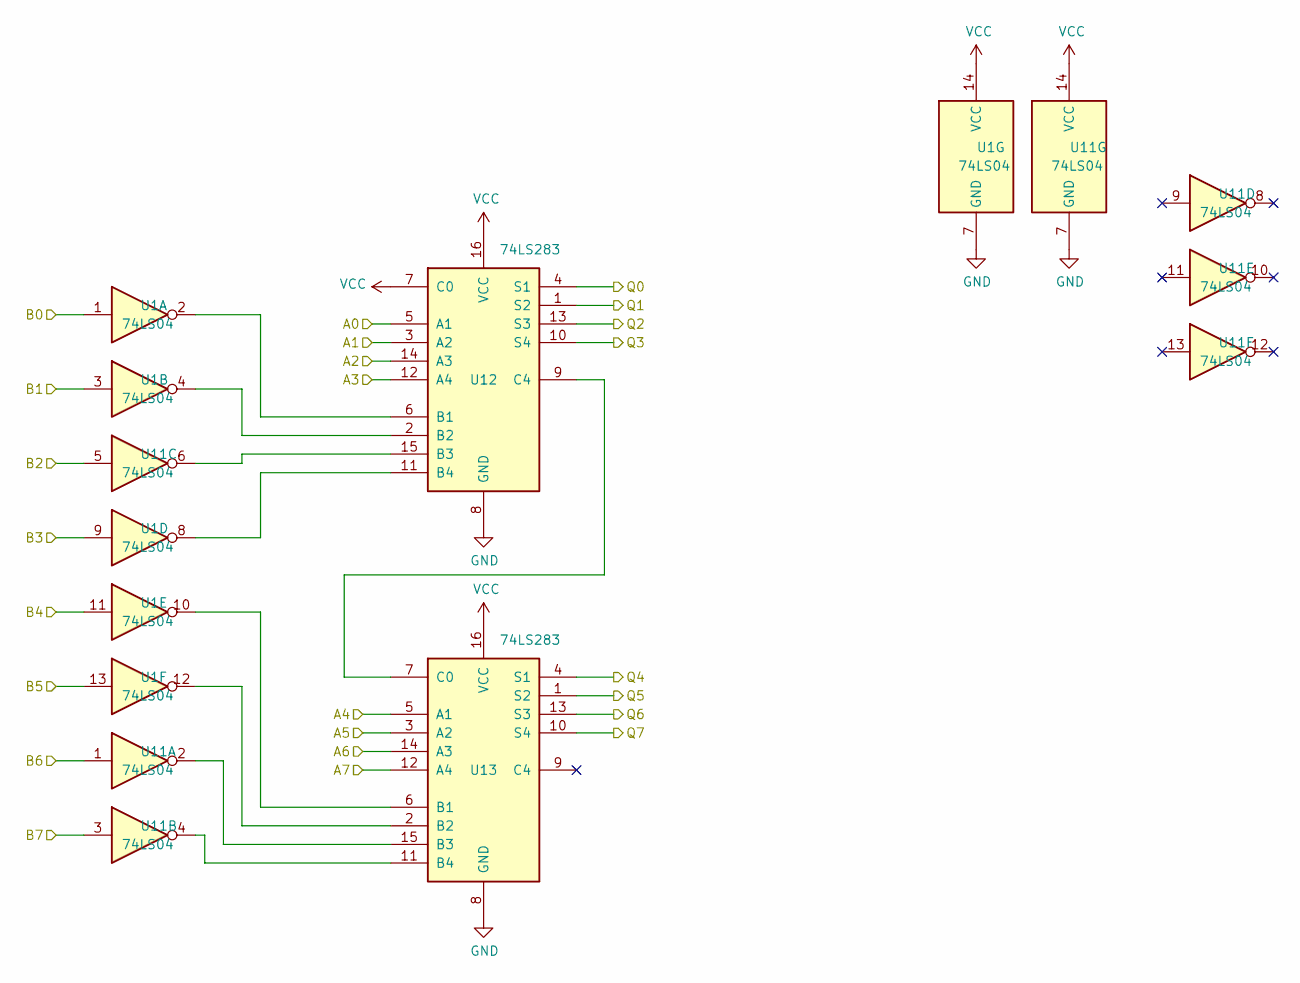
[picture p363: schematic address_subtractor.sch]

Parts:
U1, U11: 74LS04; TSSOP-14_4.4x5mm_P0.65mm
U12, U13: 74LS283; SOIC-16_4.55x10.3mm_P1.27mm

Connections:
A0: U12.5 (A1)
A1: U12.3 (A2)
A2: U12.14 (A3)
A3: U12.12 (A4)
A4: U13.5 (A1)
A5: U13.3 (A2)
A6: U13.14 (A3)
A7: U13.12 (A4)
B0: U1.1
B1: U1.3
B2: U11.5
B3: U1.9
B4: U1.11
B5: U1.13
B6: U11.1
B7: U11.3
GND: U1.7 (GND), U11.7 (GND), U12.8 (GND), U13.8 (GND)
unnamed: U1.2, U12.6 (B1)
unnamed: U1.4, U12.2 (B2)
unnamed: U1.8, U12.11 (B4)
unnamed: U1.10, U13.6 (B1)
unnamed: U1.12, U13.2 (B2)
unnamed: U11.2, U13.15 (B3)
unnamed: U11.4, U13.11 (B4)
unnamed: U11.6, U12.15 (B3)
unnamed: U12.9 (C4), U13.7 (C0)
Q0: U12.4 (S1)
Q1: U12.1 (S2)
Q2: U12.13 (S3)
Q3: U12.10 (S4)
Q4: U13.4 (S1)
Q5: U13.1 (S2)
Q6: U13.13 (S3)
Q7: U13.10 (S4)
VCC: U1.14 (VCC), U11.14 (VCC), U12.7 (C0), U12.16 (VCC), U13.16 (VCC)
