theWickedWebDev/8-bit-computer/PCB-Modules/99_IN PROGRESS/IO/ring-buffer-alt/ring-buffer-alt.sch

## KiCad design PCB-Modules/99_IN PROGRESS/IO/ring-buffer-alt/ring-buffer-alt.sch (2021-11-28)

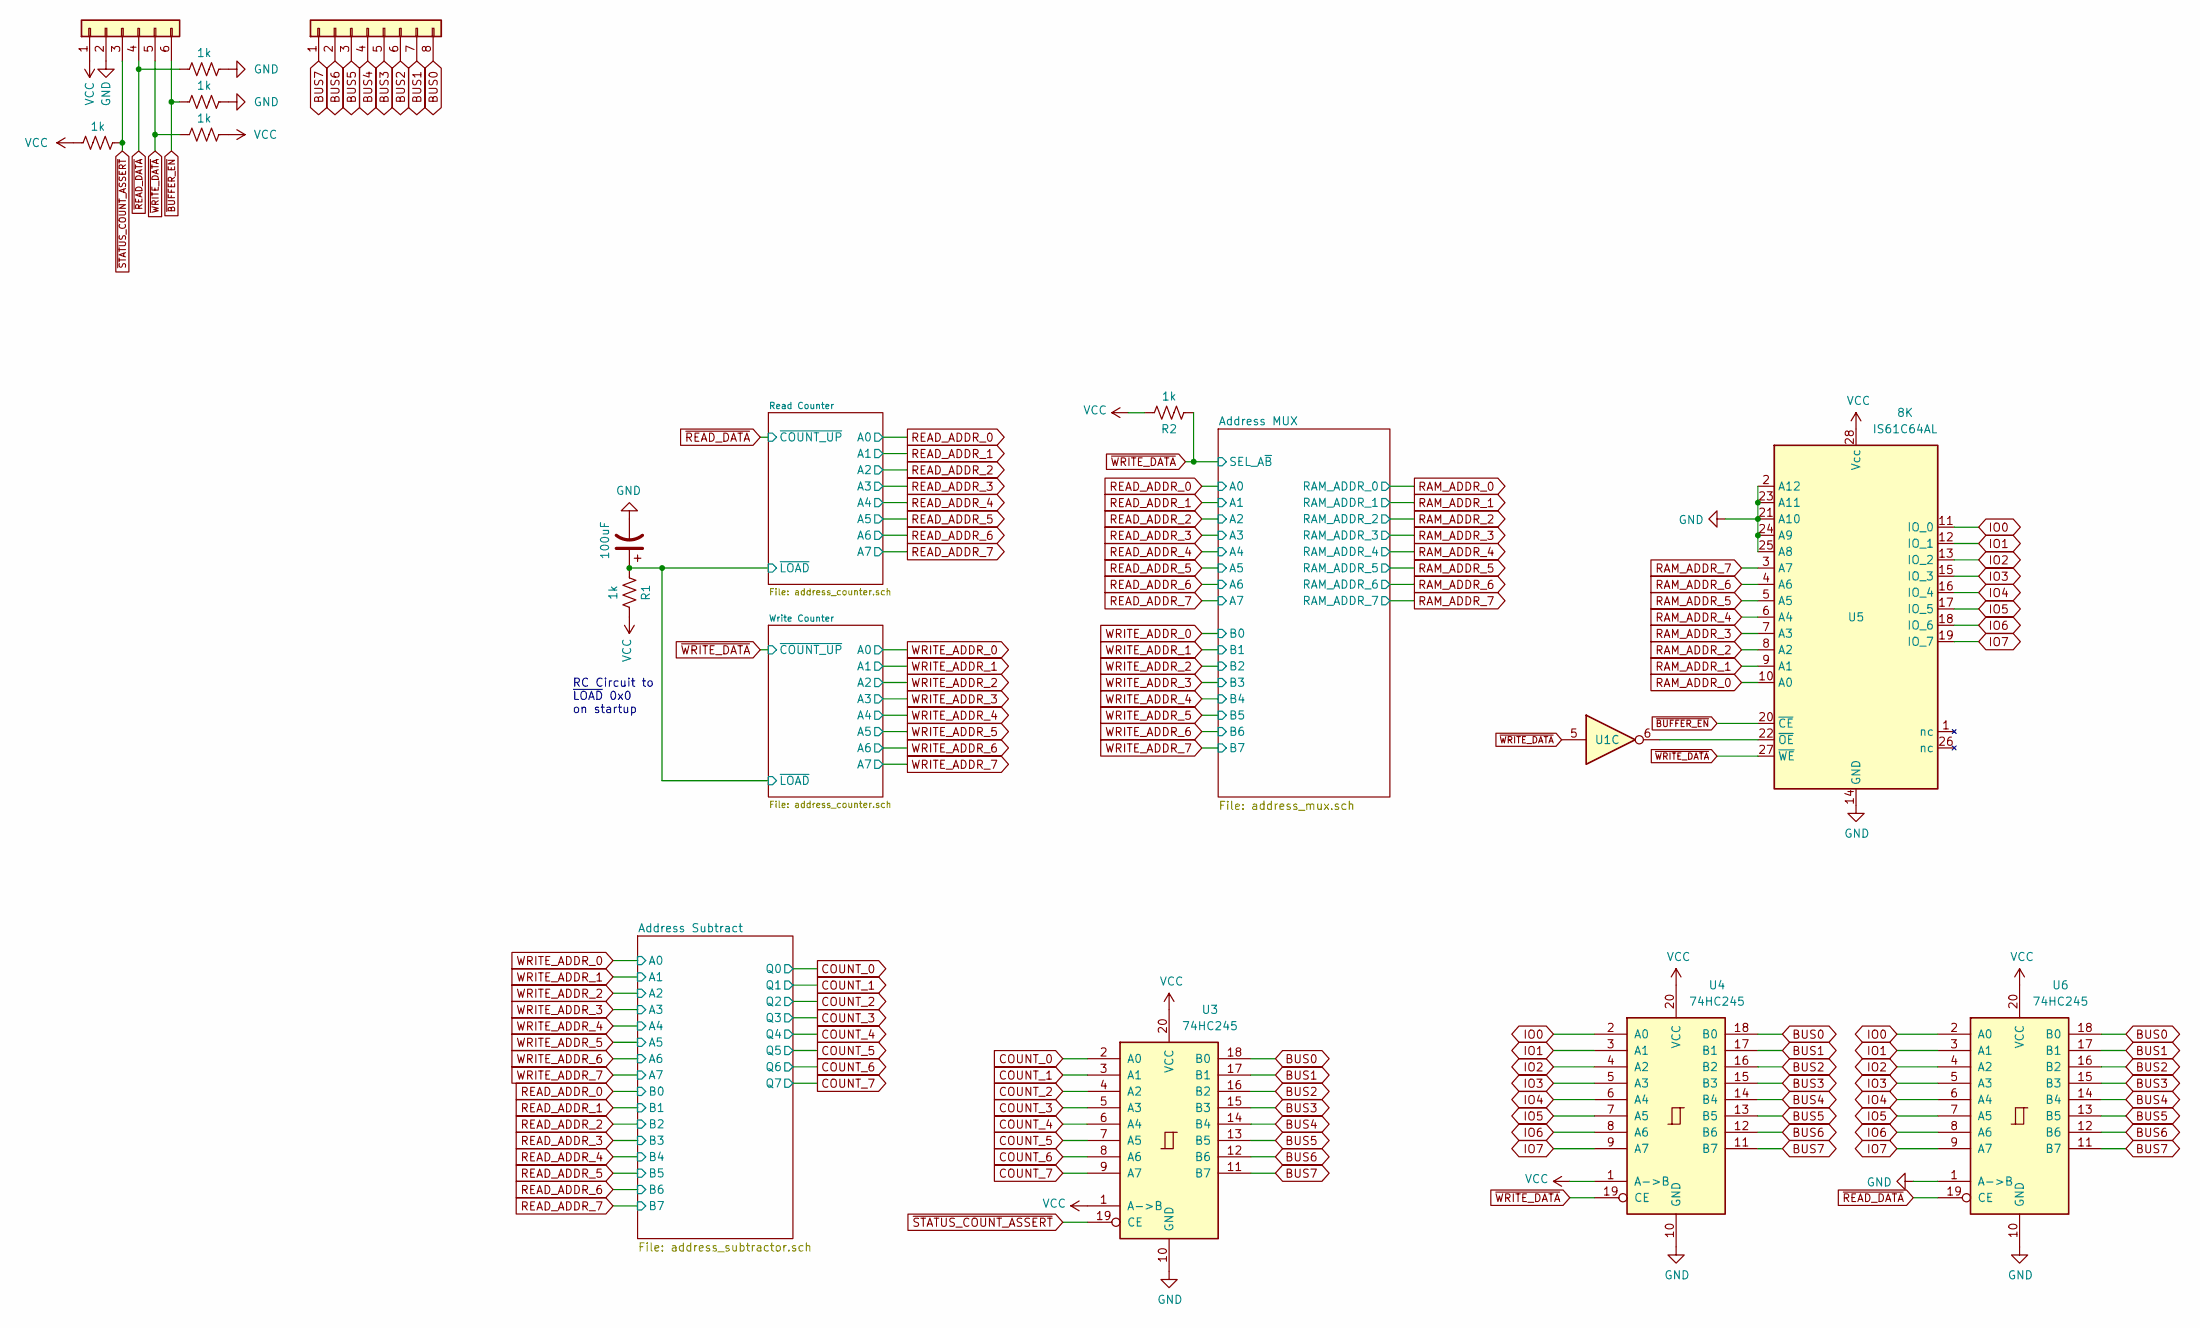
[picture p364: schematic ring-buffer-alt.sch]

Parts:
C1: C; CP_Elec_6.3x5.9
J1: Conn_01x06; PinHeader_1x06_P2.54mm_Vertical
J2: Conn_01x08; PinHeader_1x08_P2.54mm_Vertical
R1, R2, R3, R4, R5, R6: R_US; R_0805_2012Metric
U1: 74LS04; TSSOP-14_4.4x5mm_P0.65mm
U3, U4, U6: 74HC245; TSSOP-20_4.4x6.5mm_P0.65mm
U5: IS61C64AL; SOIC-28W_7.5x17.9mm_P1.27mm

Connections:
BUS0: J2.8, U3.18 (B0), U4.18 (B0), U6.18 (B0)
BUS1: J2.7, U3.17 (B1), U4.17 (B1), U6.17 (B1)
BUS2: J2.6, U3.16 (B2), U4.16 (B2), U6.16 (B2)
BUS3: J2.5, U3.15 (B3), U4.15 (B3), U6.15 (B3)
BUS4: J2.4, U3.14 (B4), U4.14 (B4), U6.14 (B4)
BUS5: J2.3, U3.13 (B5), U4.13 (B5), U6.13 (B5)
BUS6: J2.2, U3.12 (B6), U4.12 (B6), U6.12 (B6)
BUS7: J2.1, U3.11 (B7), U4.11 (B7), U6.11 (B7)
COUNT_0: U3.2 (A0)
COUNT_1: U3.3 (A1)
COUNT_2: U3.4 (A2)
COUNT_3: U3.5 (A3)
COUNT_4: U3.6 (A4)
COUNT_5: U3.7 (A5)
COUNT_6: U3.8 (A6)
COUNT_7: U3.9 (A7)
GND: C1.2, J1.2, R3.2, R5.2, U3.10 (GND), U4.10 (GND), U5.2 (A12), U5.14 (GND), U5.21 (A10), U5.23 (A11), U5.24 (A9), U5.25 (A8), U6.1 (A->B), U6.10 (GND)
IO0: U4.2 (A0), U5.11 (IO_0), U6.2 (A0)
IO1: U4.3 (A1), U5.12 (IO_1), U6.3 (A1)
IO2: U4.4 (A2), U5.13 (IO_2), U6.4 (A2)
IO3: U4.5 (A3), U5.15 (IO_3), U6.5 (A3)
IO4: U4.6 (A4), U5.16 (IO_4), U6.6 (A4)
IO5: U4.7 (A5), U5.17 (IO_5), U6.7 (A5)
IO6: U4.8 (A6), U5.18 (IO_6), U6.8 (A6)
IO7: U4.9 (A7), U5.19 (IO_7), U6.9 (A7)
unnamed: U1.6, U5.22 (~OE)
RAM_ADDR_0: U5.10 (A0)
RAM_ADDR_1: U5.9 (A1)
RAM_ADDR_2: U5.8 (A2)
RAM_ADDR_3: U5.7 (A3)
RAM_ADDR_4: U5.6 (A4)
RAM_ADDR_5: U5.5 (A5)
RAM_ADDR_6: U5.4 (A6)
RAM_ADDR_7: U5.3 (A7)
VCC: J1.1, R1.1, R2.1, R4.2, R6.1, U3.1 (A->B), U3.20 (VCC), U4.1 (A->B), U4.20 (VCC), U5.28 (Vcc), U6.20 (VCC)
~BUFFER_EN: J1.6, R3.1, U5.20 (~CE)
~LOAD: C1.1, R1.2
~READ_DATA: J1.4, R5.1, U6.19 (CE)
~STATUS_COUNT_ASSERT: J1.3, R6.2, U3.19 (CE)
~WRITE_DATA: J1.5, R2.2, R4.1, U1.5, U4.19 (CE), U5.27 (~WE)

Notes on the sheet:
RC Circuit to ~LOAD 0x0 on startup
