theWickedWebDev/8-bit-computer/PCB-Modules/99_IN PROGRESS/IO/ring-buffer/FIFO-ram-buffer.sch

## KiCad design PCB-Modules/99_IN PROGRESS/IO/ring-buffer/FIFO-ram-buffer.sch (2021-11-28)

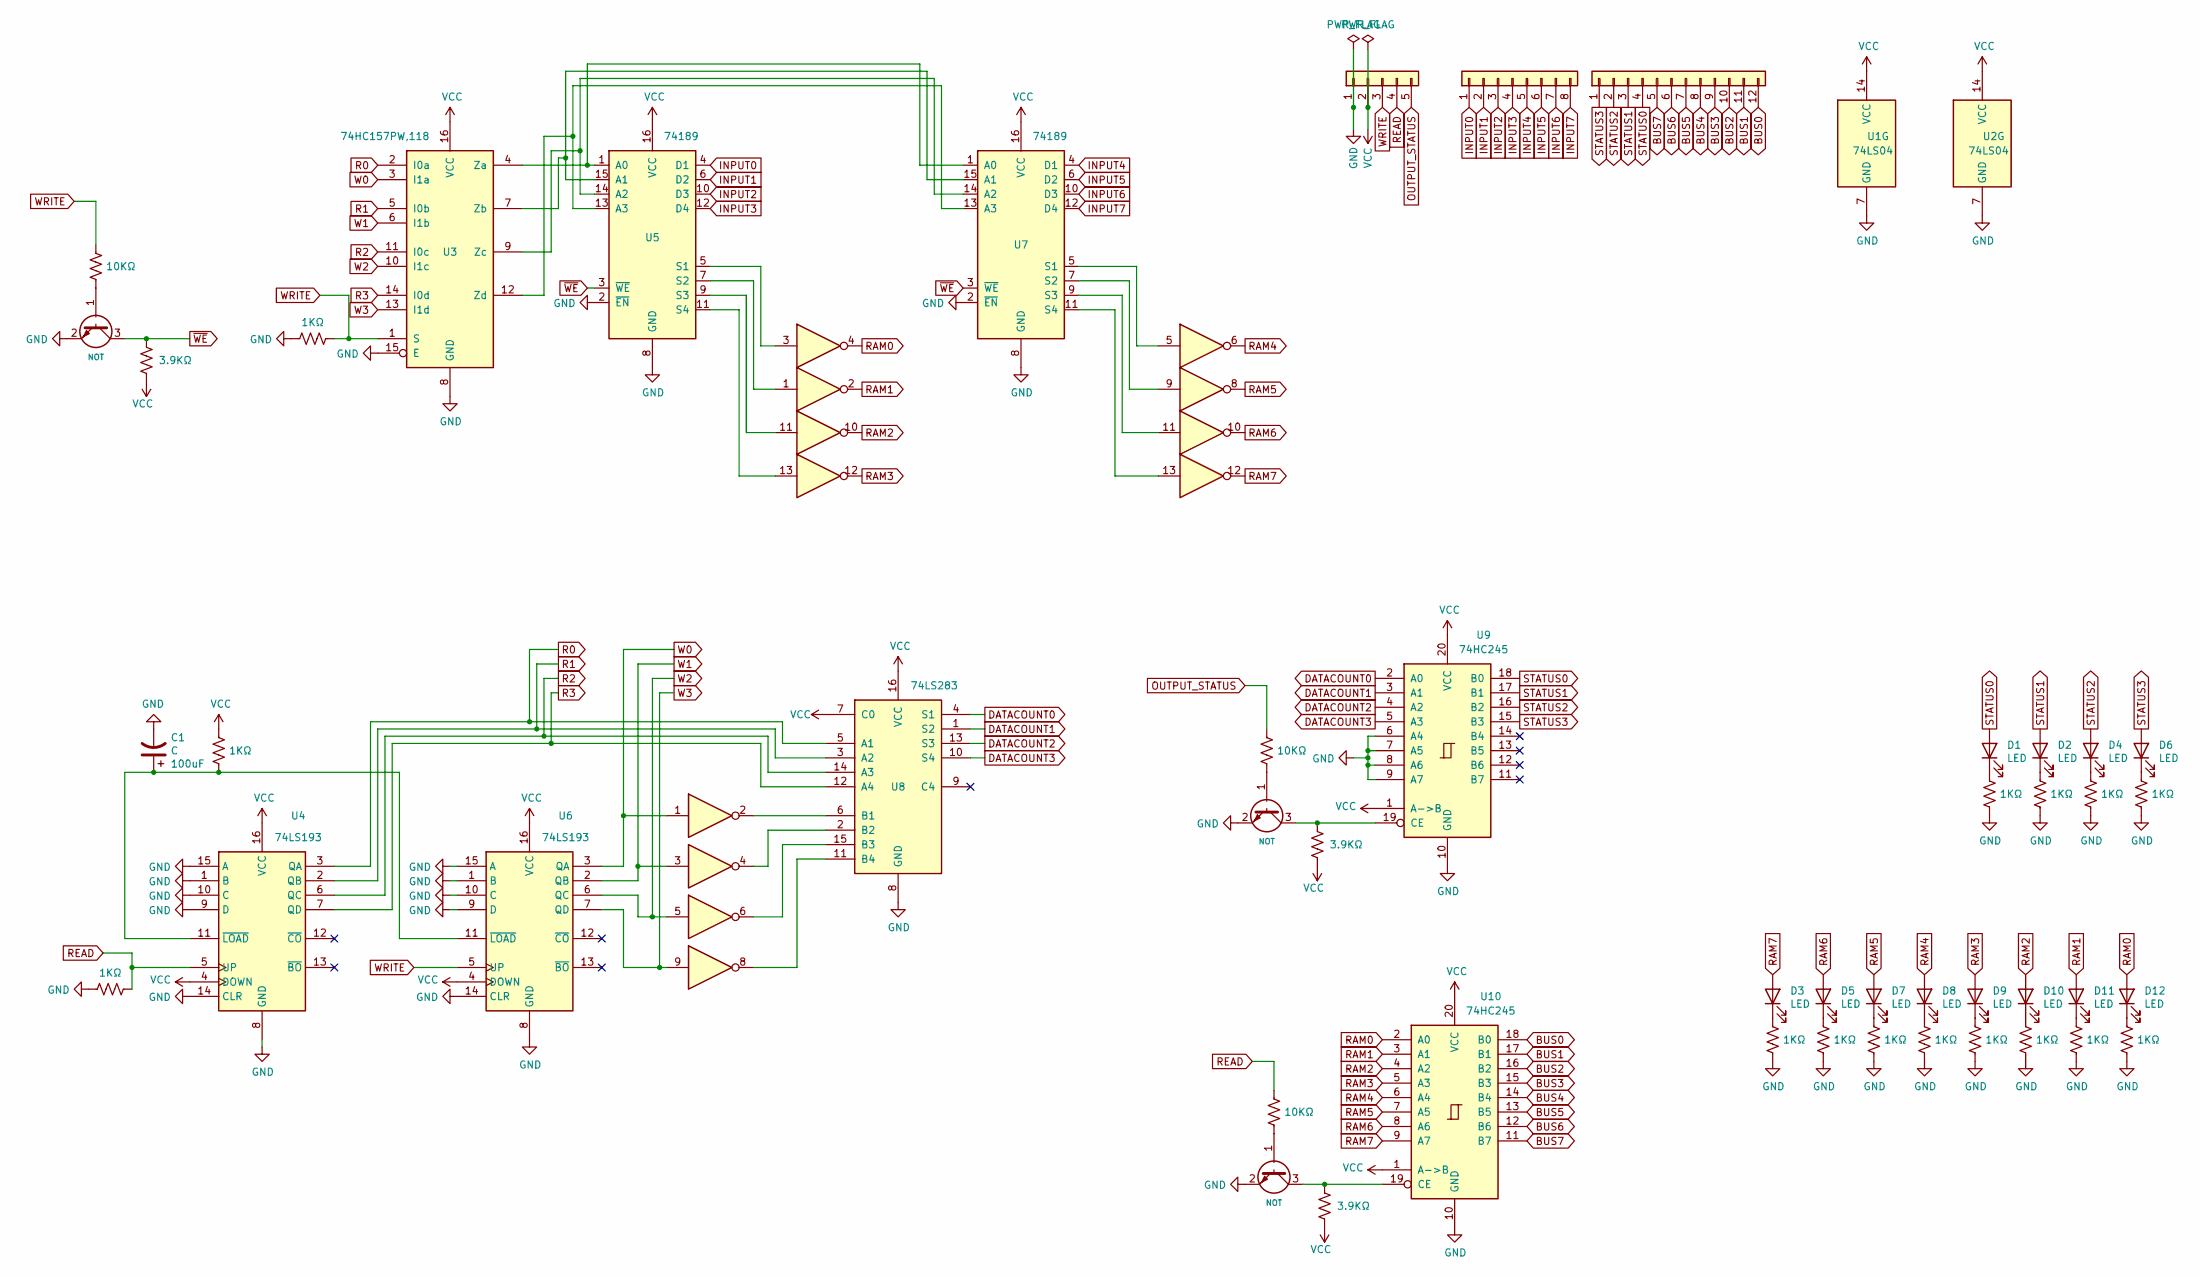
[picture p365: schematic FIFO-ram-buffer.sch]

Parts:
C1: C; CP_Elec_8x10
D1, D2, D3, D4, D5, D6, D7, D8, D9, D10, D11, D12: LED; LED_1206_3216Metric
J1: Conn_01x05; PinHeader_1x05_P2.54mm_Vertical
J2: Conn_01x08; PinHeader_1x08_P2.54mm_Vertical
J3: Conn_01x12; PinHeader_1x12_P2.54mm_Vertical
Q1, Q2, Q3: PMBT2222; SOT-23
R1, R6, R7: 10kohm; R_0805_2012Metric
R2, R8, R9: 3.9kohm; R_0805_2012Metric
R3, R4, R5, R10, R11, R12, R13, R14, R15, R16, R17, R18, R19, R20, R21: 1kohm; R_0805_2012Metric
U1, U2: 74LS04; TSSOP-14_4.4x5mm_P0.65mm
U3: 74HC157PW,118; TSSOP-16_4.4x5mm_P0.65mm
U4, U6: 74LS193; SO-16_5.3x10.2mm_P1.27mm
U5, U7: 74189; DIP-16_W7.62mm
U8: 74LS283; SOIC-16_4.55x10.3mm_P1.27mm
U9, U10: 74HC245; TSSOP-20_4.4x6.5mm_P0.65mm

Connections:
BUS0: J3.12, U10.18 (B0)
BUS1: J3.11, U10.17 (B1)
BUS2: J3.10, U10.16 (B2)
BUS3: J3.9, U10.15 (B3)
BUS4: J3.8, U10.14 (B4)
BUS5: J3.7, U10.13 (B5)
BUS6: J3.6, U10.12 (B6)
BUS7: J3.5, U10.11 (B7)
DATACOUNT0: U8.4 (S1), U9.2 (A0)
DATACOUNT1: U8.1 (S2), U9.3 (A1)
DATACOUNT2: U8.13 (S3), U9.4 (A2)
DATACOUNT3: U8.10 (S4), U9.5 (A3)
GND: C1.2, J1.1, Q1.2 (C), Q2.2 (C), Q3.2 (C), R3.2, R4.2, R10.2, R11.2, R12.2, R13.2, R14.2, R15.2, R16.2, R17.2, R18.2, R19.2, R20.2, R21.2, U1.7 (GND), U2.7 (GND), U3.8 (GND), U3.15 (E), U4.1 (B), U4.8 (GND), U4.9 (D), U4.10 (C), U4.14 (CLR), U4.15 (A), U5.2 (~EN), U5.8 (GND), U6.1 (B), U6.8 (GND), U6.9 (D), U6.10 (C), U6.14 (CLR), U6.15 (A), U7.2 (~EN), U7.8 (GND), U8.8 (GND), U9.6 (A4), U9.7 (A5), U9.8 (A6), U9.9 (A7), U9.10 (GND), U10.10 (GND)
INPUT0: J2.1, U5.4 (D1)
INPUT1: J2.2, U5.6 (D2)
INPUT2: J2.3, U5.10 (D3)
INPUT3: J2.4, U5.12 (D4)
INPUT4: J2.5, U7.4 (D1)
INPUT5: J2.6, U7.6 (D2)
INPUT6: J2.7, U7.10 (D3)
INPUT7: J2.8, U7.12 (D4)
unnamed: C1.1, R5.2, U4.11 (~LOAD), U6.11 (~LOAD)
unnamed: D1.1 (K), R10.1
unnamed: D2.1 (K), R11.1
unnamed: D3.1 (K), R12.1
unnamed: D4.1 (K), R13.1
unnamed: D5.1 (K), R14.1
unnamed: D6.1 (K), R15.1
unnamed: D7.1 (K), R16.1
unnamed: D8.1 (K), R17.1
unnamed: D9.1 (K), R18.1
unnamed: D10.1 (K), R19.1
unnamed: D11.1 (K), R20.1
unnamed: D12.1 (K), R21.1
unnamed: Q1.1 (B), R1.2
unnamed: Q2.1 (B), R6.2
unnamed: Q2.3 (E), R8.1, U9.19 (CE)
unnamed: Q3.1 (B), R7.2
unnamed: Q3.3 (E), R9.1, U10.19 (CE)
unnamed: U1.1, U5.7 (S2)
unnamed: U1.3, U5.5 (S1)
unnamed: U1.6, U8.15 (B3)
unnamed: U1.8, U8.11 (B4)
unnamed: U1.11, U5.9 (S3)
unnamed: U1.13, U5.11 (S4)
unnamed: U2.2, U8.6 (B1)
unnamed: U2.4, U8.2 (B2)
unnamed: U2.5, U7.5 (S1)
unnamed: U2.9, U7.7 (S2)
unnamed: U2.11, U7.9 (S3)
unnamed: U2.13, U7.11 (S4)
unnamed: U3.4 (Za), U5.1 (A0), U7.1 (A0)
unnamed: U3.7 (Zb), U5.15 (A1), U7.15 (A1)
unnamed: U3.9 (Zc), U5.14 (A2), U7.14 (A2)
unnamed: U3.12 (Zd), U5.13 (A3), U7.13 (A3)
OUTPUT_STATUS: J1.5, R6.1
R0: U3.2 (I0a), U4.3 (QA), U8.5 (A1)
R1: U3.5 (I0b), U4.2 (QB), U8.3 (A2)
R2: U3.11 (I0c), U4.6 (QC), U8.14 (A3)
R3: U3.14 (I0d), U4.7 (QD), U8.12 (A4)
RAM0: D12.2 (A), U1.4, U10.2 (A0)
RAM1: D11.2 (A), U1.2, U10.3 (A1)
RAM2: D10.2 (A), U1.10, U10.4 (A2)
RAM3: D9.2 (A), U1.12, U10.5 (A3)
RAM4: D8.2 (A), U2.6, U10.6 (A4)
RAM5: D7.2 (A), U2.8, U10.7 (A5)
RAM6: D5.2 (A), U2.10, U10.8 (A6)
RAM7: D3.2 (A), U2.12, U10.9 (A7)
READ: J1.4, R3.1, R7.1, U4.5 (UP)
STATUS0: D1.2 (A), J3.4, U9.18 (B0)
STATUS1: D2.2 (A), J3.3, U9.17 (B1)
STATUS2: D4.2 (A), J3.2, U9.16 (B2)
STATUS3: D6.2 (A), J3.1, U9.15 (B3)
VCC: J1.2, R2.2, R5.1, R8.2, R9.2, U1.14 (VCC), U2.14 (VCC), U3.16 (VCC), U4.4 (DOWN), U4.16 (VCC), U5.16 (VCC), U6.4 (DOWN), U6.16 (VCC), U7.16 (VCC), U8.7 (C0), U8.16 (VCC), U9.1 (A->B), U9.20 (VCC), U10.1 (A->B), U10.20 (VCC)
W0: U2.1, U3.3 (I1a), U6.3 (QA)
W1: U2.3, U3.6 (I1b), U6.2 (QB)
W2: U1.5, U3.10 (I1c), U6.6 (QC)
W3: U1.9, U3.13 (I1d), U6.7 (QD)
WRITE: J1.3, R1.1, R4.1, U3.1 (S), U6.5 (UP)
~WE: Q1.3 (E), R2.1, U5.3 (~WE), U7.3 (~WE)
