theWickedWebDev/8-bit-computer/PCB-Modules/99_IN PROGRESS/READY-TO-PRINT/memory/RAM-MODULE.kicad_sch

## KiCad design PCB-Modules/99_IN PROGRESS/READY-TO-PRINT/memory/RAM-MODULE.kicad_sch (2022-02-28)

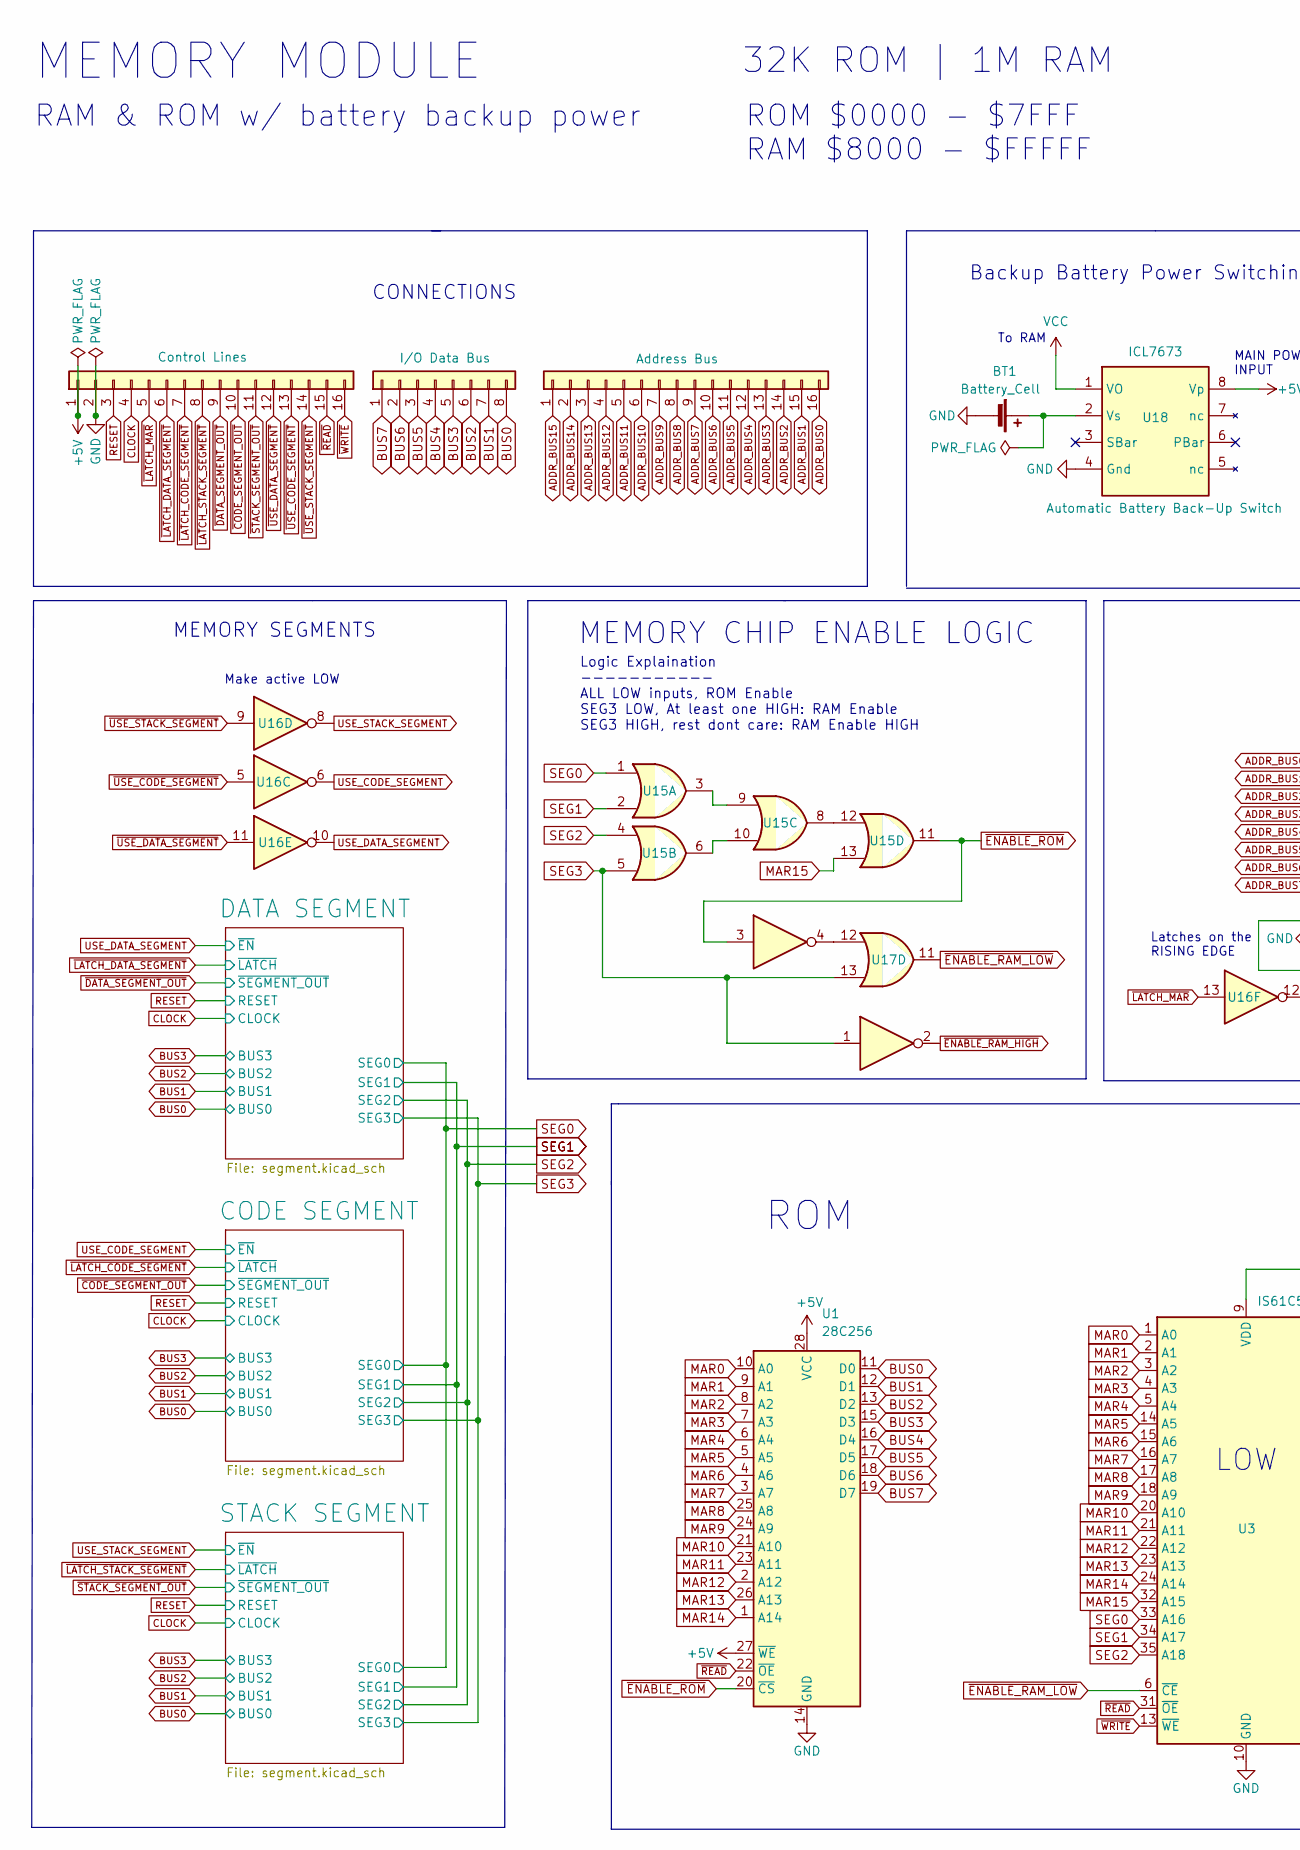
[picture p366: schematic RAM-MODULE.kicad_sch, part in row 1, column 1]

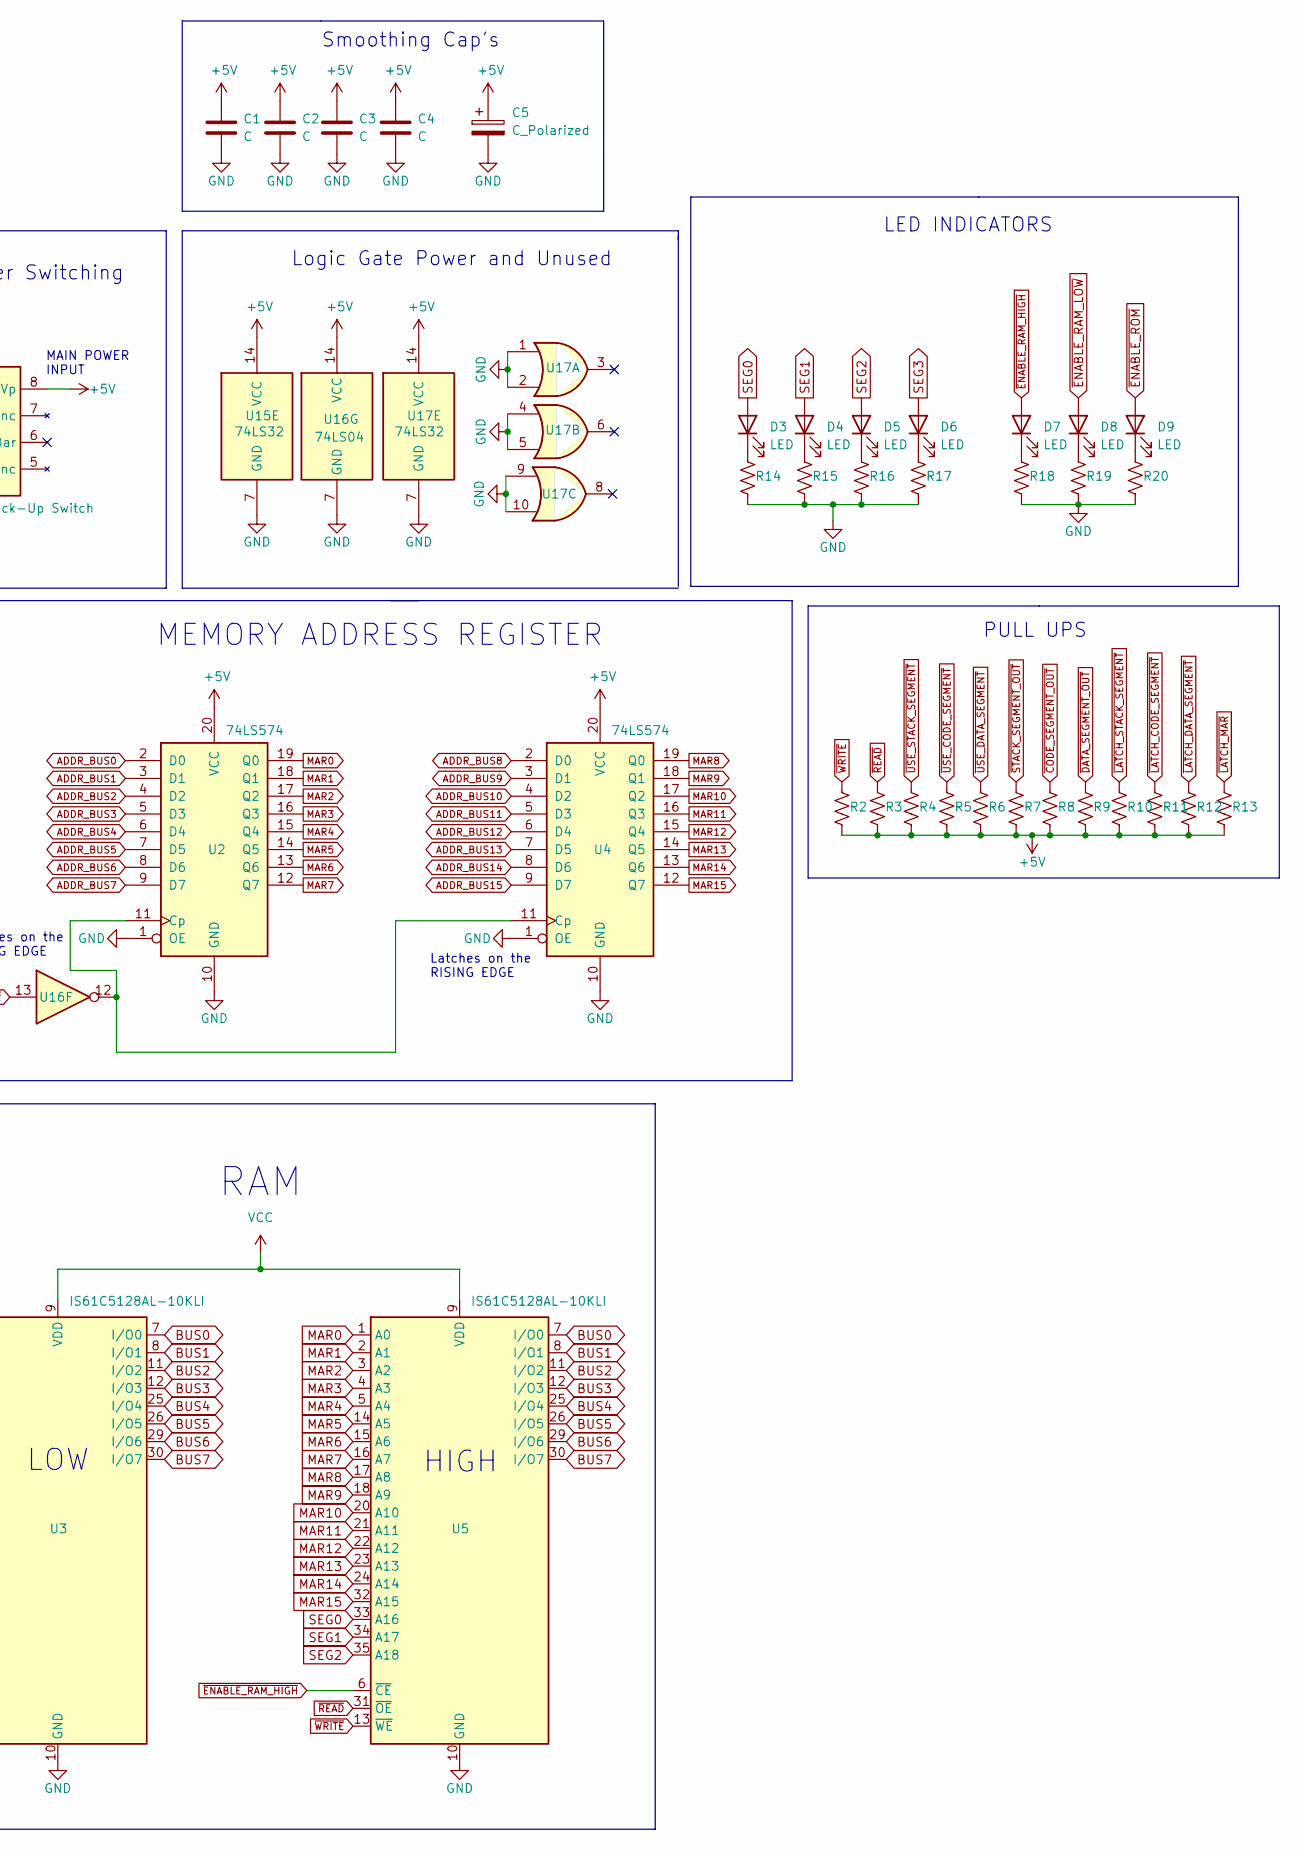
[picture p367: schematic RAM-MODULE.kicad_sch, part in row 1, column 2]

Parts:
BT1: Battery_Cell; BatteryHolder_Keystone_106_1x20mm
C1, C2, C3, C4: C; C_0805_2012Metric
C5: C_Polarized; CP_Elec_5x5.9
D3, D4, D5, D6, D7, D8, D9: LED; LED_0805_2012Metric
J1, J3: Conn_01x16; PinHeader_1x16_P2.54mm_Vertical
J2: Conn_01x08; PinHeader_1x08_P2.54mm_Vertical
R2, R3, R4, R5, R6, R7, R8, R9, R10, R11, R12, R13, R14, R15, R16, R17, R18, R19, R20: R_US; R_0805_2012Metric
U1: 28C256; DIP_Socket-28_W11.9_W12.7_W15.24_W17.78_W18.5_3M_228-1277-0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
U2, U4: 74LS574; SO-20_5.3x12.6mm_P1.27mm
U3, U5: IS61C5128AL-10KLI; SOJ-36_10.16x23.49mm_P1.27mm
U15, U17: 74LS32
U16: 74LS04
U18: ICL7673; DIP-8_W7.62mm

Connections:
+5V: C1.1, C2.1, C3.1, C4.1, C5.1, J3.1, R2.1, R3.1, R4.1, R5.1, R6.1, R7.1, R8.1, R9.1, R10.1, R11.1, R12.1, R13.1, U1.27 (~WE), U1.28 (VCC), U2.20 (VCC), U4.20 (VCC), U15.14 (VCC), U16.14 (VCC), U17.14 (VCC), U18.8 (Vp)
ADDR_BUS0: J1.16, U2.2 (D0)
ADDR_BUS1: J1.15, U2.3 (D1)
ADDR_BUS2: J1.14, U2.4 (D2)
ADDR_BUS3: J1.13, U2.5 (D3)
ADDR_BUS4: J1.12, U2.6 (D4)
ADDR_BUS5: J1.11, U2.7 (D5)
ADDR_BUS6: J1.10, U2.8 (D6)
ADDR_BUS7: J1.9, U2.9 (D7)
ADDR_BUS8: J1.8, U4.2 (D0)
ADDR_BUS9: J1.7, U4.3 (D1)
ADDR_BUS10: J1.6, U4.4 (D2)
ADDR_BUS11: J1.5, U4.5 (D3)
ADDR_BUS12: J1.4, U4.6 (D4)
ADDR_BUS13: J1.3, U4.7 (D5)
ADDR_BUS14: J1.2, U4.8 (D6)
ADDR_BUS15: J1.1, U4.9 (D7)
BUS0: J2.8, U1.11 (D0), U3.7 (I/O0), U5.7 (I/O0)
BUS1: J2.7, U1.12 (D1), U3.8 (I/O1), U5.8 (I/O1)
BUS2: J2.6, U1.13 (D2), U3.11 (I/O2), U5.11 (I/O2)
BUS3: J2.5, U1.15 (D3), U3.12 (I/O3), U5.12 (I/O3)
BUS4: J2.4, U1.16 (D4), U3.25 (I/O4), U5.25 (I/O4)
BUS5: J2.3, U1.17 (D5), U3.26 (I/O5), U5.26 (I/O5)
BUS6: J2.2, U1.18 (D6), U3.29 (I/O6), U5.29 (I/O6)
BUS7: J2.1, U1.19 (D7), U3.30 (I/O7), U5.30 (I/O7)
CLOCK: J3.4
GND: BT1.2 (-), C1.2, C2.2, C3.2, C4.2, C5.2, J3.2, R14.1, R15.1, R16.1, R17.1, R18.1, R19.1, R20.1, U1.14 (GND), U2.1 (OE), U2.10 (GND), U3.10 (GND), U3.28 (GND), U4.1 (OE), U4.10 (GND), U5.10 (GND), U5.28 (GND), U15.7 (GND), U16.7 (GND), U17.1, U17.2, U17.4, U17.5, U17.7 (GND), U17.9, U17.10, U18.4 (Gnd)
MAR0: U1.10 (A0), U2.19 (Q0), U3.1 (A0), U5.1 (A0)
MAR1: U1.9 (A1), U2.18 (Q1), U3.2 (A1), U5.2 (A1)
MAR2: U1.8 (A2), U2.17 (Q2), U3.3 (A2), U5.3 (A2)
MAR3: U1.7 (A3), U2.16 (Q3), U3.4 (A3), U5.4 (A3)
MAR4: U1.6 (A4), U2.15 (Q4), U3.5 (A4), U5.5 (A4)
MAR5: U1.5 (A5), U2.14 (Q5), U3.14 (A5), U5.14 (A5)
MAR6: U1.4 (A6), U2.13 (Q6), U3.15 (A6), U5.15 (A6)
MAR7: U1.3 (A7), U2.12 (Q7), U3.16 (A7), U5.16 (A7)
MAR8: U1.25 (A8), U3.17 (A8), U4.19 (Q0), U5.17 (A8)
MAR9: U1.24 (A9), U3.18 (A9), U4.18 (Q1), U5.18 (A9)
MAR10: U1.21 (A10), U3.20 (A10), U4.17 (Q2), U5.20 (A10)
MAR11: U1.23 (A11), U3.21 (A11), U4.16 (Q3), U5.21 (A11)
MAR12: U1.2 (A12), U3.22 (A12), U4.15 (Q4), U5.22 (A12)
MAR13: U1.26 (A13), U3.23 (A13), U4.14 (Q5), U5.23 (A13)
MAR14: U1.1 (A14), U3.24 (A14), U4.13 (Q6), U5.24 (A14)
MAR15: U3.32 (A15), U4.12 (Q7), U5.32 (A15), U15.13
unnamed: BT1.1 (+), U18.2 (Vs)
unnamed: D3.1 (K), R14.2
unnamed: D4.1 (K), R15.2
unnamed: D5.1 (K), R16.2
unnamed: D6.1 (K), R17.2
unnamed: D7.1 (K), R18.2
unnamed: D8.1 (K), R19.2
unnamed: D9.1 (K), R20.2
unnamed: U15.3, U15.9
unnamed: U15.6, U15.10
unnamed: U15.8, U15.12
unnamed: U16.4, U17.12
unnamed: U2.11 (Cp), U4.11 (Cp), U16.12
RESET: J3.3
SEG0: D3.2 (A), U3.33 (A16), U5.33 (A16), U15.1
SEG1: D4.2 (A), U3.34 (A17), U5.34 (A17), U15.2
SEG2: D5.2 (A), U3.35 (A18), U5.35 (A18), U15.4
SEG3: D6.2 (A), U15.5, U16.1, U17.13
USE_CODE_SEGMENT: U16.6
USE_DATA_SEGMENT: U16.10
USE_STACK_SEGMENT: U16.8
VCC: U3.9 (VDD), U3.27 (VDD), U5.9 (VDD), U5.27 (VDD), U18.1 (VO)
~CODE_SEGMENT_OUT: J3.10, R8.2
~DATA_SEGMENT_OUT: J3.9, R9.2
~ENABLE_RAM_HIGH: D7.2 (A), U5.6 (~CE), U16.2
~ENABLE_RAM_LOW: D8.2 (A), U3.6 (~CE), U17.11
~ENABLE_ROM: D9.2 (A), U1.20 (~CS), U15.11, U16.3
~LATCH_CODE_SEGMENT: J3.7, R11.2
~LATCH_DATA_SEGMENT: J3.6, R12.2
~LATCH_MAR: J3.5, R13.2, U16.13
~LATCH_STACK_SEGMENT: J3.8, R10.2
~READ: J3.15, R3.2, U1.22 (~OE), U3.31 (~OE), U5.31 (~OE)
~STACK_SEGMENT_OUT: J3.11, R7.2
~USE_CODE_SEGMENT: J3.13, R5.2, U16.5
~USE_DATA_SEGMENT: J3.12, R6.2, U16.11
~USE_STACK_SEGMENT: J3.14, R4.2, U16.9
~WRITE: J3.16, R2.2, U3.13 (~WE), U5.13 (~WE)

Notes on the sheet:
MEMORY CHIP ENABLE LOGIC
Logic Gate Power and Unused
HIGH
LED INDICATORS
MEMORY SEGMENTS
CONNECTIONS
MEMORY ADDRESS REGISTER
RAM & ROM w/ battery backup power
MEMORY MODULE
Latches on the RISING EDGE
Make active LOW
MAIN POWER INPUT
ROM $0000 - $7FFF RAM $8000 - $FFFFF
To RAM
32K ROM | 1M RAM
PULL UPS
Logic Explaination ----------- ALL LOW inputs, ROM Enable SEG3 LOW, At least one HIGH: RAM Enable SEG3 HIGH, rest dont care: RAM Enable HIGH
LOW
Smoothing Cap's
Backup Battery Power Switching
ROM
RAM
