theWickedWebDev/8-bit-computer/PCB-Modules/99_IN PROGRESS/READY-TO-PRINT/memory/segment.kicad_sch

## KiCad design PCB-Modules/99_IN PROGRESS/READY-TO-PRINT/memory/segment.kicad_sch (2022-02-28)

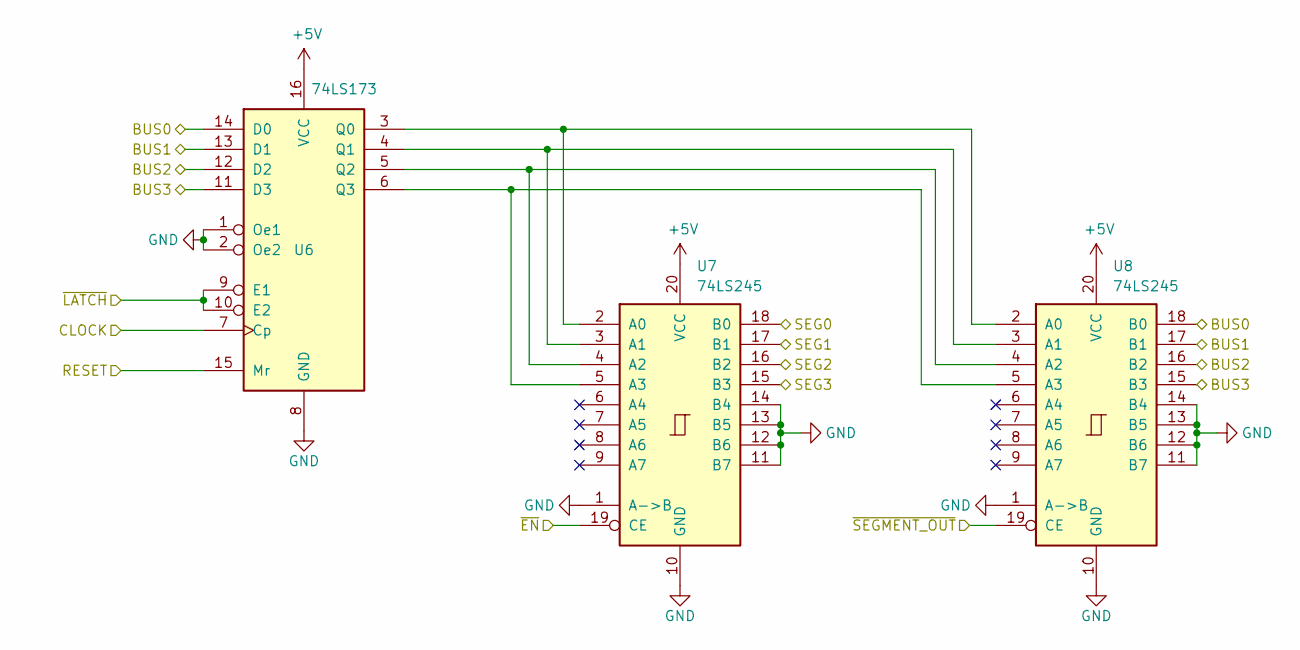
[picture p368: schematic segment.kicad_sch]

Parts:
U6: 74LS173; TSSOP-16_4.4x5mm_P0.65mm
U7, U8: 74LS245; TSSOP-20_4.4x6.5mm_P0.65mm

Connections:
+5V: U6.16 (VCC), U7.20 (VCC), U8.20 (VCC)
BUS0: U6.14 (D0), U8.18 (B0)
BUS1: U6.13 (D1), U8.17 (B1)
BUS2: U6.12 (D2), U8.16 (B2)
BUS3: U6.11 (D3), U8.15 (B3)
CLOCK: U6.7 (Cp)
GND: U6.1 (Oe1), U6.2 (Oe2), U6.8 (GND), U7.1 (A->B), U7.10 (GND), U7.11 (B7), U7.12 (B6), U7.13 (B5), U7.14 (B4), U8.1 (A->B), U8.10 (GND), U8.11 (B7), U8.12 (B6), U8.13 (B5), U8.14 (B4)
unnamed: U6.3 (Q0), U7.2 (A0), U8.2 (A0)
unnamed: U6.4 (Q1), U7.3 (A1), U8.3 (A1)
unnamed: U6.5 (Q2), U7.4 (A2), U8.4 (A2)
unnamed: U6.6 (Q3), U7.5 (A3), U8.5 (A3)
RESET: U6.15 (Mr)
SEG0: U7.18 (B0)
SEG1: U7.17 (B1)
SEG2: U7.16 (B2)
SEG3: U7.15 (B3)
~EN: U7.19 (CE)
~LATCH: U6.9 (E1), U6.10 (E2)
~SEGMENT_OUT: U8.19 (CE)
