theWickedWebDev/8-bit-computer/Arduino/control-logic/variables.h

#define CPU_CLOCK 12

#define SHIFT_DATA 2
#define SHIFT_CLK 3
#define SHIFT_LATCH 4
#define SHIFT_OE 5

#define BUS_BUFFER_OE 10
#define BUS_BUFFER_DIR_PIN 11

#define BUS0 14
#define BUS1 15
#define BUS2 16
#define BUS3 17
#define BUS4 18
#define BUS5 19
#define BUS6 20
#define BUS7 21


long addressBus = 0x0000;
long dataBus = 0x00;
byte bus = 0x0;
