theWickedWebDev/8-bit-computer/Arduino/Instruction-Decoder-Tester/instruction-decode-tester/std.h

#pragma once

namespace std
{
	/**
	 * C++ standard support for "initializer_list".
	 * This creates a temporary array in C++11 list-initialization and then 
	 * references it.
	 * An initializer_list instance is automatically constructed when a 
	 * braced-init-list is used to list-initialize an object, where the 
	 * corresponding constructor accepts an initializer_list parameter.
	 * 
	 * Using an initializer_ist argument is done through a standard C++ iterator loop:
	 * @code
	 * void f(initializer_list<int> list) {
	 *     for (auto x : list)
	 *         cout << *x << endl;
	 * }
	 * @endcode
	 * where the iterator type is simply `const T*`.
	 * That code could also be written in a more traditional and more verbose way:
	 * @code
	 * void f(initializer_list<int> list) {
	 *     for (const int* x = list.begin(); x != list.end(); ++x)
	 *         cout << *x << endl;
	 * }
	 * @endcode
	 * 
	 * @tparam T the type of objects in this initializer_list
	 */
	template<class T> class initializer_list
	{
	private:
		const T* array_ = nullptr;
		size_t len_ = 0;

		// The compiler can (and will) call a private constructor.
		// This constructor will get called when the compiler encounters a braced
		// list expression with elements of type T, like in f({t1, t2, t3}) and
		// an initializer_list<T> is expected by f function.
		constexpr initializer_list(const T* array, size_t len) : array_{array}, len_{len} {}

	public:
		/** Create an empty initializer list. */
		constexpr initializer_list() = default;

		/** The size of this initializer_list.  */
		constexpr size_t size() const
		{
			return len_;
		}

		/** The first element of this initializer_list. */
		constexpr const T* begin() const
		{
			return array_;
		}

		/** One past the last element of this initializer_list. */
		constexpr const T* end() const
		{
			return begin() + size();
		}
	};
}

namespace containers
{
	/**
	 * Container that encapsulates a fixed size array.
	 * This can be used as would be a C-style array (same operators) without any
	 * impact on performance.
	 * This also allows, for instance, to use a braced-list as a way to initialiaze or
	 * replace the values in this array.
	 * @tparam T_ the type of elements in this array
	 * @tparam N_ the number of elements in this array
	 */
	template<typename T_, uint8_t N_>
	class array
	{
	public:
		/** The type of elements held by this array. */
		using T = T_;
		/** The number of elements in this array. */
		static constexpr uint8_t N = N_;
		/** The reference type to `T`. */
		using TREF = T_&;
		/** The const reference type to `T`. */
		using CTREF = const T_&;
		/** The pointer type to `T`. */
		using TPTR = T_*;
		/** The const pointer type to `T`. */
		using CTPTR = const T_*;

		/**
		 * Create a default array of @p N elements of type @p T.
		 */
		array() = default;

		/**
		 * Convert a C-style array to an array.
		 */
		array(T buffer[N])
		{
			T* dst = buffer_;
			const T* src = buffer;
			for (uint8_t i = 0; i < N; ++i)
				*dst++ = *src++;
		}

		/**
		 * Create an array from a braced-list of elements.
		 * If @p list has less than @p N elements, all remaining elements from
		 * this array will be reset to their default.
		 */
		array(std::initializer_list<T> list)
		{
			T* dst = buffer_;
			auto src = list.begin();
			for (uint8_t i = 0; i < N; ++i)
			{
				if (src != list.end())
					*dst++ = *src++;
				else
					*dst++ = T{};
			}
		}

		/**
		 * Copy @p that array.
		 */
		array(const array<T, N>& that)
		{
			T* dst = buffer_;
			const T* src = that.buffer_;
			for (uint8_t i = 0; i < N; ++i)
				*dst++ = *src++;
		}
    
		/**
		 * Overwrite every element of this array with every element of @p buffer.
		 */
		array<T, N>& operator=(const T buffer[N])
		{
			T* dst = buffer_;
			const T* src = buffer;
			for (uint8_t i = 0; i < N; ++i)
				*dst++ = *src++;
			return *this;
		}
    
		/**
		 * Overwrite every element of this array with every element of @p list.
		 * If @p list has less than @p N elements, all remaining elements from
		 * this array will be reset to their default.
		 */
		array<T, N>& operator=(std::initializer_list<T> list)
		{
			T* dst = buffer_;
			auto src = list.begin();
			for (uint8_t i = 0; i < N; ++i)
			{
				if (src != list.end())
					*dst++ = *src++;
				else
					*dst++ = T{};
			}
		}
    
		/**
		 * Overwrite every element of this array with every element of @p that.
		 */
		array& operator=(const array& that)
		{
			T* dst = buffer_;
			const T* src = that.buffer_;
			for (uint8_t i = 0; i < N; ++i)
				*dst++ = *src++;
			return *this;
		}

		/**
		 * Get a const pointer to the first element of this array.
		 */
		CTPTR data() const
		{
			return buffer_;
		}

		/**
		 * Get a pointer to the first element of this array.
		 */
		TPTR data()
		{
			return buffer_;
		}

		/**
		 * Get the number of elements in this array.
		 * @sa N
		 */
		constexpr uint8_t size() const
		{
			return N;
		}

		/**
		 * Get a const reference to the element at @p index in this array.
		 * This can be used as an rvalue.
		 * @warning There is no control of boundaries, hence the caller must
		 * ensure that @p index is strictly less than @p N, otherwise behavior is
		 * undefined.
		 */
		CTREF operator[](uint8_t index) const
		{
			return buffer_[index];
		}

		/**
		 * Get a reference to the element at @p index in this array.
		 * This can be used as an lvalue.
		 * @warning There is no control of boundaries, hence the caller must
		 * ensure that @p index is strictly less than @p N, otherwise behavior is
		 * undefined.
		 */
		TREF operator[](uint8_t index)
		{
			return buffer_[index];
		}

		/** Return an iterator to the first element of this array. */
		TPTR begin()
		{
			return buffer_;
		}

		/** Return an iterator to the last element of this array. */
		TPTR end()
		{
			return buffer_ + N;
		}

		/** Return a const iterator to the first element of this array. */
		CTPTR begin() const
		{
			return buffer_;
		}

		/** Return a const iterator to the last element of this array. */
		CTPTR end() const
		{
			return buffer_ + N;
		}

		/**
		 * Replace @p NN elements of this array, starting at @p index element, with
		 * elements from @p buffer.
		 */
		template<uint8_t NN>
		void set(uint8_t index, const T (&buffer)[NN])
		{
			if (index >= N) return;
			const uint8_t nn = ((N - index) < NN) ? (N - index) : NN;
			T* dst = &buffer_[index];
			const T* src = buffer;
			for (uint8_t i = 0; i < nn; ++i)
				*dst++ = *src++;
		}

		/**
		 * Replace @p NN elements of this array, starting at @p index element, with
		 * elements from @p buffer.
		 */
		template<uint8_t NN>
		void set(uint8_t index, const array<T, NN>& buffer)
		{
			if (index >= N) return;
			const uint8_t nn = ((N - index) < NN) ? (N - index) : NN;
			T* dst = &buffer_[index];
			const T* src = buffer.data();
			for (uint8_t i = 0; i < nn; ++i)
				*dst++ = *src++;
		}

	private:
		T buffer_[N] = {};
	};
}
