theWickedWebDev/8-bit-computer/(commit log)

2021-04-21 Added bunch of modules
    [8bit-computer.kicad_pcb, 8bit-computer.sch, ADD_SUB.sch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]
2021-04-22 Added RAM Modle
    [RAM-B_Cu.gbr, RAM-B_Mask.gbr, RAM-B_Paste.gbr, RAM-B_SilkS.gbr, RAM-Edge_Cuts.gbr, RAM-F_Cu.gbr, RAM-F_Mask.gbr, RAM-F_Paste.gbr]
2021-04-22 Working on Display
    [DISPLAY.kicad_pcb, DISPLAY.sch, RAM.kicad_pcb]
2021-04-22 Added Bus Board
    [bus-board-B_Cu.gbr, bus-board-B_Mask.gbr, bus-board-B_Paste.gbr, bus-board-B_SilkS.gbr, bus-board-Edge_Cuts.gbr, bus-board-F_Cu.gbr, bus-board-F_Mask.gbr, bus-board-F_Paste.gbr]
2021-04-23 Bus Board work
    [bus-board.kicad_pcb, bus-board.sch]
2021-04-23 Added control logic and library
    [CONTROL_LOGIC-B_Cu.gbr, CONTROL_LOGIC-B_Mask.gbr, CONTROL_LOGIC-B_Paste.gbr, CONTROL_LOGIC-B_SilkS.gbr, CONTROL_LOGIC-Edge_Cuts.gbr, CONTROL_LOGIC-F_Cu.gbr, CONTROL_LOGIC-F_Mask.gbr, CONTROL_LOGIC-F_Paste.gbr]
2021-04-23 Storage Registers added
    [CONTROL_LOGIC.sch, REGISTER.kicad_pcb, REGISTER.sch]
2021-04-27 Added Register
    [CONTROL_LOGIC.kicad_pcb, CONTROL_LOGIC.sch, DISPLAY.sch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]
2021-04-27 Updating Counter
    [COUNTER.kicad_pcb]
2021-04-29 More Additions, Counter, ALU, Clock
    [ALU-B_Cu.gbr, ALU-B_Mask.gbr, ALU-B_Paste.gbr, ALU-B_SilkS.gbr, ALU-Edge_Cuts.gbr, ALU-F_Cu.gbr, ALU-F_Mask.gbr, ALU-F_Paste.gbr]
2021-04-29 Added Add/Sub Module
    [ALU-B_Cu.gbr, ALU-B_Mask.gbr, ALU-B_Paste.gbr, ALU-B_SilkS.gbr, ALU-Edge_Cuts.gbr, ALU-F_Cu.gbr, ALU-F_Mask.gbr, ALU-F_Paste.gbr]
2021-04-29 BiDirectional Shift Register component
    [ALU.kicad_pcb, ALU.sch]
2021-05-02 Adding Programmable RAM Module
    [ALU.kicad_pcb, ALU.sch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]
2021-05-08 Updated Control Unit
    [CONTROL_LOGIC-B_Cu.gbr, CONTROL_LOGIC-B_Paste.gbr, CONTROL_LOGIC-B_SilkS.gbr, CONTROL_LOGIC-Edge_Cuts.gbr, CONTROL_LOGIC-F_Cu.gbr, CONTROL_LOGIC-F_Mask.gbr, CONTROL_LOGIC-F_Paste.gbr, CONTROL_LOGIC-F_SilkS.gbr]
2021-05-08 Added RAM Programmer module
    [RAM_PROGRAMMER.kicad_pcb, RAM_PROGRAMMER.sch]
2021-05-08 Adding Clock 555 Module
    [CLOCK-B_Cu.gbr, CLOCK-B_Mask.gbr, CLOCK-B_Paste.gbr, CLOCK-B_SilkS.gbr, CLOCK-Edge_Cuts.gbr, CLOCK-F_Cu.gbr, CLOCK-F_Mask.gbr, CLOCK-F_Paste.gbr]
2021-05-08 Adding Power Module
    [POWER-B_Cu.gbr, POWER-B_Mask.gbr, POWER-B_Paste.gbr, POWER-B_SilkS.gbr, POWER-Edge_Cuts.gbr, POWER-F_Cu.gbr, POWER-F_Mask.gbr, POWER-F_Paste.gbr]
2021-05-08 Adding fun sound board module test
2021-05-10 Updated ADD/SUB module
    [ALU-B_Cu.gbr, ALU-B_Mask.gbr, ALU-B_Paste.gbr, ALU-B_SilkS.gbr, ALU-Edge_Cuts.gbr, ALU-F_Cu.gbr, ALU-F_Mask.gbr, ALU-F_Paste.gbr]
2021-05-10 Added ALU Simplified Module
    [ALU-SIMPLIFIED-B_Cu.gbr, ALU-SIMPLIFIED-B_Mask.gbr, ALU-SIMPLIFIED-B_Paste.gbr, ALU-SIMPLIFIED-B_SilkS.gbr, ALU-SIMPLIFIED-Edge_Cuts.gbr, ALU-SIMPLIFIED-F_Cu.gbr, ALU-SIMPLIFIED-F_Mask.gbr, ALU-SIMPLIFIED-F_Paste.gbr]
2021-05-10 Updating ALU 181
    [ADD_SUB.sch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]
2021-05-10 Moving ALU directory
    [ADD_SUB.sch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]
2021-05-10 Archiving old/obsolete modules - keeping for reference
    [AT28C64B-15PU.step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]
2021-05-10 Updating READMEs
    [CLOCK-B_Cu.gbr, CLOCK-B_Mask.gbr, CLOCK-B_Paste.gbr, CLOCK-B_SilkS.gbr, CLOCK-Edge_Cuts.gbr, CLOCK-F_Cu.gbr, CLOCK-F_Mask.gbr, CLOCK-F_Paste.gbr]
2021-05-18 RAM Memory Address Register
    [MAR-B_Cu.gbr, MAR-B_Mask.gbr, MAR-B_Paste.gbr, MAR-B_SilkS.gbr, MAR-Edge_Cuts.gbr, MAR-F_Cu.gbr, MAR-F_Mask.gbr, MAR-F_Paste.gbr]
2021-05-18 Adding Control Logic Module
    [CONTROL_LOGIC.sch]
2021-05-18 Updating/Adding Kicad Libraries
    [CLOCK-B_Adhes.gbr, CLOCK-B_CrtYd.gbr, CLOCK-B_Cu.gbr, CLOCK-B_Fab.gbr, CLOCK-B_Mask.gbr, CLOCK-B_Paste.gbr, CLOCK-B_SilkS.gbr, CLOCK-Cmts_User.gbr]
2021-05-18 Adding Fritzing breadboard for Sound module
    [Waveform Function Generator.fzz]
2021-05-20 Adding Single Storage Register
    [REGISTER-B_Adhes.gbr, REGISTER-B_CrtYd.gbr, REGISTER-B_Cu.gbr, REGISTER-B_Fab.gbr, REGISTER-B_Mask.gbr, REGISTER-B_Paste.gbr, REGISTER-B_SilkS.gbr, REGISTER-Cmts_User.gbr]
2021-05-20 General update
    [RAISED-BED-IRRIGATION.fzz]
2021-05-22 Updated to Control Logic board
    [CONTROL_LOGIC-B_Cu.gbr, CONTROL_LOGIC-B_Mask.gbr, CONTROL_LOGIC-B_Paste.gbr, CONTROL_LOGIC-B_SilkS.gbr, CONTROL_LOGIC-Edge_Cuts.gbr, CONTROL_LOGIC-F_Cu.gbr, CONTROL_LOGIC-F_Mask.gbr, CONTROL_LOGIC-F_Paste.gbr]
2021-05-22 Updating RAM boards
    [RAM-B_Cu.gbr, RAM-B_Mask.gbr, RAM-B_Paste.gbr, RAM-B_SilkS.gbr, RAM-Edge_Cuts.gbr, RAM-F_Cu.gbr, RAM-F_Mask.gbr, RAM-F_Paste.gbr]
2021-05-22 Updating RAM Programmer
    [CONTROL_LOGIC.sch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]
2021-05-22 Updating names
    [MAR.kicad_pcb, MAR.sch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]
2021-05-22 Updating structure and readmes
    [RAM_PROGRAMMER.kicad_pcb, RAM_PROGRAMMER.sch]
2021-05-25 Updating Sound Module
    [sound 3.sch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]
2021-05-25 Updated Display Module
    [DISPLAY.kicad_pcb, DISPLAY.sch]
2021-05-26 FIX: Clock Switch Error on Ground
    [CLOCK.sch]
2021-05-26 Work on Sound Module
    [sound-controller 2.fzz, sound-controller 3.fzz, sound-controller.fzz]
2021-05-30 Adding Multiplexer Module
    [MULTIPLEXER-B_Cu.gbr, MULTIPLEXER-B_Mask.gbr, MULTIPLEXER-B_Paste.gbr, MULTIPLEXER-B_SilkS.gbr, MULTIPLEXER-Edge_Cuts.gbr, MULTIPLEXER-F_Cu.gbr, MULTIPLEXER-F_Mask.gbr, MULTIPLEXER-F_Paste.gbr]
2021-05-30 Updating Clock Module
    [CLOCK.kicad_pcb, sound-controller.fzz]
2021-05-30 Adding start of Sound Controller
    [SOUND-CONTROLLER.kicad_pcb, SOUND-CONTROLLER.sch]
2021-06-15 Updating components
    [500SSP1S2M2QEA.step, ALU-181.sch, CLOCK.sch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]
2021-06-15 [Final] Clock Module
    [CLOCK-B_Adhes.gbr, CLOCK-B_CrtYd.gbr, CLOCK-B_Cu.gbr, CLOCK-B_Fab.gbr, CLOCK-B_Mask.gbr, CLOCK-B_Paste.gbr, CLOCK-B_SilkS.gbr, CLOCK-Cmts_User.gbr]
2021-06-15 Added Fritzing Clock Module
    [CLOCK-breadboard.fzz, CLOCK.kicad_pcb, CLOCK.sch]
2021-06-15 [Final] Storage Register
    [REGISTER.kicad_pcb, REGISTER.sch]
2021-06-15 Moving directories
    [500SSP1S2M2QEA.step, ADD_SUB.sch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]
2021-06-15 [Final] Counter Module
    [COUNTER-B_Cu.gbr, COUNTER-B_Mask.gbr, COUNTER-B_Paste.gbr, COUNTER-B_SilkS.gbr, COUNTER-Edge_Cuts.gbr, COUNTER-F_Cu.gbr, COUNTER-F_Mask.gbr, COUNTER-F_Paste.gbr]
2021-06-15 Update Directories
    [CLOCK-B_Adhes.gbr, CLOCK-B_CrtYd.gbr, CLOCK-B_Cu.gbr, CLOCK-B_Fab.gbr, CLOCK-B_Mask.gbr, CLOCK-B_Paste.gbr, CLOCK-B_SilkS.gbr, CLOCK-Cmts_User.gbr]
2021-06-15 Added Fritzing file for Register
    [register.fzz]
2021-06-17 [Added] ALU w/ registers module
    [ALU-181-B_Cu.gbr, ALU-181-B_Mask.gbr, ALU-181-B_Paste.gbr, ALU-181-B_SilkS.gbr, ALU-181-Edge_Cuts.gbr, ALU-181-F_Cu.gbr, ALU-181-F_Mask.gbr, ALU-181-F_Paste.gbr]
2021-06-17 [RAM] Adding combined RAM modules
    [MAR.kicad_pcb, MAR.sch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]
2021-06-17 [ALU] Updating ALU directory
    [ALU-181-B_Cu.gbr, ALU-181-B_Mask.gbr, ALU-181-B_Paste.gbr, ALU-181-B_SilkS.gbr, ALU-181-Edge_Cuts.gbr, ALU-181-F_Cu.gbr, ALU-181-F_Mask.gbr, ALU-181-F_Paste.gbr]
2021-06-17 Moving more files around
    [ADD_SUB.sch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]
2021-06-17 [RAM] Added gerber files
    [ram-combined-B_Cu.gbr, ram-combined-B_Mask.gbr, ram-combined-B_Paste.gbr, ram-combined-B_SilkS.gbr, ram-combined-Edge_Cuts.gbr, ram-combined-F_Cu.gbr, ram-combined-F_Mask.gbr, ram-combined-F_Paste.gbr]
2021-06-17 [Display] Adding first pass display module
    [AT28C64B-15PU.step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]
2021-06-18 [Display] Semi-final Display Module
    [DISPLAY.kicad_pcb, DISPLAY.sch]
2021-06-29 [Display Module] Updates after receiving PCB
    [DISPLAY-In1_Cu.gbr, DISPLAY-In2_Cu.gbr]
2021-06-29 [RAM Module] Updates after receiving PCB
    [ram-combined-B_Cu.gbr, ram-combined-B_Mask.gbr, ram-combined-B_Paste.gbr, ram-combined-B_SilkS.gbr, ram-combined-Edge_Cuts.gbr, ram-combined-F_Cu.gbr, ram-combined-F_Mask.gbr, ram-combined-F_Paste.gbr]
2021-06-29 [General] Updates
    [ALU-181-B_Cu.gbr, ALU-181-B_Mask.gbr, ALU-181-B_Paste.gbr, ALU-181-B_SilkS.gbr, ALU-181-Edge_Cuts.gbr, ALU-181-F_Cu.gbr, ALU-181-F_Mask.gbr, ALU-181-F_Paste.gbr]
2021-06-29 [Ram Module] Added Schematic PNG and PDF
2021-07-04 [ALU] Updated ALU - needs work
    [ALU-181.kicad_pcb, ALU-181.sch]
2021-07-04 [Full] Temp, WIP
    [full-assembly.kicad_pcb, full-assembly.sch]
2021-07-04 [SMD] Working on SMD boards
    [register-smd.kicad_pcb, register-smd.sch, smd-prototyping-board.kicad_pcb, smd-prototyping-board.sch]
2021-07-04 [Counter] Updates after printing
    [COUNTER-B_Cu.gbr, COUNTER-B_Mask.gbr, COUNTER-B_Paste.gbr, COUNTER-B_SilkS.gbr, COUNTER-Edge_Cuts.gbr, COUNTER-F_Cu.gbr, COUNTER-F_Mask.gbr, COUNTER-F_Paste.gbr]
2021-07-04 [Micocode] Updating Control - WIP
    [control.kicad_pcb, control.sch]
2021-09-10 Added SMD Modules
    [bom.csv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]
2021-11-19 whole hell update
    [16-8-register-backplane.kicad_pcb, 16-8-register-backplane.sch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]
2021-11-28 biggggg update and react app
    [FIFO-ram-buffer.kicad_pcb, FIFO-ram-buffer.sch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]
2021-11-28 Renamed directories
    [16-8-register-backplane.kicad_pcb, 16-8-register-backplane.sch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]
2021-12-09 large save haahh
    [ControlLogic-Backplane.kicad_pcb, ControlLogic-Backplane.sch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]
2022-01-15 Major Update
    [16-bit-bus-prototype-B_Cu.gbr, 16-bit-bus-prototype-B_Mask.gbr, 16-bit-bus-prototype-B_Paste.gbr, 16-bit-bus-prototype-B_SilkS.gbr, 16-bit-bus-prototype-Edge_Cuts.gbr, 16-bit-bus-prototype-F_Cu.gbr, 16-bit-bus-prototype-F_Mask.gbr, 16-bit-bus-prototype-F_Paste.gbr]
2022-01-18 Documentation and Cleanup
    [ALU-Backplane-B_Cu.gbr, ALU-Backplane-B_Mask.gbr, ALU-Backplane-B_Paste.gbr, ALU-Backplane-B_Silkscreen.gbr, ALU-Backplane-Edge_Cuts.gbr, ALU-Backplane-F_Cu.gbr, ALU-Backplane-F_Mask.gbr, ALU-Backplane-F_Paste.gbr]
2022-02-28 STUPID UPDATE MAJOR SAVE
    [100SP1T2B4M6QE.step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]
2022-04-18 Major Cleanup - Apr, 18 2022
    [16-8-register-backplane.kicad_pcb, 16-8-register-backplane.sch, 16-bit-buffer.kicad_sch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]
2022-08-27 cray cray save
    [16-bit-buffer.kicad_sch, 8-bit-computer.circ, ADSR.circ, ALU-Arithmetic.kicad_pcb, ALU-Arithmetic.kicad_sch, ALU-Arithmetic.sch, ALU.kicad_sch, Backplane-DislacementRegister.kicad_pcb]
