theWickedWebDev/8-bit-computer/(notices)

Notices in the files:
KiCad_Libraries/3D-Modals/LED_0805_2012Metric.step:
Copyright (C) 2018, kicad StepUp
This work is licensed under the [Creative Commons CC-BY-SA 4.0 License](https://creativecommons.org/licenses/by-sa/4.0/legalcode),
with the following exception:
To the extent that the creation of electronic designs that use 'Licensed Material' can be considered to be 'Adapted Material',
You are free to use the library data in your own projects without the obligation to share your project files under this or any other license agreement.
KiCad_Libraries/Footprints/PCIE-036-02-F-D-RA.stp:
FILE_NAME( 'e:/temp/worker_692/temp/exporttempdir_4624_397_3xQBd/format_0/PCIE-036-02-F-D-RA.stp', '2022-06-01T03:37:07', ( 'License CC BY-ND 4.0' ), ( 'CADENAS' ), ' ', 'PARTsolutions', ' ' );
